ha-homelab/ha-radio-hub/hardware/external-antenna/README.md

# MC2-D — three external 2.4 GHz antennas

The current engineering prototype uses an ESP32-DevKitC-VIE (WROVER-IE, 8 MB flash / 8 MB quad PSRAM) host, a XIAO ESP32C6 pre-soldered / 102010636 Thread RCP, and a XIAO MG24 Zigbee NCP. Each radio has its own external antenna. The previous MC1 Nano and MC2-A S3 remain historical and are not pin or binary compatible. All 21 application signals remain; R4/R5 constrain the classic ESP32 boot straps. Bluetooth uses legacy BLE4.2 advertising and connections, not BLE5 extended advertisements or Coded PHY.

- [Visual assembly and antenna guide](index.html)
- [Full device assembly and ZAC93 pin map](../../docs/full-hub-assembly.md)
- [Independent connection audit and required I²C switch correction](../../docs/connection-audit.md)
- [Blank power and boot-strap measurement worksheet](power-measurements.csv)
- [Exploded enclosure, all component mounts and print files](../../mechanical/full-hub/README.md)
- [Full-hub wiring drawing](full-hub-wiring.svg)
- [RECOM power wiring](power-wiring.svg) and [current power budget](power-design.json)
- [Exact shopping list and AliExpress checks](../../docs/mc2-shopping.md)
- [Historical MC2-A appearance concepts and provenance](images/README.md)
- [Editable carrier, exact pinout, assembly and checks](cad/README.md)
- [Front assembly drawing](cad/assembly-top.svg)
- [S1 white assembly legend, QR, both board faces and cost assumptions](../../docs/pcb-silkscreen.md)
- [Schematic](cad/schematic.svg), [PDF](cad/schematic.pdf)
- [PCB copper front](cad/board-top.svg), [back](cad/board-bottom.svg)
- [Controller/peripheral BOM](cad/BOM.csv), [RF parts](rf-bom.json)
- [Net wiring](wiring.json), [physical connector coordinates](cad/connectors.json)

The MC2-D selection replaces MC2-C's TinyC6[D] with the US-distributed,
factory-header XIAO ESP32C6. The carrier footprint, underside recovery access
window, J10 connection, RCP firmware and cable layout are revised together.
See the [prototype ordering record](../../docs/pcb-order.md). Fit and RF
acceptance must be completed on the physical assembly.

The **PWR1 off-board power assembly** retains RECOM R-78K3.3-1.0 plus a 27 µF
input capacitor. J2 remains 5 V / GND / 3.3 V / GND. MC2-D native CAD describes
this current supply; do not substitute the former Pololu as an extra purchase.
