ha-homelab/ha-radio-hub/mechanical/module-carrier/rail-mount/baseline/README.md

# Historical four-support baseline

Unchanged native inputs from `c3c810750766fb3a8a70d319e081c936aae4e6c4`, the 51 × 75 mm rectangular, four-support design before edge rails replaced three PCB mounting holes. This is a comparison source, not the current board.

- `mc1.kicad_pcb` SHA-256 `b33c3ff2b299e826cb11e783f835361635d544eda4c71ba62e85cb6318bb2857`
- `design.json` SHA-256 `3ec66d88aa3c61b0f6fb72e5d2c45840be7dddcc6e5587b213107c57966d3d68`
- `routing-metrics.json` SHA-256 `3d1b13ab42b664b54d90f39cf018a0f8c793de8e0717294d2542ee9afd824d4b`
