ha-homelab/ha-radio-hub/hardware/low-power/diy/outputs/README.txt

LP-D0 PROTOTYPE: bottom copper only. No top copper or plated holes are required.
Use the separately checked print PDFs for toner transfer.
The drill file and CSV specify every hole as unplated. Do not import top wire overlays as copper.
BOM, jumper schedule, and measured assembly acceptance remain mandatory.
