ha-homelab/ha-radio-hub/hardware/module-carrier/studies/mounting-routing/baseline/README.md

# Historical baseline: unsupported jack-side edge

Saved from commit `6873b0084a8404d33af0261b29e432ff0e476715` before the mounting and angled-component review. This is the historical 51 × 75 mm outline and its three support locations; do not fabricate it as the current design. The native PCB is retained for reproducible copper-length comparisons.
