ha-homelab/ha-radio-hub/hardware/module-carrier/studies/mounting-routing/ear-baseline/README.md

# Historical baseline: local mounting ear

Saved unchanged from commit `af287e40d2967ce5cba5ec2e3d896d4b03c0d842` before the no-ear / all-rear-first assembly revision. This historical design has a 57 × 75 mm bounding box, a 51 × 75 mm main body, a 6 × 27 mm local ear and four carrier supports. Its saved assembly metadata listed WIZ after the front controllers. That recorded sequence is historical; it does not prove that the geometry required WIZ last. The current revision explicitly checks the requested all-rear-before-front order.

These files are immutable comparison inputs, not the current fabrication source.

- `mc1.kicad_pcb` SHA-256: `7f8296edb0317269f6b094847edeb91a2886d2e1fc220150be1a1db43755d6ea`
- `design.json` SHA-256: `ddecb5edbc20ab4a8b3bb476f11965124e490f48361f9cebb92e28f0f5862271`
