ha-homelab/ha-radio-hub/docs/overview.ru.md

# Project overview

<!-- MC2-CURRENT-DESIGN -->
> **Current build: [MC2 — three external antennas](external-antennas.md).** This page retains an earlier design or evaluation for reference. Its board images, pin maps, enclosure fit and alternative BOMs are not the current MC2 build.

The documentation is now maintained in English. See the
[current MC1 documentation index](README.md).
