ha-homelab/ha-radio-hub/docs/enclosure.md

# HA Radio Hub enclosure — historical DRAFT V0

<!-- MC2-CURRENT-DESIGN -->
> **Historical Pi-era enclosure.** For the active **MC2-D / FH1** build, follow
> [Start here](start-here.md) and the [FH1 full-hub print package](../mechanical/full-hub/README.md).
> FH1 provides the current carrier, ZAC93 and peripheral mounts. The V0 dimensions,
> STL files and assembly layout below belong to the original Pi design.

The later [MC1 carrier enclosure prototype](../mechanical/module-carrier/enclosure-prototype/README.md) and [split-rail fit coupons](../mechanical/module-carrier/rail-mount/README.md) are also historical. They cover only the MC1 carrier; FH1 supersedes them for the complete current hub.

The model is ready for a test print, but has **not yet been validated by assembling the actual parts**. The STL files are checked for watertight meshes, consistent face winding, and one connected body. These checks do not prove connector clearance, radio performance, cooling, or the accuracy of a particular printer.

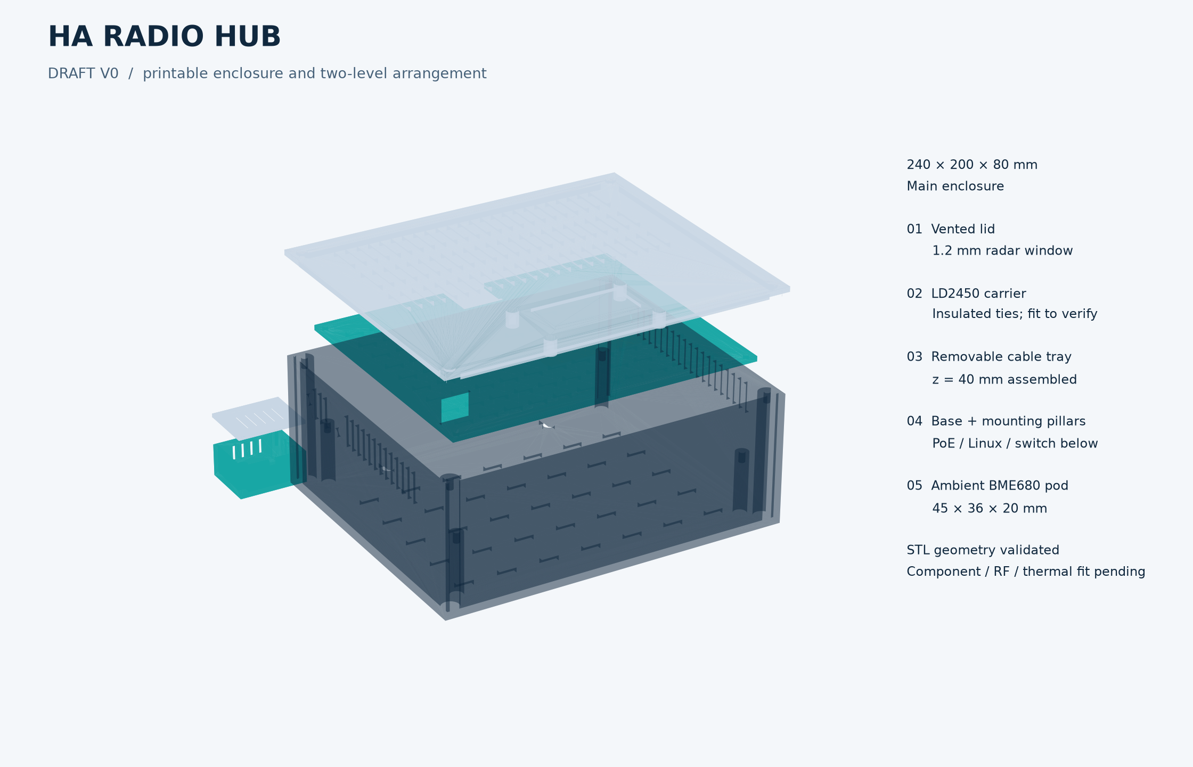
[picture p15: mechanical/generated/exploded-preview.png]
Exploded view generated from the actual STL files


## Dimensions and orientation

Main enclosure: **240 × 200 × 80 mm**, excluding protruding screw heads, cables, and antennas. The base is 77 mm high and the lid is 3 mm thick; walls and floor are 3 mm thick. The base and lid need a bed of at least 246 × 206 mm with a 3 mm brim; a 256 × 256 mm class printer is a practical fit. **The base and lid do not fit a 220 × 220 mm bed.** Do not scale down the STL files: this changes screw fits and the actual compartment dimensions. V0 does not include a validated split enclosure for a 220 mm bed.

Coordinates: x is width, y is depth; the floor is at z=0 and the outer lid surface at z=80. The PoE cable enters at the rear, through y=200. The radar sits below the lid near y=40, with its antenna plane facing the lid. For wall mounting, **the lid faces the room**. On a horizontal table, the radar points upward, so stand the enclosure vertically on a stable support or mount it on a wall to track people. Check the radar coordinate directions after installation.

Assembly options:

- Main: printed wall-mounted enclosure with two levels and an external BME680 ambient-sensor pod.
- Debugging: the same enclosure with the lid removed; comparison with the closed enclosure is required to check radar behavior and temperatures.
- Commercial substitute: a purchased ventilated plastic enclosure with at least 240 × 200 × 80 mm of clear internal space and a separate mounting panel. Transfer panel hole locations from measured parts. A metal enclosure requires externally mounted radio modules/antennas and a separate RF-transparent radar window.

## Layout

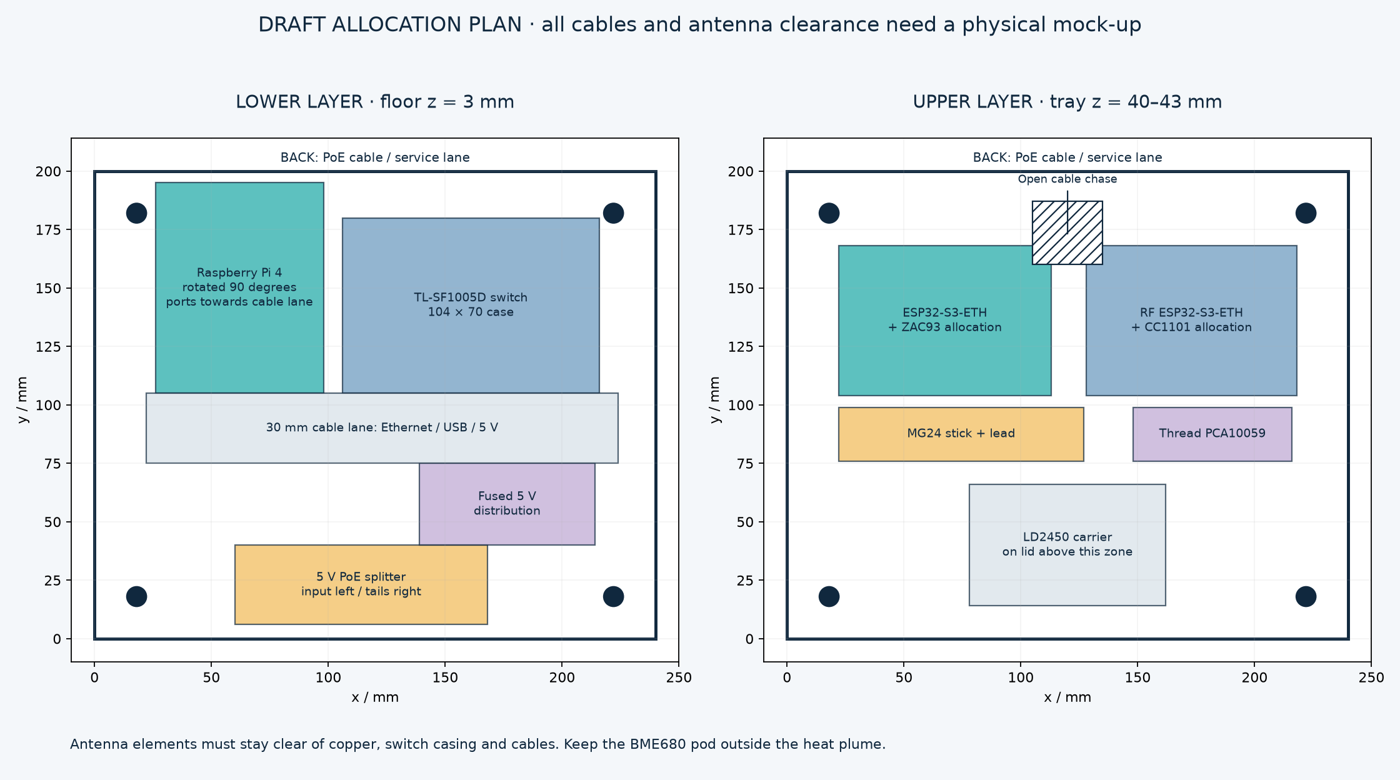
[picture p16: mechanical/generated/layout-plan.png]
Layout by level


This is a **space allocation**, not accurate CAD models of the commercial devices. The dimensions and coordinates below refer to the supplied `parameters.json`. Connector dimensions, wire bends, USB radio housings, and standoffs must be checked against the purchased parts.

Lower level: top of the floor at z=3; underside of the removable deck at z=40. The available 37 mm height includes insulating pads and fasteners.
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
