ha-homelab/ha-radio-hub/docs/external-antennas.md

# MC2-D: three external antennas

MC2-D is the current **100 × 100 mm, two-copper-layer** carrier for finished
modules. It retains the local Thread Border Router, Ember Zigbee, active Bluetooth
proxy, Z-Wave transport, CC1101 RX/TX, LD2450 and BME680. Its change is three
independent external 2.4 GHz radio paths. **This is an engineering prototype**:
builds and CAD checks do not demonstrate house coverage or physical fit.

Start with the [visual guide and pin lookup](../hardware/external-antenna/index.html),
[native hardware](../hardware/external-antenna/README.md),
[firmware instructions](../firmware/external-antenna/README.md), and
[full-hub printable enclosure](../mechanical/full-hub/README.md).

## Exact module selection

- **U1: Espressif ESP32-DevKitC-VIE / ESP32-WROVER-IE.** Classic ESP32 ECOv3,
  factory external RF connector, 8 MB flash and 8 MB physical PSRAM; two 19-pin
  rows. The application maps 4 MB PSRAM for capability-based allocation at quad 40 MHz.
  It runs Ethernet, the BLE 4.2 proxy and local Thread Border Router. Do not
  substitute WROOM (no PSRAM), VE (onboard antenna), an older WROVER revision,
  or the former S3 board. **MC2-A and MC2-D footprints and binaries differ.**
- **U2: Seeed XIAO ESP32C6 (Pre-Soldered), SKU 102010636.** Four MB flash,
  native USB and factory 2×7 male headers. UART RX17/TX16 are on D7/D6.
  The factory GPIO8 pull-up replaces the old carrier R3. Recovery uses **two
  flexible insulated leads**, TP8/EN → J10.1 and TP2/BOOT (GPIO9) → J10.2.
  Those are underside pads, not header pins; the carrier has an access window.
  The matching firmware selects external RF with **GPIO3 LOW, GPIO14 HIGH**
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
