ha-homelab/ha-radio-hub/hardware/external-antenna/images/full-hub-exploded-concept.png

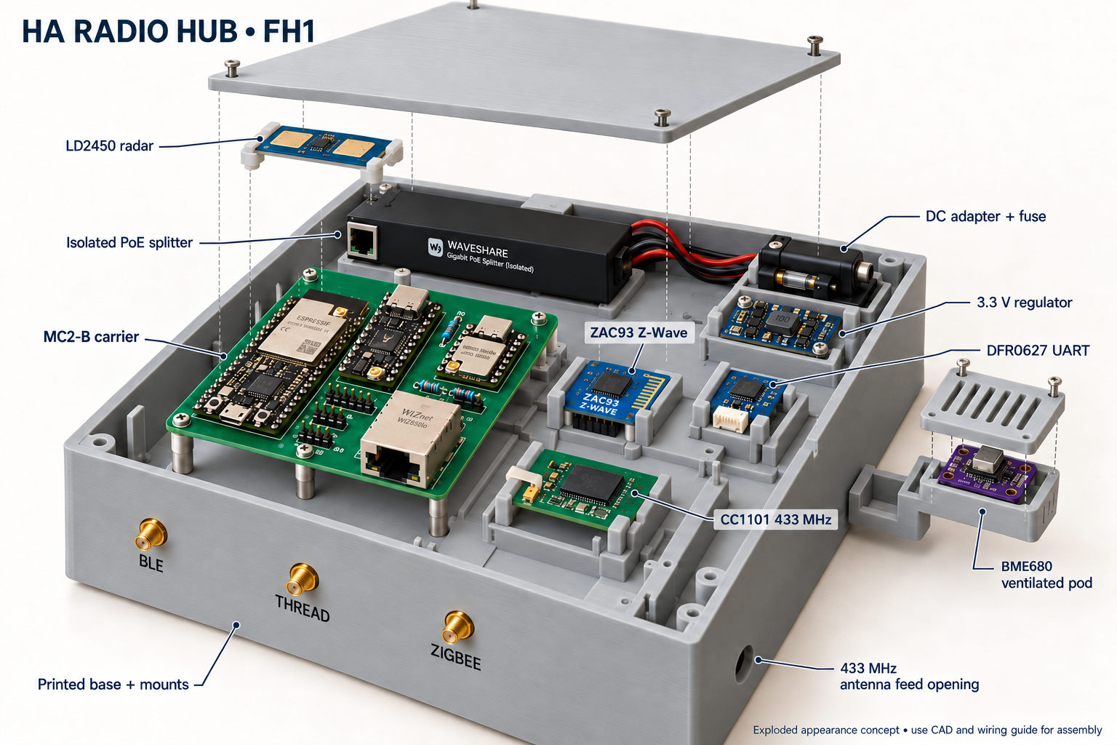
hardware/external-antenna/images/full-hub-exploded-concept.png
