ha-homelab/ha-radio-hub/hardware/external-antenna/images/mc2b-bare-concept.png

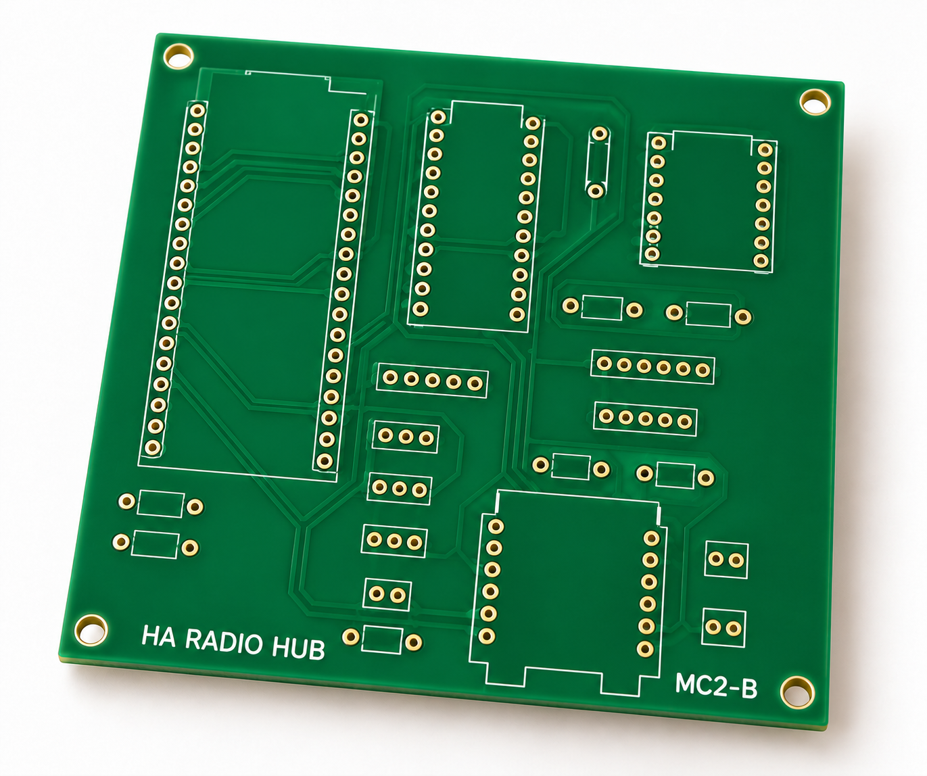
hardware/external-antenna/images/mc2b-bare-concept.png
