ha-homelab/ha-radio-hub/hardware/h2-quartet/preview.jpg

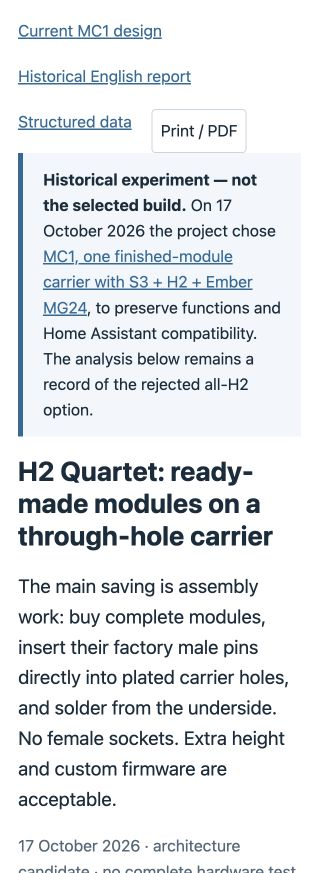
hardware/h2-quartet/preview.jpg
