ha-homelab/ha-radio-hub/hardware/module-carrier/images/history/mc1-100x90-rejected-concept.png

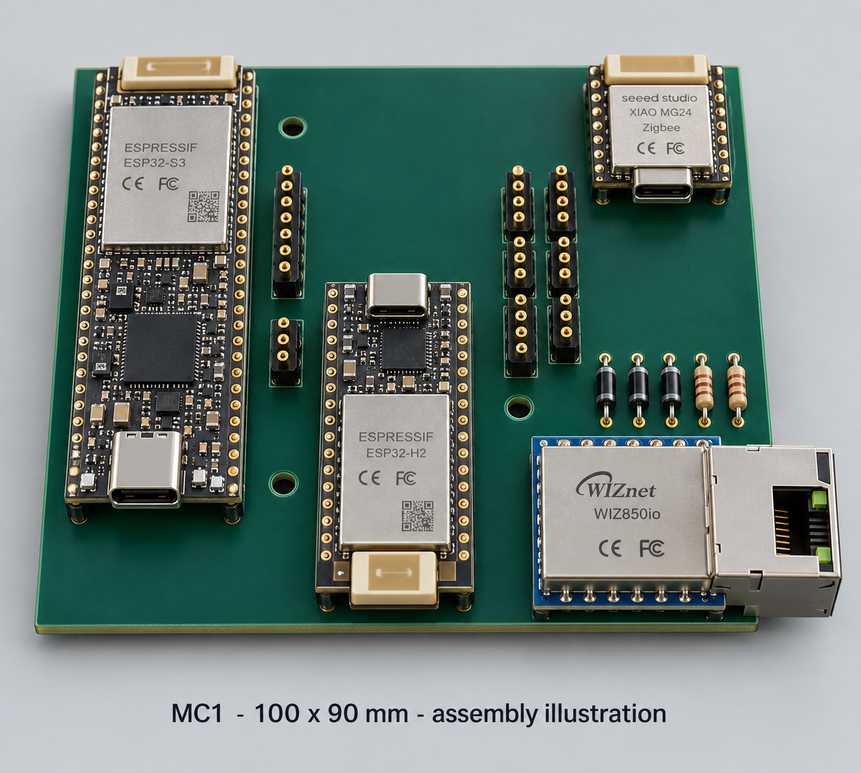
hardware/module-carrier/images/history/mc1-100x90-rejected-concept.png
