ha-homelab/ha-radio-hub/hardware/module-carrier/images/history/mc1-160x100-concept.png

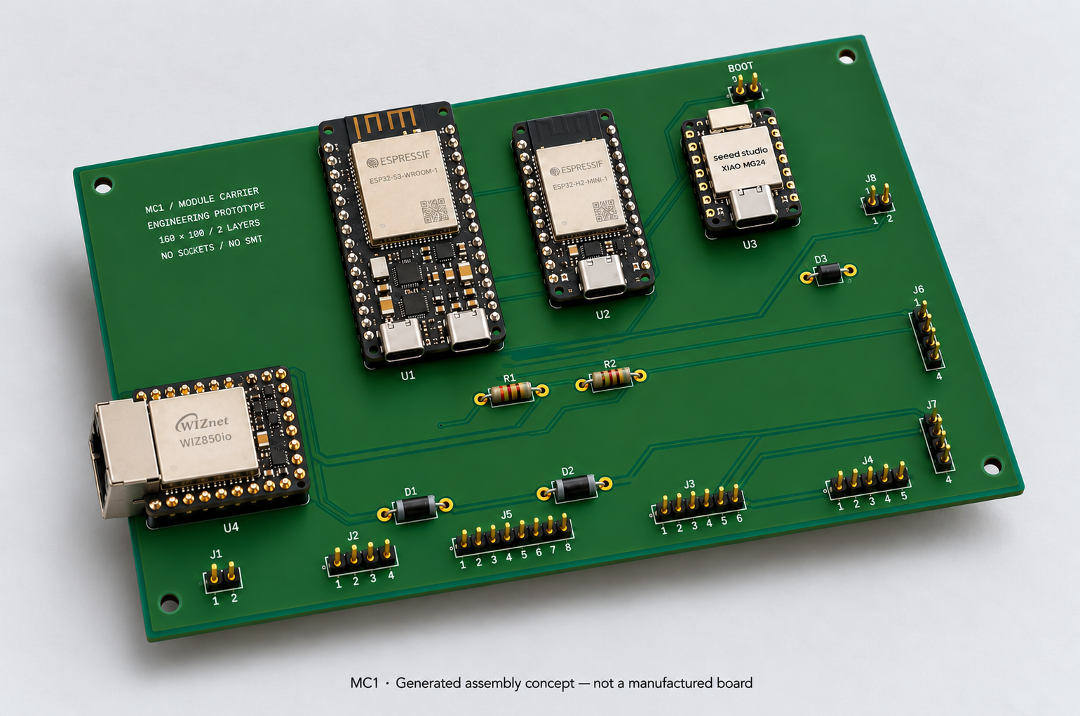
hardware/module-carrier/images/history/mc1-160x100-concept.png
