ha-homelab/ha-radio-hub/hardware/module-carrier/images/history/mc1-single-anchor-first-concept.png

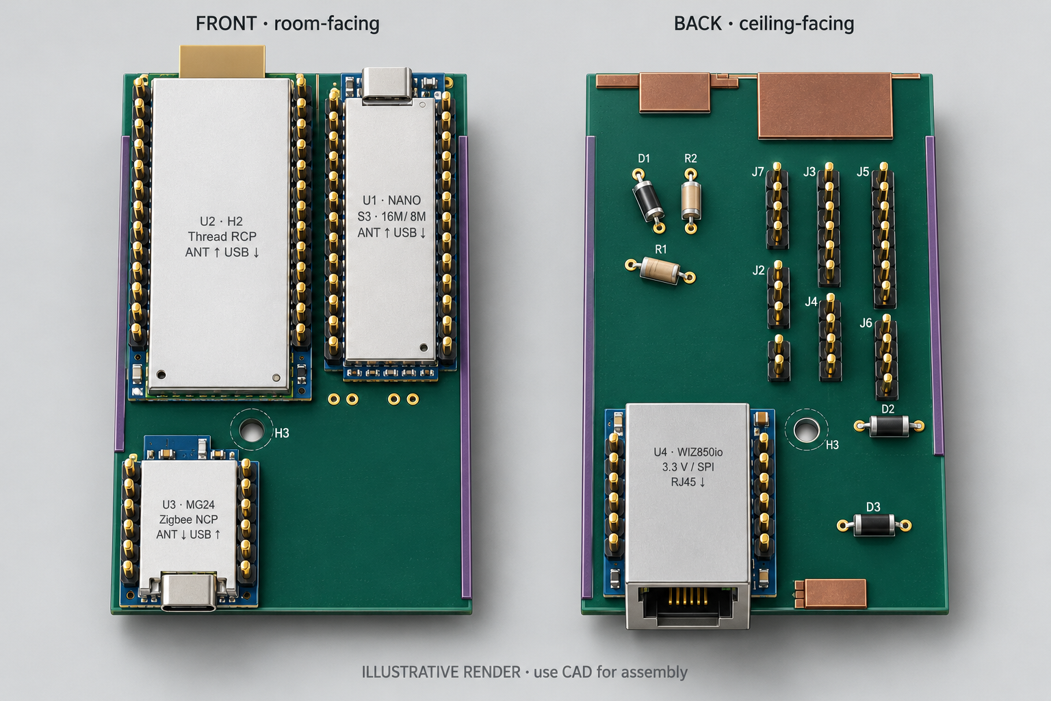
hardware/module-carrier/images/history/mc1-single-anchor-first-concept.png
