ha-homelab/ha-radio-hub/hardware/module-carrier/images/ui-architecture.jpg

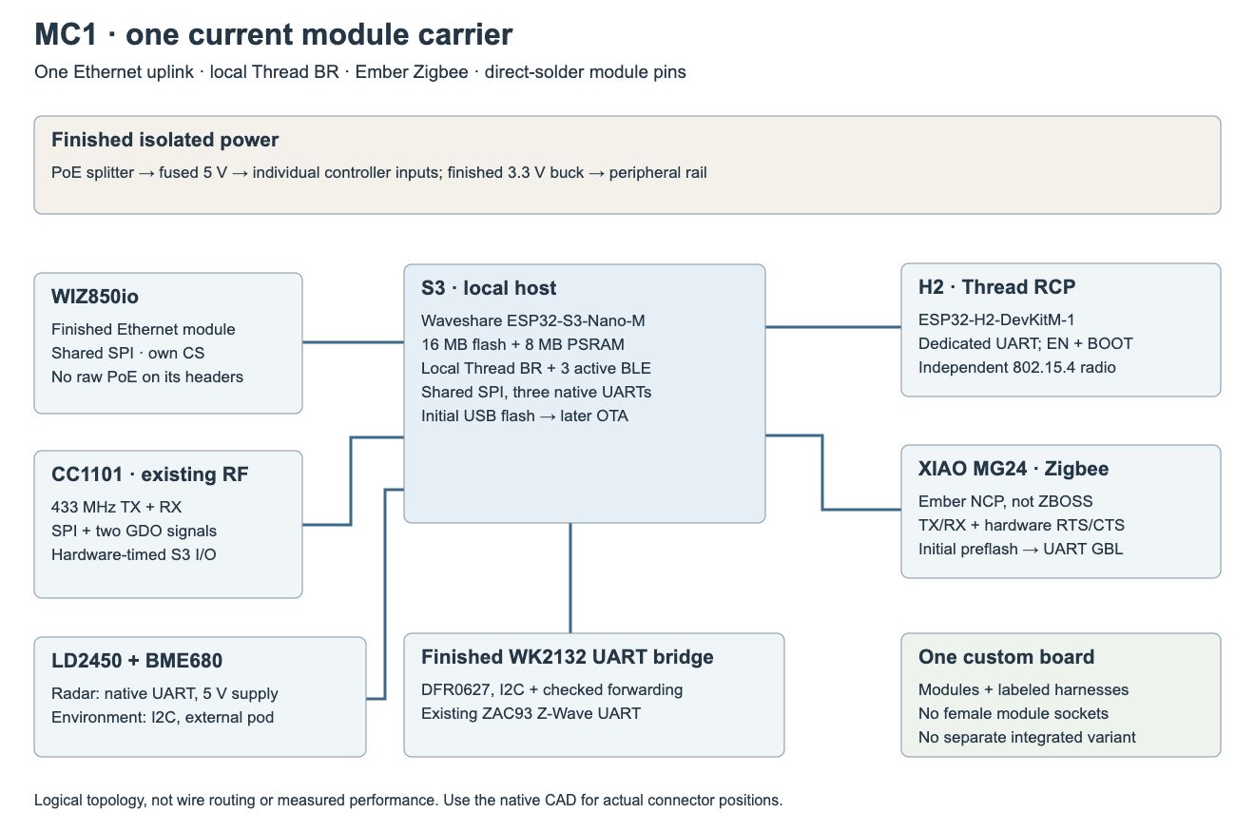
hardware/module-carrier/images/ui-architecture.jpg
