ha-homelab/ha-radio-hub/hardware/module-carrier/images/ui-comparison.jpg

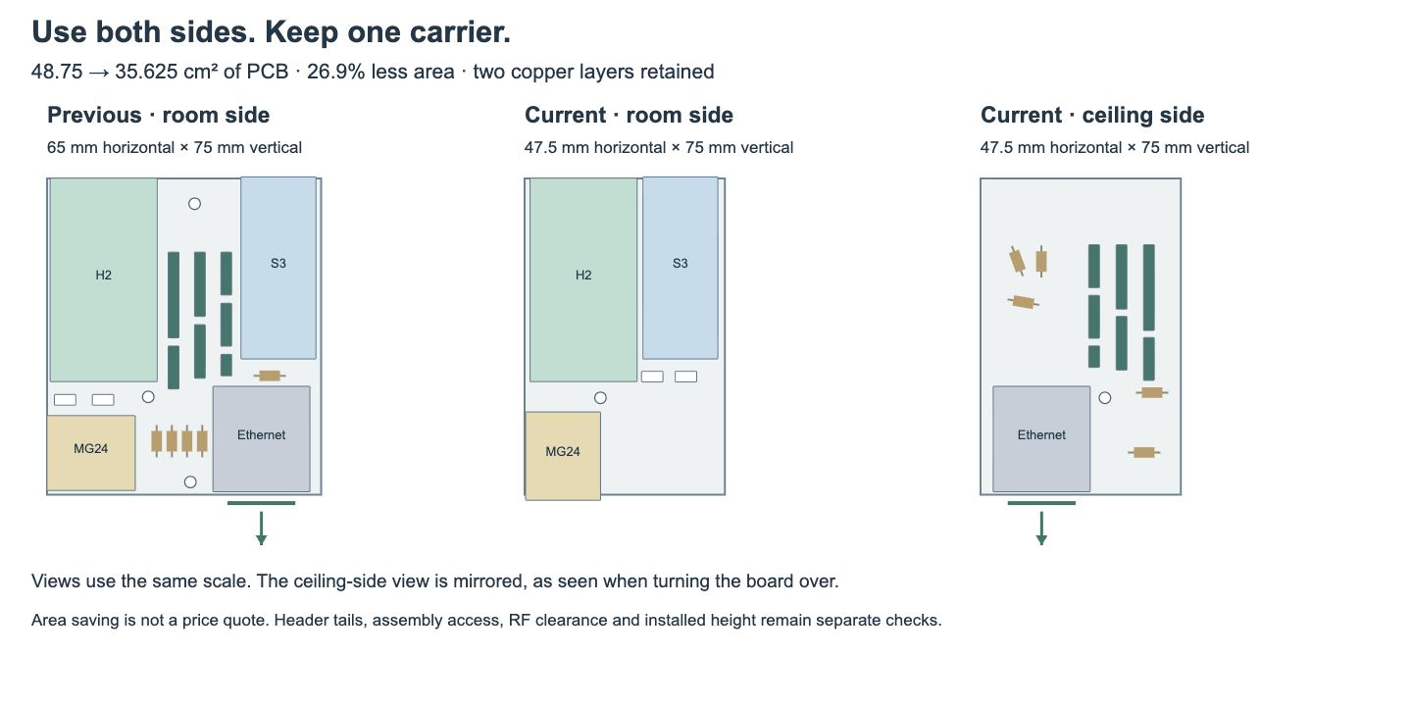
hardware/module-carrier/images/ui-comparison.jpg
