ha-homelab/ha-radio-hub/hardware/module-carrier/images/ui-concept.jpg

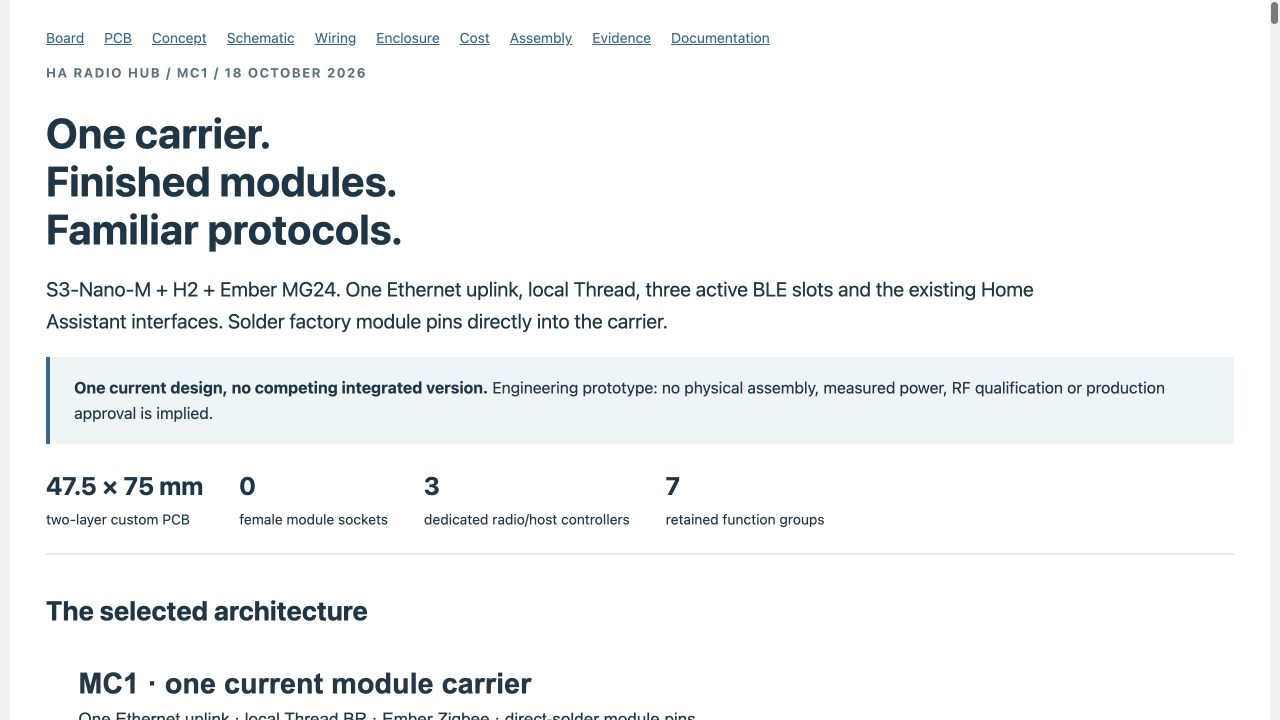
hardware/module-carrier/images/ui-concept.jpg
