ha-homelab/ha-radio-hub/hardware/module-carrier/images/ui-enclosure.jpg

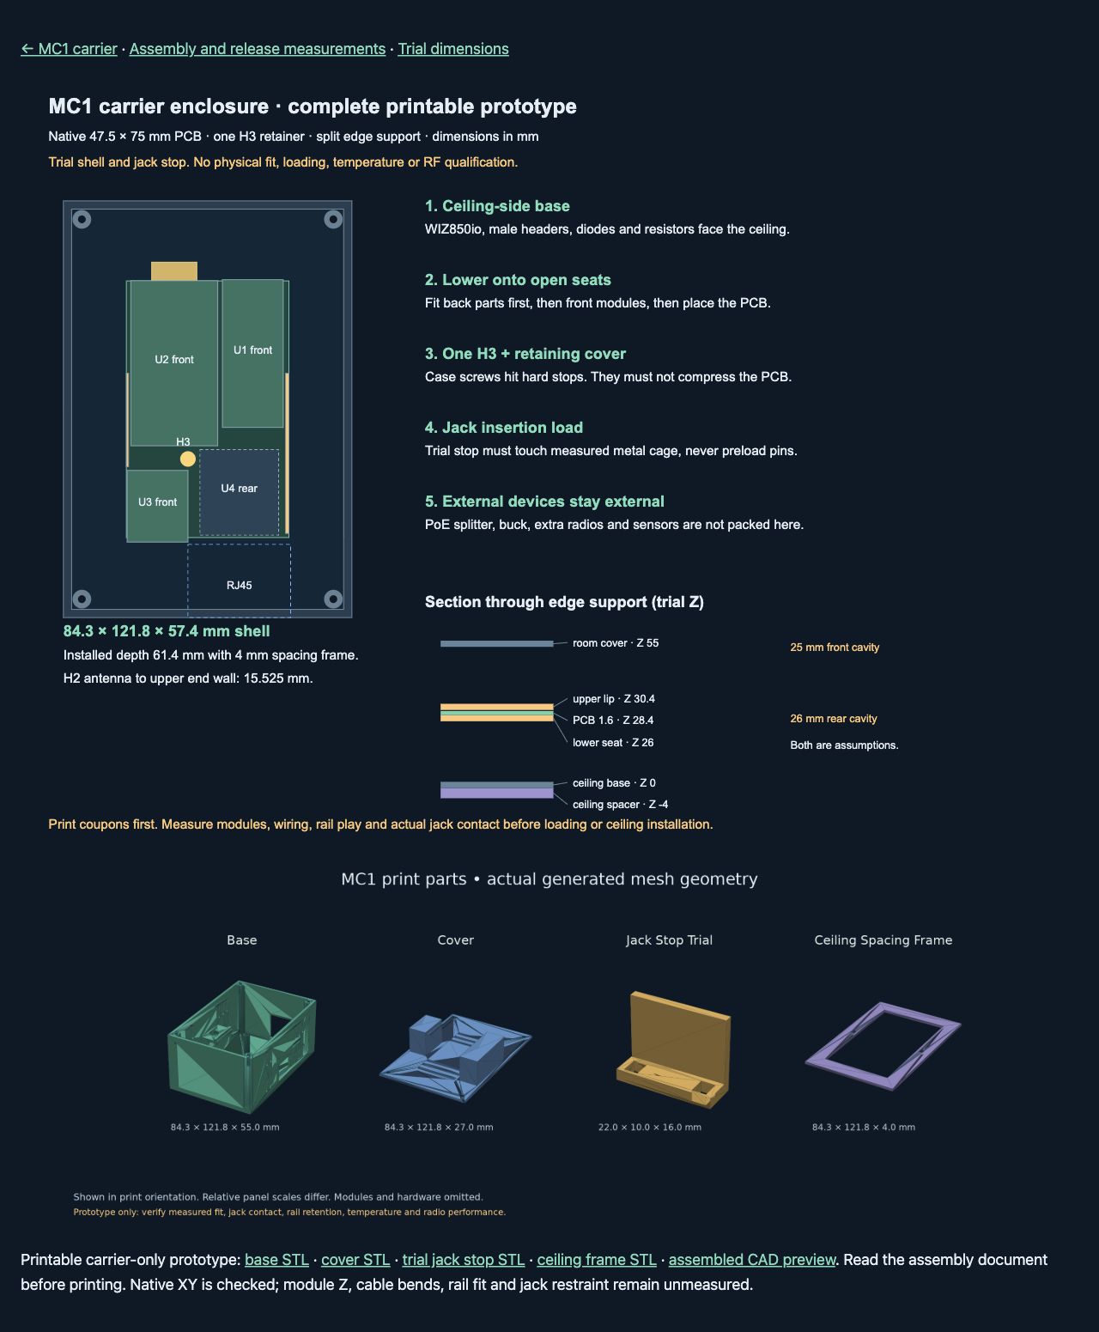
hardware/module-carrier/images/ui-enclosure.jpg
