ha-homelab/ha-radio-hub/hardware/module-carrier/images/ui-harness.jpg

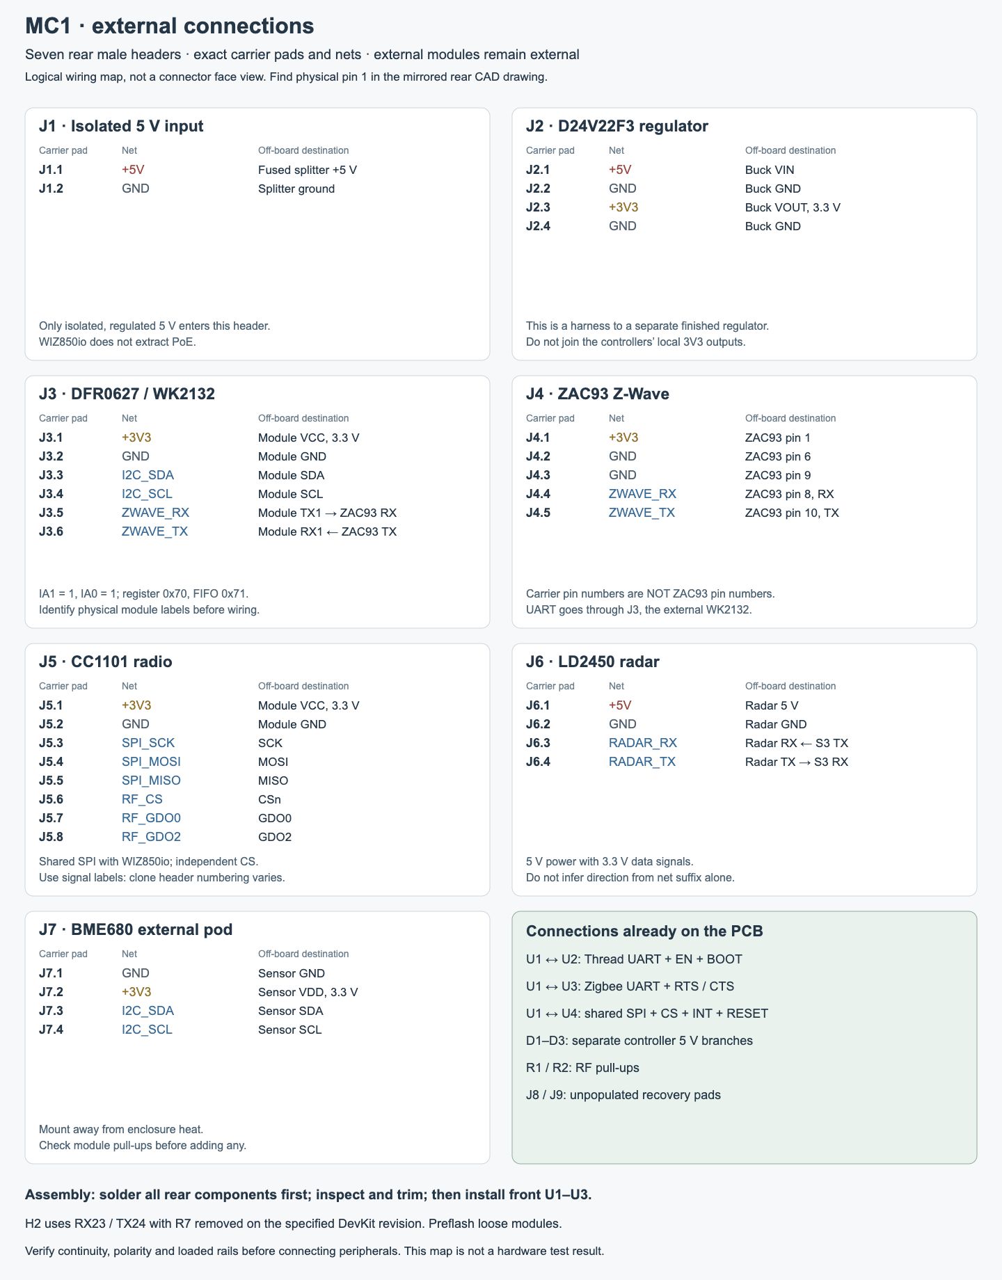
hardware/module-carrier/images/ui-harness.jpg
