ha-homelab/ha-radio-hub/hardware/module-carrier/images/ui-mounting.jpg

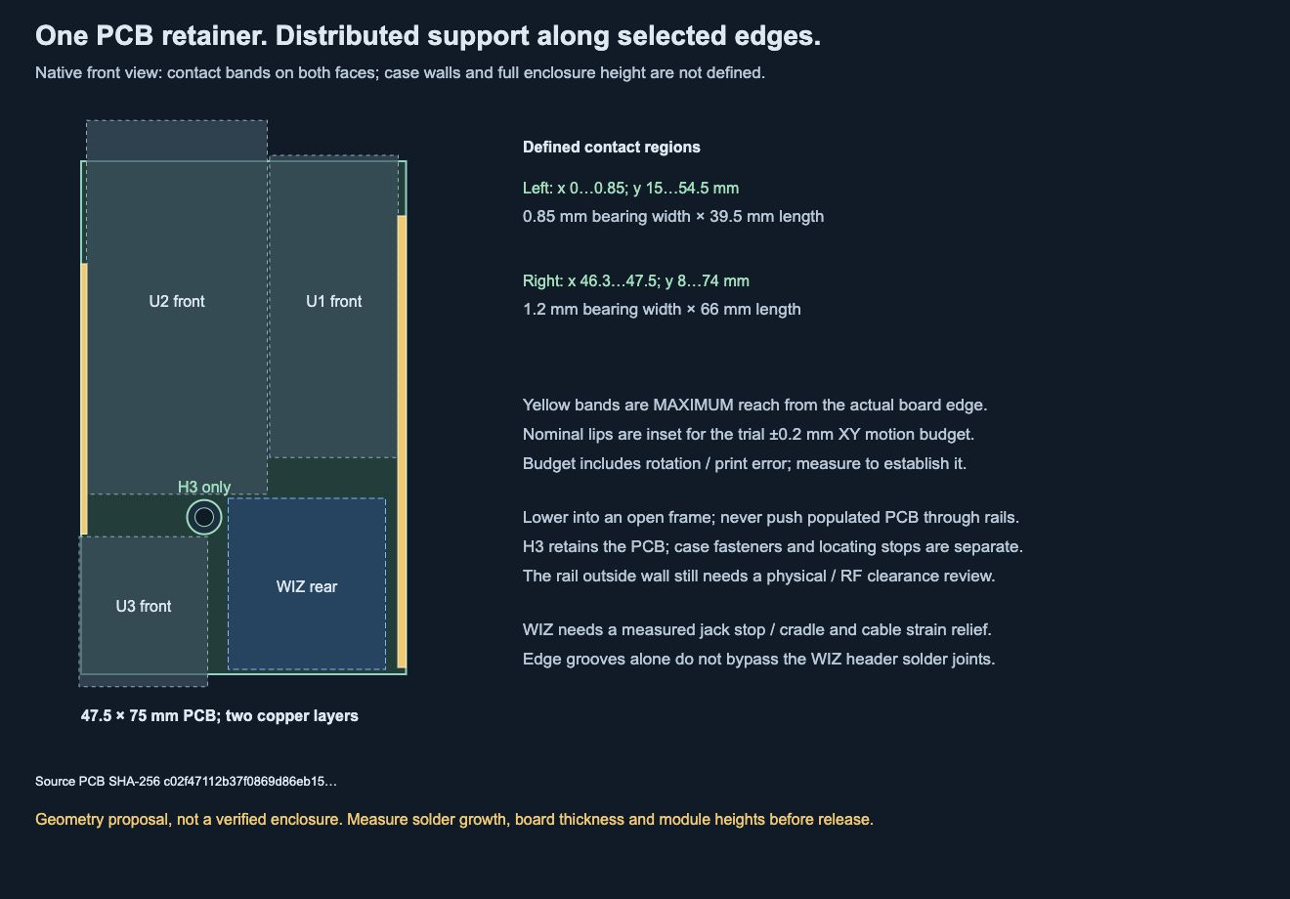
hardware/module-carrier/images/ui-mounting.jpg
