ha-homelab/ha-radio-hub/hardware/module-carrier/images/ui-rail-study.jpg

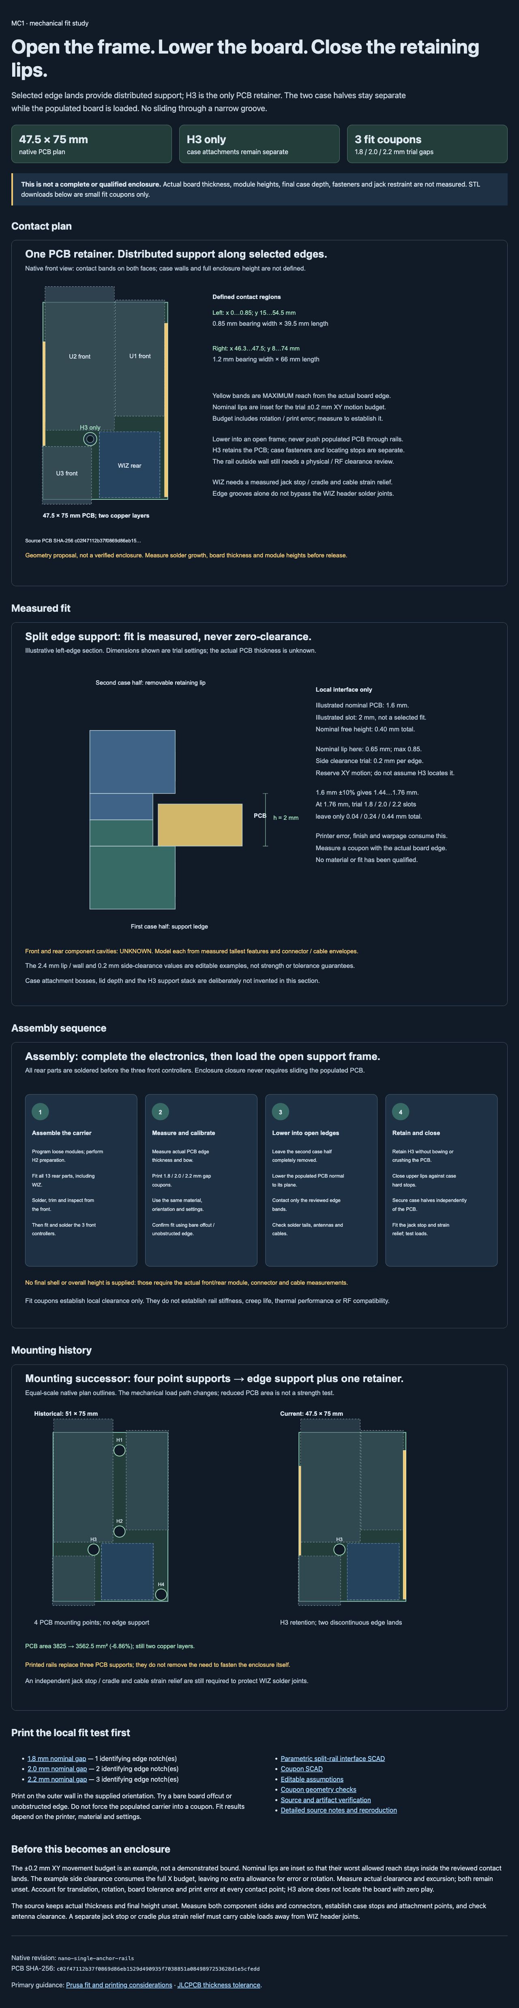
hardware/module-carrier/images/ui-rail-study.jpg
