ha-homelab/ha-radio-hub/hardware/module-carrier/images/ui-recovery.jpg

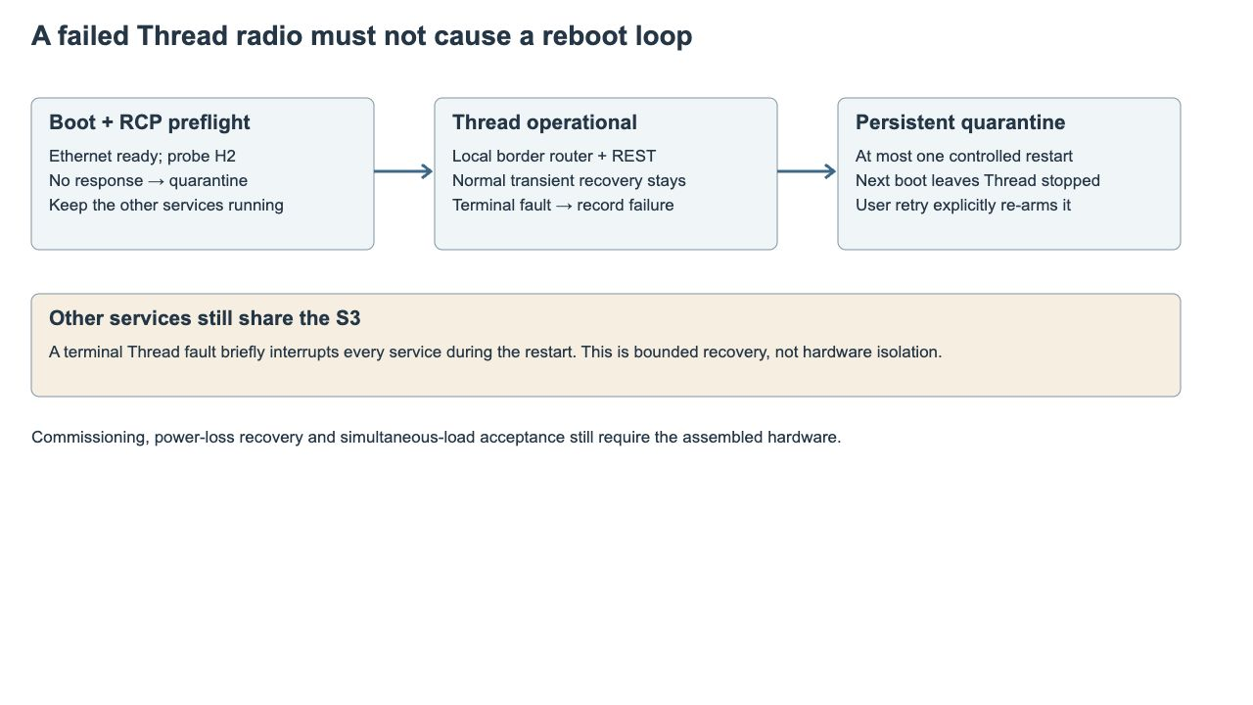
hardware/module-carrier/images/ui-recovery.jpg
