ha-homelab/ha-radio-hub/hardware/module-carrier/images/ui-routing.jpg

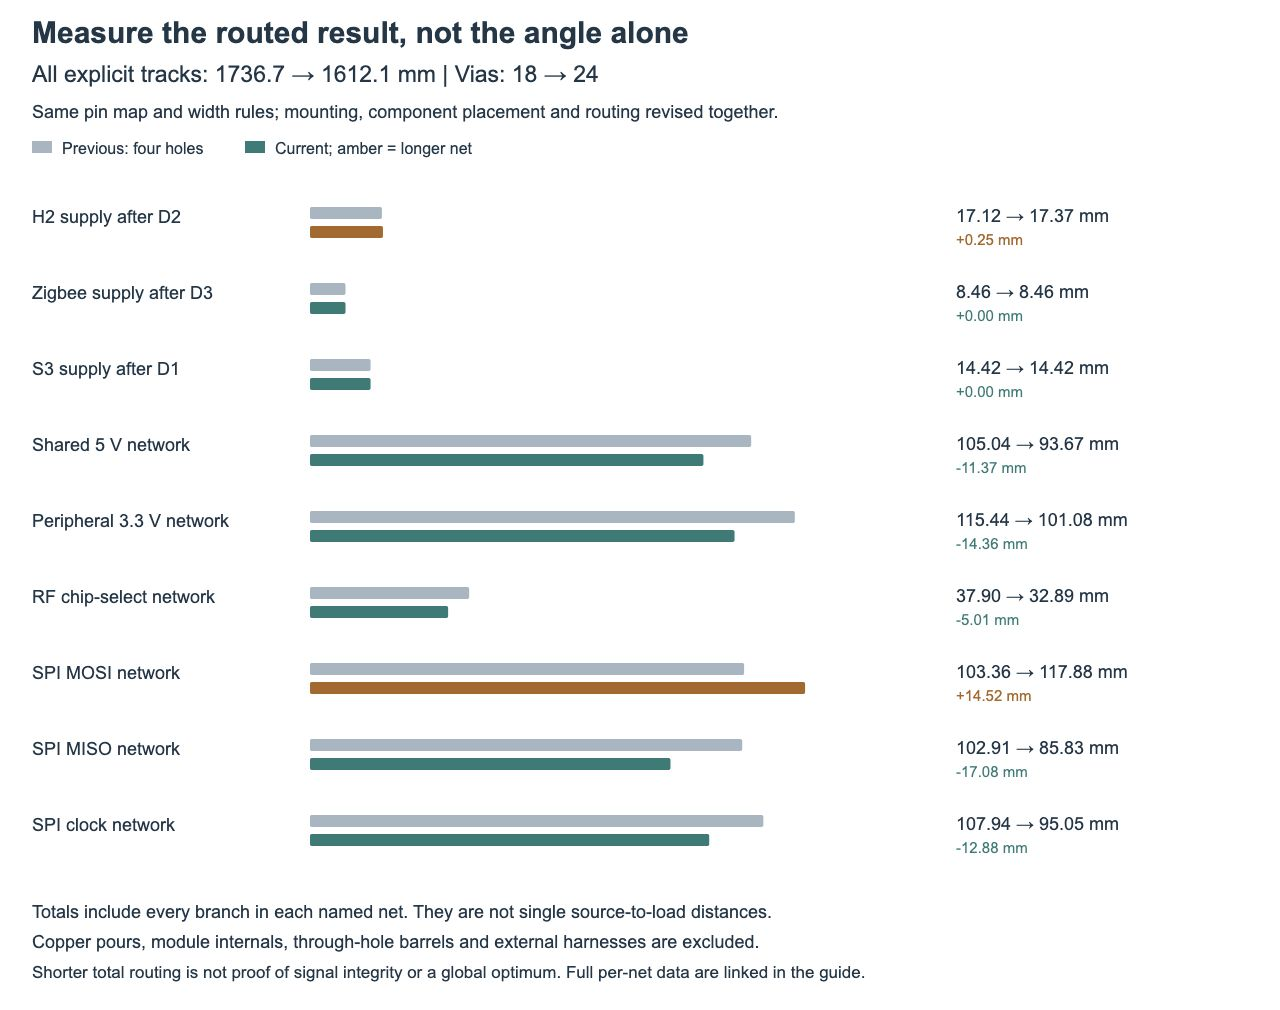
hardware/module-carrier/images/ui-routing.jpg
