ha-homelab/ha-radio-hub/hardware/module-carrier/images/ui-schematic.jpg

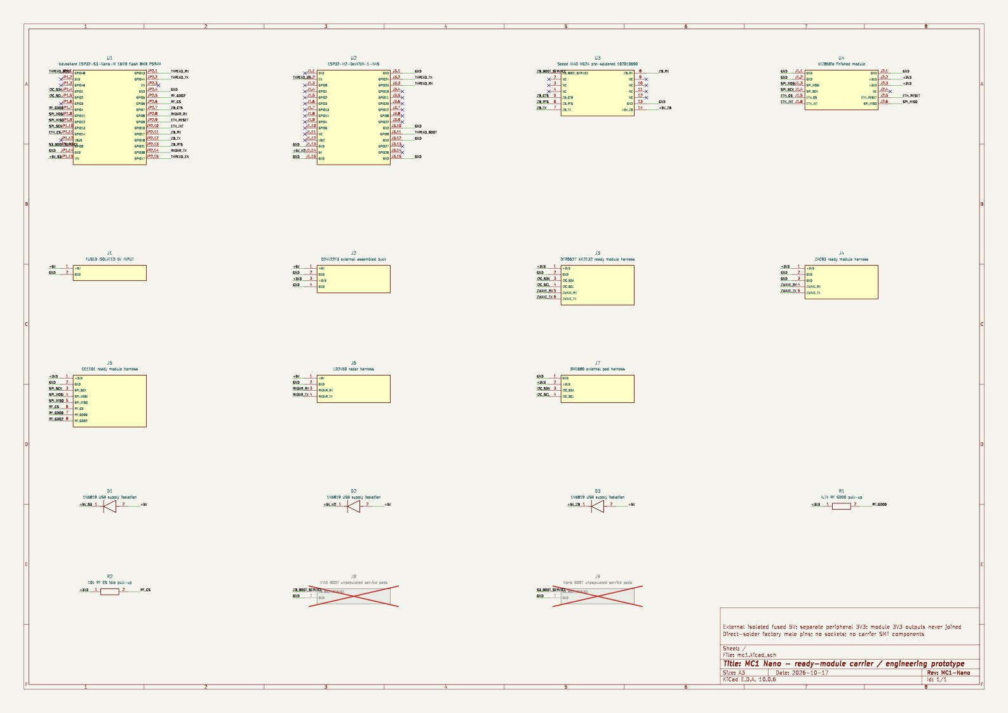
hardware/module-carrier/images/ui-schematic.jpg
