ha-homelab/ha-radio-hub/hardware/module-carrier/images/ui-stack.jpg

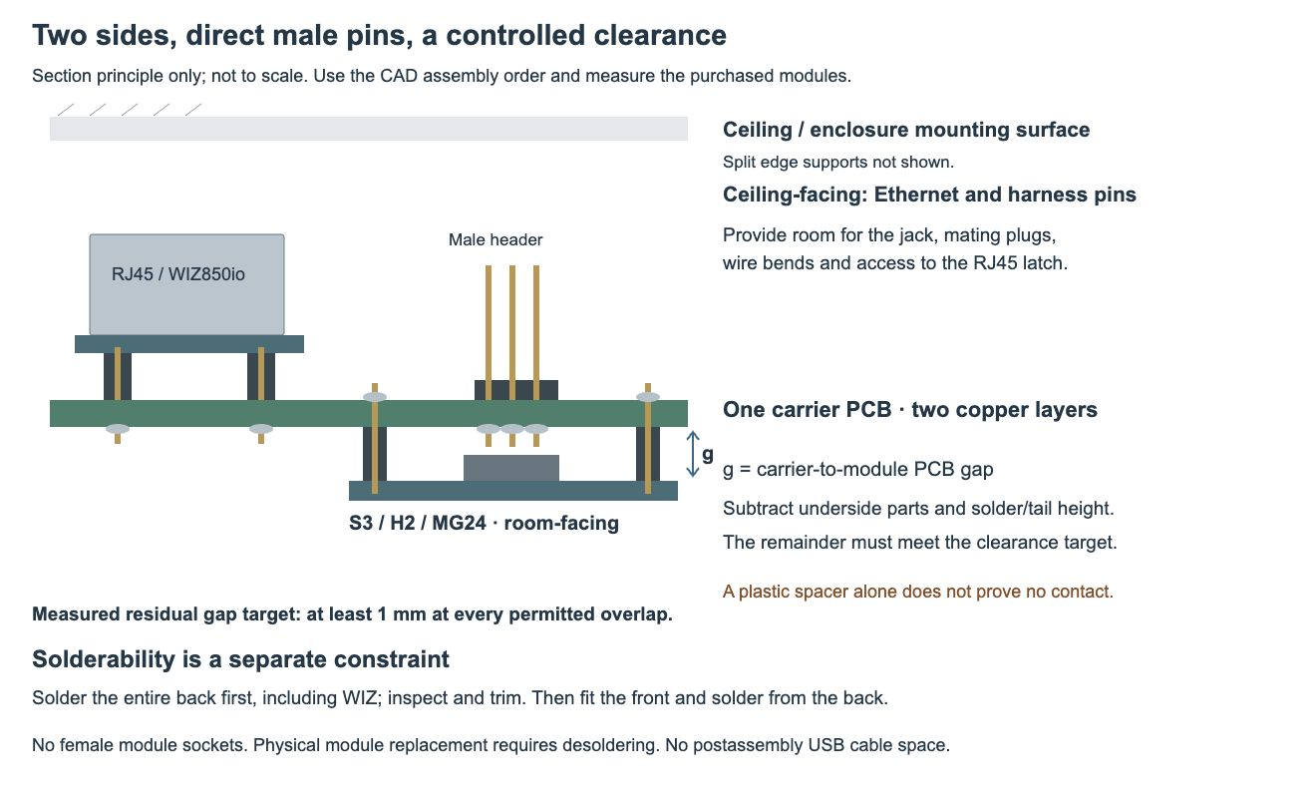
hardware/module-carrier/images/ui-stack.jpg
