ha-homelab/ha-radio-hub/hardware/module-carrier/images/ui-updates.jpg

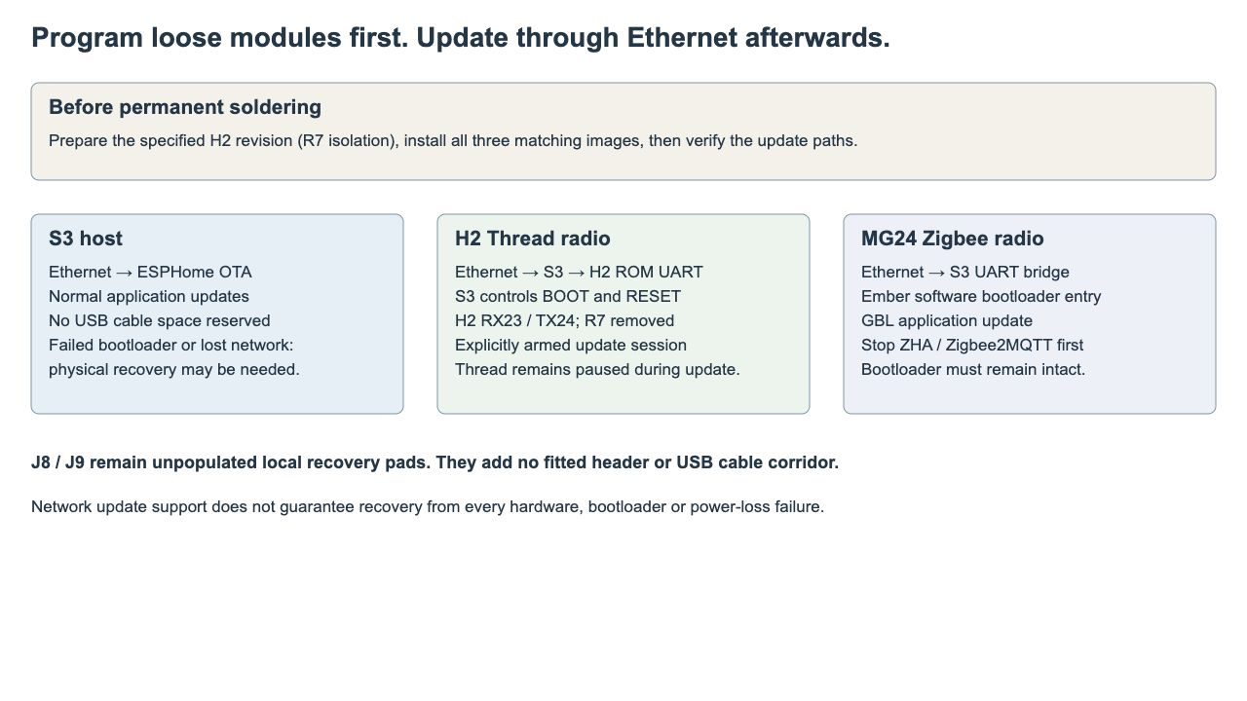
hardware/module-carrier/images/ui-updates.jpg
