ha-homelab/ha-radio-hub/hardware/module-carrier/studies/compact-s3/architecture-preview.png

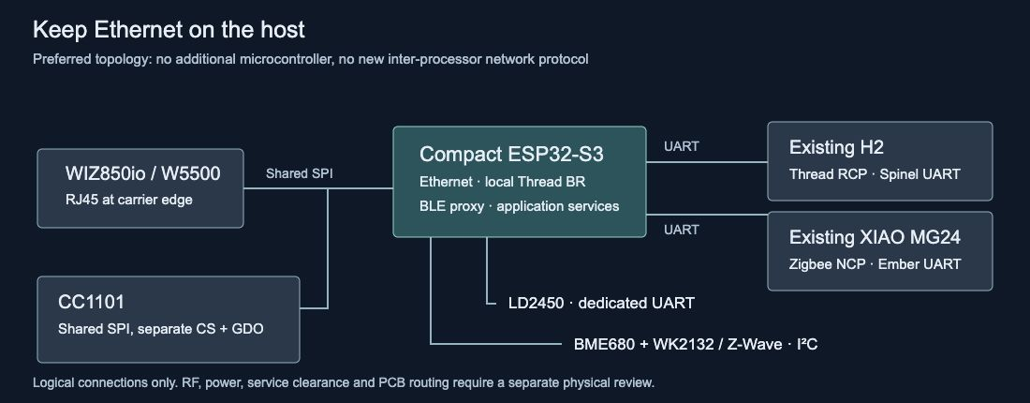
hardware/module-carrier/studies/compact-s3/architecture-preview.png
