ha-homelab/ha-radio-hub/hardware/module-carrier/studies/compact-s3/outlines-preview.png

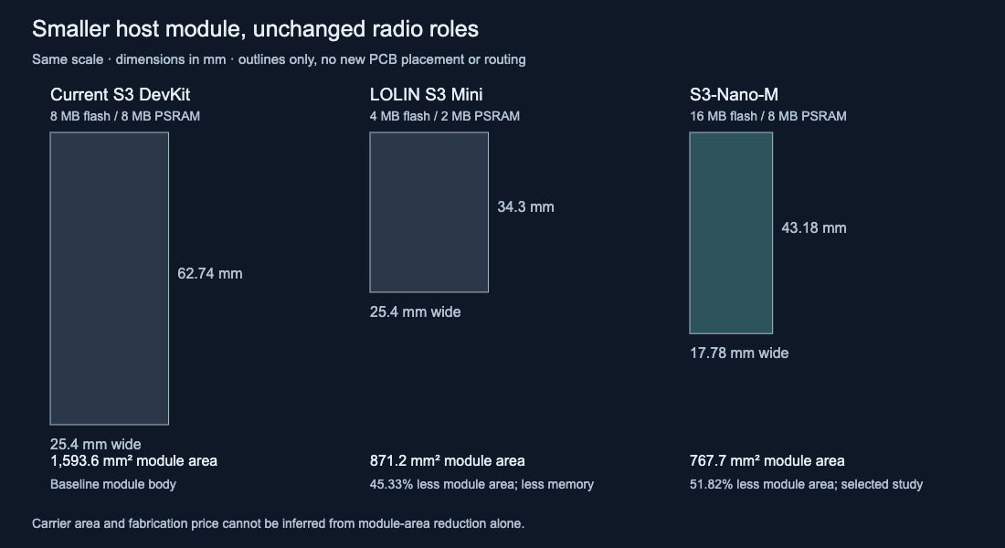
hardware/module-carrier/studies/compact-s3/outlines-preview.png
