ha-homelab/ha-radio-hub/hardware/module-carrier/studies/slzb-thread/comparison-preview.png

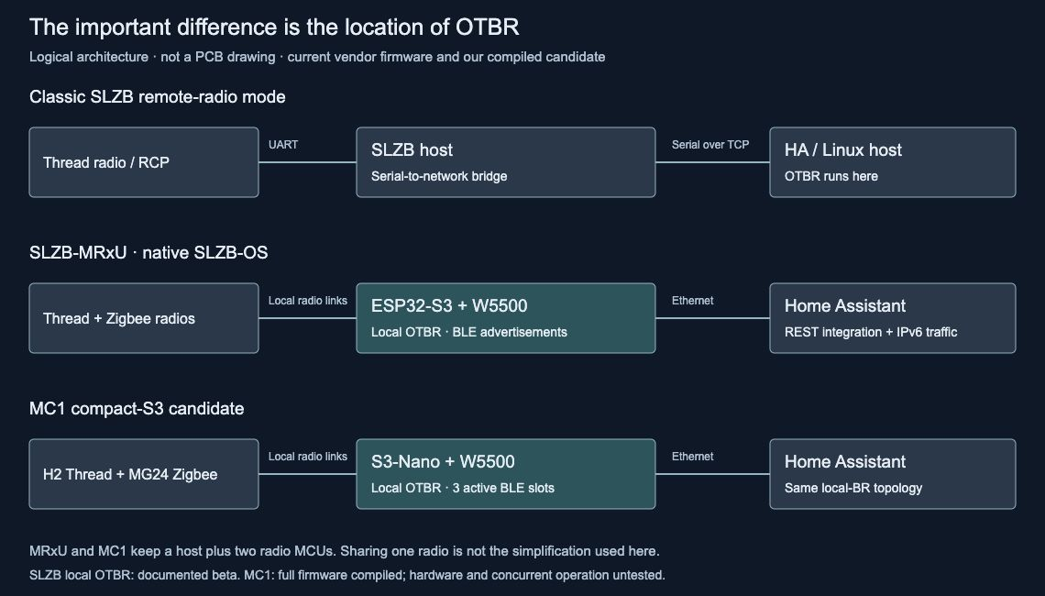
hardware/module-carrier/studies/slzb-thread/comparison-preview.png
