ha-homelab/ha-radio-hub/hardware/module-carrier/studies/square-layout/comparison-preview.jpg

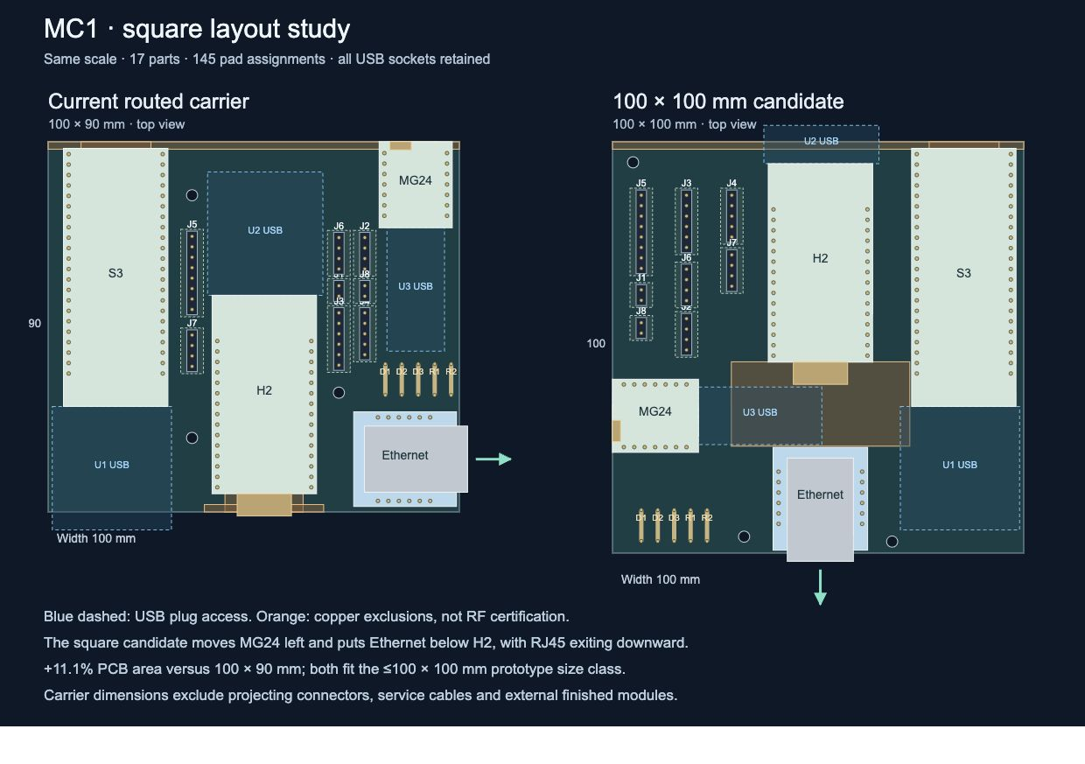
hardware/module-carrier/studies/square-layout/comparison-preview.jpg
