ha-homelab/ha-radio-hub/hardware/module-carrier/studies/square-layout/page-preview.jpg

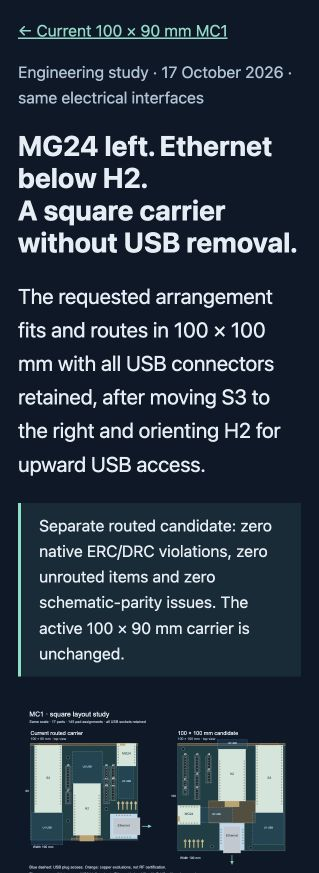
hardware/module-carrier/studies/square-layout/page-preview.jpg
