ha-homelab/ha-radio-hub/mechanical/low-power/generated/exploded-preview.png

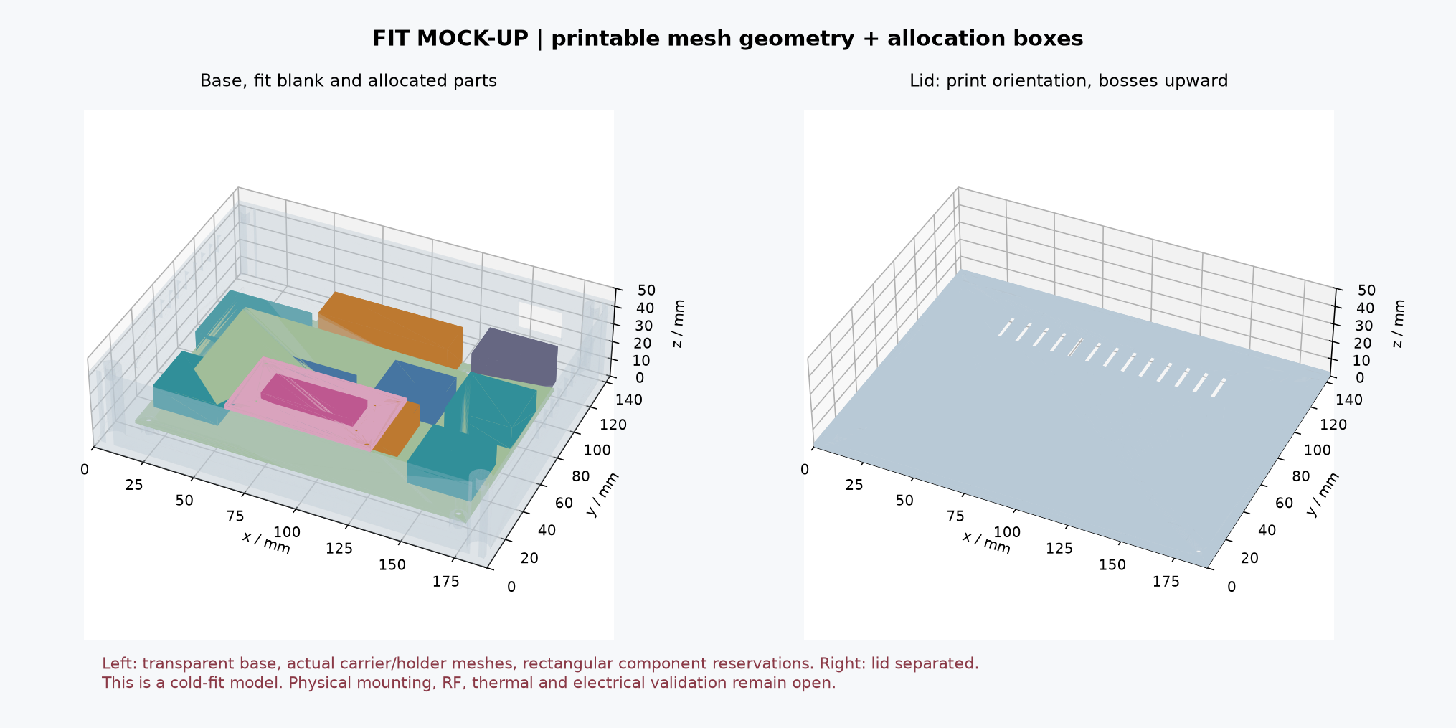
mechanical/low-power/generated/exploded-preview.png
