ha-homelab/ha-radio-hub/mechanical/low-power/generated/layout-plan.png

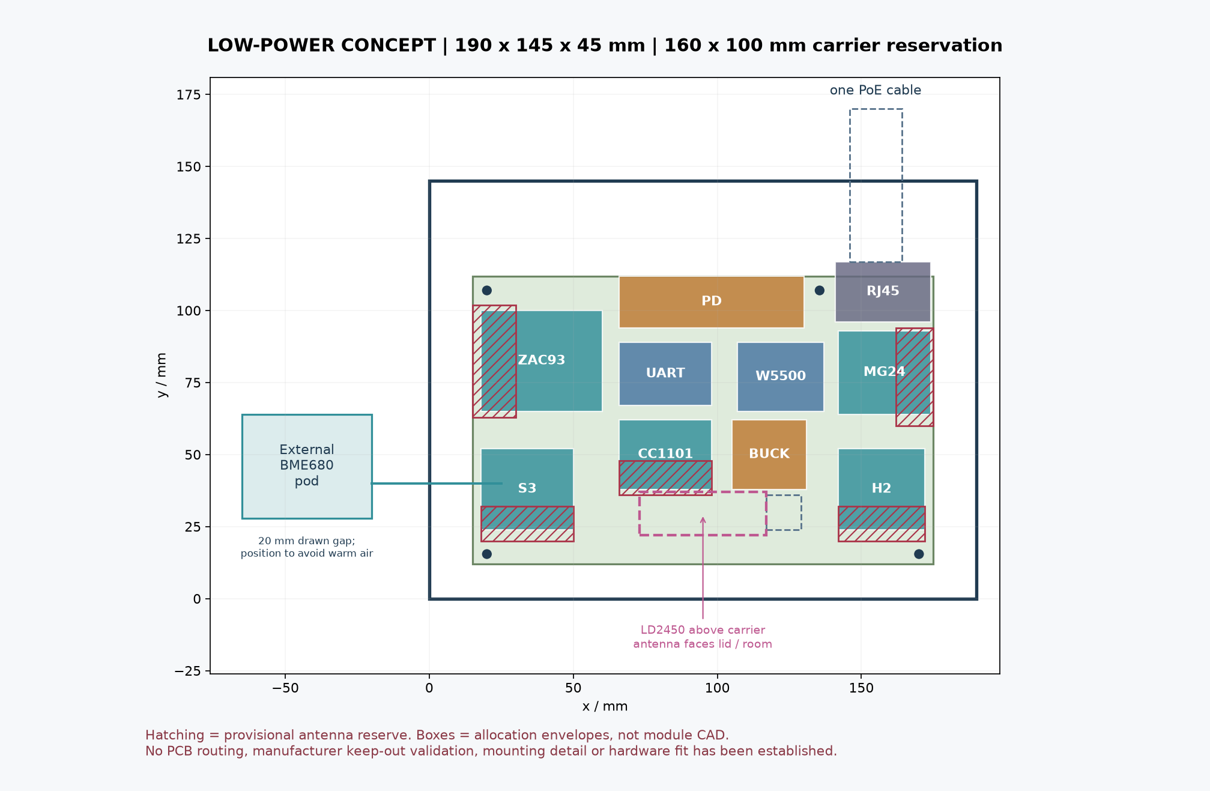
mechanical/low-power/generated/layout-plan.png
