ha-homelab/ha-radio-hub/docs/parts-gallery.md

# Historical assembly parts gallery

> **Historical catalog.** Use [the current MC2 guide](../hardware/external-antenna/index.html) and [MC2 hardware](../hardware/external-antenna/README.md) for the single active design. The following entries retain the earlier BOMs.

Pictures, exact model identification and every canonical BOM row. [Build selection and sourcing notes](parts-catalog.md) · [Filterable HTML catalog](../hardware/parts/index.html) (download/open locally) · [Pin-to-pin atlas](../hardware/low-power/visual/README.md).

**Choose one build.** Quantities below are per source; never add alternative builds together. LP-P0 is a bench reference, not an extra purchase list. All AliExpress links are **unverified searches**, not approved offers. Images are labeled photos, renders, source-derived diagrams or generic illustrations; appearance does not establish compatibility.

Manufacturer images remain remotely hosted and copyrighted by the credited owner. No redistribution license is asserted. If GitHub cannot load one, use its source link or the local family-illustration link. Local original illustrations are MIT; physical contact diagrams retain their linked source notices.

## Main modules and sensors

### Adafruit BME680 STEMMA QT / item 3660

Adafruit 3660 BME680 STEMMA QT board; a bare BME680 IC is not the same item.

**Manufacturer photo** — Adafruit 3660 BME680 STEMMA QT board; a bare BME680 IC is not the same item.

Image: Adafruit. [Source](https://www.adafruit.com/product/3660) · [Local family illustration](../hardware/parts/illustrations/module.svg).

Package / dimensions: `25.4 × 17.78 mm; height unspecified`.

- **LP-P0 bench reference (not additive):** quantity 1; references `U8`.

[AliExpress search — unverified results](https://www.aliexpress.com/wholesale?SearchText=Adafruit+BME680+STEMMA+QT+%2F+item+3660)

<details><summary>Exact BOM row conditions, notes and sources</summary>

- **lp-reference:U8:** Reference only; both. External ventilated pod; 3.3 V VIN; I2C address 0x77; onboard pull-ups. [Official / original source](https://www.adafruit.com/product/3660).

</details>

### Adafruit BME680 STEMMA QT product3660

Adafruit 3660 BME680 STEMMA QT board; a bare BME680 IC is not the same item.

**Manufacturer photo** — Adafruit 3660 BME680 STEMMA QT board; a bare BME680 IC is not the same item.

Image: Adafruit. [Source](https://www.adafruit.com/product/3660) · [Local family illustration](../hardware/parts/illustrations/module.svg).

Package / dimensions: `25.4x17.78 PCB_only_QT_revision`.

- **Original Pi modular hub:** quantity 1; references `U7`.

[AliExpress search — unverified results](https://www.aliexpress.com/wholesale?SearchText=Adafruit+BME680+STEMMA+QT+product3660)

<details><summary>Exact BOM row conditions, notes and sources</summary>

- **modular:U7:** common. Environment sensor · 3.3V I2C0x77 · External vented pod;gas resistance is not CO2 [Official / original source](https://www.adafruit.com/product/3660).

</details>

### Adafruit1208 TSSOP28/SOIC28 breakout

Adafruit 1208 unpopulated SOIC/TSSOP-28 breakout PCBs. Use the TSSOP side for SC16IS752IPW; the IC and headers are separate parts.

**Manufacturer photo** — Adafruit 1208 unpopulated SOIC/TSSOP-28 breakout PCBs. Use the TSSOP side for SC16IS752IPW; the IC and headers are separate parts.

Image: Adafruit. [Source](https://www.adafruit.com/product/1208) · [Local family illustration](../hardware/parts/illustrations/module.svg).

- **D0 DIY • adapters / harness / jumper wire:** quantity 1; references `SC16 adapter`.

[AliExpress search — unverified results](https://www.aliexpress.com/wholesale?SearchText=Adafruit1208+TSSOP28%2FSOIC28+breakout)

<details><summary>Exact BOM row conditions, notes and sources</summary>

- **d0-harness:SC16 adapter:** Harness / external / service; read row notes. Factory PCB under U1 · Sold in3pack; fit SC16 to TSSOP side; not prepopulated. Row15.24mm, pitch2.54mm

</details>

### Adafruit1230 SOT23-6 breakout

Adafruit 1230 mixed-package unpopulated breakout set. Use the SOT-23-6 board for TPS3808; the supervisor IC and headers are separate parts.

**Manufacturer photo** — Adafruit 1230 mixed-package unpopulated breakout set. Use the SOT-23-6 board for TPS3808; the supervisor IC and headers are separate parts.

Image: Adafruit. [Source](https://www.adafruit.com/product/1230) · [Local family illustration](../hardware/parts/illustrations/module.svg).

- **D0 DIY • adapters / harness / jumper wire:** quantity 1; references `Supervisor adapter`.

[AliExpress search — unverified results](https://www.aliexpress.com/wholesale?SearchText=Adafruit1230+SOT23-6+breakout)

<details><summary>Exact BOM row conditions, notes and sources</summary>

- **d0-harness:Supervisor adapter:** Harness / external / service; read row notes. Factory PCB under U2 · Set contains5SOT23boards; stock fluctuates; same published CAD can be factory made. Not prepopulated

</details>

### Adafruit3660 BME680 STEMMA QT breakout

Adafruit 3660 BME680 STEMMA QT board; a bare BME680 IC is not the same item.

**Manufacturer photo** — Adafruit 3660 BME680 STEMMA QT board; a bare BME680 IC is not the same item.

Image: Adafruit. [Source](https://www.adafruit.com/product/3660) · [Local family illustration](../hardware/parts/illustrations/module.svg).

- **D0 DIY • adapters / harness / jumper wire:** quantity 1; references `Environmental sensor`.

[AliExpress search — unverified results](https://www.aliexpress.com/wholesale?SearchText=Adafruit3660+BME680+STEMMA+QT+breakout)

<details><summary>Exact BOM row conditions, notes and sources</summary>

- **d0-harness:Environmental sensor:** Harness / external / service; read row notes. I2C sensor at J10 · External ventilated pod; reuse if available; QT cable counted separately

</details>

### Ag97005-FL

Ag97000-FL family image; order specifically Ag97005-FL (5 V), not the 12 V or 24 V variant.

**Manufacturer photo** — Ag97000-FL family image; order specifically Ag97005-FL (5 V), not the 12 V or 24 V variant.

Image: Silvertel. [Source](https://silvertel.com/ag97000/) · [Local family illustration](../hardware/parts/illustrations/module.svg).

Package / dimensions: `Hub:Ag97000_FL`.

- **I0 integrated • fitted parts:** quantity 1; references `U7`.

[AliExpress search — unverified results](https://www.aliexpress.com/wholesale?SearchText=Ag97005-FL)

<details><summary>Exact BOM row conditions, notes and sources</summary>

- **i0:U7:** Fitted to board. Bare isolated PoE module installed on this PCB; not the separate EvalPoE bench board. [Official / original source](https://silvertel.com/images/datasheets/Ag97000-Datasheet-low-cost-isolated-12W-Power-over-Ethernet-PoE-module-solution.pdf).

</details>

### D24V22F3

D24V22F3 side view. Verify the 3.3 V version; the output-current headline at 24 V input does not establish our 5 V thermal capability.

**Manufacturer photo** — D24V22F3 side view. Verify the 3.3 V version; the output-current headline at 24 V input does not establish our 5 V thermal capability.

Image: Pololu. [Source](https://www.pololu.com/product/2857) · [Local family illustration](../hardware/parts/illustrations/module.svg).

Package / dimensions: `Hub:D24V22F3`.

- **I0 integrated • fitted parts:** quantity 1; references `U8`.

[AliExpress search — unverified results](https://www.aliexpress.com/wholesale?SearchText=D24V22F3)

<details><summary>Exact BOM row conditions, notes and sources</summary>

- **i0:U8:** Fitted to board. Only regulator feeding 3V3. 1.5A at 5V input bench gate; soldered headers. [Official / original source](https://www.pololu.com/file/0J1031/d24v22fx-step-down-voltage-regulator-dimension-diagram.pdf).

</details>

### ESP32-H2-DevKitM-1

H2 DevKitM-1 family photo. Check the installed module and isolate conflicting USB-UART signals before low-power harness use.

**Manufacturer photo** — H2 DevKitM-1 family photo. Check the installed module and isolate conflicting USB-UART signals before low-power harness use.

Image: Espressif. [Source](https://docs.espressif.com/projects/esp-dev-kits/en/latest/esp32h2/esp32-h2-devkitm-1/user_guide.html) · [Local family illustration](../hardware/parts/illustrations/module.svg).

- **Additional / reusable / conditional:** quantity 1 alternative bench RCP; references `bench-h2`.

[AliExpress search — unverified results](https://www.aliexpress.com/wholesale?SearchText=ESP32-H2-DevKitM-1)

<details><summary>Exact BOM row conditions, notes and sources</summary>

- **accessory:bench-h2:** LP-P0 bench only. Alternative to the bare H2-MINI on I0. Verify module marking and flash size; onboard USB-UART can conflict with the host TX connection. [Official / original source](https://docs.espressif.com/projects/esp-dev-kits/en/latest/esp32h2/esp32-h2-devkitm-1/user_guide.html).

</details>

### ESP32-H2-DevKitM-1 with4MB flash

H2 DevKitM-1 family photo. Check the installed module and isolate conflicting USB-UART signals before low-power harness use.

**Manufacturer photo** — H2 DevKitM-1 family photo. Check the installed module and isolate conflicting USB-UART signals before low-power harness use.

Image: Espressif. [Source](https://docs.espressif.com/projects/esp-dev-kits/en/latest/esp32h2/esp32-h2-devkitm-1/user_guide.html) · [Local family illustration](../hardware/parts/illustrations/module.svg).

- **D0 DIY • adapters / harness / jumper wire:** quantity 1; references `H2 RCP assembly`.

[AliExpress search — unverified results](https://www.aliexpress.com/wholesale?SearchText=ESP32-H2-DevKitM-1+with4MB+flash)

<details><summary>Exact BOM row conditions, notes and sources</summary>

- **d0-harness:H2 RCP assembly:** Harness / external / service; read row notes. Thread radio at J5 · Verify flash and isolate USB-UART TX from GPIO23; board-specific service/power wiring required

</details>

### ESP32-H2-MINI-1-H4S

Source-derived top-view contact drawing. Not a photograph; distinguish bare module pads from development-board headers.

**Dimensioned diagram** — Source-derived top-view contact drawing. Not a photograph; distinguish bare module pads from development-board headers.

Image: HA Radio Hub project. [Source](../hardware/low-power/visual/physical/README.md) · [Local family illustration](../hardware/parts/illustrations/module.svg).

Package / dimensions: `13.2 × 16.6 × 2.4 mm`.

- **LP-P0 bench reference (not additive):** quantity 1; references `U2`.

[AliExpress search — unverified results](https://www.aliexpress.com/wholesale?SearchText=ESP32-H2-MINI-1-H4S)

<details><summary>Exact BOM row conditions, notes and sources</summary>

- **lp-reference:U2:** Reference only; carrier. 4 MB flash, separate Thread RCP. Verify the bench DevKitM-1 flash size and isolate its USB-UART TX from GPIO23. [Official / original source](https://www.espressif.com/sites/default/files/documentation/esp32-h2-mini-1_mini-1u_datasheet_en.pdf).

</details>

### ESP32-H2-MINI-1-H4S

Source-derived top-view contact drawing. Not a photograph; distinguish bare module pads from development-board headers.

**Dimensioned diagram** — Source-derived top-view contact drawing. Not a photograph; distinguish bare module pads from development-board headers.

Image: HA Radio Hub project. [Source](../hardware/low-power/visual/physical/README.md) · [Local family illustration](../hardware/parts/illustrations/module.svg).

Package / dimensions: `Hub:ESP32-H2-MINI-1`.

- **I0 integrated • fitted parts:** quantity 1; references `U2`.

[AliExpress search — unverified results](https://www.aliexpress.com/wholesale?SearchText=ESP32-H2-MINI-1-H4S)

<details><summary>Exact BOM row conditions, notes and sources</summary>

- **i0:U2:** Fitted to board. Module pad numbers, not development-board header positions. [Official / original source](https://www.espressif.com/sites/default/files/documentation/esp32-h2-mini-1_mini-1u_datasheet_en.pdf).

</details>

### ESP32-S3-DevKitC-1 N16R8

DevKitC-1 v1.1 family photo; check N16R8 marking. Low-power wiring requires the documented USB-UART/LED isolation checks.

**Manufacturer photo** — DevKitC-1 v1.1 family photo; check N16R8 marking. Low-power wiring requires the documented USB-UART/LED isolation checks.

Image: Espressif. [Source](https://docs.espressif.com/projects/esp-dev-kits/en/latest/esp32s3/esp32-s3-devkitc-1/user_guide_v1.1.html) · [Local family illustration](../hardware/parts/illustrations/module.svg).

- **Additional / reusable / conditional:** quantity 1 alternative bench host; references `bench-s3`.

[AliExpress search — unverified results](https://www.aliexpress.com/wholesale?SearchText=ESP32-S3-DevKitC-1+N16R8)

<details><summary>Exact BOM row conditions, notes and sources</summary>

- **accessory:bench-s3:** LP-P0 bench only. Development-board alternative to the bare WROOM module; not an extra fitted part on I0. USB-UART GPIO44 and revision-dependent LED GPIO48 require physical isolation where documented. [Official / original source](https://docs.espressif.com/projects/esp-dev-kits/en/latest/esp32s3/esp32-s3-devkitc-1/user_guide_v1.1.html).

</details>

### ESP32-S3-DevKitC-1 N16R8 or verified equivalent

DevKitC-1 v1.1 family photo; check N16R8 marking. Low-power wiring requires the documented USB-UART/LED isolation checks.

**Manufacturer photo** — DevKitC-1 v1.1 family photo; check N16R8 marking. Low-power wiring requires the documented USB-UART/LED isolation checks.

Image: Espressif. [Source](https://docs.espressif.com/projects/esp-dev-kits/en/latest/esp32s3/esp32-s3-devkitc-1/user_guide_v1.1.html) · [Local family illustration](../hardware/parts/illustrations/module.svg).

- **D0 DIY • adapters / harness / jumper wire:** quantity 1; references `S3 host assembly`.

[AliExpress search — unverified results](https://www.aliexpress.com/wholesale?SearchText=ESP32-S3-DevKitC-1+N16R8+or+verified+equivalent)

<details><summary>Exact BOM row conditions, notes and sources</summary>

- **d0-harness:S3 host assembly:** Harness / external / service; read row notes. LP-P0 host at J3 · Reuse existing only after USB-UART/LED/power isolation and GPIO48 checks; actual header locations verified before wiring

</details>

### ESP32-S3-WROOM-1-N16R8

Source-derived top-view contact drawing. Not a photograph; distinguish bare module pads from development-board headers.

**Dimensioned diagram** — Source-derived top-view contact drawing. Not a photograph; distinguish bare module pads from development-board headers.

Image: HA Radio Hub project. [Source](../hardware/low-power/visual/physical/README.md) · [Local family illustration](../hardware/parts/illustrations/module.svg).

Package / dimensions: `18 × 25.5 × 3.1 mm`.

- **LP-P0 bench reference (not additive):** quantity 1; references `U1`.

[AliExpress search — unverified results](https://www.aliexpress.com/wholesale?SearchText=ESP32-S3-WROOM-1-N16R8)

<details><summary>Exact BOM row conditions, notes and sources</summary>

- **lp-reference:U1:** Reference only; carrier. Bare module, 16 MB flash, 8 MB PSRAM. Bench: existing N16R8 DevKit only after USB-UART, LED and power isolation checks. [Official / original source](https://www.espressif.com/sites/default/files/documentation/esp32-s3-wroom-1_wroom-1u_datasheet_en.pdf).

</details>

### ESP32-S3-WROOM-1-N16R8

Source-derived top-view contact drawing. Not a photograph; distinguish bare module pads from development-board headers.

**Dimensioned diagram** — Source-derived top-view contact drawing. Not a photograph; distinguish bare module pads from development-board headers.

Image: HA Radio Hub project. [Source](../hardware/low-power/visual/physical/README.md) · [Local family illustration](../hardware/parts/illustrations/module.svg).

Package / dimensions: `Hub:ESP32-S3-WROOM-1`.

- **I0 integrated • fitted parts:** quantity 1; references `U1`.

[AliExpress search — unverified results](https://www.aliexpress.com/wholesale?SearchText=ESP32-S3-WROOM-1-N16R8)

<details><summary>Exact BOM row conditions, notes and sources</summary>

- **i0:U1:** Fitted to board. Module pad numbers, not development-board header positions. [Official / original source](https://www.espressif.com/sites/default/files/documentation/esp32-s3-wroom-1_wroom-1u_datasheet_en.pdf).

</details>

### Existing regional Zooz ZAC93 module

ZAC93 product appearance. Keep the correct regional radio version and verify the physical revision before wiring.

**Manufacturer photo** — ZAC93 product appearance. Keep the correct regional radio version and verify the physical revision before wiring.

Image: Zooz. [Source](https://www.getzooz.com/zac93-gpio-module/) · [Local family illustration](../hardware/parts/illustrations/module.svg).

- **LP-P0 bench reference (not additive):** quantity 1; references `U5`.

[AliExpress search — unverified results](https://www.aliexpress.com/wholesale?SearchText=Existing+regional+Zooz+ZAC93+module)

<details><summary>Exact BOM row conditions, notes and sources</summary>

- **lp-reference:U5:** Reference only; both. 3.3 V only; retain the regional antenna. Inspect board revision, pin 7 reset function and physical dimensions before mounting. [Official / original source](https://www.getzooz.com/downloads/zooz-z-wave-800-series-long-range-gpio-module-zac93-LR-manual.pdf).

</details>

### Hi-Link HLK-LD2450

HLK-LD2450 24 GHz tracking radar. LD2410 / LD2420 are not substitutions.

**Manufacturer photo** — HLK-LD2450 24 GHz tracking radar. LD2410 / LD2420 are not substitutions.

Image: Hi-Link. [Source](https://www.hlktech.com/Goods-352.html) · [Local family illustration](../hardware/parts/illustrations/module.svg).

Package / dimensions: `44x15 nominal_verify`.

- **Original Pi modular hub:** quantity 1; references `U6`.

[AliExpress search — unverified results](https://www.aliexpress.com/wholesale?SearchText=Hi-Link+HLK-LD2450)

<details><summary>Exact BOM row conditions, notes and sources</summary>

- **modular:U6:** common. Radar · 5V UART3.3V256000 · 24GHz;include matching4wire cable;front radome [Official / original source](https://esphome.io/components/sensor/ld2450/).

</details>

### Hi-Link HLK-LD2450

HLK-LD2450 24 GHz tracking radar. LD2410 / LD2420 are not substitutions.

**Manufacturer photo** — HLK-LD2450 24 GHz tracking radar. LD2410 / LD2420 are not substitutions.

Image: Hi-Link. [Source](https://www.hlktech.com/Goods-352.html) · [Local family illustration](../hardware/parts/illustrations/module.svg).

Package / dimensions: `44 × 15 mm; height unspecified`.

- **LP-P0 bench reference (not additive):** quantity 1; references `U7`.

[AliExpress search — unverified results](https://www.aliexpress.com/wholesale?SearchText=Hi-Link+HLK-LD2450)

<details><summary>Exact BOM row conditions, notes and sources</summary>

- **lp-reference:U7:** Reference only; both. 5 V supply, 3.3 V UART. Reuse a matching cable; never infer wire order from color. [Official / original source](https://r0.hlktech.com/download/HLK-LD2450-24G/1/HLK%20LD2450%201T2R%E8%BF%90%E5%8A%A8%E7%9B%AE%E6%A0%87%E6%A3%80%E6%B5%8B%E8%BF%BD%E8%B8%AA%E6%A8%A1%E7%BB%84%E8%AF%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).

</details>

### MGM240PA22VNA3

Source-derived top-view contact drawing. Not a photograph; distinguish bare module pads from development-board headers.

**Dimensioned diagram** — Source-derived top-view contact drawing. Not a photograph; distinguish bare module pads from development-board headers.

Image: HA Radio Hub project. [Source](../hardware/low-power/visual/physical/README.md) · [Local family illustration](../hardware/parts/illustrations/module.svg).

Package / dimensions: `12.9 × 15 × 2.2 mm`.

- **LP-P0 bench reference (not additive):** quantity 1; references `U3`.

[AliExpress search — unverified results](https://www.aliexpress.com/wholesale?SearchText=MGM240PA22VNA3)

<details><summary>Exact BOM row conditions, notes and sources</summary>

- **lp-reference:U3:** Reference only; carrier. 10 dBm, internal antenna. Exact-pin Ember NCP and UART bootloader build recipe in firmware/low-power/mg24 passes offline checks; SWD programming and hardware validation remain required. [Official / original source](https://www.silabs.com/documents/public/data-sheets/mgm240p-datasheet.pdf).

</details>

### MGM240PA22VNA3

Source-derived top-view contact drawing. Not a photograph; distinguish bare module pads from development-board headers.

**Dimensioned diagram** — Source-derived top-view contact drawing. Not a photograph; distinguish bare module pads from development-board headers.

Image: HA Radio Hub project. [Source](../hardware/low-power/visual/physical/README.md) · [Local family illustration](../hardware/parts/illustrations/module.svg).

Package / dimensions: `Carrier:MGM240P`.

- **M0 MG24 adapter • fitted parts:** quantity 1; references `U1`.

[AliExpress search — unverified results](https://www.aliexpress.com/wholesale?SearchText=MGM240PA22VNA3)

<details><summary>Exact BOM row conditions, notes and sources</summary>

- **m0:U1:** Fitted to board. Exact PA22VNA3 firmware target; all GND pads direct to plane; RFOUT33 intentionally NC [Official / original source](https://www.silabs.com/documents/public/data-sheets/mgm240p-datasheet.pdf).

</details>

### MGM240PA22VNA3

Source-derived top-view contact drawing. Not a photograph; distinguish bare module pads from development-board headers.

**Dimensioned diagram** — Source-derived top-view contact drawing. Not a photograph; distinguish bare module pads from development-board headers.

Image: HA Radio Hub project. [Source](../hardware/low-power/visual/physical/README.md) · [Local family illustration](../hardware/parts/illustrations/module.svg).

Package / dimensions: `Hub:MGM240P`.

- **I0 integrated • fitted parts:** quantity 1; references `U3`.

[AliExpress search — unverified results](https://www.aliexpress.com/wholesale?SearchText=MGM240PA22VNA3)

<details><summary>Exact BOM row conditions, notes and sources</summary>

- **i0:U3:** Fitted to board. Module pad numbers, not development-board header positions. [Official / original source](https://www.silabs.com/documents/public/data-sheets/mgm240p-datasheet.pdf).

</details>

### Pololu D24V22F3 / item 2857

D24V22F3 side view. Verify the 3.3 V version; the output-current headline at 24 V input does not establish our 5 V thermal capability.

**Manufacturer photo** — D24V22F3 side view. Verify the 3.3 V version; the output-current headline at 24 V input does not establish our 5 V thermal capability.

Image: Pololu. [Source](https://www.pololu.com/product/2857) · [Local family illustration](../hardware/parts/illustrations/module.svg).

Package / dimensions: `17.8 × 17.8 mm; height unspecified`.

- **LP-P0 bench reference (not additive):** quantity 1; references `P3`.

[AliExpress search — unverified results](https://www.aliexpress.com/wholesale?SearchText=Pololu+D24V22F3+%2F+item+2857)

<details><summary>Exact BOM row conditions, notes and sources</summary>

- **lp-reference:P3:** Reference only; both. Synchronous 5 V to 3.3 V buck. Advertised 2.6 A is typical at 24 V input; validate 1.5 A at 5 V input. Do not substitute an LDO. [Official / original source](https://www.pololu.com/product/2857).

</details>

### Pololu D24V22F3 / item2857

D24V22F3 side view. Verify the 3.3 V version; the output-current headline at 24 V input does not establish our 5 V thermal capability.

**Manufacturer photo** — D24V22F3 side view. Verify the 3.3 V version; the output-current headline at 24 V input does not establish our 5 V thermal capability.

Image: Pololu. [Source](https://www.pololu.com/product/2857) · [Local family illustration](../hardware/parts/illustrations/module.svg).

- **D0 DIY • adapters / harness / jumper wire:** quantity 1; references `3V3 buck`.

[AliExpress search — unverified results](https://www.aliexpress.com/wholesale?SearchText=Pololu+D24V22F3+%2F+item2857)

<details><summary>Exact BOM row conditions, notes and sources</summary>

- **d0-harness:3V3 buck:** Harness / external / service; read row notes. External 5V-to-3V3 regulator at J2 · No second 3V3 source; test 1.5A at5V input and cooling

</details>

### Pololu D24V22F3 item 2857

D24V22F3 side view. Verify the 3.3 V version; the output-current headline at 24 V input does not establish our 5 V thermal capability.

**Manufacturer photo** — D24V22F3 side view. Verify the 3.3 V version; the output-current headline at 24 V input does not establish our 5 V thermal capability.

Image: Pololu. [Source](https://www.pololu.com/product/2857) · [Local family illustration](../hardware/parts/illustrations/module.svg).

- **C0 carrier • harness / external:** quantity 1; references `3V3 buck`.

[AliExpress search — unverified results](https://www.aliexpress.com/wholesale?SearchText=Pololu+D24V22F3+item+2857)

<details><summary>Exact BOM row conditions, notes and sources</summary>

- **c0-harness:3V3 buck:** Harness / external / service; read row notes. J2 · External module, no second 3.3 V source; test load and cooling

</details>

### SMLIGHT SLZB-07Mg24 EFR32MG24

Manufacturer SLZB-07 family render. Read the Mg24 model marking; the shared enclosure does not identify the radio.

**Manufacturer render** — Manufacturer SLZB-07 family render. Read the Mg24 model marking; the shared enclosure does not identify the radio.

Image: SMLIGHT. [Source](https://smlight.tech/products/slzb-07mg24) · [Local family illustration](../hardware/parts/illustrations/module.svg).

Package / dimensions: `18x54x10 excluding_antenna`.

- **Original Pi modular hub:** quantity 1; references `U2`.

[AliExpress search — unverified results](https://www.aliexpress.com/wholesale?SearchText=SMLIGHT+SLZB-07Mg24+EFR32MG24)

<details><summary>Exact BOM row conditions, notes and sources</summary>

- **modular:U2:** common. Zigbee coordinator · USB 5V Zigbee NCP · Order Mg24 explicitly;retain supplied antenna;not generic SLZB-07 MG21;vendor operating ambient +5 to +35C [Official / original source](https://smlight.tech/products/slzb-07mg24).

</details>

### Second Waveshare ESP32-S3-ETH-M

ESP32-S3-ETH-M with headers. The baseline excludes the optional PoE board, camera and microSD.

**Manufacturer photo** — ESP32-S3-ETH-M with headers. The baseline excludes the optional PoE board, camera and microSD.

Image: Waveshare. [Source](https://www.waveshare.com/product/esp32-s3-eth.htm) · [Local family illustration](../hardware/parts/illustrations/module.svg).

Package / dimensions: `72.8x21 planar_outline;height_with_headers_verify`.

- **Original Pi modular hub:** quantity 1; references `U10`.

[AliExpress search — unverified results](https://www.aliexpress.com/wholesale?SearchText=Second+Waveshare+ESP32-S3-ETH-M)

<details><summary>Exact BOM row conditions, notes and sources</summary>

- **modular:U10:** wired_rf_only. RF Ethernet replacement · USB5V W5500 CC1101_SPI · SKU34882;pre-soldered male headers;replaces U8;add C8 C9 R1;no camera SD or PoE module;recheck20W budget [Official / original source](https://www.waveshare.com/product/iot-communication/wired-comm-converter/esp32-s3-eth.htm).

</details>

### Silvertel Ag97005-FL

Ag97000-FL family image; order specifically Ag97005-FL (5 V), not the 12 V or 24 V variant.

**Manufacturer photo** — Ag97000-FL family image; order specifically Ag97005-FL (5 V), not the 12 V or 24 V variant.

Image: Silvertel. [Source](https://silvertel.com/ag97000/) · [Local family illustration](../hardware/parts/illustrations/module.svg).

Package / dimensions: `56.01 × 14.02 × 13 mm`.

- **LP-P0 bench reference (not additive):** quantity 1; references `P1`.

[AliExpress search — unverified results](https://www.aliexpress.com/wholesale?SearchText=Silvertel+Ag97005-FL)

<details><summary>Exact BOM row conditions, notes and sources</summary>

- **lp-reference:P1:** Reference only; both. 5 V, 1.8 A nominal, 9 W; integrated bridge, class 0. Do not substitute the 12 V variant. [Official / original source](https://silvertel.com/images/datasheets/Ag97000-Datasheet-low-cost-isolated-12W-Power-over-Ethernet-PoE-module-solution.pdf).

</details>

### Silvertel Ag97005-FL 5V

Ag97000-FL family image; order specifically Ag97005-FL (5 V), not the 12 V or 24 V variant.

**Manufacturer photo** — Ag97000-FL family image; order specifically Ag97005-FL (5 V), not the 12 V or 24 V variant.

Image: Silvertel. [Source](https://silvertel.com/ag97000/) · [Local family illustration](../hardware/parts/illustrations/module.svg).

- **D0 DIY • adapters / harness / jumper wire:** quantity 1; references `PoE PD module`.

[AliExpress search — unverified results](https://www.aliexpress.com/wholesale?SearchText=Silvertel+Ag97005-FL+5V)

<details><summary>Exact BOM row conditions, notes and sources</summary>

- **d0-harness:PoE PD module:** Harness / external / service; read row notes. External isolated 5V source · Fit to compatible Silvertel EvalPoE; verify output before J1. Not raw 48V, not a second source; see low-power/bom.json

</details>

### Silvertel EvalPoE

Evaluation-board family image. Online EvalPoE orders may omit the PD module; inspect package contents.

**Manufacturer photo** — Evaluation-board family image. Online EvalPoE orders may omit the PD module; inspect package contents.

Image: Silvertel. [Source](https://silvertel.com/ag97000/) · [Local family illustration](../hardware/parts/illustrations/module.svg).

- **LP-P0 bench reference (not additive):** quantity 1; references `P2`.
- **D0 DIY • adapters / harness / jumper wire:** quantity 1; references `PoE evaluation carrier`.

[AliExpress search — unverified results](https://www.aliexpress.com/wholesale?SearchText=Silvertel+EvalPoE)

<details><summary>Exact BOM row conditions, notes and sources</summary>

- **lp-reference:P2:** Reference only; bench. Order Ag97005-FL separately; compatibility is explicit on the manufacturer page. DATA OUT connects to WIZ850io. The evaluation board is excluded from the compact CAD. [Official / original source](https://silvertel.com/ag97000/).
- **d0-harness:PoE evaluation carrier:** Harness / external / service; read row notes. Factory PoE front end for bench build · Ag97005-FL ordered separately; DATA OUT to WIZ850io; excluded from D0 copper and enclosure

</details>

### WIZnet WIZ850io

WIZ850io module with magnetics and RJ45. It is not a bare W5500 or an arbitrary W5500 breakout.

**Manufacturer photo** — WIZ850io module with magnetics and RJ45. It is not a bare W5500 or an arbitrary W5500 breakout.

Image: WIZnet. [Source](https://docs.wiznet.io/Product/ioModule/WIZ850io) · [Local family illustration](../hardware/parts/illustrations/module.svg).

Package / dimensions: `25 × 23 mm; height unspecified`.

- **LP-P0 bench reference (not additive):** quantity 1; references `U4`.

[AliExpress search — unverified results](https://www.aliexpress.com/wholesale?SearchText=WIZnet+WIZ850io)

<details><summary>Exact BOM row conditions, notes and sources</summary>

- **lp-reference:U4:** Reference only; bench. SPI Ethernet module with RJ45. No PoE center-tap headers. Mechanical section says 25 by 23 mm; feature section says 20 by 25 mm. Verify the drawing. [Official / original source](https://docs.wiznet.io/Product/ioModule/WIZ850io).

</details>

### WIZnet WIZ850io

WIZ850io module with magnetics and RJ45. It is not a bare W5500 or an arbitrary W5500 breakout.

**Manufacturer photo** — WIZ850io module with magnetics and RJ45. It is not a bare W5500 or an arbitrary W5500 breakout.

Image: WIZnet. [Source](https://docs.wiznet.io/Product/ioModule/WIZ850io) · [Local family illustration](../hardware/parts/illustrations/module.svg).

- **D0 DIY • adapters / harness / jumper wire:** quantity 1; references `Ethernet module`.

[AliExpress search — unverified results](https://www.aliexpress.com/wholesale?SearchText=WIZnet+WIZ850io)

<details><summary>Exact BOM row conditions, notes and sources</summary>

- **d0-harness:Ethernet module:** Harness / external / service; read row notes. SPI Ethernet at J4 · Verify J1/J2 module numbering; included magnetics; not a PoE PD

</details>

### Waveshare ESP32-S3-ETH-M

ESP32-S3-ETH-M with headers. The baseline excludes the optional PoE board, camera and microSD.

**Manufacturer photo** — ESP32-S3-ETH-M with headers. The baseline excludes the optional PoE board, camera and microSD.

Image: Waveshare. [Source](https://www.waveshare.com/product/esp32-s3-eth.htm) · [Local family illustration](../hardware/parts/illustrations/module.svg).

Package / dimensions: `72.8x21 planar_outline;height_with_headers_verify`.

- **Original Pi modular hub:** quantity 1; references `U4`.

[AliExpress search — unverified results](https://www.aliexpress.com/wholesale?SearchText=Waveshare+ESP32-S3-ETH-M)

<details><summary>Exact BOM row conditions, notes and sources</summary>

- **modular:U4:** common. ESPHome Ethernet node · USB5V;16MB flash8MB PSRAM · SKU34882;pre-soldered male headers;without PoE module camera or microSD [Official / original source](https://www.waveshare.com/product/iot-communication/wired-comm-converter/esp32-s3-eth.htm).

</details>

### Zooz ZAC93 existing regional module

ZAC93 product appearance. Keep the correct regional radio version and verify the physical revision before wiring.

**Manufacturer photo** — ZAC93 product appearance. Keep the correct regional radio version and verify the physical revision before wiring.

Image: Zooz. [Source](https://www.getzooz.com/zac93-gpio-module/) · [Local family illustration](../hardware/parts/illustrations/module.svg).

Package / dimensions: `measure_revision`.

- **Original Pi modular hub:** quantity 1; references `U5`.

[AliExpress search — unverified results](https://www.aliexpress.com/wholesale?SearchText=Zooz+ZAC93+existing+regional+module)

<details><summary>Exact BOM row conditions, notes and sources</summary>

- **modular:U5:** common. Z-Wave module · 3.3V UART115200 · Onboard antenna;check region;do not feed5V;vendor operating ambient0 to40C;co-location conditions see antennas.md [Official / original source](https://www.getzooz.com/downloads/zooz-z-wave-800-series-long-range-gpio-module-zac93-LR-manual.pdf).

</details>

### Zooz ZAC93 of the correct regional frequency

ZAC93 product appearance. Keep the correct regional radio version and verify the physical revision before wiring.

**Manufacturer photo** — ZAC93 product appearance. Keep the correct regional radio version and verify the physical revision before wiring.

Image: Zooz. [Source](https://www.getzooz.com/zac93-gpio-module/) · [Local family illustration](../hardware/parts/illustrations/module.svg).

- **D0 DIY • adapters / harness / jumper wire:** quantity 1; references `Z-Wave module`.

[AliExpress search — unverified results](https://www.aliexpress.com/wholesale?SearchText=Zooz+ZAC93+of+the+correct+regional+frequency)

<details><summary>Exact BOM row conditions, notes and sources</summary>

- **d0-harness:Z-Wave module:** Harness / external / service; read row notes. Z-Wave at J8 · Reuse existing only after physical pin identification; antenna is module-specific

</details>

<details>
<summary><strong>Antenna: 6 identification cards</strong></summary>

### 2.4GHz50ohm IPEXGen1 external antenna

Original family illustration, not a photo or a footprint. Package dimensions and terminal layout must be checked against the exact row and datasheet.

**Original illustration** — Original family illustration, not a photo or a footprint. Package dimensions and terminal layout must be checked against the exact row and datasheet.

Image: HA Radio Hub project · MIT. [Local family illustration](../hardware/parts/illustrations/antenna.svg).

Package / dimensions: `measure`.

- **Original Pi modular hub:** quantity 1; references `A3`.

[AliExpress search — unverified results](https://www.aliexpress.com/wholesale?SearchText=2.4GHz50ohm+IPEXGen1+external+antenna)

<details><summary>Exact BOM row conditions, notes and sources</summary>

- **modular:A3:** optional. Optional BLE antenna · requires_R0_selection_rework · Onboard ceramic is default;plugging antenna alone does not select it [Official / original source](https://www.waveshare.com/wiki/ESP32-S3-ETH).

</details>

### 433.92 MHz 50 Ω antenna matched to the existing CC1101 module

Original family illustration, not a photo or a footprint. Package dimensions and terminal layout must be checked against the exact row and datasheet.

**Original illustration** — Original family illustration, not a photo or a footprint. Package dimensions and terminal layout must be checked against the exact row and datasheet.

Image: HA Radio Hub project · MIT. [Local family illustration](../hardware/parts/illustrations/antenna.svg).

- **Additional / reusable / conditional:** quantity 1 if not already supplied; references `antennas`.

[AliExpress search — unverified results](https://www.aliexpress.com/wholesale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)

<details><summary>Exact BOM row conditions, notes and sources</summary>

- **accessory:antennas:** C0 / I0 / LP-P0 RF. Confirm SMA versus RP-SMA and gender from the real module. S3-WROOM-1, H2-MINI-1 and MGM240PA22VNA3 have integrated antennas; do not add pigtails to their unconnected RF pads. Keep all antenna clearance regions free. [Official / original source](https://www.ti.com/product/CC1101).

</details>

### Existing CC1101 433.92 MHz module with SMA antenna

Original family illustration, not a photo or a footprint. Package dimensions and terminal layout must be checked against the exact row and datasheet.

**Original illustration** — Original family illustration, not a photo or a footprint. Package dimensions and terminal layout must be checked against the exact row and datasheet.

Image: HA Radio Hub project · MIT. [Local family illustration](../hardware/parts/illustrations/antenna.svg).

- **LP-P0 bench reference (not additive):** quantity 1; references `U6`.

[AliExpress search — unverified results](https://www.aliexpress.com/wholesale?SearchText=Existing+CC1101+433.92+MHz+module+with+SMA+antenna)

<details><summary>Exact BOM row conditions, notes and sources</summary>

- **lp-reference:U6:** Reference only; both. Must expose GDO2. The chip datasheet does not define the existing module header or dimensions. Retain the 433 MHz antenna. [Official / original source](https://www.ti.com/lit/ds/symlink/cc1101.pdf).

</details>

### Existing CC1101 433MHz module and matching antenna

Original family illustration, not a photo or a footprint. Package dimensions and terminal layout must be checked against the exact row and datasheet.

**Original illustration** — Original family illustration, not a photo or a footprint. Package dimensions and terminal layout must be checked against the exact row and datasheet.

Image: HA Radio Hub project · MIT. [Local family illustration](../hardware/parts/illustrations/antenna.svg).

- **D0 DIY • adapters / harness / jumper wire:** quantity 1; references `RF module`.

[AliExpress search — unverified results](https://www.aliexpress.com/wholesale?SearchText=Existing+CC1101+433MHz+module+and+matching+antenna)

<details><summary>Exact BOM row conditions, notes and sources</summary>

- **d0-harness:RF module:** Harness / external / service; read row notes. RF at J7 · Verify module revision and physical pad map; do not buy duplicate if reusing

</details>

### Existing matched433.92MHz antenna

Original family illustration, not a photo or a footprint. Package dimensions and terminal layout must be checked against the exact row and datasheet.

**Original illustration** — Original family illustration, not a photo or a footprint. Package dimensions and terminal layout must be checked against the exact row and datasheet.

Image: HA Radio Hub project · MIT. [Local family illustration](../hardware/parts/illustrations/antenna.svg).

Package / dimensions: `measure`.

- **Original Pi modular hub:** quantity 1; references `A2`.

[AliExpress search — unverified results](https://www.aliexpress.com/wholesale?SearchText=Existing+matched433.92MHz+antenna)

<details><summary>Exact BOM row conditions, notes and sources</summary>

- **modular:A2:** common. RF antenna · 50ohm_as_module_requires · Separate from ZWave PCB radiator;verify connector SMA vs RP-SMA [Official / original source](https://github.com/ha-homelab/rf-airbridge).

</details>

### Original supplied with SLZB-07Mg24

Original family illustration, not a photo or a footprint. Package dimensions and terminal layout must be checked against the exact row and datasheet.

**Original illustration** — Original family illustration, not a photo or a footprint. Package dimensions and terminal layout must be checked against the exact row and datasheet.

Image: HA Radio Hub project · MIT. [Local family illustration](../hardware/parts/illustrations/antenna.svg).

Package / dimensions: `measure`.

- **Original Pi modular hub:** quantity 1; references `A1`.

[AliExpress search — unverified results](https://www.aliexpress.com/wholesale?SearchText=Original+supplied+with+SLZB-07Mg24)

<details><summary>Exact BOM row conditions, notes and sources</summary>

- **modular:A1:** common. Zigbee antenna · 2.4GHz50ohm · Keep vendor antenna and TX power;do not substitute high gain blindly [Official / original source](https://smlight.tech/products/slzb-07mg24).

</details>

</details>

<details>
<summary><strong>Cable: 20 identification cards</strong></summary>

### 18-20AWG trunk;20AWG Pi lead;22-24AWG other branches

Original family illustration, not a photo or a footprint. Package dimensions and terminal layout must be checked against the exact row and datasheet.

**Original illustration** — Original family illustration, not a photo or a footprint. Package dimensions and terminal layout must be checked against the exact row and datasheet.

Image: HA Radio Hub project · MIT. [Local family illustration](../hardware/parts/illustrations/cable.svg).

Package / dimensions: `layout_dependent`.

- **Original Pi modular hub:** quantity 1; references `C7`.

[AliExpress search — unverified results](https://www.aliexpress.com/wholesale?SearchText=18-20AWG+trunk%3B20AWG+Pi+lead%3B22-24AWG+other+branches)

<details><summary>Exact BOM row conditions, notes and sources</summary>

- **modular:C7:** common. Low voltage wire kit · 5V and3V3 separate · Color coding alone is not pin verification

</details>

### 2x5 mating header and4signal wires to S3 female sockets

Original family illustration, not a photo or a footprint. Package dimensions and terminal layout must be checked against the exact row and datasheet.

**Original illustration** — Original family illustration, not a photo or a footprint. Package dimensions and terminal layout must be checked against the exact row and datasheet.

Image: HA Radio Hub project · MIT. [Local family illustration](../hardware/parts/illustrations/cable.svg).

Package / dimensions: `shortest_practical`.

- **Original Pi modular hub:** quantity 1; references `C12`.

[AliExpress search — unverified results](https://www.aliexpress.com/wholesale?SearchText=2x5+mating+header+and4signal+wires+to+S3+female+sockets)

<details><summary>Exact BOM row conditions, notes and sources</summary>

- **modular:C12:** common. ZAC93 adapter harness · 3V3 GND UART TX RX · Match existingZAC93 header pitch and sex;route only pins1 6 8 10;mechanically keyed or clearly mark pin1;leave pin7 unused

</details>

### 3.3 V USB UART adapter plus USB data cable

Original family illustration, not a photo or a footprint. Package dimensions and terminal layout must be checked against the exact row and datasheet.

**Original illustration** — Original family illustration, not a photo or a footprint. Package dimensions and terminal layout must be checked against the exact row and datasheet.

Image: HA Radio Hub project · MIT. [Local family illustration](../hardware/parts/illustrations/cable.svg).

- **Additional / reusable / conditional:** quantity 1 reusable tool; references `uart`.

[AliExpress search — unverified results](https://www.aliexpress.com/wholesale?SearchText=3.3+V+USB+UART+adapter+plus+USB+data+cable)

<details><summary>Exact BOM row conditions, notes and sources</summary>

- **accessory:uart:** Flashing / diagnostics. Verify signal voltage, not just the power jumper. Use the documented boot/reset sequence; avoid two powered outputs driving the same UART signal. [Official / original source](https://docs.espressif.com/projects/esptool/en/latest/esp32s3/esptool/entering-bootloader.html).

</details>

### 5.5x2.1mm female mating pigtail for PS1 male DC tail

Original family illustration, not a photo or a footprint. Package dimensions and terminal layout must be checked against the exact row and datasheet.

**Original illustration** — Original family illustration, not a photo or a footprint. Package dimensions and terminal layout must be checked against the exact row and datasheet.

Image: HA Radio Hub project · MIT. [Local family illustration](../hardware/parts/illustrations/cable.svg).

Package / dimensions: `shortest_practical`.

- **Original Pi modular hub:** quantity 1; references `C10`.

[AliExpress search — unverified results](https://www.aliexpress.com/wholesale?SearchText=5.5x2.1mm+female+mating+pigtail+for+PS1+male+DC+tail)

<details><summary>Exact BOM row conditions, notes and sources</summary>

- **modular:C10:** common. Splitter DC mating lead · 5V5A complete cable and connector rating · Input to J1 via main F1;18-20AWG;verify center polarity and5A rating;not unrated CCTV screw-terminal adapter

</details>

### 5V distribution to microUSB

Original family illustration, not a photo or a footprint. Package dimensions and terminal layout must be checked against the exact row and datasheet.

**Original illustration** — Original family illustration, not a photo or a footprint. Package dimensions and terminal layout must be checked against the exact row and datasheet.

Image: HA Radio Hub project · MIT. [Local family illustration](../hardware/parts/illustrations/cable.svg).

Package / dimensions: `150-250 length`.

- **Original Pi modular hub:** quantity 1; references `C5`.

[AliExpress search — unverified results](https://www.aliexpress.com/wholesale?SearchText=5V+distribution+to+microUSB)

<details><summary>Exact BOM row conditions, notes and sources</summary>

- **modular:C5:** compatibility_wifi_only. NodeMCU power cable · 5V1A rated · Compatibility branch only

</details>

### 8signal wires or matched8pin connector

Original family illustration, not a photo or a footprint. Package dimensions and terminal layout must be checked against the exact row and datasheet.

**Original illustration** — Original family illustration, not a photo or a footprint. Package dimensions and terminal layout must be checked against the exact row and datasheet.

Image: HA Radio Hub project · MIT. [Local family illustration](../hardware/parts/illustrations/cable.svg).

Package / dimensions: `shortest_practical`.

- **Original Pi modular hub:** quantity 1; references `C14`.

[AliExpress search — unverified results](https://www.aliexpress.com/wholesale?SearchText=8signal+wires+or+matched8pin+connector)

<details><summary>Exact BOM row conditions, notes and sources</summary>

- **modular:C14:** wired_rf_only. CC1101 adapter harness · 3V3 GND SCLK MOSI MISO CS GDO0 GDO2 · WiredRF uses8signals;reuse connector only after pinout inspection;GDO2 must be accessible;R1 connects to local3V3

</details>

### Adafruit 4210 100 mm JST SH 4-pin

Original family illustration, not a photo or a footprint. Package dimensions and terminal layout must be checked against the exact row and datasheet.

**Original illustration** — Original family illustration, not a photo or a footprint. Package dimensions and terminal layout must be checked against the exact row and datasheet.

Image: HA Radio Hub project · MIT. [Local family illustration](../hardware/parts/illustrations/cable.svg).

- **C0 carrier • harness / external:** quantity 1; references `QT cable`.

[AliExpress search — unverified results](https://www.aliexpress.com/wholesale?SearchText=Adafruit+4210+100+mm+JST+SH+4-pin)

<details><summary>Exact BOM row conditions, notes and sources</summary>

- **c0-harness:QT cable:** Harness / external / service; read row notes. J10 to BME680 · Premade cable replaces loose SH crimps; verify wire order

</details>

### Adafruit 4536 DC barrel jack to USB-C adapter

Original family illustration, not a photo or a footprint. Package dimensions and terminal layout must be checked against the exact row and datasheet.

**Original illustration** — Original family illustration, not a photo or a footprint. Package dimensions and terminal layout must be checked against the exact row and datasheet.

Image: HA Radio Hub project · MIT. [Local family illustration](../hardware/parts/illustrations/cable.svg).

Package / dimensions: `adapter_envelope_measure`.

- **Original Pi modular hub:** quantity 1; references `C3`.

[AliExpress search — unverified results](https://www.aliexpress.com/wholesale?SearchText=Adafruit+4536+DC+barrel+jack+to+USB-C+adapter)

<details><summary>Exact BOM row conditions, notes and sources</summary>

- **modular:C3:** common. Pi USB-C power adapter · 5V only;3A assembly load test required · Vendor explicitly supports Pi4;no published standalone3A rating;requires C17 source plug lead;no PD or protection;never dual-power [Official / original source](https://www.adafruit.com/product/4536).

</details>

### Adafruit4397 JST-SH4pin to female sockets150mm

Original family illustration, not a photo or a footprint. Package dimensions and terminal layout must be checked against the exact row and datasheet.

**Original illustration** — Original family illustration, not a photo or a footprint. Package dimensions and terminal layout must be checked against the exact row and datasheet.

Image: HA Radio Hub project · MIT. [Local family illustration](../hardware/parts/illustrations/cable.svg).

Package / dimensions: `150 length`.

- **Original Pi modular hub:** quantity 1; references `C6`.

[AliExpress search — unverified results](https://www.aliexpress.com/wholesale?SearchText=Adafruit4397+JST-SH4pin+to+female+sockets150mm)

<details><summary>Exact BOM row conditions, notes and sources</summary>

- **modular:C6:** common. BME680 harness · 3V3 GND SDA SCL · QT cable not supplied with3660;mates maleS3 headers;3V3 GND SDA SCL;secure female contacts;totalI2C harness<=200mm [Official / original source](https://www.adafruit.com/product/4397).

</details>

### Cat5e/Cat6 RJ45 data cable

Original family illustration, not a photo or a footprint. Package dimensions and terminal layout must be checked against the exact row and datasheet.

**Original illustration** — Original family illustration, not a photo or a footprint. Package dimensions and terminal layout must be checked against the exact row and datasheet.

Image: HA Radio Hub project · MIT. [Local family illustration](../hardware/parts/illustrations/cable.svg).

Package / dimensions: `site_length`.

- **Original Pi modular hub:** quantity 1; references `C16`.

[AliExpress search — unverified results](https://www.aliexpress.com/wholesale?SearchText=Cat5e%2FCat6+RJ45+data+cable)

<details><summary>Exact BOM row conditions, notes and sources</summary>

- **modular:C16:** injector_only. Injector LAN input patch · Ethernet · Only for separatePOE160S;connect LAN switch to injector DATA IN;omit when existingPoE switch is PSE

</details>

### DC plug matched to actual TL-SF1005D v13 jack

Original family illustration, not a photo or a footprint. Package dimensions and terminal layout must be checked against the exact row and datasheet.

**Original illustration** — Original family illustration, not a photo or a footprint. Package dimensions and terminal layout must be checked against the exact row and datasheet.

Image: HA Radio Hub project · MIT. [Local family illustration](../hardware/parts/illustrations/cable.svg).

Package / dimensions: `150-250 length`.

- **Original Pi modular hub:** quantity 1; references `C11`.

[AliExpress search — unverified results](https://www.aliexpress.com/wholesale?SearchText=DC+plug+matched+to+actual+TL-SF1005D+v13+jack)

<details><summary>Exact BOM row conditions, notes and sources</summary>

- **modular:C11:** common. Switch power lead · 5V1A branch · Measure outer inner and insertion dimensions;verify polarity from label;do not assume5.5x2.1 or reuse mains PSU output in parallel

</details>

### DFRobot FIT0993 terminal-input USB-C output cable

Original family illustration, not a photo or a footprint. Package dimensions and terminal layout must be checked against the exact row and datasheet.

**Original illustration** — Original family illustration, not a photo or a footprint. Package dimensions and terminal layout must be checked against the exact row and datasheet.

Image: HA Radio Hub project · MIT. [Local family illustration](../hardware/parts/illustrations/cable.svg).

Package / dimensions: `300 length;4 cable_OD`.

- **Original Pi modular hub:** quantity 2; references `C4, C9`.

[AliExpress search — unverified results](https://www.aliexpress.com/wholesale?SearchText=DFRobot+FIT0993+terminal-input+USB-C+output+cable)

<details><summary>Exact BOM row conditions, notes and sources</summary>

- **modular:C4:** common. S3 power cable · 5V2A manufacturer rating;1A fused branch · Fused5V to +;GND to -;D+/D-/S unused and insulated;disconnect before programmerUSB;strain-relieve terminal block [Official / original source](https://www.dfrobot.com/product-2831.html).
- **modular:C9:** wired_rf_only. Extra RF USB-C power lead · 5V2A manufacturer rating;1A fused branch · Fused5V to +;GND to -;D+/D-/S unused and insulated;disconnect before programmerUSB;strain-relieve terminal block [Official / original source](https://www.dfrobot.com/product-2831.html).

</details>

### Flux,solder,heatshrink,cable ties,insulating sheet

Original family illustration, not a photo or a footprint. Package dimensions and terminal layout must be checked against the exact row and datasheet.

**Original illustration** — Original family illustration, not a photo or a footprint. Package dimensions and terminal layout must be checked against the exact row and datasheet.

Image: HA Radio Hub project · MIT. [Local family illustration](../hardware/parts/illustrations/cable.svg).

- **D0 DIY • adapters / harness / jumper wire:** quantity 1; references `Assembly consumables`.

[AliExpress search — unverified results](https://www.aliexpress.com/wholesale?SearchText=Flux%2Csolder%2Cheatshrink%2Ccable+ties%2Cinsulating+sheet)

<details><summary>Exact BOM row conditions, notes and sources</summary>

- **d0-harness:Assembly consumables:** Harness / external / service; read row notes. Build and protect exposed copper · All jumpers insulated; wash flux suitable for cleaning; no loose copper strands

</details>

### JST XH / SH compatible crimp tooling and wire stripper

Original family illustration, not a photo or a footprint. Package dimensions and terminal layout must be checked against the exact row and datasheet.

**Original illustration** — Original family illustration, not a photo or a footprint. Package dimensions and terminal layout must be checked against the exact row and datasheet.

Image: HA Radio Hub project · MIT. [Local family illustration](../hardware/parts/illustrations/cable.svg).

- **Additional / reusable / conditional:** quantity 1 reusable tool set; references `crimp`.

[AliExpress search — unverified results](https://www.aliexpress.com/wholesale?SearchText=JST+XH+%2F+SH+compatible+crimp+tooling+and+wire+stripper)

<details><summary>Exact BOM row conditions, notes and sources</summary>

- **accessory:crimp:** Harness assembly. Use tooling appropriate for the exact contact and wire gauge; precrimped QT leads avoid attempting SH crimps with an XH die. Pull-test crimps and continuity-test both ends before power. [Official / original source](https://www.jst-mfg.com/product/pdf/eng/eXH.pdf).

</details>

### Matching4pin cable supplied with radar or separately sourced

Original family illustration, not a photo or a footprint. Package dimensions and terminal layout must be checked against the exact row and datasheet.

**Original illustration** — Original family illustration, not a photo or a footprint. Package dimensions and terminal layout must be checked against the exact row and datasheet.

Image: HA Radio Hub project · MIT. [Local family illustration](../hardware/parts/illustrations/cable.svg).

Package / dimensions: `route_to_lid`.

- **Original Pi modular hub:** quantity 1; references `C13`.

[AliExpress search — unverified results](https://www.aliexpress.com/wholesale?SearchText=Matching4pin+cable+supplied+with+radar+or+separately+sourced)

<details><summary>Exact BOM row conditions, notes and sources</summary>

- **modular:C13:** common. LD2450 adapter harness · 5V GND TX RX · Order separately only if absent fromU6 kit;no LD2410 cable substitution;verify pin labels before power

</details>

### Pure copper Cat5e/Cat6 RJ45;installation appropriate

Original family illustration, not a photo or a footprint. Package dimensions and terminal layout must be checked against the exact row and datasheet.

**Original illustration** — Original family illustration, not a photo or a footprint. Package dimensions and terminal layout must be checked against the exact row and datasheet.

Image: HA Radio Hub project · MIT. [Local family illustration](../hardware/parts/illustrations/cable.svg).

Package / dimensions: `site_length`.

- **Original Pi modular hub:** quantity 1; references `C15`.

[AliExpress search — unverified results](https://www.aliexpress.com/wholesale?SearchText=Pure+copper+Cat5e%2FCat6+RJ45%3Binstallation+appropriate)

<details><summary>Exact BOM row conditions, notes and sources</summary>

- **modular:C15:** common. External PoE Ethernet cable · 802.3at power plus data · From PSE power+data output toPS1;choose site length and bend radius;allowance excludes building cabling

</details>

### Shielded USB2 TypeA male-female

Original family illustration, not a photo or a footprint. Package dimensions and terminal layout must be checked against the exact row and datasheet.

**Original illustration** — Original family illustration, not a photo or a footprint. Package dimensions and terminal layout must be checked against the exact row and datasheet.

Image: HA Radio Hub project · MIT. [Local family illustration](../hardware/parts/illustrations/cable.svg).

Package / dimensions: `150-300 length`.

- **Original Pi modular hub:** quantity 2; references `C2`.

[AliExpress search — unverified results](https://www.aliexpress.com/wholesale?SearchText=Shielded+USB2+TypeA+male-female)

<details><summary>Exact BOM row conditions, notes and sources</summary>

- **modular:C2:** common. USB radio extension · Data_and_power · Place radiators away from Pi/switch and each other

</details>

### Short Cat5e four-pair RJ45 patch lead

Original family illustration, not a photo or a footprint. Package dimensions and terminal layout must be checked against the exact row and datasheet.

**Original illustration** — Original family illustration, not a photo or a footprint. Package dimensions and terminal layout must be checked against the exact row and datasheet.

Image: HA Radio Hub project · MIT. [Local family illustration](../hardware/parts/illustrations/cable.svg).

- **LP-P0 bench reference (not additive):** quantity 1; references `J2`.

[AliExpress search — unverified results](https://www.aliexpress.com/wholesale?SearchText=Short+Cat5e+four-pair+RJ45+patch+lead)

<details><summary>Exact BOM row conditions, notes and sources</summary>

- **lp-reference:J2:** Reference only; bench. EvalPoE DATA OUT to WIZ850io. One external PoE cable; no internal switch. [Official / original source](https://silvertel.com/images/Eval-Board-User-Guides/POE-Eval-Board-User-Manual.pdf).

</details>

### Short Cat5e or Cat6 stranded RJ45

Original family illustration, not a photo or a footprint. Package dimensions and terminal layout must be checked against the exact row and datasheet.

**Original illustration** — Original family illustration, not a photo or a footprint. Package dimensions and terminal layout must be checked against the exact row and datasheet.

Image: HA Radio Hub project · MIT. [Local family illustration](../hardware/parts/illustrations/cable.svg).

Package / dimensions: `150-300 length`.

- **Original Pi modular hub:** quantity 2; references `C1`.

[AliExpress search — unverified results](https://www.aliexpress.com/wholesale?SearchText=Short+Cat5e+or+Cat6+stranded+RJ45)

<details><summary>Exact BOM row conditions, notes and sources</summary>

- **modular:C1:** common. Internal Ethernet patch · 100BASE-TX in this assembly · Switch-to-Pi;switch-to-main-S3;PS1 captive maleRJ45 plugs directly into switch;allow bend radius

</details>

### Short Cat5e/Cat6 RJ45

Original family illustration, not a photo or a footprint. Package dimensions and terminal layout must be checked against the exact row and datasheet.

**Original illustration** — Original family illustration, not a photo or a footprint. Package dimensions and terminal layout must be checked against the exact row and datasheet.

Image: HA Radio Hub project · MIT. [Local family illustration](../hardware/parts/illustrations/cable.svg).

Package / dimensions: `150-300 length`.

- **Original Pi modular hub:** quantity 1; references `C8`.

[AliExpress search — unverified results](https://www.aliexpress.com/wholesale?SearchText=Short+Cat5e%2FCat6+RJ45)

<details><summary>Exact BOM row conditions, notes and sources</summary>

- **modular:C8:** wired_rf_only. Extra RF Ethernet patch · 100BASE-T · Connect port4 to second S3 only

</details>

</details>

<details>
<summary><strong>Capacitor: 36 identification cards</strong></summary>

### 100nF

Original family illustration, not a photo or a footprint. Package dimensions and terminal layout must be checked against the exact row and datasheet.

**Original illustration** — Original family illustration, not a photo or a footprint. Package dimensions and terminal layout must be checked against the exact row and datasheet.

Image: HA Radio Hub project · MIT. [Local family illustration](../hardware/parts/illustrations/capacitor.svg).

Package / dimensions: `Carrier:C_0805_2012Metric`.

- **C0 carrier • fitted parts:** quantity 10; references `C3, C5, C10, C11, C12, C13, C14, C15, C16, C17`.
- **M0 MG24 adapter • fitted parts:** quantity 1; references `C1`.

[AliExpress search — unverified results](https://www.aliexpress.com/wholesale?SearchText=100nF+capacitor+0805)

<details><summary>Exact BOM row conditions, notes and sources</summary>

- **c0:C3:** Fitted to board. 10V minimum; C0G crystal caps, X7R bypass/bulk
- **c0:C5:** Fitted to board. 10V minimum; C0G crystal caps, X7R bypass/bulk
- **c0:C10:** Fitted to board. 10V minimum; C0G crystal caps, X7R bypass/bulk
- **c0:C11:** Fitted to board. 10V minimum; C0G crystal caps, X7R bypass/bulk
- **c0:C12:** Fitted to board. 10V minimum; C0G crystal caps, X7R bypass/bulk
- **c0:C13:** Fitted to board. 10V minimum; C0G crystal caps, X7R bypass/bulk
- **c0:C14:** Fitted to board. 10V minimum; C0G crystal caps, X7R bypass/bulk
- **c0:C15:** Fitted to board. 10V minimum; C0G crystal caps, X7R bypass/bulk
- **c0:C16:** Fitted to board. 10V minimum; C0G crystal caps, X7R bypass/bulk
- **c0:C17:** Fitted to board. 10V minimum; C0G crystal caps, X7R bypass/bulk
- **m0:C1:** Fitted to board. 10V X7R, 0805, close to VDD15

</details>

### 100nF

Original family illustration, not a photo or a footprint. Package dimensions and terminal layout must be checked against the exact row and datasheet.

**Original illustration** — Original family illustration, not a photo or a footprint. Package dimensions and terminal layout must be checked against the exact row and datasheet.

Image: HA Radio Hub project · MIT. [Local family illustration](../hardware/parts/illustrations/capacitor.svg).

Package / dimensions: `Hub:C_0805_2012Metric`.

- **I0 integrated • fitted parts:** quantity 16; references `C3, C6, C9, C13, C15, C17, C18, C19, C20, C21, C22, C23, C24, C25, C27, C42`.

[AliExpress search — unverified results](https://www.aliexpress.com/wholesale?SearchText=100nF+capacitor+0805)

<details><summary>Exact BOM row conditions, notes and sources</summary>

- **i0:C3:** Fitted to board. X7R,16V; evaluate DC-bias effective capacitance
- **i0:C6:** Fitted to board. X7R,16V; evaluate DC-bias effective capacitance
- **i0:C9:** Fitted to board. X7R,16V; evaluate DC-bias effective capacitance
- **i0:C13:** Fitted to board. X7R,16V; evaluate DC-bias effective capacitance
- **i0:C15:** Fitted to board. X7R,16V; evaluate DC-bias effective capacitance
- **i0:C17:** Fitted to board. X7R,16V; evaluate DC-bias effective capacitance
- **i0:C18:** Fitted to board. X7R,16V; evaluate DC-bias effective capacitance
- **i0:C19:** Fitted to board. X7R,16V; evaluate DC-bias effective capacitance
- **i0:C20:** Fitted to board. X7R,16V; evaluate DC-bias effective capacitance
- **i0:C21:** Fitted to board. X7R,16V; evaluate DC-bias effective capacitance
- **i0:C22:** Fitted to board. X7R,16V; evaluate DC-bias effective capacitance
- **i0:C23:** Fitted to board. X7R,16V; evaluate DC-bias effective capacitance
- **i0:C24:** Fitted to board. X7R,16V; evaluate DC-bias effective capacitance
- **i0:C25:** Fitted to board. X7R,16V; evaluate DC-bias effective capacitance
- **i0:C27:** Fitted to board. X7R,16V; evaluate DC-bias effective capacitance
- **i0:C42:** Fitted to board. X7R,16V; evaluate DC-bias effective capacitance

</details>

### 100nF

Original family illustration, not a photo or a footprint. Package dimensions and terminal layout must be checked against the exact row and datasheet.

**Original illustration** — Original family illustration, not a photo or a footprint. Package dimensions and terminal layout must be checked against the exact row and datasheet.

Image: HA Radio Hub project · MIT. [Local family illustration](../hardware/parts/illustrations/capacitor.svg).

Package / dimensions: `Hub:C_0603_1608Metric`.

- **I0 integrated • fitted parts:** quantity 1; references `C11`.

[AliExpress search — unverified results](https://www.aliexpress.com/wholesale?SearchText=100nF+capacitor+0603)

<details><summary>Exact BOM row conditions, notes and sources</summary>

- **i0:C11:** Fitted to board. X7R,16V; evaluate DC-bias effective capacitance

</details>

### 100nF

Original family illustration, not a photo or a footprint. Package dimensions and terminal layout must be checked against the exact row and datasheet.

**Original illustration** — Original family illustration, not a photo or a footprint. Package dimensions and terminal layout must be checked against the exact row and datasheet.

Image: HA Radio Hub project · MIT. [Local family illustration](../hardware/parts/illustrations/capacitor.svg).

Package / dimensions: `DIY:Radial_C_P2.54`.

- **D0 DIY • fitted parts:** quantity 10; references `C3, C5, C10, C11, C12, C13, C14, C15, C16, C17`.

[AliExpress search — unverified results](https://www.aliexpress.com/wholesale?SearchText=100nF+capacitor)

<details><summary>Exact BOM row conditions, notes and sources</summary>

- **d0:C3:** Fitted to board. Radial ceramic >=10V, body<=5x3mm, C0G for crystal loads; X7R otherwise. Form leads to2.54mm pitch; no adjacent lead shorts.
- **d0:C5:** Fitted to board. Radial ceramic >=10V, body<=5x3mm, C0G for crystal loads; X7R otherwise. Form leads to2.54mm pitch; no adjacent lead shorts.
- **d0:C10:** Fitted to board. Radial ceramic >=10V, body<=5x3mm, C0G for crystal loads; X7R otherwise. Form leads to2.54mm pitch; no adjacent lead shorts.
- **d0:C11:** Fitted to board. Radial ceramic >=10V, body<=5x3mm, C0G for crystal loads; X7R otherwise. Form leads to2.54mm pitch; no adjacent lead shorts.
- **d0:C12:** Fitted to board. Radial ceramic >=10V, body<=5x3mm, C0G for crystal loads; X7R otherwise. Form leads to2.54mm pitch; no adjacent lead shorts.
- **d0:C13:** Fitted to board. Radial ceramic >=10V, body<=5x3mm, C0G for crystal loads; X7R otherwise. Form leads to2.54mm pitch; no adjacent lead shorts.
- **d0:C14:** Fitted to board. Radial ceramic >=10V, body<=5x3mm, C0G for crystal loads; X7R otherwise. Form leads to2.54mm pitch; no adjacent lead shorts.
- **d0:C15:** Fitted to board. Radial ceramic >=10V, body<=5x3mm, C0G for crystal loads; X7R otherwise. Form leads to2.54mm pitch; no adjacent lead shorts.
- **d0:C16:** Fitted to board. Radial ceramic >=10V, body<=5x3mm, C0G for crystal loads; X7R otherwise. Form leads to2.54mm pitch; no adjacent lead shorts.
- **d0:C17:** Fitted to board. Radial ceramic >=10V, body<=5x3mm, C0G for crystal loads; X7R otherwise. Form leads to2.54mm pitch; no adjacent lead shorts.

</details>

### 100nF 16V X7R ceramic

Original family illustration, not a photo or a footprint. Package dimensions and terminal layout must be checked against the exact row and datasheet.

**Original illustration** — Original family illustration, not a photo or a footprint. Package dimensions and terminal layout must be checked against the exact row and datasheet.

Image: HA Radio Hub project · MIT. [Local family illustration](../hardware/parts/illustrations/capacitor.svg).

- **LP-P0 bench reference (not additive):** quantity 12; references `C3`.

[AliExpress search — unverified results](https://www.aliexpress.com/wholesale?SearchText=100nF+16V+X7R+ceramic+capacitor)

<details><summary>Exact BOM row conditions, notes and sources</summary>

- **lp-reference:C3:** Reference only; both. Assembly allowance for local IC/module power entry bypassing. Do not duplicate installed module capacitors automatically; count after layout. [Official / original source](https://www.nxp.com/docs/en/data-sheet/SC16IS752_SC16IS762.pdf).

</details>

### 100uF 25V low-ESR electrolytic

Original family illustration, not a photo or a footprint. Package dimensions and terminal layout must be checked against the exact row and datasheet.

**Original illustration** — Original family illustration, not a photo or a footprint. Package dimensions and terminal layout must be checked against the exact row and datasheet.

Image: HA Radio Hub project · MIT. [Local family illustration](../hardware/parts/illustrations/capacitor.svg).

- **LP-P0 bench reference (not additive):** quantity 1; references `C1`.

[AliExpress search — unverified results](https://www.aliexpress.com/wholesale?SearchText=100uF+25V+low-ESR+electrolytic+capacitor)

<details><summary>Exact BOM row conditions, notes and sources</summary>

- **lp-reference:C1:** Reference only; both. Across the PD 5 V output. Include the installed EvalPoE capacitor in the 47 to 470 uF allowance; do not blindly double it. [Official / original source](https://silvertel.com/images/datasheets/Ag97000-Datasheet-low-cost-isolated-12W-Power-over-Ethernet-PoE-module-solution.pdf).

</details>

### 10nF

Original family illustration, not a photo or a footprint. Package dimensions and terminal layout must be checked against the exact row and datasheet.

**Original illustration** — Original family illustration, not a photo or a footprint. Package dimensions and terminal layout must be checked against the exact row and datasheet.

Image: HA Radio Hub project · MIT. [Local family illustration](../hardware/parts/illustrations/capacitor.svg).

Package / dimensions: `Hub:C_0805_2012Metric`.

- **I0 integrated • fitted parts:** quantity 2; references `C29, C36`.

[AliExpress search — unverified results](https://www.aliexpress.com/wholesale?SearchText=10nF+capacitor+0805)

<details><summary>Exact BOM row conditions, notes and sources</summary>

- **i0:C29:** Fitted to board. X7R,16V; evaluate DC-bias effective capacitance
- **i0:C36:** Fitted to board. X7R,16V; evaluate DC-bias effective capacitance

</details>

### 10nF 100V

Original family illustration, not a photo or a footprint. Package dimensions and terminal layout must be checked against the exact row and datasheet.

**Original illustration** — Original family illustration, not a photo or a footprint. Package dimensions and terminal layout must be checked against the exact row and datasheet.

Image: HA Radio Hub project · MIT. [Local family illustration](../hardware/parts/illustrations/capacitor.svg).

Package / dimensions: `Hub:C_1206_3216Metric`.

- **I0 integrated • fitted parts:** quantity 2; references `C37, C38`.

[AliExpress search — unverified results](https://www.aliexpress.com/wholesale?SearchText=10nF+100V+capacitor+1206)

<details><summary>Exact BOM row conditions, notes and sources</summary>

- **i0:C37:** Fitted to board. X7R100V minimum, PoE primary only
- **i0:C38:** Fitted to board. X7R100V minimum, PoE primary only

</details>

### 10uF

Original family illustration, not a photo or a footprint. Package dimensions and terminal layout must be checked against the exact row and datasheet.

**Original illustration** — Original family illustration, not a photo or a footprint. Package dimensions and terminal layout must be checked against the exact row and datasheet.

Image: HA Radio Hub project · MIT. [Local family illustration](../hardware/parts/illustrations/capacitor.svg).

Package / dimensions: `Carrier:C_1206_3216Metric`.

- **M0 MG24 adapter • fitted parts:** quantity 1; references `C3`.

[AliExpress search — unverified results](https://www.aliexpress.com/wholesale?SearchText=10uF+capacitor+1206)

<details><summary>Exact BOM row conditions, notes and sources</summary>

- **m0:C3:** Fitted to board. 10V X7R, 1206; account for DC bias

</details>

### 10uF

Original family illustration, not a photo or a footprint. Package dimensions and terminal layout must be checked against the exact row and datasheet.

**Original illustration** — Original family illustration, not a photo or a footprint. Package dimensions and terminal layout must be checked against the exact row and datasheet.

Image: HA Radio Hub project · MIT. [Local family illustration](../hardware/parts/illustrations/capacitor.svg).

Package / dimensions: `Hub:C_1206_3216Metric`.

- **I0 integrated • fitted parts:** quantity 6; references `C4, C7, C10, C26, C28, C43`.

[AliExpress search — unverified results](https://www.aliexpress.com/wholesale?SearchText=10uF+capacitor+1206)

<details><summary>Exact BOM row conditions, notes and sources</summary>

- **i0:C4:** Fitted to board. X7R,16V; evaluate DC-bias effective capacitance
- **i0:C7:** Fitted to board. X7R,16V; evaluate DC-bias effective capacitance
- **i0:C10:** Fitted to board. X7R,16V; evaluate DC-bias effective capacitance
- **i0:C26:** Fitted to board. X7R,16V; evaluate DC-bias effective capacitance
- **i0:C28:** Fitted to board. X7R,16V; evaluate DC-bias effective capacitance
- **i0:C43:** Fitted to board. X7R,16V; evaluate DC-bias effective capacitance

</details>

### 10uF 25V X7R ceramic

Original family illustration, not a photo or a footprint. Package dimensions and terminal layout must be checked against the exact row and datasheet.

**Original illustration** — Original family illustration, not a photo or a footprint. Package dimensions and terminal layout must be checked against the exact row and datasheet.

Image: HA Radio Hub project · MIT. [Local family illustration](../hardware/parts/illustrations/capacitor.svg).

- **LP-P0 bench reference (not additive):** quantity 1; references `C2`.

[AliExpress search — unverified results](https://www.aliexpress.com/wholesale?SearchText=10uF+25V+X7R+ceramic+capacitor)

<details><summary>Exact BOM row conditions, notes and sources</summary>

- **lp-reference:C2:** Reference only; both. PD output local filter; inspect EvalPoE population. [Official / original source](https://silvertel.com/images/datasheets/Ag97000-Datasheet-low-cost-isolated-12W-Power-over-Ethernet-PoE-module-solution.pdf).

</details>

### 18pF

Original family illustration, not a photo or a footprint. Package dimensions and terminal layout must be checked against the exact row and datasheet.

**Original illustration** — Original family illustration, not a photo or a footprint. Package dimensions and terminal layout must be checked against the exact row and datasheet.

Image: HA Radio Hub project · MIT. [Local family illustration](../hardware/parts/illustrations/capacitor.svg).

Package / dimensions: `Hub:C_0805_2012Metric`.

- **I0 integrated • fitted parts:** quantity 2; references `C31, C32`.

[AliExpress search — unverified results](https://www.aliexpress.com/wholesale?SearchText=18pF+capacitor+0805)

<details><summary>Exact BOM row conditions, notes and sources</summary>

- **i0:C31:** Fitted to board. C0G,50V
- **i0:C32:** Fitted to board. C0G,50V

</details>

### 1nF

Original family illustration, not a photo or a footprint. Package dimensions and terminal layout must be checked against the exact row and datasheet.

**Original illustration** — Original family illustration, not a photo or a footprint. Package dimensions and terminal layout must be checked against the exact row and datasheet.

Image: HA Radio Hub project · MIT. [Local family illustration](../hardware/parts/illustrations/capacitor.svg).

Package / dimensions: `Carrier:C_0805_2012Metric`.

- **C0 carrier • fitted parts:** quantity 1; references `C6`.

[AliExpress search — unverified results](https://www.aliexpress.com/wholesale?SearchText=1nF+capacitor+0805)

<details><summary>Exact BOM row conditions, notes and sources</summary>

- **c0:C6:** Fitted to board. 10V minimum; C0G crystal caps, X7R bypass/bulk

</details>

### 1nF

Original family illustration, not a photo or a footprint. Package dimensions and terminal layout must be checked against the exact row and datasheet.

**Original illustration** — Original family illustration, not a photo or a footprint. Package dimensions and terminal layout must be checked against the exact row and datasheet.

Image: HA Radio Hub project · MIT. [Local family illustration](../hardware/parts/illustrations/capacitor.svg).

Package / dimensions: `Hub:C_0805_2012Metric`.

- **I0 integrated • fitted parts:** quantity 1; references `C14`.

[AliExpress search — unverified results](https://www.aliexpress.com/wholesale?SearchText=1nF+capacitor+0805)

<details><summary>Exact BOM row conditions, notes and sources</summary>

- **i0:C14:** Fitted to board. X7R,16V; evaluate DC-bias effective capacitance

</details>

### 1nF

Original family illustration, not a photo or a footprint. Package dimensions and terminal layout must be checked against the exact row and datasheet.

**Original illustration** — Original family illustration, not a photo or a footprint. Package dimensions and terminal layout must be checked against the exact row and datasheet.

Image: HA Radio Hub project · MIT. [Local family illustration](../hardware/parts/illustrations/capacitor.svg).

Package / dimensions: `DIY:Radial_C_P2.54`.

- **D0 DIY • fitted parts:** quantity 1; references `C6`.

[AliExpress search — unverified results](https://www.aliexpress.com/wholesale?SearchText=1nF+capacitor)

<details><summary>Exact BOM row conditions, notes and sources</summary>

- **d0:C6:** Fitted to board. Radial ceramic >=10V, body<=5x3mm, C0G for crystal loads; X7R otherwise. Form leads to2.54mm pitch; no adjacent lead shorts.

</details>

### 1nF 16V C0G ceramic

Original family illustration, not a photo or a footprint. Package dimensions and terminal layout must be checked against the exact row and datasheet.

**Original illustration** — Original family illustration, not a photo or a footprint. Package dimensions and terminal layout must be checked against the exact row and datasheet.

Image: HA Radio Hub project · MIT. [Local family illustration](../hardware/parts/illustrations/capacitor.svg).

- **LP-P0 bench reference (not additive):** quantity 1; references `C8`.

[AliExpress search — unverified results](https://www.aliexpress.com/wholesale?SearchText=1nF+16V+C0G+ceramic+capacitor)

<details><summary>Exact BOM row conditions, notes and sources</summary>

- **lp-reference:C8:** Reference only; both. Supervisor SENSE to GND. [Official / original source](https://www.ti.com/lit/ds/symlink/tps3808.pdf).

</details>

### 1nF 2kV

Original family illustration, not a photo or a footprint. Package dimensions and terminal layout must be checked against the exact row and datasheet.

**Original illustration** — Original family illustration, not a photo or a footprint. Package dimensions and terminal layout must be checked against the exact row and datasheet.

Image: HA Radio Hub project · MIT. [Local family illustration](../hardware/parts/illustrations/capacitor.svg).

Package / dimensions: `Hub:C_Disc_D7.5mm_W5.0mm_P7.50mm`.

- **I0 integrated • fitted parts:** quantity 1; references `C50`.

[AliExpress search — unverified results](https://www.aliexpress.com/wholesale?SearchText=1nF+2kV+capacitor)

<details><summary>Exact BOM row conditions, notes and sources</summary>

- **i0:C50:** Fitted to board. Safety/ESD rated capacitor; qualification and touch-current review required.

</details>

### 1uF

Original family illustration, not a photo or a footprint. Package dimensions and terminal layout must be checked against the exact row and datasheet.

**Original illustration** — Original family illustration, not a photo or a footprint. Package dimensions and terminal layout must be checked against the exact row and datasheet.

Image: HA Radio Hub project · MIT. [Local family illustration](../hardware/parts/illustrations/capacitor.svg).

Package / dimensions: `Carrier:C_0805_2012Metric`.

- **C0 carrier • fitted parts:** quantity 2; references `C4, C7`.
- **M0 MG24 adapter • fitted parts:** quantity 1; references `C2`.

[AliExpress search — unverified results](https://www.aliexpress.com/wholesale?SearchText=1uF+capacitor+0805)

<details><summary>Exact BOM row conditions, notes and sources</summary>

- **c0:C4:** Fitted to board. 10V minimum; C0G crystal caps, X7R bypass/bulk
- **c0:C7:** Fitted to board. 10V minimum; C0G crystal caps, X7R bypass/bulk
- **m0:C2:** Fitted to board. 10V X7R, 0805

</details>

### 1uF

Original family illustration, not a photo or a footprint. Package dimensions and terminal layout must be checked against the exact row and datasheet.

**Original illustration** — Original family illustration, not a photo or a footprint. Package dimensions and terminal layout must be checked against the exact row and datasheet.

Image: HA Radio Hub project · MIT. [Local family illustration](../hardware/parts/illustrations/capacitor.svg).

Package / dimensions: `Hub:C_0805_2012Metric`.

- **I0 integrated • fitted parts:** quantity 3; references `C5, C8, C12`.

[AliExpress search — unverified results](https://www.aliexpress.com/wholesale?SearchText=1uF+capacitor+0805)

<details><summary>Exact BOM row conditions, notes and sources</summary>

- **i0:C5:** Fitted to board. X7R,16V; evaluate DC-bias effective capacitance
- **i0:C8:** Fitted to board. X7R,16V; evaluate DC-bias effective capacitance
- **i0:C12:** Fitted to board. X7R,16V; evaluate DC-bias effective capacitance

</details>

### 1uF

Original family illustration, not a photo or a footprint. Package dimensions and terminal layout must be checked against the exact row and datasheet.

**Original illustration** — Original family illustration, not a photo or a footprint. Package dimensions and terminal layout must be checked against the exact row and datasheet.

Image: HA Radio Hub project · MIT. [Local family illustration](../hardware/parts/illustrations/capacitor.svg).

Package / dimensions: `DIY:Radial_C_P2.54`.

- **D0 DIY • fitted parts:** quantity 2; references `C4, C7`.

[AliExpress search — unverified results](https://www.aliexpress.com/wholesale?SearchText=1uF+capacitor)

<details><summary>Exact BOM row conditions, notes and sources</summary>

- **d0:C4:** Fitted to board. Radial ceramic >=10V, body<=5x3mm, C0G for crystal loads; X7R otherwise. Form leads to2.54mm pitch; no adjacent lead shorts.
- **d0:C7:** Fitted to board. Radial ceramic >=10V, body<=5x3mm, C0G for crystal loads; X7R otherwise. Form leads to2.54mm pitch; no adjacent lead shorts.

</details>

### 1uF 16V X7R ceramic

Original family illustration, not a photo or a footprint. Package dimensions and terminal layout must be checked against the exact row and datasheet.

**Original illustration** — Original family illustration, not a photo or a footprint. Package dimensions and terminal layout must be checked against the exact row and datasheet.

Image: HA Radio Hub project · MIT. [Local family illustration](../hardware/parts/illustrations/capacitor.svg).

- **LP-P0 bench reference (not additive):** quantity 2; references `C7`.

[AliExpress search — unverified results](https://www.aliexpress.com/wholesale?SearchText=1uF+16V+X7R+ceramic+capacitor)

<details><summary>Exact BOM row conditions, notes and sources</summary>

- **lp-reference:C7:** Reference only; carrier. S3 EN and H2 EN startup RC networks; confirm rise time and reset sequencing. [Official / original source](https://www.espressif.com/sites/default/files/documentation/esp32-h2-mini-1_mini-1u_datasheet_en.pdf).

</details>

### 22nF

Original family illustration, not a photo or a footprint. Package dimensions and terminal layout must be checked against the exact row and datasheet.

**Original illustration** — Original family illustration, not a photo or a footprint. Package dimensions and terminal layout must be checked against the exact row and datasheet.

Image: HA Radio Hub project · MIT. [Local family illustration](../hardware/parts/illustrations/capacitor.svg).

Package / dimensions: `Hub:C_0805_2012Metric`.

- **I0 integrated • fitted parts:** quantity 1; references `C33`.

[AliExpress search — unverified results](https://www.aliexpress.com/wholesale?SearchText=22nF+capacitor+0805)

<details><summary>Exact BOM row conditions, notes and sources</summary>

- **i0:C33:** Fitted to board. X7R,16V; evaluate DC-bias effective capacitance

</details>

### 22pF

Original family illustration, not a photo or a footprint. Package dimensions and terminal layout must be checked against the exact row and datasheet.

**Original illustration** — Original family illustration, not a photo or a footprint. Package dimensions and terminal layout must be checked against the exact row and datasheet.

Image: HA Radio Hub project · MIT. [Local family illustration](../hardware/parts/illustrations/capacitor.svg).

Package / dimensions: `Carrier:C_0805_2012Metric`.

- **C0 carrier • fitted parts:** quantity 1; references `C1`.

[AliExpress search — unverified results](https://www.aliexpress.com/wholesale?SearchText=22pF+capacitor+0805)

<details><summary>Exact BOM row conditions, notes and sources</summary>

- **c0:C1:** Fitted to board. 10V minimum; C0G crystal caps, X7R bypass/bulk

</details>

### 22pF

Original family illustration, not a photo or a footprint. Package dimensions and terminal layout must be checked against the exact row and datasheet.

**Original illustration** — Original family illustration, not a photo or a footprint. Package dimensions and terminal layout must be checked against the exact row and datasheet.

Image: HA Radio Hub project · MIT. [Local family illustration](../hardware/parts/illustrations/capacitor.svg).

Package / dimensions: `Hub:C_0805_2012Metric`.

- **I0 integrated • fitted parts:** quantity 1; references `C1`.

[AliExpress search — unverified results](https://www.aliexpress.com/wholesale?SearchText=22pF+capacitor+0805)

<details><summary>Exact BOM row conditions, notes and sources</summary>

- **i0:C1:** Fitted to board. C0G,50V

</details>

### 22pF

Original family illustration, not a photo or a footprint. Package dimensions and terminal layout must be checked against the exact row and datasheet.

**Original illustration** — Original family illustration, not a photo or a footprint. Package dimensions and terminal layout must be checked against the exact row and datasheet.

Image: HA Radio Hub project · MIT. [Local family illustration](../hardware/parts/illustrations/capacitor.svg).

Package / dimensions: `DIY:Radial_C_P2.54`.

- **D0 DIY • fitted parts:** quantity 1; references `C1`.

[AliExpress search — unverified results](https://www.aliexpress.com/wholesale?SearchText=22pF+capacitor)

<details><summary>Exact BOM row conditions, notes and sources</summary>

- **d0:C1:** Fitted to board. Radial ceramic >=10V, body<=5x3mm, C0G for crystal loads; X7R otherwise. Form leads to2.54mm pitch; no adjacent lead shorts.

</details>

### 22pF 50V C0G ceramic

Original family illustration, not a photo or a footprint. Package dimensions and terminal layout must be checked against the exact row and datasheet.

**Original illustration** — Original family illustration, not a photo or a footprint. Package dimensions and terminal layout must be checked against the exact row and datasheet.

Image: HA Radio Hub project · MIT. [Local family illustration](../hardware/parts/illustrations/capacitor.svg).

- **LP-P0 bench reference (not additive):** quantity 1; references `C5`.

[AliExpress search — unverified results](https://www.aliexpress.com/wholesale?SearchText=22pF+50V+C0G+ceramic+capacitor)

<details><summary>Exact BOM row conditions, notes and sources</summary>

- **lp-reference:C5:** Reference only; both. XTAL1 to GND; initial NXP example value. Tune for the selected 18 pF crystal and stray capacitance. [Official / original source](https://www.nxp.com/docs/en/data-sheet/SC16IS752_SC16IS762.pdf).

</details>

### 22uF

Original family illustration, not a photo or a footprint. Package dimensions and terminal layout must be checked against the exact row and datasheet.

**Original illustration** — Original family illustration, not a photo or a footprint. Package dimensions and terminal layout must be checked against the exact row and datasheet.

Image: HA Radio Hub project · MIT. [Local family illustration](../hardware/parts/illustrations/capacitor.svg).

Package / dimensions: `Carrier:C_1206_3216Metric`.

- **C0 carrier • fitted parts:** quantity 2; references `C8, C9`.

[AliExpress search — unverified results](https://www.aliexpress.com/wholesale?SearchText=22uF+capacitor+1206)

<details><summary>Exact BOM row conditions, notes and sources</summary>

- **c0:C8:** Fitted to board. 10V minimum; C0G crystal caps, X7R bypass/bulk
- **c0:C9:** Fitted to board. 10V minimum; C0G crystal caps, X7R bypass/bulk

</details>

### 22uF

Original family illustration, not a photo or a footprint. Package dimensions and terminal layout must be checked against the exact row and datasheet.

**Original illustration** — Original family illustration, not a photo or a footprint. Package dimensions and terminal layout must be checked against the exact row and datasheet.

Image: HA Radio Hub project · MIT. [Local family illustration](../hardware/parts/illustrations/capacitor.svg).

Package / dimensions: `Hub:C_1206_3216Metric`.

- **I0 integrated • fitted parts:** quantity 4; references `C16, C39, C40, C41`.

[AliExpress search — unverified results](https://www.aliexpress.com/wholesale?SearchText=22uF+capacitor+1206)

<details><summary>Exact BOM row conditions, notes and sources</summary>

- **i0:C16:** Fitted to board. X7R,16V; evaluate DC-bias effective capacitance
- **i0:C39:** Fitted to board. X7R16V1206;3x22uF; measure effective aggregate under5V bias and startup
- **i0:C40:** Fitted to board. X7R16V1206;3x22uF; measure effective aggregate under5V bias and startup
- **i0:C41:** Fitted to board. X7R16V1206;3x22uF; measure effective aggregate under5V bias and startup

</details>

### 22uF

Original family illustration, not a photo or a footprint. Package dimensions and terminal layout must be checked against the exact row and datasheet.

**Original illustration** — Original family illustration, not a photo or a footprint. Package dimensions and terminal layout must be checked against the exact row and datasheet.

Image: HA Radio Hub project · MIT. [Local family illustration](../hardware/parts/illustrations/capacitor.svg).

Package / dimensions: `DIY:Radial_C_P2.54`.

- **D0 DIY • fitted parts:** quantity 2; references `C8, C9`.

[AliExpress search — unverified results](https://www.aliexpress.com/wholesale?SearchText=22uF+capacitor)

<details><summary>Exact BOM row conditions, notes and sources</summary>

- **d0:C8:** Fitted to board. 22uF >=10V radial electrolytic, body<=5mm, pin1 positive. Form leads to2.54mm pitch; no adjacent lead shorts.
- **d0:C9:** Fitted to board. 22uF >=10V radial electrolytic, body<=5mm, pin1 positive. Form leads to2.54mm pitch; no adjacent lead shorts.

</details>

### 33pF

Original family illustration, not a photo or a footprint. Package dimensions and terminal layout must be checked against the exact row and datasheet.

**Original illustration** — Original family illustration, not a photo or a footprint. Package dimensions and terminal layout must be checked against the exact row and datasheet.

Image: HA Radio Hub project · MIT. [Local family illustration](../hardware/parts/illustrations/capacitor.svg).

Package / dimensions: `Carrier:C_0805_2012Metric`.

- **C0 carrier • fitted parts:** quantity 1; references `C2`.

[AliExpress search — unverified results](https://www.aliexpress.com/wholesale?SearchText=33pF+capacitor+0805)

<details><summary>Exact BOM row conditions, notes and sources</summary>

- **c0:C2:** Fitted to board. 10V minimum; C0G crystal caps, X7R bypass/bulk

</details>

### 33pF

Original family illustration, not a photo or a footprint. Package dimensions and terminal layout must be checked against the exact row and datasheet.

**Original illustration** — Original family illustration, not a photo or a footprint. Package dimensions and terminal layout must be checked against the exact row and datasheet.

Image: HA Radio Hub project · MIT. [Local family illustration](../hardware/parts/illustrations/capacitor.svg).

Package / dimensions: `Hub:C_0805_2012Metric`.

- **I0 integrated • fitted parts:** quantity 1; references `C2`.

[AliExpress search — unverified results](https://www.aliexpress.com/wholesale?SearchText=33pF+capacitor+0805)

<details><summary>Exact BOM row conditions, notes and sources</summary>

- **i0:C2:** Fitted to board. C0G,50V

</details>

### 33pF

Original family illustration, not a photo or a footprint. Package dimensions and terminal layout must be checked against the exact row and datasheet.

**Original illustration** — Original family illustration, not a photo or a footprint. Package dimensions and terminal layout must be checked against the exact row and datasheet.

Image: HA Radio Hub project · MIT. [Local family illustration](../hardware/parts/illustrations/capacitor.svg).

Package / dimensions: `DIY:Radial_C_P2.54`.

- **D0 DIY • fitted parts:** quantity 1; references `C2`.

[AliExpress search — unverified results](https://www.aliexpress.com/wholesale?SearchText=33pF+capacitor)

<details><summary>Exact BOM row conditions, notes and sources</summary>

- **d0:C2:** Fitted to board. Radial ceramic >=10V, body<=5x3mm, C0G for crystal loads; X7R otherwise. Form leads to2.54mm pitch; no adjacent lead shorts.

</details>

### 33pF 50V C0G ceramic

Original family illustration, not a photo or a footprint. Package dimensions and terminal layout must be checked against the exact row and datasheet.

**Original illustration** — Original family illustration, not a photo or a footprint. Package dimensions and terminal layout must be checked against the exact row and datasheet.

Image: HA Radio Hub project · MIT. [Local family illustration](../hardware/parts/illustrations/capacitor.svg).

- **LP-P0 bench reference (not additive):** quantity 1; references `C6`.

[AliExpress search — unverified results](https://www.aliexpress.com/wholesale?SearchText=33pF+50V+C0G+ceramic+capacitor)

<details><summary>Exact BOM row conditions, notes and sources</summary>

- **lp-reference:C6:** Reference only; both. XTAL2 to GND; initial NXP example value, not validated for the final PCB. [Official / original source](https://www.nxp.com/docs/en/data-sheet/SC16IS752_SC16IS762.pdf).

</details>

### 4.7uF

Original family illustration, not a photo or a footprint. Package dimensions and terminal layout must be checked against the exact row and datasheet.

**Original illustration** — Original family illustration, not a photo or a footprint. Package dimensions and terminal layout must be checked against the exact row and datasheet.

Image: HA Radio Hub project · MIT. [Local family illustration](../hardware/parts/illustrations/capacitor.svg).

Package / dimensions: `Hub:C_0805_2012Metric`.

- **I0 integrated • fitted parts:** quantity 1; references `C30`.

[AliExpress search — unverified results](https://www.aliexpress.com/wholesale?SearchText=4.7uF+capacitor+0805)

<details><summary>Exact BOM row conditions, notes and sources</summary>

- **i0:C30:** Fitted to board. X7R,16V; evaluate DC-bias effective capacitance

</details>

### 47uF 10V low-ESR bulk capacitor

Original family illustration, not a photo or a footprint. Package dimensions and terminal layout must be checked against the exact row and datasheet.

**Original illustration** — Original family illustration, not a photo or a footprint. Package dimensions and terminal layout must be checked against the exact row and datasheet.

Image: HA Radio Hub project · MIT. [Local family illustration](../hardware/parts/illustrations/capacitor.svg).

- **LP-P0 bench reference (not additive):** quantity 1; references `C4`.

[AliExpress search — unverified results](https://www.aliexpress.com/wholesale?SearchText=47uF+10V+low-ESR+bulk+capacitor+capacitor)

<details><summary>Exact BOM row conditions, notes and sources</summary>

- **lp-reference:C4:** Reference only; both. 3.3 V rail bulk capacitor; validate buck startup, stability and transient response. [Official / original source](https://www.pololu.com/product/2857).

</details>

### 6.8nF

Original family illustration, not a photo or a footprint. Package dimensions and terminal layout must be checked against the exact row and datasheet.

**Original illustration** — Original family illustration, not a photo or a footprint. Package dimensions and terminal layout must be checked against the exact row and datasheet.

Image: HA Radio Hub project · MIT. [Local family illustration](../hardware/parts/illustrations/capacitor.svg).

Package / dimensions: `Hub:C_0805_2012Metric`.

- **I0 integrated • fitted parts:** quantity 2; references `C34, C35`.

[AliExpress search — unverified results](https://www.aliexpress.com/wholesale?SearchText=6.8nF+capacitor+0805)

<details><summary>Exact BOM row conditions, notes and sources</summary>

- **i0:C34:** Fitted to board. X7R,16V; evaluate DC-bias effective capacitance
- **i0:C35:** Fitted to board. X7R,16V; evaluate DC-bias effective capacitance

</details>

</details>

<details>
<summary><strong>Connector: 45 identification cards</strong></summary>

### 0813-1X1T-57-F

Original family illustration, not a photo or a footprint. Package dimensions and terminal layout must be checked against the exact row and datasheet.

**Original illustration** — Original family illustration, not a photo or a footprint. Package dimensions and terminal layout must be checked against the exact row and datasheet.

Image: HA Radio Hub project · MIT. [Local family illustration](../hardware/parts/illustrations/connector.svg).

Package / dimensions: `Hub:Bel_0813_1X1T_57_F`.

- **I0 integrated • fitted parts:** quantity 1; references `J1`.

[AliExpress search — unverified results](https://www.aliexpress.com/wholesale?SearchText=0813-1X1T-57-F)

<details><summary>Exact BOM row conditions, notes and sources</summary>

- **i0:J1:** Fitted to board. PoE-capable magjack. PHY-side common CT. Four cable-side power taps, internal bridge in U7. [Official / original source](https://www.belfuse.com/media/drawings/products/magjack%20ICMs/dr-mag-0813-1x1t-57-f.pdf).

</details>

### 40 conductor, 1.27 mm pitch; wire gauge per 61204023021

Original family illustration, not a photo or a footprint. Package dimensions and terminal layout must be checked against the exact row and datasheet.

**Original illustration** — Original family illustration, not a photo or a footprint. Package dimensions and terminal layout must be checked against the exact row and datasheet.

Image: HA Radio Hub project · MIT. [Local family illustration](../hardware/parts/illustrations/connector.svg).

- **C0 carrier • harness / external:** quantity 1; references `IDC ribbon`.

[AliExpress search — unverified results](https://www.aliexpress.com/wholesale?SearchText=40+conductor%2C+1.27+mm+pitch%3B+wire+gauge+per+61204023021)

<details><summary>Exact BOM row conditions, notes and sources</summary>

- **c0-harness:IDC ribbon:** Harness / external / service; read row notes. J3 host harness · Start <=100 mm; mate one end IDC, remote end fanout to verified GPIO; strain relief mandatory

</details>

### 40conductor1.27mm pitch per61204023021

Original family illustration, not a photo or a footprint. Package dimensions and terminal layout must be checked against the exact row and datasheet.

**Original illustration** — Original family illustration, not a photo or a footprint. Package dimensions and terminal layout must be checked against the exact row and datasheet.

Image: HA Radio Hub project · MIT. [Local family illustration](../hardware/parts/illustrations/connector.svg).

- **D0 DIY • adapters / harness / jumper wire:** quantity 1; references `IDC ribbon`.

[AliExpress search — unverified results](https://www.aliexpress.com/wholesale?SearchText=40conductor1.27mm+pitch+per61204023021)

<details><summary>Exact BOM row conditions, notes and sources</summary>

- **d0-harness:IDC ribbon:** Harness / external / service; read row notes. J3 S3 harness · Keep<=50mm initially; follow all interleaved returns; NOT Pi pinout

</details>

### 61204021621

Original family illustration, not a photo or a footprint. Package dimensions and terminal layout must be checked against the exact row and datasheet.

**Original illustration** — Original family illustration, not a photo or a footprint. Package dimensions and terminal layout must be checked against the exact row and datasheet.

Image: HA Radio Hub project · MIT. [Local family illustration](../hardware/parts/illustrations/connector.svg).

Package / dimensions: `Carrier:Wurth_61204021621`.

- **C0 carrier • fitted parts:** quantity 1; references `J3`.

[AliExpress search — unverified results](https://www.aliexpress.com/wholesale?SearchText=61204021621)

<details><summary>Exact BOM row conditions, notes and sources</summary>

- **c0:J3:** Fitted to board. S3 keyed 40-position IDC harness; NOT Raspberry Pi compatible [Official / original source](https://www.we-online.com/components/products/datasheet/61204021621.pdf).

</details>

### 61204021621

Original family illustration, not a photo or a footprint. Package dimensions and terminal layout must be checked against the exact row and datasheet.

**Original illustration** — Original family illustration, not a photo or a footprint. Package dimensions and terminal layout must be checked against the exact row and datasheet.

Image: HA Radio Hub project · MIT. [Local family illustration](../hardware/parts/illustrations/connector.svg).

Package / dimensions: `DIY:Wurth_61204021621`.

- **D0 DIY • fitted parts:** quantity 1; references `J3`.

[AliExpress search — unverified results](https://www.aliexpress.com/wholesale?SearchText=61204021621)

<details><summary>Exact BOM row conditions, notes and sources</summary>

- **d0:J3:** Fitted to board. S3 keyed 40-position IDC harness; NOT Raspberry Pi compatible [Official / original source](https://www.we-online.com/components/products/datasheet/61204021621.pdf).

</details>

### 61204023021

Original family illustration, not a photo or a footprint. Package dimensions and terminal layout must be checked against the exact row and datasheet.

**Original illustration** — Original family illustration, not a photo or a footprint. Package dimensions and terminal layout must be checked against the exact row and datasheet.

Image: HA Radio Hub project · MIT. [Local family illustration](../hardware/parts/illustrations/connector.svg).

- **C0 carrier • harness / external:** quantity 1; references `J3 mate`.
- **D0 DIY • adapters / harness / jumper wire:** quantity 1; references `J3 mate`.

[AliExpress search — unverified results](https://www.aliexpress.com/wholesale?SearchText=61204023021)

<details><summary>Exact BOM row conditions, notes and sources</summary>

- **c0-harness:J3 mate:** Harness / external / service; read row notes. S3 host harness, NOT Raspberry Pi pinout · IDC 40-conductor ribbon; AWG and insulation per mating connector datasheet
- **d0-harness:J3 mate:** Harness / external / service; read row notes. S3 host harness, NOT Raspberry Pi pinout · IDC 40-conductor ribbon; AWG and insulation per mating connector datasheet

</details>

### Adafruit 400 extra-long header cut to 1x14, 0.64mm square pins

Original family illustration, not a photo or a footprint. Package dimensions and terminal layout must be checked against the exact row and datasheet.

**Original illustration** — Original family illustration, not a photo or a footprint. Package dimensions and terminal layout must be checked against the exact row and datasheet.

Image: HA Radio Hub project · MIT. [Local family illustration](../hardware/parts/illustrations/connector.svg).

- **D0 DIY • adapters / harness / jumper wire:** quantity 2; references `U1 adapter pins`.

[AliExpress search — unverified results](https://www.aliexpress.com/wholesale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)

<details><summary>Exact BOM row conditions, notes and sources</summary>

- **d0-harness:U1 adapter pins:** Harness / external / service; read row notes. Soldered interposer to D0 · Use 2 strips of the 5-pack; 7.73mm pins each side of 2.54mm insulator. Insulator rests on D0; set adapter underside 6mm above D0 and trim tails. Confirm TSSOP pin1

</details>

### Adafruit 400 extra-long header cut to 1x3, 0.64mm square pins

Original family illustration, not a photo or a footprint. Package dimensions and terminal layout must be checked against the exact row and datasheet.

**Original illustration** — Original family illustration, not a photo or a footprint. Package dimensions and terminal layout must be checked against the exact row and datasheet.

Image: HA Radio Hub project · MIT. [Local family illustration](../hardware/parts/illustrations/connector.svg).

- **D0 DIY • adapters / harness / jumper wire:** quantity 2; references `U2 adapter pins`.

[AliExpress search — unverified results](https://www.aliexpress.com/wholesale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)

<details><summary>Exact BOM row conditions, notes and sources</summary>

- **d0-harness:U2 adapter pins:** Harness / external / service; read row notes. Soldered interposer to D0 · Cut both 3-pin lengths from a third strip of same Adafruit400 5-pack; set adapter underside 6mm above D0. SOT23-6 side up; no reverse-side parts

</details>

### B10B-XH-A

Original family illustration, not a photo or a footprint. Package dimensions and terminal layout must be checked against the exact row and datasheet.

**Original illustration** — Original family illustration, not a photo or a footprint. Package dimensions and terminal layout must be checked against the exact row and datasheet.

Image: HA Radio Hub project · MIT. [Local family illustration](../hardware/parts/illustrations/connector.svg).

Package / dimensions: `Carrier:JST_XH_B10B-XH-A_1x10_P2.50mm_Vertical`.

- **C0 carrier • fitted parts:** quantity 1; references `J4`.

[AliExpress search — unverified results](https://www.aliexpress.com/wholesale?SearchText=B10B-XH-A)

<details><summary>Exact BOM row conditions, notes and sources</summary>

- **c0:J4:** Fitted to board. WIZ850io Ethernet module [Official / original source](https://www.jst-mfg.com/product/pdf/eng/eXH.pdf).

</details>

### B10B-XH-A

Original family illustration, not a photo or a footprint. Package dimensions and terminal layout must be checked against the exact row and datasheet.

**Original illustration** — Original family illustration, not a photo or a footprint. Package dimensions and terminal layout must be checked against the exact row and datasheet.

Image: HA Radio Hub project · MIT. [Local family illustration](../hardware/parts/illustrations/connector.svg).

Package / dimensions: `Connector_JST:JST_XH_B10B-XH-A_1x10_P2.50mm_Vertical`.

- **D0 DIY • fitted parts:** quantity 1; references `J4`.

[AliExpress search — unverified results](https://www.aliexpress.com/wholesale?SearchText=B10B-XH-A)

<details><summary>Exact BOM row conditions, notes and sources</summary>

- **d0:J4:** Fitted to board. WIZ850io Ethernet module [Official / original source](https://www.jst-mfg.com/product/pdf/eng/eXH.pdf).

</details>

### B2B-XH-A

Original family illustration, not a photo or a footprint. Package dimensions and terminal layout must be checked against the exact row and datasheet.

**Original illustration** — Original family illustration, not a photo or a footprint. Package dimensions and terminal layout must be checked against the exact row and datasheet.

Image: HA Radio Hub project · MIT. [Local family illustration](../hardware/parts/illustrations/connector.svg).

Package / dimensions: `Carrier:JST_XH_B2B-XH-A_1x02_P2.50mm_Vertical`.

- **C0 carrier • fitted parts:** quantity 1; references `J1`.

[AliExpress search — unverified results](https://www.aliexpress.com/wholesale?SearchText=B2B-XH-A)

<details><summary>Exact BOM row conditions, notes and sources</summary>

- **c0:J1:** Fitted to board. Isolated regulated 5V input [Official / original source](https://www.jst-mfg.com/product/pdf/eng/eXH.pdf).

</details>

### B2B-XH-A

Original family illustration, not a photo or a footprint. Package dimensions and terminal layout must be checked against the exact row and datasheet.

**Original illustration** — Original family illustration, not a photo or a footprint. Package dimensions and terminal layout must be checked against the exact row and datasheet.

Image: HA Radio Hub project · MIT. [Local family illustration](../hardware/parts/illustrations/connector.svg).

Package / dimensions: `Connector_JST:JST_XH_B2B-XH-A_1x02_P2.50mm_Vertical`.

- **D0 DIY • fitted parts:** quantity 1; references `J1`.

[AliExpress search — unverified results](https://www.aliexpress.com/wholesale?SearchText=B2B-XH-A)

<details><summary>Exact BOM row conditions, notes and sources</summary>

- **d0:J1:** Fitted to board. Isolated regulated 5V input [Official / original source](https://www.jst-mfg.com/product/pdf/eng/eXH.pdf).

</details>

### B3B-XH-A

Original family illustration, not a photo or a footprint. Package dimensions and terminal layout must be checked against the exact row and datasheet.

**Original illustration** — Original family illustration, not a photo or a footprint. Package dimensions and terminal layout must be checked against the exact row and datasheet.

Image: HA Radio Hub project · MIT. [Local family illustration](../hardware/parts/illustrations/connector.svg).

Package / dimensions: `Carrier:JST_XH_B3B-XH-A_1x03_P2.50mm_Vertical`.

- **C0 carrier • fitted parts:** quantity 1; references `J2`.

[AliExpress search — unverified results](https://www.aliexpress.com/wholesale?SearchText=B3B-XH-A)

<details><summary>Exact BOM row conditions, notes and sources</summary>

- **c0:J2:** Fitted to board. External D24V22F3 buck [Official / original source](https://www.jst-mfg.com/product/pdf/eng/eXH.pdf).

</details>

### B3B-XH-A

Original family illustration, not a photo or a footprint. Package dimensions and terminal layout must be checked against the exact row and datasheet.

**Original illustration** — Original family illustration, not a photo or a footprint. Package dimensions and terminal layout must be checked against the exact row and datasheet.

Image: HA Radio Hub project · MIT. [Local family illustration](../hardware/parts/illustrations/connector.svg).

Package / dimensions: `Connector_JST:JST_XH_B3B-XH-A_1x03_P2.50mm_Vertical`.

- **D0 DIY • fitted parts:** quantity 1; references `J2`.

[AliExpress search — unverified results](https://www.aliexpress.com/wholesale?SearchText=B3B-XH-A)

<details><summary>Exact BOM row conditions, notes and sources</summary>

- **d0:J2:** Fitted to board. External D24V22F3 buck [Official / original source](https://www.jst-mfg.com/product/pdf/eng/eXH.pdf).

</details>

### B4B-XH-A

Original family illustration, not a photo or a footprint. Package dimensions and terminal layout must be checked against the exact row and datasheet.

**Original illustration** — Original family illustration, not a photo or a footprint. Package dimensions and terminal layout must be checked against the exact row and datasheet.

Image: HA Radio Hub project · MIT. [Local family illustration](../hardware/parts/illustrations/connector.svg).

Package / dimensions: `Carrier:JST_XH_B4B-XH-A_1x04_P2.50mm_Vertical`.

- **C0 carrier • fitted parts:** quantity 1; references `J9`.

[AliExpress search — unverified results](https://www.aliexpress.com/wholesale?SearchText=B4B-XH-A)

<details><summary>Exact BOM row conditions, notes and sources</summary>

- **c0:J9:** Fitted to board. LD2450 radar [Official / original source](https://www.jst-mfg.com/product/pdf/eng/eXH.pdf).

</details>

### B4B-XH-A

Original family illustration, not a photo or a footprint. Package dimensions and terminal layout must be checked against the exact row and datasheet.

**Original illustration** — Original family illustration, not a photo or a footprint. Package dimensions and terminal layout must be checked against the exact row and datasheet.

Image: HA Radio Hub project · MIT. [Local family illustration](../hardware/parts/illustrations/connector.svg).

Package / dimensions: `Hub:JST_XH_B4B-XH-A_1x04_P2.50mm_Vertical`.

- **I0 integrated • fitted parts:** quantity 1; references `J5`.

[AliExpress search — unverified results](https://www.aliexpress.com/wholesale?SearchText=B4B-XH-A)

<details><summary>Exact BOM row conditions, notes and sources</summary>

- **i0:J5:** Fitted to board. LD2450 remote radar [Official / original source](https://www.jst-mfg.com/product/pdf/eng/eXH.pdf).

</details>

### B4B-XH-A

Original family illustration, not a photo or a footprint. Package dimensions and terminal layout must be checked against the exact row and datasheet.

**Original illustration** — Original family illustration, not a photo or a footprint. Package dimensions and terminal layout must be checked against the exact row and datasheet.

Image: HA Radio Hub project · MIT. [Local family illustration](../hardware/parts/illustrations/connector.svg).

Package / dimensions: `Connector_JST:JST_XH_B4B-XH-A_1x04_P2.50mm_Vertical`.

- **D0 DIY • fitted parts:** quantity 2; references `J9, J10`.

[AliExpress search — unverified results](https://www.aliexpress.com/wholesale?SearchText=B4B-XH-A)

<details><summary>Exact BOM row conditions, notes and sources</summary>

- **d0:J9:** Fitted to board. LD2450 radar [Official / original source](https://www.jst-mfg.com/product/pdf/eng/eXH.pdf).
- **d0:J10:** Fitted to board. TH XH to factory STEMMA QT cable; same logical order as C0, mechanically NOT a QT socket. [Official / original source](https://www.jst-mfg.com/product/pdf/eng/eXH.pdf).

</details>

### B5B-XH-A

Original family illustration, not a photo or a footprint. Package dimensions and terminal layout must be checked against the exact row and datasheet.

**Original illustration** — Original family illustration, not a photo or a footprint. Package dimensions and terminal layout must be checked against the exact row and datasheet.

Image: HA Radio Hub project · MIT. [Local family illustration](../hardware/parts/illustrations/connector.svg).

Package / dimensions: `Carrier:JST_XH_B5B-XH-A_1x05_P2.50mm_Vertical`.

- **C0 carrier • fitted parts:** quantity 1; references `J8`.

[AliExpress search — unverified results](https://www.aliexpress.com/wholesale?SearchText=B5B-XH-A)

<details><summary>Exact BOM row conditions, notes and sources</summary>

- **c0:J8:** Fitted to board. ZAC93 Z-Wave module [Official / original source](https://www.jst-mfg.com/product/pdf/eng/eXH.pdf).

</details>

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
