ha-homelab/ha-radio-hub/hardware/bom.csv

ref | qty | item | model_or_requirement | power_or_signal | dimensions_mm | budget_usd_each | status | source | notes | variant
PSE | 1 | PoE source | Existing active IEEE 802.3at port or TP-Link Omada POE160S injector | 30W PSE class |  | 0-40 | reuse_or_select | https://www.omadanetworks.com/us/business-networking/omada-accessory-poe-adapter/poe160s/ | External to hub;30W port budget;injector includes mains cord;not a PoE HAT or passive adapter | common
PS1 | 1 | Isolated PoE splitter | Waveshare POE-SPLITTER-25W-5.5-2.1 | 5V 5A maximum | 102.5x29.6x24.8 | 19.99 | manufacturer_spec | https://www.waveshare.com/product/accessories/power-heat-sinks/poe-splitter-25w-type-c.htm | DC output version;captive maleRJ45 and male5.5x2.1DC tails;20W design cap pending thermal/load test | common
SW1 | 1 | Ethernet switch | TP-Link TL-SF1005D v13 | 5V;reserve2W;100Mbps | 104x70x22 | 10-20 | manufacturer_spec | https://www.tp-link.com/us/home-networking/5-port-switch/tl-sf1005d/v13/ | Check actual revision5V label and DC connector;1.9W vendor max;no PoE output;vendor operating ambient0 to40C | common
U1 | 1 | Linux SBC | Raspberry Pi 4 Model B 2GB or greater | 5V USB-C;reserve8W normal | 85x56 PCB | 45-70 | manufacturer_family | https://www.raspberrypi.com/products/raspberry-pi-4-model-b/ | 64-bit OS;no SSD or heavy additional workloads in power budget | common
SD1 | 1 | Storage | 32GB high-endurance microSD |  | microSD | 8-15 | select_supplier | https://www.raspberrypi.com/documentation/computers/getting-started.html | Buy traceable media;backup OTBR state privately | common
U2 | 1 | Zigbee coordinator | SMLIGHT SLZB-07Mg24 EFR32MG24 | USB 5V Zigbee NCP | 18x54x10 excluding_antenna | 25-40 | manufacturer_family | https://smlight.tech/products/slzb-07mg24 | Order Mg24 explicitly;retain supplied antenna;not generic SLZB-07 MG21;vendor operating ambient +5 to +35C | common
U3 | 1 | Thread radio | Nordic nRF52840 Dongle PCA10059 | USB 5V OpenThread RCP | 59x18 nominal | 10-15 | manufacturer_family | https://www.nordicsemi.com/Products/Development-hardware/nRF52840-Dongle | Onboard antenna;build USB bootloader-aware RCP;not DK board | common
U4 | 1 | ESPHome Ethernet node | Waveshare ESP32-S3-ETH-M | USB5V;16MB flash8MB PSRAM | 72.8x21 planar_outline;height_with_headers_verify | 16.99-25.99 | manufacturer_spec | https://www.waveshare.com/product/iot-communication/wired-comm-converter/esp32-s3-eth.htm | SKU34882;pre-soldered male headers;without PoE module camera or microSD | common
U5 | 1 | Z-Wave module | Zooz ZAC93 existing regional module | 3.3V UART115200 | measure_revision | 0_reuse | existing_design | https://www.getzooz.com/downloads/zooz-z-wave-800-series-long-range-gpio-module-zac93-LR-manual.pdf | Onboard antenna;check region;do not feed5V;vendor operating ambient0 to40C;co-location conditions see antennas.md | common
U6 | 1 | Radar | Hi-Link HLK-LD2450 | 5V UART3.3V256000 | 44x15 nominal_verify | 5-12 | selected_verify_lot | https://esphome.io/components/sensor/ld2450/ | 24GHz;include matching4wire cable;front radome | common
U7 | 1 | Environment sensor | Adafruit BME680 STEMMA QT product3660 | 3.3V I2C0x77 | 25.4x17.78 PCB_only_QT_revision | 18.95 | manufacturer_spec | https://www.adafruit.com/product/3660 | External vented pod;gas resistance is not CO2 | common
U8 | 1 | RF host | Existing ESP8266 NodeMCU v2 | 5V microUSB | measure_clone | 0_reuse | existing_design | https://github.com/ha-homelab/rf-airbridge | Compatibility option only;omit when using U10 wired RF;do not upgrade its pinned firmware blindly | compatibility_wifi_only
U9 | 1 | RF transceiver | Existing 433.92MHz CC1101 module | 3.3V SPI+GDO0+GDO2 for wired RF | measure_module | 0_reuse | existing_design | https://www.ti.com/product/CC1101 | Existing433MHz matching network and antenna;wired migration requires accessible GDO2;verify actual module pinout | common
J1 | 1 | DC distribution | Enclosed5V/GND distribution;one input and five branch pairs | 5A minimum assembly rating | layout_dependent | 8-20 | design_select_supplier |  | 5A rating includes every terminal and trunk joint;no breadboard;fuses are separate F1;do not parallel3V3 regulators | common
F1 | 1 | Fuse and holder set | 6 insulated holders:fused input plus5branches | DC rated;verify_inrush | layout_dependent | 5-15 | design_validate |  | Pi3A;switch1A;mainS3 1A;RF S3 1A or NodeMCU0.75A;radar0.25-0.5A;input fuse<=5A;final DC rating I2t and inrush selection pending | common
C1 | 2 | Internal Ethernet patch | Short Cat5e or Cat6 stranded RJ45 | 100BASE-TX in this assembly | 150-300 length | 2-5 | design_select_supplier |  | Switch-to-Pi;switch-to-main-S3;PS1 captive maleRJ45 plugs directly into switch;allow bend radius | common
C2 | 2 | USB radio extension | Shielded USB2 TypeA male-female | Data_and_power | 150-300 length | 3-6 | design_select_supplier |  | Place radiators away from Pi/switch and each other | common
C3 | 1 | Pi USB-C power adapter | Adafruit 4536 DC barrel jack to USB-C adapter | 5V only;3A assembly load test required | adapter_envelope_measure | 5.50 | prototype_candidate_load_test_pending | https://www.adafruit.com/product/4536 | Vendor explicitly supports Pi4;no published standalone3A rating;requires C17 source plug lead;no PD or protection;never dual-power | common
C4 | 1 | S3 power cable | DFRobot FIT0993 terminal-input USB-C output cable | 5V2A manufacturer rating;1A fused branch | 300 length;4 cable_OD | 3.90 | manufacturer_spec_load_test_pending | https://www.dfrobot.com/product-2831.html | Fused5V to +;GND to -;D+/D-/S unused and insulated;disconnect before programmerUSB;strain-relieve terminal block | common
C5 | 1 | NodeMCU power cable | 5V distribution to microUSB | 5V1A rated | 150-250 length | 2-5 | design_select_supplier |  | Compatibility branch only | compatibility_wifi_only
C6 | 1 | BME680 harness | Adafruit4397 JST-SH4pin to female sockets150mm | 3V3 GND SDA SCL | 150 length | 0.95 | manufacturer_spec | https://www.adafruit.com/product/4397 | QT cable not supplied with3660;mates maleS3 headers;3V3 GND SDA SCL;secure female contacts;totalI2C harness<=200mm | common
C7 | 1 | Low voltage wire kit | 18-20AWG trunk;20AWG Pi lead;22-24AWG other branches | 5V and3V3 separate | layout_dependent | 5-10 | design_select_supplier |  | Color coding alone is not pin verification | common
A1 | 1 | Zigbee antenna | Original supplied with SLZB-07Mg24 | 2.4GHz50ohm | measure | 0_included | matched_antenna | https://smlight.tech/products/slzb-07mg24 | Keep vendor antenna and TX power;do not substitute high gain blindly | common
A2 | 1 | RF antenna | Existing matched433.92MHz antenna | 50ohm_as_module_requires | measure | 0_reuse | existing_design | https://github.com/ha-homelab/rf-airbridge | Separate from ZWave PCB radiator;verify connector SMA vs RP-SMA | common
A3 | 1 | Optional BLE antenna | 2.4GHz50ohm IPEXGen1 external antenna | requires_R0_selection_rework | measure | 3-8 | optional_not_baseline | https://www.waveshare.com/wiki/ESP32-S3-ETH | Onboard ceramic is default;plugging antenna alone does not select it | optional
M1 | 1 | Printed enclosure | PETG or ASA shell plus removable deck | not_fire_certified | 240x200x80 | 10-25 | design_unbuilt |  | Measure all connectors before final print;filament estimate only | common
M2 | 1 | Sensor pod | Vented removable BME680 pod |  | approximately45x36x20 | 1-3 | design_unbuilt |  | Install away from warm exhaust;no sealed pocket | common
M3 | 1 | Mounting kit | Nylon standoffs screws ties inserts | board_holes_checked | layout_dependent | 5-10 | design_select_supplier |  | Do not drill unknown PCB areas;retain supplier enclosures where possible | common
M4 | 1 | Pi cooling | Low-profile passive heatsink;optional quiet5V fan | fan_if_used_within0.5Wbudget | fit_under_deck | 3-10 | design_validate |  | Establish actual enclosed temperatures | common
U10 | 1 | RF Ethernet replacement | Second Waveshare ESP32-S3-ETH-M | USB5V W5500 CC1101_SPI | 72.8x21 planar_outline;height_with_headers_verify | 16.99-25.99 | wired_rf_replaces_U8 | https://www.waveshare.com/product/iot-communication/wired-comm-converter/esp32-s3-eth.htm | SKU34882;pre-soldered male headers;replaces U8;add C8 C9 R1;no camera SD or PoE module;recheck20W budget | wired_rf_only
C8 | 1 | Extra RF Ethernet patch | Short Cat5e/Cat6 RJ45 | 100BASE-T | 150-300 length | 2-5 | required_for_wired_RF |  | Connect port4 to second S3 only | wired_rf_only
C9 | 1 | Extra RF USB-C power lead | DFRobot FIT0993 terminal-input USB-C output cable | 5V2A manufacturer rating;1A fused branch | 300 length;4 cable_OD | 3.90 | manufacturer_spec_load_test_pending | https://www.dfrobot.com/product-2831.html | Fused5V to +;GND to -;D+/D-/S unused and insulated;disconnect before programmerUSB;strain-relieve terminal block | wired_rf_only
R1 | 1 | RF TX pull-up | 4.7 kohm resistor 1/8W or greater | GPIO4/GDO0 to local 3.3V | insulate_leads | 0.10-0.50 | required_for_wired_RF | https://www.ti.com/lit/ds/symlink/cc1101.pdf | Open-drain TX is released during RX;never pull up to5V;short wiring | wired_rf_only
C10 | 1 | Splitter DC mating lead | 5.5x2.1mm female mating pigtail for PS1 male DC tail | 5V5A complete cable and connector rating | shortest_practical |  | select_after_connector_check |  | Input to J1 via main F1;18-20AWG;verify center polarity and5A rating;not unrated CCTV screw-terminal adapter | common
C11 | 1 | Switch power lead | DC plug matched to actual TL-SF1005D v13 jack | 5V1A branch | 150-250 length |  | select_after_connector_check |  | Measure outer inner and insertion dimensions;verify polarity from label;do not assume5.5x2.1 or reuse mains PSU output in parallel | common
C12 | 1 | ZAC93 adapter harness | 2x5 mating header and4signal wires to S3 female sockets | 3V3 GND UART TX RX | shortest_practical |  | select_after_connector_check |  | Match existingZAC93 header pitch and sex;route only pins1 6 8 10;mechanically keyed or clearly mark pin1;leave pin7 unused | common
C13 | 1 | LD2450 adapter harness | Matching4pin cable supplied with radar or separately sourced | 5V GND TX RX | route_to_lid |  | verify_included_or_order |  | Order separately only if absent fromU6 kit;no LD2410 cable substitution;verify pin labels before power | common
C14 | 1 | CC1101 adapter harness | 8signal wires or matched8pin connector | 3V3 GND SCLK MOSI MISO CS GDO0 GDO2 | shortest_practical |  | select_after_connector_check |  | WiredRF uses8signals;reuse connector only after pinout inspection;GDO2 must be accessible;R1 connects to local3V3 | wired_rf_only
C15 | 1 | External PoE Ethernet cable | Pure copper Cat5e/Cat6 RJ45;installation appropriate | 802.3at power plus data | site_length |  | select_supplier |  | From PSE power+data output toPS1;choose site length and bend radius;allowance excludes building cabling | common
C16 | 1 | Injector LAN input patch | Cat5e/Cat6 RJ45 data cable | Ethernet | site_length |  | only_if_separate_injector |  | Only for separatePOE160S;connect LAN switch to injector DATA IN;omit when existingPoE switch is PSE | injector_only
C17 | 1 | Pi source plug and short wire pair | Same Sky PP3-002A plus20AWG pair from C7 | Plug6A20V rating;used at5V;centerpositive | plug34x8.2;insertion9.5;wire150-250 |  | manufacturer_spec_assembly_test_pending | https://www.sameskydevices.com/product/resource/pp3-002a.pdf | 5.5OD2.1ID mates C3;fused5V to center andGND outer;solder and insulate;plug rating does not rate Adafruit4536 or completeharness;not switchplug C11 | common
