ha-homelab/ha-radio-hub/hardware/external-antenna/cad/BOM.csv

Reference | Quantity | Fitted | Part / module | Carrier footprint | Side | Assembly note | Source
U1 | 1 | true | ESP32-DevKitC-VIE | MC2:ESP32_DevKitC_VIE | Front | Factory male pins; WROVER-IE external U.FL; 8MB flash/8MB quad PSRAM; 5V via D1 wire link (NO DIODE); GPIO0 boot,1/3 USB-UART,6-11 flash,16/17 PSRAM reserved; BLE4.2, no BLE5 extended advertising | https://docs.espressif.com/projects/esp-dev-kits/en/latest/esp32/esp32-devkitc/user_guide.html
U2 | 1 | true | Seeed XIAO ESP32C6 pre-soldered 102010636 | MC2:XIAO_ESP32C6 | Front | Factory 2x7 male headers; native USB; ROM RX17/D7 TX16/D6; bottom TP8 EN and TP2 BOOT9 require J10 flying leads; onboard GPIO8 pullup; GPIO3 LOW and GPIO14 HIGH select external U.FL; no battery | https://wiki.seeedstudio.com/xiao_esp32c6_getting_started/
U3 | 1 | true | Seeed XIAO MG24 pre-soldered 102010690 | MC2:XIAO_MG24 | Front | External UART PC06/PC07; CTS PC04 RTS PC05; USB probe preserved; 3V3 OUT NC; external U.FL selected by firmware PB04=1 PB05=1 | https://files.seeedstudio.com/wiki/XIAO_MG24/Getting_Start/XIAO_MG24_v1.0_KiCad_260114.zip
U4 | 1 | true | WIZ850io finished module | MC2:WIZ850io | Front | Direct factory pins; two1x6 at20.32 rowspacing; RJ45 faces BOTTOM with mouth y=102mm; NO PoE extraction;3.3V only | https://docs.wiznet.io/img/products/wiz850io/wiz850io_dimension.png
J1 | 1 | true | FUSED ISOLATED 5V INPUT | MC2:PinHeader_1x02_P2.54mm_Vertical | Front | Offboard assembled active PoE splitter and fused 5V harness. No raw PoE voltage on carrier. | https://www.samtec.com/products/tsw
J2 | 1 | true | RECOM R-78K3.3-1.0 offboard 3V3 converter | MC2:PinHeader_1x04_P2.54mm_Vertical | Front | Harness interface only; pin1 buckVIN; pin2GND;pin3buckVOUT;pin4GND. RECOM plus 27uF input capacitor stays on supported offboard perfboard. | https://www.samtec.com/products/tsw
J3 | 1 | true | DFR0627 WK2132 ready module harness | MC2:PinHeader_1x06_P2.54mm_Vertical | Front | Harness to DFR0627 I2C and UART1, no WK2132 SMD on carrier. J3.5=module TX1;J3.6=module RX1; IA1=1 IA0=0; register address 0x50, FIFO 0x51; reserve 0x50-0x57; BME680 remains 0x77; verify physical markings. | https://wiki.dfrobot.com/dfr0627
J4 | 1 | true | ZAC93 ready module harness | MC2:PinHeader_1x05_P2.54mm_Vertical | Front | Carrier1->ZACpin1;2->pin6;3->pin9;4->pin8RX;5->pin10TX. Different from ZAC physical header layout. | https://www.samtec.com/products/tsw
J5 | 1 | true | CC1101 ready module harness | MC2:PinHeader_1x08_P2.54mm_Vertical | Front | 3.3V; GDO0 open-drain TX with external4.7k pullup; GDO2 receiver. | https://www.samtec.com/products/tsw
J6 | 1 | true | LD2450 radar harness | MC2:PinHeader_1x04_P2.54mm_Vertical | Front | Carrier3->radarRX;carrier4<-radarTX;5V supply;3.3V data. | https://www.samtec.com/products/tsw
J7 | 1 | true | BME680 external pod harness | MC2:PinHeader_1x04_P2.54mm_Vertical | Front | External pod,1GND2VDD3SDA4SCL;I2C pullups on modules;do notaddunreviewedpullups. | https://www.samtec.com/products/tsw
D1 | 1 | true | 22AWG WIRE LINK - NO DIODE | MC2:Wire_Link_P7.62mm | Front | Legacy D1 location: fit insulated 22AWG wire, not a diode. Pad1 to host EXT_5V, pad2 to fused5V. Host USB would energize the whole bus: flash loose, then use PoE and OTA only. | https://dl.espressif.com/dl/schematics/esp32_devkitc_v4-sch.pdf
D2 | 1 | true | 1N5819 USB supply isolation | MC2:D_DO-41_SOD81_P7.62mm_Horizontal | Front | Cathodepad1->board5V;anodepad2->fused5Vbus. VerifyUSBprogrammingpowerpaths;forwarddropheadroom. | https://www.vishay.com/docs/88525/1n5817.pdf
D3 | 1 | true | 1N5819 USB supply isolation | MC2:D_DO-41_SOD81_P7.62mm_Horizontal | Front | Cathodepad1->board5V;anodepad2->fused5Vbus. VerifyUSBprogrammingpowerpaths;forwarddropheadroom. | https://www.vishay.com/docs/88525/1n5817.pdf
R1 | 1 | true | 4.7k RF GDO0 pull-up | MC2:R_Axial_DIN0207_L6.3mm_D2.5mm_P7.62mm_Horizontal | Front |  | https://www.vishay.com/docs/28729/mrs16.pdf
R2 | 1 | true | 10k RF CS idle pull-up | MC2:R_Axial_DIN0207_L6.3mm_D2.5mm_P7.62mm_Horizontal | Front |  | https://www.vishay.com/docs/28729/mrs16.pdf
J8 | 0 | false | XIAO BOOT unpopulated service pads | MC2:PinHeader_1x02_P2.54mm_Vertical | Front | Temporary short D0/PC00 to GND while resetting XIAO for recovery. Normally OPEN. | https://www.samtec.com/products/tsw
J9 | 0 | false | HOST BOOT unpopulated service pads | MC2:PinHeader_1x02_P2.54mm_Vertical | Front | Normally OPEN; short GPIO0 to GND while pressing host RESET for USB-UART ROM recovery. | https://www.samtec.com/products/tsw
J10 | 1 | true | C6 EN/BOOT underside recovery harness | MC2:PinHeader_1x02_P2.54mm_Vertical | Front | Two 30AWG insulated leads above carrier under module; window for access: J10.1->XIAO TP8 EN; J10.2->TP2 BOOT/GPIO9. Required for host reset and automatic RCP flashing. Fit before module seating; retain slack and strain relief. | https://www.samtec.com/products/tsw
R4 | 1 | true | 10k host GPIO12 SCK boot pull-down | MC2:R_Axial_DIN0207_L6.3mm_D2.5mm_P7.62mm_Horizontal | Front | Required LOW at reset: WROVER-IE VDD_SDIO=3.3V; WIZ850io and CC1101 SCK are inputs without pull-ups. | https://www.vishay.com/docs/28729/mrs16.pdf
R5 | 1 | true | 10k host GPIO2 MOSI boot pull-down | MC2:R_Axial_DIN0207_L6.3mm_D2.5mm_P7.62mm_Horizontal | Front | Required LOW for serial download with GPIO0=LOW; MOSI connects only to SPI slave inputs. | https://www.vishay.com/docs/28729/mrs16.pdf
