ha-homelab/ha-radio-hub/hardware/module-carrier/cad/BOM.csv

Reference | Quantity | Fitted | Part / module | Carrier footprint | Side | Assembly note | Source
U1 | 1 | true | Waveshare ESP32-S3-Nano-M 16MB flash 8MB PSRAM | MC1:S3_Nano_M | Front | Factory male pins direct solder; JP1.15 VIN via D1; VBUS/3V3 NC; nativeUSB19/20; GPIO0 service; sharedSPI; no sockets | https://docs.waveshare.com/ESP32-S3-Nano
U2 | 1 | true | ESP32-H2-DevKitM-1-N4S | MC1:H2_DevKitM1 | Front | RCP/ROM RX23 TX24; remove USB-UART TX series R7 before assembly; native USB retained; 3V3/VBAT NC | https://dl.espressif.com/dl/schematics/esp32-h2-devkitm-1_v1.2_dimension.pdf
U3 | 1 | true | Seeed XIAO MG24 pre-soldered 102010690 | MC1:XIAO_MG24 | Front | External UART PC06/PC07; CTS PC04 RTS PC05; USB probe preserved; 3V3 OUT NC | https://files.seeedstudio.com/wiki/XIAO_MG24/Getting_Start/XIAO_MG24_v1.0_KiCad_260114.zip
U4 | 1 | true | WIZ850io finished module | MC1:WIZ850io | Back | Direct factory pins; two1x6 at20.32 rowspacing; RJ45 faces BOTTOM with mouth y=77mm; NO PoE extraction;3.3V only | https://docs.wiznet.io/img/products/wiz850io/wiz850io_dimension.png
J1 | 1 | true | FUSED ISOLATED 5V INPUT | MC1:PinHeader_1x02_P2.54mm_Vertical | Back | Offboard assembled active PoE splitter and fused 5V harness. No raw PoE voltage on carrier. | https://www.samtec.com/products/tsw
J2 | 1 | true | D24V22F3 external assembled buck | MC1:PinHeader_1x04_P2.54mm_Vertical | Back | Harness interface only; pin1 buckVIN; pin2GND;pin3buckVOUT;pin4GND. Buck remains separate ready module. | https://www.samtec.com/products/tsw
J3 | 1 | true | DFR0627 WK2132 ready module harness | MC1:PinHeader_1x06_P2.54mm_Vertical | Back | Harness to DFR0627 I2C and UART1, no WK2132 SMD on carrier. J3.5=module TX1;J3.6=module RX1; IA1=1 IA0=1; register address 0x70, FIFO 0x71; verify physical markings. | https://wiki.dfrobot.com/dfr0627
J4 | 1 | true | ZAC93 ready module harness | MC1:PinHeader_1x05_P2.54mm_Vertical | Back | Carrier1->ZACpin1;2->pin6;3->pin9;4->pin8RX;5->pin10TX. Different from ZAC physical header layout. | https://www.samtec.com/products/tsw
J5 | 1 | true | CC1101 ready module harness | MC1:PinHeader_1x08_P2.54mm_Vertical | Back | 3.3V; GDO0 open-drain TX with external4.7k pullup; GDO2 receiver. | https://www.samtec.com/products/tsw
J6 | 1 | true | LD2450 radar harness | MC1:PinHeader_1x04_P2.54mm_Vertical | Back | Carrier3->radarRX;carrier4<-radarTX;5V supply;3.3V data. | https://www.samtec.com/products/tsw
J7 | 1 | true | BME680 external pod harness | MC1:PinHeader_1x04_P2.54mm_Vertical | Back | External pod,1GND2VDD3SDA4SCL;I2C pullups on modules;do notaddunreviewedpullups. | https://www.samtec.com/products/tsw
D1 | 1 | true | 1N5819 USB supply isolation | MC1:D_DO-41_SOD81_P7.62mm_Horizontal | Back | Cathodepad1->board5V;anodepad2->fused5Vbus. VerifyUSBprogrammingpowerpaths;forwarddropheadroom. | https://www.vishay.com/docs/88525/1n5817.pdf
D2 | 1 | true | 1N5819 USB supply isolation | MC1:D_DO-41_SOD81_P7.62mm_Horizontal | Back | Cathodepad1->board5V;anodepad2->fused5Vbus. VerifyUSBprogrammingpowerpaths;forwarddropheadroom. | https://www.vishay.com/docs/88525/1n5817.pdf
D3 | 1 | true | 1N5819 USB supply isolation | MC1:D_DO-41_SOD81_P7.62mm_Horizontal | Back | Cathodepad1->board5V;anodepad2->fused5Vbus. VerifyUSBprogrammingpowerpaths;forwarddropheadroom. | https://www.vishay.com/docs/88525/1n5817.pdf
R1 | 1 | true | 4.7k RF GDO0 pull-up | MC1:R_Axial_DIN0207_L6.3mm_D2.5mm_P7.62mm_Horizontal | Back |  | https://www.vishay.com/docs/28729/mrs16.pdf
R2 | 1 | true | 10k RF CS idle pull-up | MC1:R_Axial_DIN0207_L6.3mm_D2.5mm_P7.62mm_Horizontal | Back |  | https://www.vishay.com/docs/28729/mrs16.pdf
J8 | 0 | false | XIAO BOOT unpopulated service pads | MC1:PinHeader_1x02_P2.54mm_Vertical | Front | Temporary short D0/PC00 to GND while resetting XIAO for recovery. Normally OPEN. | https://www.samtec.com/products/tsw
J9 | 0 | false | Nano BOOT unpopulated service pads | MC1:PinHeader_1x02_P2.54mm_Vertical | Front | Normally OPEN; short GPIO0 to GND while pressing Nano RESET for nativeUSB ROM recovery. | https://www.samtec.com/products/tsw
