ha-homelab/ha-radio-hub/hardware/low-power/carrier/mg24-adapter/assembly-bom.csv

Reference | Quantity | Manufacturer part / value | Footprint | Note | Source
U1 | 1 | MGM240PA22VNA3 | Carrier:MGM240P | Exact PA22VNA3 firmware target; all GND pads direct to plane; RFOUT33 intentionally NC | https://www.silabs.com/documents/public/data-sheets/mgm240p-datasheet.pdf
J1 | 1 | B6B-XH-A | Carrier:JST_XH_B6B-XH-A_1x06_P2.50mm_Vertical | To carrier J6 | https://www.jst-mfg.com/product/pdf/eng/eXH.pdf
J2 | 1 | B7B-XH-A | Carrier:JST_XH_B7B-XH-A_1x07_P2.50mm_Vertical | SWD / reset / boot service | https://www.jst-mfg.com/product/pdf/eng/eXH.pdf
R1 | 1 | 10k | Carrier:R_0805_2012Metric | 1%, 0.125W, 0805
C1 | 1 | 100nF | Carrier:C_0805_2012Metric | 10V X7R, 0805, close to VDD15
C2 | 1 | 1uF | Carrier:C_0805_2012Metric | 10V X7R, 0805
C3 | 1 | 10uF | Carrier:C_1206_3216Metric | 10V X7R, 1206; account for DC bias
