ha-homelab/ha-radio-hub/hardware/module-carrier/studies/square-layout/cad-candidate/BOM.csv

Reference | Quantity | Part / module | Carrier footprint | Side | Assembly note | Source
U1 | 1 | ESP32-S3-DevKitC-1-N8R8 v1.1 | MC1:S3_DevKitC1_v11 | Top | Factory male headers solder directly; 3V3 outputs NC; USB19/20 and bridge43/44 untouched; no sockets | https://dl.espressif.com/dl/schematics/esp_idf/DXF_ESP32-S3-DevKitC-1_V1.1_20220429.pdf
U2 | 1 | ESP32-H2-DevKitM-1-N4S | MC1:H2_DevKitM1 | Top | RCP RX4 TX5; native USB and UART bridge pins untouched; 3V3/VBAT NC | https://dl.espressif.com/dl/schematics/esp32-h2-devkitm-1_v1.2_dimension.pdf
U3 | 1 | Seeed XIAO MG24 pre-soldered 102010690 | MC1:XIAO_MG24 | Top | External UART PC06/PC07; CTS PC04 RTS PC05; USB probe preserved; 3V3 OUT NC | https://files.seeedstudio.com/wiki/XIAO_MG24/Getting_Start/XIAO_MG24_v1.0_KiCad_260114.zip
U4 | 1 | WIZ850io finished module | MC1:WIZ850io | Top | Direct factory pins; two1x6 at20.32 rowspacing; RJ45 faces BOTTOM with mouth y=102mm; NO PoE extraction;3.3V only | https://docs.wiznet.io/img/products/wiz850io/wiz850io_dimension.png
J1 | 1 | FUSED ISOLATED 5V INPUT | MC1:PinHeader_1x02_P2.54mm_Vertical | Top | Offboard assembled active PoE splitter and fused 5V harness. No raw PoE voltage on carrier. | https://www.samtec.com/products/tsw
J2 | 1 | D24V22F3 external assembled buck | MC1:PinHeader_1x04_P2.54mm_Vertical | Top | Harness interface only; pin1 buckVIN; pin2GND;pin3buckVOUT;pin4GND. Buck remains separate ready module. | https://www.samtec.com/products/tsw
J3 | 1 | DFR0627 WK2132 ready module harness | MC1:PinHeader_1x06_P2.54mm_Vertical | Top | Harness to DFR0627 I2C and UART1, no WK2132 SMD on carrier. J3.5=module TX1;J3.6=module RX1; IA1=1 IA0=1; register address 0x70, FIFO 0x71; verify physical markings. | https://wiki.dfrobot.com/dfr0627
J4 | 1 | ZAC93 ready module harness | MC1:PinHeader_1x05_P2.54mm_Vertical | Top | Carrier1->ZACpin1;2->pin6;3->pin9;4->pin8RX;5->pin10TX. Different from ZAC physical header layout. | https://www.samtec.com/products/tsw
J5 | 1 | CC1101 ready module harness | MC1:PinHeader_1x08_P2.54mm_Vertical | Top | 3.3V; GDO0 open-drain TX with external4.7k pullup; GDO2 receiver. | https://www.samtec.com/products/tsw
J6 | 1 | LD2450 radar harness | MC1:PinHeader_1x04_P2.54mm_Vertical | Top | Carrier3->radarRX;carrier4<-radarTX;5V supply;3.3V data. | https://www.samtec.com/products/tsw
J7 | 1 | BME680 external pod harness | MC1:PinHeader_1x04_P2.54mm_Vertical | Top | External pod,1GND2VDD3SDA4SCL;I2C pullups on modules;do notaddunreviewedpullups. | https://www.samtec.com/products/tsw
D1 | 1 | 1N5819 USB supply isolation | MC1:D_DO-41_SOD81_P7.62mm_Horizontal | Top | Cathodepad1->board5V;anodepad2->fused5Vbus. VerifyUSBprogrammingpowerpaths;forwarddropheadroom. | https://www.vishay.com/docs/88525/1n5817.pdf
D2 | 1 | 1N5819 USB supply isolation | MC1:D_DO-41_SOD81_P7.62mm_Horizontal | Top | Cathodepad1->board5V;anodepad2->fused5Vbus. VerifyUSBprogrammingpowerpaths;forwarddropheadroom. | https://www.vishay.com/docs/88525/1n5817.pdf
D3 | 1 | 1N5819 USB supply isolation | MC1:D_DO-41_SOD81_P7.62mm_Horizontal | Top | Cathodepad1->board5V;anodepad2->fused5Vbus. VerifyUSBprogrammingpowerpaths;forwarddropheadroom. | https://www.vishay.com/docs/88525/1n5817.pdf
R1 | 1 | 4.7k RF GDO0 pull-up | MC1:R_Axial_DIN0207_L6.3mm_D2.5mm_P7.62mm_Horizontal | Top |  | https://www.vishay.com/docs/28729/mrs16.pdf
R2 | 1 | 10k RF CS idle pull-up | MC1:R_Axial_DIN0207_L6.3mm_D2.5mm_P7.62mm_Horizontal | Top |  | https://www.vishay.com/docs/28729/mrs16.pdf
J8 | 1 | XIAO BOOT service short to GND | MC1:PinHeader_1x02_P2.54mm_Vertical | Top | Temporary short D0/PC00 to GND while resetting XIAO for recovery. Normally OPEN. | https://www.samtec.com/products/tsw
