ha-homelab/ha-radio-hub/hardware/external-antenna/power-measurements.csv

id | positive_probe | ground_probe | conditions | acceptance | source | measured_min_v | measured_max_v | load_ma | temperature_c | waveform_file | status | notes
recom_input | RECOM pin 1 VIN | RECOM pin 2 GND | Initial detached test, then simultaneous load and thermal equilibrium | At least 4.5 V once regulated, including load transients; no repeated UVLO startup cycling. Confirm correct polarity before connecting J2. | https://recom-power.com/pdf/Innoline/R-78K-1.0.pdf |  |  |  |  |  | not_run
peripheral_output | J2.3 / RECOM pin 3 VOUT | J2.4 / RECOM pin 2 GND | Detached loads 0/400/750 mA and 100-750 mA steps, then assembled simultaneous load | Project 3.3 V +/-5% band including ripple and load transients after regulation; inspect startup/shutdown separately. | https://recom-power.com/pdf/Innoline/R-78K-1.0.pdf |  |  |  |  |  | not_run
zac93_local_supply | ZAC93 physical pin 1, at the module | ZAC93 physical pin 6, at the module | Simultaneous load including Z-Wave transmission, cold start and thermal equilibrium | Project 3.3 V +/-5% band at the cable destination, including ripple and load transients. Check both ZAC93 ground leads by unpowered continuity first. | https://www.getzooz.com/downloads/zooz-z-wave-800-series-long-range-gpio-module-zac93-LR-manual.pdf |  |  |  |  |  | not_run
host_regulator_input | U1.J2.19 / D1 link pad 1 / EXT_5V | U1.J2.14 GND | Measure simultaneously with U1 local 3V3 during peak load and at thermal equilibrium | Apply host_input_rule: VIN-VOUT must exceed the fitted regulator's guaranteed dropout at the tested current and temperature, plus ripple/measurement margin. Record the bound and measured minimum headroom in notes; no fixed 4.5 V pass threshold applies here. | https://dl.espressif.com/dl/schematics/esp32_devkitc_v4-sch.pdf |  |  |  |  |  | not_run
host_local_3v3 | U1.J2.1 local 3V3 | U1.J2.14 GND | Cold start, three BLE connections and all hub protocols active, through thermal equilibrium | Project 3.3 V +/-5% band after regulation, including ripple and transients; no brownout/restart. The WROVER-IE operating range is 3.0-3.6 V; that wider range is not a substitute for this design target or the separate dropout check. | https://documentation.espressif.com/esp32-wrover-e_esp32-wrover-ie_datasheet_en.html |  |  |  |  |  | not_run
c6_local_3v3 | U2.12 local 3V3 | U2.13 GND | Cold start, Thread radio traffic, host-controlled reset and thermal equilibrium | Project 3.3 V +/-5% band after regulation, including ripple and transients. The U2 header 5 V path has its own onboard diode and regulator; a good peripheral rail does not qualify this local rail. | https://files.seeedstudio.com/wiki/SeeedStudio-XIAO-ESP32C6/XIAO_ESP32_C6_v1.0_SCH_260114.pdf |  |  |  |  |  | not_run
mg24_local_3v3 | U3.12 local 3V3 | U3.13 GND | Cold start, Zigbee transmissions and thermal equilibrium | Project 3.3 V +/-5% band after regulation, including ripple and transients. Check at the local regulator output; do not infer it from J2 or connect it to J2.3. | https://files.seeedstudio.com/wiki/XIAO_MG24/Getting_Start/XIAO_MG24_v1.0_KiCad_260114.zip |  |  |  |  |  | not_run
host_gpio12_boot | U1.J2.13 GPIO12 / R4.2 | U1.J2.14 GND | Cold power-up and host EN reset, with WIZ850io and actual CC1101 connected | Remain at or below 0.25 times measured U1 local VDD during the datasheet strap-sampling interval around EN release. Use a scope; a later SPI waveform or DMM average cannot establish the boot level. GPIO12 LOW selects 3.3 V VDD_SDIO. | https://documentation.espressif.com/esp32-wrover-e_esp32-wrover-ie_datasheet_en.html |  |  |  |  |  | not_run
host_gpio2_download | U1.J3.15 GPIO2 / R5.2 | U1.J3.7 GND | Host EN reset with GPIO0 held LOW by J9 service short; all modules attached, no powered USB | Remain at or below 0.25 times measured U1 local VDD during the datasheet strap-sampling interval. This verifies the GPIO2 condition for UART download; it does not qualify USB power isolation or prove a complete flash operation. Remove J9 short afterwards. | https://documentation.espressif.com/esp32-wrover-e_esp32-wrover-ie_datasheet_en.html |  |  |  |  |  | not_run
