ha-homelab/ha-radio-hub/hardware/module-carrier/cost-review/jlc-5.jpg

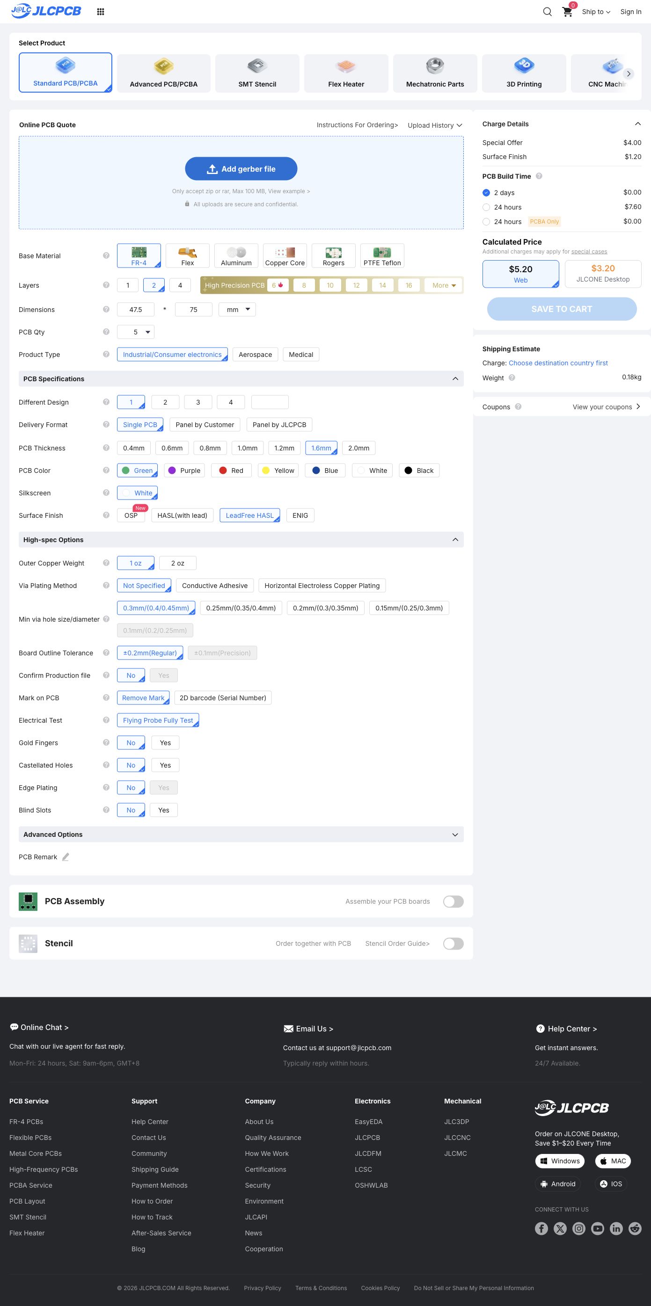
hardware/module-carrier/cost-review/jlc-5.jpg
