ha-homelab/ha-radio-hub/mechanical/module-carrier/enclosure-prototype/print-parts.png

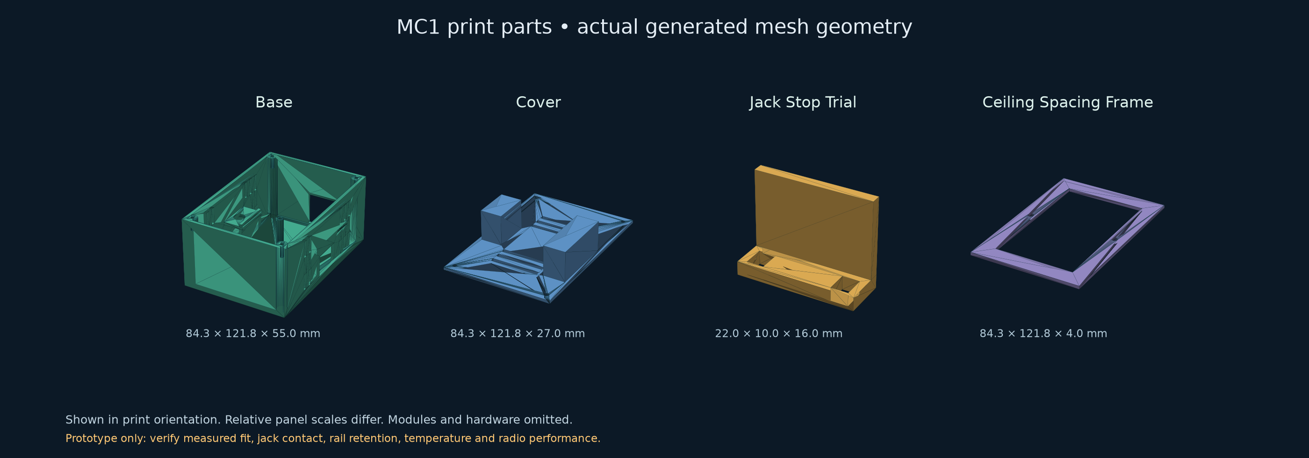
mechanical/module-carrier/enclosure-prototype/print-parts.png
