ha-homelab/ha-radio-hub/mechanical/module-carrier/external-antenna-prototype/print-parts.png

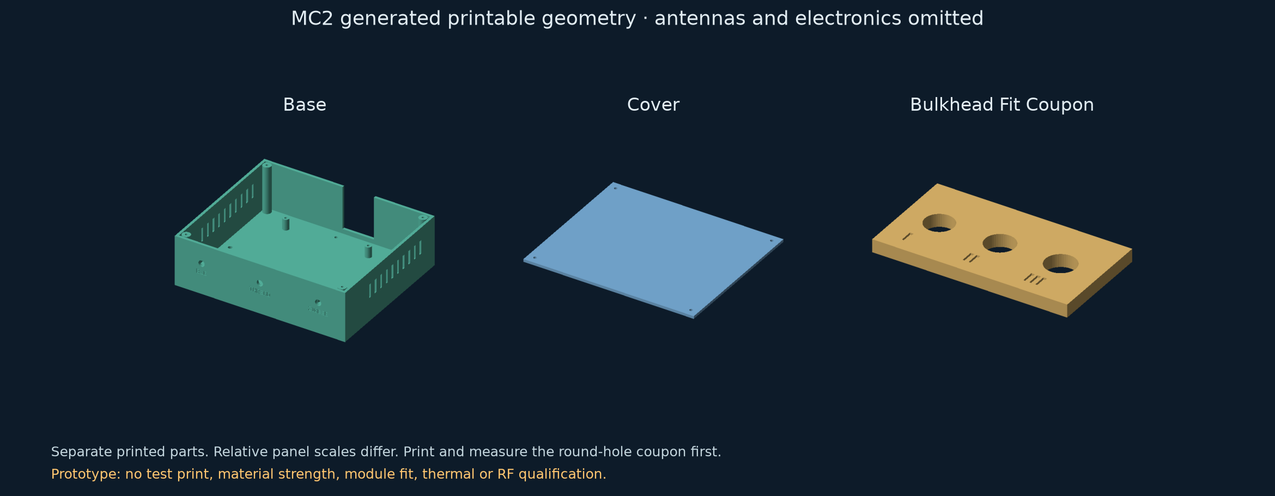
mechanical/module-carrier/external-antenna-prototype/print-parts.png
