ha-homelab/ha-radio-hub/mechanical/full-hub/base.stl

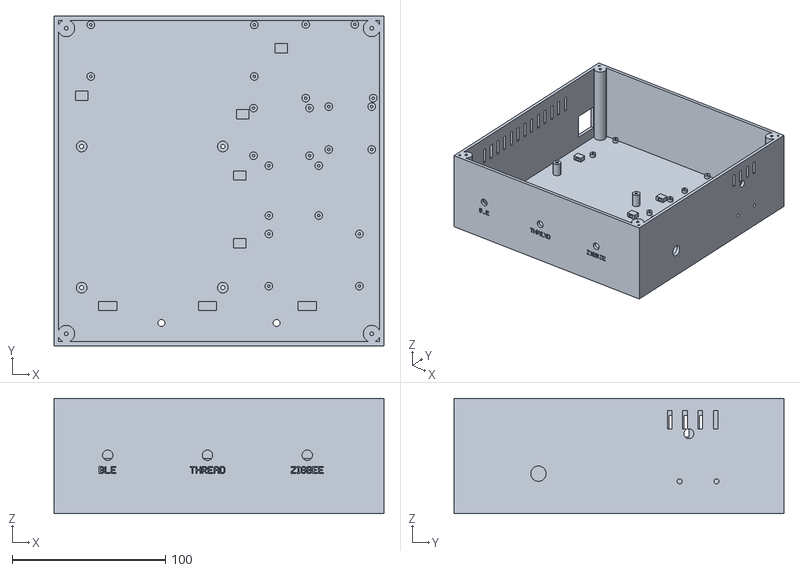
[picture p46: CAD file, 2026-10-20]
mechanical/full-hub/base.stl
215.0 x 215.0 x 75.0
