ha-homelab/ha-radio-hub/mechanical/generated/base.stl

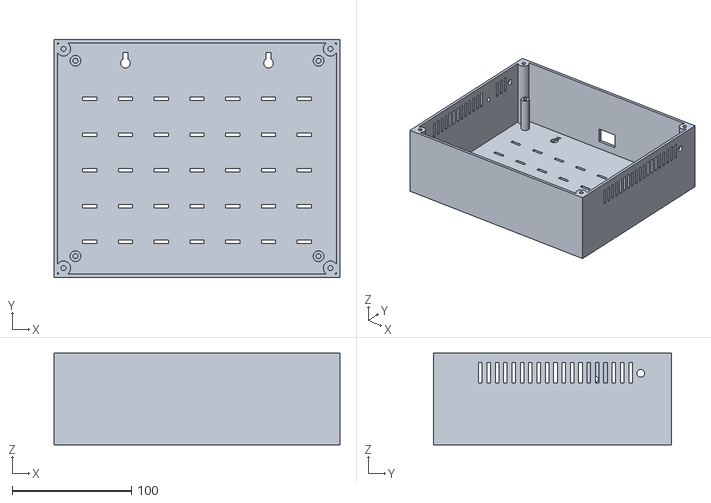
[picture p47: CAD file, 2026-10-17]
mechanical/generated/base.stl
240.0 x 200.0 x 77.0
