ha-homelab/ha-radio-hub/mechanical/low-power/generated/carrier_fit_blank.stl

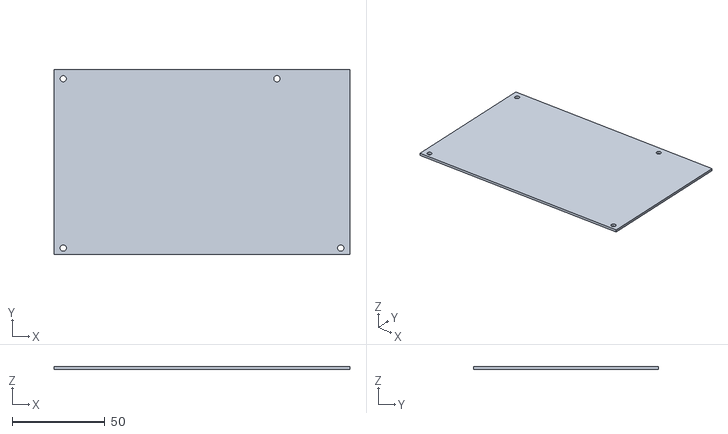
[picture p48: CAD file, 2026-10-17]
mechanical/low-power/generated/carrier_fit_blank.stl
160.0 x 100.0 x 1.60
