ha-homelab/ha-radio-hub/mechanical/module-carrier/enclosure-prototype/base.stl

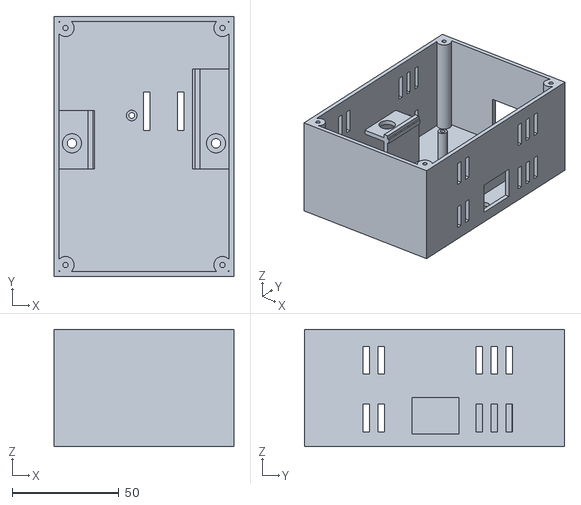
[picture p49: CAD file, 2026-10-18]
mechanical/module-carrier/enclosure-prototype/base.stl
84.3 x 121.8 x 55.0
