ha-homelab/ha-radio-hub/mechanical/module-carrier/external-antenna-prototype/bulkhead-fit-coupon.stl

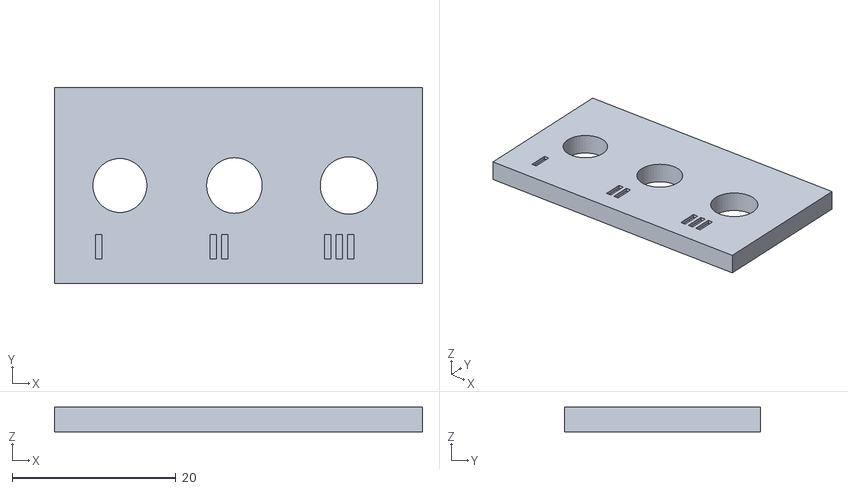
[picture p50: CAD file, 2026-10-20]
mechanical/module-carrier/external-antenna-prototype/bulkhead-fit-coupon.stl
45.0 x 24.0 x 3.00
