ha-homelab/ha-radio-hub/mechanical/module-carrier/rail-mount/fit-gap-2p2.stl

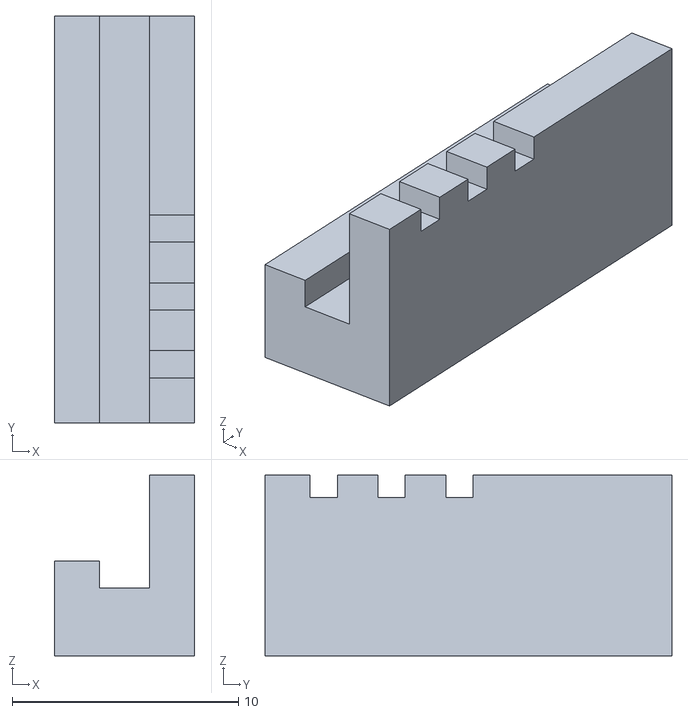
[picture p51: CAD file, 2026-10-18]
mechanical/module-carrier/rail-mount/fit-gap-2p2.stl
6.20 x 18.0 x 8.00
