ha-homelab/ha-radio-hub/mechanical/full-hub/buck-tray.stl

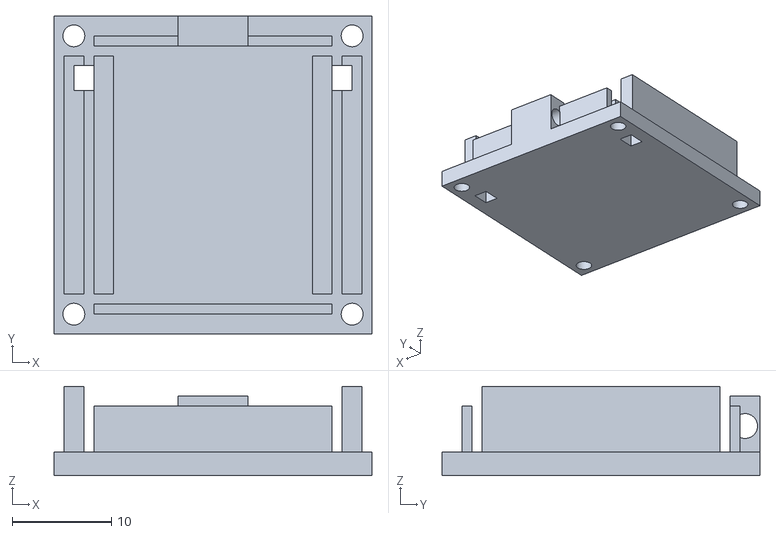
[picture p52: CAD file, 2026-10-20]
mechanical/full-hub/buck-tray.stl
32.0 x 32.0 x 9.00
