ha-homelab/ha-radio-hub/mechanical/generated/deck.stl

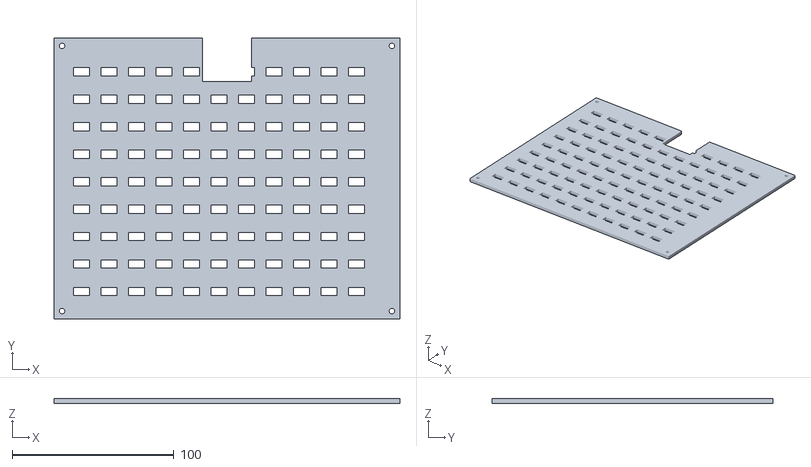
[picture p53: CAD file, 2026-10-17]
mechanical/generated/deck.stl
214.0 x 174.0 x 3.00
