ha-homelab/ha-radio-hub/mechanical/low-power/generated/mockup_lid.stl

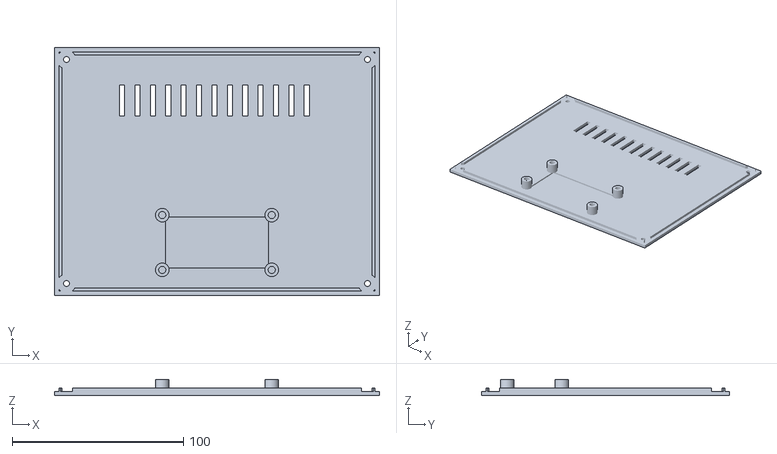
[picture p54: CAD file, 2026-10-17]
mechanical/low-power/generated/mockup_lid.stl
190.0 x 145.0 x 9.40
