ha-homelab/ha-radio-hub/mechanical/module-carrier/enclosure-prototype/jack-stop-trial.stl

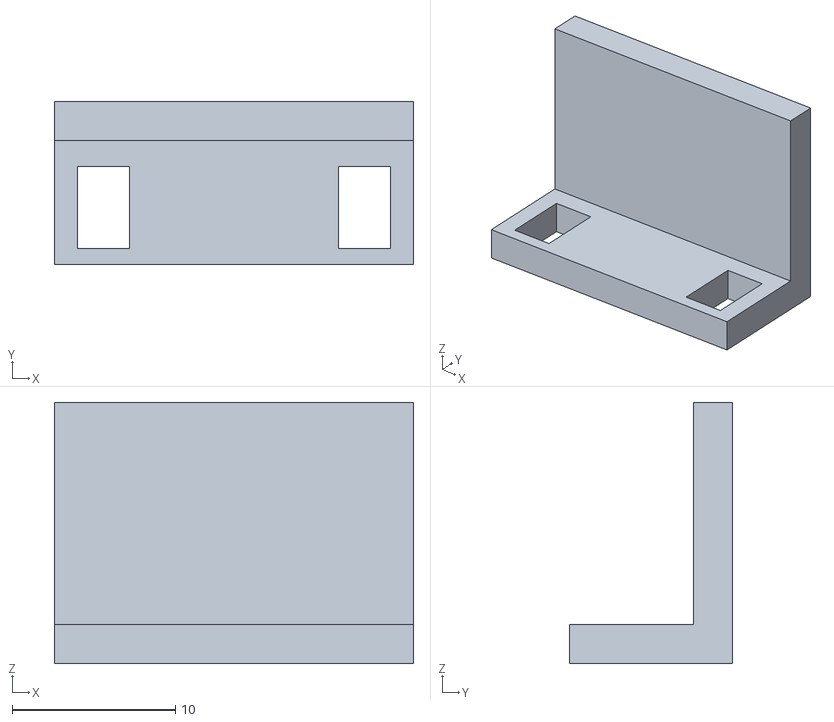
[picture p55: CAD file, 2026-10-18]
mechanical/module-carrier/enclosure-prototype/jack-stop-trial.stl
22.0 x 10.0 x 16.0
