ha-homelab/ha-radio-hub/mechanical/module-carrier/external-antenna-prototype/base.stl

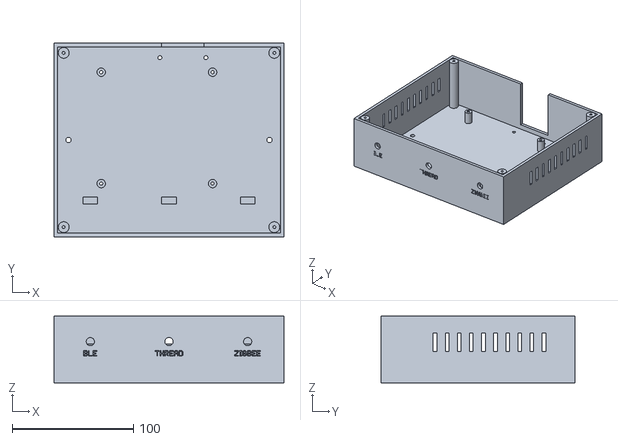
[picture p56: CAD file, 2026-10-20]
mechanical/module-carrier/external-antenna-prototype/base.stl
190.0 x 160.0 x 55.0
