ha-homelab/ha-radio-hub/mechanical/module-carrier/rail-mount/fit-gap-2p0.stl

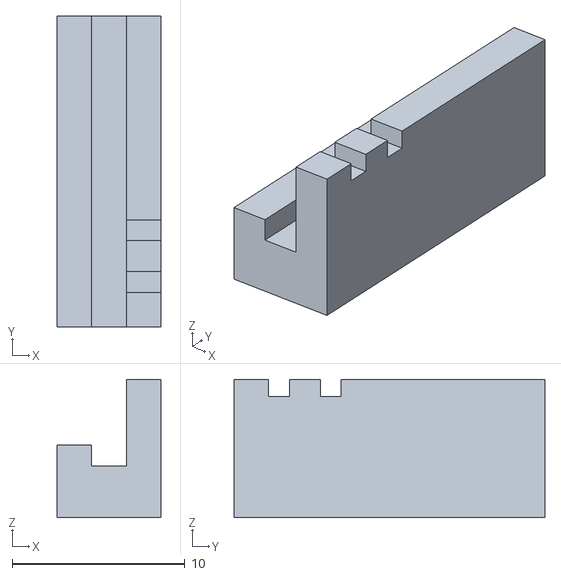
[picture p57: CAD file, 2026-10-18]
mechanical/module-carrier/rail-mount/fit-gap-2p0.stl
6.00 x 18.0 x 8.00
