ha-homelab/ha-radio-hub/mechanical/full-hub/fit-coupon.stl

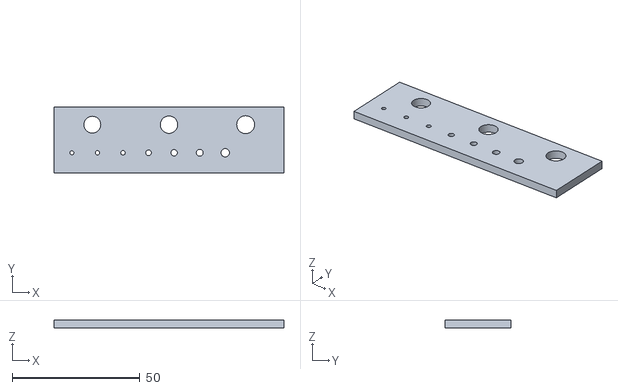
[picture p58: CAD file, 2026-10-20]
mechanical/full-hub/fit-coupon.stl
90.0 x 26.0 x 3.00
