ha-homelab/ha-radio-hub/mechanical/generated/lid.stl

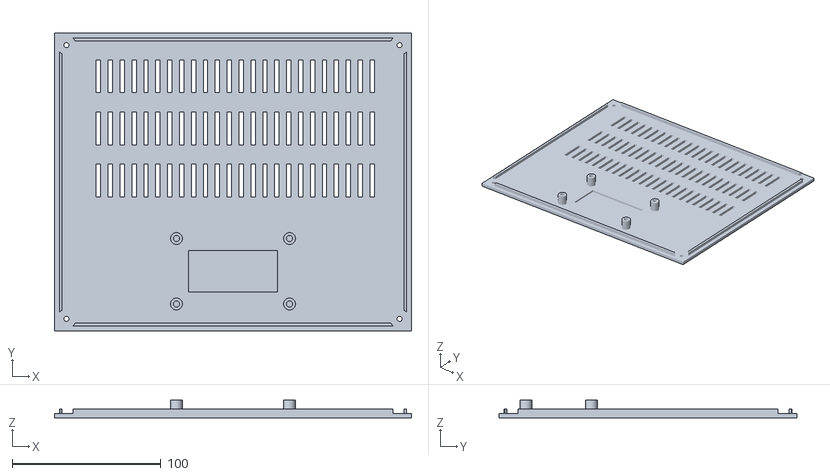
[picture p59: CAD file, 2026-10-17]
mechanical/generated/lid.stl
240.0 x 200.0 x 12.0
