ha-homelab/ha-radio-hub/mechanical/low-power/generated/mockup_base.stl

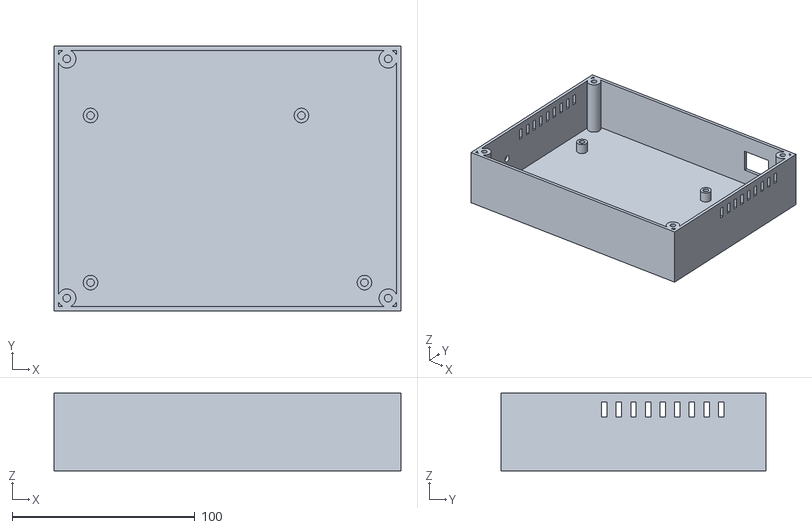
[picture p60: CAD file, 2026-10-17]
mechanical/low-power/generated/mockup_base.stl
190.0 x 145.0 x 42.6
