ha-homelab/ha-radio-hub/mechanical/module-carrier/enclosure-prototype/ceiling-spacing-frame.stl

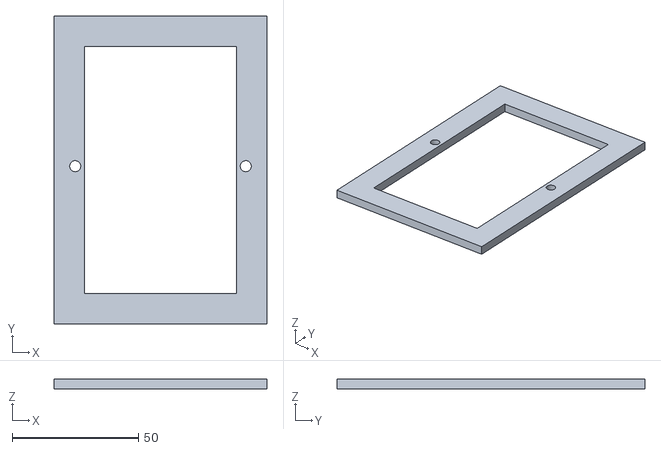
[picture p61: CAD file, 2026-10-18]
mechanical/module-carrier/enclosure-prototype/ceiling-spacing-frame.stl
84.3 x 121.8 x 4.00
