ha-homelab/ha-radio-hub/mechanical/module-carrier/external-antenna-prototype/cable-bar.stl

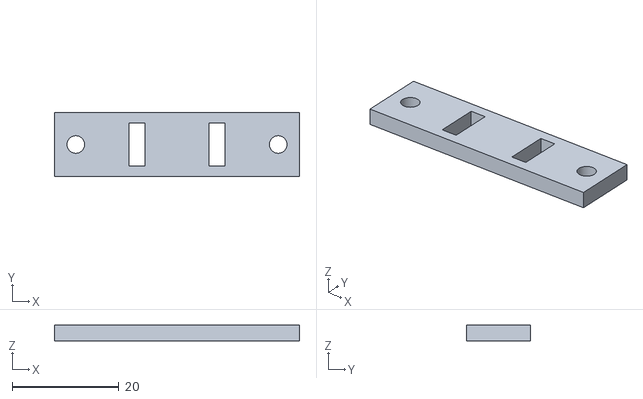
[picture p62: CAD file, 2026-10-18]
mechanical/module-carrier/external-antenna-prototype/cable-bar.stl
46.0 x 12.0 x 3.00
