ha-homelab/ha-radio-hub/mechanical/module-carrier/rail-mount/fit-gap-1p8.stl

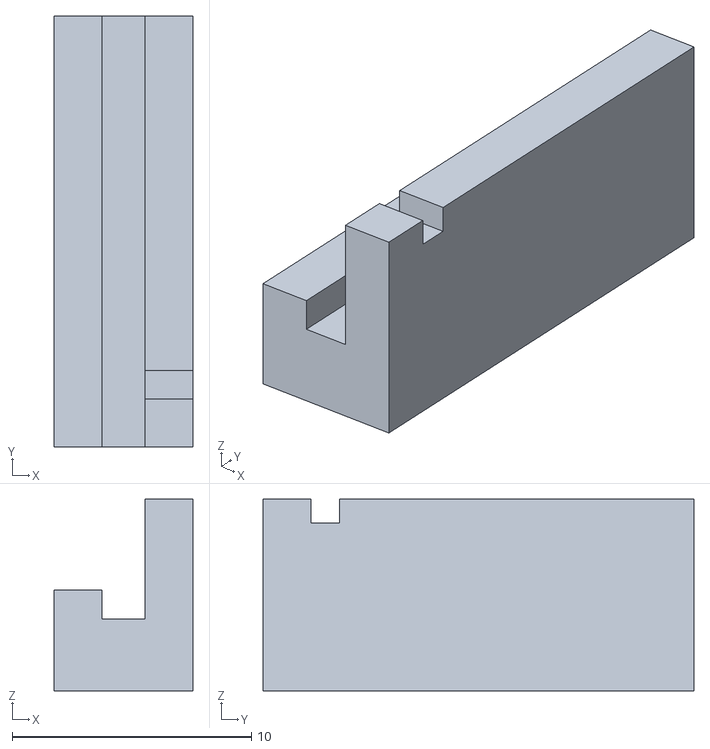
[picture p63: CAD file, 2026-10-18]
mechanical/module-carrier/rail-mount/fit-gap-1p8.stl
5.80 x 18.0 x 8.00
