ha-homelab/ha-radio-hub/mechanical/full-hub/cc1101-port-blank.stl

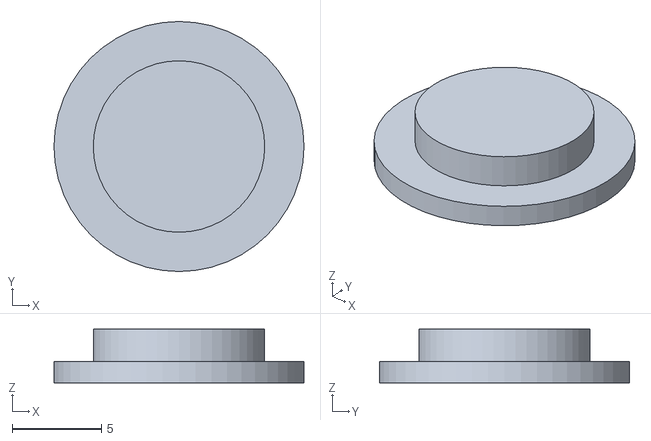
[picture p64: CAD file, 2026-10-20]
mechanical/full-hub/cc1101-port-blank.stl
14.0 x 14.0 x 3.00
