ha-homelab/ha-radio-hub/mechanical/generated/bme680_pod_base.stl

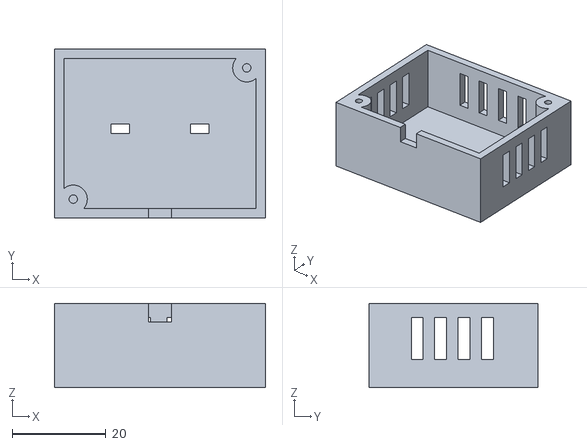
[picture p65: CAD file, 2026-10-17]
mechanical/generated/bme680_pod_base.stl
45.0 x 36.0 x 18.0
