ha-homelab/ha-radio-hub/mechanical/low-power/generated/radar_holder.stl

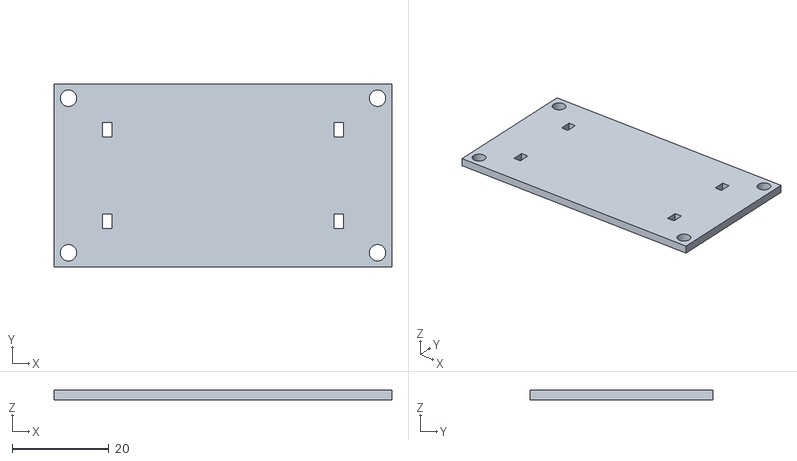
[picture p66: CAD file, 2026-10-17]
mechanical/low-power/generated/radar_holder.stl
70.0 x 38.0 x 2.00
