ha-homelab/ha-radio-hub/mechanical/module-carrier/enclosure-prototype/cover.stl

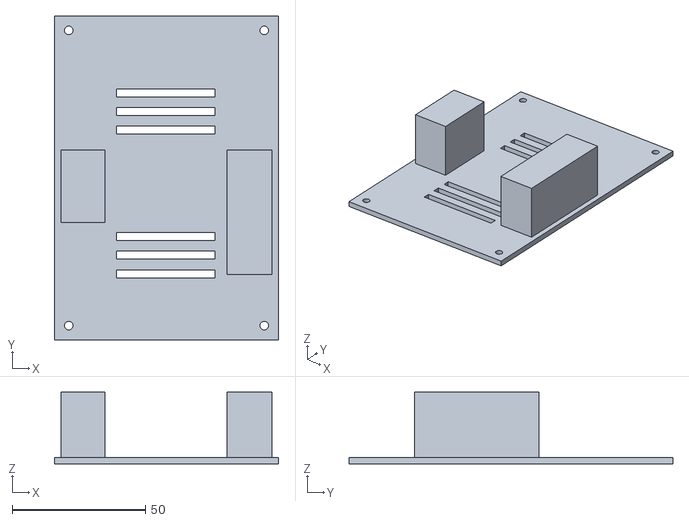
[picture p67: CAD file, 2026-10-18]
mechanical/module-carrier/enclosure-prototype/cover.stl
84.3 x 121.8 x 27.0
