ha-homelab/ha-radio-hub/mechanical/module-carrier/external-antenna-prototype/cover.stl

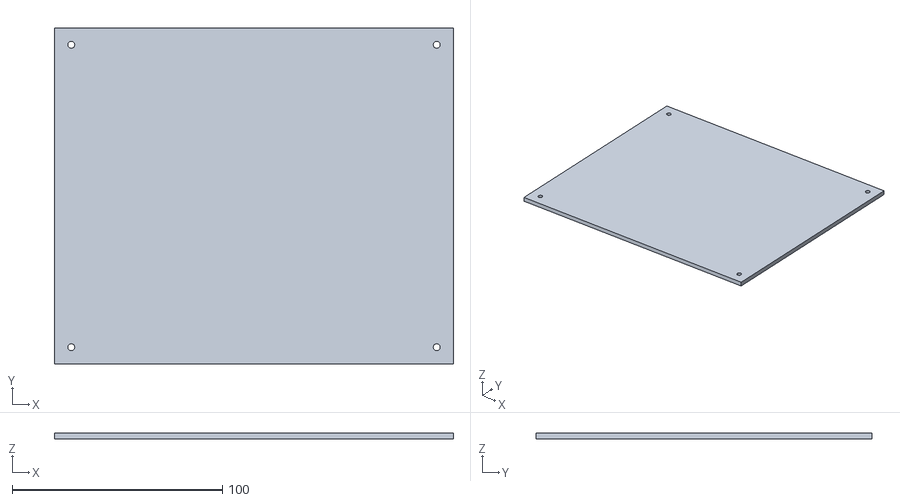
[picture p68: CAD file, 2026-10-18]
mechanical/module-carrier/external-antenna-prototype/cover.stl
190.0 x 160.0 x 3.00
