ha-homelab/ha-radio-hub/mechanical/full-hub/zwave-tray.stl

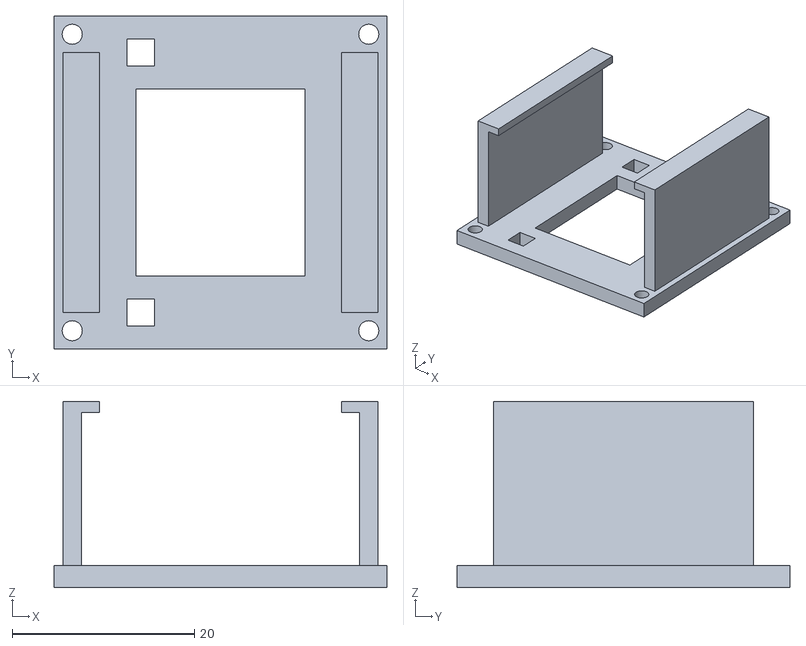
[picture p69: CAD file, 2026-10-20]
mechanical/full-hub/zwave-tray.stl
36.5 x 36.5 x 20.4
