ha-homelab/ha-radio-hub/mechanical/generated/antenna_blank.stl

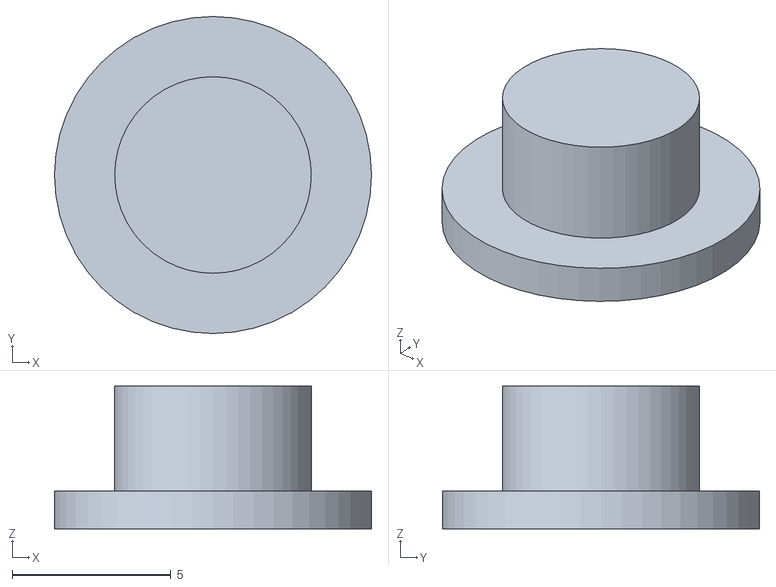
[picture p70: CAD file, 2026-10-17]
mechanical/generated/antenna_blank.stl
10.0 x 10.0 x 4.50
