ha-homelab/ha-radio-hub/mechanical/low-power/generated/fit_coupon.stl

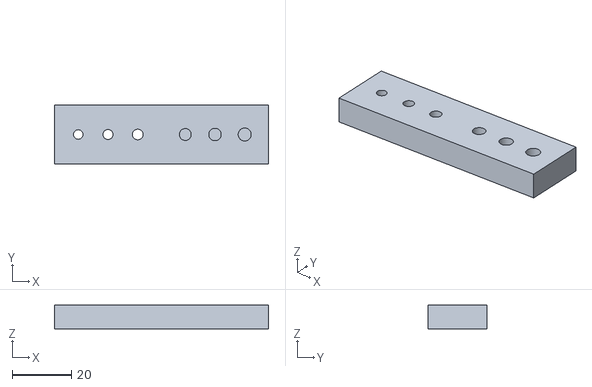
[picture p71: CAD file, 2026-10-17]
mechanical/low-power/generated/fit_coupon.stl
72.0 x 20.0 x 8.00
