ha-homelab/ha-radio-hub/mechanical/module-carrier/external-antenna-prototype/ceiling-spacing-frame.stl

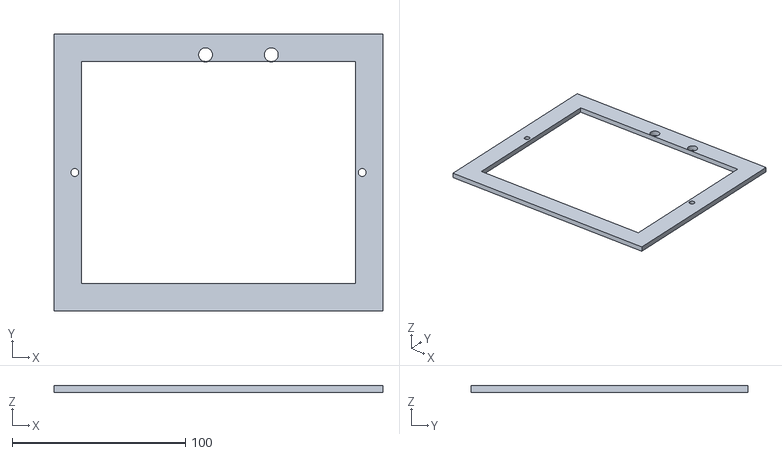
[picture p72: CAD file, 2026-10-18]
mechanical/module-carrier/external-antenna-prototype/ceiling-spacing-frame.stl
190.0 x 160.0 x 4.00
