ha-homelab/ha-radio-hub/mechanical/full-hub/bme680-pod-lid.stl

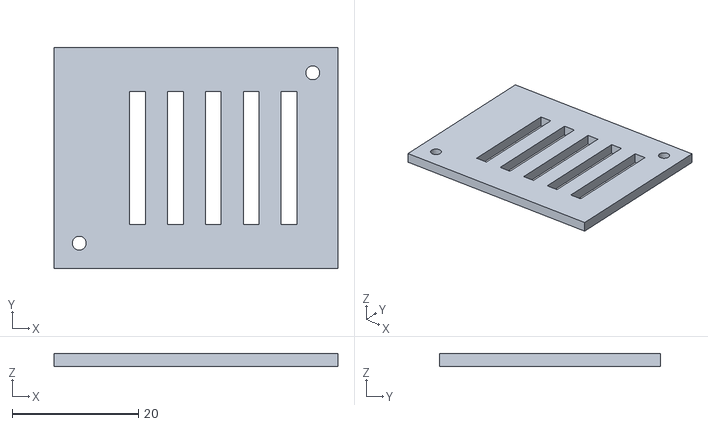
[picture p73: CAD file, 2026-10-20]
mechanical/full-hub/bme680-pod-lid.stl
45.0 x 35.0 x 2.00
