ha-homelab/ha-radio-hub/mechanical/generated/radar_carrier.stl

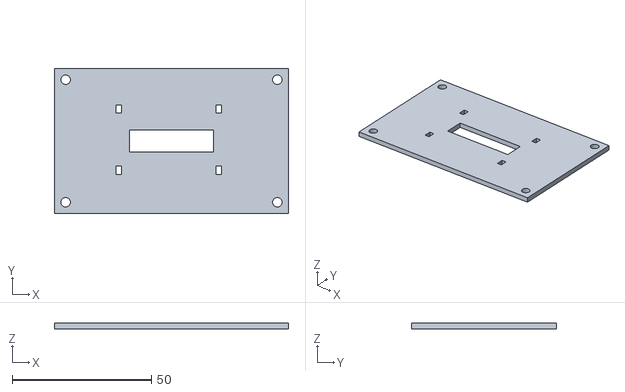
[picture p74: CAD file, 2026-10-17]
mechanical/generated/radar_carrier.stl
84.0 x 52.0 x 2.00
