ha-homelab/ha-radio-hub/mechanical/full-hub/cc1101-tray.stl

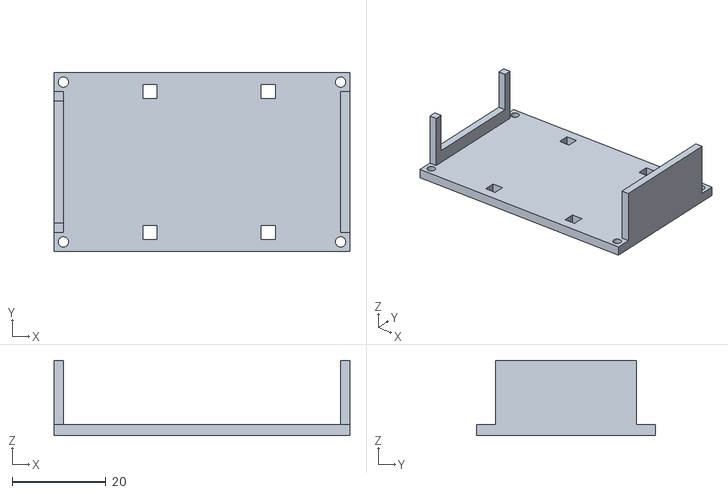
[picture p75: CAD file, 2026-10-20]
mechanical/full-hub/cc1101-tray.stl
63.0 x 38.0 x 16.0
