ha-homelab/ha-radio-hub/mechanical/generated/bme680_pod_lid.stl

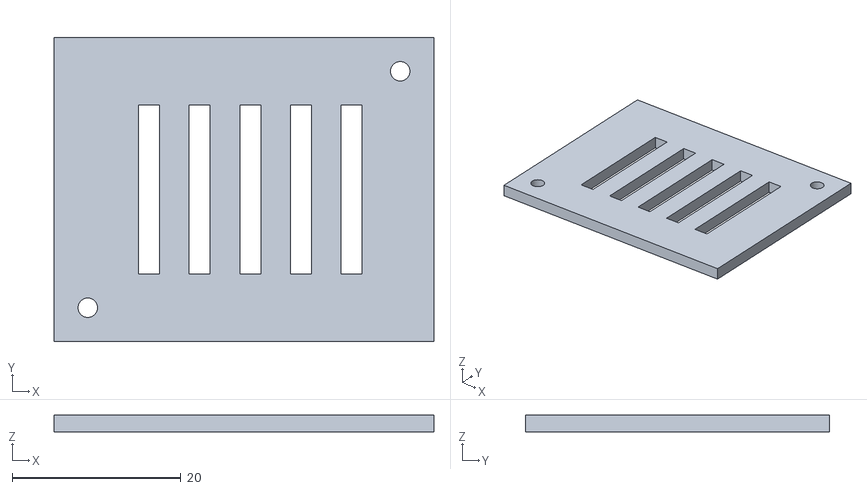
[picture p76: CAD file, 2026-10-17]
mechanical/generated/bme680_pod_lid.stl
45.0 x 36.0 x 2.00
