ha-homelab/ha-radio-hub/mechanical/full-hub/wk2132-tray.stl

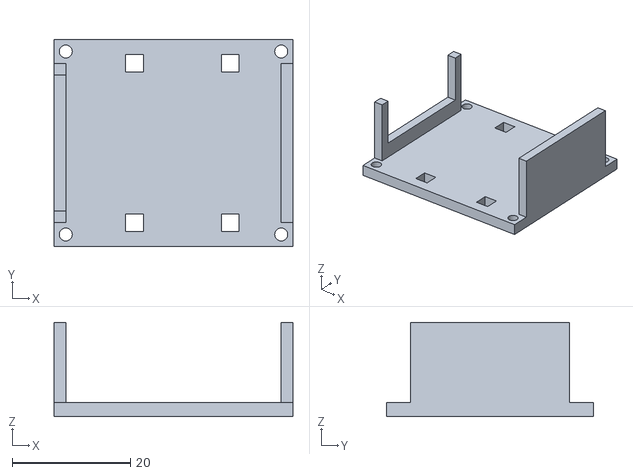
[picture p77: CAD file, 2026-10-20]
mechanical/full-hub/wk2132-tray.stl
40.5 x 35.0 x 16.0
