ha-homelab/ha-radio-hub/mechanical/full-hub/poe-splitter-tray.stl

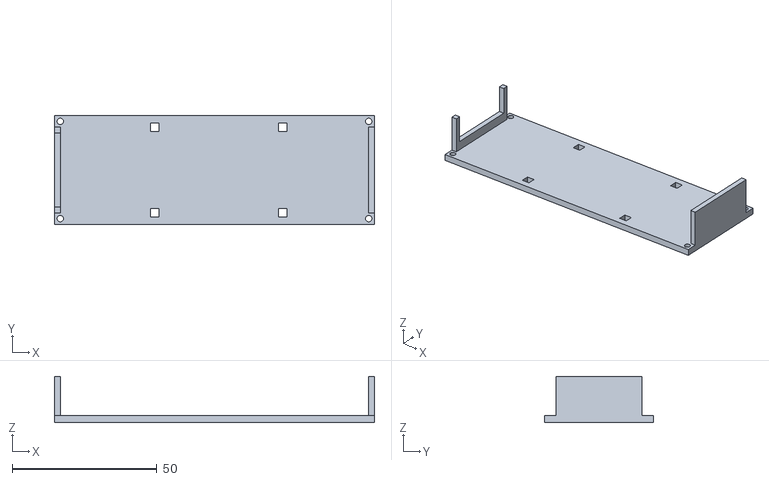
[picture p78: CAD file, 2026-10-20]
mechanical/full-hub/poe-splitter-tray.stl
110.5 x 37.6 x 16.0
