ha-homelab/ha-radio-hub/mechanical/full-hub/lid.stl

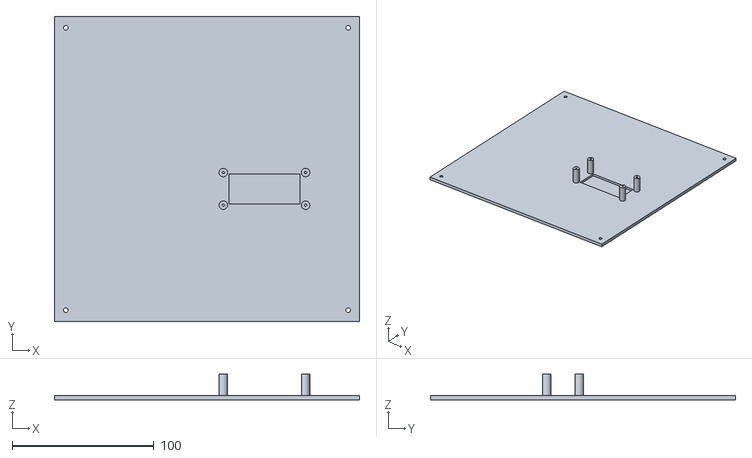
[picture p79: CAD file, 2026-10-20]
mechanical/full-hub/lid.stl
215.0 x 215.0 x 18.1
