ha-homelab/ha-radio-hub/mechanical/full-hub/bme680-pod.stl

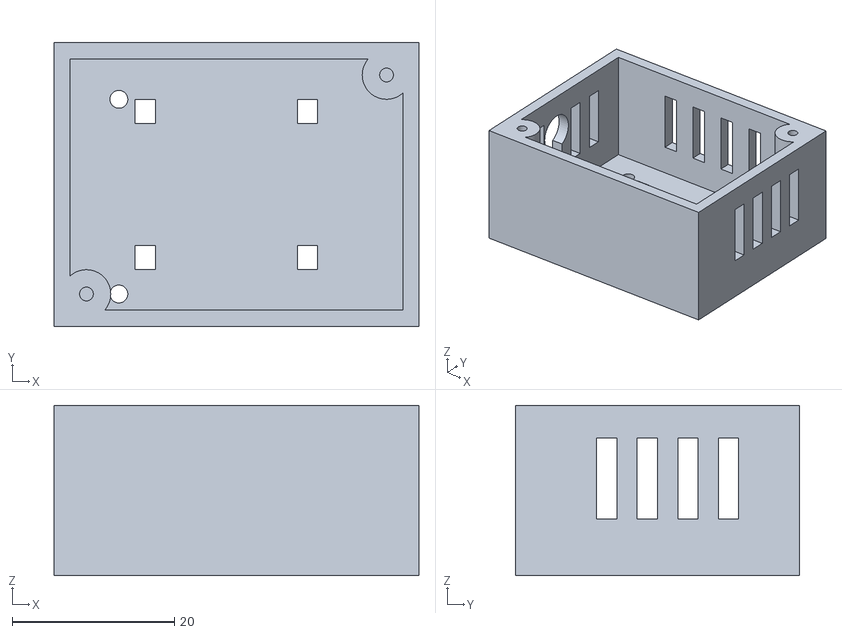
[picture p80: CAD file, 2026-10-20]
mechanical/full-hub/bme680-pod.stl
45.0 x 35.0 x 21.0
