ha-homelab/ha-radio-hub/mechanical/full-hub/pod-arm.stl

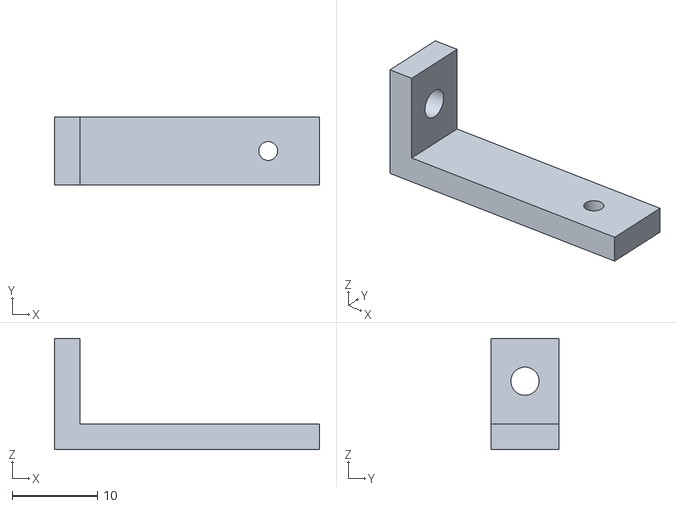
[picture p81: CAD file, 2026-10-20]
mechanical/full-hub/pod-arm.stl
31.0 x 8.00 x 13.0
