ha-homelab/ha-radio-hub/mechanical/full-hub/radar-holder.stl

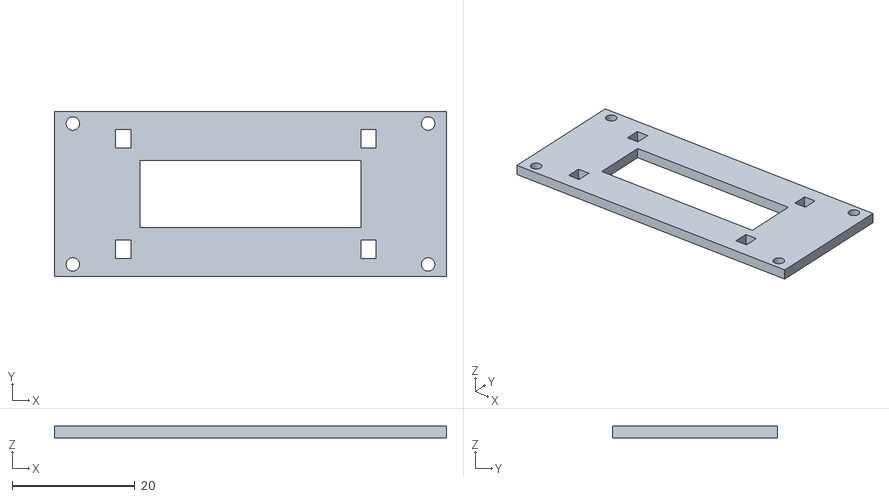
[picture p82: CAD file, 2026-10-20]
mechanical/full-hub/radar-holder.stl
64.0 x 27.0 x 2.00
