ha-homelab/ha-radio-hub/mechanical/full-hub/power-utility-tray.stl

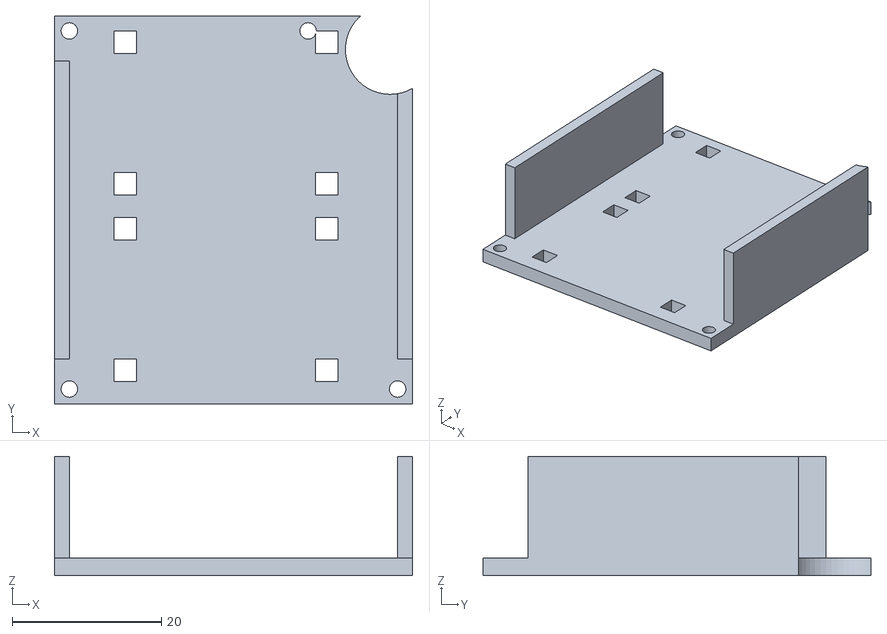
[picture p83: CAD file, 2026-10-20]
mechanical/full-hub/power-utility-tray.stl
48.0 x 52.0 x 16.0
