ha-homelab/ha-radio-hub/mechanical/full-hub/assembly.scad

// Review assembly only. Do not print as one object.
color("LightSteelBlue") {translate([22, 173.6, 6]) { rotate([0, 0, 0]) { difference() {
union() {
cube([110.5,37.6,2.4]);
translate([0, 4, 0]) { cube([2,29.6,16]); }
translate([108.5, 4, 0]) { cube([2,29.6,16]); }
}
translate([2, 2, -0.1]) { cylinder(d=2.2,h=2.6,$fn=48); }
translate([108.5, 2, -0.1]) { cylinder(d=2.2,h=2.6,$fn=48); }
translate([2, 35.6, -0.1]) { cylinder(d=2.2,h=2.6,$fn=48); }
translate([108.5, 35.6, -0.1]) { cylinder(d=2.2,h=2.6,$fn=48); }
translate([33.15, 2.5, -0.1]) { cube([3,3,2.6]); }
translate([33.15, 32.1, -0.1]) { cube([3,3,2.6]); }
translate([77.35, 2.5, -0.1]) { cube([3,3,2.6]); }
translate([77.35, 32.1, -0.1]) { cube([3,3,2.6]); }
translate([-0.1, 6, 5.8]) { cube([4.2,25.6,20]); }
} } }}
color("LightSteelBlue") {translate([177, 126, 6]) { rotate([0, 0, 0]) { difference() {
union() {
union() {
cube([32,32,2.4]);
translate([4, 4, 0]) { cube([2,24,6]); }
translate([26, 4, 0]) { cube([2,24,6]); }
translate([1, 4, 0]) { cube([2,24,9]); }
translate([29, 4, 0]) { cube([2,24,9]); }
translate([4, 2, 0]) { cube([24,1,7]); }
translate([4, 29, 0]) { cube([24,1,7]); }
}
translate([12.5, 29, 0]) { cube([7,3,8]); }
}
translate([2, 2, -0.1]) { cylinder(d=2.2,h=2.6,$fn=48); }
translate([30, 2, -0.1]) { cylinder(d=2.2,h=2.6,$fn=48); }
translate([2, 30, -0.1]) { cylinder(d=2.2,h=2.6,$fn=48); }
translate([30, 30, -0.1]) { cylinder(d=2.2,h=2.6,$fn=48); }
translate([2, 24.5, -0.1]) { cube([2,2.5,12]); }
translate([28, 24.5, -0.1]) { cube([2,2.5,12]); }
translate([12.4, 30.5, 5]) { rotate([0, 90, 0]) { cylinder(d=2.5,h=7.2,$fn=48); } }
} } }}
color("LightSteelBlue") {translate([128, 122, 6]) { rotate([0, 0, 0]) { difference() {
union() {
cube([40.5,35,2.4]);
translate([0, 4, 0]) { cube([2,27,16]); }
translate([38.5, 4, 0]) { cube([2,27,16]); }
}
translate([2, 2, -0.1]) { cylinder(d=2.2,h=2.6,$fn=48); }
translate([38.5, 2, -0.1]) { cylinder(d=2.2,h=2.6,$fn=48); }
translate([2, 33, -0.1]) { cylinder(d=2.2,h=2.6,$fn=48); }
translate([38.5, 33, -0.1]) { cylinder(d=2.2,h=2.6,$fn=48); }
translate([12.15, 2.5, -0.1]) { cube([3,3,2.6]); }
translate([12.15, 29.5, -0.1]) { cube([3,3,2.6]); }
translate([28.349999999999998, 2.5, -0.1]) { cube([3,3,2.6]); }
translate([28.349999999999998, 29.5, -0.1]) { cube([3,3,2.6]); }
translate([-0.1, 6, 5.8]) { cube([4.2,23,20]); }
} } }}
color("LightSteelBlue") {translate([138, 83, 6]) { rotate([0, 0, 0]) { difference() {
union() {
cube([36.5,36.5,2.4]);
translate([1, 4, 0]) { cube([2,28.5,20.4]); }
translate([33.5, 4, 0]) { cube([2,28.5,20.4]); }
translate([1, 4, 19.2]) { cube([4,28.5,1.2]); }
translate([31.5, 4, 19.2]) { cube([4,28.5,1.2]); }
}
translate([2, 2, -0.1]) { cylinder(d=2.2,h=2.6,$fn=48); }
translate([34.5, 2, -0.1]) { cylinder(d=2.2,h=2.6,$fn=48); }
translate([2, 34.5, -0.1]) { cylinder(d=2.2,h=2.6,$fn=48); }
translate([34.5, 34.5, -0.1]) { cylinder(d=2.2,h=2.6,$fn=48); }
translate([8, 2.5, -0.1]) { cube([3,3,2.6]); }
translate([8, 31.0, -0.1]) { cube([3,3,2.6]); }
translate([9, 8, -0.1]) { cube([18.5,20.5,2.6]); }
} } }}
color("LightSteelBlue") {translate([138, 37, 6]) { rotate([0, 0, 0]) { difference() {
union() {
cube([63,38,2.4]);
translate([0, 4, 0]) { cube([2,30,16]); }
translate([61, 4, 0]) { cube([2,30,16]); }
}
translate([2, 2, -0.1]) { cylinder(d=2.2,h=2.6,$fn=48); }
translate([61, 2, -0.1]) { cylinder(d=2.2,h=2.6,$fn=48); }
translate([2, 36, -0.1]) { cylinder(d=2.2,h=2.6,$fn=48); }
translate([61, 36, -0.1]) { cylinder(d=2.2,h=2.6,$fn=48); }
translate([18.9, 2.5, -0.1]) { cube([3,3,2.6]); }
translate([18.9, 32.5, -0.1]) { cube([3,3,2.6]); }
translate([44.099999999999994, 2.5, -0.1]) { cube([3,3,2.6]); }
translate([44.099999999999994, 32.5, -0.1]) { cube([3,3,2.6]); }
translate([-0.1, 6, 5.8]) { cube([4.2,26,20]); }
} } }}
color("LightSteelBlue") {translate([162, 159.5, 6]) { rotate([0, 0, 0]) { difference() {
union() {
difference() {
difference() {
difference() {
difference() {
difference() {
difference() {
difference() {
difference() {
difference() {
difference() {
difference() {
difference() {
cube([48,52,2.4]);
translate([2, 2, -0.1]) { cylinder(d=2.2,h=2.6,$fn=48); }
}
translate([46, 2, -0.1]) { cylinder(d=2.2,h=2.6,$fn=48); }
}
translate([2, 50, -0.1]) { cylinder(d=2.2,h=2.6,$fn=48); }
}
translate([34, 50, -0.1]) { cylinder(d=2.2,h=2.6,$fn=48); }
}
translate([8, 3, -0.1]) { cube([3,3,2.6]); }
}
translate([8, 22, -0.1]) { cube([3,3,2.6]); }
}
translate([8, 28, -0.1]) { cube([3,3,2.6]); }
}
translate([8, 47, -0.1]) { cube([3,3,2.6]); }
}
translate([35, 3, -0.1]) { cube([3,3,2.6]); }
}
translate([35, 22, -0.1]) { cube([3,3,2.6]); }
}
translate([35, 28, -0.1]) { cube([3,3,2.6]); }
}
translate([35, 47, -0.1]) { cube([3,3,2.6]); }
}
translate([0, 6, 0]) { cube([2,40,16]); }
translate([46, 6, 0]) { cube([2,40,16]); }
}
translate([45, 47.5, -0.1]) { cylinder(d=12,h=25,$fn=48); }
} } }}
color("LightSteelBlue") {translate([0, 0, 0]) { rotate([0, 0, 0]) { difference() {
union() {
union() {
union() {
union() {
union() {
union() {
union() {
union() {
union() {
union() {
union() {
union() {
union() {
union() {
union() {
union() {
difference() {
cube([215,215,75]);
translate([3, 3, 3]) { cube([209,209,75]); }
}
translate([8, 8, 0]) { cylinder(d=11,h=75,$fn=48); }
translate([207, 8, 0]) { cylinder(d=11,h=75,$fn=48); }
translate([8, 207, 0]) { cylinder(d=11,h=75,$fn=48); }
translate([207, 207, 0]) { cylinder(d=11,h=75,$fn=48); }
}
translate([110.0, 130.0, 0]) { cylinder(d=7,h=15,$fn=48); }
translate([110.0, 38.0, 0]) { cylinder(d=7,h=15,$fn=48); }
translate([18.0, 130.0, 0]) { cylinder(d=7,h=15,$fn=48); }
translate([18.0, 38.0, 0]) { cylinder(d=7,h=15,$fn=48); }
}
translate([24, 175.6, 0]) { cylinder(d=5,h=6,$fn=48); }
translate([130.5, 175.6, 0]) { cylinder(d=5,h=6,$fn=48); }
translate([24, 209.2, 0]) { cylinder(d=5,h=6,$fn=48); }
translate([130.5, 209.2, 0]) { cylinder(d=5,h=6,$fn=48); }
}
translate([179, 128, 0]) { cylinder(d=5,h=6,$fn=48); }
translate([207, 128, 0]) { cylinder(d=5,h=6,$fn=48); }
translate([179, 156, 0]) { cylinder(d=5,h=6,$fn=48); }
translate([207, 156, 0]) { cylinder(d=5,h=6,$fn=48); }
}
translate([130, 124, 0]) { cylinder(d=5,h=6,$fn=48); }
translate([166.5, 124, 0]) { cylinder(d=5,h=6,$fn=48); }
translate([130, 155, 0]) { cylinder(d=5,h=6,$fn=48); }
translate([166.5, 155, 0]) { cylinder(d=5,h=6,$fn=48); }
}
translate([140, 85, 0]) { cylinder(d=5,h=6,$fn=48); }
translate([172.5, 85, 0]) { cylinder(d=5,h=6,$fn=48); }
translate([140, 117.5, 0]) { cylinder(d=5,h=6,$fn=48); }
translate([172.5, 117.5, 0]) { cylinder(d=5,h=6,$fn=48); }
}
translate([140, 39, 0]) { cylinder(d=5,h=6,$fn=48); }
translate([199, 39, 0]) { cylinder(d=5,h=6,$fn=48); }
translate([140, 73, 0]) { cylinder(d=5,h=6,$fn=48); }
translate([199, 73, 0]) { cylinder(d=5,h=6,$fn=48); }
}
translate([164, 161.5, 0]) { cylinder(d=5,h=6,$fn=48); }
translate([208, 161.5, 0]) { cylinder(d=5,h=6,$fn=48); }
translate([164, 209.5, 0]) { cylinder(d=5,h=6,$fn=48); }
translate([196, 209.5, 0]) { cylinder(d=5,h=6,$fn=48); }
}
difference() {
translate([29, 23, 2.9]) { cube([12,6,33.1]); }
translate([31, 22.9, 32]) { cube([8,6.2,2]); }
}
}
difference() {
translate([94, 23, 2.9]) { cube([12,6,33.1]); }
translate([96, 22.9, 32]) { cube([8,6.2,2]); }
}
}
difference() {
translate([159, 23, 2.9]) { cube([12,6,33.1]); }
translate([161, 22.9, 32]) { cube([8,6.2,2]); }
}
}
difference() {
translate([117, 64, 0]) { cube([8,6,7]); }
translate([119, 63.9, 4]) { cube([4,6.2,2]); }
}
}
difference() {
translate([117, 108, 0]) { cube([8,6,7]); }
translate([119, 107.9, 4]) { cube([4,6.2,2]); }
}
}
difference() {
translate([119, 148, 0]) { cube([8,6,7]); }
translate([121, 147.9, 4]) { cube([4,6.2,2]); }
}
}
difference() {
translate([144, 191, 0]) { cube([8,6,7]); }
translate([146, 190.9, 4]) { cube([4,6.2,2]); }
}
}
difference() {
translate([14, 160, 0]) { cube([8,6,7]); }
translate([16, 159.9, 4]) { cube([4,6.2,2]); }
}
}
translate([8, 8, 64]) { cylinder(d=2.5,h=12,$fn=48); }
translate([207, 8, 64]) { cylinder(d=2.5,h=12,$fn=48); }
translate([8, 207, 64]) { cylinder(d=2.5,h=12,$fn=48); }
translate([207, 207, 64]) { cylinder(d=2.5,h=12,$fn=48); }
translate([110.0, 130.0, -0.1]) { cylinder(d=2.7,h=15.2,$fn=48); }
translate([110.0, 38.0, -0.1]) { cylinder(d=2.7,h=15.2,$fn=48); }
translate([18.0, 130.0, -0.1]) { cylinder(d=2.7,h=15.2,$fn=48); }
translate([18.0, 38.0, -0.1]) { cylinder(d=2.7,h=15.2,$fn=48); }
translate([110.0, 130.0, -0.1]) { cylinder(d=5.8,h=2.4,$fn=6); }
translate([110.0, 38.0, -0.1]) { cylinder(d=5.8,h=2.4,$fn=6); }
translate([18.0, 130.0, -0.1]) { cylinder(d=5.8,h=2.4,$fn=6); }
translate([18.0, 38.0, -0.1]) { cylinder(d=5.8,h=2.4,$fn=6); }
translate([24, 175.6, 1]) { cylinder(d=1.7,h=5.2,$fn=48); }
translate([130.5, 175.6, 1]) { cylinder(d=1.7,h=5.2,$fn=48); }
translate([24, 209.2, 1]) { cylinder(d=1.7,h=5.2,$fn=48); }
translate([130.5, 209.2, 1]) { cylinder(d=1.7,h=5.2,$fn=48); }
translate([179, 128, 1]) { cylinder(d=1.7,h=5.2,$fn=48); }
translate([207, 128, 1]) { cylinder(d=1.7,h=5.2,$fn=48); }
translate([179, 156, 1]) { cylinder(d=1.7,h=5.2,$fn=48); }
translate([207, 156, 1]) { cylinder(d=1.7,h=5.2,$fn=48); }
translate([130, 124, 1]) { cylinder(d=1.7,h=5.2,$fn=48); }
translate([166.5, 124, 1]) { cylinder(d=1.7,h=5.2,$fn=48); }
translate([130, 155, 1]) { cylinder(d=1.7,h=5.2,$fn=48); }
translate([166.5, 155, 1]) { cylinder(d=1.7,h=5.2,$fn=48); }
translate([140, 85, 1]) { cylinder(d=1.7,h=5.2,$fn=48); }
translate([172.5, 85, 1]) { cylinder(d=1.7,h=5.2,$fn=48); }
translate([140, 117.5, 1]) { cylinder(d=1.7,h=5.2,$fn=48); }
translate([172.5, 117.5, 1]) { cylinder(d=1.7,h=5.2,$fn=48); }
translate([140, 39, 1]) { cylinder(d=1.7,h=5.2,$fn=48); }
translate([199, 39, 1]) { cylinder(d=1.7,h=5.2,$fn=48); }
translate([140, 73, 1]) { cylinder(d=1.7,h=5.2,$fn=48); }
translate([199, 73, 1]) { cylinder(d=1.7,h=5.2,$fn=48); }
translate([164, 161.5, 1]) { cylinder(d=1.7,h=5.2,$fn=48); }
translate([208, 161.5, 1]) { cylinder(d=1.7,h=5.2,$fn=48); }
translate([164, 209.5, 1]) { cylinder(d=1.7,h=5.2,$fn=48); }
translate([196, 209.5, 1]) { cylinder(d=1.7,h=5.2,$fn=48); }
translate([35, 3.1, 38]) { rotate([90, 0, 0]) { cylinder(d=6.8,h=3.2,$fn=48); } }
union() {
translate([29.475, -0.1, 29.9]) { cube([0.66,0.7,0.66]); }
translate([30.125, -0.1, 29.9]) { cube([0.66,0.7,0.66]); }
translate([30.775000000000002, -0.1, 29.9]) { cube([0.66,0.7,0.66]); }
translate([31.425, -0.1, 29.9]) { cube([0.66,0.7,0.66]); }
translate([29.475, -0.1, 29.25]) { cube([0.66,0.7,0.66]); }
translate([32.075, -0.1, 29.25]) { cube([0.66,0.7,0.66]); }
translate([29.475, -0.1, 28.6]) { cube([0.66,0.7,0.66]); }
translate([32.075, -0.1, 28.6]) { cube([0.66,0.7,0.66]); }
translate([29.475, -0.1, 27.95]) { cube([0.66,0.7,0.66]); }
translate([30.125, -0.1, 27.95]) { cube([0.66,0.7,0.66]); }
translate([30.775000000000002, -0.1, 27.95]) { cube([0.66,0.7,0.66]); }
translate([31.425, -0.1, 27.95]) { cube([0.66,0.7,0.66]); }
translate([29.475, -0.1, 27.3]) { cube([0.66,0.7,0.66]); }
translate([32.075, -0.1, 27.3]) { cube([0.66,0.7,0.66]); }
translate([29.475, -0.1, 26.65]) { cube([0.66,0.7,0.66]); }
translate([32.075, -0.1, 26.65]) { cube([0.66,0.7,0.66]); }
translate([29.475, -0.1, 26.0]) { cube([0.66,0.7,0.66]); }
translate([30.125, -0.1, 26.0]) { cube([0.66,0.7,0.66]); }
translate([30.775000000000002, -0.1, 26.0]) { cube([0.66,0.7,0.66]); }
translate([31.425, -0.1, 26.0]) { cube([0.66,0.7,0.66]); }
translate([33.375, -0.1, 29.9]) { cube([0.66,0.7,0.66]); }
translate([33.375, -0.1, 29.25]) { cube([0.66,0.7,0.66]); }
translate([33.375, -0.1, 28.6]) { cube([0.66,0.7,0.66]); }
translate([33.375, -0.1, 27.95]) { cube([0.66,0.7,0.66]); }
translate([33.375, -0.1, 27.3]) { cube([0.66,0.7,0.66]); }
translate([33.375, -0.1, 26.65]) { cube([0.66,0.7,0.66]); }
translate([33.375, -0.1, 26.0]) { cube([0.66,0.7,0.66]); }
translate([34.025, -0.1, 26.0]) { cube([0.66,0.7,0.66]); }
translate([34.675, -0.1, 26.0]) { cube([0.66,0.7,0.66]); }
translate([35.325, -0.1, 26.0]) { cube([0.66,0.7,0.66]); }
translate([35.975, -0.1, 26.0]) { cube([0.66,0.7,0.66]); }
translate([37.275, -0.1, 29.9]) { cube([0.66,0.7,0.66]); }
translate([37.925, -0.1, 29.9]) { cube([0.66,0.7,0.66]); }
translate([38.574999999999996, -0.1, 29.9]) { cube([0.66,0.7,0.66]); }
translate([39.225, -0.1, 29.9]) { cube([0.66,0.7,0.66]); }
translate([39.875, -0.1, 29.9]) { cube([0.66,0.7,0.66]); }
translate([37.275, -0.1, 29.25]) { cube([0.66,0.7,0.66]); }
translate([37.275, -0.1, 28.6]) { cube([0.66,0.7,0.66]); }
translate([37.275, -0.1, 27.95]) { cube([0.66,0.7,0.66]); }
translate([37.925, -0.1, 27.95]) { cube([0.66,0.7,0.66]); }
translate([38.574999999999996, -0.1, 27.95]) { cube([0.66,0.7,0.66]); }
translate([39.225, -0.1, 27.95]) { cube([0.66,0.7,0.66]); }
translate([37.275, -0.1, 27.3]) { cube([0.66,0.7,0.66]); }
translate([37.275, -0.1, 26.65]) { cube([0.66,0.7,0.66]); }
translate([37.275, -0.1, 26.0]) { cube([0.66,0.7,0.66]); }
translate([37.925, -0.1, 26.0]) { cube([0.66,0.7,0.66]); }
translate([38.574999999999996, -0.1, 26.0]) { cube([0.66,0.7,0.66]); }
translate([39.225, -0.1, 26.0]) { cube([0.66,0.7,0.66]); }
translate([39.875, -0.1, 26.0]) { cube([0.66,0.7,0.66]); }
}
translate([100, 3.1, 38]) { rotate([90, 0, 0]) { cylinder(d=6.8,h=3.2,$fn=48); } }
union() {
translate([88.625, -0.1, 29.9]) { cube([0.66,0.7,0.66]); }
translate([89.275, -0.1, 29.9]) { cube([0.66,0.7,0.66]); }
translate([89.925, -0.1, 29.9]) { cube([0.66,0.7,0.66]); }
translate([90.575, -0.1, 29.9]) { cube([0.66,0.7,0.66]); }
translate([91.225, -0.1, 29.9]) { cube([0.66,0.7,0.66]); }
translate([89.925, -0.1, 29.25]) { cube([0.66,0.7,0.66]); }
translate([89.925, -0.1, 28.6]) { cube([0.66,0.7,0.66]); }
translate([89.925, -0.1, 27.95]) { cube([0.66,0.7,0.66]); }
translate([89.925, -0.1, 27.3]) { cube([0.66,0.7,0.66]); }
translate([89.925, -0.1, 26.65]) { cube([0.66,0.7,0.66]); }
translate([89.925, -0.1, 26.0]) { cube([0.66,0.7,0.66]); }
translate([92.525, -0.1, 29.9]) { cube([0.66,0.7,0.66]); }
translate([95.125, -0.1, 29.9]) { cube([0.66,0.7,0.66]); }
translate([92.525, -0.1, 29.25]) { cube([0.66,0.7,0.66]); }
translate([95.125, -0.1, 29.25]) { cube([0.66,0.7,0.66]); }
translate([92.525, -0.1, 28.6]) { cube([0.66,0.7,0.66]); }
translate([95.125, -0.1, 28.6]) { cube([0.66,0.7,0.66]); }
translate([92.525, -0.1, 27.95]) { cube([0.66,0.7,0.66]); }
translate([93.17500000000001, -0.1, 27.95]) { cube([0.66,0.7,0.66]); }
translate([93.825, -0.1, 27.95]) { cube([0.66,0.7,0.66]); }
translate([94.47500000000001, -0.1, 27.95]) { cube([0.66,0.7,0.66]); }
translate([95.125, -0.1, 27.95]) { cube([0.66,0.7,0.66]); }
translate([92.525, -0.1, 27.3]) { cube([0.66,0.7,0.66]); }
translate([95.125, -0.1, 27.3]) { cube([0.66,0.7,0.66]); }
translate([92.525, -0.1, 26.65]) { cube([0.66,0.7,0.66]); }
translate([95.125, -0.1, 26.65]) { cube([0.66,0.7,0.66]); }
translate([92.525, -0.1, 26.0]) { cube([0.66,0.7,0.66]); }
translate([95.125, -0.1, 26.0]) { cube([0.66,0.7,0.66]); }
translate([96.42500000000001, -0.1, 29.9]) { cube([0.66,0.7,0.66]); }
translate([97.07500000000002, -0.1, 29.9]) { cube([0.66,0.7,0.66]); }
translate([97.72500000000001, -0.1, 29.9]) { cube([0.66,0.7,0.66]); }
translate([98.37500000000001, -0.1, 29.9]) { cube([0.66,0.7,0.66]); }
translate([96.42500000000001, -0.1, 29.25]) { cube([0.66,0.7,0.66]); }
translate([99.025, -0.1, 29.25]) { cube([0.66,0.7,0.66]); }
translate([96.42500000000001, -0.1, 28.6]) { cube([0.66,0.7,0.66]); }
translate([99.025, -0.1, 28.6]) { cube([0.66,0.7,0.66]); }
translate([96.42500000000001, -0.1, 27.95]) { cube([0.66,0.7,0.66]); }
translate([97.07500000000002, -0.1, 27.95]) { cube([0.66,0.7,0.66]); }
translate([97.72500000000001, -0.1, 27.95]) { cube([0.66,0.7,0.66]); }
translate([98.37500000000001, -0.1, 27.95]) { cube([0.66,0.7,0.66]); }
translate([96.42500000000001, -0.1, 27.3]) { cube([0.66,0.7,0.66]); }
translate([97.72500000000001, -0.1, 27.3]) { cube([0.66,0.7,0.66]); }
translate([96.42500000000001, -0.1, 26.65]) { cube([0.66,0.7,0.66]); }
translate([98.37500000000001, -0.1, 26.65]) { cube([0.66,0.7,0.66]); }
translate([96.42500000000001, -0.1, 26.0]) { cube([0.66,0.7,0.66]); }
translate([99.025, -0.1, 26.0]) { cube([0.66,0.7,0.66]); }
translate([100.32500000000002, -0.1, 29.9]) { cube([0.66,0.7,0.66]); }
translate([100.97500000000002, -0.1, 29.9]) { cube([0.66,0.7,0.66]); }
translate([101.62500000000001, -0.1, 29.9]) { cube([0.66,0.7,0.66]); }
translate([102.27500000000002, -0.1, 29.9]) { cube([0.66,0.7,0.66]); }
translate([102.92500000000001, -0.1, 29.9]) { cube([0.66,0.7,0.66]); }
translate([100.32500000000002, -0.1, 29.25]) { cube([0.66,0.7,0.66]); }
translate([100.32500000000002, -0.1, 28.6]) { cube([0.66,0.7,0.66]); }
translate([100.32500000000002, -0.1, 27.95]) { cube([0.66,0.7,0.66]); }
translate([100.97500000000002, -0.1, 27.95]) { cube([0.66,0.7,0.66]); }
translate([101.62500000000001, -0.1, 27.95]) { cube([0.66,0.7,0.66]); }
translate([102.27500000000002, -0.1, 27.95]) { cube([0.66,0.7,0.66]); }
translate([100.32500000000002, -0.1, 27.3]) { cube([0.66,0.7,0.66]); }
translate([100.32500000000002, -0.1, 26.65]) { cube([0.66,0.7,0.66]); }
translate([100.32500000000002, -0.1, 26.0]) { cube([0.66,0.7,0.66]); }
translate([100.97500000000002, -0.1, 26.0]) { cube([0.66,0.7,0.66]); }
translate([101.62500000000001, -0.1, 26.0]) { cube([0.66,0.7,0.66]); }
translate([102.27500000000002, -0.1, 26.0]) { cube([0.66,0.7,0.66]); }
translate([102.92500000000001, -0.1, 26.0]) { cube([0.66,0.7,0.66]); }
translate([104.87500000000003, -0.1, 29.9]) { cube([0.66,0.7,0.66]); }
translate([105.52500000000002, -0.1, 29.9]) { cube([0.66,0.7,0.66]); }
translate([106.17500000000003, -0.1, 29.9]) { cube([0.66,0.7,0.66]); }
translate([104.22500000000002, -0.1, 29.25]) { cube([0.66,0.7,0.66]); }
translate([106.82500000000002, -0.1, 29.25]) { cube([0.66,0.7,0.66]); }
translate([104.22500000000002, -0.1, 28.6]) { cube([0.66,0.7,0.66]); }
translate([106.82500000000002, -0.1, 28.6]) { cube([0.66,0.7,0.66]); }
translate([104.22500000000002, -0.1, 27.95]) { cube([0.66,0.7,0.66]); }
translate([104.87500000000003, -0.1, 27.95]) { cube([0.66,0.7,0.66]); }
translate([105.52500000000002, -0.1, 27.95]) { cube([0.66,0.7,0.66]); }
translate([106.17500000000003, -0.1, 27.95]) { cube([0.66,0.7,0.66]); }
translate([106.82500000000002, -0.1, 27.95]) { cube([0.66,0.7,0.66]); }
translate([104.22500000000002, -0.1, 27.3]) { cube([0.66,0.7,0.66]); }
translate([106.82500000000002, -0.1, 27.3]) { cube([0.66,0.7,0.66]); }
translate([104.22500000000002, -0.1, 26.65]) { cube([0.66,0.7,0.66]); }
translate([106.82500000000002, -0.1, 26.65]) { cube([0.66,0.7,0.66]); }
translate([104.22500000000002, -0.1, 26.0]) { cube([0.66,0.7,0.66]); }
translate([106.82500000000002, -0.1, 26.0]) { cube([0.66,0.7,0.66]); }
translate([108.12500000000003, -0.1, 29.9]) { cube([0.66,0.7,0.66]); }
translate([108.77500000000003, -0.1, 29.9]) { cube([0.66,0.7,0.66]); }
translate([109.42500000000003, -0.1, 29.9]) { cube([0.66,0.7,0.66]); }
translate([110.07500000000003, -0.1, 29.9]) { cube([0.66,0.7,0.66]); }
translate([108.12500000000003, -0.1, 29.25]) { cube([0.66,0.7,0.66]); }
translate([110.72500000000002, -0.1, 29.25]) { cube([0.66,0.7,0.66]); }
translate([108.12500000000003, -0.1, 28.6]) { cube([0.66,0.7,0.66]); }
translate([110.72500000000002, -0.1, 28.6]) { cube([0.66,0.7,0.66]); }
translate([108.12500000000003, -0.1, 27.95]) { cube([0.66,0.7,0.66]); }
translate([110.72500000000002, -0.1, 27.95]) { cube([0.66,0.7,0.66]); }
translate([108.12500000000003, -0.1, 27.3]) { cube([0.66,0.7,0.66]); }
translate([110.72500000000002, -0.1, 27.3]) { cube([0.66,0.7,0.66]); }
translate([108.12500000000003, -0.1, 26.65]) { cube([0.66,0.7,0.66]); }
translate([110.72500000000002, -0.1, 26.65]) { cube([0.66,0.7,0.66]); }
translate([108.12500000000003, -0.1, 26.0]) { cube([0.66,0.7,0.66]); }
translate([108.77500000000003, -0.1, 26.0]) { cube([0.66,0.7,0.66]); }
translate([109.42500000000003, -0.1, 26.0]) { cube([0.66,0.7,0.66]); }
translate([110.07500000000003, -0.1, 26.0]) { cube([0.66,0.7,0.66]); }
}
translate([165, 3.1, 38]) { rotate([90, 0, 0]) { cylinder(d=6.8,h=3.2,$fn=48); } }
union() {
translate([154.275, -0.1, 29.9]) { cube([0.66,0.7,0.66]); }
translate([154.925, -0.1, 29.9]) { cube([0.66,0.7,0.66]); }
translate([155.57500000000002, -0.1, 29.9]) { cube([0.66,0.7,0.66]); }
translate([156.225, -0.1, 29.9]) { cube([0.66,0.7,0.66]); }
translate([156.875, -0.1, 29.9]) { cube([0.66,0.7,0.66]); }
translate([156.875, -0.1, 29.25]) { cube([0.66,0.7,0.66]); }
translate([156.225, -0.1, 28.6]) { cube([0.66,0.7,0.66]); }
translate([155.57500000000002, -0.1, 27.95]) { cube([0.66,0.7,0.66]); }
translate([154.925, -0.1, 27.3]) { cube([0.66,0.7,0.66]); }
translate([154.275, -0.1, 26.65]) { cube([0.66,0.7,0.66]); }
translate([154.275, -0.1, 26.0]) { cube([0.66,0.7,0.66]); }
translate([154.925, -0.1, 26.0]) { cube([0.66,0.7,0.66]); }
translate([155.57500000000002, -0.1, 26.0]) { cube([0.66,0.7,0.66]); }
translate([156.225, -0.1, 26.0]) { cube([0.66,0.7,0.66]); }
translate([156.875, -0.1, 26.0]) { cube([0.66,0.7,0.66]); }
translate([158.175, -0.1, 29.9]) { cube([0.66,0.7,0.66]); }
translate([158.82500000000002, -0.1, 29.9]) { cube([0.66,0.7,0.66]); }
translate([159.47500000000002, -0.1, 29.9]) { cube([0.66,0.7,0.66]); }
translate([158.82500000000002, -0.1, 29.25]) { cube([0.66,0.7,0.66]); }
translate([158.82500000000002, -0.1, 28.6]) { cube([0.66,0.7,0.66]); }
translate([158.82500000000002, -0.1, 27.95]) { cube([0.66,0.7,0.66]); }
translate([158.82500000000002, -0.1, 27.3]) { cube([0.66,0.7,0.66]); }
translate([158.82500000000002, -0.1, 26.65]) { cube([0.66,0.7,0.66]); }
translate([158.175, -0.1, 26.0]) { cube([0.66,0.7,0.66]); }
translate([158.82500000000002, -0.1, 26.0]) { cube([0.66,0.7,0.66]); }
translate([159.47500000000002, -0.1, 26.0]) { cube([0.66,0.7,0.66]); }
translate([161.425, -0.1, 29.9]) { cube([0.66,0.7,0.66]); }
translate([162.07500000000002, -0.1, 29.9]) { cube([0.66,0.7,0.66]); }
translate([162.725, -0.1, 29.9]) { cube([0.66,0.7,0.66]); }
translate([160.775, -0.1, 29.25]) { cube([0.66,0.7,0.66]); }
translate([163.375, -0.1, 29.25]) { cube([0.66,0.7,0.66]); }
translate([160.775, -0.1, 28.6]) { cube([0.66,0.7,0.66]); }
translate([160.775, -0.1, 27.95]) { cube([0.66,0.7,0.66]); }
translate([162.07500000000002, -0.1, 27.95]) { cube([0.66,0.7,0.66]); }
translate([162.725, -0.1, 27.95]) { cube([0.66,0.7,0.66]); }
translate([163.375, -0.1, 27.95]) { cube([0.66,0.7,0.66]); }
translate([160.775, -0.1, 27.3]) { cube([0.66,0.7,0.66]); }
translate([163.375, -0.1, 27.3]) { cube([0.66,0.7,0.66]); }
translate([160.775, -0.1, 26.65]) { cube([0.66,0.7,0.66]); }
translate([163.375, -0.1, 26.65]) { cube([0.66,0.7,0.66]); }
translate([161.425, -0.1, 26.0]) { cube([0.66,0.7,0.66]); }
translate([162.07500000000002, -0.1, 26.0]) { cube([0.66,0.7,0.66]); }
translate([162.725, -0.1, 26.0]) { cube([0.66,0.7,0.66]); }
translate([164.675, -0.1, 29.9]) { cube([0.66,0.7,0.66]); }
translate([165.32500000000002, -0.1, 29.9]) { cube([0.66,0.7,0.66]); }
translate([165.97500000000002, -0.1, 29.9]) { cube([0.66,0.7,0.66]); }
translate([166.625, -0.1, 29.9]) { cube([0.66,0.7,0.66]); }
translate([164.675, -0.1, 29.25]) { cube([0.66,0.7,0.66]); }
translate([167.275, -0.1, 29.25]) { cube([0.66,0.7,0.66]); }
translate([164.675, -0.1, 28.6]) { cube([0.66,0.7,0.66]); }
translate([167.275, -0.1, 28.6]) { cube([0.66,0.7,0.66]); }
translate([164.675, -0.1, 27.95]) { cube([0.66,0.7,0.66]); }
translate([165.32500000000002, -0.1, 27.95]) { cube([0.66,0.7,0.66]); }
translate([165.97500000000002, -0.1, 27.95]) { cube([0.66,0.7,0.66]); }
translate([166.625, -0.1, 27.95]) { cube([0.66,0.7,0.66]); }
translate([164.675, -0.1, 27.3]) { cube([0.66,0.7,0.66]); }
translate([167.275, -0.1, 27.3]) { cube([0.66,0.7,0.66]); }
translate([164.675, -0.1, 26.65]) { cube([0.66,0.7,0.66]); }
translate([167.275, -0.1, 26.65]) { cube([0.66,0.7,0.66]); }
translate([164.675, -0.1, 26.0]) { cube([0.66,0.7,0.66]); }
translate([165.32500000000002, -0.1, 26.0]) { cube([0.66,0.7,0.66]); }
translate([165.97500000000002, -0.1, 26.0]) { cube([0.66,0.7,0.66]); }
translate([166.625, -0.1, 26.0]) { cube([0.66,0.7,0.66]); }
translate([168.57500000000002, -0.1, 29.9]) { cube([0.66,0.7,0.66]); }
translate([169.22500000000002, -0.1, 29.9]) { cube([0.66,0.7,0.66]); }
translate([169.87500000000003, -0.1, 29.9]) { cube([0.66,0.7,0.66]); }
translate([170.525, -0.1, 29.9]) { cube([0.66,0.7,0.66]); }
translate([171.175, -0.1, 29.9]) { cube([0.66,0.7,0.66]); }
translate([168.57500000000002, -0.1, 29.25]) { cube([0.66,0.7,0.66]); }
translate([168.57500000000002, -0.1, 28.6]) { cube([0.66,0.7,0.66]); }
translate([168.57500000000002, -0.1, 27.95]) { cube([0.66,0.7,0.66]); }
translate([169.22500000000002, -0.1, 27.95]) { cube([0.66,0.7,0.66]); }
translate([169.87500000000003, -0.1, 27.95]) { cube([0.66,0.7,0.66]); }
translate([170.525, -0.1, 27.95]) { cube([0.66,0.7,0.66]); }
translate([168.57500000000002, -0.1, 27.3]) { cube([0.66,0.7,0.66]); }
translate([168.57500000000002, -0.1, 26.65]) { cube([0.66,0.7,0.66]); }
translate([168.57500000000002, -0.1, 26.0]) { cube([0.66,0.7,0.66]); }
translate([169.22500000000002, -0.1, 26.0]) { cube([0.66,0.7,0.66]); }
translate([169.87500000000003, -0.1, 26.0]) { cube([0.66,0.7,0.66]); }
translate([170.525, -0.1, 26.0]) { cube([0.66,0.7,0.66]); }
translate([171.175, -0.1, 26.0]) { cube([0.66,0.7,0.66]); }
translate([172.47500000000002, -0.1, 29.9]) { cube([0.66,0.7,0.66]); }
translate([173.12500000000003, -0.1, 29.9]) { cube([0.66,0.7,0.66]); }
translate([173.77500000000003, -0.1, 29.9]) { cube([0.66,0.7,0.66]); }
translate([174.425, -0.1, 29.9]) { cube([0.66,0.7,0.66]); }
translate([175.07500000000002, -0.1, 29.9]) { cube([0.66,0.7,0.66]); }
translate([172.47500000000002, -0.1, 29.25]) { cube([0.66,0.7,0.66]); }
translate([172.47500000000002, -0.1, 28.6]) { cube([0.66,0.7,0.66]); }
translate([172.47500000000002, -0.1, 27.95]) { cube([0.66,0.7,0.66]); }
translate([173.12500000000003, -0.1, 27.95]) { cube([0.66,0.7,0.66]); }
translate([173.77500000000003, -0.1, 27.95]) { cube([0.66,0.7,0.66]); }
translate([174.425, -0.1, 27.95]) { cube([0.66,0.7,0.66]); }
translate([172.47500000000002, -0.1, 27.3]) { cube([0.66,0.7,0.66]); }
translate([172.47500000000002, -0.1, 26.65]) { cube([0.66,0.7,0.66]); }
translate([172.47500000000002, -0.1, 26.0]) { cube([0.66,0.7,0.66]); }
translate([173.12500000000003, -0.1, 26.0]) { cube([0.66,0.7,0.66]); }
translate([173.77500000000003, -0.1, 26.0]) { cube([0.66,0.7,0.66]); }
translate([174.425, -0.1, 26.0]) { cube([0.66,0.7,0.66]); }
translate([175.07500000000002, -0.1, 26.0]) { cube([0.66,0.7,0.66]); }
}
translate([211.9, 55, 26]) { rotate([0, 90, 0]) { cylinder(d=10,h=3.2,$fn=48); } }
translate([-0.1, 181.4, 13.0]) { cube([3.2,22,22]); }
translate([211.9, 153, 52]) { rotate([0, 90, 0]) { cylinder(d=6.5,h=3.2,$fn=48); } }
translate([-0.1, 40, 50]) { cube([3.2,3,14]); }
translate([-0.1, 50, 50]) { cube([3.2,3,14]); }
translate([-0.1, 60, 50]) { cube([3.2,3,14]); }
translate([-0.1, 70, 50]) { cube([3.2,3,14]); }
translate([-0.1, 80, 50]) { cube([3.2,3,14]); }
translate([-0.1, 90, 50]) { cube([3.2,3,14]); }
translate([-0.1, 100, 50]) { cube([3.2,3,14]); }
translate([-0.1, 110, 50]) { cube([3.2,3,14]); }
translate([-0.1, 120, 50]) { cube([3.2,3,14]); }
translate([-0.1, 130, 50]) { cube([3.2,3,14]); }
translate([-0.1, 140, 50]) { cube([3.2,3,14]); }
translate([-0.1, 150, 50]) { cube([3.2,3,14]); }
translate([-0.1, 160, 50]) { cube([3.2,3,14]); }
translate([211.9, 139, 55]) { cube([3.2,3,12]); }
translate([211.9, 149, 55]) { cube([3.2,3,12]); }
translate([211.9, 159, 55]) { cube([3.2,3,12]); }
translate([211.9, 169, 55]) { cube([3.2,3,12]); }
translate([70, 15, -0.1]) { cylinder(d=4.5,h=3.2,$fn=48); }
translate([145, 15, -0.1]) { cylinder(d=4.5,h=3.2,$fn=48); }
translate([211.9, 147, 21]) { rotate([0, 90, 0]) { cylinder(d=3.3,h=3.2,$fn=48); } }
translate([211.9, 171, 21]) { rotate([0, 90, 0]) { cylinder(d=3.3,h=3.2,$fn=48); } }
} } }}
color("LightSteelBlue") {translate([215, 0, 78]) { rotate([0, 180, 0]) { difference() {
union() {
difference() {
union() {
difference() {
union() {
difference() {
union() {
difference() {
difference() {
cube([215,215,3]);
translate([8, 8, -0.1]) { cylinder(d=3.3,h=3.2,$fn=48); }
translate([207, 8, -0.1]) { cylinder(d=3.3,h=3.2,$fn=48); }
translate([8, 207, -0.1]) { cylinder(d=3.3,h=3.2,$fn=48); }
translate([207, 207, -0.1]) { cylinder(d=3.3,h=3.2,$fn=48); }
}
translate([123, 83, 0.8]) { cube([50,21,2.3000000000000003]); }
}
translate([177, 82, 2.99]) { cylinder(d=6,h=15.110000000000001,$fn=48); }
}
translate([177, 82, 10.100000000000001]) { cylinder(d=1.7,h=8.1,$fn=48); }
}
translate([119, 82, 2.99]) { cylinder(d=6,h=15.110000000000001,$fn=48); }
}
translate([119, 82, 10.100000000000001]) { cylinder(d=1.7,h=8.1,$fn=48); }
}
translate([177, 105, 2.99]) { cylinder(d=6,h=15.110000000000001,$fn=48); }
}
translate([177, 105, 10.100000000000001]) { cylinder(d=1.7,h=8.1,$fn=48); }
}
translate([119, 105, 2.99]) { cylinder(d=6,h=15.110000000000001,$fn=48); }
}
translate([119, 105, 10.100000000000001]) { cylinder(d=1.7,h=8.1,$fn=48); }
} } }}
color("LightSteelBlue") {translate([35, 80, 57.9]) { rotate([0, 0, 0]) { difference() {
difference() {
difference() {
difference() {
difference() {
difference() {
cube([64,27,2]);
translate([14, 8, -0.1]) { cube([36,11,2.2]); }
}
translate([3, 2, -0.1]) { cylinder(d=2.2,h=2.2,$fn=48); }
translate([61, 2, -0.1]) { cylinder(d=2.2,h=2.2,$fn=48); }
translate([3, 25, -0.1]) { cylinder(d=2.2,h=2.2,$fn=48); }
translate([61, 25, -0.1]) { cylinder(d=2.2,h=2.2,$fn=48); }
}
translate([10, 3, -0.1]) { cube([2.5,3,2.2]); }
}
translate([10, 21, -0.1]) { cube([2.5,3,2.2]); }
}
translate([50, 3, -0.1]) { cube([2.5,3,2.2]); }
}
translate([50, 21, -0.1]) { cube([2.5,3,2.2]); }
} } }}
color("LightSteelBlue") {translate([215, 143, 13]) { rotate([0, 0, 0]) { difference() {
union() {
cube([31,8,3]);
cube([3,8,13]);
}
translate([-0.1, 4, 8]) { rotate([0, 90, 0]) { cylinder(d=3.3,h=3.2,$fn=48); } }
translate([25, 4, -0.1]) { cylinder(d=2.2,h=3.2,$fn=48); }
} } }}
color("LightSteelBlue") {translate([232, 143, 16]) { rotate([0, 0, 0]) { difference() {
difference() {
difference() {
difference() {
difference() {
difference() {
difference() {
difference() {
difference() {
difference() {
difference() {
difference() {
difference() {
difference() {
difference() {
difference() {
difference() {
difference() {
difference() {
difference() {
difference() {
union() {
difference() {
cube([45,35,21]);
translate([2, 2, 2]) { cube([41,31,23]); }
}
translate([4, 4, 0]) { cylinder(d=6,h=21,$fn=48); }
translate([41, 31, 0]) { cylinder(d=6,h=21,$fn=48); }
}
translate([4, 4, 14]) { cylinder(d=1.7,h=8,$fn=48); }
translate([41, 31, 14]) { cylinder(d=1.7,h=8,$fn=48); }
}
translate([-0.1, 10, 7]) { cube([2.2,2.5,10]); }
}
translate([42.9, 10, 7]) { cube([2.2,2.5,10]); }
}
translate([-0.1, 15, 7]) { cube([2.2,2.5,10]); }
}
translate([42.9, 15, 7]) { cube([2.2,2.5,10]); }
}
translate([-0.1, 20, 7]) { cube([2.2,2.5,10]); }
}
translate([42.9, 20, 7]) { cube([2.2,2.5,10]); }
}
translate([-0.1, 25, 7]) { cube([2.2,2.5,10]); }
}
translate([42.9, 25, 7]) { cube([2.2,2.5,10]); }
}
translate([12, 32.9, 7]) { cube([2.5,2.2,10]); }
}
translate([18, 32.9, 7]) { cube([2.5,2.2,10]); }
}
translate([24, 32.9, 7]) { cube([2.5,2.2,10]); }
}
translate([30, 32.9, 7]) { cube([2.5,2.2,10]); }
}
translate([36, 32.9, 7]) { cube([2.5,2.2,10]); }
}
translate([-0.1, 16, 14]) { rotate([0, 90, 0]) { cylinder(d=6.5,h=2.2,$fn=48); } }
}
translate([8, 4, -0.1]) { cylinder(d=2.2,h=2.2,$fn=48); }
}
translate([8, 28, -0.1]) { cylinder(d=2.2,h=2.2,$fn=48); }
}
translate([10, 7, -0.1]) { cube([2.5,3,2.2]); }
}
translate([10, 25, -0.1]) { cube([2.5,3,2.2]); }
}
translate([30, 7, -0.1]) { cube([2.5,3,2.2]); }
}
translate([30, 25, -0.1]) { cube([2.5,3,2.2]); }
} } }}
color("LightSteelBlue") {translate([232, 143, 37]) { rotate([0, 0, 0]) { difference() {
difference() {
difference() {
difference() {
difference() {
difference() {
cube([45,35,2]);
translate([4, 4, -0.1]) { cylinder(d=2.2,h=2.2,$fn=48); }
translate([41, 31, -0.1]) { cylinder(d=2.2,h=2.2,$fn=48); }
}
translate([12, 7, -0.1]) { cube([2.5,21,2.2]); }
}
translate([18, 7, -0.1]) { cube([2.5,21,2.2]); }
}
translate([24, 7, -0.1]) { cube([2.5,21,2.2]); }
}
translate([30, 7, -0.1]) { cube([2.5,21,2.2]); }
}
translate([36, 7, -0.1]) { cube([2.5,21,2.2]); }
} } }}
color("LightSteelBlue") {translate([215, 167, 13]) { rotate([0, 0, 0]) { difference() {
union() {
cube([31,8,3]);
cube([3,8,13]);
}
translate([-0.1, 4, 8]) { rotate([0, 90, 0]) { cylinder(d=3.3,h=3.2,$fn=48); } }
translate([25, 4, -0.1]) { cylinder(d=2.2,h=3.2,$fn=48); }
} } }}
color("#23725c") {difference() {
translate([14, 34, 15]) { cube([100.0,100.0,1.6]); }
union() {
translate([65.00999999999999, 48.62, 14.8]) { cube([3.0,10.9,2]); }
translate([63.51, 50.12, 14.8]) { cube([6.0,7.9,2]); }
translate([65.00999999999999, 50.12, 14.8]) { cylinder(d=3.0,h=2,$fn=48); }
translate([65.00999999999999, 58.019999999999996, 14.8]) { cylinder(d=3.0,h=2,$fn=48); }
translate([68.00999999999999, 50.12, 14.8]) { cylinder(d=3.0,h=2,$fn=48); }
translate([68.00999999999999, 58.019999999999996, 14.8]) { cylinder(d=3.0,h=2,$fn=48); }
}
}}
color("#222a31") {translate([62.239999999999995, 71.73, 16.6]) { cube([2.54,2.54,2.54]); }}
color("#c4b688") {translate([63.19, 72.68, 13.8]) { cube([0.64,0.64,9]); }}
color("#313c47") {translate([62.51, 72.0, 22]) { cube([2,2,7]); }}
color("#222a31") {translate([64.78, 71.73, 16.6]) { cube([2.54,2.54,2.54]); }}
color("#c4b688") {translate([65.73, 72.68, 13.8]) { cube([0.64,0.64,9]); }}
color("#313c47") {translate([65.05, 72.0, 22]) { cube([2,2,7]); }}
color("#222a31") {translate([22.0, 52.73, 16.6]) { cube([2.54,2.54,2.54]); }}
color("#c4b688") {translate([22.95, 53.68, 13.8]) { cube([0.64,0.64,5.3]); }}
color("#222a31") {translate([22.0, 55.269999999999996, 16.6]) { cube([2.54,2.54,2.54]); }}
color("#c4b688") {translate([22.95, 56.22, 13.8]) { cube([0.64,0.64,5.3]); }}
color("#222a31") {translate([22.0, 57.809999999999995, 16.6]) { cube([2.54,2.54,2.54]); }}
color("#c4b688") {translate([22.95, 58.76, 13.8]) { cube([0.64,0.64,5.3]); }}
color("#222a31") {translate([22.0, 60.35, 16.6]) { cube([2.54,2.54,2.54]); }}
color("#c4b688") {translate([22.95, 61.300000000000004, 13.8]) { cube([0.64,0.64,5.3]); }}
color("#222a31") {translate([22.0, 62.88999999999999, 16.6]) { cube([2.54,2.54,2.54]); }}
color("#c4b688") {translate([22.95, 63.839999999999996, 13.8]) { cube([0.64,0.64,5.3]); }}
color("#222a31") {translate([22.0, 65.43, 16.6]) { cube([2.54,2.54,2.54]); }}
color("#c4b688") {translate([22.95, 66.38000000000001, 13.8]) { cube([0.64,0.64,5.3]); }}
color("#222a31") {translate([22.0, 67.97000000000001, 16.6]) { cube([2.54,2.54,2.54]); }}
color("#c4b688") {translate([22.95, 68.92000000000002, 13.8]) { cube([0.64,0.64,5.3]); }}
color("#222a31") {translate([22.0, 70.51, 16.6]) { cube([2.54,2.54,2.54]); }}
color("#c4b688") {translate([22.95, 71.46000000000001, 13.8]) { cube([0.64,0.64,5.3]); }}
color("#222a31") {translate([22.0, 73.05, 16.6]) { cube([2.54,2.54,2.54]); }}
color("#c4b688") {translate([22.95, 74.0, 13.8]) { cube([0.64,0.64,5.3]); }}
color("#222a31") {translate([22.0, 75.59, 16.6]) { cube([2.54,2.54,2.54]); }}
color("#c4b688") {translate([22.95, 76.54, 13.8]) { cube([0.64,0.64,5.3]); }}
color("#222a31") {translate([22.0, 78.13000000000001, 16.6]) { cube([2.54,2.54,2.54]); }}
color("#c4b688") {translate([22.95, 79.08000000000001, 13.8]) { cube([0.64,0.64,5.3]); }}
color("#222a31") {translate([22.0, 80.67, 16.6]) { cube([2.54,2.54,2.54]); }}
color("#c4b688") {translate([22.95, 81.62, 13.8]) { cube([0.64,0.64,5.3]); }}
color("#222a31") {translate([22.0, 83.21, 16.6]) { cube([2.54,2.54,2.54]); }}
color("#c4b688") {translate([22.95, 84.16, 13.8]) { cube([0.64,0.64,5.3]); }}
color("#222a31") {translate([22.0, 85.75000000000001, 16.6]) { cube([2.54,2.54,2.54]); }}
color("#c4b688") {translate([22.95, 86.70000000000002, 13.8]) { cube([0.64,0.64,5.3]); }}
color("#222a31") {translate([22.0, 88.29, 16.6]) { cube([2.54,2.54,2.54]); }}
color("#c4b688") {translate([22.95, 89.24000000000001, 13.8]) { cube([0.64,0.64,5.3]); }}
color("#222a31") {translate([22.0, 90.83, 16.6]) { cube([2.54,2.54,2.54]); }}
color("#c4b688") {translate([22.95, 91.78, 13.8]) { cube([0.64,0.64,5.3]); }}
color("#222a31") {translate([22.0, 93.37, 16.6]) { cube([2.54,2.54,2.54]); }}
color("#c4b688") {translate([22.95, 94.32000000000001, 13.8]) { cube([0.64,0.64,5.3]); }}
color("#222a31") {translate([22.0, 95.91000000000001, 16.6]) { cube([2.54,2.54,2.54]); }}
color("#c4b688") {translate([22.95, 96.86000000000001, 13.8]) { cube([0.64,0.64,5.3]); }}
color("#222a31") {translate([22.0, 98.45, 16.6]) { cube([2.54,2.54,2.54]); }}
color("#c4b688") {translate([22.95, 99.4, 13.8]) { cube([0.64,0.64,5.3]); }}
color("#222a31") {translate([47.4, 52.73, 16.6]) { cube([2.54,2.54,2.54]); }}
color("#c4b688") {translate([48.35, 53.68, 13.8]) { cube([0.64,0.64,5.3]); }}
color("#222a31") {translate([47.4, 55.269999999999996, 16.6]) { cube([2.54,2.54,2.54]); }}
color("#c4b688") {translate([48.35, 56.22, 13.8]) { cube([0.64,0.64,5.3]); }}
color("#222a31") {translate([47.4, 57.809999999999995, 16.6]) { cube([2.54,2.54,2.54]); }}
color("#c4b688") {translate([48.35, 58.76, 13.8]) { cube([0.64,0.64,5.3]); }}
color("#222a31") {translate([47.4, 60.35, 16.6]) { cube([2.54,2.54,2.54]); }}
color("#c4b688") {translate([48.35, 61.300000000000004, 13.8]) { cube([0.64,0.64,5.3]); }}
color("#222a31") {translate([47.4, 62.88999999999999, 16.6]) { cube([2.54,2.54,2.54]); }}
color("#c4b688") {translate([48.35, 63.839999999999996, 13.8]) { cube([0.64,0.64,5.3]); }}
color("#222a31") {translate([47.4, 65.43, 16.6]) { cube([2.54,2.54,2.54]); }}
color("#c4b688") {translate([48.35, 66.38000000000001, 13.8]) { cube([0.64,0.64,5.3]); }}
color("#222a31") {translate([47.4, 67.97000000000001, 16.6]) { cube([2.54,2.54,2.54]); }}
color("#c4b688") {translate([48.35, 68.92000000000002, 13.8]) { cube([0.64,0.64,5.3]); }}
color("#222a31") {translate([47.4, 70.51, 16.6]) { cube([2.54,2.54,2.54]); }}
color("#c4b688") {translate([48.35, 71.46000000000001, 13.8]) { cube([0.64,0.64,5.3]); }}
color("#222a31") {translate([47.4, 73.05, 16.6]) { cube([2.54,2.54,2.54]); }}
color("#c4b688") {translate([48.35, 74.0, 13.8]) { cube([0.64,0.64,5.3]); }}
color("#222a31") {translate([47.4, 75.59, 16.6]) { cube([2.54,2.54,2.54]); }}
color("#c4b688") {translate([48.35, 76.54, 13.8]) { cube([0.64,0.64,5.3]); }}
color("#222a31") {translate([47.4, 78.13000000000001, 16.6]) { cube([2.54,2.54,2.54]); }}
color("#c4b688") {translate([48.35, 79.08000000000001, 13.8]) { cube([0.64,0.64,5.3]); }}
color("#222a31") {translate([47.4, 80.67, 16.6]) { cube([2.54,2.54,2.54]); }}
color("#c4b688") {translate([48.35, 81.62, 13.8]) { cube([0.64,0.64,5.3]); }}
color("#222a31") {translate([47.4, 83.21, 16.6]) { cube([2.54,2.54,2.54]); }}
color("#c4b688") {translate([48.35, 84.16, 13.8]) { cube([0.64,0.64,5.3]); }}
color("#222a31") {translate([47.4, 85.75000000000001, 16.6]) { cube([2.54,2.54,2.54]); }}
color("#c4b688") {translate([48.35, 86.70000000000002, 13.8]) { cube([0.64,0.64,5.3]); }}
color("#222a31") {translate([47.4, 88.29, 16.6]) { cube([2.54,2.54,2.54]); }}
color("#c4b688") {translate([48.35, 89.24000000000001, 13.8]) { cube([0.64,0.64,5.3]); }}
color("#222a31") {translate([47.4, 90.83, 16.6]) { cube([2.54,2.54,2.54]); }}
color("#c4b688") {translate([48.35, 91.78, 13.8]) { cube([0.64,0.64,5.3]); }}
color("#222a31") {translate([47.4, 93.37, 16.6]) { cube([2.54,2.54,2.54]); }}
color("#c4b688") {translate([48.35, 94.32000000000001, 13.8]) { cube([0.64,0.64,5.3]); }}
color("#222a31") {translate([47.4, 95.91000000000001, 16.6]) { cube([2.54,2.54,2.54]); }}
color("#c4b688") {translate([48.35, 96.86000000000001, 13.8]) { cube([0.64,0.64,5.3]); }}
color("#222a31") {translate([47.4, 98.45, 16.6]) { cube([2.54,2.54,2.54]); }}
color("#c4b688") {translate([48.35, 99.4, 13.8]) { cube([0.64,0.64,5.3]); }}
color("#183947") {translate([22.0, 46.66, 19.14]) { cube([27.939999999999998,54.33,1.6]); }}
color("#b5bec4") {translate([25.3528, 48.66, 20.740000000000002]) { cube([20.955,32.598,5]); }}
color("#222a31") {translate([58.88999999999999, 47.650999999999996, 16.6]) { cube([2.54,2.54,2.54]); }}
color("#c4b688") {translate([59.839999999999996, 48.601, 13.8]) { cube([0.64,0.64,5.3]); }}
color("#222a31") {translate([58.88999999999999, 50.190999999999995, 16.6]) { cube([2.54,2.54,2.54]); }}
color("#c4b688") {translate([59.839999999999996, 51.141, 13.8]) { cube([0.64,0.64,5.3]); }}
color("#222a31") {translate([58.88999999999999, 52.731, 16.6]) { cube([2.54,2.54,2.54]); }}
color("#c4b688") {translate([59.839999999999996, 53.681000000000004, 13.8]) { cube([0.64,0.64,5.3]); }}
color("#222a31") {translate([58.88999999999999, 55.270999999999994, 16.6]) { cube([2.54,2.54,2.54]); }}
color("#c4b688") {translate([59.839999999999996, 56.221, 13.8]) { cube([0.64,0.64,5.3]); }}
color("#222a31") {translate([58.88999999999999, 57.811, 16.6]) { cube([2.54,2.54,2.54]); }}
color("#c4b688") {translate([59.839999999999996, 58.761, 13.8]) { cube([0.64,0.64,5.3]); }}
color("#222a31") {translate([58.88999999999999, 60.35099999999999, 16.6]) { cube([2.54,2.54,2.54]); }}
color("#c4b688") {translate([59.839999999999996, 61.300999999999995, 13.8]) { cube([0.64,0.64,5.3]); }}
color("#222a31") {translate([58.88999999999999, 62.891, 16.6]) { cube([2.54,2.54,2.54]); }}
color("#c4b688") {translate([59.839999999999996, 63.841, 13.8]) { cube([0.64,0.64,5.3]); }}
color("#222a31") {translate([74.13000000000001, 47.650999999999996, 16.6]) { cube([2.54,2.54,2.54]); }}
color("#c4b688") {translate([75.08000000000001, 48.601, 13.8]) { cube([0.64,0.64,5.3]); }}
color("#222a31") {translate([74.13000000000001, 50.190999999999995, 16.6]) { cube([2.54,2.54,2.54]); }}
color("#c4b688") {translate([75.08000000000001, 51.141, 13.8]) { cube([0.64,0.64,5.3]); }}
color("#222a31") {translate([74.13000000000001, 52.731, 16.6]) { cube([2.54,2.54,2.54]); }}
color("#c4b688") {translate([75.08000000000001, 53.681000000000004, 13.8]) { cube([0.64,0.64,5.3]); }}
color("#222a31") {translate([74.13000000000001, 55.270999999999994, 16.6]) { cube([2.54,2.54,2.54]); }}
color("#c4b688") {translate([75.08000000000001, 56.221, 13.8]) { cube([0.64,0.64,5.3]); }}
color("#222a31") {translate([74.13000000000001, 57.811, 16.6]) { cube([2.54,2.54,2.54]); }}
color("#c4b688") {translate([75.08000000000001, 58.761, 13.8]) { cube([0.64,0.64,5.3]); }}
color("#222a31") {translate([74.13000000000001, 60.35099999999999, 16.6]) { cube([2.54,2.54,2.54]); }}
color("#c4b688") {translate([75.08000000000001, 61.300999999999995, 13.8]) { cube([0.64,0.64,5.3]); }}
color("#222a31") {translate([74.13000000000001, 62.891, 16.6]) { cube([2.54,2.54,2.54]); }}
color("#c4b688") {translate([75.08000000000001, 63.841, 13.8]) { cube([0.64,0.64,5.3]); }}
color("#e1a345") {union() {
translate([66.50659999999999, 50.435500000000005, 18.740000000000002]) { rotate([0, 90.0, 124.99202019855878]) { cylinder(d=0.8,h=1.2206555615733719,$fn=24); } }
translate([66.50659999999999, 50.435500000000005, 18.740000000000002]) { sphere(r=0.4,$fn=16); }
translate([65.80659999999999, 51.435500000000005, 18.740000000000002]) { sphere(r=0.4,$fn=16); }
}}
color("#e1a345") {union() {
translate([65.80659999999999, 51.435500000000005, 18.740000000000002]) { rotate([0, 90.0, 90.0]) { cylinder(d=0.8,h=17.519499999999994,$fn=24); } }
translate([65.80659999999999, 51.435500000000005, 18.740000000000002]) { sphere(r=0.4,$fn=16); }
translate([65.80659999999999, 68.955, 18.740000000000002]) { sphere(r=0.4,$fn=16); }
}}
color("#e1a345") {union() {
translate([65.80659999999999, 68.955, 18.740000000000002]) { rotate([0, 90.0, 119.5862929048927]) { cylinder(d=0.8,h=4.651494013755148,$fn=24); } }
translate([65.80659999999999, 68.955, 18.740000000000002]) { sphere(r=0.4,$fn=16); }
translate([63.51, 73.0, 18.740000000000002]) { sphere(r=0.4,$fn=16); }
}}
color("#e1a345") {union() {
translate([63.51, 73.0, 18.740000000000002]) { rotate([0, 0.0, 0.0]) { cylinder(d=0.8,h=11.259999999999998,$fn=24); } }
translate([63.51, 73.0, 18.740000000000002]) { sphere(r=0.4,$fn=16); }
translate([63.51, 73.0, 30]) { sphere(r=0.4,$fn=16); }
}}
color("#88cdd3") {union() {
translate([66.50659999999999, 55.5155, 18.740000000000002]) { rotate([0, 90.0, 55.00797980144123]) { cylinder(d=0.8,h=1.2206555615733719,$fn=24); } }
translate([66.50659999999999, 55.5155, 18.740000000000002]) { sphere(r=0.4,$fn=16); }
translate([67.2066, 56.5155, 18.740000000000002]) { sphere(r=0.4,$fn=16); }
}}
color("#88cdd3") {union() {
translate([67.2066, 56.5155, 18.740000000000002]) { rotate([0, 90.0, 90.0]) { cylinder(d=0.8,h=12.439499999999995,$fn=24); } }
translate([67.2066, 56.5155, 18.740000000000002]) { sphere(r=0.4,$fn=16); }
translate([67.2066, 68.955, 18.740000000000002]) { sphere(r=0.4,$fn=16); }
}}
color("#88cdd3") {union() {
translate([67.2066, 68.955, 18.740000000000002]) { rotate([0, 90.0, 105.9569941609619]) { cylinder(d=0.8,h=4.207106910930599,$fn=24); } }
translate([67.2066, 68.955, 18.740000000000002]) { sphere(r=0.4,$fn=16); }
translate([66.05, 73.0, 18.740000000000002]) { sphere(r=0.4,$fn=16); }
}}
color("#88cdd3") {union() {
translate([66.05, 73.0, 18.740000000000002]) { rotate([0, 0.0, 0.0]) { cylinder(d=0.8,h=11.259999999999998,$fn=24); } }
translate([66.05, 73.0, 18.740000000000002]) { sphere(r=0.4,$fn=16); }
translate([66.05, 73.0, 30]) { sphere(r=0.4,$fn=16); }
}}
color("#183947") {translate([58.89, 46.0, 19.14]) { cube([17.78,20.955,1.6]); }}
color("#b5bec4") {translate([61.0236, 48.0, 20.740000000000002]) { cube([13.335,12.572999999999999,5]); }}
color("#222a31") {translate([89.0, 47.650999999999996, 16.6]) { cube([2.54,2.54,2.54]); }}
color("#c4b688") {translate([89.95, 48.601, 13.8]) { cube([0.64,0.64,5.3]); }}
color("#222a31") {translate([89.0, 50.190999999999995, 16.6]) { cube([2.54,2.54,2.54]); }}
color("#c4b688") {translate([89.95, 51.141, 13.8]) { cube([0.64,0.64,5.3]); }}
color("#222a31") {translate([89.0, 52.731, 16.6]) { cube([2.54,2.54,2.54]); }}
color("#c4b688") {translate([89.95, 53.681000000000004, 13.8]) { cube([0.64,0.64,5.3]); }}
color("#222a31") {translate([89.0, 55.270999999999994, 16.6]) { cube([2.54,2.54,2.54]); }}
color("#c4b688") {translate([89.95, 56.221, 13.8]) { cube([0.64,0.64,5.3]); }}
color("#222a31") {translate([89.0, 57.811, 16.6]) { cube([2.54,2.54,2.54]); }}
color("#c4b688") {translate([89.95, 58.761, 13.8]) { cube([0.64,0.64,5.3]); }}
color("#222a31") {translate([89.0, 60.35099999999999, 16.6]) { cube([2.54,2.54,2.54]); }}
color("#c4b688") {translate([89.95, 61.300999999999995, 13.8]) { cube([0.64,0.64,5.3]); }}
color("#222a31") {translate([89.0, 62.891, 16.6]) { cube([2.54,2.54,2.54]); }}
color("#c4b688") {translate([89.95, 63.841, 13.8]) { cube([0.64,0.64,5.3]); }}
color("#222a31") {translate([104.24000000000001, 47.650999999999996, 16.6]) { cube([2.54,2.54,2.54]); }}
color("#c4b688") {translate([105.19000000000001, 48.601, 13.8]) { cube([0.64,0.64,5.3]); }}
color("#222a31") {translate([104.24000000000001, 50.190999999999995, 16.6]) { cube([2.54,2.54,2.54]); }}
color("#c4b688") {translate([105.19000000000001, 51.141, 13.8]) { cube([0.64,0.64,5.3]); }}
color("#222a31") {translate([104.24000000000001, 52.731, 16.6]) { cube([2.54,2.54,2.54]); }}
color("#c4b688") {translate([105.19000000000001, 53.681000000000004, 13.8]) { cube([0.64,0.64,5.3]); }}
color("#222a31") {translate([104.24000000000001, 55.270999999999994, 16.6]) { cube([2.54,2.54,2.54]); }}
color("#c4b688") {translate([105.19000000000001, 56.221, 13.8]) { cube([0.64,0.64,5.3]); }}
color("#222a31") {translate([104.24000000000001, 57.811, 16.6]) { cube([2.54,2.54,2.54]); }}
color("#c4b688") {translate([105.19000000000001, 58.761, 13.8]) { cube([0.64,0.64,5.3]); }}
color("#222a31") {translate([104.24000000000001, 60.35099999999999, 16.6]) { cube([2.54,2.54,2.54]); }}
color("#c4b688") {translate([105.19000000000001, 61.300999999999995, 13.8]) { cube([0.64,0.64,5.3]); }}
color("#222a31") {translate([104.24000000000001, 62.891, 16.6]) { cube([2.54,2.54,2.54]); }}
color("#c4b688") {translate([105.19000000000001, 63.841, 13.8]) { cube([0.64,0.64,5.3]); }}
color("#183947") {translate([89.0, 46.0, 19.14]) { cube([17.78,20.955,1.6]); }}
color("#b5bec4") {translate([91.1336, 48.0, 20.740000000000002]) { cube([13.335,12.572999999999999,5]); }}
color("#183947") {translate([73.0, 108.3, 24]) { cube([23.0,25.0,1.6]); }}
color("#b5bec4") {translate([75.76, 110.3, 25.6]) { cube([17.25,15.0,12]); }}
color("#303842") {translate([26, 177.6, 12]) { cube([102.5,29.599999999999994,24.799999999999997]); }}
color("#9e844e") {translate([181, 130, 12]) { cube([24,24,1.5999999999999996]); }}
color("#252a30") {translate([183.19, 132.39, 13.6]) { cube([12.0,8.050000000000011,10.699999999999998]); }}
color("#46586c") {translate([200.62, 138.19, 13.6]) { cylinder(d=5.5,h=12.500000000000002,$fn=48); }}
color("#a6b4c0") {translate([200.62, 138.19, 26.1]) { cylinder(d=4.675,h=0.2,$fn=48); }}
color("#ceab6c") {translate([184.11, 133.11, 13.6]) { cylinder(d=1.5,h=0.05,$fn=48); }}
color("#ceab6c") {translate([184.11, 135.65, 13.6]) { cylinder(d=1.5,h=0.05,$fn=48); }}
color("#ceab6c") {translate([184.11, 138.19000000000003, 13.6]) { cylinder(d=1.5,h=0.05,$fn=48); }}
color("#ceab6c") {translate([184.11, 140.73000000000002, 13.6]) { cylinder(d=1.5,h=0.05,$fn=48); }}
color("#ceab6c") {translate([184.11, 143.27, 13.6]) { cylinder(d=1.5,h=0.05,$fn=48); }}
color("#ceab6c") {translate([184.11, 145.81, 13.6]) { cylinder(d=1.5,h=0.05,$fn=48); }}
color("#ceab6c") {translate([184.11, 148.35000000000002, 13.6]) { cylinder(d=1.5,h=0.05,$fn=48); }}
color("#ceab6c") {translate([186.65, 133.11, 13.6]) { cylinder(d=1.5,h=0.05,$fn=48); }}
color("#ceab6c") {translate([186.65, 135.65, 13.6]) { cylinder(d=1.5,h=0.05,$fn=48); }}
color("#ceab6c") {translate([186.65, 138.19000000000003, 13.6]) { cylinder(d=1.5,h=0.05,$fn=48); }}
color("#ceab6c") {translate([186.65, 140.73000000000002, 13.6]) { cylinder(d=1.5,h=0.05,$fn=48); }}
color("#ceab6c") {translate([186.65, 143.27, 13.6]) { cylinder(d=1.5,h=0.05,$fn=48); }}
color("#ceab6c") {translate([186.65, 145.81, 13.6]) { cylinder(d=1.5,h=0.05,$fn=48); }}
color("#ceab6c") {translate([186.65, 148.35000000000002, 13.6]) { cylinder(d=1.5,h=0.05,$fn=48); }}
color("#ceab6c") {translate([189.19000000000003, 133.11, 13.6]) { cylinder(d=1.5,h=0.05,$fn=48); }}
color("#ceab6c") {translate([189.19000000000003, 135.65, 13.6]) { cylinder(d=1.5,h=0.05,$fn=48); }}
color("#ceab6c") {translate([189.19000000000003, 138.19000000000003, 13.6]) { cylinder(d=1.5,h=0.05,$fn=48); }}
color("#ceab6c") {translate([189.19000000000003, 140.73000000000002, 13.6]) { cylinder(d=1.5,h=0.05,$fn=48); }}
color("#ceab6c") {translate([189.19000000000003, 143.27, 13.6]) { cylinder(d=1.5,h=0.05,$fn=48); }}
color("#ceab6c") {translate([189.19000000000003, 145.81, 13.6]) { cylinder(d=1.5,h=0.05,$fn=48); }}
color("#ceab6c") {translate([189.19000000000003, 148.35000000000002, 13.6]) { cylinder(d=1.5,h=0.05,$fn=48); }}
color("#ceab6c") {translate([191.73000000000002, 133.11, 13.6]) { cylinder(d=1.5,h=0.05,$fn=48); }}
color("#ceab6c") {translate([191.73000000000002, 135.65, 13.6]) { cylinder(d=1.5,h=0.05,$fn=48); }}
color("#ceab6c") {translate([191.73000000000002, 138.19000000000003, 13.6]) { cylinder(d=1.5,h=0.05,$fn=48); }}
color("#ceab6c") {translate([191.73000000000002, 140.73000000000002, 13.6]) { cylinder(d=1.5,h=0.05,$fn=48); }}
color("#ceab6c") {translate([191.73000000000002, 143.27, 13.6]) { cylinder(d=1.5,h=0.05,$fn=48); }}
color("#ceab6c") {translate([191.73000000000002, 145.81, 13.6]) { cylinder(d=1.5,h=0.05,$fn=48); }}
color("#ceab6c") {translate([191.73000000000002, 148.35000000000002, 13.6]) { cylinder(d=1.5,h=0.05,$fn=48); }}
color("#ceab6c") {translate([194.27, 133.11, 13.6]) { cylinder(d=1.5,h=0.05,$fn=48); }}
color("#ceab6c") {translate([194.27, 135.65, 13.6]) { cylinder(d=1.5,h=0.05,$fn=48); }}
color("#ceab6c") {translate([194.27, 138.19000000000003, 13.6]) { cylinder(d=1.5,h=0.05,$fn=48); }}
color("#ceab6c") {translate([194.27, 140.73000000000002, 13.6]) { cylinder(d=1.5,h=0.05,$fn=48); }}
color("#ceab6c") {translate([194.27, 143.27, 13.6]) { cylinder(d=1.5,h=0.05,$fn=48); }}
color("#ceab6c") {translate([194.27, 145.81, 13.6]) { cylinder(d=1.5,h=0.05,$fn=48); }}
color("#ceab6c") {translate([194.27, 148.35000000000002, 13.6]) { cylinder(d=1.5,h=0.05,$fn=48); }}
color("#ceab6c") {translate([196.81, 133.11, 13.6]) { cylinder(d=1.5,h=0.05,$fn=48); }}
color("#ceab6c") {translate([196.81, 135.65, 13.6]) { cylinder(d=1.5,h=0.05,$fn=48); }}
color("#ceab6c") {translate([196.81, 138.19000000000003, 13.6]) { cylinder(d=1.5,h=0.05,$fn=48); }}
color("#ceab6c") {translate([196.81, 140.73000000000002, 13.6]) { cylinder(d=1.5,h=0.05,$fn=48); }}
color("#ceab6c") {translate([196.81, 143.27, 13.6]) { cylinder(d=1.5,h=0.05,$fn=48); }}
color("#ceab6c") {translate([196.81, 145.81, 13.6]) { cylinder(d=1.5,h=0.05,$fn=48); }}
color("#ceab6c") {translate([196.81, 148.35000000000002, 13.6]) { cylinder(d=1.5,h=0.05,$fn=48); }}
color("#ceab6c") {translate([199.35000000000002, 133.11, 13.6]) { cylinder(d=1.5,h=0.05,$fn=48); }}
color("#ceab6c") {translate([199.35000000000002, 135.65, 13.6]) { cylinder(d=1.5,h=0.05,$fn=48); }}
color("#ceab6c") {translate([199.35000000000002, 138.19000000000003, 13.6]) { cylinder(d=1.5,h=0.05,$fn=48); }}
color("#ceab6c") {translate([199.35000000000002, 140.73000000000002, 13.6]) { cylinder(d=1.5,h=0.05,$fn=48); }}
color("#ceab6c") {translate([199.35000000000002, 143.27, 13.6]) { cylinder(d=1.5,h=0.05,$fn=48); }}
color("#ceab6c") {translate([199.35000000000002, 145.81, 13.6]) { cylinder(d=1.5,h=0.05,$fn=48); }}
color("#ceab6c") {translate([199.35000000000002, 148.35000000000002, 13.6]) { cylinder(d=1.5,h=0.05,$fn=48); }}
color("#ceab6c") {translate([201.89000000000001, 133.11, 13.6]) { cylinder(d=1.5,h=0.05,$fn=48); }}
color("#ceab6c") {translate([201.89000000000001, 135.65, 13.6]) { cylinder(d=1.5,h=0.05,$fn=48); }}
color("#ceab6c") {translate([201.89000000000001, 138.19000000000003, 13.6]) { cylinder(d=1.5,h=0.05,$fn=48); }}
color("#ceab6c") {translate([201.89000000000001, 140.73000000000002, 13.6]) { cylinder(d=1.5,h=0.05,$fn=48); }}
color("#ceab6c") {translate([201.89000000000001, 143.27, 13.6]) { cylinder(d=1.5,h=0.05,$fn=48); }}
color("#ceab6c") {translate([201.89000000000001, 145.81, 13.6]) { cylinder(d=1.5,h=0.05,$fn=48); }}
color("#ceab6c") {translate([201.89000000000001, 148.35000000000002, 13.6]) { cylinder(d=1.5,h=0.05,$fn=48); }}
color("#b4bec4") {translate([186.65, 138.19, 10]) { cylinder(d=0.64,h=3.6,$fn=48); }}
color("#b4bec4") {translate([189.19, 138.19, 10]) { cylinder(d=0.64,h=3.6,$fn=48); }}
color("#b4bec4") {translate([191.73, 138.19, 10]) { cylinder(d=0.64,h=3.6,$fn=48); }}
color("#b4bec4") {translate([199.35, 138.19, 10]) { cylinder(d=0.64,h=3.6,$fn=48); }}
color("#b4bec4") {translate([201.89, 138.19, 10]) { cylinder(d=0.64,h=3.6,$fn=48); }}
color("#25699c") {translate([132, 126, 15]) { cube([32.5,27,1.6]); }}
color("#252a30") {translate([140.125, 131.4, 16.6]) { cube([14.625,13.5,4]); }}
color("#346baa") {translate([142, 87, 26.4]) { cube([28.5,28.5,1.6]); }}
color("#202226") {translate([144, 89, 17.4]) { cube([8,13,9]); }}
color("#a4a8ac") {translate([150, 93, 28.0]) { cube([10,13,2]); }}
color("#d2ac55") {translate([163.5, 89, 28.0]) { cube([6,0.6,0.3]); }}
color("#d2ac55") {translate([163.5, 94, 28.0]) { cube([6,0.6,0.3]); }}
color("#d2ac55") {translate([163.5, 99, 28.0]) { cube([6,0.6,0.3]); }}
color("#d2ac55") {translate([163.5, 104, 28.0]) { cube([6,0.6,0.3]); }}
color("#d2ac55") {translate([163.5, 109, 28.0]) { cube([6,0.6,0.3]); }}
color("#17663d") {translate([142, 41, 15]) { cube([55,30,1.6]); }}
color("#252a30") {translate([155.75, 47.0, 16.6]) { cube([24.75,15.0,4]); }}
color("#4c83ac") {translate([45, 86, 62.9]) { cube([44,15,1.6]); }}
color("#bdaa68") {translate([48, 90, 64.5]) { cube([5,6,0.3]); }}
color("#bdaa68") {translate([57, 90, 64.5]) { cube([5,6,0.3]); }}
color("#bdaa68") {translate([66, 90, 64.5]) { cube([5,6,0.3]); }}
color("#bdaa68") {translate([75, 90, 64.5]) { cube([5,6,0.3]); }}
color("#6938a1") {translate([240, 149, 27]) { cube([25.399999999999977,17.78,1.6]); }}
color("#252a30") {translate([246.35, 152.556, 28.6]) { cube([11.42999999999999,8.89,4]); }}
color("#354548") {translate([166, 165, 12]) { cube([40,16,18]); }}
color("#aa7440") {translate([166, 190, 12]) { cube([35,18,18]); }}
