ha-homelab/ha-radio-hub/mechanical/full-hub/cc1101-port-blank.scad

// Generated FH1 print part; mm. See parameters.json and physical-fit limits.
union() {
cylinder(d=9.6,h=3,$fn=48);
cylinder(d=14,h=1.2,$fn=48);
}
