ha-homelab/ha-radio-hub/mechanical/full-hub/fit-coupon.scad

// Generated FH1 print part; mm. See parameters.json and physical-fit limits.
difference() {
difference() {
difference() {
difference() {
difference() {
difference() {
difference() {
difference() {
difference() {
difference() {
cube([90,26,3]);
translate([7, 8, -0.1]) { cylinder(d=1.6,h=3.2,$fn=48); }
}
translate([17, 8, -0.1]) { cylinder(d=1.7,h=3.2,$fn=48); }
}
translate([27, 8, -0.1]) { cylinder(d=1.8,h=3.2,$fn=48); }
}
translate([37, 8, -0.1]) { cylinder(d=2.2,h=3.2,$fn=48); }
}
translate([47, 8, -0.1]) { cylinder(d=2.5,h=3.2,$fn=48); }
}
translate([57, 8, -0.1]) { cylinder(d=2.7,h=3.2,$fn=48); }
}
translate([67, 8, -0.1]) { cylinder(d=3.3,h=3.2,$fn=48); }
}
translate([15, 19, -0.1]) { cylinder(d=6.6,h=3.2,$fn=48); }
}
translate([45, 19, -0.1]) { cylinder(d=6.8,h=3.2,$fn=48); }
}
translate([75, 19, -0.1]) { cylinder(d=7.0,h=3.2,$fn=48); }
}
