ha-homelab/ha-radio-hub/mechanical/generated/antenna_blank.scad

// Generated from parameters.json by build.py. Edit parameters.json, then rebuild.
// CSG and STL share the same source. See docs/enclosure.md. Units mm.
union() {
cylinder(d=6.2,h=4.5,$fn=48);
cylinder(d=10,h=1.2,$fn=48);
}
