ha-homelab/ha-radio-hub/mechanical/generated/base.scad

// Generated from parameters.json by build.py. Edit parameters.json, then rebuild.
// CSG and STL share the same source. See docs/enclosure.md. Units mm.
difference() {
union() {
difference() {
cube([240.0,200.0,77.0]);
translate([3.0, 3.0, 3.0]) { cube([234.0,194.0,77.0]); }
}
translate([8.0, 8.0, 0]) { cylinder(d=12.0,h=77.0,$fn=48); }
translate([232.0, 8.0, 0]) { cylinder(d=12.0,h=77.0,$fn=48); }
translate([8.0, 192.0, 0]) { cylinder(d=12.0,h=77.0,$fn=48); }
translate([232.0, 192.0, 0]) { cylinder(d=12.0,h=77.0,$fn=48); }
translate([18.0, 18.0, 0]) { cylinder(d=9,h=40.0,$fn=48); }
translate([222.0, 18.0, 0]) { cylinder(d=9,h=40.0,$fn=48); }
translate([18.0, 182.0, 0]) { cylinder(d=9,h=40.0,$fn=48); }
translate([222.0, 182.0, 0]) { cylinder(d=9,h=40.0,$fn=48); }
}
translate([8.0, 8.0, 71.0]) { cylinder(d=4.2,h=6.02,$fn=48); }
translate([232.0, 8.0, 71.0]) { cylinder(d=4.2,h=6.02,$fn=48); }
translate([8.0, 192.0, 71.0]) { cylinder(d=4.2,h=6.02,$fn=48); }
translate([232.0, 192.0, 71.0]) { cylinder(d=4.2,h=6.02,$fn=48); }
translate([18.0, 18.0, 34.0]) { cylinder(d=4.2,h=6.02,$fn=48); }
translate([222.0, 18.0, 34.0]) { cylinder(d=4.2,h=6.02,$fn=48); }
translate([18.0, 182.0, 34.0]) { cylinder(d=4.2,h=6.02,$fn=48); }
translate([222.0, 182.0, 34.0]) { cylinder(d=4.2,h=6.02,$fn=48); }
translate([-0.02, 38, 52]) { cube([3.04,3,17]); }
translate([236.98, 38, 52]) { cube([3.04,3,17]); }
translate([-0.02, 45, 52]) { cube([3.04,3,17]); }
translate([236.98, 45, 52]) { cube([3.04,3,17]); }
translate([-0.02, 52, 52]) { cube([3.04,3,17]); }
translate([236.98, 52, 52]) { cube([3.04,3,17]); }
translate([-0.02, 59, 52]) { cube([3.04,3,17]); }
translate([236.98, 59, 52]) { cube([3.04,3,17]); }
translate([-0.02, 66, 52]) { cube([3.04,3,17]); }
translate([236.98, 66, 52]) { cube([3.04,3,17]); }
translate([-0.02, 73, 52]) { cube([3.04,3,17]); }
translate([236.98, 73, 52]) { cube([3.04,3,17]); }
translate([-0.02, 80, 52]) { cube([3.04,3,17]); }
translate([236.98, 80, 52]) { cube([3.04,3,17]); }
translate([-0.02, 87, 52]) { cube([3.04,3,17]); }
translate([236.98, 87, 52]) { cube([3.04,3,17]); }
translate([-0.02, 94, 52]) { cube([3.04,3,17]); }
translate([236.98, 94, 52]) { cube([3.04,3,17]); }
translate([-0.02, 101, 52]) { cube([3.04,3,17]); }
translate([236.98, 101, 52]) { cube([3.04,3,17]); }
translate([-0.02, 108, 52]) { cube([3.04,3,17]); }
translate([236.98, 108, 52]) { cube([3.04,3,17]); }
translate([-0.02, 115, 52]) { cube([3.04,3,17]); }
translate([236.98, 115, 52]) { cube([3.04,3,17]); }
translate([-0.02, 122, 52]) { cube([3.04,3,17]); }
translate([236.98, 122, 52]) { cube([3.04,3,17]); }
translate([236.98, 129, 52]) { cube([3.04,3,17]); }
translate([236.98, 136, 52]) { cube([3.04,3,17]); }
translate([236.98, 143, 52]) { cube([3.04,3,17]); }
translate([-0.02, 150, 52]) { cube([3.04,3,17]); }
translate([236.98, 150, 52]) { cube([3.04,3,17]); }
translate([-0.02, 157, 52]) { cube([3.04,3,17]); }
translate([236.98, 157, 52]) { cube([3.04,3,17]); }
translate([-0.02, 164, 52]) { cube([3.04,3,17]); }
translate([236.98, 164, 52]) { cube([3.04,3,17]); }
translate([109.0, 196.98, 12]) { cube([22,3.04,16]); }
translate([-0.02, 174.0, 60]) { rotate([0, 90, 0]) { cylinder(d=6.5,h=3.04,$fn=48); } }
translate([236.98, 174.0, 60]) { rotate([0, 90, 0]) { cylinder(d=6.5,h=3.04,$fn=48); } }
translate([-0.02, 136.0, 55.0]) { rotate([0, 90, 0]) { cylinder(d=5.0,h=3.04,$fn=48); } }
translate([24, 28.5, -0.02]) { cube([12,3,3.04]); }
translate([24, 58.5, -0.02]) { cube([12,3,3.04]); }
translate([24, 88.5, -0.02]) { cube([12,3,3.04]); }
translate([24, 118.5, -0.02]) { cube([12,3,3.04]); }
translate([24, 148.5, -0.02]) { cube([12,3,3.04]); }
translate([54, 28.5, -0.02]) { cube([12,3,3.04]); }
translate([54, 58.5, -0.02]) { cube([12,3,3.04]); }
translate([54, 88.5, -0.02]) { cube([12,3,3.04]); }
translate([54, 118.5, -0.02]) { cube([12,3,3.04]); }
translate([54, 148.5, -0.02]) { cube([12,3,3.04]); }
translate([84, 28.5, -0.02]) { cube([12,3,3.04]); }
translate([84, 58.5, -0.02]) { cube([12,3,3.04]); }
translate([84, 88.5, -0.02]) { cube([12,3,3.04]); }
translate([84, 118.5, -0.02]) { cube([12,3,3.04]); }
translate([84, 148.5, -0.02]) { cube([12,3,3.04]); }
translate([114, 28.5, -0.02]) { cube([12,3,3.04]); }
translate([114, 58.5, -0.02]) { cube([12,3,3.04]); }
translate([114, 88.5, -0.02]) { cube([12,3,3.04]); }
translate([114, 118.5, -0.02]) { cube([12,3,3.04]); }
translate([114, 148.5, -0.02]) { cube([12,3,3.04]); }
translate([144, 28.5, -0.02]) { cube([12,3,3.04]); }
translate([144, 58.5, -0.02]) { cube([12,3,3.04]); }
translate([144, 88.5, -0.02]) { cube([12,3,3.04]); }
translate([144, 118.5, -0.02]) { cube([12,3,3.04]); }
translate([144, 148.5, -0.02]) { cube([12,3,3.04]); }
translate([174, 28.5, -0.02]) { cube([12,3,3.04]); }
translate([174, 58.5, -0.02]) { cube([12,3,3.04]); }
translate([174, 88.5, -0.02]) { cube([12,3,3.04]); }
translate([174, 118.5, -0.02]) { cube([12,3,3.04]); }
translate([174, 148.5, -0.02]) { cube([12,3,3.04]); }
translate([204, 28.5, -0.02]) { cube([12,3,3.04]); }
translate([204, 58.5, -0.02]) { cube([12,3,3.04]); }
translate([204, 88.5, -0.02]) { cube([12,3,3.04]); }
translate([204, 118.5, -0.02]) { cube([12,3,3.04]); }
translate([204, 148.5, -0.02]) { cube([12,3,3.04]); }
translate([60.0, 180.0, -0.02]) { cylinder(d=8,h=3.04,$fn=48); }
translate([58.0, 180.0, -0.02]) { cube([4,9,3.04]); }
translate([180.0, 180.0, -0.02]) { cylinder(d=8,h=3.04,$fn=48); }
translate([178.0, 180.0, -0.02]) { cube([4,9,3.04]); }
}
