ha-homelab/ha-radio-hub/mechanical/generated/deck.scad

// Generated from parameters.json by build.py. Edit parameters.json, then rebuild.
// CSG and STL share the same source. See docs/enclosure.md. Units mm.
difference() {
cube([214.0,174.0,3.0]);
translate([5.0, 5.0, -0.02]) { cylinder(d=3.4,h=3.04,$fn=48); }
translate([209.0, 5.0, -0.02]) { cylinder(d=3.4,h=3.04,$fn=48); }
translate([5.0, 169.0, -0.02]) { cylinder(d=3.4,h=3.04,$fn=48); }
translate([209.0, 169.0, -0.02]) { cylinder(d=3.4,h=3.04,$fn=48); }
translate([12, 14.5, -0.02]) { cube([10,5,3.04]); }
translate([12, 31.5, -0.02]) { cube([10,5,3.04]); }
translate([12, 48.5, -0.02]) { cube([10,5,3.04]); }
translate([12, 65.5, -0.02]) { cube([10,5,3.04]); }
translate([12, 82.5, -0.02]) { cube([10,5,3.04]); }
translate([12, 99.5, -0.02]) { cube([10,5,3.04]); }
translate([12, 116.5, -0.02]) { cube([10,5,3.04]); }
translate([12, 133.5, -0.02]) { cube([10,5,3.04]); }
translate([12, 150.5, -0.02]) { cube([10,5,3.04]); }
translate([29, 14.5, -0.02]) { cube([10,5,3.04]); }
translate([29, 31.5, -0.02]) { cube([10,5,3.04]); }
translate([29, 48.5, -0.02]) { cube([10,5,3.04]); }
translate([29, 65.5, -0.02]) { cube([10,5,3.04]); }
translate([29, 82.5, -0.02]) { cube([10,5,3.04]); }
translate([29, 99.5, -0.02]) { cube([10,5,3.04]); }
translate([29, 116.5, -0.02]) { cube([10,5,3.04]); }
translate([29, 133.5, -0.02]) { cube([10,5,3.04]); }
translate([29, 150.5, -0.02]) { cube([10,5,3.04]); }
translate([46, 14.5, -0.02]) { cube([10,5,3.04]); }
translate([46, 31.5, -0.02]) { cube([10,5,3.04]); }
translate([46, 48.5, -0.02]) { cube([10,5,3.04]); }
translate([46, 65.5, -0.02]) { cube([10,5,3.04]); }
translate([46, 82.5, -0.02]) { cube([10,5,3.04]); }
translate([46, 99.5, -0.02]) { cube([10,5,3.04]); }
translate([46, 116.5, -0.02]) { cube([10,5,3.04]); }
translate([46, 133.5, -0.02]) { cube([10,5,3.04]); }
translate([46, 150.5, -0.02]) { cube([10,5,3.04]); }
translate([63, 14.5, -0.02]) { cube([10,5,3.04]); }
translate([63, 31.5, -0.02]) { cube([10,5,3.04]); }
translate([63, 48.5, -0.02]) { cube([10,5,3.04]); }
translate([63, 65.5, -0.02]) { cube([10,5,3.04]); }
translate([63, 82.5, -0.02]) { cube([10,5,3.04]); }
translate([63, 99.5, -0.02]) { cube([10,5,3.04]); }
translate([63, 116.5, -0.02]) { cube([10,5,3.04]); }
translate([63, 133.5, -0.02]) { cube([10,5,3.04]); }
translate([63, 150.5, -0.02]) { cube([10,5,3.04]); }
translate([80, 14.5, -0.02]) { cube([10,5,3.04]); }
translate([80, 31.5, -0.02]) { cube([10,5,3.04]); }
translate([80, 48.5, -0.02]) { cube([10,5,3.04]); }
translate([80, 65.5, -0.02]) { cube([10,5,3.04]); }
translate([80, 82.5, -0.02]) { cube([10,5,3.04]); }
translate([80, 99.5, -0.02]) { cube([10,5,3.04]); }
translate([80, 116.5, -0.02]) { cube([10,5,3.04]); }
translate([80, 133.5, -0.02]) { cube([10,5,3.04]); }
translate([80, 150.5, -0.02]) { cube([10,5,3.04]); }
translate([97, 14.5, -0.02]) { cube([10,5,3.04]); }
translate([97, 31.5, -0.02]) { cube([10,5,3.04]); }
translate([97, 48.5, -0.02]) { cube([10,5,3.04]); }
translate([97, 65.5, -0.02]) { cube([10,5,3.04]); }
translate([97, 82.5, -0.02]) { cube([10,5,3.04]); }
translate([97, 99.5, -0.02]) { cube([10,5,3.04]); }
translate([97, 116.5, -0.02]) { cube([10,5,3.04]); }
translate([97, 133.5, -0.02]) { cube([10,5,3.04]); }
translate([97, 150.5, -0.02]) { cube([10,5,3.04]); }
translate([114, 14.5, -0.02]) { cube([10,5,3.04]); }
translate([114, 31.5, -0.02]) { cube([10,5,3.04]); }
translate([114, 48.5, -0.02]) { cube([10,5,3.04]); }
translate([114, 65.5, -0.02]) { cube([10,5,3.04]); }
translate([114, 82.5, -0.02]) { cube([10,5,3.04]); }
translate([114, 99.5, -0.02]) { cube([10,5,3.04]); }
translate([114, 116.5, -0.02]) { cube([10,5,3.04]); }
translate([114, 133.5, -0.02]) { cube([10,5,3.04]); }
translate([114, 150.5, -0.02]) { cube([10,5,3.04]); }
translate([131, 14.5, -0.02]) { cube([10,5,3.04]); }
translate([131, 31.5, -0.02]) { cube([10,5,3.04]); }
translate([131, 48.5, -0.02]) { cube([10,5,3.04]); }
translate([131, 65.5, -0.02]) { cube([10,5,3.04]); }
translate([131, 82.5, -0.02]) { cube([10,5,3.04]); }
translate([131, 99.5, -0.02]) { cube([10,5,3.04]); }
translate([131, 116.5, -0.02]) { cube([10,5,3.04]); }
translate([131, 133.5, -0.02]) { cube([10,5,3.04]); }
translate([131, 150.5, -0.02]) { cube([10,5,3.04]); }
translate([148, 14.5, -0.02]) { cube([10,5,3.04]); }
translate([148, 31.5, -0.02]) { cube([10,5,3.04]); }
translate([148, 48.5, -0.02]) { cube([10,5,3.04]); }
translate([148, 65.5, -0.02]) { cube([10,5,3.04]); }
translate([148, 82.5, -0.02]) { cube([10,5,3.04]); }
translate([148, 99.5, -0.02]) { cube([10,5,3.04]); }
translate([148, 116.5, -0.02]) { cube([10,5,3.04]); }
translate([148, 133.5, -0.02]) { cube([10,5,3.04]); }
translate([148, 150.5, -0.02]) { cube([10,5,3.04]); }
translate([165, 14.5, -0.02]) { cube([10,5,3.04]); }
translate([165, 31.5, -0.02]) { cube([10,5,3.04]); }
translate([165, 48.5, -0.02]) { cube([10,5,3.04]); }
translate([165, 65.5, -0.02]) { cube([10,5,3.04]); }
translate([165, 82.5, -0.02]) { cube([10,5,3.04]); }
translate([165, 99.5, -0.02]) { cube([10,5,3.04]); }
translate([165, 116.5, -0.02]) { cube([10,5,3.04]); }
translate([165, 133.5, -0.02]) { cube([10,5,3.04]); }
translate([165, 150.5, -0.02]) { cube([10,5,3.04]); }
translate([182, 14.5, -0.02]) { cube([10,5,3.04]); }
translate([182, 31.5, -0.02]) { cube([10,5,3.04]); }
translate([182, 48.5, -0.02]) { cube([10,5,3.04]); }
translate([182, 65.5, -0.02]) { cube([10,5,3.04]); }
translate([182, 82.5, -0.02]) { cube([10,5,3.04]); }
translate([182, 99.5, -0.02]) { cube([10,5,3.04]); }
translate([182, 116.5, -0.02]) { cube([10,5,3.04]); }
translate([182, 133.5, -0.02]) { cube([10,5,3.04]); }
translate([182, 150.5, -0.02]) { cube([10,5,3.04]); }
translate([92.0, 147.0, -0.02]) { cube([30,28,3.04]); }
}
