ha-homelab/ha-radio-hub/mechanical/generated/lid.scad

// Generated from parameters.json by build.py. Edit parameters.json, then rebuild.
// CSG and STL share the same source. See docs/enclosure.md. Units mm.
difference() {
union() {
union() {
cube([240.0,200.0,3.0]);
difference() {
translate([3.35, 3.35, 3.0]) { cube([233.3,193.3,3]); }
translate([5.15, 5.15, 2.98]) { cube([229.7,189.7,3.04]); }
translate([8.0, 8.0, 2.98]) { cylinder(d=13.0,h=3.04,$fn=48); }
translate([232.0, 8.0, 2.98]) { cylinder(d=13.0,h=3.04,$fn=48); }
translate([8.0, 192.0, 2.98]) { cylinder(d=13.0,h=3.04,$fn=48); }
translate([232.0, 192.0, 2.98]) { cylinder(d=13.0,h=3.04,$fn=48); }
}
}
translate([82.0, 18.0, 2.98]) { cylinder(d=8,h=9,$fn=48); }
translate([158.0, 18.0, 2.98]) { cylinder(d=8,h=9,$fn=48); }
translate([82.0, 62.0, 2.98]) { cylinder(d=8,h=9,$fn=48); }
translate([158.0, 62.0, 2.98]) { cylinder(d=8,h=9,$fn=48); }
}
translate([8.0, 8.0, -0.02]) { cylinder(d=3.4,h=3.04,$fn=48); }
translate([232.0, 8.0, -0.02]) { cylinder(d=3.4,h=3.04,$fn=48); }
translate([8.0, 192.0, -0.02]) { cylinder(d=3.4,h=3.04,$fn=48); }
translate([232.0, 192.0, -0.02]) { cylinder(d=3.4,h=3.04,$fn=48); }
translate([8.0, 8.0, -0.02]) { cylinder(d=6.8,h=1.22,$fn=48); }
translate([232.0, 8.0, -0.02]) { cylinder(d=6.8,h=1.22,$fn=48); }
translate([8.0, 192.0, -0.02]) { cylinder(d=6.8,h=1.22,$fn=48); }
translate([232.0, 192.0, -0.02]) { cylinder(d=6.8,h=1.22,$fn=48); }
translate([82.0, 18.0, 6.0]) { cylinder(d=4.2,h=6.02,$fn=48); }
translate([158.0, 18.0, 6.0]) { cylinder(d=4.2,h=6.02,$fn=48); }
translate([82.0, 62.0, 6.0]) { cylinder(d=4.2,h=6.02,$fn=48); }
translate([158.0, 62.0, 6.0]) { cylinder(d=4.2,h=6.02,$fn=48); }
translate([90.0, 26.0, 1.2]) { cube([60.0,28.0,1.82]); }
translate([28, 90, -0.02]) { cube([3,22,3.04]); }
translate([28, 125, -0.02]) { cube([3,22,3.04]); }
translate([28, 160, -0.02]) { cube([3,22,3.04]); }
translate([36, 90, -0.02]) { cube([3,22,3.04]); }
translate([36, 125, -0.02]) { cube([3,22,3.04]); }
translate([36, 160, -0.02]) { cube([3,22,3.04]); }
translate([44, 90, -0.02]) { cube([3,22,3.04]); }
translate([44, 125, -0.02]) { cube([3,22,3.04]); }
translate([44, 160, -0.02]) { cube([3,22,3.04]); }
translate([52, 90, -0.02]) { cube([3,22,3.04]); }
translate([52, 125, -0.02]) { cube([3,22,3.04]); }
translate([52, 160, -0.02]) { cube([3,22,3.04]); }
translate([60, 90, -0.02]) { cube([3,22,3.04]); }
translate([60, 125, -0.02]) { cube([3,22,3.04]); }
translate([60, 160, -0.02]) { cube([3,22,3.04]); }
translate([68, 90, -0.02]) { cube([3,22,3.04]); }
translate([68, 125, -0.02]) { cube([3,22,3.04]); }
translate([68, 160, -0.02]) { cube([3,22,3.04]); }
translate([76, 90, -0.02]) { cube([3,22,3.04]); }
translate([76, 125, -0.02]) { cube([3,22,3.04]); }
translate([76, 160, -0.02]) { cube([3,22,3.04]); }
translate([84, 90, -0.02]) { cube([3,22,3.04]); }
translate([84, 125, -0.02]) { cube([3,22,3.04]); }
translate([84, 160, -0.02]) { cube([3,22,3.04]); }
translate([92, 90, -0.02]) { cube([3,22,3.04]); }
translate([92, 125, -0.02]) { cube([3,22,3.04]); }
translate([92, 160, -0.02]) { cube([3,22,3.04]); }
translate([100, 90, -0.02]) { cube([3,22,3.04]); }
translate([100, 125, -0.02]) { cube([3,22,3.04]); }
translate([100, 160, -0.02]) { cube([3,22,3.04]); }
translate([108, 90, -0.02]) { cube([3,22,3.04]); }
translate([108, 125, -0.02]) { cube([3,22,3.04]); }
translate([108, 160, -0.02]) { cube([3,22,3.04]); }
translate([116, 90, -0.02]) { cube([3,22,3.04]); }
translate([116, 125, -0.02]) { cube([3,22,3.04]); }
translate([116, 160, -0.02]) { cube([3,22,3.04]); }
translate([124, 90, -0.02]) { cube([3,22,3.04]); }
translate([124, 125, -0.02]) { cube([3,22,3.04]); }
translate([124, 160, -0.02]) { cube([3,22,3.04]); }
translate([132, 90, -0.02]) { cube([3,22,3.04]); }
translate([132, 125, -0.02]) { cube([3,22,3.04]); }
translate([132, 160, -0.02]) { cube([3,22,3.04]); }
translate([140, 90, -0.02]) { cube([3,22,3.04]); }
translate([140, 125, -0.02]) { cube([3,22,3.04]); }
translate([140, 160, -0.02]) { cube([3,22,3.04]); }
translate([148, 90, -0.02]) { cube([3,22,3.04]); }
translate([148, 125, -0.02]) { cube([3,22,3.04]); }
translate([148, 160, -0.02]) { cube([3,22,3.04]); }
translate([156, 90, -0.02]) { cube([3,22,3.04]); }
translate([156, 125, -0.02]) { cube([3,22,3.04]); }
translate([156, 160, -0.02]) { cube([3,22,3.04]); }
translate([164, 90, -0.02]) { cube([3,22,3.04]); }
translate([164, 125, -0.02]) { cube([3,22,3.04]); }
translate([164, 160, -0.02]) { cube([3,22,3.04]); }
translate([172, 90, -0.02]) { cube([3,22,3.04]); }
translate([172, 125, -0.02]) { cube([3,22,3.04]); }
translate([172, 160, -0.02]) { cube([3,22,3.04]); }
translate([180, 90, -0.02]) { cube([3,22,3.04]); }
translate([180, 125, -0.02]) { cube([3,22,3.04]); }
translate([180, 160, -0.02]) { cube([3,22,3.04]); }
translate([188, 90, -0.02]) { cube([3,22,3.04]); }
translate([188, 125, -0.02]) { cube([3,22,3.04]); }
translate([188, 160, -0.02]) { cube([3,22,3.04]); }
translate([196, 90, -0.02]) { cube([3,22,3.04]); }
translate([196, 125, -0.02]) { cube([3,22,3.04]); }
translate([196, 160, -0.02]) { cube([3,22,3.04]); }
translate([204, 90, -0.02]) { cube([3,22,3.04]); }
translate([204, 125, -0.02]) { cube([3,22,3.04]); }
translate([204, 160, -0.02]) { cube([3,22,3.04]); }
translate([212, 90, -0.02]) { cube([3,22,3.04]); }
translate([212, 125, -0.02]) { cube([3,22,3.04]); }
translate([212, 160, -0.02]) { cube([3,22,3.04]); }
}
