ha-homelab/ha-radio-hub/mechanical/low-power/generated/mockup_base.scad

// CONCEPT MOCK-UP ONLY. Units mm. Generated from parameters.json; not a fabrication-ready PCB.
difference() {
union() {
difference() {
cube([190.0,145.0,42.6]);
translate([2.4, 2.4, 2.4]) { cube([185.2,140.2,42.6]); }
}
translate([7.0, 7.0, 0]) { cylinder(d=10.0,h=42.6,$fn=48); }
translate([7.0, 138.0, 0]) { cylinder(d=10.0,h=42.6,$fn=48); }
translate([183.0, 7.0, 0]) { cylinder(d=10.0,h=42.6,$fn=48); }
translate([183.0, 138.0, 0]) { cylinder(d=10.0,h=42.6,$fn=48); }
translate([20.0, 15.5, 0]) { cylinder(d=8,h=10.0,$fn=48); }
translate([170.0, 15.5, 0]) { cylinder(d=8,h=10.0,$fn=48); }
translate([20.0, 107.0, 0]) { cylinder(d=8,h=10.0,$fn=48); }
translate([135.5, 107.0, 0]) { cylinder(d=8,h=10.0,$fn=48); }
}
translate([7.0, 7.0, 36.6]) { cylinder(d=4.2,h=6.02,$fn=48); }
translate([7.0, 138.0, 36.6]) { cylinder(d=4.2,h=6.02,$fn=48); }
translate([183.0, 7.0, 36.6]) { cylinder(d=4.2,h=6.02,$fn=48); }
translate([183.0, 138.0, 36.6]) { cylinder(d=4.2,h=6.02,$fn=48); }
translate([20.0, 15.5, 4.0]) { cylinder(d=4.2,h=6.02,$fn=48); }
translate([170.0, 15.5, 4.0]) { cylinder(d=4.2,h=6.02,$fn=48); }
translate([20.0, 107.0, 4.0]) { cylinder(d=4.2,h=6.02,$fn=48); }
translate([135.5, 107.0, 4.0]) { cylinder(d=4.2,h=6.02,$fn=48); }
translate([144.0, 142.57999999999998, 14.0]) { cube([22.0,2.44,16.0]); }
translate([-0.02, 40.0, 20.0]) { rotate([0, 90, 0]) { cylinder(d=5.0,h=2.44,$fn=48); } }
translate([-0.02, 55, 29.6]) { cube([2.44,3,8]); }
translate([187.57999999999998, 55, 29.6]) { cube([2.44,3,8]); }
translate([-0.02, 63, 29.6]) { cube([2.44,3,8]); }
translate([187.57999999999998, 63, 29.6]) { cube([2.44,3,8]); }
translate([-0.02, 71, 29.6]) { cube([2.44,3,8]); }
translate([187.57999999999998, 71, 29.6]) { cube([2.44,3,8]); }
translate([-0.02, 79, 29.6]) { cube([2.44,3,8]); }
translate([187.57999999999998, 79, 29.6]) { cube([2.44,3,8]); }
translate([-0.02, 87, 29.6]) { cube([2.44,3,8]); }
translate([187.57999999999998, 87, 29.6]) { cube([2.44,3,8]); }
translate([-0.02, 95, 29.6]) { cube([2.44,3,8]); }
translate([187.57999999999998, 95, 29.6]) { cube([2.44,3,8]); }
translate([-0.02, 103, 29.6]) { cube([2.44,3,8]); }
translate([187.57999999999998, 103, 29.6]) { cube([2.44,3,8]); }
translate([-0.02, 111, 29.6]) { cube([2.44,3,8]); }
translate([187.57999999999998, 111, 29.6]) { cube([2.44,3,8]); }
translate([-0.02, 119, 29.6]) { cube([2.44,3,8]); }
translate([187.57999999999998, 119, 29.6]) { cube([2.44,3,8]); }
}
