ha-homelab/ha-radio-hub/mechanical/module-carrier/enclosure-prototype/assembly.scad

// REVIEW ONLY: assembled mm coordinates. Do not print merged.
color("Teal") { difference() {
union() {
difference() {
translate([-18.4, -23.4, 0]) { cube([84.3,121.8,55.0]); }
translate([-16.0, -21.0, 2.4]) { cube([79.5,117.0,55.0]); }
}
translate([-16.0, 27.0, 26.0]) { cube([16.65,27.299999999999997,2.4]); }
translate([-2.6, 27.0, 0]) { cube([2.4,27.299999999999997,30.4]); }
translate([46.5, 27.0, 26.0]) { cube([17.0,46.8,2.4]); }
translate([47.7, 27.0, 0]) { cube([2.4,46.8,30.4]); }
translate([18.0, 52.03, 0]) { cylinder(d=5,h=28.4,$fn=48); }
translate([-13.0, -18.0, 0]) { cylinder(d=8,h=55.0,$fn=48); }
translate([60.5, -18.0, 0]) { cylinder(d=8,h=55.0,$fn=48); }
translate([-13.0, 93.0, 0]) { cylinder(d=8,h=55.0,$fn=48); }
translate([60.5, 93.0, 0]) { cylinder(d=8,h=55.0,$fn=48); }
}
translate([18.0, 52.03, -0.5]) { cylinder(d=2.7,h=29.4,$fn=48); }
translate([18.0, 52.03, -0.01]) { cylinder(d=5.8,h=2.1,$fn=6); }
translate([-13.0, -18.0, 45.0]) { cylinder(d=2.5,h=11,$fn=48); }
translate([60.5, -18.0, 45.0]) { cylinder(d=2.5,h=11,$fn=48); }
translate([-13.0, 93.0, 45.0]) { cylinder(d=2.5,h=11,$fn=48); }
translate([60.5, 93.0, 45.0]) { cylinder(d=2.5,h=11,$fn=48); }
translate([18, 95.9, 3]) { cube([30,3.4,25.4]); }
translate([63.4, 27, 6]) { cube([3.4,22,17]); }
translate([23.4, 45, -0.1]) { cube([3.2,18,2.6]); }
translate([39.4, 45, -0.1]) { cube([3.2,18,2.6]); }
translate([-10.0, 39, -0.1]) { cylinder(d=4.4,h=2.6,$fn=48); }
translate([-10.0, 39, 2.4099999999999997]) { cylinder(d=9,h=55.0,$fn=48); }
translate([57.5, 39, -0.1]) { cylinder(d=4.4,h=2.6,$fn=48); }
translate([57.5, 39, 2.4099999999999997]) { cylinder(d=9,h=55.0,$fn=48); }
translate([-18.5, 4, 7]) { cube([2.6,3,13]); }
translate([-18.5, 4, 34]) { cube([2.6,3,13]); }
translate([63.4, 4, 7]) { cube([2.6,3,13]); }
translate([63.4, 4, 34]) { cube([2.6,3,13]); }
translate([-18.5, 11, 7]) { cube([2.6,3,13]); }
translate([-18.5, 11, 34]) { cube([2.6,3,13]); }
translate([63.4, 11, 7]) { cube([2.6,3,13]); }
translate([63.4, 11, 34]) { cube([2.6,3,13]); }
translate([-18.5, 57, 7]) { cube([2.6,3,13]); }
translate([-18.5, 57, 34]) { cube([2.6,3,13]); }
translate([63.4, 57, 7]) { cube([2.6,3,13]); }
translate([63.4, 57, 34]) { cube([2.6,3,13]); }
translate([-18.5, 64, 7]) { cube([2.6,3,13]); }
translate([-18.5, 64, 34]) { cube([2.6,3,13]); }
translate([63.4, 64, 7]) { cube([2.6,3,13]); }
translate([63.4, 64, 34]) { cube([2.6,3,13]); }
translate([-18.5, 71, 7]) { cube([2.6,3,13]); }
translate([-18.5, 71, 34]) { cube([2.6,3,13]); }
translate([63.4, 71, 7]) { cube([2.6,3,13]); }
translate([63.4, 71, 34]) { cube([2.6,3,13]); }
} }
color("SkyBlue") { difference() {
union() {
translate([-18.4, -23.4, 55.0]) { cube([84.3,121.8,2.4]); }
translate([-16.0, 27.0, 30.4]) { cube([16.65,27.299999999999997,24.6]); }
translate([46.5, 27.0, 30.4]) { cube([17.0,46.8,24.6]); }
}
translate([-13.0, -18.0, 54.9]) { cylinder(d=3.2,h=3.4,$fn=48); }
translate([60.5, -18.0, 54.9]) { cylinder(d=3.2,h=3.4,$fn=48); }
translate([-13.0, 93.0, 54.9]) { cylinder(d=3.2,h=3.4,$fn=48); }
translate([60.5, 93.0, 54.9]) { cylinder(d=3.2,h=3.4,$fn=48); }
translate([5, 4, 54.9]) { cube([37,3,2.6]); }
translate([5, 11, 54.9]) { cube([37,3,2.6]); }
translate([5, 18, 54.9]) { cube([37,3,2.6]); }
translate([5, 58, 54.9]) { cube([37,3,2.6]); }
translate([5, 65, 54.9]) { cube([37,3,2.6]); }
translate([5, 72, 54.9]) { cube([37,3,2.6]); }
} }
color("Orange") { difference() {
union() {
translate([22, 48.0, 2.4]) { cube([22,10,2.4]); }
translate([22, 55.6, 2.4]) { cube([22,2.4,16.0]); }
}
translate([23.4, 49.0, 2.3]) { cube([3.2,5,2.6]); }
translate([39.4, 49.0, 2.3]) { cube([3.2,5,2.6]); }
} }
color("Purple") { difference() {
translate([-18.4, -23.4, -4.0]) { cube([84.3,121.8,4.0]); }
translate([-6.399999999999999, -11.399999999999999, -4.1]) { cube([60.3,97.8,4.2]); }
translate([-10.0, 39, -4.1]) { cylinder(d=4.4,h=4.2,$fn=48); }
translate([57.5, 39, -4.1]) { cylinder(d=4.4,h=4.2,$fn=48); }
} }
