ha-homelab/ha-radio-hub/mechanical/module-carrier/external-antenna-prototype/assembly.scad

// REVIEW ONLY: assembled coordinates. Not a part to print.
color("Teal") { difference() {
union() {
union() {
difference() {
cube([190.0,160,55.0]);
translate([3.0, 3.0, 3.0]) { cube([184.0,154.0,55.0]); }
}
translate([8, 8, 0]) { cylinder(d=9,h=55.0,$fn=48); }
translate([182.0, 8, 0]) { cylinder(d=9,h=55.0,$fn=48); }
translate([8, 152, 0]) { cylinder(d=9,h=55.0,$fn=48); }
translate([182.0, 152, 0]) { cylinder(d=9,h=55.0,$fn=48); }
translate([131.0, 136.0, 0]) { cylinder(d=7,h=15.0,$fn=48); }
translate([131.0, 44.0, 0]) { cylinder(d=7,h=15.0,$fn=48); }
translate([39.0, 136.0, 0]) { cylinder(d=7,h=15.0,$fn=48); }
translate([39.0, 44.0, 0]) { cylinder(d=7,h=15.0,$fn=48); }
}
difference() {
translate([24.0, 27, 3.0]) { cube([12,6,29.0]); }
translate([26.0, 26.9, 29.0]) { cube([8,6.2,2]); }
}
difference() {
translate([89.0, 27, 3.0]) { cube([12,6,29.0]); }
translate([91.0, 26.9, 29.0]) { cube([8,6.2,2]); }
}
difference() {
translate([154.0, 27, 3.0]) { cube([12,6,29.0]); }
translate([156.0, 26.9, 29.0]) { cube([8,6.2,2]); }
}
}
translate([8, 8, 44.0]) { cylinder(d=2.5,h=12,$fn=48); }
translate([182.0, 8, 44.0]) { cylinder(d=2.5,h=12,$fn=48); }
translate([8, 152, 44.0]) { cylinder(d=2.5,h=12,$fn=48); }
translate([182.0, 152, 44.0]) { cylinder(d=2.5,h=12,$fn=48); }
translate([131.0, 136.0, -0.1]) { cylinder(d=2.7,h=15.2,$fn=48); }
translate([131.0, 44.0, -0.1]) { cylinder(d=2.7,h=15.2,$fn=48); }
translate([39.0, 136.0, -0.1]) { cylinder(d=2.7,h=15.2,$fn=48); }
translate([39.0, 44.0, -0.1]) { cylinder(d=2.7,h=15.2,$fn=48); }
translate([131.0, 136.0, -0.1]) { cylinder(d=5.8,h=2.4,$fn=6); }
translate([131.0, 44.0, -0.1]) { cylinder(d=5.8,h=2.4,$fn=6); }
translate([39.0, 136.0, -0.1]) { cylinder(d=5.8,h=2.4,$fn=6); }
translate([39.0, 44.0, -0.1]) { cylinder(d=5.8,h=2.4,$fn=6); }
translate([12, 80.0, -0.1]) { cylinder(d=4.5,h=3.2,$fn=48); }
translate([178.0, 80.0, -0.1]) { cylinder(d=4.5,h=3.2,$fn=48); }
translate([89.0, 156.9, 8]) { cube([35,3.2,47.0]); }
translate([87.5, 148, -0.1]) { cylinder(d=3.3,h=3.2,$fn=48); }
translate([125.5, 148, -0.1]) { cylinder(d=3.3,h=3.2,$fn=48); }
translate([-0.1, 43, 26]) { cube([3.2,3,15]); }
translate([186.9, 43, 26]) { cube([3.2,3,15]); }
translate([-0.1, 53, 26]) { cube([3.2,3,15]); }
translate([186.9, 53, 26]) { cube([3.2,3,15]); }
translate([-0.1, 63, 26]) { cube([3.2,3,15]); }
translate([186.9, 63, 26]) { cube([3.2,3,15]); }
translate([-0.1, 73, 26]) { cube([3.2,3,15]); }
translate([186.9, 73, 26]) { cube([3.2,3,15]); }
translate([-0.1, 83, 26]) { cube([3.2,3,15]); }
translate([186.9, 83, 26]) { cube([3.2,3,15]); }
translate([-0.1, 93, 26]) { cube([3.2,3,15]); }
translate([186.9, 93, 26]) { cube([3.2,3,15]); }
translate([-0.1, 103, 26]) { cube([3.2,3,15]); }
translate([186.9, 103, 26]) { cube([3.2,3,15]); }
translate([-0.1, 113, 26]) { cube([3.2,3,15]); }
translate([186.9, 113, 26]) { cube([3.2,3,15]); }
translate([-0.1, 123, 26]) { cube([3.2,3,15]); }
translate([186.9, 123, 26]) { cube([3.2,3,15]); }
translate([-0.1, 133, 26]) { cube([3.2,3,15]); }
translate([186.9, 133, 26]) { cube([3.2,3,15]); }
translate([30.0, 3.1, 34.0]) { rotate([90, 0, 0]) { cylinder(d=6.8,h=3.2,$fn=48); } }
union() {
translate([24.475, -0.1, 25.9]) { cube([0.66,0.7,0.66]); }
translate([25.125, -0.1, 25.9]) { cube([0.66,0.7,0.66]); }
translate([25.775000000000002, -0.1, 25.9]) { cube([0.66,0.7,0.66]); }
translate([26.425, -0.1, 25.9]) { cube([0.66,0.7,0.66]); }
translate([24.475, -0.1, 25.25]) { cube([0.66,0.7,0.66]); }
translate([27.075000000000003, -0.1, 25.25]) { cube([0.66,0.7,0.66]); }
translate([24.475, -0.1, 24.6]) { cube([0.66,0.7,0.66]); }
translate([27.075000000000003, -0.1, 24.6]) { cube([0.66,0.7,0.66]); }
translate([24.475, -0.1, 23.95]) { cube([0.66,0.7,0.66]); }
translate([25.125, -0.1, 23.95]) { cube([0.66,0.7,0.66]); }
translate([25.775000000000002, -0.1, 23.95]) { cube([0.66,0.7,0.66]); }
translate([26.425, -0.1, 23.95]) { cube([0.66,0.7,0.66]); }
translate([24.475, -0.1, 23.3]) { cube([0.66,0.7,0.66]); }
translate([27.075000000000003, -0.1, 23.3]) { cube([0.66,0.7,0.66]); }
translate([24.475, -0.1, 22.65]) { cube([0.66,0.7,0.66]); }
translate([27.075000000000003, -0.1, 22.65]) { cube([0.66,0.7,0.66]); }
translate([24.475, -0.1, 22.0]) { cube([0.66,0.7,0.66]); }
translate([25.125, -0.1, 22.0]) { cube([0.66,0.7,0.66]); }
translate([25.775000000000002, -0.1, 22.0]) { cube([0.66,0.7,0.66]); }
translate([26.425, -0.1, 22.0]) { cube([0.66,0.7,0.66]); }
translate([28.375, -0.1, 25.9]) { cube([0.66,0.7,0.66]); }
translate([28.375, -0.1, 25.25]) { cube([0.66,0.7,0.66]); }
translate([28.375, -0.1, 24.6]) { cube([0.66,0.7,0.66]); }
translate([28.375, -0.1, 23.95]) { cube([0.66,0.7,0.66]); }
translate([28.375, -0.1, 23.3]) { cube([0.66,0.7,0.66]); }
translate([28.375, -0.1, 22.65]) { cube([0.66,0.7,0.66]); }
translate([28.375, -0.1, 22.0]) { cube([0.66,0.7,0.66]); }
translate([29.025, -0.1, 22.0]) { cube([0.66,0.7,0.66]); }
translate([29.675, -0.1, 22.0]) { cube([0.66,0.7,0.66]); }
translate([30.325, -0.1, 22.0]) { cube([0.66,0.7,0.66]); }
translate([30.975, -0.1, 22.0]) { cube([0.66,0.7,0.66]); }
translate([32.275, -0.1, 25.9]) { cube([0.66,0.7,0.66]); }
translate([32.925, -0.1, 25.9]) { cube([0.66,0.7,0.66]); }
translate([33.574999999999996, -0.1, 25.9]) { cube([0.66,0.7,0.66]); }
translate([34.225, -0.1, 25.9]) { cube([0.66,0.7,0.66]); }
translate([34.875, -0.1, 25.9]) { cube([0.66,0.7,0.66]); }
translate([32.275, -0.1, 25.25]) { cube([0.66,0.7,0.66]); }
translate([32.275, -0.1, 24.6]) { cube([0.66,0.7,0.66]); }
translate([32.275, -0.1, 23.95]) { cube([0.66,0.7,0.66]); }
translate([32.925, -0.1, 23.95]) { cube([0.66,0.7,0.66]); }
translate([33.574999999999996, -0.1, 23.95]) { cube([0.66,0.7,0.66]); }
translate([34.225, -0.1, 23.95]) { cube([0.66,0.7,0.66]); }
translate([32.275, -0.1, 23.3]) { cube([0.66,0.7,0.66]); }
translate([32.275, -0.1, 22.65]) { cube([0.66,0.7,0.66]); }
translate([32.275, -0.1, 22.0]) { cube([0.66,0.7,0.66]); }
translate([32.925, -0.1, 22.0]) { cube([0.66,0.7,0.66]); }
translate([33.574999999999996, -0.1, 22.0]) { cube([0.66,0.7,0.66]); }
translate([34.225, -0.1, 22.0]) { cube([0.66,0.7,0.66]); }
translate([34.875, -0.1, 22.0]) { cube([0.66,0.7,0.66]); }
}
translate([95.0, 3.1, 34.0]) { rotate([90, 0, 0]) { cylinder(d=6.8,h=3.2,$fn=48); } }
union() {
translate([83.625, -0.1, 25.9]) { cube([0.66,0.7,0.66]); }
translate([84.275, -0.1, 25.9]) { cube([0.66,0.7,0.66]); }
translate([84.925, -0.1, 25.9]) { cube([0.66,0.7,0.66]); }
translate([85.575, -0.1, 25.9]) { cube([0.66,0.7,0.66]); }
translate([86.225, -0.1, 25.9]) { cube([0.66,0.7,0.66]); }
translate([84.925, -0.1, 25.25]) { cube([0.66,0.7,0.66]); }
translate([84.925, -0.1, 24.6]) { cube([0.66,0.7,0.66]); }
translate([84.925, -0.1, 23.95]) { cube([0.66,0.7,0.66]); }
translate([84.925, -0.1, 23.3]) { cube([0.66,0.7,0.66]); }
translate([84.925, -0.1, 22.65]) { cube([0.66,0.7,0.66]); }
translate([84.925, -0.1, 22.0]) { cube([0.66,0.7,0.66]); }
translate([87.525, -0.1, 25.9]) { cube([0.66,0.7,0.66]); }
translate([90.125, -0.1, 25.9]) { cube([0.66,0.7,0.66]); }
translate([87.525, -0.1, 25.25]) { cube([0.66,0.7,0.66]); }
translate([90.125, -0.1, 25.25]) { cube([0.66,0.7,0.66]); }
translate([87.525, -0.1, 24.6]) { cube([0.66,0.7,0.66]); }
translate([90.125, -0.1, 24.6]) { cube([0.66,0.7,0.66]); }
translate([87.525, -0.1, 23.95]) { cube([0.66,0.7,0.66]); }
translate([88.17500000000001, -0.1, 23.95]) { cube([0.66,0.7,0.66]); }
translate([88.825, -0.1, 23.95]) { cube([0.66,0.7,0.66]); }
translate([89.47500000000001, -0.1, 23.95]) { cube([0.66,0.7,0.66]); }
translate([90.125, -0.1, 23.95]) { cube([0.66,0.7,0.66]); }
translate([87.525, -0.1, 23.3]) { cube([0.66,0.7,0.66]); }
translate([90.125, -0.1, 23.3]) { cube([0.66,0.7,0.66]); }
translate([87.525, -0.1, 22.65]) { cube([0.66,0.7,0.66]); }
translate([90.125, -0.1, 22.65]) { cube([0.66,0.7,0.66]); }
translate([87.525, -0.1, 22.0]) { cube([0.66,0.7,0.66]); }
translate([90.125, -0.1, 22.0]) { cube([0.66,0.7,0.66]); }
translate([91.42500000000001, -0.1, 25.9]) { cube([0.66,0.7,0.66]); }
translate([92.07500000000002, -0.1, 25.9]) { cube([0.66,0.7,0.66]); }
translate([92.72500000000001, -0.1, 25.9]) { cube([0.66,0.7,0.66]); }
translate([93.37500000000001, -0.1, 25.9]) { cube([0.66,0.7,0.66]); }
translate([91.42500000000001, -0.1, 25.25]) { cube([0.66,0.7,0.66]); }
translate([94.025, -0.1, 25.25]) { cube([0.66,0.7,0.66]); }
translate([91.42500000000001, -0.1, 24.6]) { cube([0.66,0.7,0.66]); }
translate([94.025, -0.1, 24.6]) { cube([0.66,0.7,0.66]); }
translate([91.42500000000001, -0.1, 23.95]) { cube([0.66,0.7,0.66]); }
translate([92.07500000000002, -0.1, 23.95]) { cube([0.66,0.7,0.66]); }
translate([92.72500000000001, -0.1, 23.95]) { cube([0.66,0.7,0.66]); }
translate([93.37500000000001, -0.1, 23.95]) { cube([0.66,0.7,0.66]); }
translate([91.42500000000001, -0.1, 23.3]) { cube([0.66,0.7,0.66]); }
translate([92.72500000000001, -0.1, 23.3]) { cube([0.66,0.7,0.66]); }
translate([91.42500000000001, -0.1, 22.65]) { cube([0.66,0.7,0.66]); }
translate([93.37500000000001, -0.1, 22.65]) { cube([0.66,0.7,0.66]); }
translate([91.42500000000001, -0.1, 22.0]) { cube([0.66,0.7,0.66]); }
translate([94.025, -0.1, 22.0]) { cube([0.66,0.7,0.66]); }
translate([95.32500000000002, -0.1, 25.9]) { cube([0.66,0.7,0.66]); }
translate([95.97500000000002, -0.1, 25.9]) { cube([0.66,0.7,0.66]); }
translate([96.62500000000001, -0.1, 25.9]) { cube([0.66,0.7,0.66]); }
translate([97.27500000000002, -0.1, 25.9]) { cube([0.66,0.7,0.66]); }
translate([97.92500000000001, -0.1, 25.9]) { cube([0.66,0.7,0.66]); }
translate([95.32500000000002, -0.1, 25.25]) { cube([0.66,0.7,0.66]); }
translate([95.32500000000002, -0.1, 24.6]) { cube([0.66,0.7,0.66]); }
translate([95.32500000000002, -0.1, 23.95]) { cube([0.66,0.7,0.66]); }
translate([95.97500000000002, -0.1, 23.95]) { cube([0.66,0.7,0.66]); }
translate([96.62500000000001, -0.1, 23.95]) { cube([0.66,0.7,0.66]); }
translate([97.27500000000002, -0.1, 23.95]) { cube([0.66,0.7,0.66]); }
translate([95.32500000000002, -0.1, 23.3]) { cube([0.66,0.7,0.66]); }
translate([95.32500000000002, -0.1, 22.65]) { cube([0.66,0.7,0.66]); }
translate([95.32500000000002, -0.1, 22.0]) { cube([0.66,0.7,0.66]); }
translate([95.97500000000002, -0.1, 22.0]) { cube([0.66,0.7,0.66]); }
translate([96.62500000000001, -0.1, 22.0]) { cube([0.66,0.7,0.66]); }
translate([97.27500000000002, -0.1, 22.0]) { cube([0.66,0.7,0.66]); }
translate([97.92500000000001, -0.1, 22.0]) { cube([0.66,0.7,0.66]); }
translate([99.87500000000003, -0.1, 25.9]) { cube([0.66,0.7,0.66]); }
translate([100.52500000000002, -0.1, 25.9]) { cube([0.66,0.7,0.66]); }
translate([101.17500000000003, -0.1, 25.9]) { cube([0.66,0.7,0.66]); }
translate([99.22500000000002, -0.1, 25.25]) { cube([0.66,0.7,0.66]); }
translate([101.82500000000002, -0.1, 25.25]) { cube([0.66,0.7,0.66]); }
translate([99.22500000000002, -0.1, 24.6]) { cube([0.66,0.7,0.66]); }
translate([101.82500000000002, -0.1, 24.6]) { cube([0.66,0.7,0.66]); }
translate([99.22500000000002, -0.1, 23.95]) { cube([0.66,0.7,0.66]); }
translate([99.87500000000003, -0.1, 23.95]) { cube([0.66,0.7,0.66]); }
translate([100.52500000000002, -0.1, 23.95]) { cube([0.66,0.7,0.66]); }
translate([101.17500000000003, -0.1, 23.95]) { cube([0.66,0.7,0.66]); }
translate([101.82500000000002, -0.1, 23.95]) { cube([0.66,0.7,0.66]); }
translate([99.22500000000002, -0.1, 23.3]) { cube([0.66,0.7,0.66]); }
translate([101.82500000000002, -0.1, 23.3]) { cube([0.66,0.7,0.66]); }
translate([99.22500000000002, -0.1, 22.65]) { cube([0.66,0.7,0.66]); }
translate([101.82500000000002, -0.1, 22.65]) { cube([0.66,0.7,0.66]); }
translate([99.22500000000002, -0.1, 22.0]) { cube([0.66,0.7,0.66]); }
translate([101.82500000000002, -0.1, 22.0]) { cube([0.66,0.7,0.66]); }
translate([103.12500000000003, -0.1, 25.9]) { cube([0.66,0.7,0.66]); }
translate([103.77500000000003, -0.1, 25.9]) { cube([0.66,0.7,0.66]); }
translate([104.42500000000003, -0.1, 25.9]) { cube([0.66,0.7,0.66]); }
translate([105.07500000000003, -0.1, 25.9]) { cube([0.66,0.7,0.66]); }
translate([103.12500000000003, -0.1, 25.25]) { cube([0.66,0.7,0.66]); }
translate([105.72500000000002, -0.1, 25.25]) { cube([0.66,0.7,0.66]); }
translate([103.12500000000003, -0.1, 24.6]) { cube([0.66,0.7,0.66]); }
translate([105.72500000000002, -0.1, 24.6]) { cube([0.66,0.7,0.66]); }
translate([103.12500000000003, -0.1, 23.95]) { cube([0.66,0.7,0.66]); }
translate([105.72500000000002, -0.1, 23.95]) { cube([0.66,0.7,0.66]); }
translate([103.12500000000003, -0.1, 23.3]) { cube([0.66,0.7,0.66]); }
translate([105.72500000000002, -0.1, 23.3]) { cube([0.66,0.7,0.66]); }
translate([103.12500000000003, -0.1, 22.65]) { cube([0.66,0.7,0.66]); }
translate([105.72500000000002, -0.1, 22.65]) { cube([0.66,0.7,0.66]); }
translate([103.12500000000003, -0.1, 22.0]) { cube([0.66,0.7,0.66]); }
translate([103.77500000000003, -0.1, 22.0]) { cube([0.66,0.7,0.66]); }
translate([104.42500000000003, -0.1, 22.0]) { cube([0.66,0.7,0.66]); }
translate([105.07500000000003, -0.1, 22.0]) { cube([0.66,0.7,0.66]); }
}
translate([160.0, 3.1, 34.0]) { rotate([90, 0, 0]) { cylinder(d=6.8,h=3.2,$fn=48); } }
union() {
translate([149.275, -0.1, 25.9]) { cube([0.66,0.7,0.66]); }
translate([149.925, -0.1, 25.9]) { cube([0.66,0.7,0.66]); }
translate([150.57500000000002, -0.1, 25.9]) { cube([0.66,0.7,0.66]); }
translate([151.225, -0.1, 25.9]) { cube([0.66,0.7,0.66]); }
translate([151.875, -0.1, 25.9]) { cube([0.66,0.7,0.66]); }
translate([151.875, -0.1, 25.25]) { cube([0.66,0.7,0.66]); }
translate([151.225, -0.1, 24.6]) { cube([0.66,0.7,0.66]); }
translate([150.57500000000002, -0.1, 23.95]) { cube([0.66,0.7,0.66]); }
translate([149.925, -0.1, 23.3]) { cube([0.66,0.7,0.66]); }
translate([149.275, -0.1, 22.65]) { cube([0.66,0.7,0.66]); }
translate([149.275, -0.1, 22.0]) { cube([0.66,0.7,0.66]); }
translate([149.925, -0.1, 22.0]) { cube([0.66,0.7,0.66]); }
translate([150.57500000000002, -0.1, 22.0]) { cube([0.66,0.7,0.66]); }
translate([151.225, -0.1, 22.0]) { cube([0.66,0.7,0.66]); }
translate([151.875, -0.1, 22.0]) { cube([0.66,0.7,0.66]); }
translate([153.175, -0.1, 25.9]) { cube([0.66,0.7,0.66]); }
translate([153.82500000000002, -0.1, 25.9]) { cube([0.66,0.7,0.66]); }
translate([154.47500000000002, -0.1, 25.9]) { cube([0.66,0.7,0.66]); }
translate([153.82500000000002, -0.1, 25.25]) { cube([0.66,0.7,0.66]); }
translate([153.82500000000002, -0.1, 24.6]) { cube([0.66,0.7,0.66]); }
translate([153.82500000000002, -0.1, 23.95]) { cube([0.66,0.7,0.66]); }
translate([153.82500000000002, -0.1, 23.3]) { cube([0.66,0.7,0.66]); }
translate([153.82500000000002, -0.1, 22.65]) { cube([0.66,0.7,0.66]); }
translate([153.175, -0.1, 22.0]) { cube([0.66,0.7,0.66]); }
translate([153.82500000000002, -0.1, 22.0]) { cube([0.66,0.7,0.66]); }
translate([154.47500000000002, -0.1, 22.0]) { cube([0.66,0.7,0.66]); }
translate([156.425, -0.1, 25.9]) { cube([0.66,0.7,0.66]); }
translate([157.07500000000002, -0.1, 25.9]) { cube([0.66,0.7,0.66]); }
translate([157.725, -0.1, 25.9]) { cube([0.66,0.7,0.66]); }
translate([155.775, -0.1, 25.25]) { cube([0.66,0.7,0.66]); }
translate([158.375, -0.1, 25.25]) { cube([0.66,0.7,0.66]); }
translate([155.775, -0.1, 24.6]) { cube([0.66,0.7,0.66]); }
translate([155.775, -0.1, 23.95]) { cube([0.66,0.7,0.66]); }
translate([157.07500000000002, -0.1, 23.95]) { cube([0.66,0.7,0.66]); }
translate([157.725, -0.1, 23.95]) { cube([0.66,0.7,0.66]); }
translate([158.375, -0.1, 23.95]) { cube([0.66,0.7,0.66]); }
translate([155.775, -0.1, 23.3]) { cube([0.66,0.7,0.66]); }
translate([158.375, -0.1, 23.3]) { cube([0.66,0.7,0.66]); }
translate([155.775, -0.1, 22.65]) { cube([0.66,0.7,0.66]); }
translate([158.375, -0.1, 22.65]) { cube([0.66,0.7,0.66]); }
translate([156.425, -0.1, 22.0]) { cube([0.66,0.7,0.66]); }
translate([157.07500000000002, -0.1, 22.0]) { cube([0.66,0.7,0.66]); }
translate([157.725, -0.1, 22.0]) { cube([0.66,0.7,0.66]); }
translate([159.675, -0.1, 25.9]) { cube([0.66,0.7,0.66]); }
translate([160.32500000000002, -0.1, 25.9]) { cube([0.66,0.7,0.66]); }
translate([160.97500000000002, -0.1, 25.9]) { cube([0.66,0.7,0.66]); }
translate([161.625, -0.1, 25.9]) { cube([0.66,0.7,0.66]); }
translate([159.675, -0.1, 25.25]) { cube([0.66,0.7,0.66]); }
translate([162.275, -0.1, 25.25]) { cube([0.66,0.7,0.66]); }
translate([159.675, -0.1, 24.6]) { cube([0.66,0.7,0.66]); }
translate([162.275, -0.1, 24.6]) { cube([0.66,0.7,0.66]); }
translate([159.675, -0.1, 23.95]) { cube([0.66,0.7,0.66]); }
translate([160.32500000000002, -0.1, 23.95]) { cube([0.66,0.7,0.66]); }
translate([160.97500000000002, -0.1, 23.95]) { cube([0.66,0.7,0.66]); }
translate([161.625, -0.1, 23.95]) { cube([0.66,0.7,0.66]); }
translate([159.675, -0.1, 23.3]) { cube([0.66,0.7,0.66]); }
translate([162.275, -0.1, 23.3]) { cube([0.66,0.7,0.66]); }
translate([159.675, -0.1, 22.65]) { cube([0.66,0.7,0.66]); }
translate([162.275, -0.1, 22.65]) { cube([0.66,0.7,0.66]); }
translate([159.675, -0.1, 22.0]) { cube([0.66,0.7,0.66]); }
translate([160.32500000000002, -0.1, 22.0]) { cube([0.66,0.7,0.66]); }
translate([160.97500000000002, -0.1, 22.0]) { cube([0.66,0.7,0.66]); }
translate([161.625, -0.1, 22.0]) { cube([0.66,0.7,0.66]); }
translate([163.57500000000002, -0.1, 25.9]) { cube([0.66,0.7,0.66]); }
translate([164.22500000000002, -0.1, 25.9]) { cube([0.66,0.7,0.66]); }
translate([164.87500000000003, -0.1, 25.9]) { cube([0.66,0.7,0.66]); }
translate([165.525, -0.1, 25.9]) { cube([0.66,0.7,0.66]); }
translate([166.175, -0.1, 25.9]) { cube([0.66,0.7,0.66]); }
translate([163.57500000000002, -0.1, 25.25]) { cube([0.66,0.7,0.66]); }
translate([163.57500000000002, -0.1, 24.6]) { cube([0.66,0.7,0.66]); }
translate([163.57500000000002, -0.1, 23.95]) { cube([0.66,0.7,0.66]); }
translate([164.22500000000002, -0.1, 23.95]) { cube([0.66,0.7,0.66]); }
translate([164.87500000000003, -0.1, 23.95]) { cube([0.66,0.7,0.66]); }
translate([165.525, -0.1, 23.95]) { cube([0.66,0.7,0.66]); }
translate([163.57500000000002, -0.1, 23.3]) { cube([0.66,0.7,0.66]); }
translate([163.57500000000002, -0.1, 22.65]) { cube([0.66,0.7,0.66]); }
translate([163.57500000000002, -0.1, 22.0]) { cube([0.66,0.7,0.66]); }
translate([164.22500000000002, -0.1, 22.0]) { cube([0.66,0.7,0.66]); }
translate([164.87500000000003, -0.1, 22.0]) { cube([0.66,0.7,0.66]); }
translate([165.525, -0.1, 22.0]) { cube([0.66,0.7,0.66]); }
translate([166.175, -0.1, 22.0]) { cube([0.66,0.7,0.66]); }
translate([167.47500000000002, -0.1, 25.9]) { cube([0.66,0.7,0.66]); }
translate([168.12500000000003, -0.1, 25.9]) { cube([0.66,0.7,0.66]); }
translate([168.77500000000003, -0.1, 25.9]) { cube([0.66,0.7,0.66]); }
translate([169.425, -0.1, 25.9]) { cube([0.66,0.7,0.66]); }
translate([170.07500000000002, -0.1, 25.9]) { cube([0.66,0.7,0.66]); }
translate([167.47500000000002, -0.1, 25.25]) { cube([0.66,0.7,0.66]); }
translate([167.47500000000002, -0.1, 24.6]) { cube([0.66,0.7,0.66]); }
translate([167.47500000000002, -0.1, 23.95]) { cube([0.66,0.7,0.66]); }
translate([168.12500000000003, -0.1, 23.95]) { cube([0.66,0.7,0.66]); }
translate([168.77500000000003, -0.1, 23.95]) { cube([0.66,0.7,0.66]); }
translate([169.425, -0.1, 23.95]) { cube([0.66,0.7,0.66]); }
translate([167.47500000000002, -0.1, 23.3]) { cube([0.66,0.7,0.66]); }
translate([167.47500000000002, -0.1, 22.65]) { cube([0.66,0.7,0.66]); }
translate([167.47500000000002, -0.1, 22.0]) { cube([0.66,0.7,0.66]); }
translate([168.12500000000003, -0.1, 22.0]) { cube([0.66,0.7,0.66]); }
translate([168.77500000000003, -0.1, 22.0]) { cube([0.66,0.7,0.66]); }
translate([169.425, -0.1, 22.0]) { cube([0.66,0.7,0.66]); }
translate([170.07500000000002, -0.1, 22.0]) { cube([0.66,0.7,0.66]); }
}
} }
color("SkyBlue") { translate([0, 0, 55.0]) { difference() {
cube([190.0,160,3.0]);
translate([8, 8, -0.1]) { cylinder(d=3.3,h=3.2,$fn=48); }
translate([182.0, 8, -0.1]) { cylinder(d=3.3,h=3.2,$fn=48); }
translate([8, 152, -0.1]) { cylinder(d=3.3,h=3.2,$fn=48); }
translate([182.0, 152, -0.1]) { cylinder(d=3.3,h=3.2,$fn=48); }
} } }
color("Purple") { translate([0, 0, -4.0]) { difference() {
cube([190.0,160,4.0]);
translate([16, 16, -0.1]) { cube([158.0,128,4.2]); }
translate([12, 80.0, -0.1]) { cylinder(d=4.5,h=4.2,$fn=48); }
translate([178.0, 80.0, -0.1]) { cylinder(d=4.5,h=4.2,$fn=48); }
translate([87.5, 148, -0.1]) { cylinder(d=8,h=4.2,$fn=48); }
translate([125.5, 148, -0.1]) { cylinder(d=8,h=4.2,$fn=48); }
} } }
color("Orange") { translate([83.5, 142, 3.0]) { difference() {
cube([46,12,3]);
translate([14, 2, -0.1]) { cube([3,8,3.2]); }
translate([29, 2, -0.1]) { cube([3,8,3.2]); }
translate([4, 6, -0.1]) { cylinder(d=3.3,h=3.2,$fn=48); }
translate([42, 6, -0.1]) { cylinder(d=3.3,h=3.2,$fn=48); }
} } }
