ha-homelab/ha-radio-hub/mechanical/module-carrier/external-antenna-prototype/bulkhead-fit-coupon.scad

// GENERATED. MC2 trial geometry in mm.
difference() {
difference() {
difference() {
difference() {
difference() {
difference() {
difference() {
difference() {
difference() {
cube([45,24,3.0]);
translate([8, 12, -0.1]) { cylinder(d=6.6,h=3.2,$fn=48); }
}
translate([5.0, 3, 2.5]) { cube([0.8,3,0.6]); }
}
translate([22, 12, -0.1]) { cylinder(d=6.8,h=3.2,$fn=48); }
}
translate([19.0, 3, 2.5]) { cube([0.8,3,0.6]); }
}
translate([20.4, 3, 2.5]) { cube([0.8,3,0.6]); }
}
translate([36, 12, -0.1]) { cylinder(d=7.0,h=3.2,$fn=48); }
}
translate([33.0, 3, 2.5]) { cube([0.8,3,0.6]); }
}
translate([34.4, 3, 2.5]) { cube([0.8,3,0.6]); }
}
translate([35.8, 3, 2.5]) { cube([0.8,3,0.6]); }
}
