ha-homelab/ha-radio-hub/(list of files, cad)

Other CAD files:
mechanical/full-hub/base.scad
mechanical/full-hub/bme680-pod-lid.scad
mechanical/full-hub/bme680-pod.scad
mechanical/full-hub/buck-tray.scad
mechanical/full-hub/cc1101-tray.scad
mechanical/full-hub/exploded.scad
mechanical/full-hub/lid.scad
mechanical/full-hub/poe-splitter-tray.scad
mechanical/full-hub/power-utility-tray.scad
mechanical/full-hub/radar-holder.scad
mechanical/full-hub/wk2132-tray.scad
mechanical/full-hub/zwave-tray.scad
mechanical/low-power/generated/fit_coupon.scad
mechanical/module-carrier/enclosure-prototype/base.scad
mechanical/module-carrier/enclosure-prototype/ceiling-spacing-frame.scad
mechanical/module-carrier/enclosure-prototype/cover.scad
mechanical/module-carrier/external-antenna-prototype/base.scad
mechanical/module-carrier/external-antenna-prototype/cable-bar.scad
mechanical/module-carrier/external-antenna-prototype/ceiling-spacing-frame.scad
mechanical/module-carrier/external-antenna-prototype/cover.scad
mechanical/module-carrier/enclosure-prototype/jack-stop-trial.scad
