ha-homelab/ha-radio-hub/hardware/external-antenna/images/mc2b-assembled-prompt.txt

Use case: product-mockup, sketch-to-render.
Create a realistic electronics studio product rendering of the MC2-B assembled 100 x 100 mm square green carrier board, based on the attached authoritative CAD assembly arrangement. White/off-white background, close elevated three-quarter view, complete board visible, soft shadows, sharp soldermask and finished-module detail, no frame or explanatory diagram.
The CAD reference is a layout reference, not the visual style. Preserve its square board and four corner mounting holes, module positions and relative sizes, all components on top. Left module is specifically classic Espressif ESP32-DevKitC-VIE / ESP32-WROVER-IE: two rows of 19 soldered male pins, black development PCB, long rectangular silver WROVER module at its upper end, tiny unoccupied factory coax socket at top, SINGLE Micro-B USB connector at lower end, two small BOOT/EN buttons. Do not depict ESP32-S3 or dual USB-C connectors. No female socket strips: male pins solder into carrier.
Upper middle is narrow black Unexpected Maker TinyC6 module, USB-C at top, small unoccupied coax connector near bottom; upper right is much smaller Seeed XIAO MG24 module, USB-C at top, unoccupied coax socket on lower-left side. Lower right is WIZ850io Ethernet module, silver RJ45 jack opening towards bottom edge. Retain the several small male harness headers and axial resistors/diodes in CAD locations, including two resistors below the left board. Realistic board finish and subtle traces; exact trace routing is illustrative. Subtle white carrier silkscreen 'HA RADIO HUB' and 'MC2-B', no S3 labels anywhere.
CRITICAL: absolutely no connected antennas, pigtails, coax cables, wires, network cable, power cable, screw-on RF aerials or SMA bulkheads in this image. Coax sockets remain visibly empty. No added screens or enclosure. Do not reproduce the CAD's text notes, colored circles, UI or black background. This is an appearance concept, not a fabrication drawing.
