ha-homelab/ha-radio-hub/hardware/external-antenna/images/assembled-prompt.txt

Use case: precise-object-edit. Edit reference image 1, an AI concept render of the MC2 carrier assembly. Preserve the photorealistic product-photography style, four daughterboard positions, the 100x100mm square green carrier, all four mounting holes, silver RJ45 socket front-right and module proportions. Remove ALL three black whip antennas, ALL three coax cables and ALL large gold threaded/coax fittings from the entire image. Instead, show just one tiny realistic empty flat gold U.FL socket (approximately 3mm square outer body) on each of the three radio modules at the prior cable connection locations. No large SMA connectors mounted on the radio modules. The S3 at left must have a factory external antenna module with no PCB trace antenna. Fill empty backdrop smoothly and reframe the carrier to occupy the image, on a clean light warm-gray surface. This is a board-only assembled prototype concept. Keep caption exactly "MC2 · AI CONCEPT RENDER". Text inside electronics may remain minimal. No cables, no loose accessories, no extra daughterboards. Reference image 2 is the engineering layout guide, use it only for approximate component placement. It is acceptable to simplify component markings because this is an explicitly labeled concept, not a wiring diagram.
