ha-homelab/ha-radio-hub/hardware/module-carrier/images/assembly-edit-prompt.txt

Edit the first image, using the second image (precise top-down assembly drawing) as the authority for module placement.
Fix one critical mechanical mistake: the first image shows extra exposed upright pin rows BESIDE the four modules. Those rows are actually the mounting pins of the modules themselves and must run directly DOWN from the module into the carrier. Move/scale all four finished modules to cover their paired pin rows exactly as the second assembly drawing shows, then REMOVE every exposed male pin row beside those modules. No empty socket strips, no female sockets, no upright unused mounting rows beside them. The black factory male header spacer is underneath each module edge only. The gold pins descend into the carrier, not point upward alongside modules.
U1 long S3 overlaps its actual two22-hole rows, U2 H2 overlaps two15-hole rows, U3 XIAO overlaps two7-hole rows right at top board edge, U4 WIZ850io overlaps two6-hole rows near lower left. Keep four module types, the same single green160x100carrier, three axial diodes and two resistors, realistic angle and lighting. Keep the independent small male harness headers J1..J8, located as in the assembly drawing; they are not module mounting rows.
Fix harness silkscreen labels: bottomcenter "WK2132", bottomright "ZAC93", right lower "BME680", right upper "RADAR", above XIAO service pins "BOOT". Remove invented labels MAX232,RS485B,R208,24C03.
Retain footer exactly "MC1 · Generated assembly concept — not a manufactured board".
No new components, no capacitors on the carrier, no additional custom boards. Preserve clearly conceptual product-photo style.
