ha-homelab/ha-radio-hub/hardware/low-power/diy/print/drilling.pdf

# Drilling / inspection - bottom copper view

NOT an etch mask. Mirrored from component view. All holes are unplated in the DIY process.

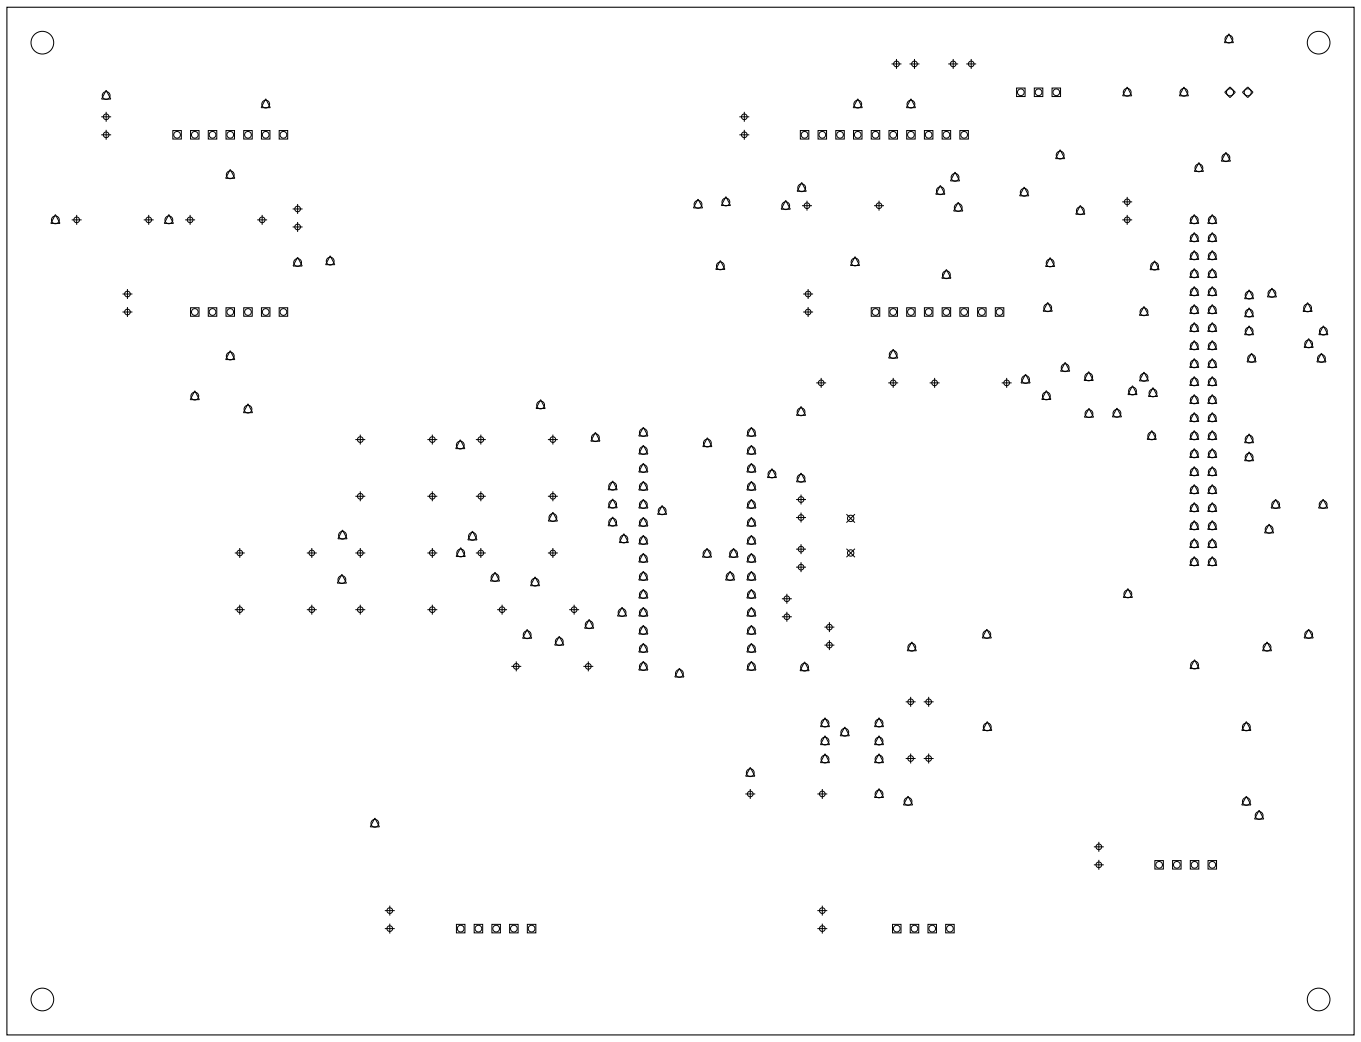
[picture p85: figure]

LP-D0 prototype | A4 | CAD/print checks only; not physically fabricated

Outline: 190 x 145 mm. Hole circles show actual nominal drill diameter. 0.8 mm drill: 68 holes (+)
0.9 mm drill: 2 holes (x)
0.95 mm drill: 47 holes (square)
1 mm drill: 2 holes (diamond) 1.1 mm drill: 176 holes (triangle)
3.2 mm drill: 4 holes (ring)

Confirm drill against the actual lead; avoid enlarging a hole beyond its copper annulus.

Complete pad coordinates and nets: drill-map.json (component/top coordinates).

# Copper inspection - bottom view

NOT AN ETCH MASK. Already mirrored to match the physical copper side after transfer.

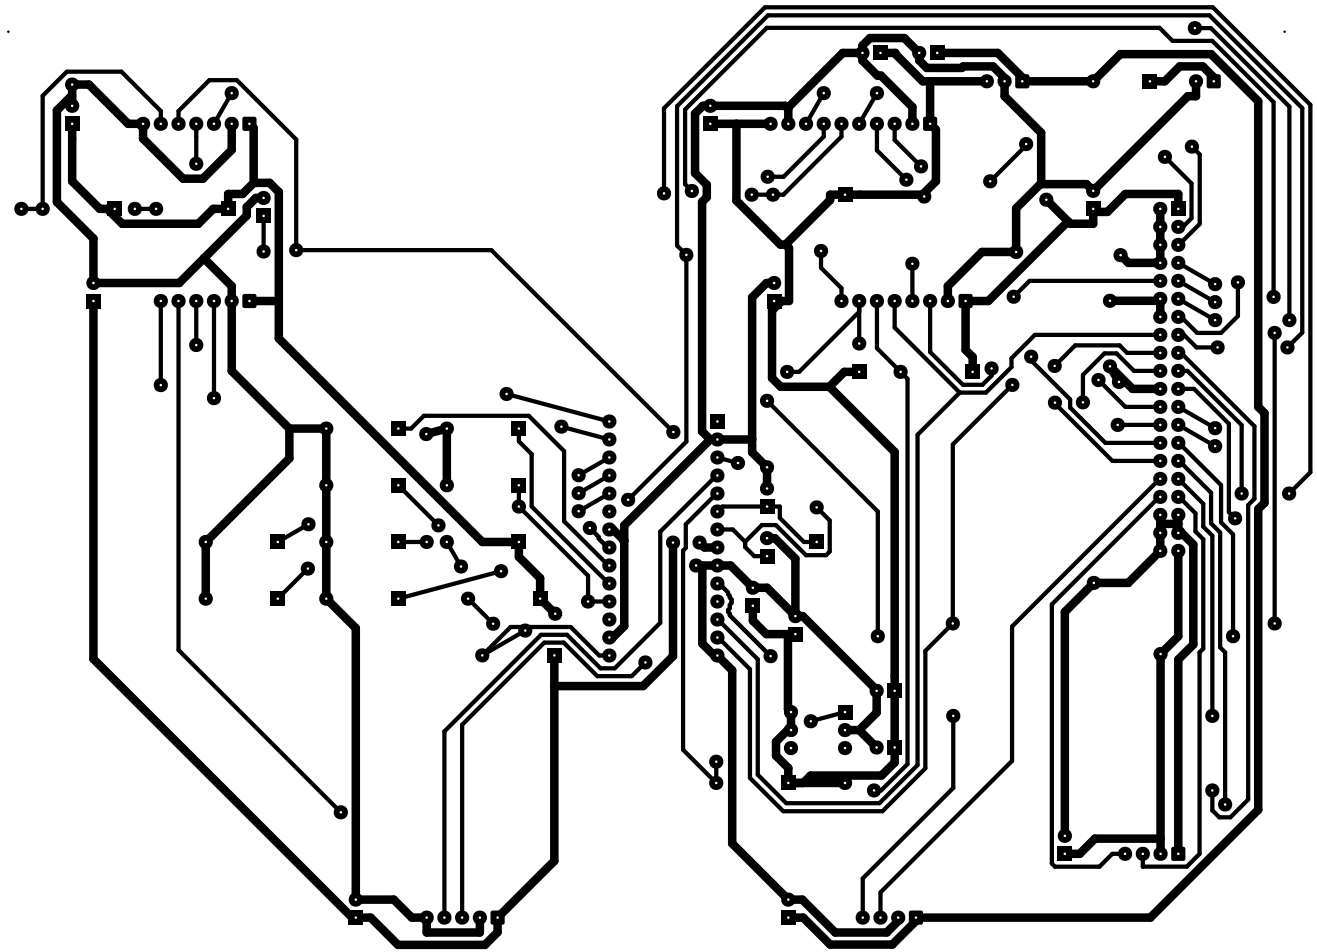
[picture p86: figure]

LP-D0 prototype | A4 | CAD/print checks only; not physically fabricated

Compare every etched path with this view; use page 1 for drill diameters and symbols.

Keep the designated top edge at the top when turning the board over.
