ha-homelab/ha-radio-hub/hardware/wiring.csv

net | from | to | level_or_protocol | condition
POE | External802.3atPSE | PS1_PoE_IN | 37-57V_Ethernet | Active_PoE_only
UPLINK | PS1_DATA_OUT | SW1_PORT1 | Ethernet | No_power_injection_after_splitter
PI_LAN | SW1_PORT2 | U1_RJ45 | Ethernet | Short_patch
ESP_LAN | SW1_PORT3 | U4_RJ45 | 100BASE-T | Short_patch
5V_MAIN | PS1_DC5V | Fused_distribution | 5V | Polarity_and_current_verified
PI_POWER | Fused_distribution | U1_USB-C | 5V3A_branch | Adafruit4536_plus_C17_3A_load_test_pending
SW_POWER | Fused_distribution | SW1_DC_INPUT | 5V1A_branch | Verify_DC_plug_polarity_and_revision
ESP_POWER | Fused_distribution | U4_USB-C | 5V1A_branch | FIT0993_plus_to5V_minus_toGND_one_power_source
RF_POWER | Fused_distribution | U8_MICRO_USB | 5V0.75A_branch | Compatibility_WiFi_variant_only_one_power_source
RADAR_POWER | Fused_distribution | U6_5V | 5V0.25-0.5A_branch | NOT3V3
ZIGBEE_USB | U1_USB2_PORT1 | U2_USB | USB2_DATA_AND_5V | Dedicated_Zigbee_NCP
THREAD_USB | U1_USB2_PORT2 | U3_USB | USB2_DATA_AND_5V | Dedicated_Thread_RCP
ZW_3V3 | U4_3V3 | U5_PIN1_3V3 | 3.3V | Verify_ZAC93_revision
ZW_GND | U4_GND | U5_PIN6_GND | GND | Pin9_is_also_GND
ZW_TX | U4_GPIO17 | U5_PIN8_RX | 3.3V_UART115200_8N1 | No_camera
ZW_RX | U5_PIN10_TX | U4_GPIO18 | 3.3V_UART115200_8N1 | No_camera
RADAR_GND | U4_GND | U6_GND | GND | Common_ground_after_splitter
RADAR_TX | U4_GPIO4 | U6_RX | 3.3V_UART256000_8N1 | NO_MICROSD_CARD
RADAR_RX | U6_TX | U4_GPIO5 | 3.3V_UART256000_8N1 | NO_MICROSD_CARD
I2C_3V3 | U4_3V3 | U7_VIN | 3.3V | Adafruit_BME680_QT
I2C_GND | U4_GND | U7_GND | GND | 10-20cm_harness_initial
I2C_SDA | U4_GPIO1 | U7_SDA_SDI | 3.3V_I2C100kHz | No_camera
I2C_SCL | U4_GPIO2 | U7_SCL_SCK | 3.3V_I2C100kHz | No_camera
W5500_CLK | U4_GPIO13 | U4_W5500_SCLK | Onboard | No_external_wire
W5500_MOSI | U4_GPIO11 | U4_W5500_MOSI | Onboard | No_external_wire
W5500_MISO | U4_W5500_MISO | U4_GPIO12 | Onboard | No_external_wire
W5500_CS | U4_GPIO14 | U4_W5500_CS | Onboard | No_external_wire
W5500_IRQ | U4_W5500_INT | U4_GPIO10 | Onboard | No_external_wire
W5500_RST | U4_GPIO9 | U4_W5500_RST | Onboard | No_external_wire
RF_3V3 | U8_3V3 | U9_VCC | 3.3V | Existing_NodeMCU_CC1101_only
RF_GND | U8_GND | U9_GND | GND | Existing_NodeMCU_CC1101_only
RF_CLK | U8_GPIO14_D5 | U9_SCLK | 3.3V_SPI | Existing_NodeMCU_CC1101_only
RF_MOSI | U8_GPIO13_D7 | U9_MOSI | 3.3V_SPI | Existing_NodeMCU_CC1101_only
RF_MISO | U9_MISO | U8_GPIO12_D6 | 3.3V_SPI | Existing_NodeMCU_CC1101_only
RF_CS | U8_GPIO15_D8 | U9_CS | 3.3V_SPI | Existing_NodeMCU_CC1101_only
RF_GDO0 | U8_GPIO4_D2 | U9_GDO0 | 3.3V_bidirectional | Compatibility_WiFi_variant_only_half_duplex_shared_RX_TX
RF_ETH_LAN | SW1_PORT4 | U10_RJ45 | 100BASE-T | Wired_RF_variant_only
RF_ETH_POWER | Fused_distribution | U10_USB-C | 5V1A_branch | FIT0993_wired_RF_only_one_power_source
RF_ETH_3V3 | U10_3V3 | U9_VCC | 3.3V | Wired_RF_variant_only
RF_ETH_GND | U10_GND | U9_GND | GND | Wired_RF_variant_only
RF_ETH_CLK | U10_GPIO7 | U9_SCLK | 3.3V_SPI3 | Wired_RF_variant_only_no_SD_camera
RF_ETH_MOSI | U10_GPIO8 | U9_MOSI | 3.3V_SPI3 | Wired_RF_variant_only_no_SD_camera
RF_ETH_MISO | U9_MISO | U10_GPIO6 | 3.3V_SPI3 | Wired_RF_variant_only_no_SD_camera
RF_ETH_CS | U10_GPIO15 | U9_CS | 3.3V_SPI3 | Wired_RF_variant_only_no_SD_camera
RF_ETH_TX | U10_GPIO4 | U9_GDO0 | 3.3V_open_drain_TX | Wired_RF_variant_only_4k7_pullup_to3V3
RF_ETH_RX | U9_GDO2 | U10_GPIO5 | 3.3V_pulse_RX | Wired_RF_variant_only_no_SD_camera
RF_ETH_TX_PULLUP | U10_3V3 | R1_4k7_to_GPIO4_GDO0 | 3.3V | Wired_RF_variant_only_never5V
