ha-homelab/ha-radio-hub/hardware/low-power/integrated/fabrication/README.txt

LP-I0 ENGINEERING REVIEW EXPORTS. NOT RELEASED FOR FABRICATION.
See ../release-status.json and ../README.md. No hardware qualification has been performed.
