ha-homelab/ha-radio-hub/hardware/external-antenna/images/mc2b-assembled-concept.png

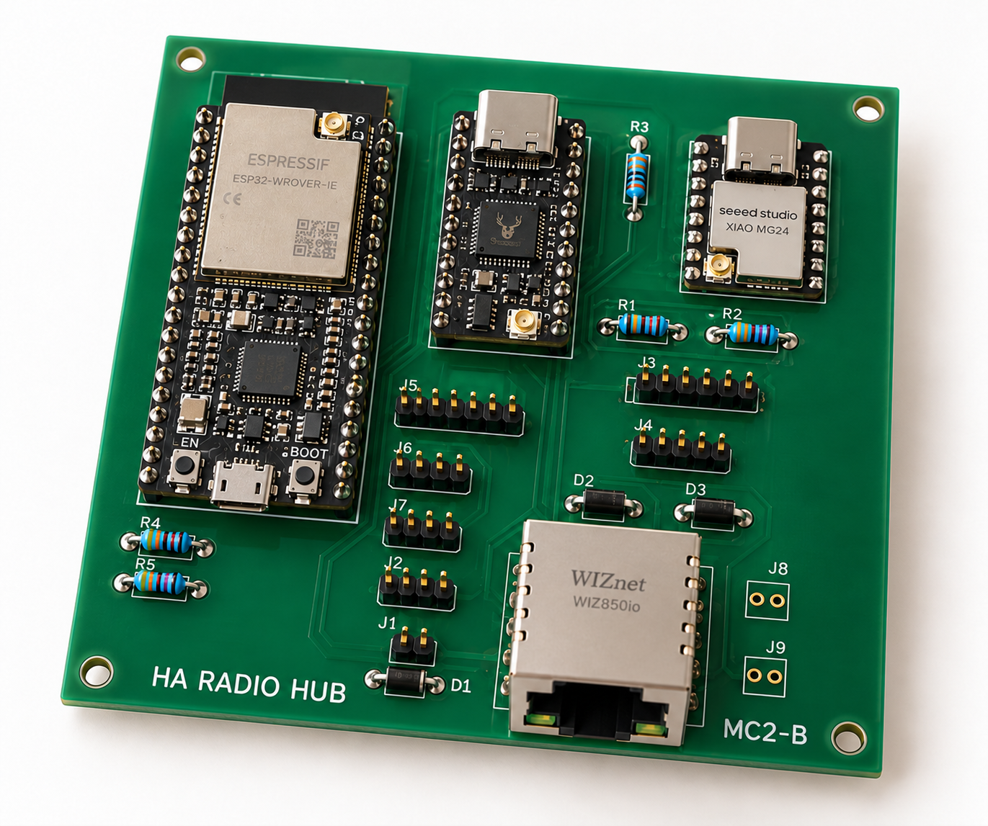
hardware/external-antenna/images/mc2b-assembled-concept.png
