ha-homelab/ha-radio-hub/hardware/module-carrier/cad/assembly-bottom.png

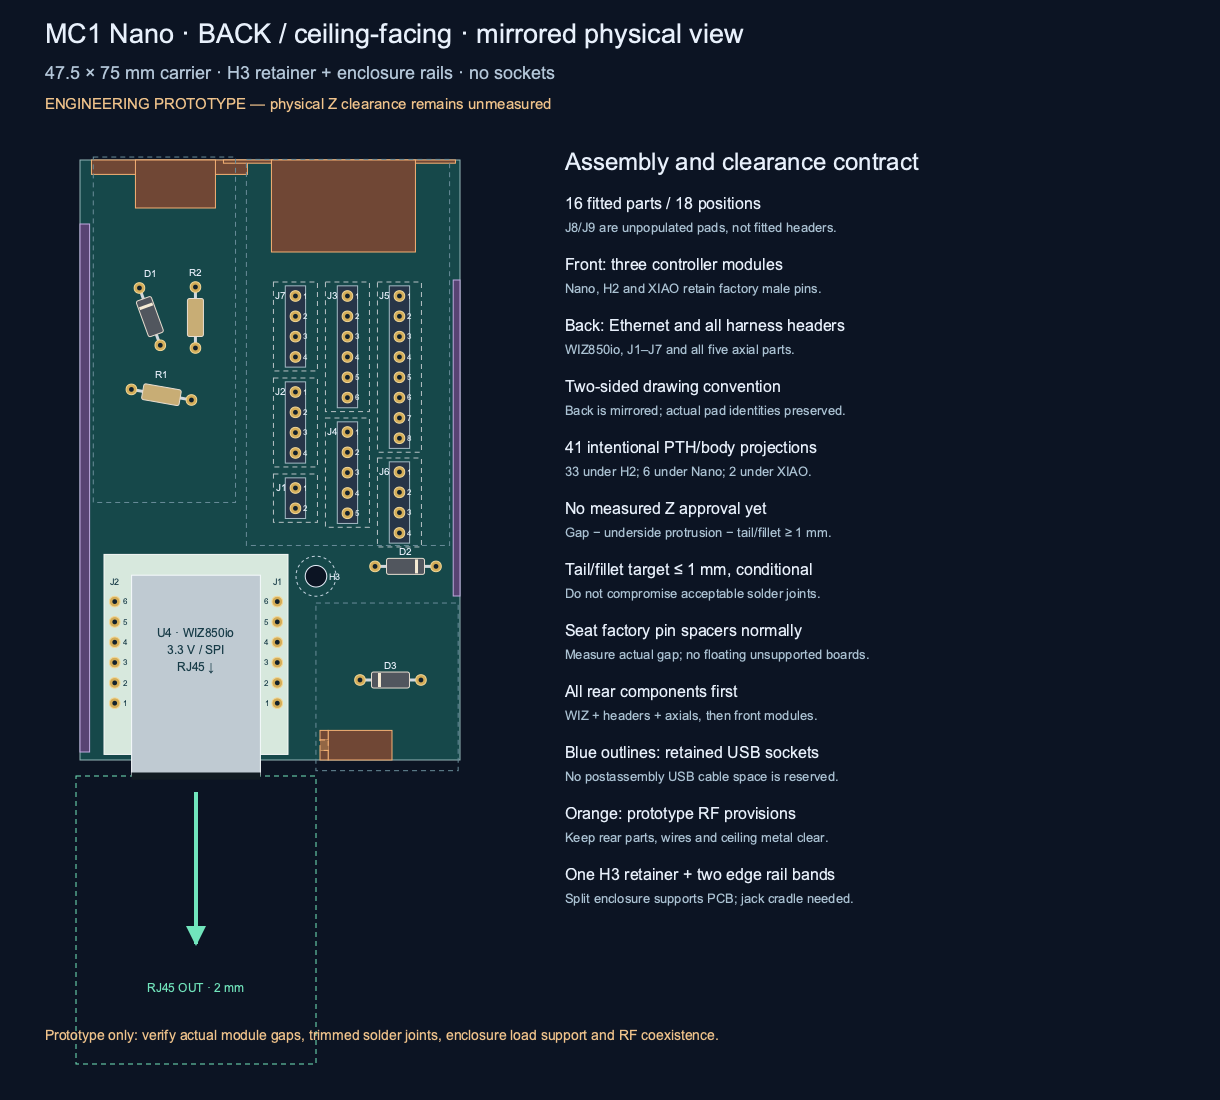
hardware/module-carrier/cad/assembly-bottom.png
