ha-homelab/ha-radio-hub/hardware/module-carrier/cad/assembly-top.png

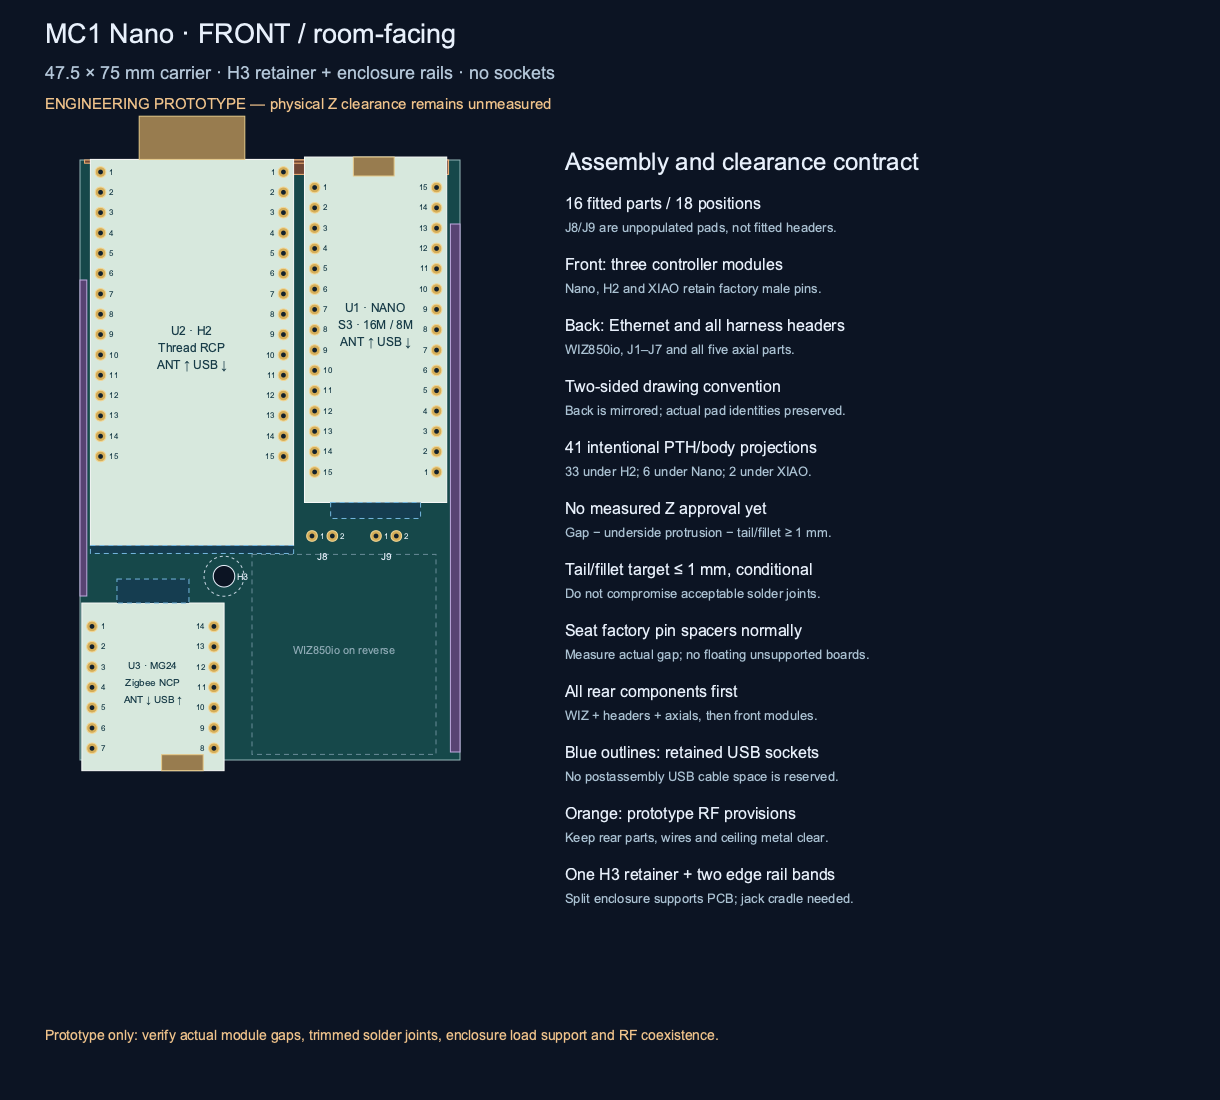
hardware/module-carrier/cad/assembly-top.png
