ha-homelab/ha-radio-hub/hardware/module-carrier/images/history/pre-nano/ui-assembly.jpg

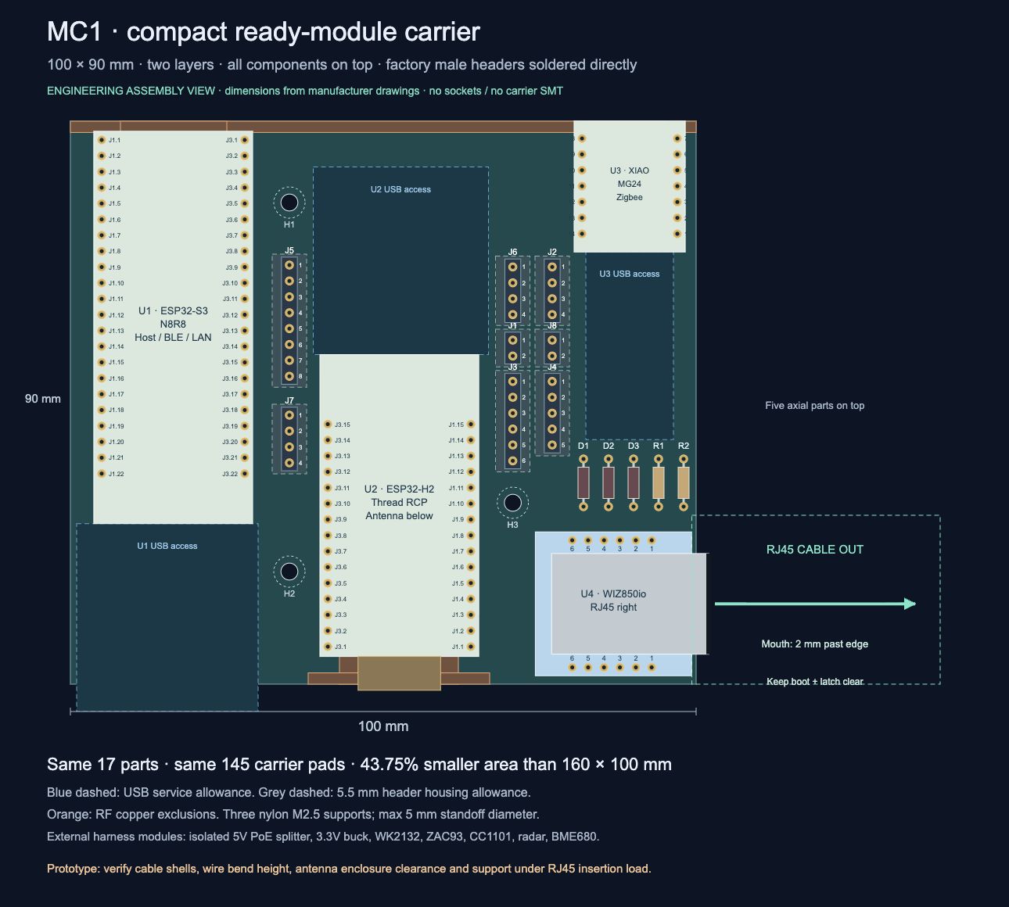
hardware/module-carrier/images/history/pre-nano/ui-assembly.jpg
