ha-homelab/ha-radio-hub/hardware/module-carrier/images/history/pre-nano/ui-wiring.jpg

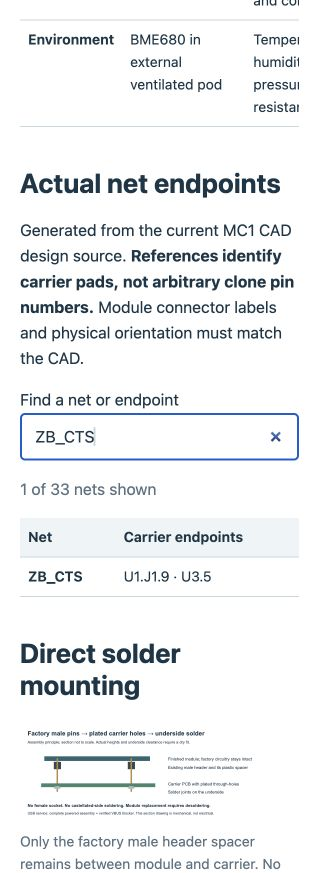
hardware/module-carrier/images/history/pre-nano/ui-wiring.jpg
