ha-homelab/ha-radio-hub/hardware/module-carrier/images/history/single-sided-65x75/assembly-top.png

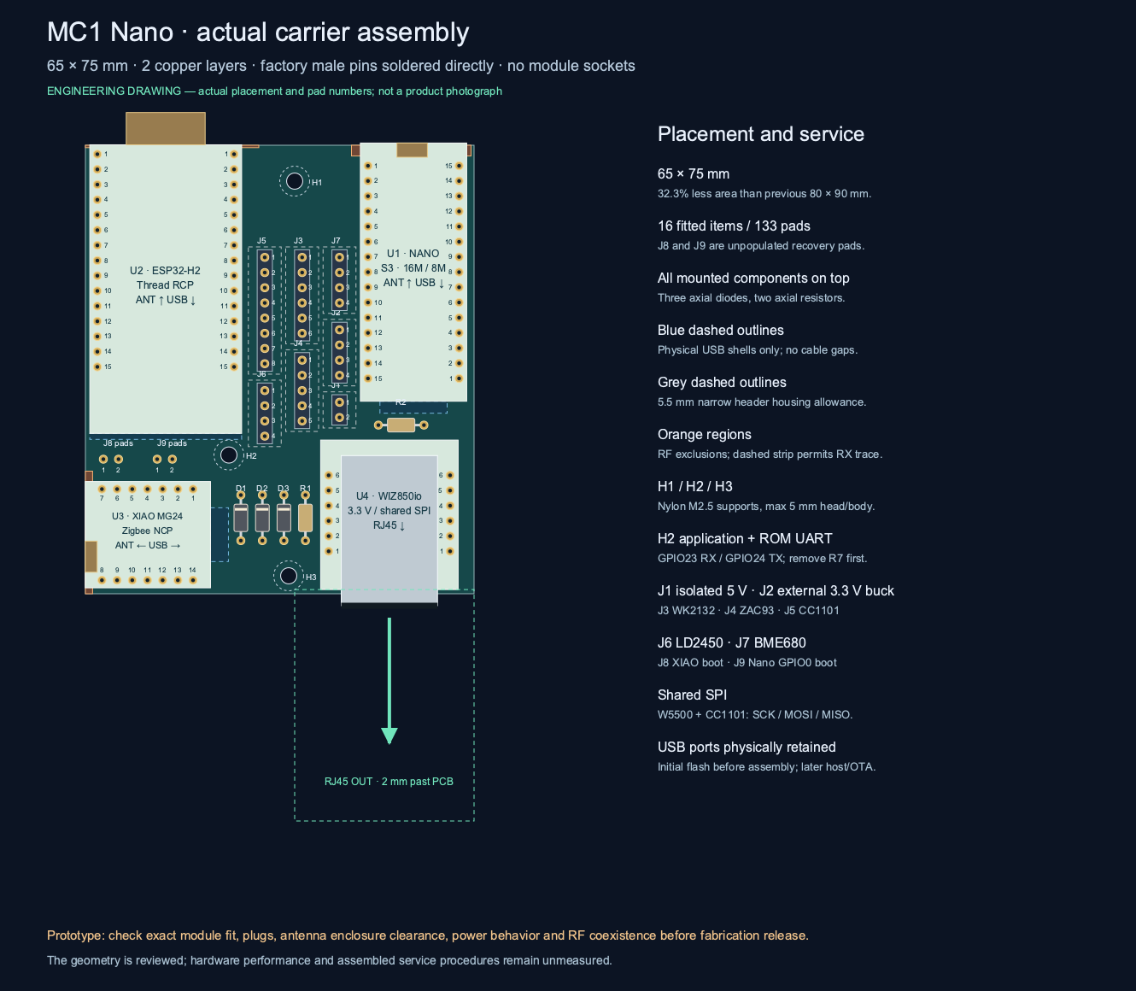
hardware/module-carrier/images/history/single-sided-65x75/assembly-top.png
