ha-homelab/ha-radio-hub/hardware/module-carrier/images/history/usb-service-80x90/ui-assembly.jpg

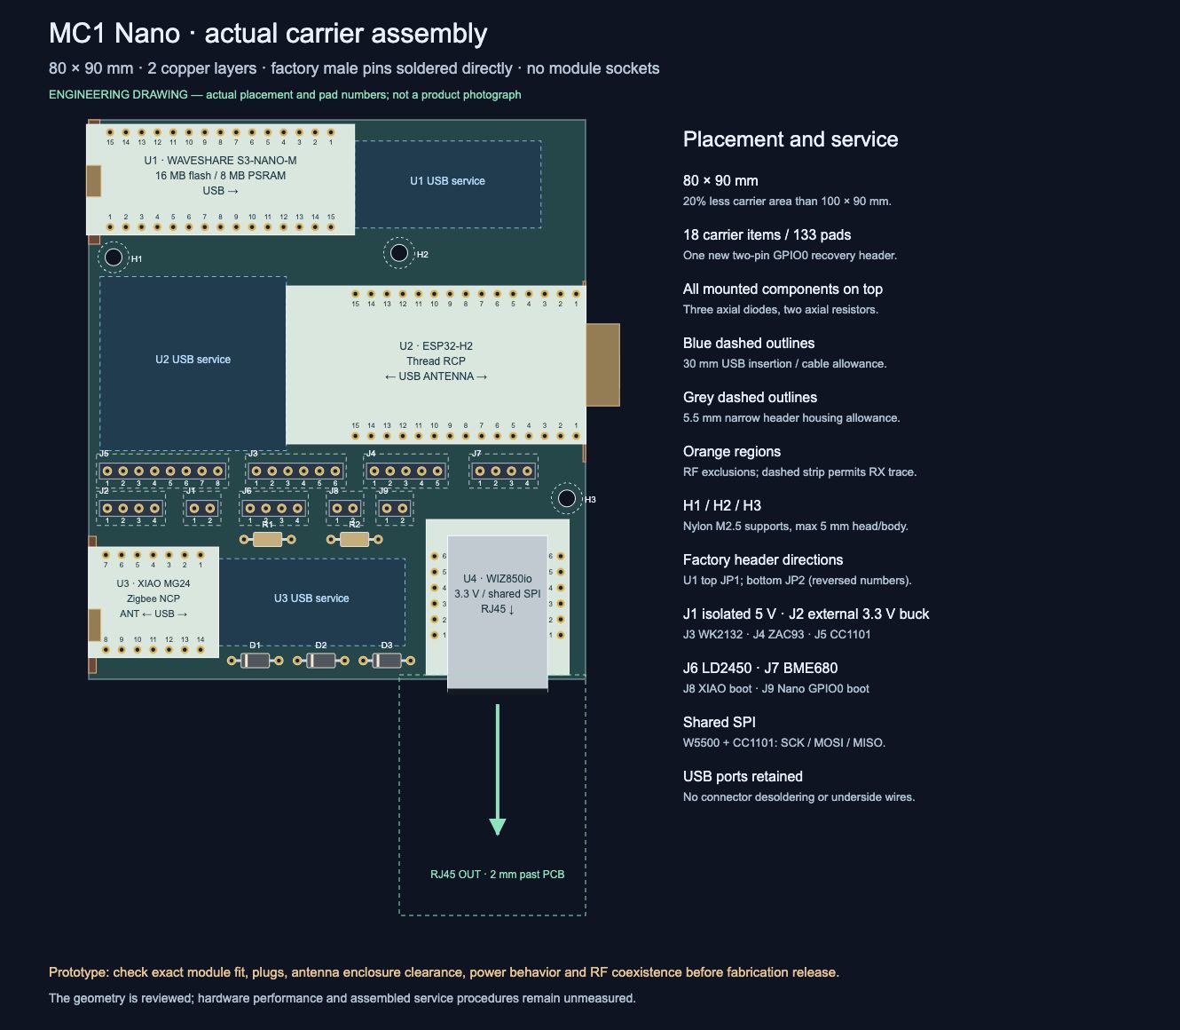
hardware/module-carrier/images/history/usb-service-80x90/ui-assembly.jpg
