ha-homelab/ha-radio-hub/hardware/module-carrier/images/mc1-assembled-concept.png

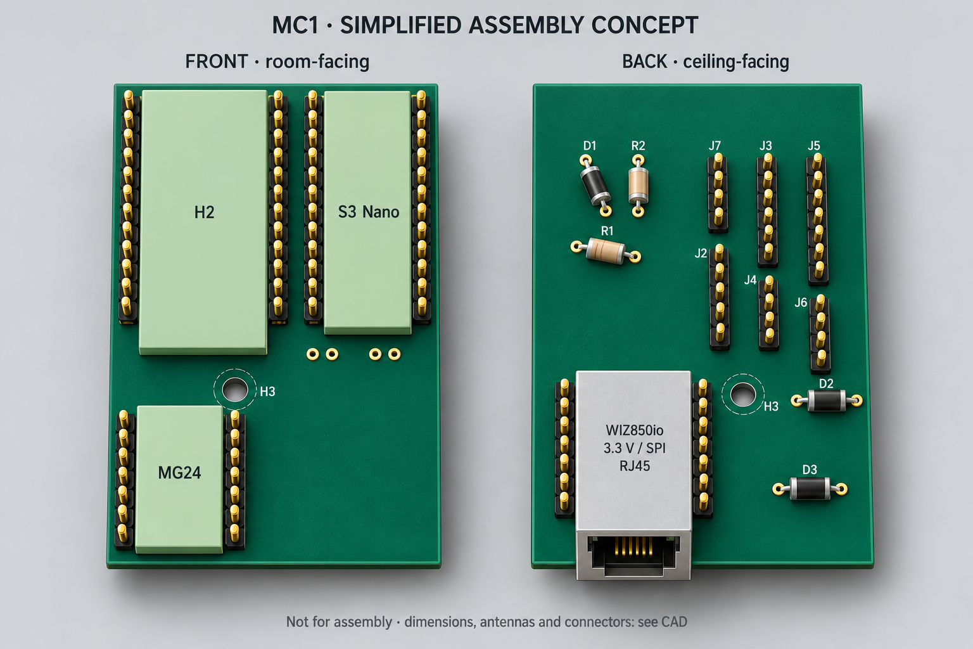
hardware/module-carrier/images/mc1-assembled-concept.png
