ha-homelab/ha-radio-hub/hardware/module-carrier/images/ui-assembly-back.jpg

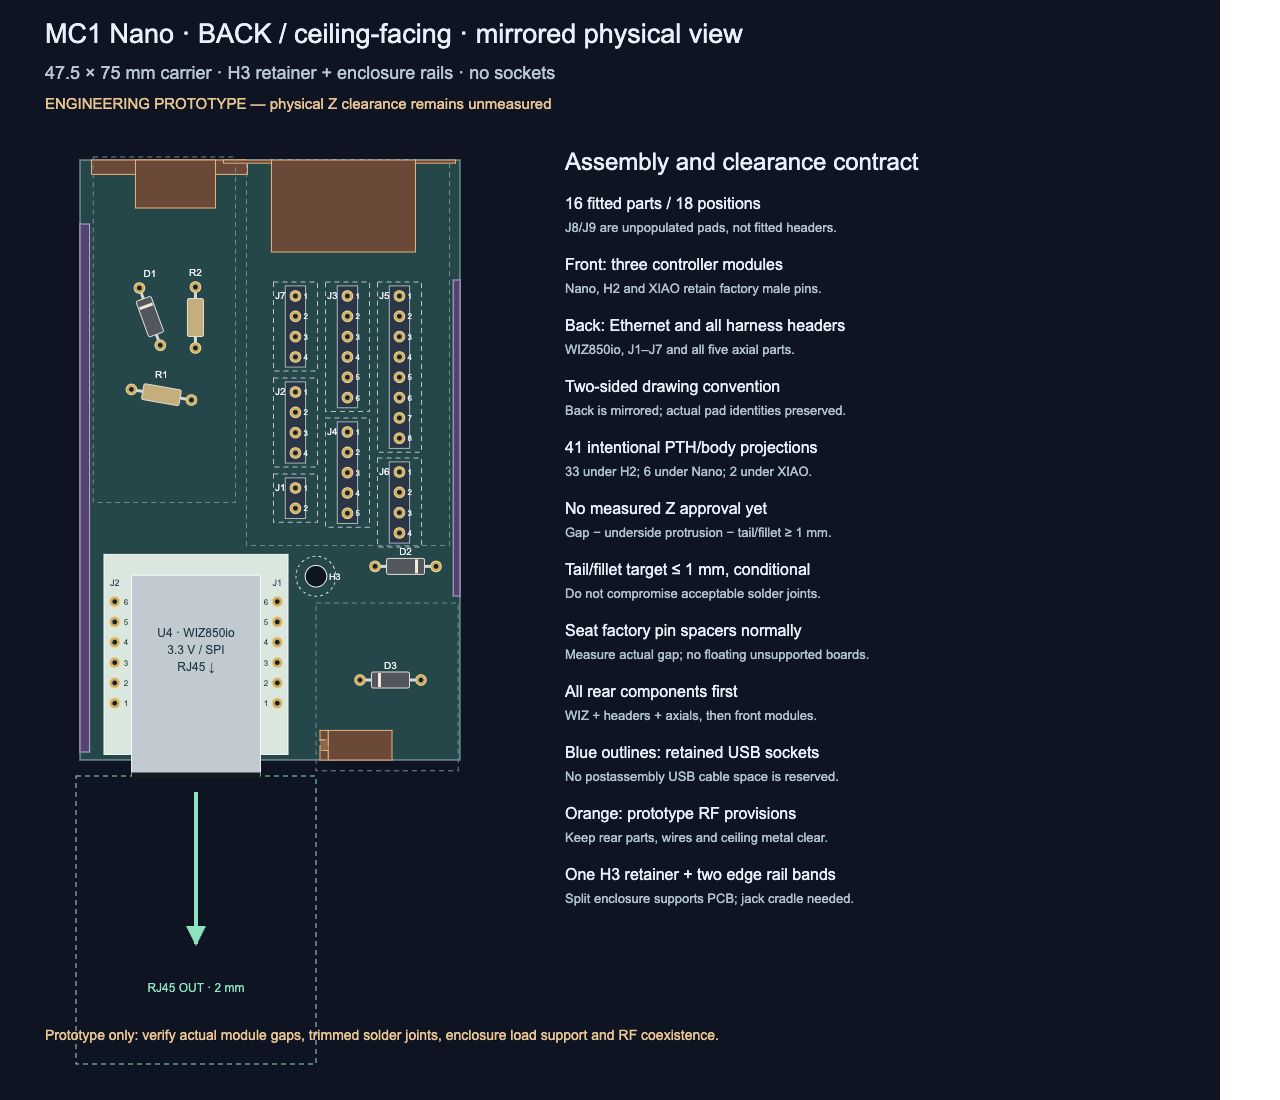
hardware/module-carrier/images/ui-assembly-back.jpg
