ha-homelab/ha-radio-hub/hardware/module-carrier/images/ui-assembly.jpg

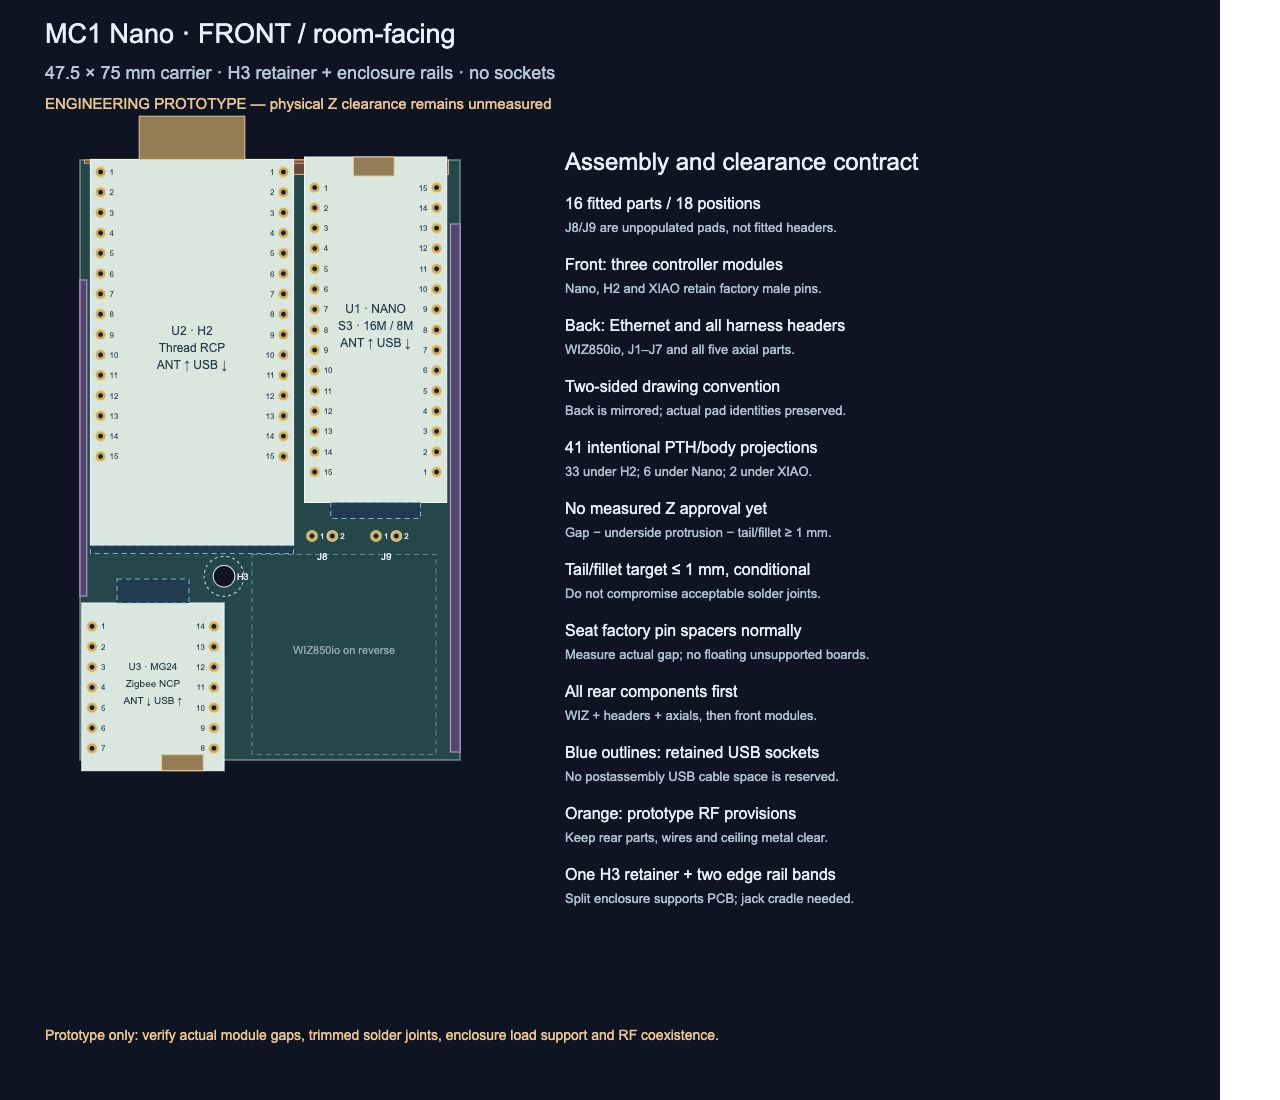
hardware/module-carrier/images/ui-assembly.jpg
