ha-homelab/ha-radio-hub/hardware/module-carrier/studies/square-layout/cad-candidate/assembly-top.png

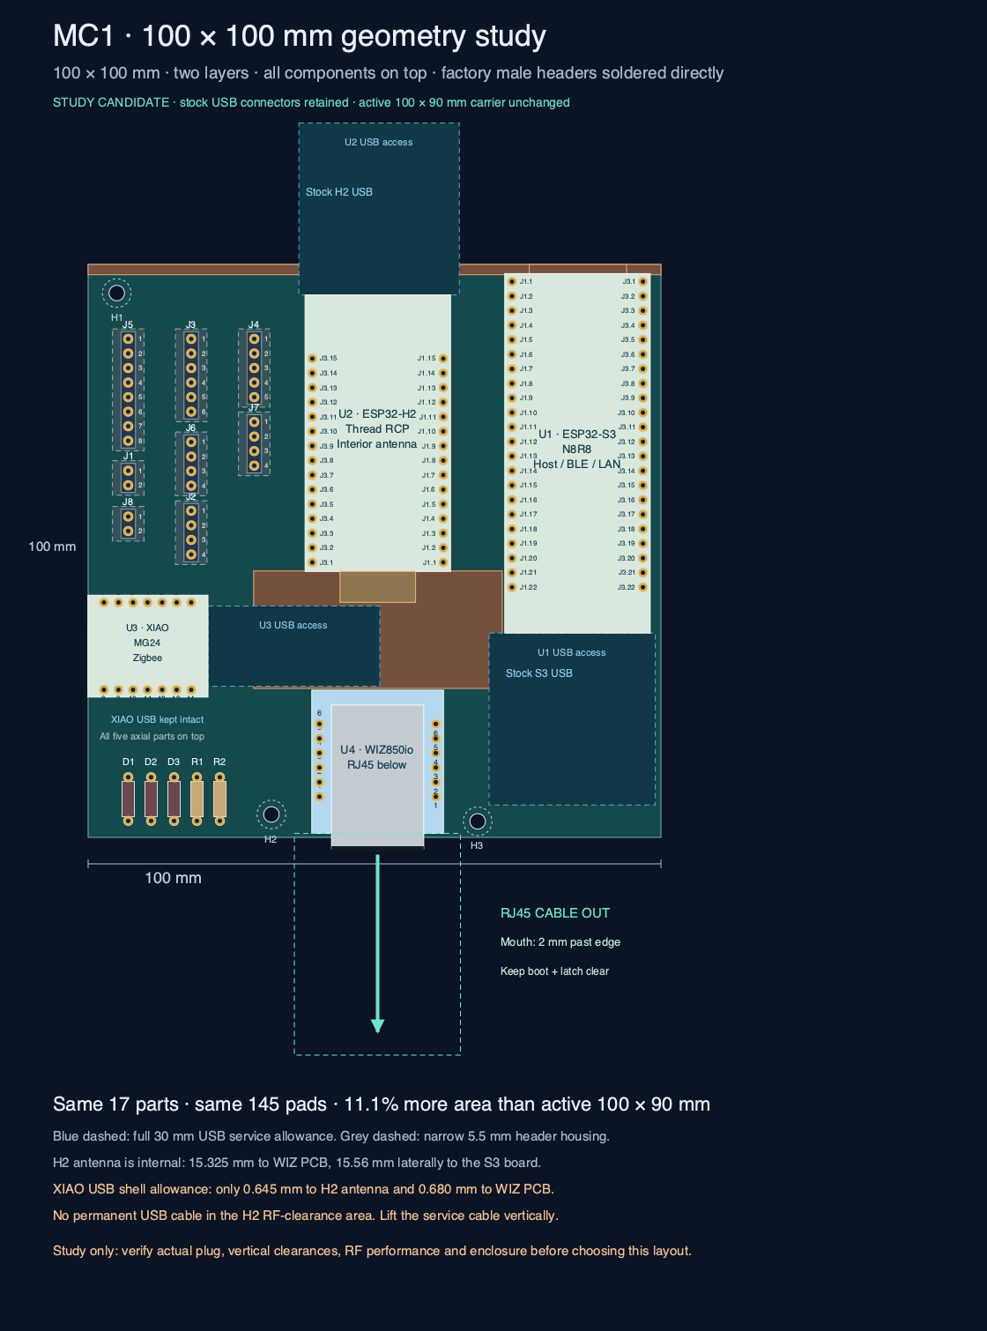
hardware/module-carrier/studies/square-layout/cad-candidate/assembly-top.png
