ha-homelab/ha-radio-hub/mechanical/module-carrier/external-antenna-prototype/assembly-preview.png

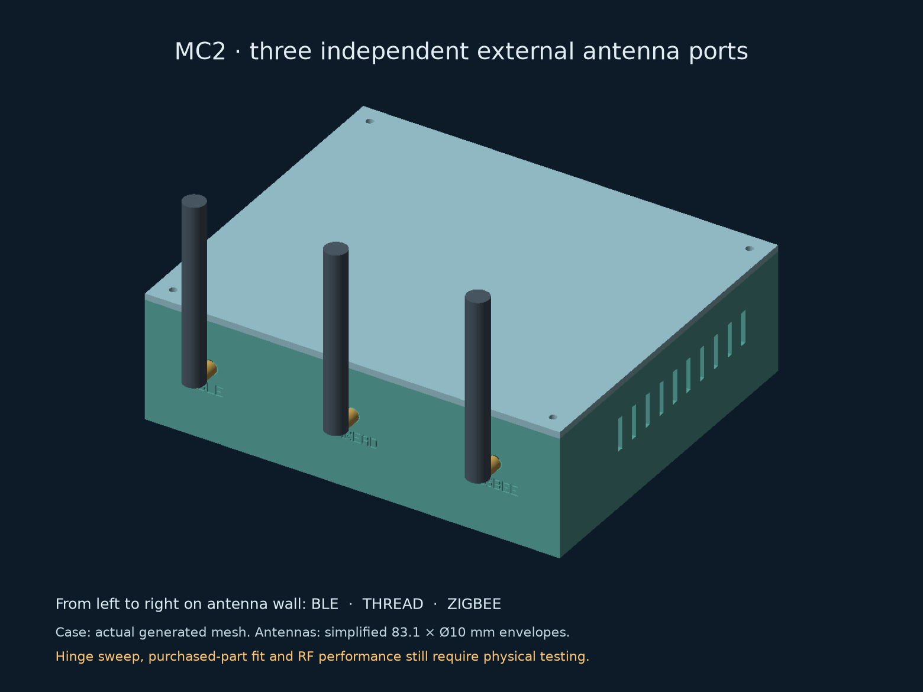
mechanical/module-carrier/external-antenna-prototype/assembly-preview.png
