ha-homelab/ha-radio-hub/hardware/low-power/diy/print/calibration.pdf

# Print calibration - actual size / 100%

Measure on paper; disable fit/shrink, duplex, toner saving and all mirror options.

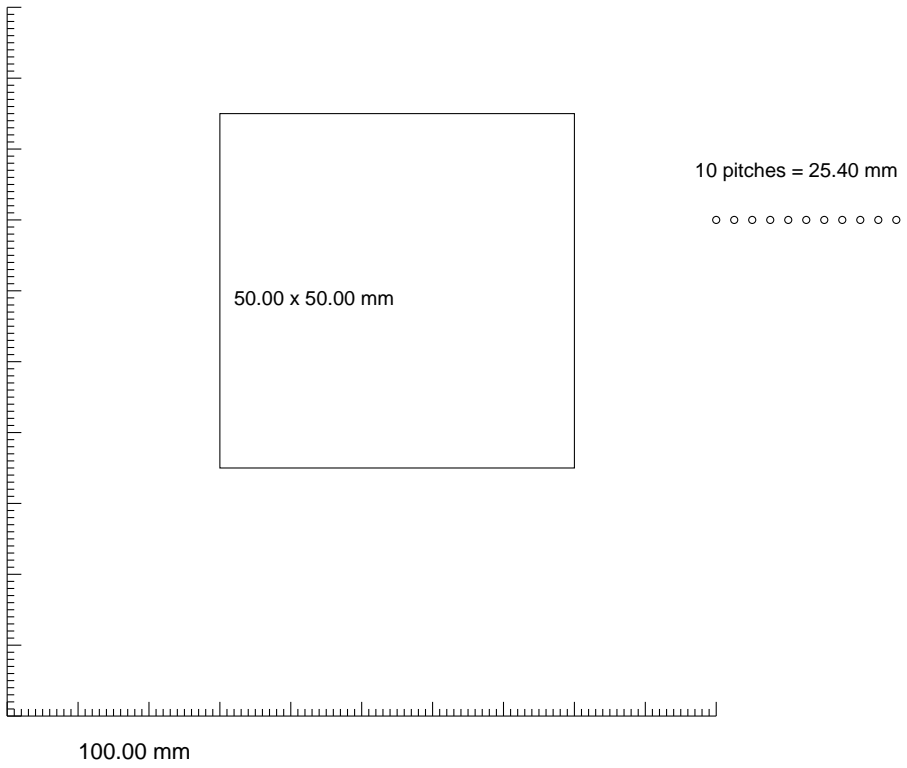
[picture p100: figure]
10 pitches = 25.40 mm

LP-D0 prototype | A4 | CAD/print checks only; not physically fabricated

100.00 mm axes; project target +/-0.20 mm

Transfer coupon: cut around this strip only; the rulers are not an etch mask.

Pad coupon: 2.0 mm copper lands; drill 1.1 mm after etching to test the annular ring.

Printed: one dot at left, two at right. On copper after transfer: two left, one right.

The coupon is sacrificial and electrically separate from the carrier.

Pass only after etching: no opens, bridges, pinholes or unacceptable undercut.
