ha-homelab/ha-radio-hub/hardware/external-antenna/fabrication/history/README.md

# Original MC2-D package — before S1 artwork

This directory preserves the original fabrication bytes from source commit
[`c94f16b1570c615d1c400a59f70c64162099bdf3`](https://github.com/ha-homelab/ha-radio-hub/commit/c94f16b1570c615d1c400a59f70c64162099bdf3).

- [Original Gerber ZIP](MC2-D-original-gerbers.zip): SHA-256
  `5898031673d14b154e9d25f597b3b8dc522e52fdb28e6391236c0a5b4490a7fe`.
- [Original manifest](MC2-D-original-manifest.json): preserved verbatim; its
  `archive` field records the original filename `MC2-D-prototype-gerbers.zip`.
  Only the copy's filename changed here.

The original manifest binds the original source commit's files, not current
main. These are historical reference files. For a new batch use the
[current S1 package](../README.md) and current manifest. Hardware revision,
component compatibility and enclosure geometry remain MC2-D.
