ha-homelab/ha-radio-hub/hardware/module-carrier/images/history/pre-nano/mc1-board-top.png

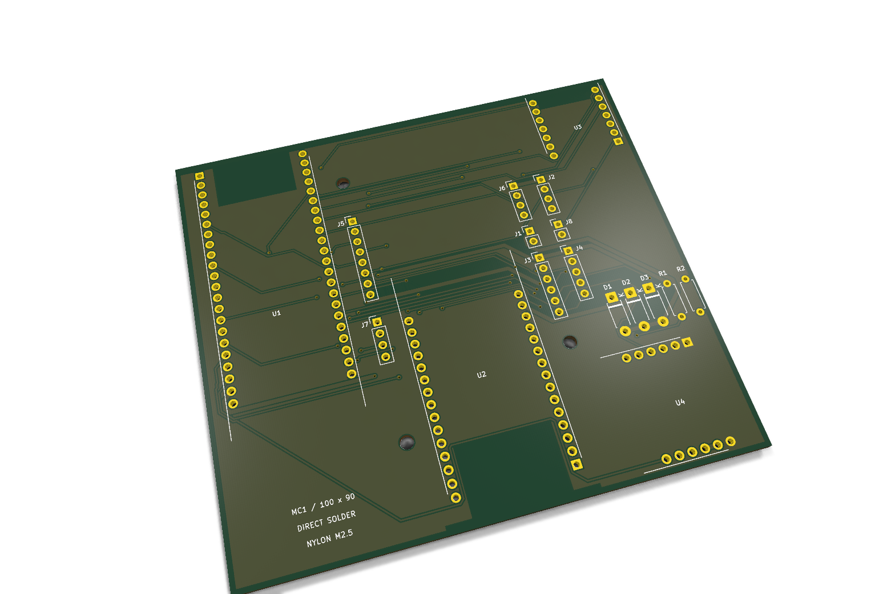
hardware/module-carrier/images/history/pre-nano/mc1-board-top.png
