ha-homelab/ha-radio-hub/hardware/module-carrier/images/history/pre-nano/ui-pcb.jpg

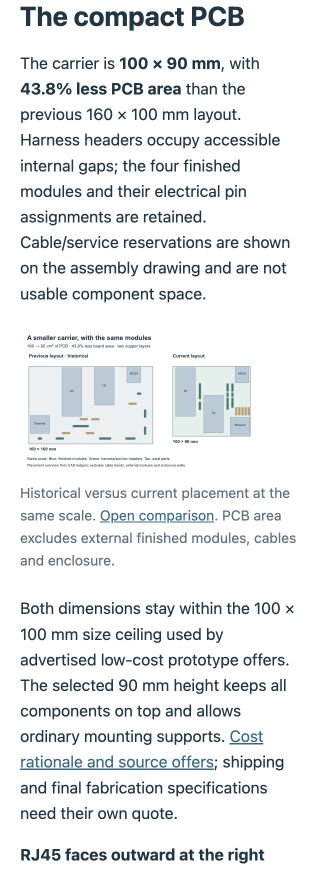
hardware/module-carrier/images/history/pre-nano/ui-pcb.jpg
