ha-homelab/ha-radio-hub/hardware/module-carrier/images/history/single-sided-65x75/mc1-board-bottom.png

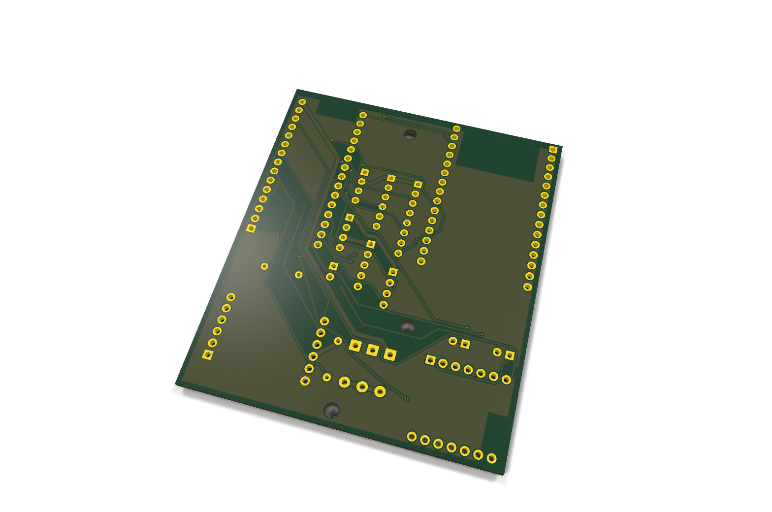
hardware/module-carrier/images/history/single-sided-65x75/mc1-board-bottom.png
