ha-homelab/ha-radio-hub/hardware/module-carrier/images/history/single-sided-65x75/ui-pcb.jpg

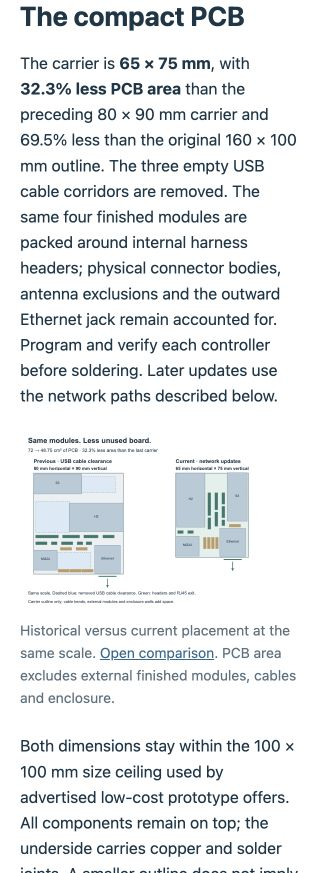
hardware/module-carrier/images/history/single-sided-65x75/ui-pcb.jpg
