ha-homelab/ha-radio-hub/hardware/external-antenna/cad/schematic.pdf

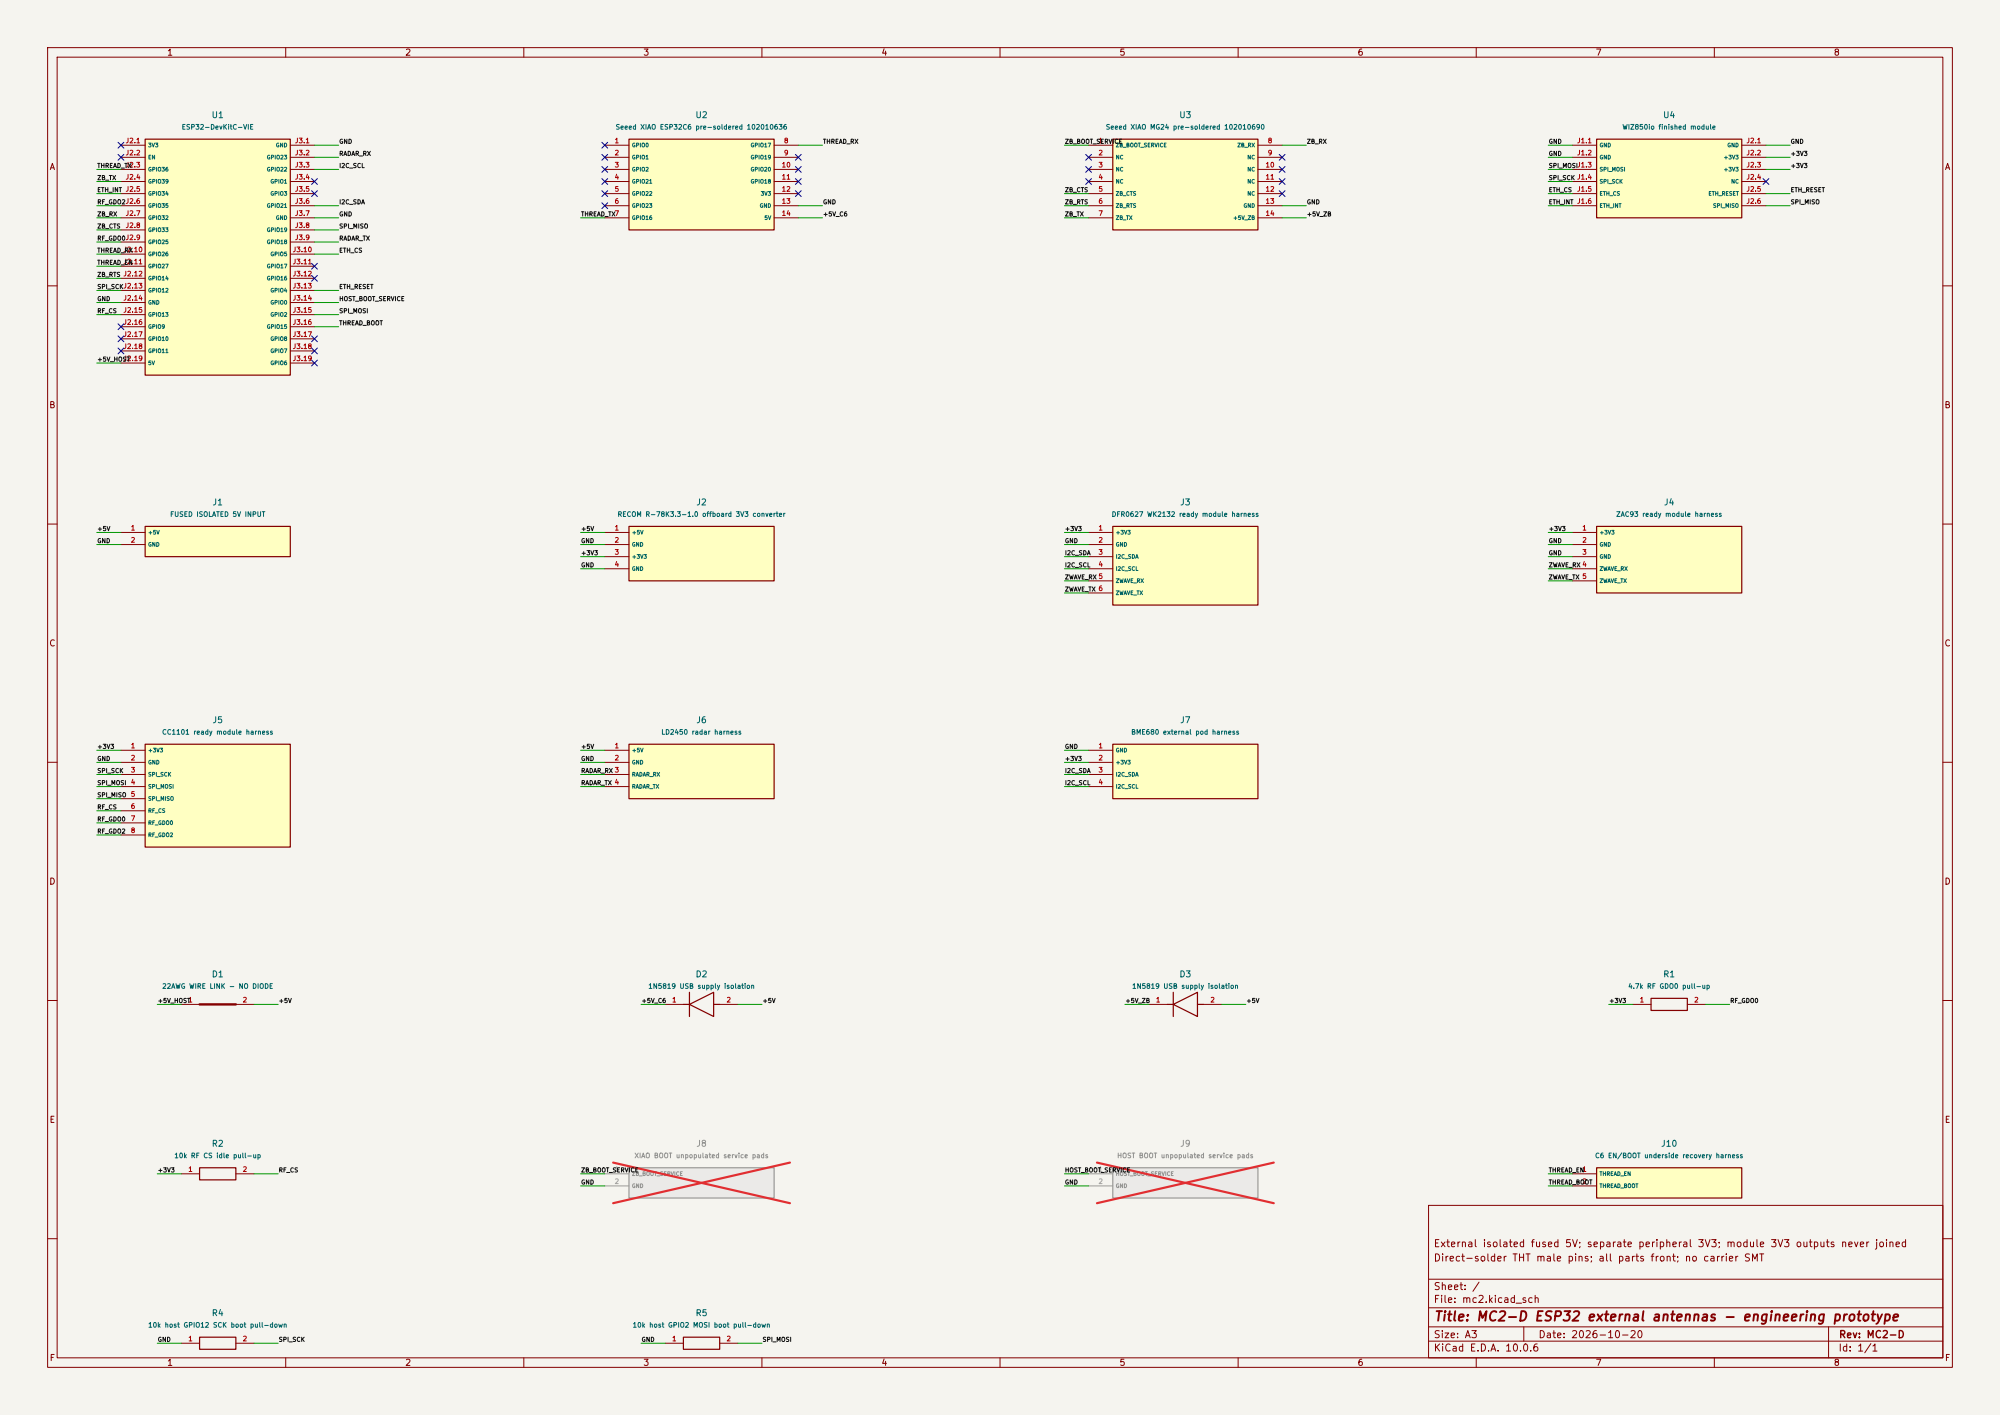
[picture p107: page 1]

Seeed XIAO ESP32C6 pre-soldered 102010636

Seeed XIAO MG24 pre-soldered 102010690

22AWG WIRE LINK - NO DIODE

HOST BOOT unpopulated service pads

C6 EN/BOOT underside recovery harness

10k RF CS idle pull-up

External isolated fused 5V; separate peripheral 3V3; module 3V3 outputs never joined
Direct-solder THT male pins; all parts front; no carrier SMT

Sheet: /
File: mc2.kicad_sch
Title: MC2-D ESP32 external antennas - engineering prototype

10k host GPIO12 SCK boot pull-down

10k host GPIO2 MOSI boot pull-down

Size: A3 | Rev: MC2-D | F Date: 2026-10-20
KiCad E.D.A. 10.0.6 | Id: 1/1
