ha-homelab/ha-radio-hub/hardware/module-carrier/cad/schematic.pdf

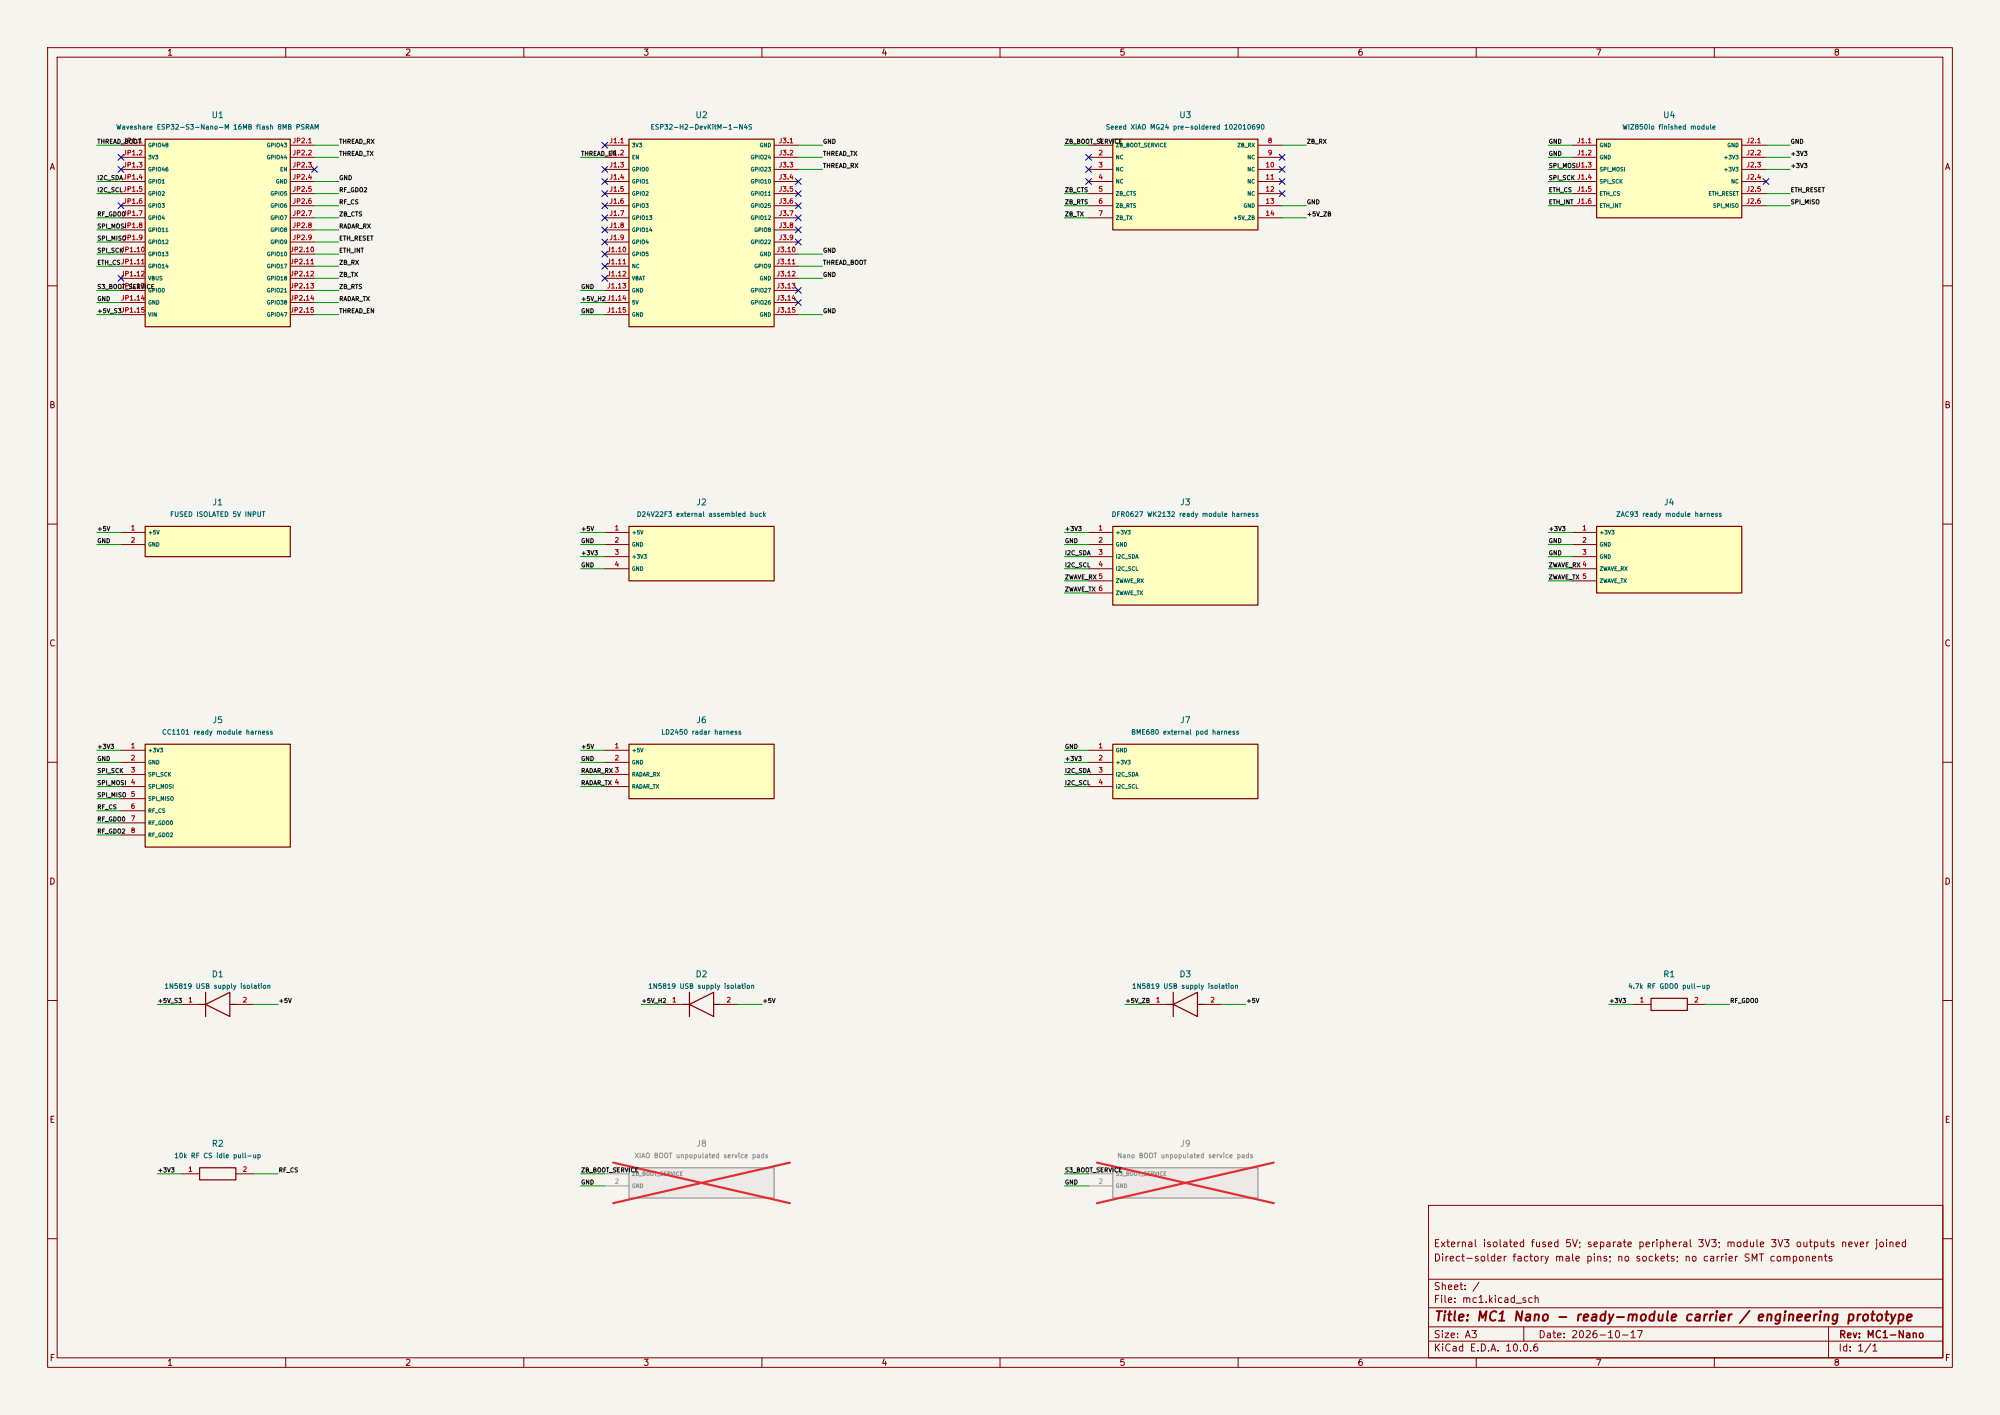
[picture p108: page 1]

Waveshare ESP32-S3-Nano-M 16MB flash 8MB PSRAM

Seeed XIAO MG24 pre-soldered 102010690

External isolated fused 5V; separate peripheral 3V3; module 3V3 outputs never joined
Direct-solder factory male pins; no sockets; no carrier SMT components

Sheet: /
File: mc1.kicad_sch
Title: MC1 Nano - ready-module carrier / engineering prototype

Size: A3 | Rev: MC1-Nano | F Date: 2026-10-17
KiCad E.D.A. 10.0.6 | Id: 1/1
