ha-homelab/ha-radio-hub/hardware/low-power/diy/outputs/assembly-schematic.pdf

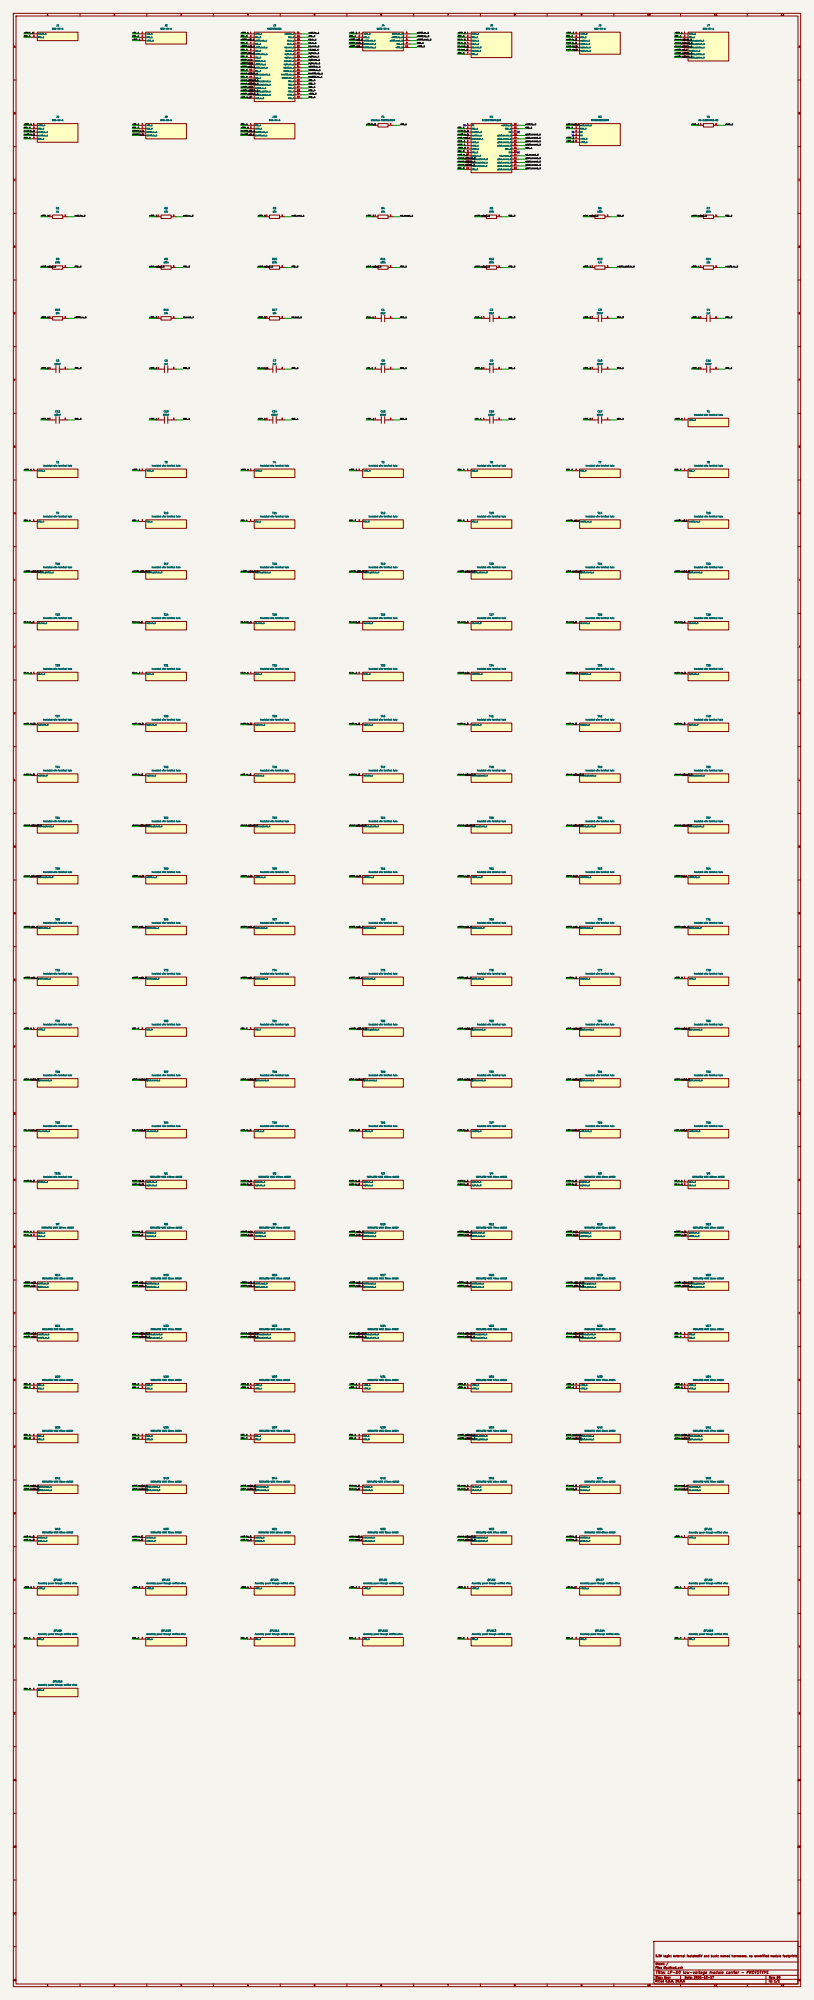
[picture p109: page 1]

Insulated wire terminal hole

Assembly power through verified wires

GND__2 +3V3__3

GND__3 +3V3__4

GND__7 +5V__1

GND__8 GND__1

3.3V logic; external isolated5V and buck; named harnesses, no unverified module footprints

Sheet: /
File: diy.kicad_sch
Title: LP-D0 low-voltage module carrier - PROTOTYPE

Size: User | Rev: D0 | AD Date: 2026-10-17
KiCad E.D.A. 10.0.6 | Id: 1/1
