ha-homelab/ha-radio-hub/hardware/low-power/carrier/outputs/schematic.pdf

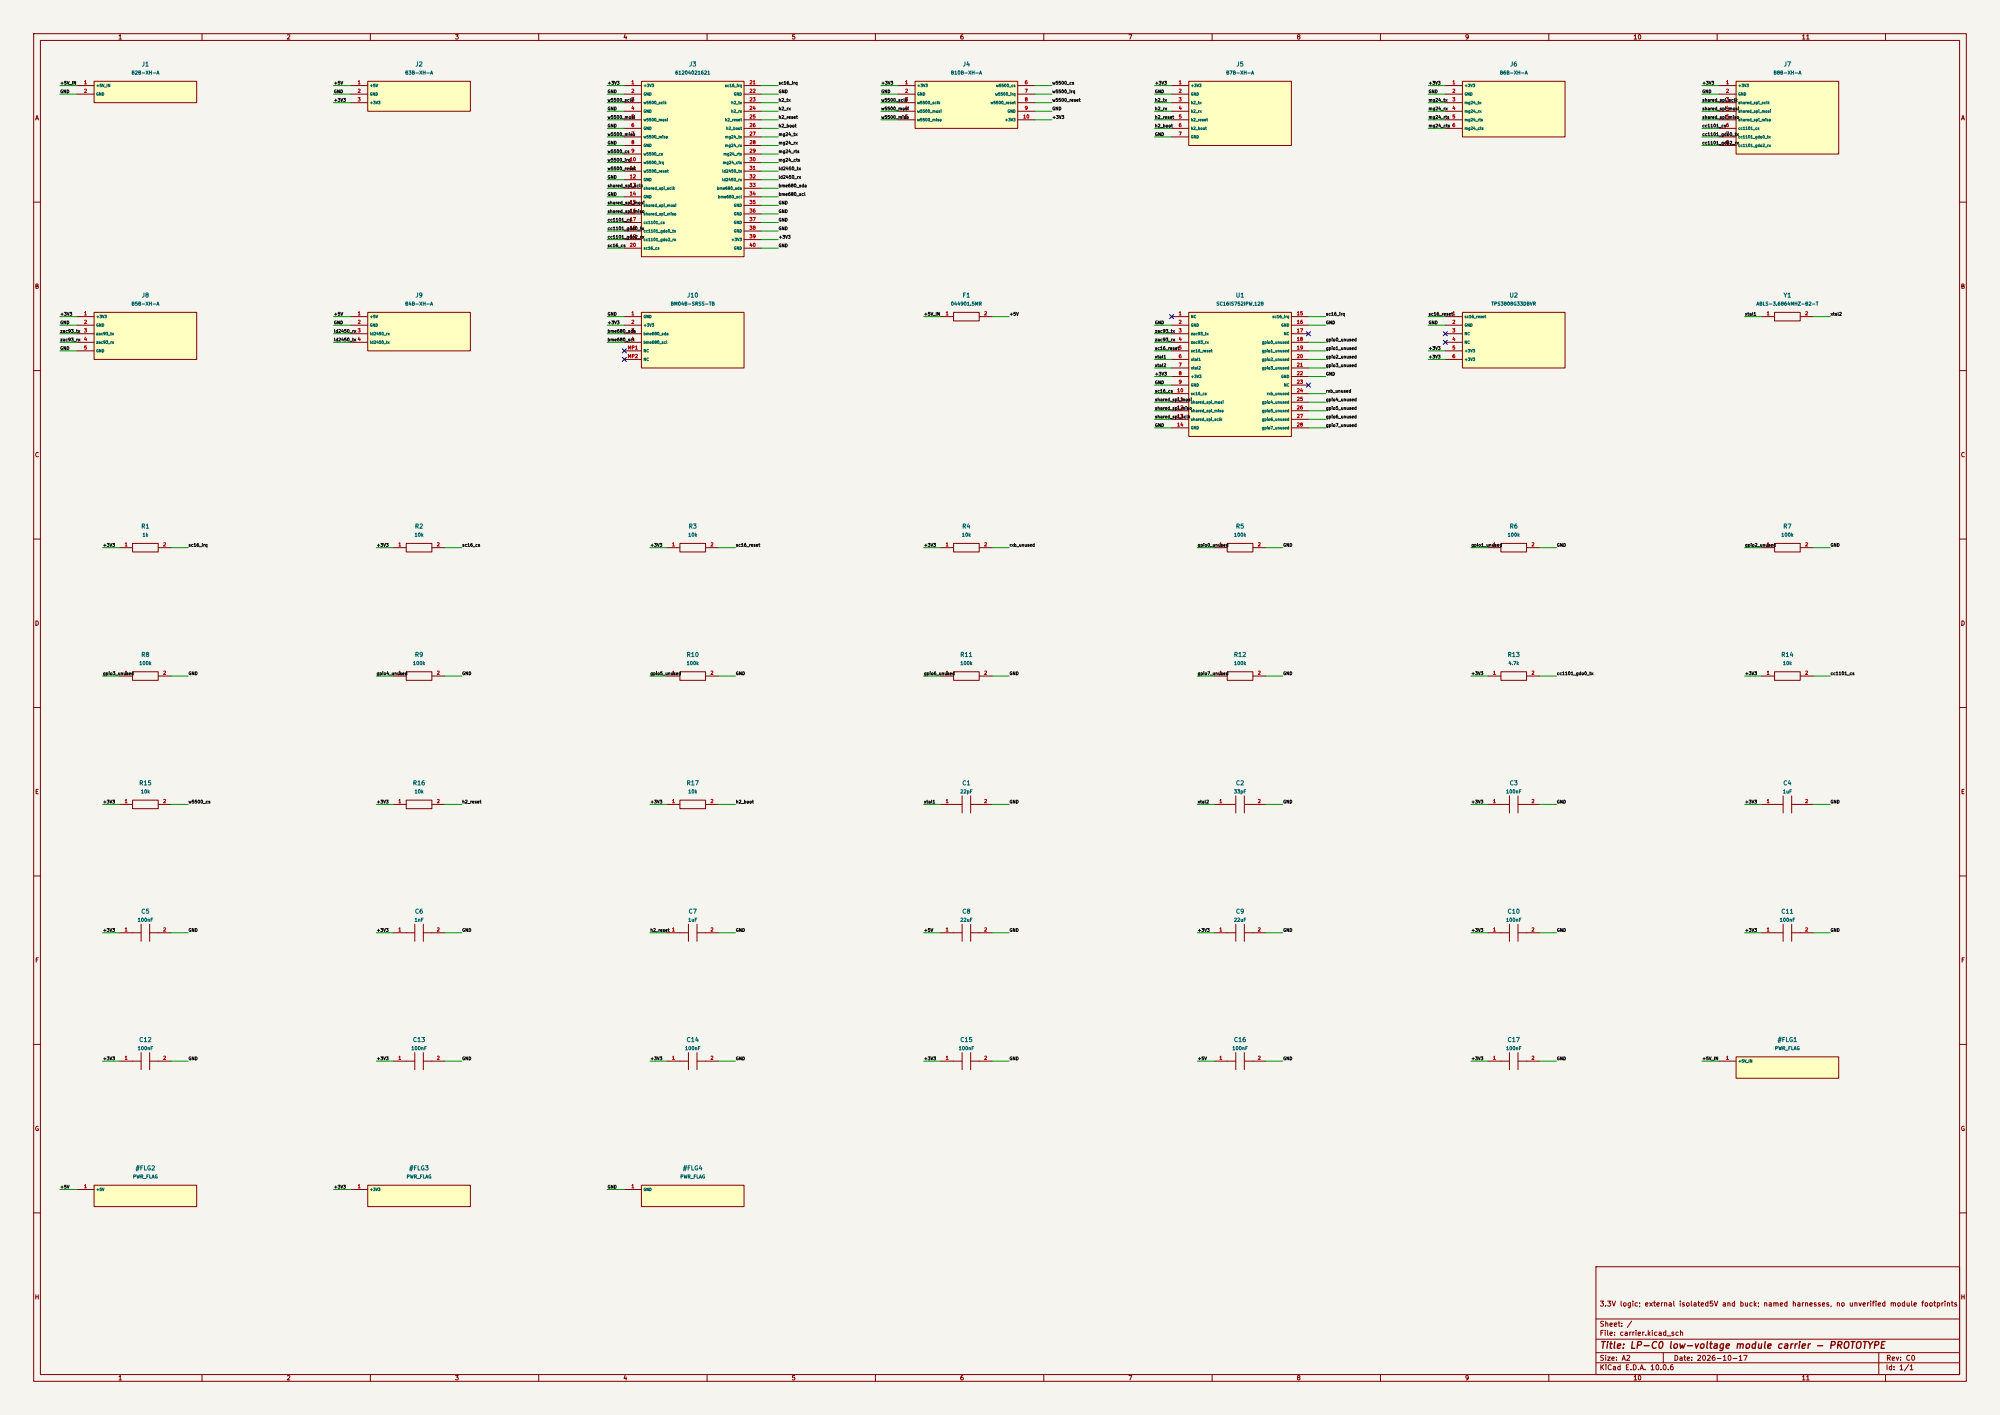
[picture p110: page 1]

w5500_sclk GND w5500_mosi GND w5500_miso GND w5500_irq w5500_reset GND

3.3V logic; external isolated5V and buck; named harnesses, no unverified module footprints

Sheet: /
File: carrier.kicad_sch
Title: LP-C0 low-voltage module carrier - PROTOTYPE

Size: A2 | Rev: C0
KiCad E.D.A. 10.0.6 | Id: 1/1
