ha-homelab/ha-radio-hub/hardware/low-power/integrated/fabrication/schematic.pdf

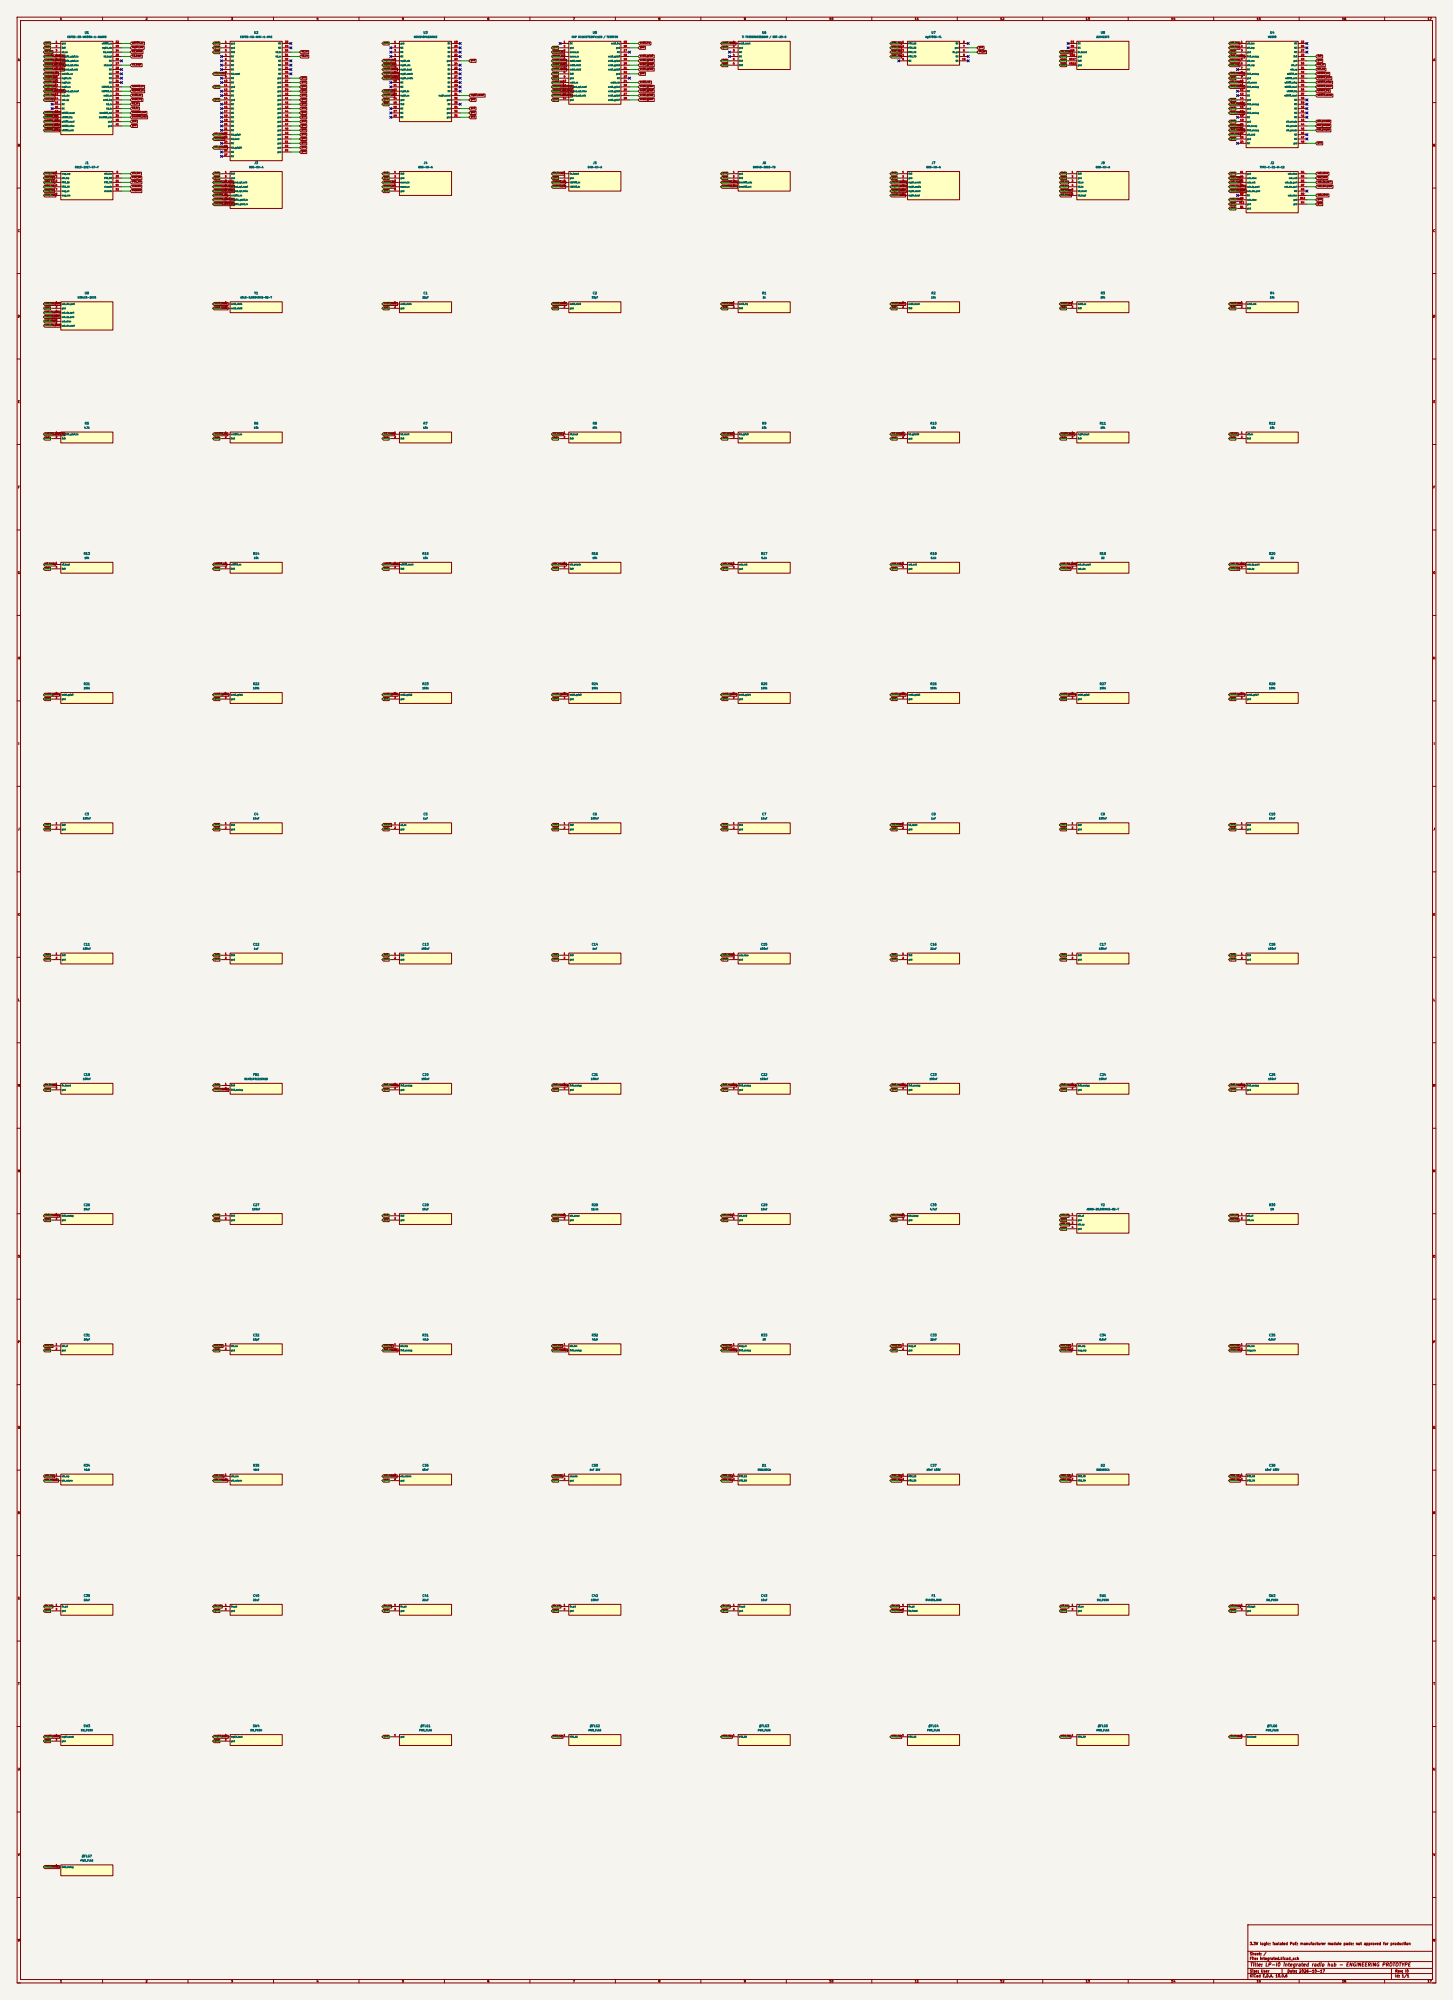
[picture p111: page 1]

3.3V logic; isolated PoE; manufacturer module pads; not approved for production

Sheet: /
File: integrated.kicad_sch
Title: LP-I0 integrated radio hub - ENGINEERING PROTOTYPE

Size: User | Rev: I0
KiCad E.D.A. 10.0.6 | Id: 1/1
