ha-homelab/ha-radio-hub/hardware/module-carrier/studies/square-layout/cad-candidate/schematic.pdf

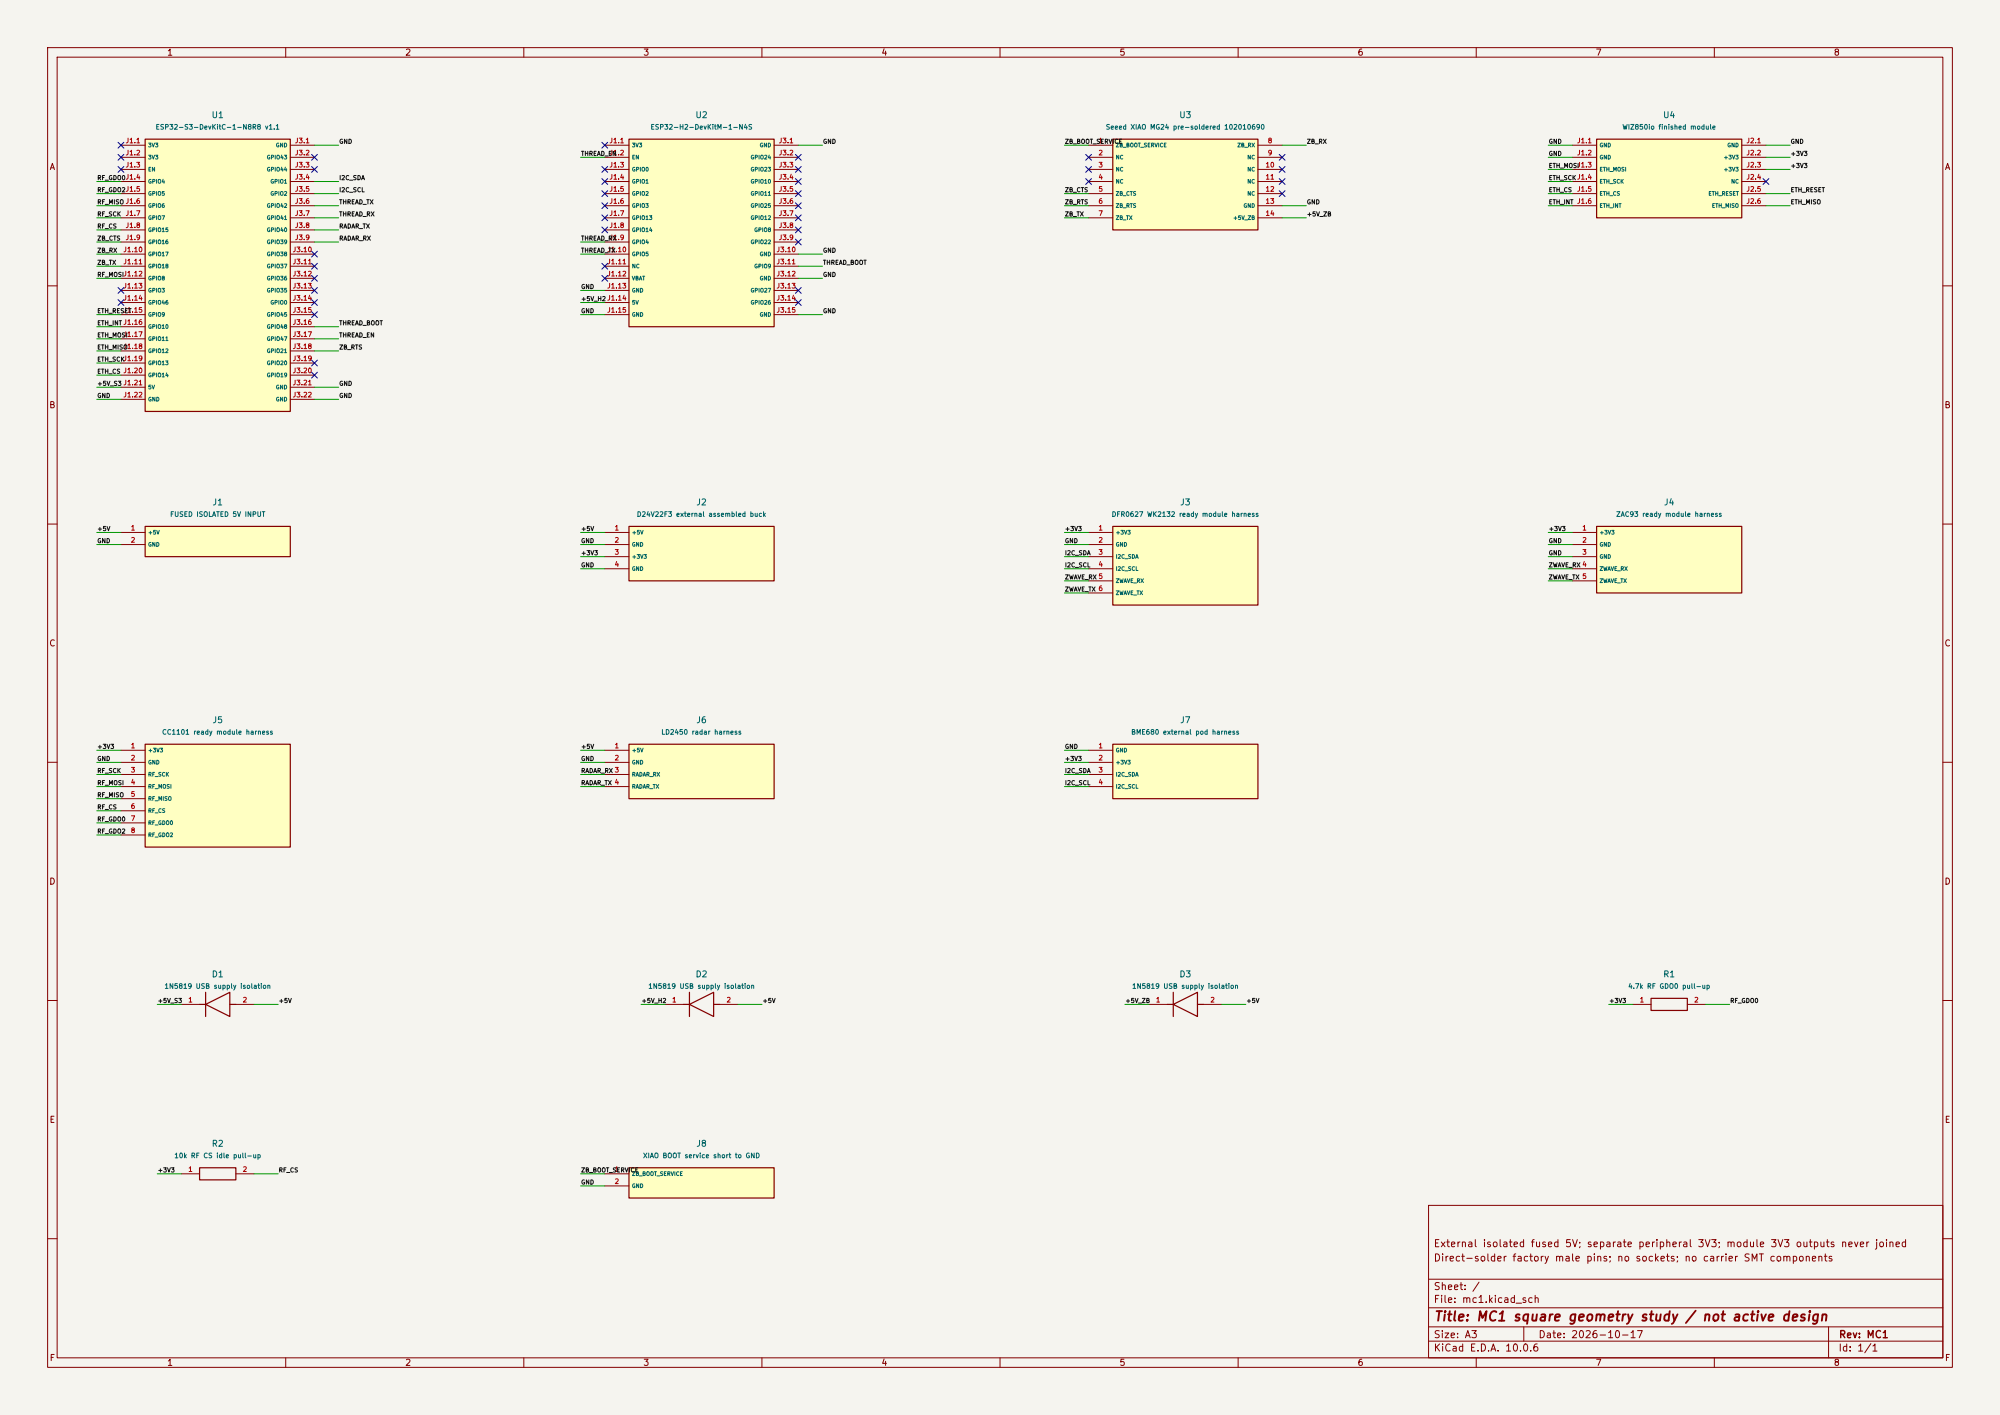
[picture p112: page 1]

Seeed XIAO MG24 pre-soldered 102010690

10k RF CS idle pull-up

XIAO BOOT service short to GND

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

Sheet: /
File: mc1.kicad_sch
Title: MC1 square geometry study / not active design

Size: A3 | Rev: MC1 | F Date: 2026-10-17
KiCad E.D.A. 10.0.6 | Id: 1/1
