ha-homelab/ha-radio-hub/hardware/low-power/carrier/mg24-adapter/outputs/schematic.pdf

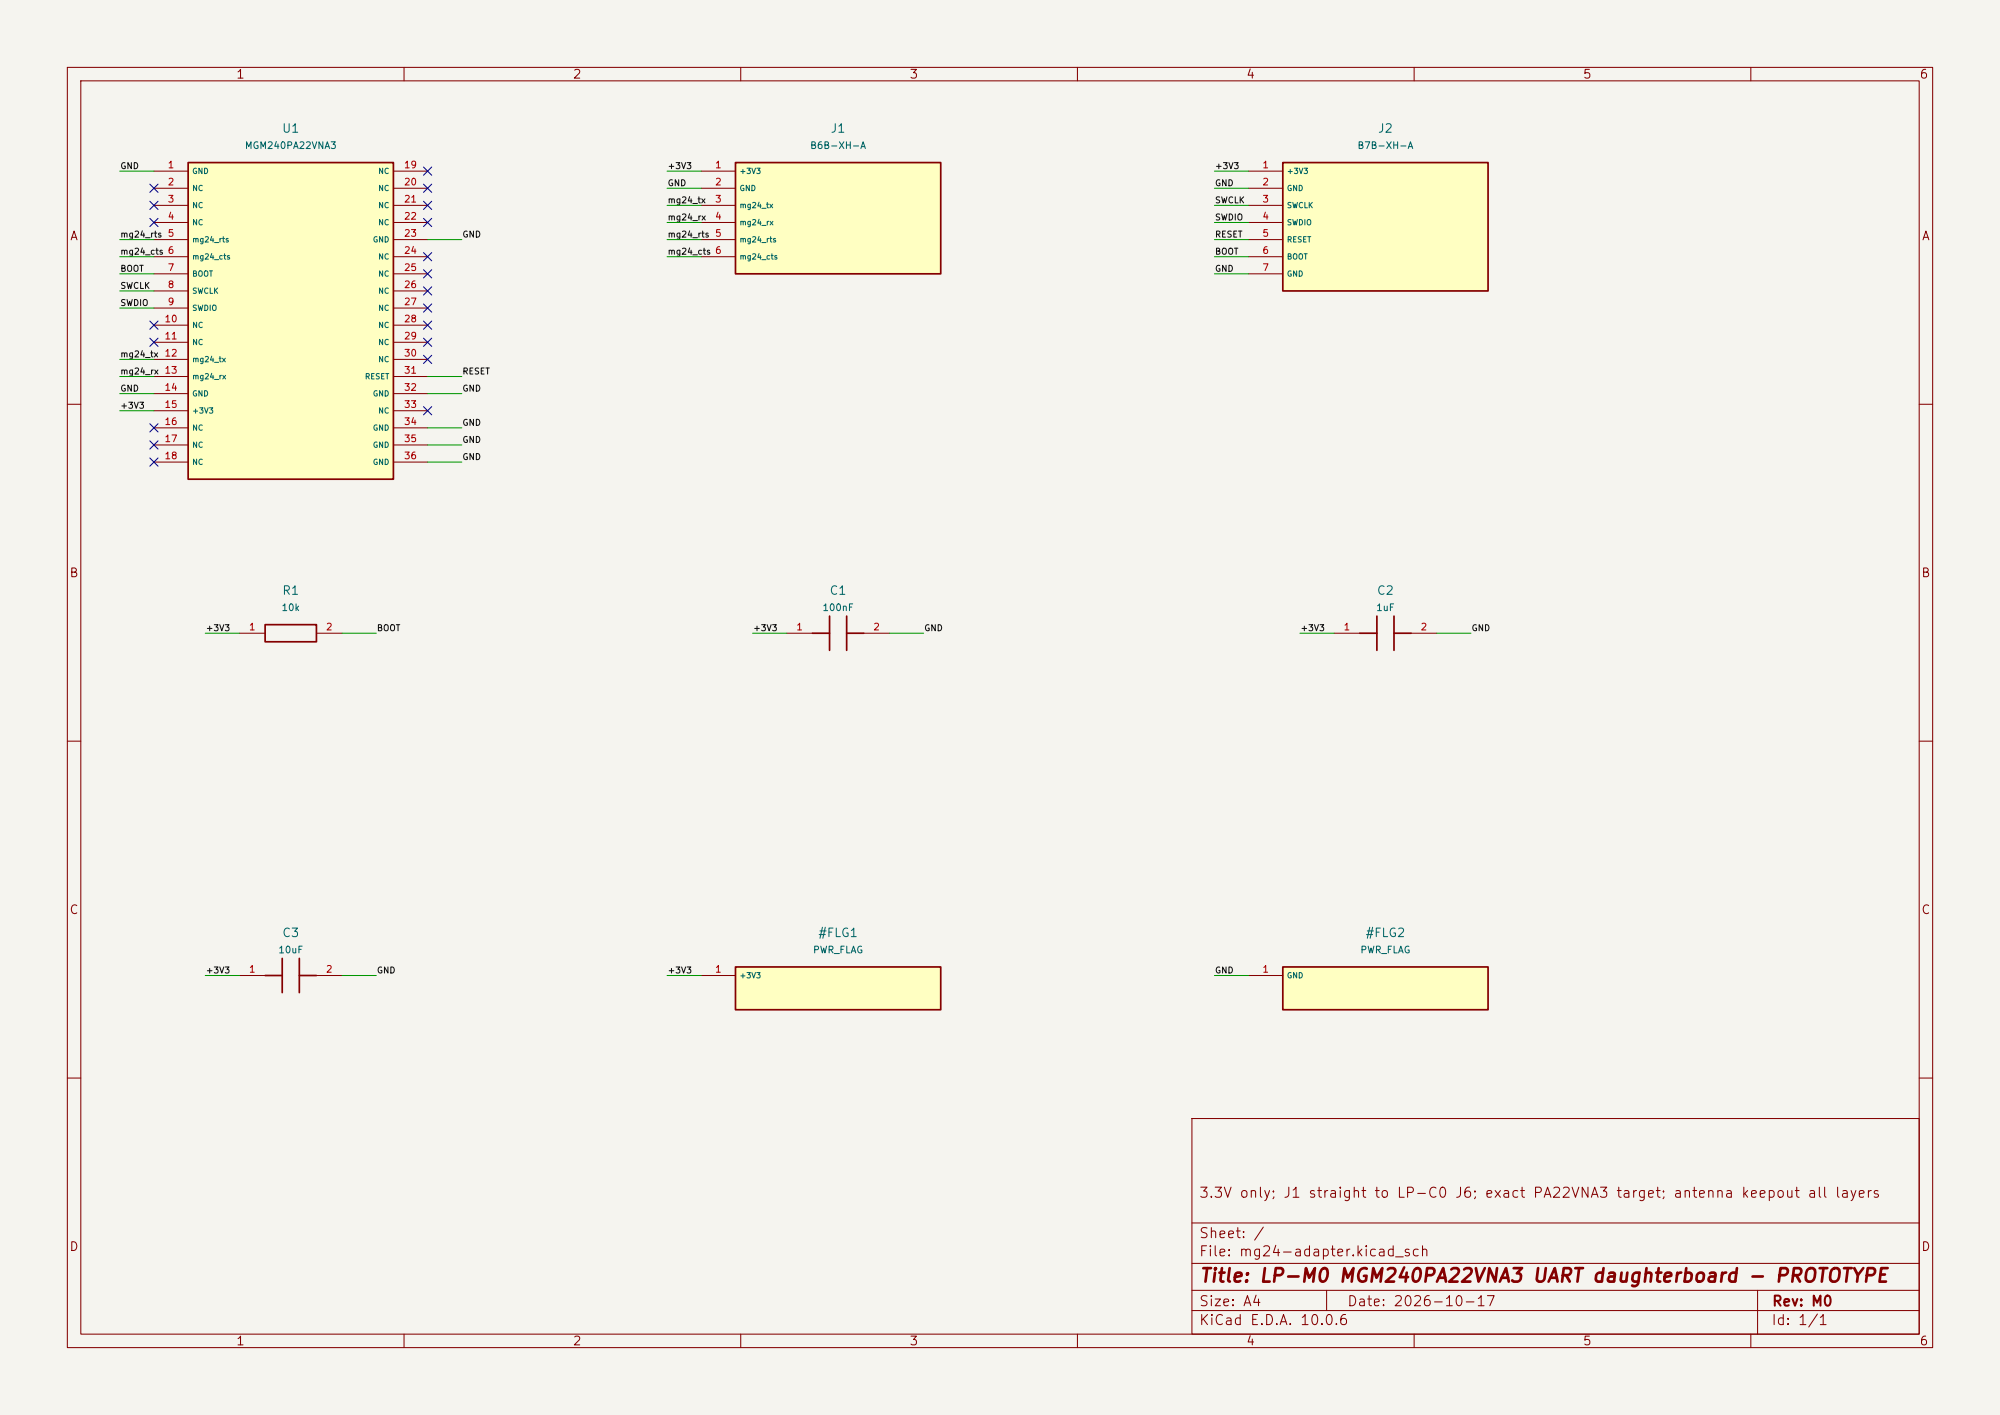
[picture p113: page 1]

3.3V only; J1 straight to LP-C0 J6; exact PA22VNA3 target; antenna keepout all layers

Sheet: /
File: mg24-adapter.kicad_sch
Title: LP-M0 MGM240PA22VNA3 UART daughterboard - PROTOTYPE

Size: A4 | Rev: M0
KiCad E.D.A. 10.0.6 | Id: 1/1
