ha-homelab/ha-radio-hub/hardware/low-power/diy/print/toner-transfer.pdf

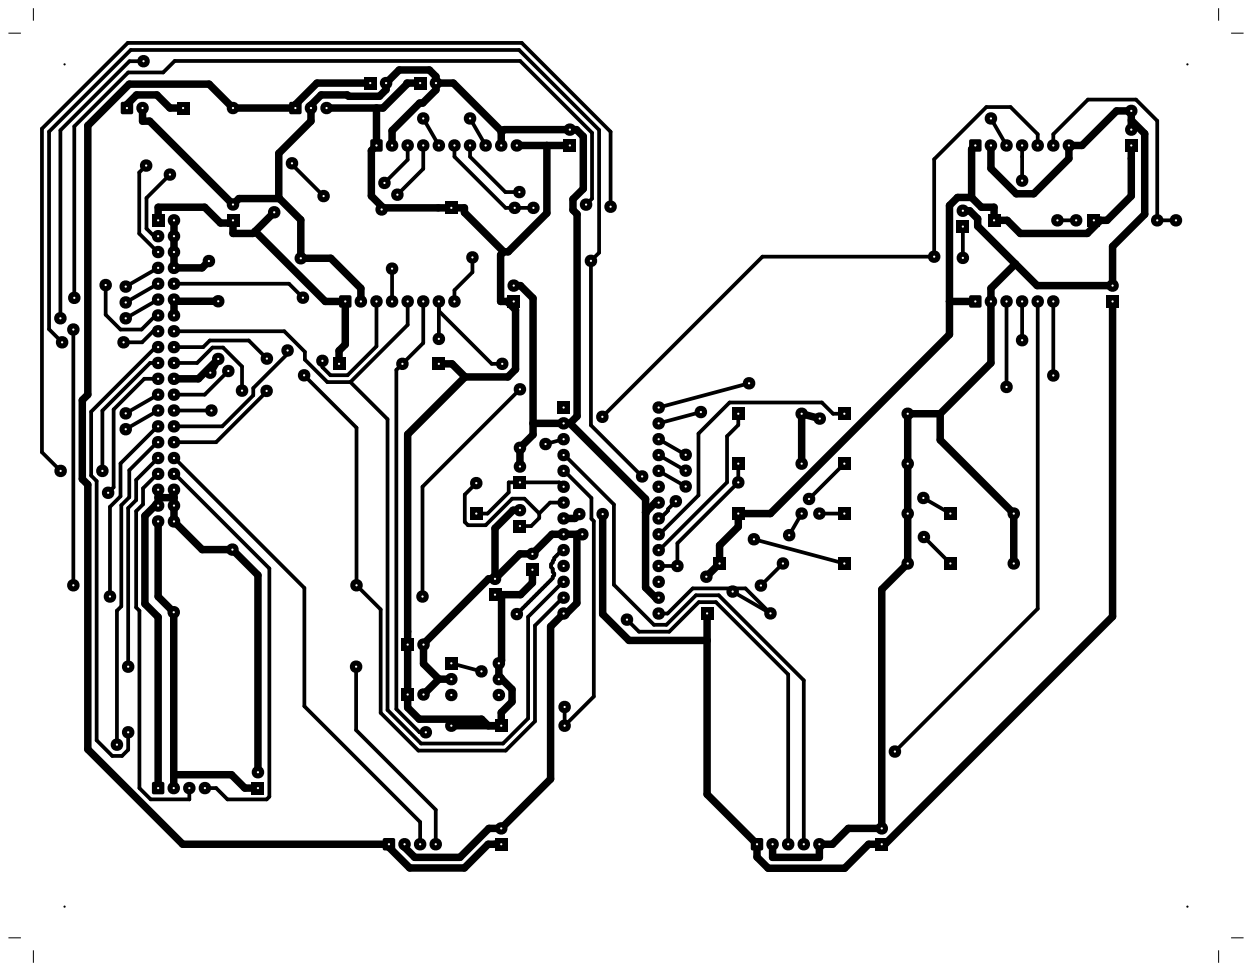
[picture p114: page 1]
