ha-homelab/ha-radio-hub/hardware/external-antenna/cad/mc2.kicad_pcb

## KiCad design hardware/external-antenna/cad/mc2.kicad_pcb (2026-11-12)

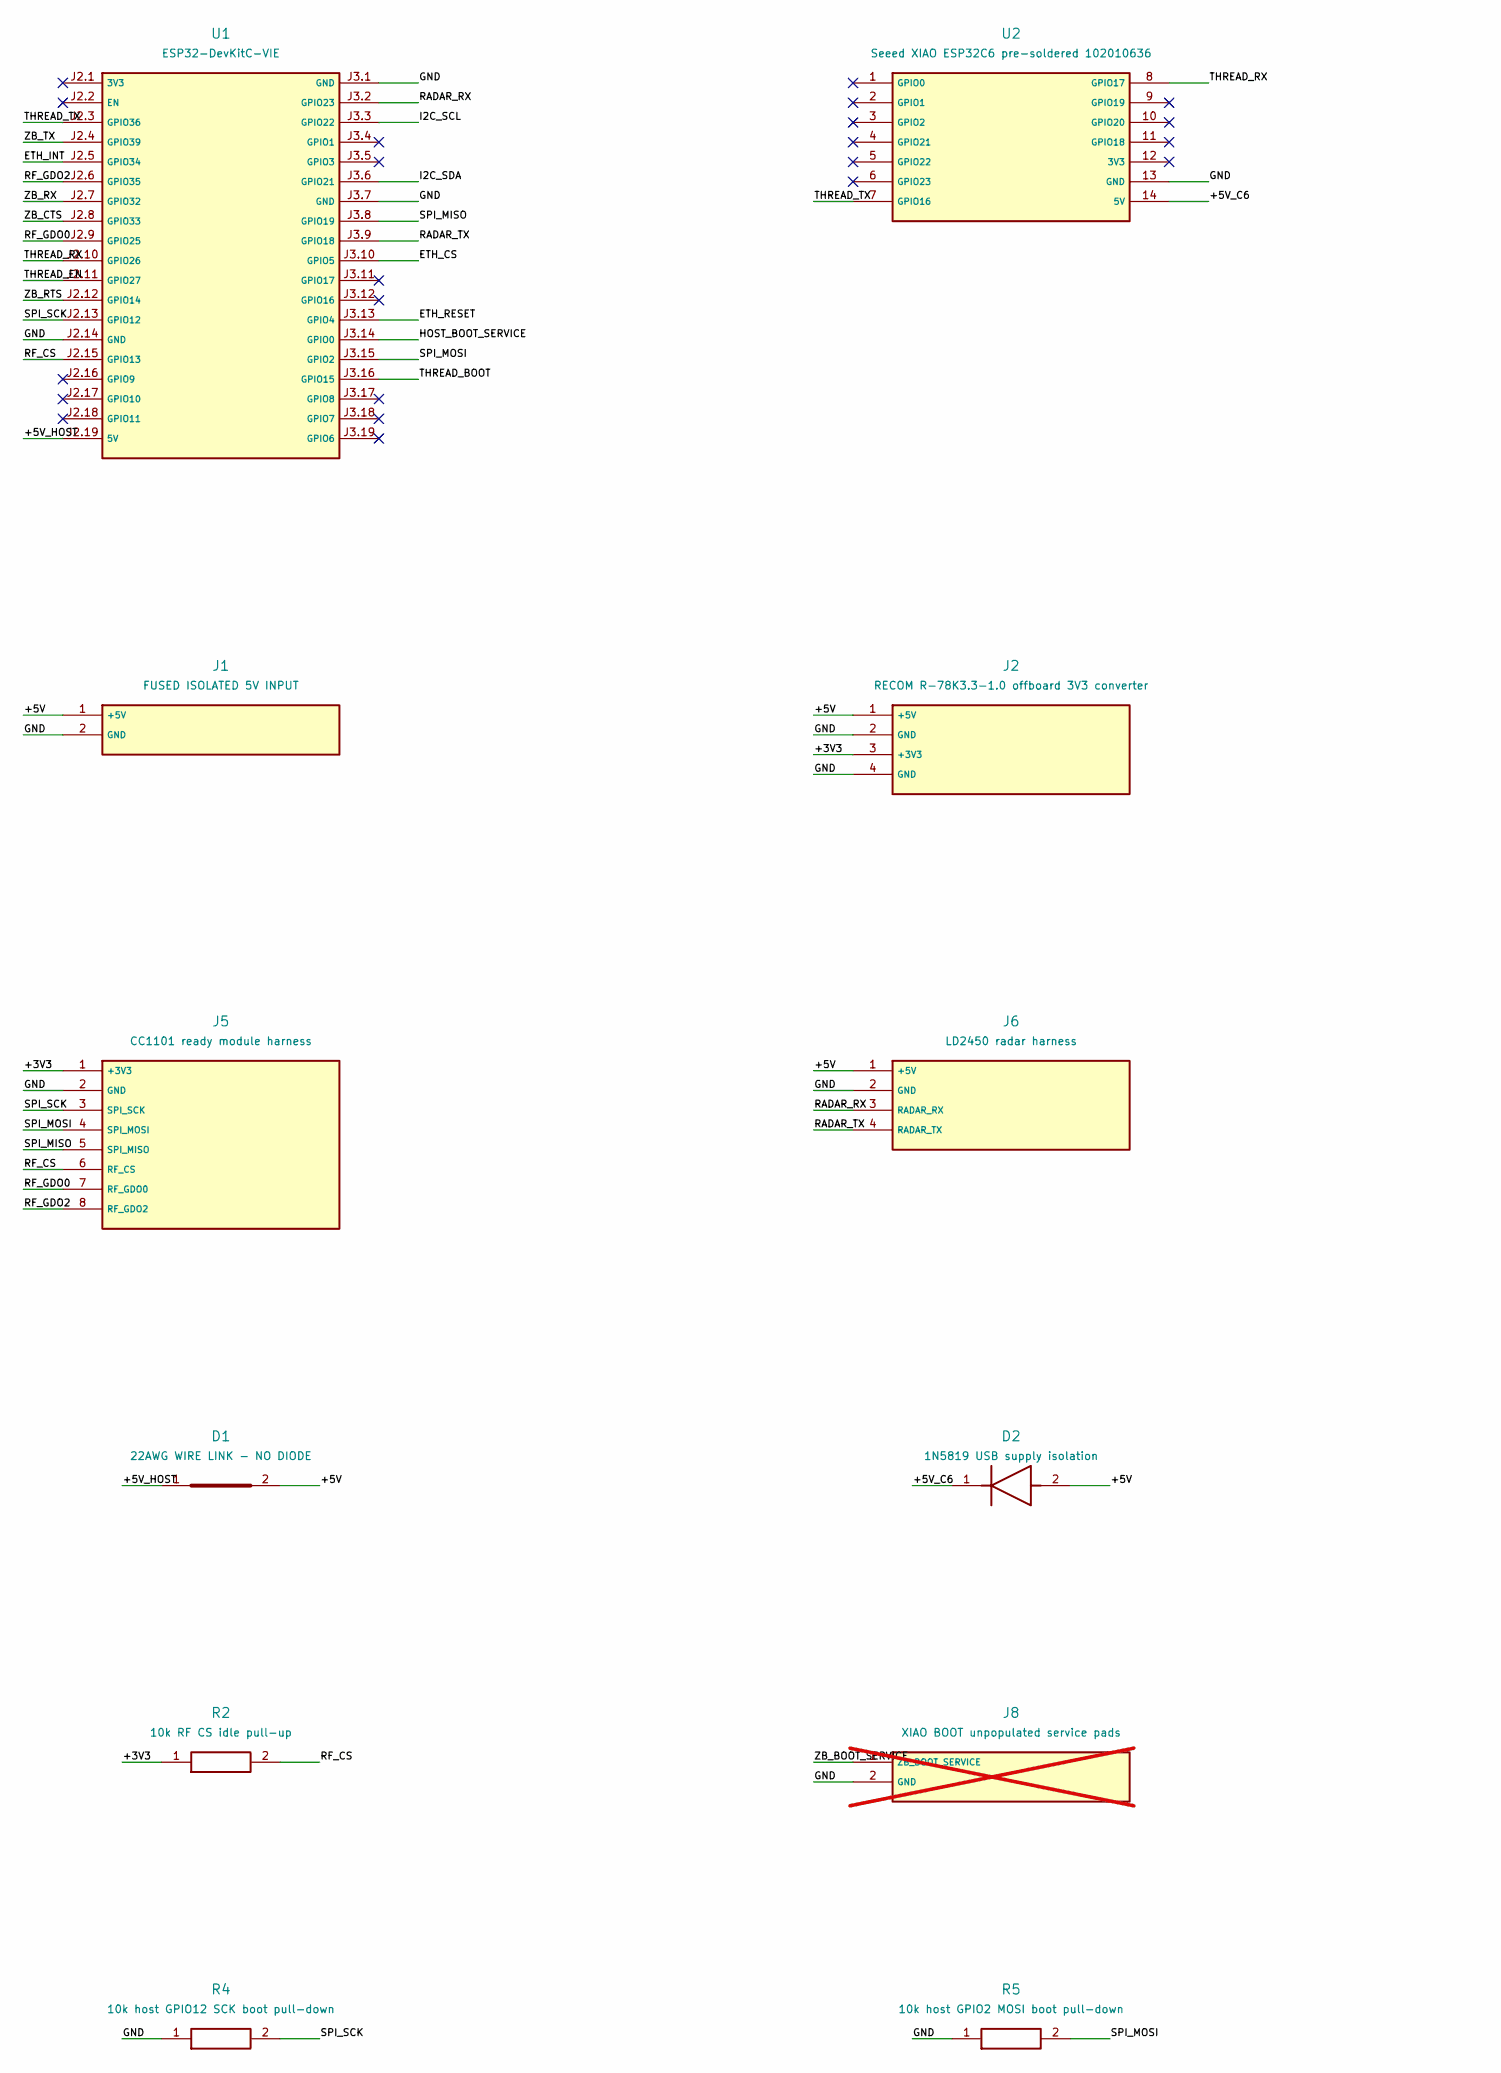
[picture p115: schematic mc2.kicad_sch, MC2-D ESP32 external antennas - engineering prototype, part in row 1, column 1]

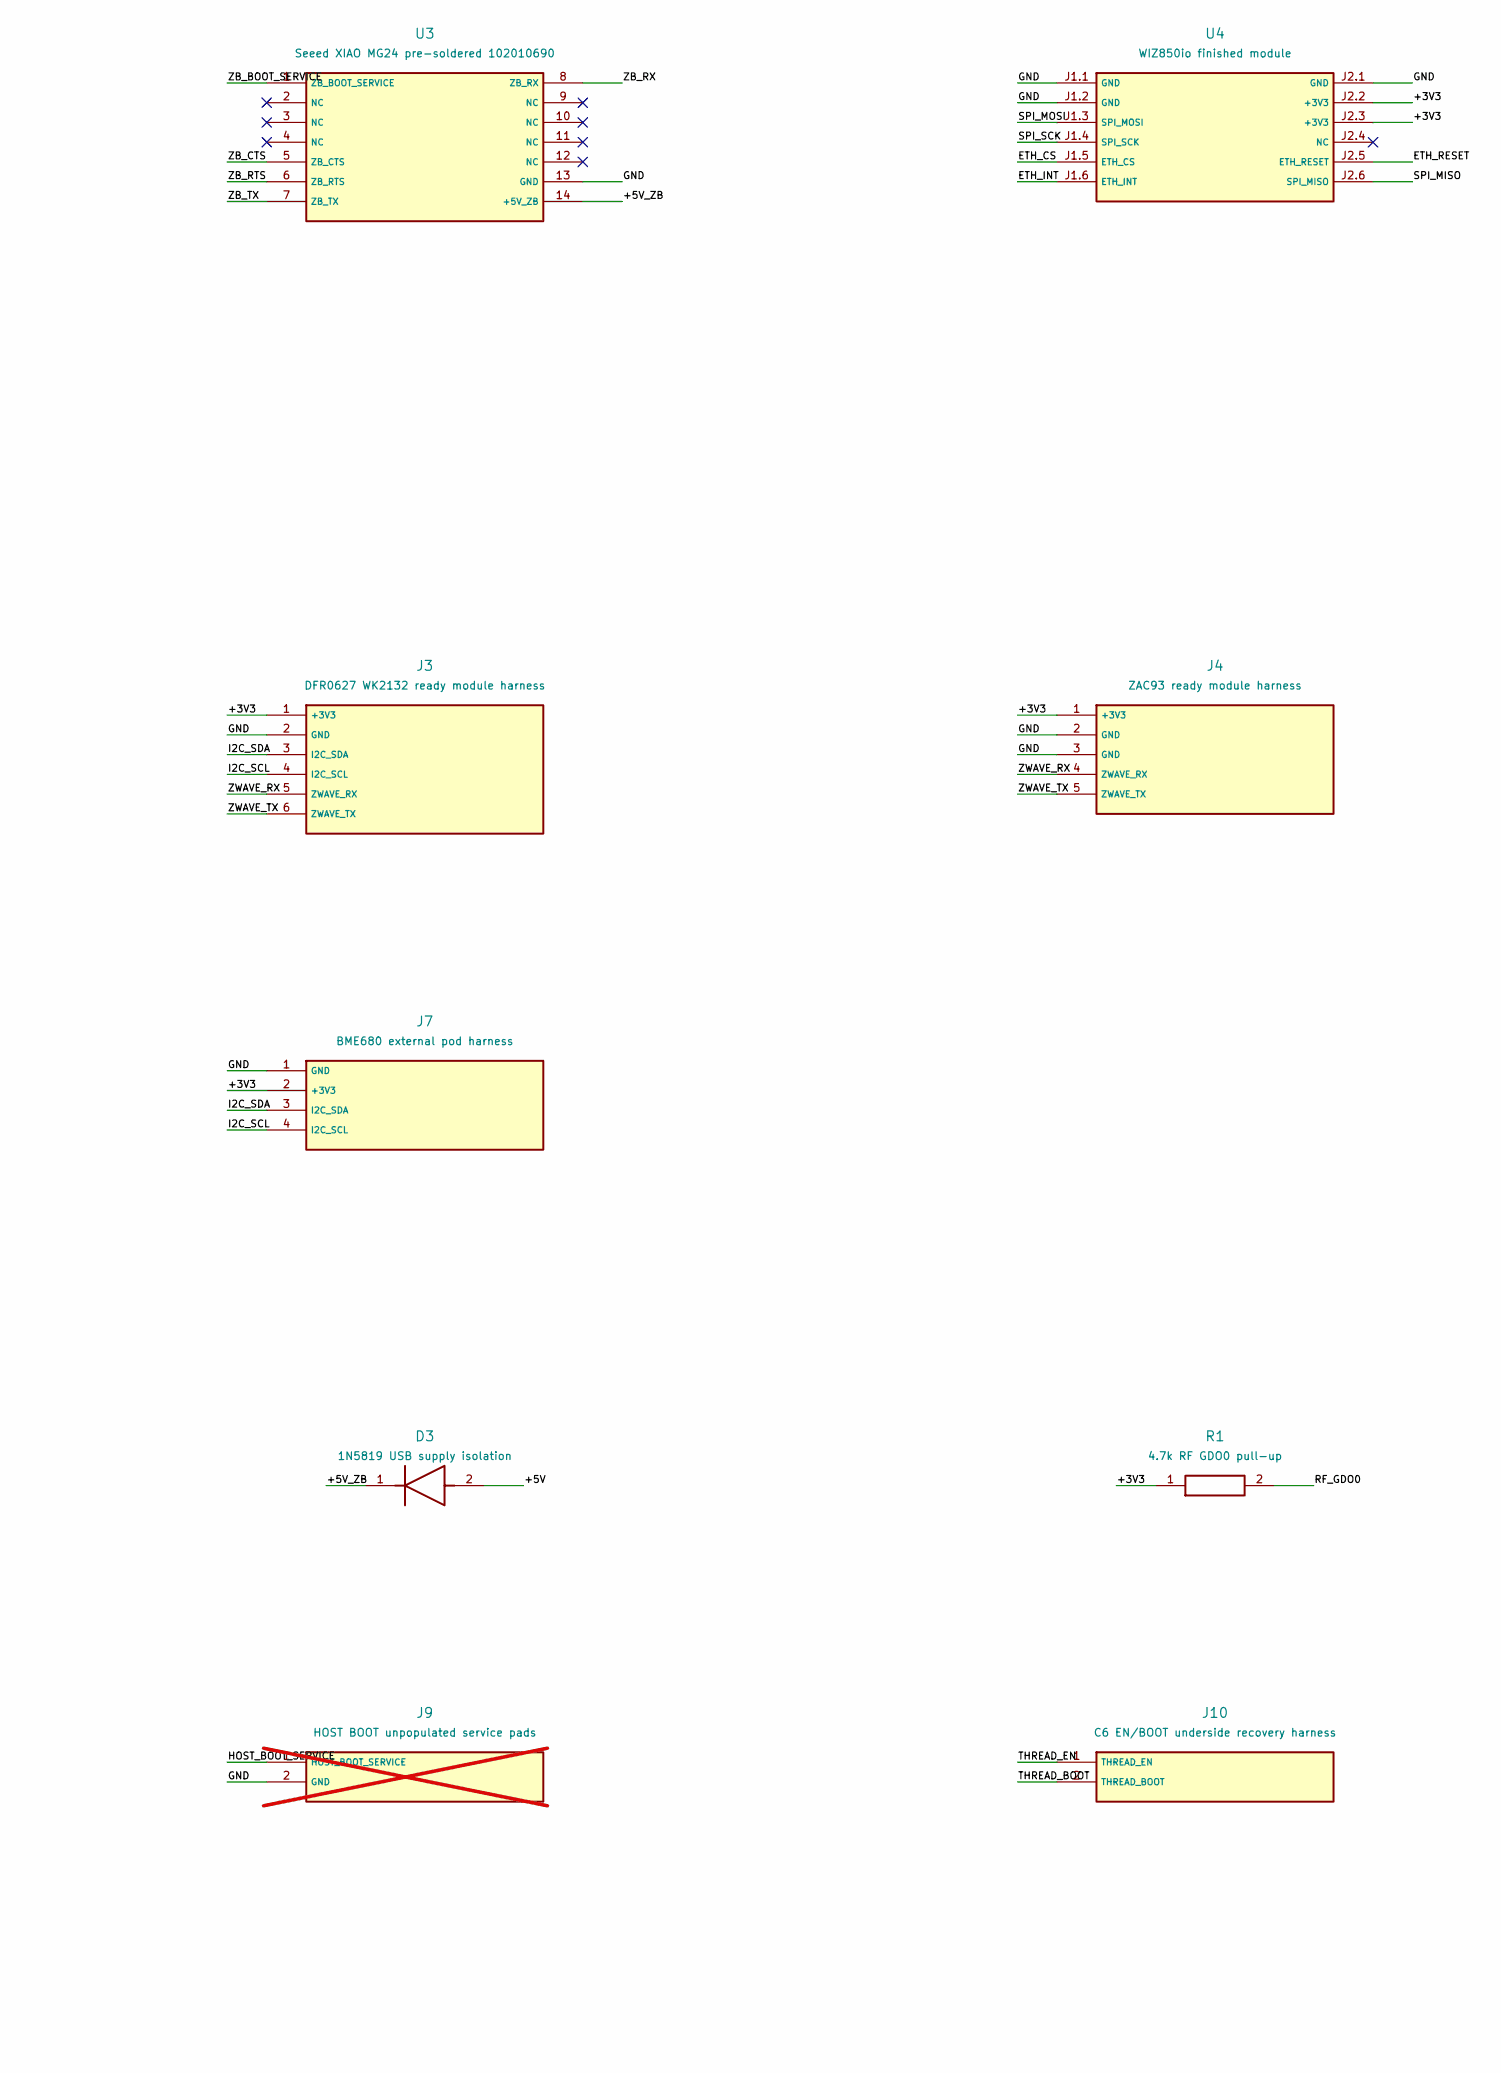
[picture p116: schematic mc2.kicad_sch, MC2-D ESP32 external antennas - engineering prototype, part in row 1, column 2]

Parts:
D1: 22AWG WIRE LINK - NO DIODE; Wire_Link_P7.62mm
D2, D3: 1N5819 USB supply isolation; D_DO-41_SOD81_P7.62mm_Horizontal
J1: FUSED ISOLATED 5V INPUT; PinHeader_1x02_P2.54mm_Vertical
J2: RECOM R-78K3.3-1.0 offboard 3V3 converter; PinHeader_1x04_P2.54mm_Vertical
J3: DFR0627 WK2132 ready module harness; PinHeader_1x06_P2.54mm_Vertical
J4: ZAC93 ready module harness; PinHeader_1x05_P2.54mm_Vertical
J5: CC1101 ready module harness; PinHeader_1x08_P2.54mm_Vertical
J6: LD2450 radar harness; PinHeader_1x04_P2.54mm_Vertical
J7: BME680 external pod harness; PinHeader_1x04_P2.54mm_Vertical
J8: XIAO BOOT unpopulated service pads; PinHeader_1x02_P2.54mm_Vertical; not fitted
J9: HOST BOOT unpopulated service pads; PinHeader_1x02_P2.54mm_Vertical; not fitted
J10: C6 EN/BOOT underside recovery harness; PinHeader_1x02_P2.54mm_Vertical
R1: 4.7k RF GDO0 pull-up; R_Axial_DIN0207_L6.3mm_D2.5mm_P7.62mm_Horizontal
R2: 10k RF CS idle pull-up; R_Axial_DIN0207_L6.3mm_D2.5mm_P7.62mm_Horizontal
R4: 10k host GPIO12 SCK boot pull-down; R_Axial_DIN0207_L6.3mm_D2.5mm_P7.62mm_Horizontal
R5: 10k host GPIO2 MOSI boot pull-down; R_Axial_DIN0207_L6.3mm_D2.5mm_P7.62mm_Horizontal
U1: ESP32-DevKitC-VIE; ESP32_DevKitC_VIE
U2: Seeed XIAO ESP32C6 pre-soldered 102010636; XIAO_ESP32C6
U3: Seeed XIAO MG24 pre-soldered 102010690; XIAO_MG24
U4: WIZ850io finished module; WIZ850io

Connections:
/+3V3: J2.3 (+3V3), J3.1 (+3V3), J4.1 (+3V3), J5.1 (+3V3), J7.2 (+3V3), R1.1, R2.1, U4.J2.2 (+3V3), U4.J2.3 (+3V3)
/+5V: D1.2, D2.2, D3.2, J1.1 (+5V), J2.1 (+5V), J6.1 (+5V)
/+5V_C6: D2.1, U2.14 (5V)
/+5V_HOST: D1.1, U1.J2.19 (5V)
/+5V_ZB: D3.1, U3.14 (+5V_ZB)
/ETH_CS: U1.J3.10 (GPIO5), U4.J1.5 (ETH_CS)
/ETH_INT: U1.J2.5 (GPIO34), U4.J1.6 (ETH_INT)
/ETH_RESET: U1.J3.13 (GPIO4), U4.J2.5 (ETH_RESET)
/GND: J1.2 (GND), J2.2 (GND), J2.4 (GND), J3.2 (GND), J4.2 (GND), J4.3 (GND), J5.2 (GND), J6.2 (GND), J7.1 (GND), J8.2 (GND), J9.2 (GND), R4.1, R5.1, U1.J2.14 (GND), U1.J3.1 (GND), U1.J3.7 (GND), U2.13 (GND), U3.13 (GND), U4.J1.1 (GND), U4.J1.2 (GND), U4.J2.1 (GND)
/HOST_BOOT_SERVICE: J9.1 (HOST_BOOT_SERVICE), U1.J3.14 (GPIO0)
/I2C_SCL: J3.4 (I2C_SCL), J7.4 (I2C_SCL), U1.J3.3 (GPIO22)
/I2C_SDA: J3.3 (I2C_SDA), J7.3 (I2C_SDA), U1.J3.6 (GPIO21)
/RADAR_RX: J6.3 (RADAR_RX), U1.J3.2 (GPIO23)
/RADAR_TX: J6.4 (RADAR_TX), U1.J3.9 (GPIO18)
/RF_CS: J5.6 (RF_CS), R2.2, U1.J2.15 (GPIO13)
/RF_GDO0: J5.7 (RF_GDO0), R1.2, U1.J2.9 (GPIO25)
/RF_GDO2: J5.8 (RF_GDO2), U1.J2.6 (GPIO35)
/SPI_MISO: J5.5 (SPI_MISO), U1.J3.8 (GPIO19), U4.J2.6 (SPI_MISO)
/SPI_MOSI: J5.4 (SPI_MOSI), R5.2, U1.J3.15 (GPIO2), U4.J1.3 (SPI_MOSI)
/SPI_SCK: J5.3 (SPI_SCK), R4.2, U1.J2.13 (GPIO12), U4.J1.4 (SPI_SCK)
/THREAD_BOOT: J10.2 (THREAD_BOOT), U1.J3.16 (GPIO15)
/THREAD_EN: J10.1 (THREAD_EN), U1.J2.11 (GPIO27)
/THREAD_RX: U1.J2.10 (GPIO26), U2.8 (GPIO17)
/THREAD_TX: U1.J2.3 (GPIO36), U2.7 (GPIO16)
/ZB_BOOT_SERVICE: J8.1 (ZB_BOOT_SERVICE), U3.1 (ZB_BOOT_SERVICE)
/ZB_CTS: U1.J2.8 (GPIO33), U3.5 (ZB_CTS)
/ZB_RTS: U1.J2.12 (GPIO14), U3.6 (ZB_RTS)
/ZB_RX: U1.J2.7 (GPIO32), U3.8 (ZB_RX)
/ZB_TX: U1.J2.4 (GPIO39), U3.7 (ZB_TX)
/ZWAVE_RX: J3.5 (ZWAVE_RX), J4.4 (ZWAVE_RX)
/ZWAVE_TX: J3.6 (ZWAVE_TX), J4.5 (ZWAVE_TX)

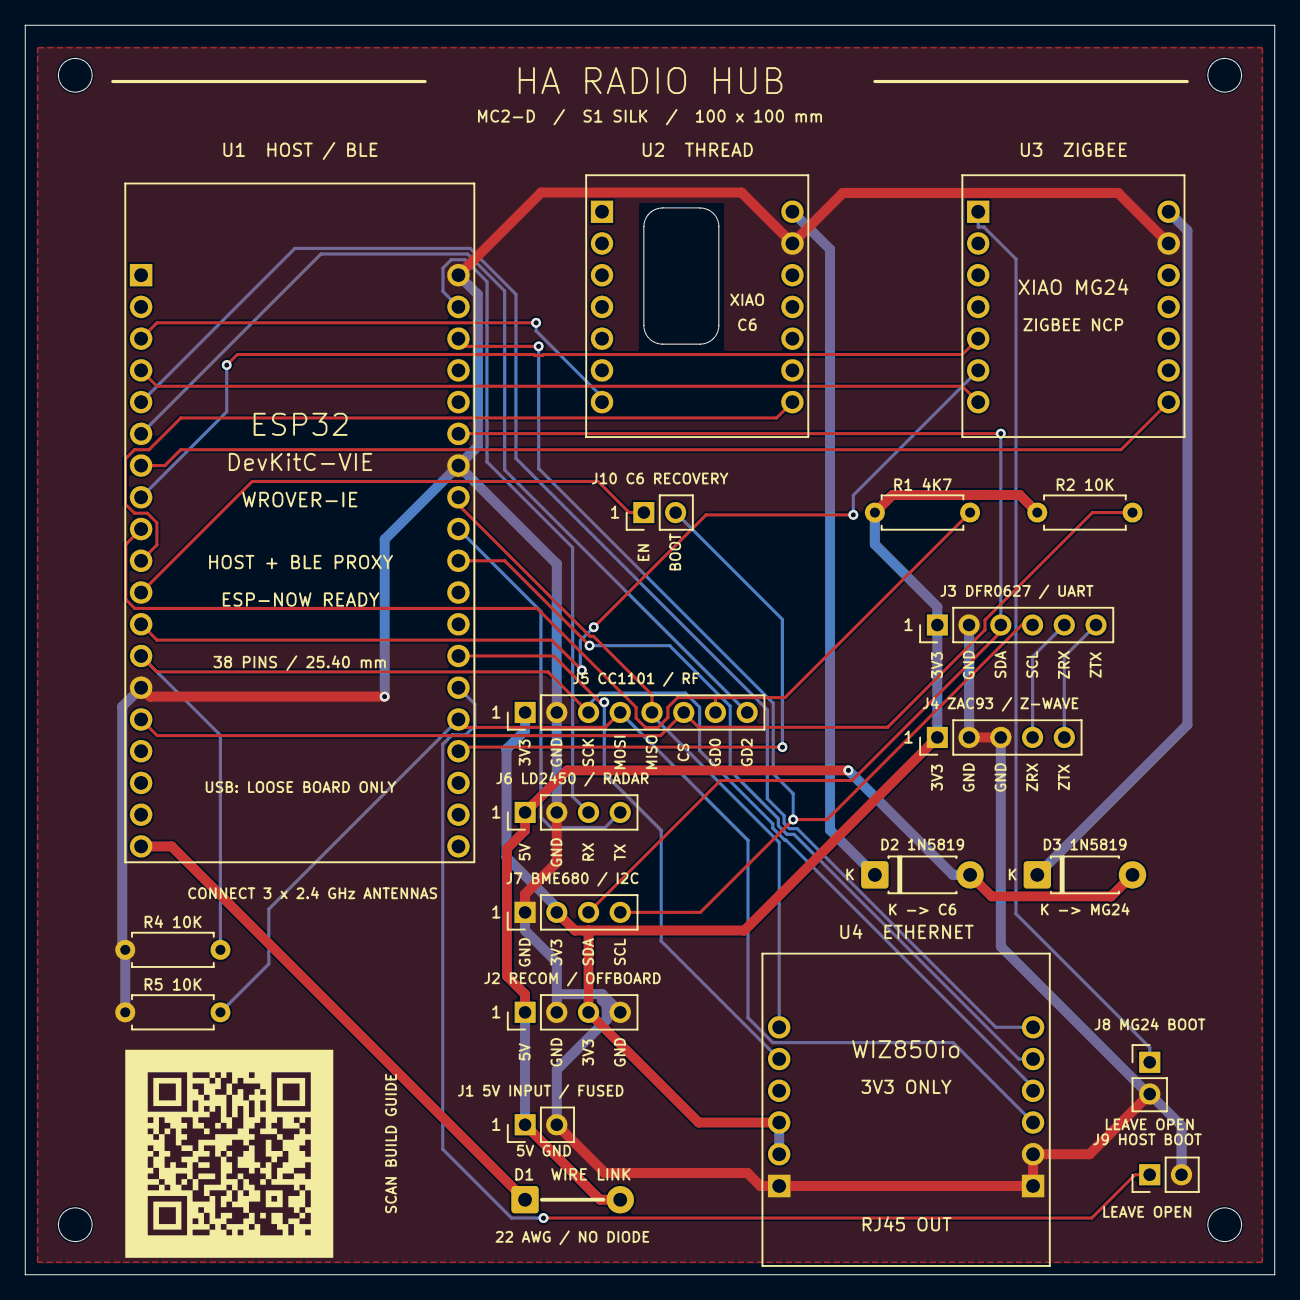
[picture p117: board mc2.kicad_pcb from above]

Board: 2 copper layers, 100.0 x 100.0 mm, 25 parts (0 on the bottom side), 31 nets.

Other parts of the board:
H1, H2, H3, H4: M2.5 NYLON NPTH
