ha-homelab/ha-radio-hub/hardware/module-carrier/studies/square-layout/cad-candidate/mc1.kicad_pcb

## KiCad design hardware/module-carrier/studies/square-layout/cad-candidate/mc1.kicad_pcb (2026-10-18)

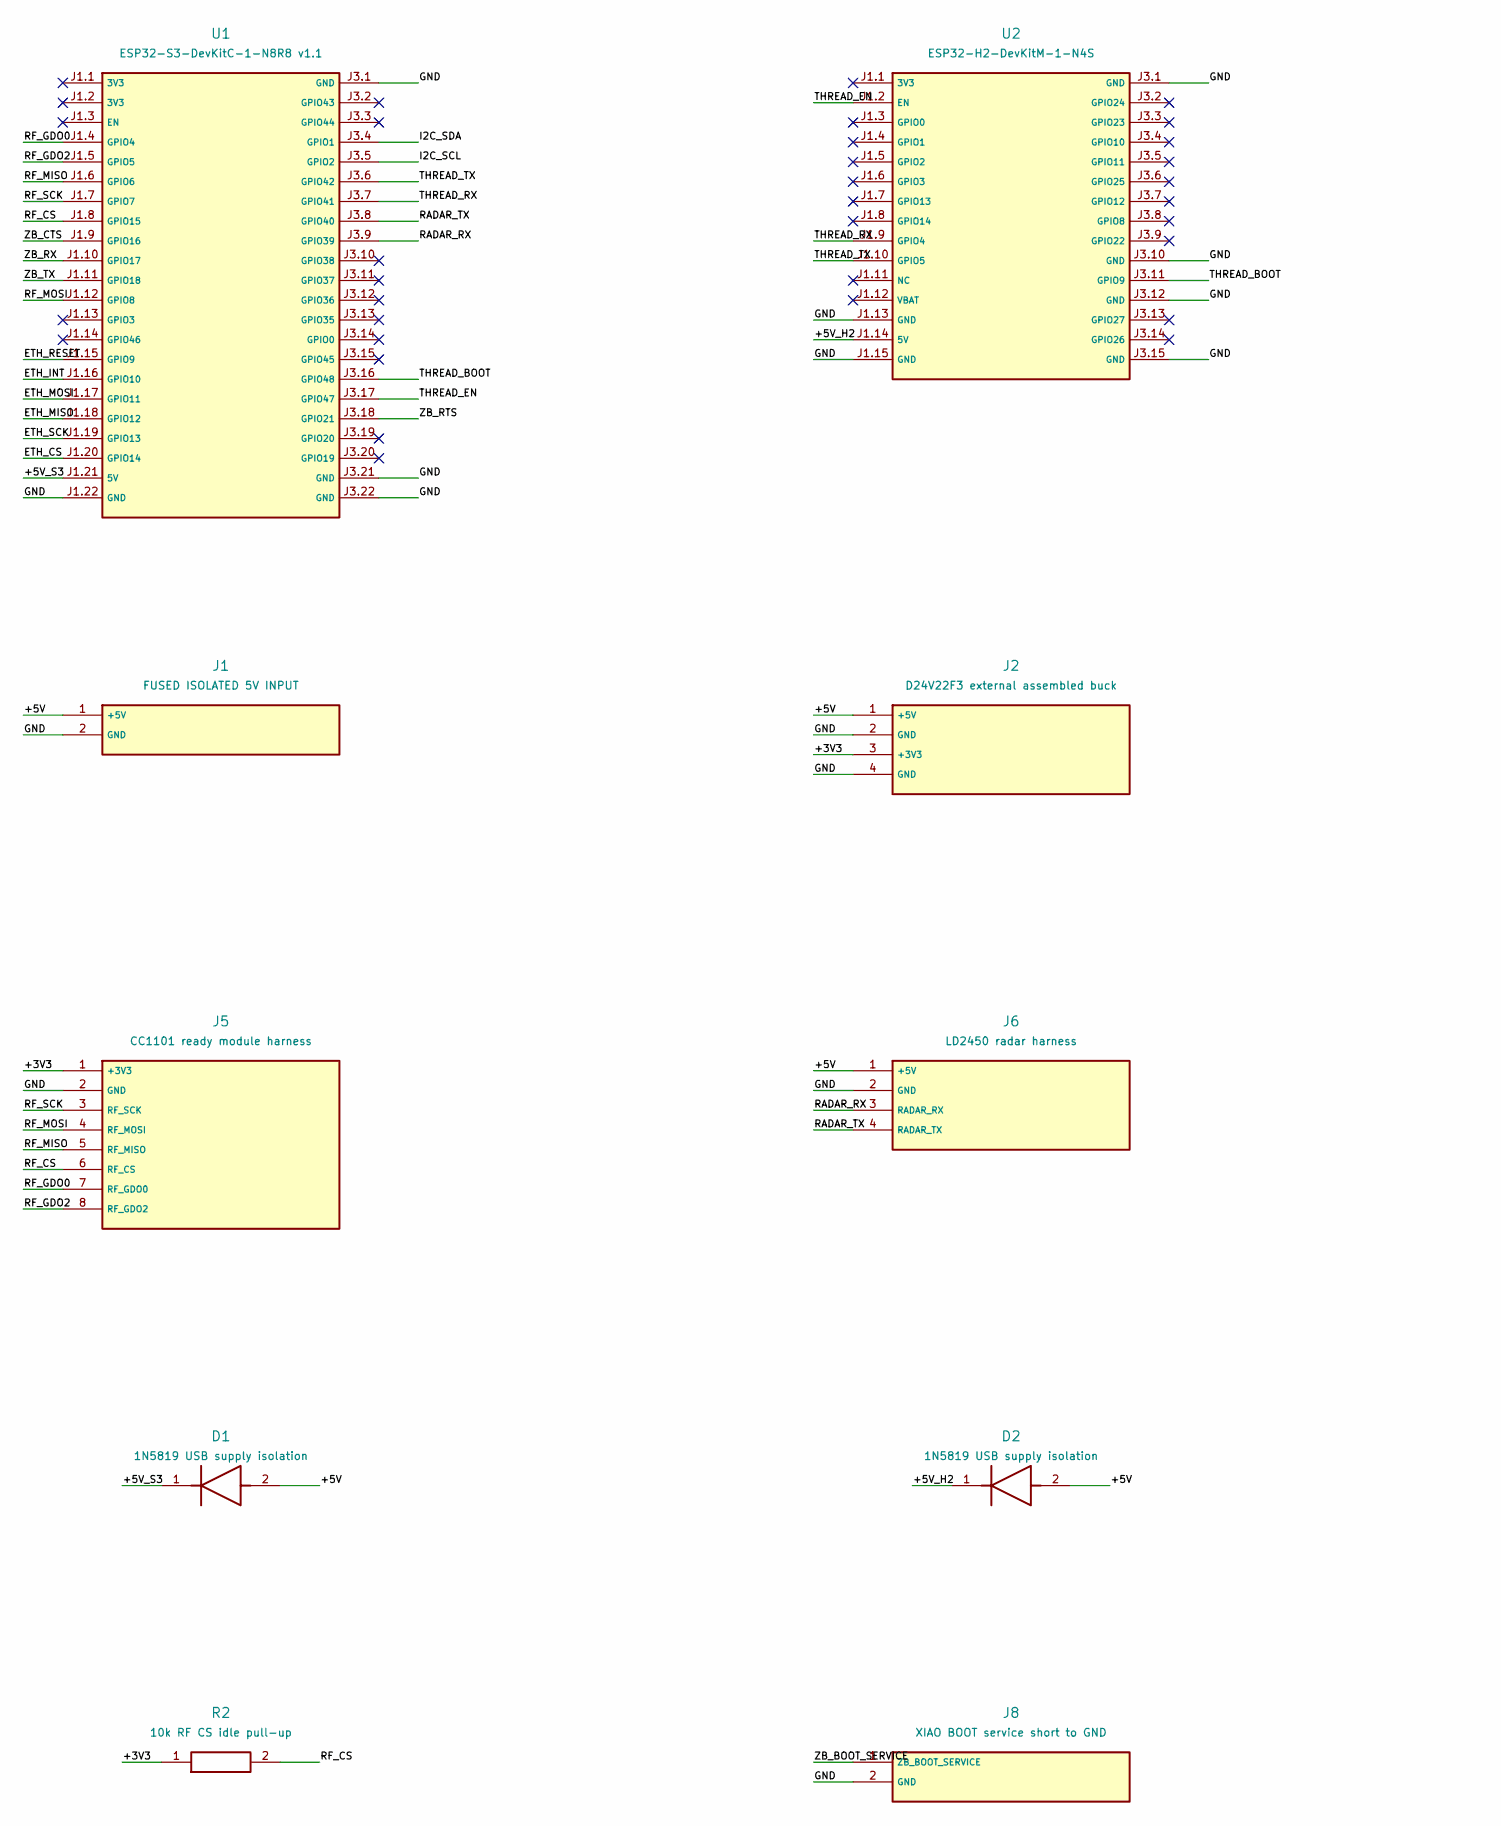
[picture p118: schematic mc1.kicad_sch, MC1 square geometry study / not active design, part in row 1, column 1]

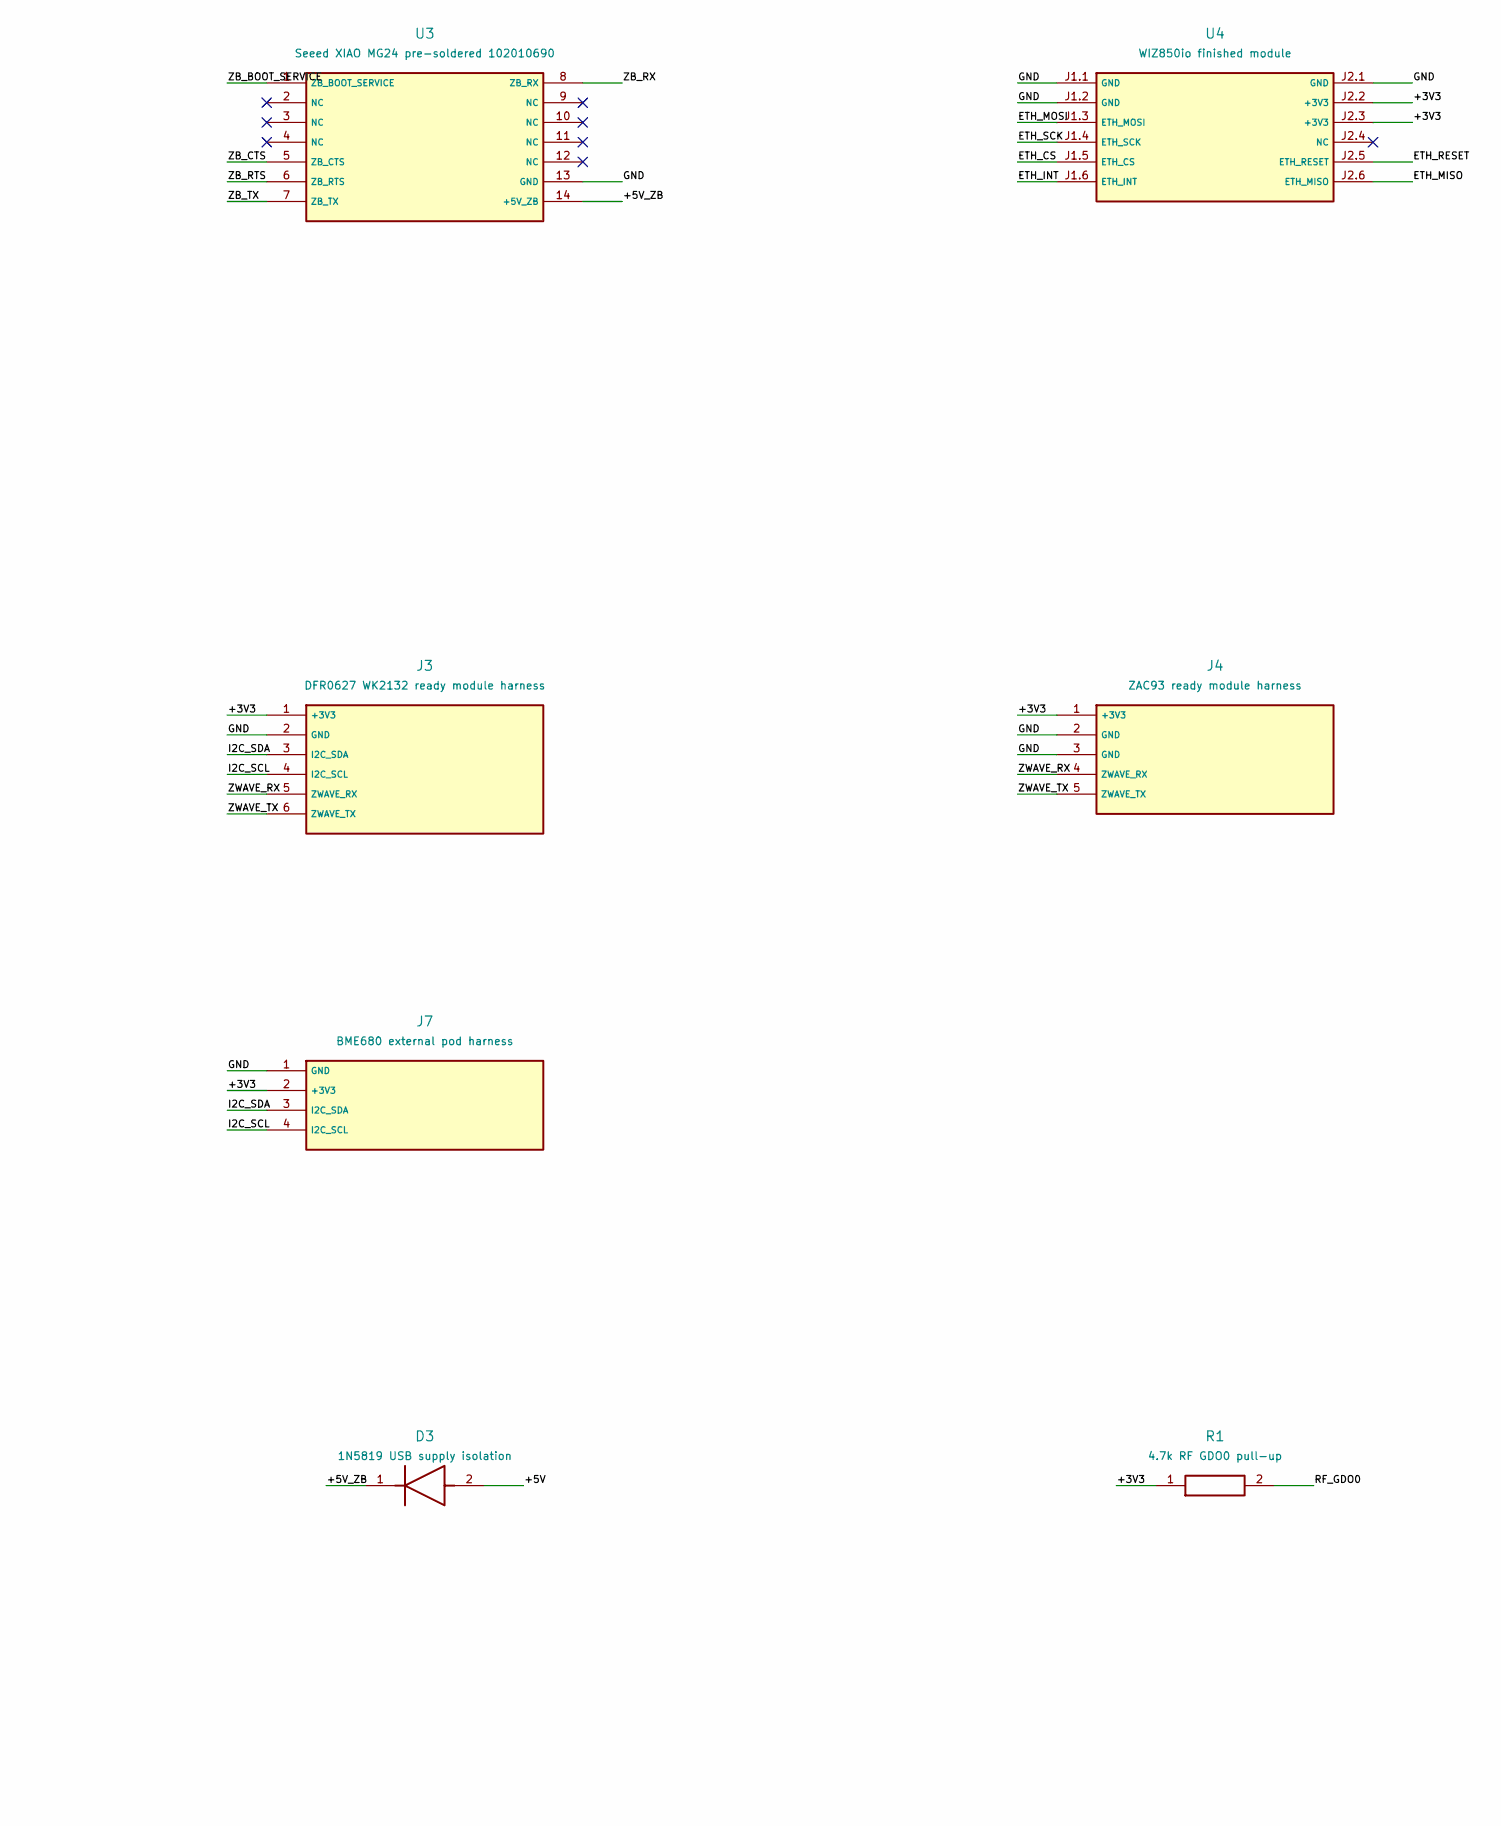
[picture p119: schematic mc1.kicad_sch, MC1 square geometry study / not active design, part in row 1, column 2]

Parts:
D1, D2, D3: 1N5819 USB supply isolation; D_DO-41_SOD81_P7.62mm_Horizontal
J1: FUSED ISOLATED 5V INPUT; PinHeader_1x02_P2.54mm_Vertical
J2: D24V22F3 external assembled buck; PinHeader_1x04_P2.54mm_Vertical
J3: DFR0627 WK2132 ready module harness; PinHeader_1x06_P2.54mm_Vertical
J4: ZAC93 ready module harness; PinHeader_1x05_P2.54mm_Vertical
J5: CC1101 ready module harness; PinHeader_1x08_P2.54mm_Vertical
J6: LD2450 radar harness; PinHeader_1x04_P2.54mm_Vertical
J7: BME680 external pod harness; PinHeader_1x04_P2.54mm_Vertical
J8: XIAO BOOT service short to GND; PinHeader_1x02_P2.54mm_Vertical
R1: 4.7k RF GDO0 pull-up; R_Axial_DIN0207_L6.3mm_D2.5mm_P7.62mm_Horizontal
R2: 10k RF CS idle pull-up; R_Axial_DIN0207_L6.3mm_D2.5mm_P7.62mm_Horizontal
U1: ESP32-S3-DevKitC-1-N8R8 v1.1; S3_DevKitC1_v11
U2: ESP32-H2-DevKitM-1-N4S; H2_DevKitM1
U3: Seeed XIAO MG24 pre-soldered 102010690; XIAO_MG24
U4: WIZ850io finished module; WIZ850io

Connections:
/+3V3: J2.3 (+3V3), J3.1 (+3V3), J4.1 (+3V3), J5.1 (+3V3), J7.2 (+3V3), R1.1, R2.1, U4.J2.2 (+3V3), U4.J2.3 (+3V3)
/+5V: D1.2, D2.2, D3.2, J1.1 (+5V), J2.1 (+5V), J6.1 (+5V)
/+5V_H2: D2.1, U2.J1.14 (5V)
/+5V_S3: D1.1, U1.J1.21 (5V)
/+5V_ZB: D3.1, U3.14 (+5V_ZB)
/ETH_CS: U1.J1.20 (GPIO14), U4.J1.5 (ETH_CS)
/ETH_INT: U1.J1.16 (GPIO10), U4.J1.6 (ETH_INT)
/ETH_MISO: U1.J1.18 (GPIO12), U4.J2.6 (ETH_MISO)
/ETH_MOSI: U1.J1.17 (GPIO11), U4.J1.3 (ETH_MOSI)
/ETH_RESET: U1.J1.15 (GPIO9), U4.J2.5 (ETH_RESET)
/ETH_SCK: U1.J1.19 (GPIO13), U4.J1.4 (ETH_SCK)
/GND: J1.2 (GND), J2.2 (GND), J2.4 (GND), J3.2 (GND), J4.2 (GND), J4.3 (GND), J5.2 (GND), J6.2 (GND), J7.1 (GND), J8.2 (GND), U1.J1.22 (GND), U1.J3.1 (GND), U1.J3.21 (GND), U1.J3.22 (GND), U2.J1.13 (GND), U2.J1.15 (GND), U2.J3.1 (GND), U2.J3.10 (GND), U2.J3.12 (GND), U2.J3.15 (GND), U3.13 (GND), U4.J1.1 (GND), U4.J1.2 (GND), U4.J2.1 (GND)
/I2C_SCL: J3.4 (I2C_SCL), J7.4 (I2C_SCL), U1.J3.5 (GPIO2)
/I2C_SDA: J3.3 (I2C_SDA), J7.3 (I2C_SDA), U1.J3.4 (GPIO1)
/RADAR_RX: J6.3 (RADAR_RX), U1.J3.9 (GPIO39)
/RADAR_TX: J6.4 (RADAR_TX), U1.J3.8 (GPIO40)
/RF_CS: J5.6 (RF_CS), R2.2, U1.J1.8 (GPIO15)
/RF_GDO0: J5.7 (RF_GDO0), R1.2, U1.J1.4 (GPIO4)
/RF_GDO2: J5.8 (RF_GDO2), U1.J1.5 (GPIO5)
/RF_MISO: J5.5 (RF_MISO), U1.J1.6 (GPIO6)
/RF_MOSI: J5.4 (RF_MOSI), U1.J1.12 (GPIO8)
/RF_SCK: J5.3 (RF_SCK), U1.J1.7 (GPIO7)
/THREAD_BOOT: U1.J3.16 (GPIO48), U2.J3.11 (GPIO9)
/THREAD_EN: U1.J3.17 (GPIO47), U2.J1.2 (EN)
/THREAD_RX: U1.J3.7 (GPIO41), U2.J1.9 (GPIO4)
/THREAD_TX: U1.J3.6 (GPIO42), U2.J1.10 (GPIO5)
/ZB_BOOT_SERVICE: J8.1 (ZB_BOOT_SERVICE), U3.1 (ZB_BOOT_SERVICE)
/ZB_CTS: U1.J1.9 (GPIO16), U3.5 (ZB_CTS)
/ZB_RTS: U1.J3.18 (GPIO21), U3.6 (ZB_RTS)
/ZB_RX: U1.J1.10 (GPIO17), U3.8 (ZB_RX)
/ZB_TX: U1.J1.11 (GPIO18), U3.7 (ZB_TX)
/ZWAVE_RX: J3.5 (ZWAVE_RX), J4.4 (ZWAVE_RX)
/ZWAVE_TX: J3.6 (ZWAVE_TX), J4.5 (ZWAVE_TX)

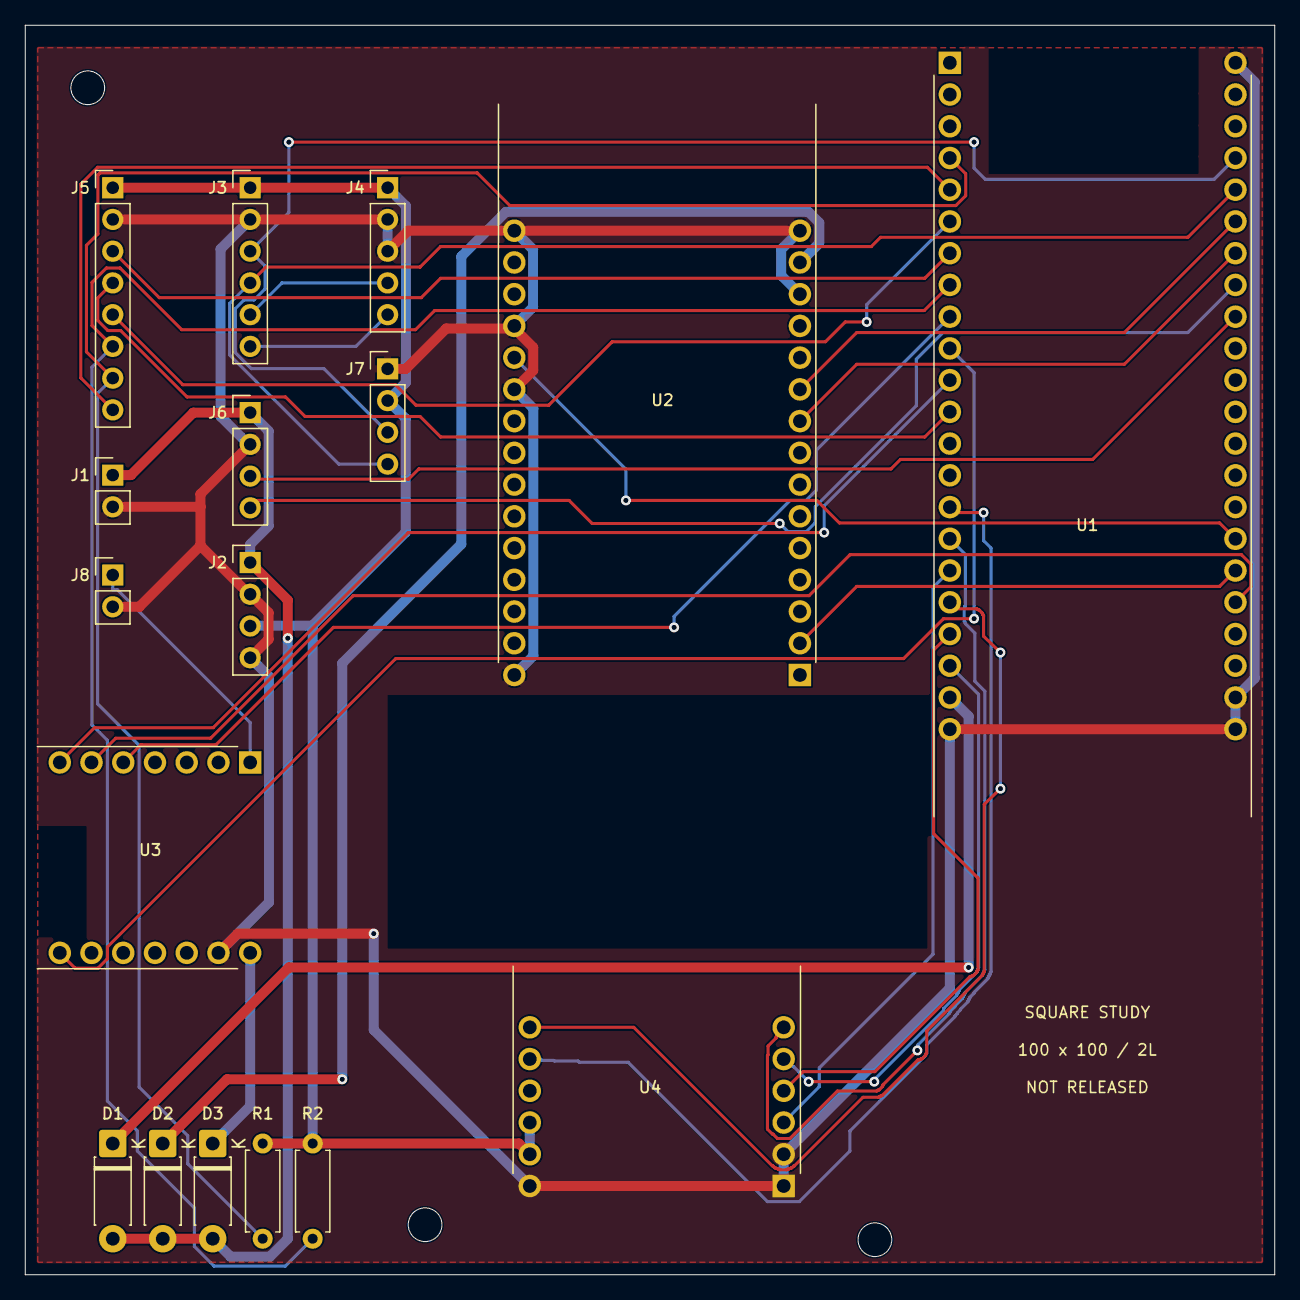
[picture p120: board hardware/module-carrier/studies/square-layout/cad-candidate/mc1.kicad… from above]

Board: 2 copper layers, 100.0 x 100.0 mm, 20 parts (0 on the bottom side), 33 nets.

Other parts of the board:
H1, H2, H3: M2.5 NYLON NPTH
