ha-homelab/ha-radio-hub/hardware/module-carrier/cad/mc1.kicad_pcb

## KiCad design hardware/module-carrier/cad/mc1.kicad_pcb (2026-10-18)

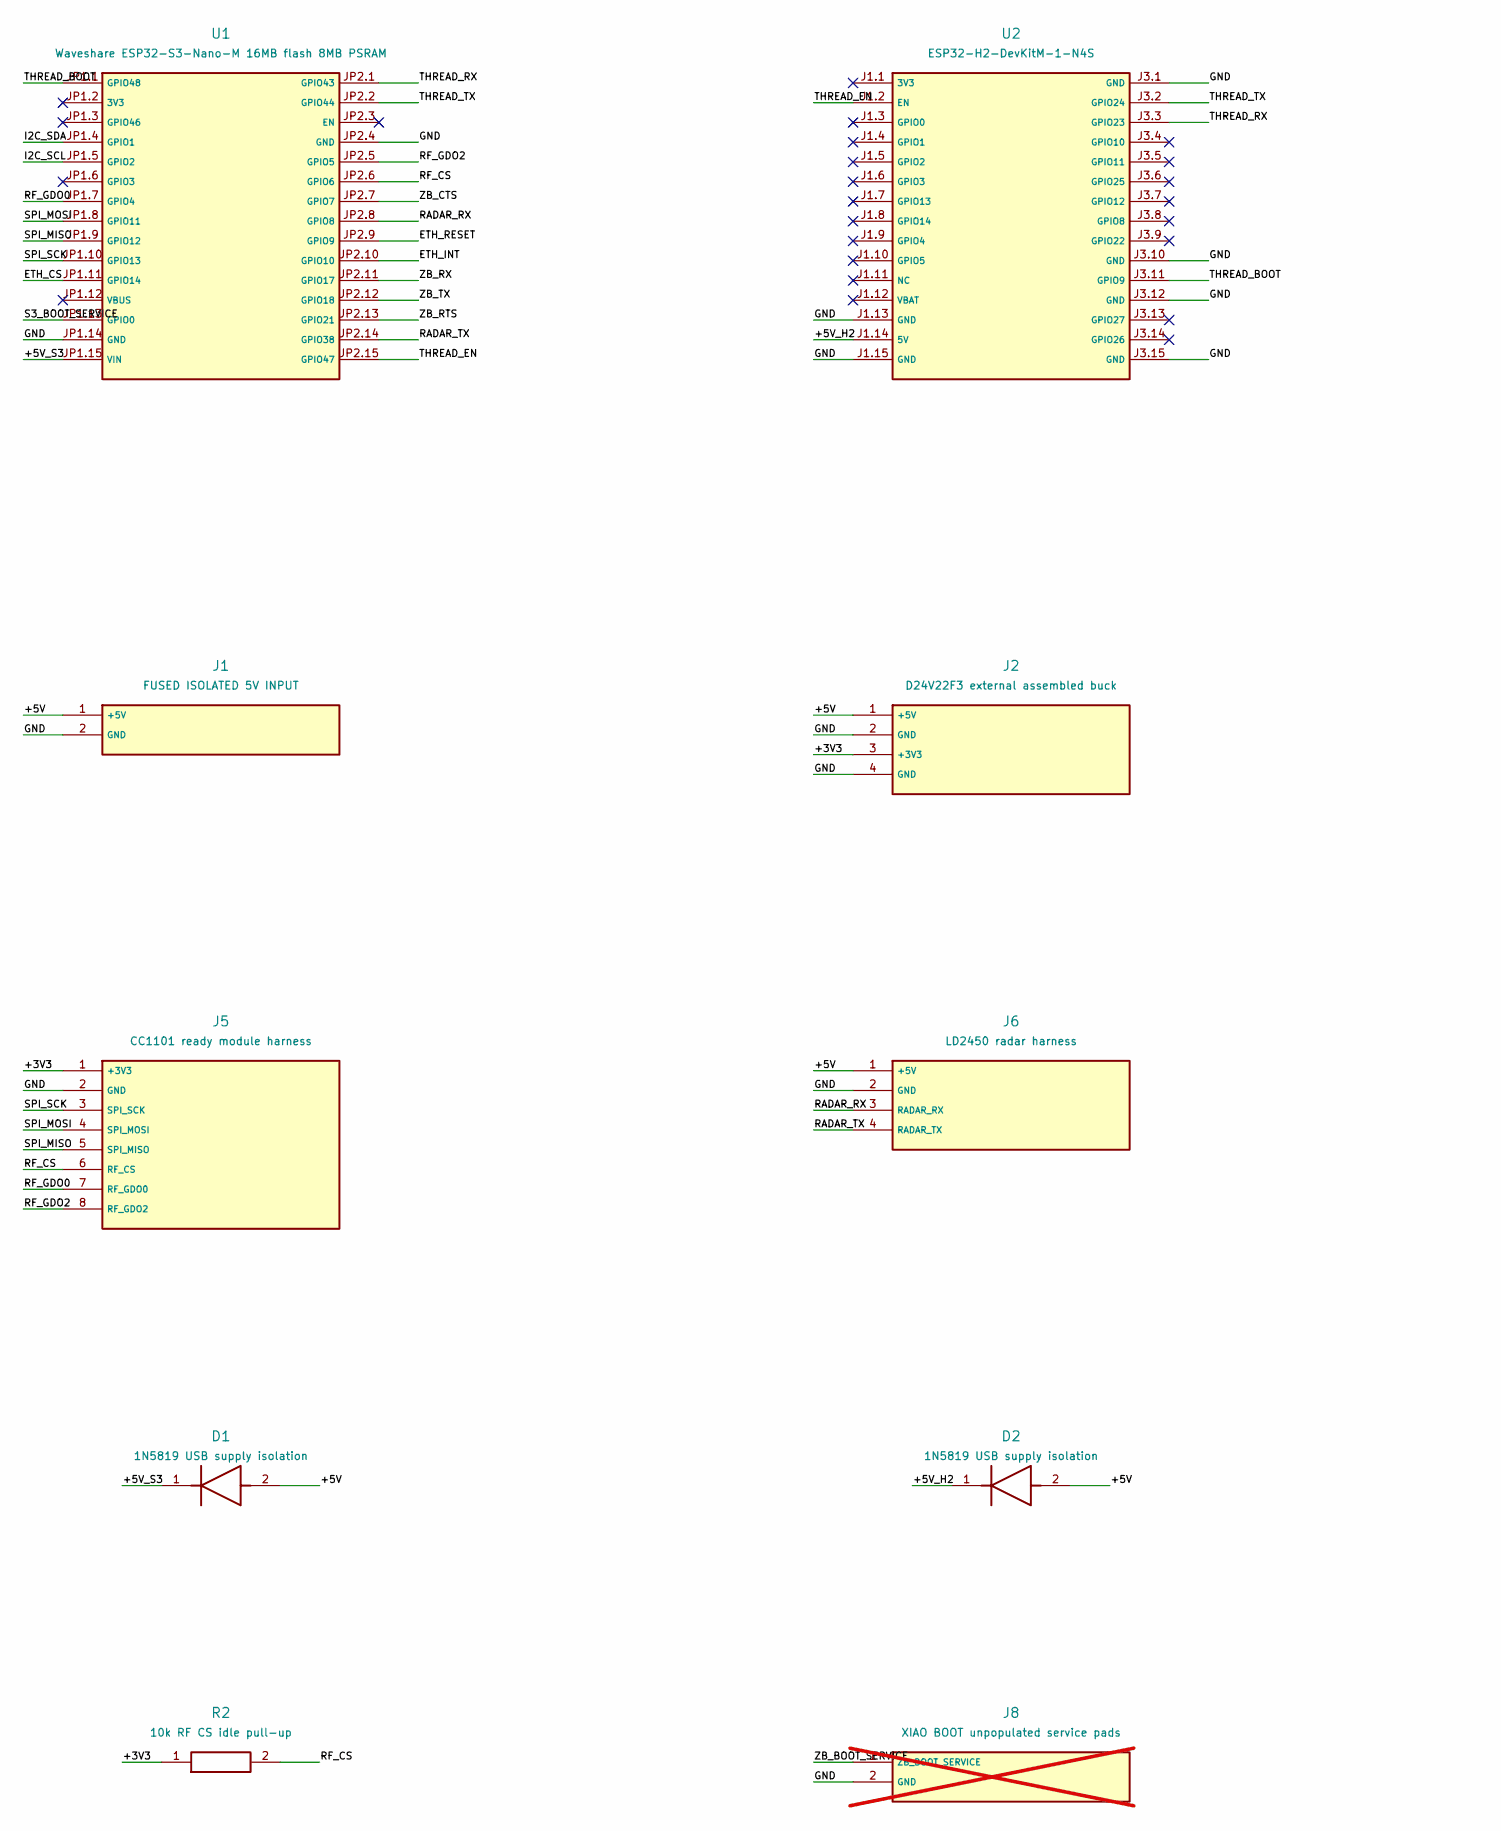
[picture p121: schematic mc1.kicad_sch, MC1 Nano - ready-module carrier / engineering prototype, part in row 1, column 1]

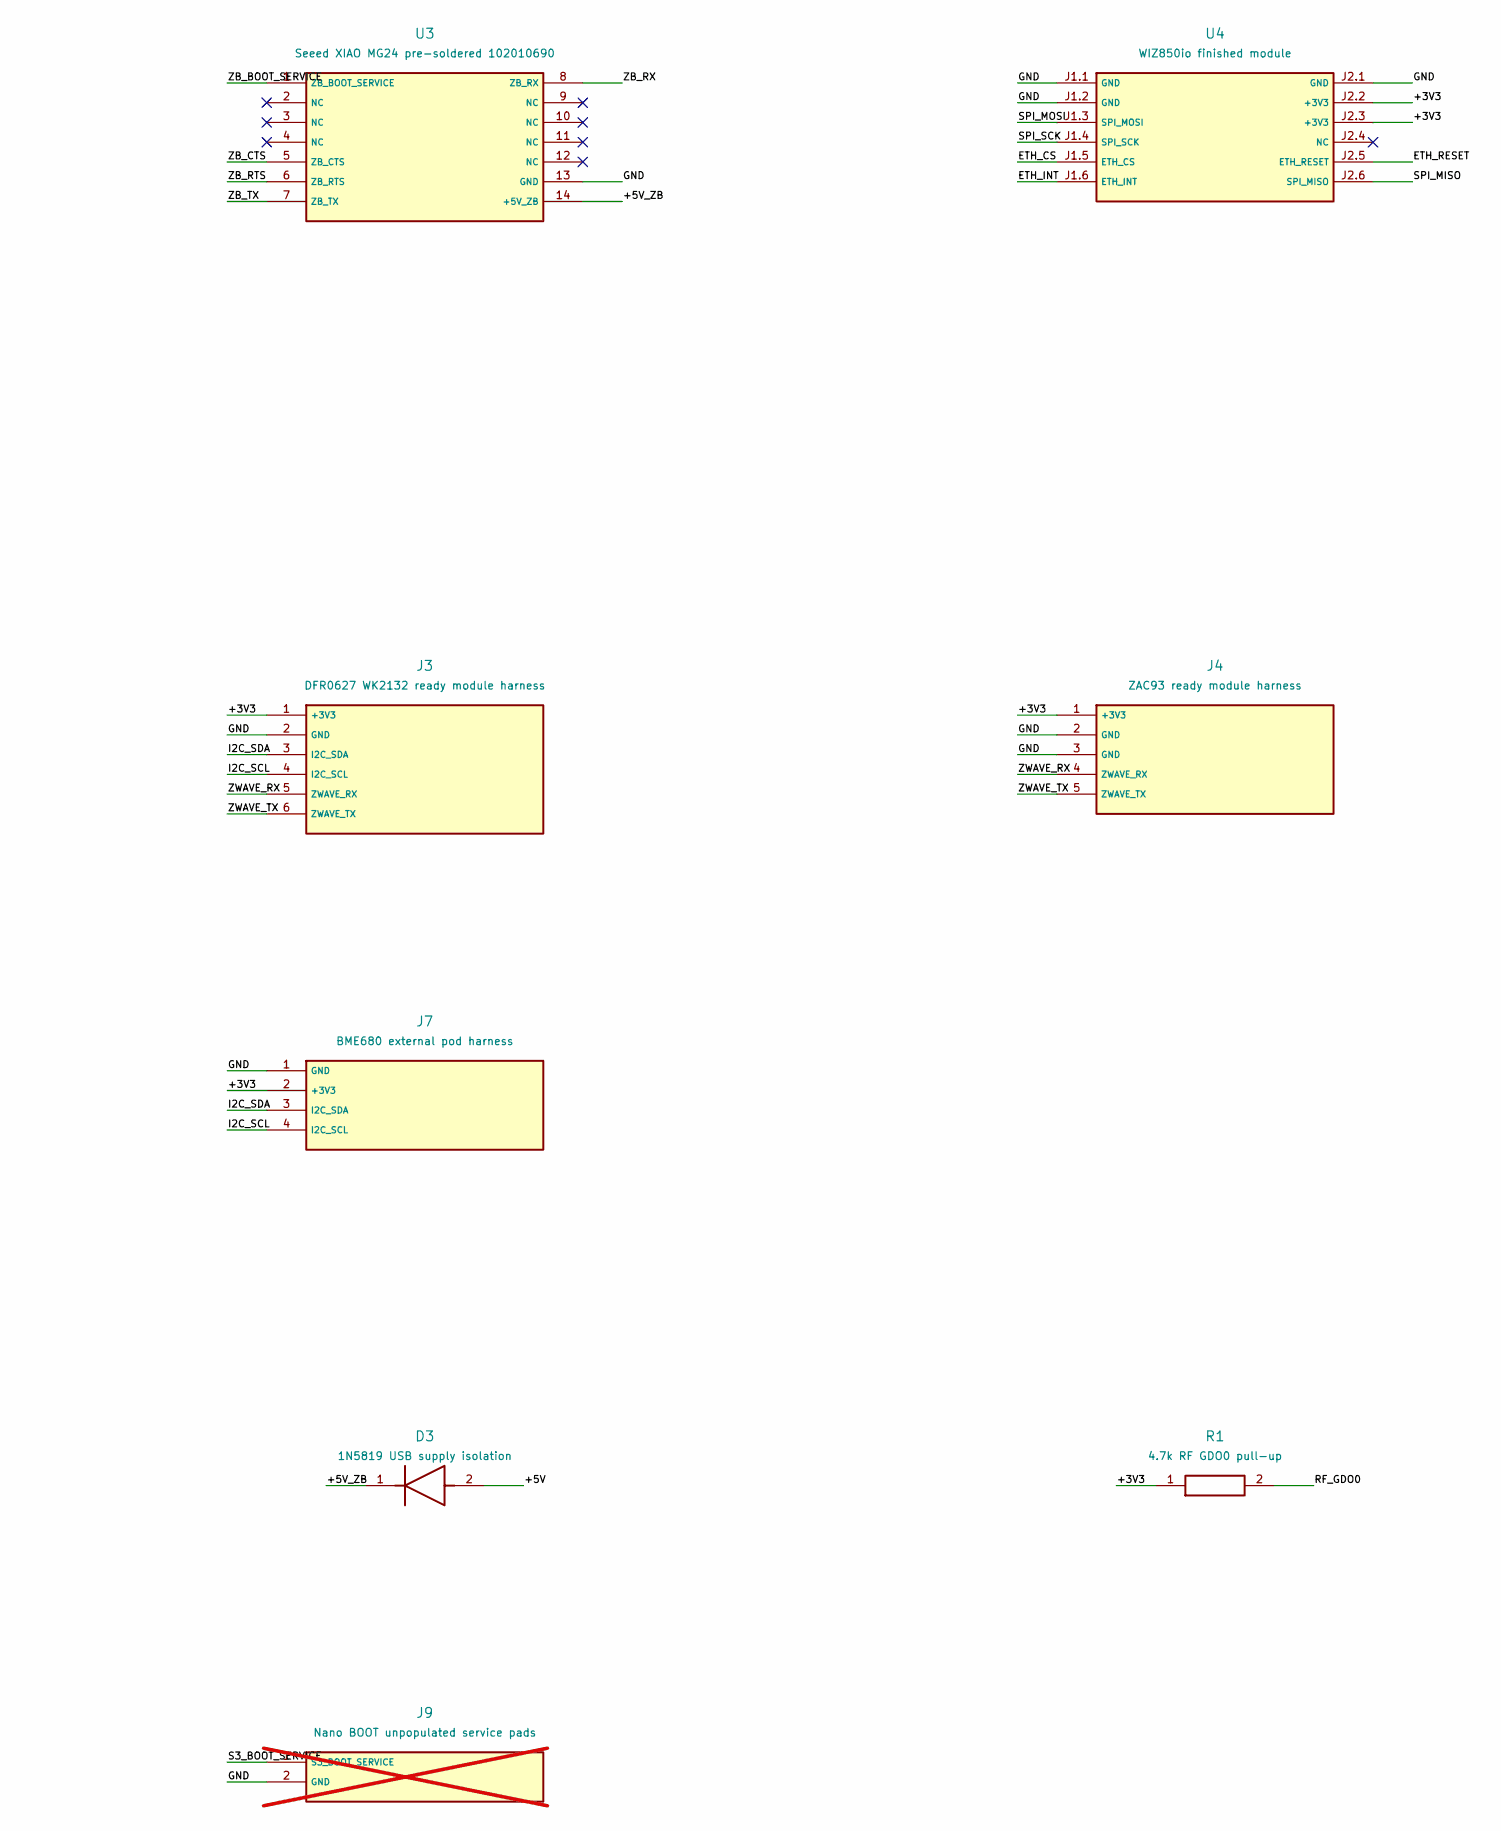
[picture p122: schematic mc1.kicad_sch, MC1 Nano - ready-module carrier / engineering prototype, part in row 1, column 2]

Parts:
D1, D2, D3: 1N5819 USB supply isolation; D_DO-41_SOD81_P7.62mm_Horizontal
J1: FUSED ISOLATED 5V INPUT; PinHeader_1x02_P2.54mm_Vertical
J2: D24V22F3 external assembled buck; PinHeader_1x04_P2.54mm_Vertical
J3: DFR0627 WK2132 ready module harness; PinHeader_1x06_P2.54mm_Vertical
J4: ZAC93 ready module harness; PinHeader_1x05_P2.54mm_Vertical
J5: CC1101 ready module harness; PinHeader_1x08_P2.54mm_Vertical
J6: LD2450 radar harness; PinHeader_1x04_P2.54mm_Vertical
J7: BME680 external pod harness; PinHeader_1x04_P2.54mm_Vertical
J8: XIAO BOOT unpopulated service pads; PinHeader_1x02_P2.54mm_Vertical; not fitted
J9: Nano BOOT unpopulated service pads; PinHeader_1x02_P2.54mm_Vertical; not fitted
R1: 4.7k RF GDO0 pull-up; R_Axial_DIN0207_L6.3mm_D2.5mm_P7.62mm_Horizontal
R2: 10k RF CS idle pull-up; R_Axial_DIN0207_L6.3mm_D2.5mm_P7.62mm_Horizontal
U1: Waveshare ESP32-S3-Nano-M 16MB flash 8MB PSRAM; S3_Nano_M
U2: ESP32-H2-DevKitM-1-N4S; H2_DevKitM1
U3: Seeed XIAO MG24 pre-soldered 102010690; XIAO_MG24
U4: WIZ850io finished module; WIZ850io

Connections:
/+3V3: J2.3 (+3V3), J3.1 (+3V3), J4.1 (+3V3), J5.1 (+3V3), J7.2 (+3V3), R1.1, R2.1, U4.J2.2 (+3V3), U4.J2.3 (+3V3)
/+5V: D1.2, D2.2, D3.2, J1.1 (+5V), J2.1 (+5V), J6.1 (+5V)
/+5V_H2: D2.1, U2.J1.14 (5V)
/+5V_S3: D1.1, U1.JP1.15 (VIN)
/+5V_ZB: D3.1, U3.14 (+5V_ZB)
/ETH_CS: U1.JP1.11 (GPIO14), U4.J1.5 (ETH_CS)
/ETH_INT: U1.JP2.10 (GPIO10), U4.J1.6 (ETH_INT)
/ETH_RESET: U1.JP2.9 (GPIO9), U4.J2.5 (ETH_RESET)
/GND: J1.2 (GND), J2.2 (GND), J2.4 (GND), J3.2 (GND), J4.2 (GND), J4.3 (GND), J5.2 (GND), J6.2 (GND), J7.1 (GND), J8.2 (GND), J9.2 (GND), U1.JP1.14 (GND), U1.JP2.4 (GND), U2.J1.13 (GND), U2.J1.15 (GND), U2.J3.1 (GND), U2.J3.10 (GND), U2.J3.12 (GND), U2.J3.15 (GND), U3.13 (GND), U4.J1.1 (GND), U4.J1.2 (GND), U4.J2.1 (GND)
/I2C_SCL: J3.4 (I2C_SCL), J7.4 (I2C_SCL), U1.JP1.5 (GPIO2)
/I2C_SDA: J3.3 (I2C_SDA), J7.3 (I2C_SDA), U1.JP1.4 (GPIO1)
/RADAR_RX: J6.3 (RADAR_RX), U1.JP2.8 (GPIO8)
/RADAR_TX: J6.4 (RADAR_TX), U1.JP2.14 (GPIO38)
/RF_CS: J5.6 (RF_CS), R2.2, U1.JP2.6 (GPIO6)
/RF_GDO0: J5.7 (RF_GDO0), R1.2, U1.JP1.7 (GPIO4)
/RF_GDO2: J5.8 (RF_GDO2), U1.JP2.5 (GPIO5)
/S3_BOOT_SERVICE: J9.1 (S3_BOOT_SERVICE), U1.JP1.13 (GPIO0)
/SPI_MISO: J5.5 (SPI_MISO), U1.JP1.9 (GPIO12), U4.J2.6 (SPI_MISO)
/SPI_MOSI: J5.4 (SPI_MOSI), U1.JP1.8 (GPIO11), U4.J1.3 (SPI_MOSI)
/SPI_SCK: J5.3 (SPI_SCK), U1.JP1.10 (GPIO13), U4.J1.4 (SPI_SCK)
/THREAD_BOOT: U1.JP1.1 (GPIO48), U2.J3.11 (GPIO9)
/THREAD_EN: U1.JP2.15 (GPIO47), U2.J1.2 (EN)
/THREAD_RX: U1.JP2.1 (GPIO43), U2.J3.3 (GPIO23)
/THREAD_TX: U1.JP2.2 (GPIO44), U2.J3.2 (GPIO24)
/ZB_BOOT_SERVICE: J8.1 (ZB_BOOT_SERVICE), U3.1 (ZB_BOOT_SERVICE)
/ZB_CTS: U1.JP2.7 (GPIO7), U3.5 (ZB_CTS)
/ZB_RTS: U1.JP2.13 (GPIO21), U3.6 (ZB_RTS)
/ZB_RX: U1.JP2.11 (GPIO17), U3.8 (ZB_RX)
/ZB_TX: U1.JP2.12 (GPIO18), U3.7 (ZB_TX)
/ZWAVE_RX: J3.5 (ZWAVE_RX), J4.4 (ZWAVE_RX)
/ZWAVE_TX: J3.6 (ZWAVE_TX), J4.5 (ZWAVE_TX)

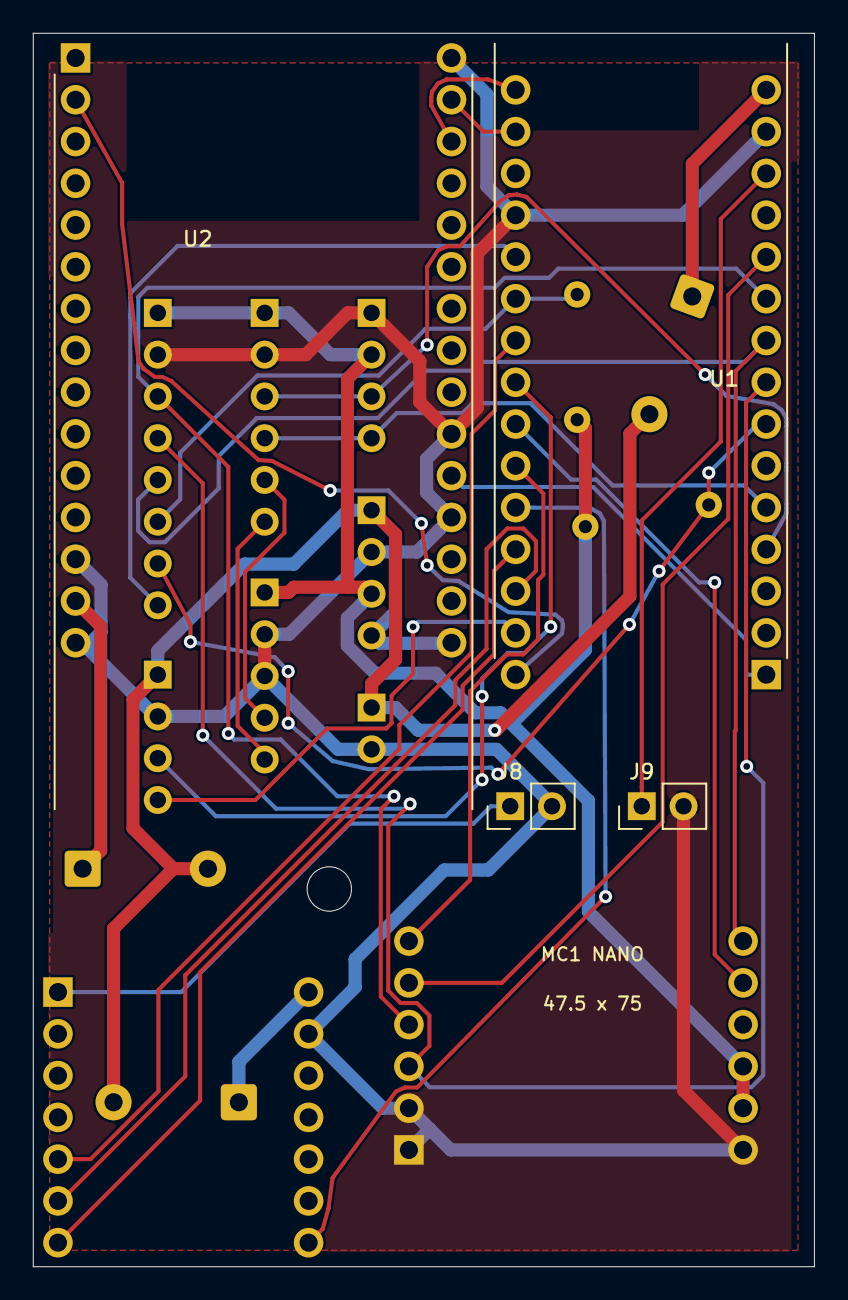
[picture p123: board hardware/module-carrier/cad/mc1.kicad_pcb from above]

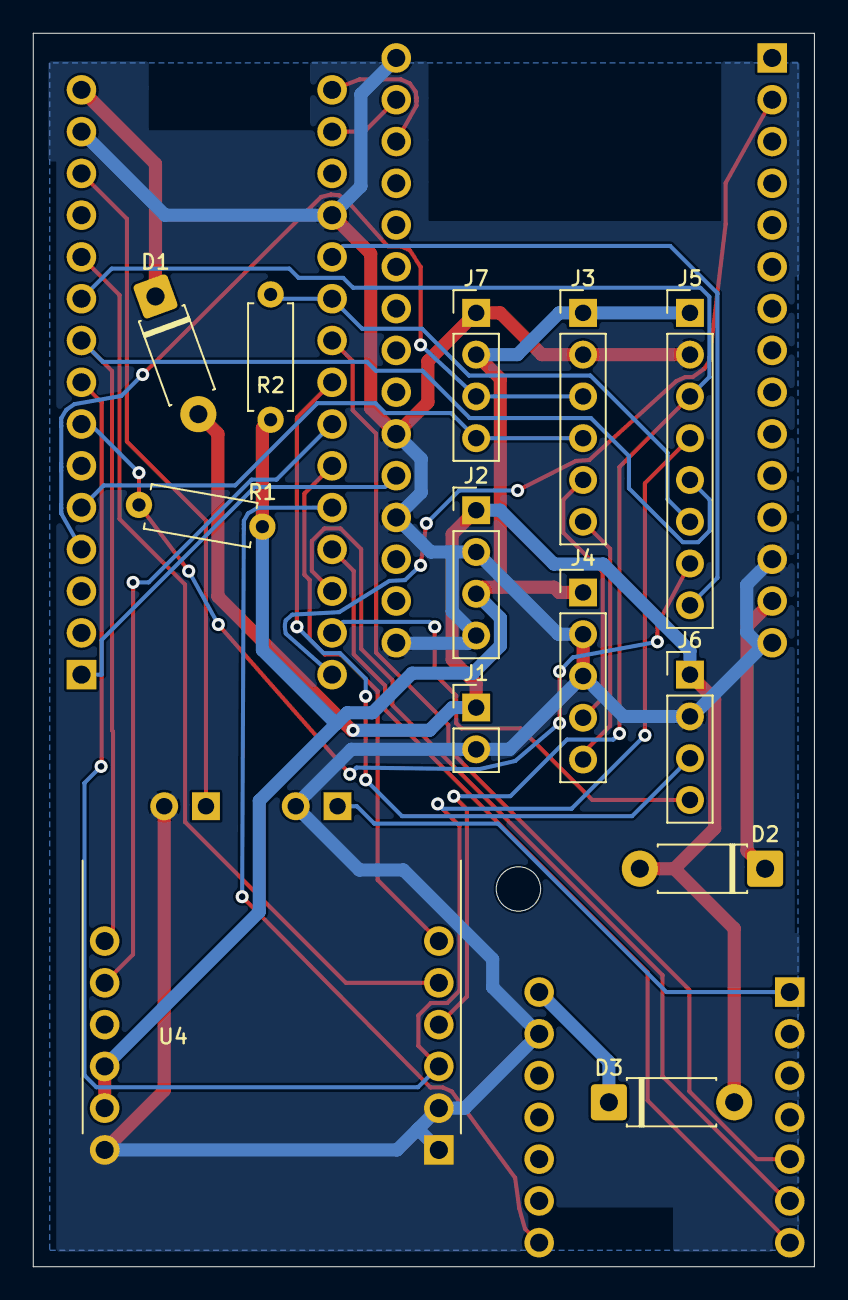
[picture p124: board hardware/module-carrier/cad/mc1.kicad_pcb from below]

Board: 2 copper layers, 47.5 x 75.0 mm, 19 parts (13 on the bottom side), 31 nets.

Other parts of the board:
H3: M2.5 NYLON NPTH
