ha-homelab/ha-radio-hub/hardware/low-power/diy/diy.kicad_pcb

## KiCad design hardware/low-power/diy/diy.kicad_pcb (2026-10-17)

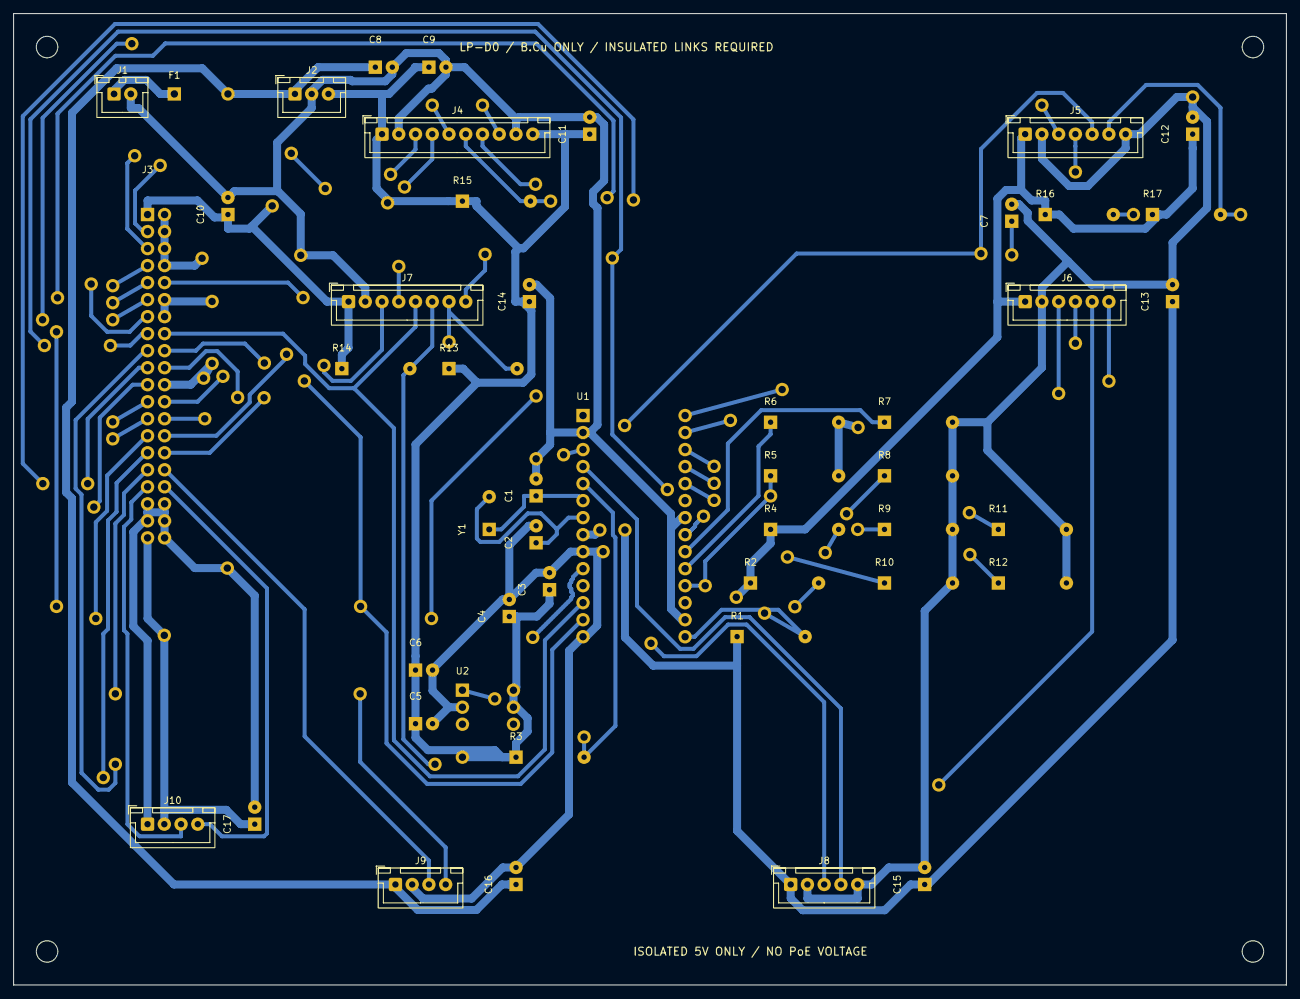
[picture p125: board diy.kicad_pcb from above]

Board: 2 copper layers, 190.0 x 145.0 mm, 152 parts (0 on the bottom side), 97 nets.

Parts:
C1: 22pF; Radial_C_P2.54
C2: 33pF; Radial_C_P2.54
C3, C5, C10, C11, C12, C13, C14, C15, C16, C17: 100nF; Radial_C_P2.54
C4, C7: 1uF; Radial_C_P2.54
C6: 1nF; Radial_C_P2.54
C8, C9: 22uF; Radial_C_P2.54
F1: Littelfuse 022901.5MXP; FuseHarness
H1, H2, H3, H4: M3 manually drilled
J1: B2B-XH-A; JST_XH_B2B-XH-A_1x02_P2.50mm_Vertical
J2: B3B-XH-A; JST_XH_B3B-XH-A_1x03_P2.50mm_Vertical
J3: 61204021621; Wurth_61204021621
J4: B10B-XH-A; JST_XH_B10B-XH-A_1x10_P2.50mm_Vertical
J5: B7B-XH-A; JST_XH_B7B-XH-A_1x07_P2.50mm_Vertical
J6: B6B-XH-A; JST_XH_B6B-XH-A_1x06_P2.50mm_Vertical
J7: B8B-XH-A; JST_XH_B8B-XH-A_1x08_P2.50mm_Vertical
J8: B5B-XH-A; JST_XH_B5B-XH-A_1x05_P2.50mm_Vertical
J9, J10: B4B-XH-A; JST_XH_B4B-XH-A_1x04_P2.50mm_Vertical
R1: 1k; Axial_R_P10.16
R2, R3, R4, R14, R15, R16, R17: 10k; Axial_R_P10.16
R5, R6, R7, R8, R9, R10, R11, R12: 100k; Axial_R_P10.16
R13: 4.7k; Axial_R_P10.16
T1, T2, T3, T4, T5, T6, T7, T8, T9, T10, T11, T12, T13, T14, T15, T16, T17, T18, T19, T20, T21, T22, T23, T24, T25, T26, T27, T28, T29, T30, T31, T32, T33, T34, T35, T36, T37, T38, T39, T40, T41, T42, T43, T44, T45, T46, T47, T48, T49, T50, T51, T52, T53, T54, T55, T56, T57, T58, T59, T60, T61, T62, T63, T64, T65, T66, T67, T68, T69, T70, T71, T72, T73, T74, T75, T76, T77, T78, T79, T80, T81, T82, T83, T84, T85, T86, T87, T88, T89, T90, T91, T92, T93, T94, T95, T96, T97, T98, T99, T101: Insulated wire terminal hole; WireTerminal
U1: SC16IS752IPW,128; Adafruit1208_TSSOP28
U2: TPS3808G33DBVR; Adafruit1230_SOT23_6
Y1: AB-3.6864MHZ-B2; HC49U

Connections:
/+3V3__1: C10.1, J3.1, J7.1, R14.1, T2.1
/+3V3__2: C3.1, C4.1, C5.1, C6.1, C9.1, C11.1, C14.1, J2.3, J4.1, J4.10, R3.1, R13.1, R15.1, T3.1, T79.1, U2.5, U2.6
/+3V3__3: C12.1, J5.1, J6.1, R2.1, R4.1, R16.1, R17.1, T78.1
/+3V3__4: C13.1, C15.1, J8.1, R1.1, T5.1
/+3V3__5: C17.1, J3.39, J10.2, T1.1
/+3V3__6: T4.1, U1.8
/+5V_IN__1: F1.1, J1.1
/+5V__1: C8.1, C16.1, F1.2, J2.1, J9.1
/GND__1: C1.2, C8.2, C9.2, C10.2, C11.2, C14.2, J1.2, J2.2, J4.2, J4.9, J7.2, T10.1, T11.1, U1.2, U1.16, U1.22
/GND__2: C7.2, C12.2, C13.2, C15.2, J5.2, J5.7, J6.2, J8.2, J8.5, R7.2, R8.2, R9.2, R10.2, R11.2, R12.2, T13.1
/GND__3: C2.2, C3.2, C4.2, C5.2, C6.2, C16.2, J9.2, T12.1, U1.9, U1.14, U2.2
/GND__4: C17.2, J3.35, J3.36, J3.37, J3.38, J3.40, J10.1, T9.1
/GND__5: J3.12, J3.14, T7.1
/GND__6: J3.2, J3.4, J3.6, J3.8, T6.1
/GND__7: J3.22, T8.1, T81.1
/GND__8: R5.2, R6.2, T80.1
/bme680_scl__1: J3.34, J10.4
/bme680_sda__1: J3.33, J10.3
/cc1101_cs__1: J3.17, T14.1
/cc1101_cs__2: J7.6, R14.2, T15.1
/cc1101_gdo0_tx__1: J3.18, T16.1
/cc1101_gdo0_tx__2: J7.7, R13.2, T82.1
/cc1101_gdo2_rx__1: J3.19, T18.1
/cc1101_gdo2_rx__2: J7.8, T19.1
/cc1101_gdo2_rx__3: T17.1, T20.1
/gpio0_unused__1: R5.1, T21.1, T22.1, U1.18
/gpio1_unused__1: R6.1, U1.19
/gpio2_unused__1: R7.1, U1.20
/gpio3_unused__1: R8.1, T83.1
/gpio3_unused__2: T84.1, U1.21
/gpio4_unused__1: R9.1, T85.1
/gpio4_unused__2: T86.1, U1.25
/gpio5_unused__1: R10.1, T87.1
/gpio5_unused__2: T88.1, U1.26
/gpio6_unused__1: R11.1, T89.1
/gpio6_unused__2: T90.1, U1.27
/gpio7_unused__1: R12.1, T91.1
/gpio7_unused__2: T92.1, U1.28
/h2_boot__1: J3.26, T23.1
/h2_boot__2: J5.6, R17.2, T24.1
/h2_reset__1: C7.1, T28.1
/h2_reset__2: J3.25, T25.1
/h2_reset__3: J5.5, T26.1, T27.1
/h2_reset__4: R16.2, T29.1
/h2_rx__1: J3.24, T30.1
/h2_rx__2: J5.4, T31.1
/h2_tx__1: J3.23, T32.1
/h2_tx__2: J5.3, T33.1
/ld2450_rx__1: J3.32, J9.3
/ld2450_tx__1: J3.31, T34.1
/ld2450_tx__2: J9.4, T35.1
/mg24_cts__1: J3.30, T36.1
/mg24_cts__2: J6.6, T37.1
/mg24_rts__1: J3.29, T38.1
/mg24_rts__2: J6.5, T39.1
/mg24_rx__1: J3.28, T40.1
/mg24_rx__2: J6.4, T41.1
/mg24_tx__1: J3.27, T42.1
/mg24_tx__2: J6.3, T45.1
/mg24_tx__3: T43.1, T44.1
/rxb_unused__1: R4.2, T93.1
/rxb_unused__2: T94.1, U1.24
/sc16_cs__1: J3.20, T46.1
/sc16_cs__2: R2.2, T95.1
/sc16_cs__3: T96.1, U1.10
/sc16_irq__1: J3.21, T47.1
/sc16_irq__2: R1.2, T97.1, U1.15
/sc16_reset__1: R3.2, T98.1, U1.5
/sc16_reset__2: T99.1, U2.1
/shared_spi_miso__1: J3.16, J7.5, U1.12
/shared_spi_mosi__1: J3.15, T49.1
/shared_spi_mosi__2: J7.4, T50.1
/shared_spi_mosi__4: T48.1, T51.1, T52.1
/shared_spi_sclk__1: J3.13, T55.1
/shared_spi_sclk__2: J7.3, T57.1
/shared_spi_sclk__3: T56.1, T58.1, U1.13
/shared_spi_sclk__4: T53.1, T54.1
/w5500_cs__1: J3.9, T60.1
/w5500_cs__2: J4.6, R15.2, T61.1
/w5500_cs__3: T59.1, T62.1
/w5500_irq__1: J3.10, T63.1
/w5500_irq__2: J4.7, T64.1
/w5500_miso__1: J3.7, T65.1
/w5500_miso__2: J4.5, T66.1
/w5500_mosi__1: J3.5, T67.1
/w5500_mosi__2: J4.4, T70.1
/w5500_mosi__3: T68.1, T69.1
/w5500_reset__1: J3.11, T72.1
/w5500_reset__2: J4.8, T74.1
/w5500_reset__3: T71.1, T73.1
/w5500_sclk__1: J3.3, T75.1
/w5500_sclk__2: J4.3, T76.1
/xtal1__1: C1.1, U1.6, Y1.1
/xtal2__1: C2.1, U1.7, Y1.2
/zac93_rx__1: J8.4, U1.4
/zac93_tx__1: J8.3, T77.1
/zac93_tx__2: T101.1, U1.3
