ha-homelab/ha-radio-hub/hardware/low-power/integrated/integrated.kicad_pcb

## KiCad design hardware/low-power/integrated/integrated.kicad_pcb (2026-10-17)

Schematic: integrated.kicad_sch, LP-I0 integrated radio hub - ENGINEERING PROTOTYPE

Parts:
C1: 22pF; C_0805_2012Metric
C2: 33pF; C_0805_2012Metric
C3, C6, C9, C13, C15, C17, C18, C19, C20, C21, C22, C23, C24, C25, C27, C42: 100nF; C_0805_2012Metric
C4, C7, C10, C26, C28, C43: 10uF; C_1206_3216Metric
C5, C8, C12: 1uF; C_0805_2012Metric
C11: 100nF; C_0603_1608Metric
C14: 1nF; C_0805_2012Metric
C16, C39, C40, C41: 22uF; C_1206_3216Metric
C29, C36: 10nF; C_0805_2012Metric
C30: 4.7uF; C_0805_2012Metric
C31, C32: 18pF; C_0805_2012Metric
C33: 22nF; C_0805_2012Metric
C34, C35: 6.8nF; C_0805_2012Metric
C37, C38: 10nF 100V; C_1206_3216Metric
C50: 1nF 2kV; C_Disc_D7.5mm_W5.0mm_P7.50mm
D1, D2: SMBJ58CA; D_SMB
F1: 044901.5MR; Littelfuse_449
FB1: BLM21PG121SN1D; L_0805_2012Metric
J1: 0813-1X1T-57-F; Bel_0813_1X1T_57_F
J2: TYPE-C-31-M-12; USB_C_Receptacle_HRO_TYPE-C-31-M-12
J3: B8B-XH-A; JST_XH_B8B-XH-A_1x08_P2.50mm_Vertical
J4: B5B-XH-A; JST_XH_B5B-XH-A_1x05_P2.50mm_Vertical
J5: B4B-XH-A; JST_XH_B4B-XH-A_1x04_P2.50mm_Vertical
J6: BM04B-SRSS-TB; JST_SH_BM04B-SRSS-TB_1x04-1MP_P1.00mm_Vertical
J7, J8: B6B-XH-A; JST_XH_B6B-XH-A_1x06_P2.50mm_Vertical
R1: 1k; R_0805_2012Metric
R2, R3, R4, R6, R7, R8, R9, R10, R11, R12, R13, R14, R15, R16: 10k; R_0805_2012Metric
R5: 4.7k; R_0805_2012Metric
R17, R18: 5.1k; R_0805_2012Metric
R19, R20: 22; R_0805_2012Metric
R21, R22, R23, R24, R25, R26, R27, R28: 100k; R_0805_2012Metric
R29: 12.4k; R_0805_2012Metric
R30: 1M; R_0805_2012Metric
R31, R32, R34, R35: 49.9; R_0805_2012Metric
R33: 10; R_0805_2012Metric
SW1, SW2, SW3, SW4: SW_PUSH; SW_SPST_TL3342
U1: ESP32-S3-WROOM-1-N16R8; ESP32-S3-WROOM-1
U2: ESP32-H2-MINI-1-H4S; ESP32-H2-MINI-1
U3: MGM240PA22VNA3; MGM240P
U4: W5500; LQFP-48_7x7mm_P0.5mm
U5: NXP SC16IS752IPW,128 / TSSOP28; TSSOP-28_4.4x9.7mm_P0.65mm
U6: TI TPS3808G33DBVR / SOT-23-6; SOT-23-6
U7: Ag97005-FL; Ag97000_FL
U8: D24V22F3
U9: USBLC6-2SC6; SOT-23-6
Y1: ABLS-3.6864MHZ-B2-T; Crystal_SMD_HC49-SD
Y2: ABM8-25.000MHZ-B2-T; Crystal_SMD_3225-4Pin_3.2x2.5mm

Connections:
3v3: C3.1 (3v3), C4.1 (3v3), C6.1 (3v3), C7.1 (3v3), C9.1 (3v3), C10.1 (3v3), C11.1 (3v3), C12.1 (3v3), C13.1 (3v3), C14.1 (3v3), C16.1 (3v3), C17.1 (3v3), C18.1 (3v3), C27.1 (3v3), C28.1 (3v3), FB1.1 (3v3), J3.1 (3v3), J4.1 (3v3), J6.2 (3v3), J7.1 (3v3), J8.1 (3v3), R1.2 (3v3), R2.2 (3v3), R3.2 (3v3), R4.2 (3v3), R5.2 (3v3), R6.2 (3v3), R7.2 (3v3), R8.2 (3v3), R9.2 (3v3), R11.2 (3v3), R12.2 (3v3), R13.2 (3v3), R14.2 (3v3), R15.2 (3v3), R16.2 (3v3), U1.2 (3v3), U2.3 (3v3), U3.15 (3v3), U4.28 (3v3), U5.8 (3v3), U6.5 (3v3), U6.6 (3v3), U8.VOUT (3v3)
3v3_analog: C20.1 (3v3_analog), C21.1 (3v3_analog), C22.1 (3v3_analog), C23.1 (3v3_analog), C24.1 (3v3_analog), C25.1 (3v3_analog), C26.1 (3v3_analog), FB1.2 (3v3_analog), R31.2 (3v3_analog), R32.2 (3v3_analog), R33.2 (3v3_analog), U4.4 (3v3_analog), U4.8 (3v3_analog), U4.11 (3v3_analog), U4.15 (3v3_analog), U4.17 (3v3_analog), U4.21 (3v3_analog)
5v_fused: C19.1 (5v_fused), F1.2 (5v_fused), J5.1 (5v_fused), U8.VIN (5v_fused)
5v_pd: C39.1 (5v_pd), C40.1 (5v_pd), C41.1 (5v_pd), C42.1 (5v_pd), C43.1 (5v_pd), F1.1 (5v_pd), U7.8 (5v_pd)
POE_12: C37.1 (POE_12), D1.1 (POE_12), J1.5 (POE_12), U7.1 (POE_12)
POE_36: C37.2 (POE_36), D1.2 (POE_36), J1.10 (POE_36), U7.2 (POE_36)
POE_45: C38.1 (POE_45), D2.1 (POE_45), J1.6 (POE_45), U7.3 (POE_45)
POE_78: C38.2 (POE_78), D2.2 (POE_78), J1.11 (POE_78), U7.4 (POE_78)
bme680_scl: J6.4 (bme680_scl), U1.38 (bme680_scl)
bme680_sda: J6.3 (bme680_sda), U1.39 (bme680_sda)
cc1101_cs: J3.6 (cc1101_cs), R6.1 (cc1101_cs), U1.8 (cc1101_cs)
cc1101_gdo0_tx: J3.7 (cc1101_gdo0_tx), R5.1 (cc1101_gdo0_tx), U1.4 (cc1101_gdo0_tx)
cc1101_gdo2_rx: J3.8 (cc1101_gdo2_rx), U1.5 (cc1101_gdo2_rx)
chassis: C50.1 (chassis), J1.S1 (chassis), J1.S2 (chassis)
eth_1v2: C29.1 (eth_1v2), U4.22 (eth_1v2)
eth_exres: R29.1 (eth_exres), U4.10 (eth_exres)
eth_pmode: R16.1 (eth_pmode), U4.43 (eth_pmode), U4.44 (eth_pmode), U4.45 (eth_pmode)
eth_rxn: C35.1 (eth_rxn), R35.1 (eth_rxn), U4.5 (eth_rxn)
eth_rxp: C34.1 (eth_rxp), R34.1 (eth_rxp), U4.6 (eth_rxp)
eth_rxterm: C36.1 (eth_rxterm), R34.2 (eth_rxterm), R35.2 (eth_rxterm)
eth_tocap: C30.1 (eth_tocap), U4.20 (eth_tocap)
eth_txn: J1.9 (eth_txn), R32.1 (eth_txn), U4.1 (eth_txn)
eth_txp: J1.2 (eth_txp), R31.1 (eth_txp), U4.2 (eth_txp)
eth_xi: C31.1 (eth_xi), R30.1 (eth_xi), U4.30 (eth_xi), Y2.1 (eth_xi)
eth_xo: C32.1 (eth_xo), R30.2 (eth_xo), U4.31 (eth_xo), Y2.3 (eth_xo)
gnd: C1.2 (gnd), C2.2 (gnd), C3.2 (gnd), C4.2 (gnd), C5.2 (gnd), C6.2 (gnd), C7.2 (gnd), C8.2 (gnd), C9.2 (gnd), C10.2 (gnd), C11.2 (gnd), C12.2 (gnd), C13.2 (gnd), C14.2 (gnd), C15.2 (gnd), C16.2 (gnd), C17.2 (gnd), C18.2 (gnd), C19.2 (gnd), C20.2 (gnd), C21.2 (gnd), C22.2 (gnd), C23.2 (gnd), C24.2 (gnd), C25.2 (gnd), C26.2 (gnd), C27.2 (gnd), C28.2 (gnd), C29.2 (gnd), C30.2 (gnd), C31.2 (gnd), C32.2 (gnd), C33.2 (gnd), C36.2 (gnd), C39.2 (gnd), C40.2 (gnd), C41.2 (gnd), C42.2 (gnd), C43.2 (gnd), C50.2 (gnd), J2.A1 (gnd), J2.A12 (gnd), J2.B1 (gnd), J2.B12 (gnd), J2.SH (gnd), J3.2 (gnd), J4.2 (gnd), J4.5 (gnd), J5.2 (gnd), J6.1 (gnd), J7.2 (gnd), J8.2 (gnd), R10.2 (gnd), R17.2 (gnd), R18.2 (gnd), R21.2 (gnd), R22.2 (gnd), R23.2 (gnd), R24.2 (gnd), R25.2 (gnd), R26.2 (gnd), R27.2 (gnd), R28.2 (gnd), R29.2 (gnd), SW1.2 (gnd), SW2.2 (gnd), SW3.2 (gnd), SW4.2 (gnd), U1.1 (gnd), U1.40 (gnd), U1.41 (gnd), U2.1 (gnd), U2.2 (gnd), U2.11 (gnd), U2.14 (gnd), U2.36 (gnd), U2.37 (gnd), U2.38 (gnd), U2.39 (gnd), U2.40 (gnd), U2.41 (gnd), U2.42 (gnd), U2.43 (gnd), U2.44 (gnd), U2.45 (gnd), U2.46 (gnd), U2.47 (gnd), U2.48 (gnd), U2.49 (gnd), U2.50 (gnd), U2.51 (gnd), U2.52 (gnd), U2.53 (gnd), U3.1 (gnd), U3.14 (gnd), U3.23 (gnd), U3.32 (gnd), U3.34 (gnd), U3.35 (gnd), U3.36 (gnd), U4.3 (gnd), U4.9 (gnd), U4.14 (gnd), U4.16 (gnd), U4.19 (gnd), U4.23 (gnd), U4.29 (gnd), U4.48 (gnd), U5.2 (gnd), U5.9 (gnd), U5.14 (gnd), U5.16 (gnd), U5.22 (gnd), U6.2 (gnd), U7.7 (gnd), U8.GND (gnd), U8.GND2 (gnd), U9.2 (gnd), Y2.2 (gnd), Y2.4 (gnd)
h2_boot: J8.6 (h2_boot), R8.1 (h2_boot), U1.25 (h2_boot), U2.23 (h2_boot)
h2_gpio8: R9.1 (h2_gpio8), U2.22 (h2_gpio8)
h2_gpio25: R10.1 (h2_gpio25), U2.25 (h2_gpio25)
h2_reset: C8.1 (h2_reset), J8.5 (h2_reset), R7.1 (h2_reset), U1.24 (h2_reset), U2.8 (h2_reset)
h2_rx: J8.3 (h2_rx), U1.36 (h2_rx), U2.31 (h2_rx)
h2_tx: J8.4 (h2_tx), U1.37 (h2_tx), U2.30 (h2_tx)
ld2450_rx: J5.3 (ld2450_rx), U1.33 (ld2450_rx)
ld2450_tx: J5.4 (ld2450_tx), U1.32 (ld2450_tx)
mag_ct: C33.1 (mag_ct), J1.7 (mag_ct), R33.1 (mag_ct)
mag_rxn: C35.2 (mag_rxn), J1.8 (mag_rxn)
mag_rxp: C34.2 (mag_rxp), J1.1 (mag_rxp)
mg24_boot: J7.6 (mg24_boot), R11.1 (mg24_boot), SW4.1 (mg24_boot), U3.7 (mg24_boot)
mg24_cts: U1.23 (mg24_cts), U3.6 (mg24_cts)
mg24_reset: J7.5 (mg24_reset), SW3.1 (mg24_reset), U3.31 (mg24_reset)
mg24_rts: U1.9 (mg24_rts), U3.5 (mg24_rts)
mg24_rx: U1.11 (mg24_rx), U3.13 (mg24_rx)
mg24_swclk: J7.3 (mg24_swclk), U3.8 (mg24_swclk)
mg24_swdio: J7.4 (mg24_swdio), U3.9 (mg24_swdio)
mg24_tx: U1.10 (mg24_tx), U3.12 (mg24_tx)
s3_boot: R13.1 (s3_boot), SW2.1 (s3_boot), U1.27 (s3_boot)
s3_en: C5.1 (s3_en), R12.1 (s3_en), SW1.1 (s3_en), U1.3 (s3_en)
sc16_cs: R3.1 (sc16_cs), U1.34 (sc16_cs), U5.10 (sc16_cs)
sc16_gpio0: R21.1 (sc16_gpio0), U5.18 (sc16_gpio0)
sc16_gpio1: R22.1 (sc16_gpio1), U5.19 (sc16_gpio1)
sc16_gpio2: R23.1 (sc16_gpio2), U5.20 (sc16_gpio2)
sc16_gpio3: R24.1 (sc16_gpio3), U5.21 (sc16_gpio3)
sc16_gpio4: R25.1 (sc16_gpio4), U5.25 (sc16_gpio4)
sc16_gpio5: R26.1 (sc16_gpio5), U5.26 (sc16_gpio5)
sc16_gpio6: R27.1 (sc16_gpio6), U5.27 (sc16_gpio6)
sc16_gpio7: R28.1 (sc16_gpio7), U5.28 (sc16_gpio7)
sc16_irq: R1.1 (sc16_irq), U1.35 (sc16_irq), U5.15 (sc16_irq)
sc16_reset: R2.1 (sc16_reset), U5.5 (sc16_reset), U6.1 (sc16_reset)
sc16_rxb: R4.1 (sc16_rxb), U5.24 (sc16_rxb)
sc16_xtal1: C1.1 (sc16_xtal1), U5.6 (sc16_xtal1), Y1.1 (sc16_xtal1)
sc16_xtal2: C2.1 (sc16_xtal2), U5.7 (sc16_xtal2), Y1.2 (sc16_xtal2)
shared_spi_miso: J3.5 (shared_spi_miso), U1.6 (shared_spi_miso), U5.12 (shared_spi_miso)
shared_spi_mosi: J3.4 (shared_spi_mosi), U1.12 (shared_spi_mosi), U5.11 (shared_spi_mosi)
shared_spi_sclk: J3.3 (shared_spi_sclk), U1.7 (shared_spi_sclk), U5.13 (shared_spi_sclk)
usb_cc1: J2.A5 (usb_cc1), R17.1 (usb_cc1)
usb_cc2: J2.B5 (usb_cc2), R18.1 (usb_cc2)
usb_dm: R19.2 (usb_dm), U1.13 (usb_dm)
usb_dm_port: J2.A7 (usb_dm_port), J2.B7 (usb_dm_port), R19.1 (usb_dm_port), U9.1 (usb_dm_port), U9.6 (usb_dm_port)
usb_dp: R20.2 (usb_dp), U1.14 (usb_dp)
usb_dp_port: J2.A6 (usb_dp_port), J2.B6 (usb_dp_port), R20.1 (usb_dp_port), U9.3 (usb_dp_port), U9.4 (usb_dp_port)
usb_vbus: C15.1 (usb_vbus), J2.A4 (usb_vbus), J2.A9 (usb_vbus), J2.B4 (usb_vbus), J2.B9 (usb_vbus), U9.5 (usb_vbus)
w5500_cs: R14.1 (w5500_cs), U1.22 (w5500_cs), U4.32 (w5500_cs)
w5500_irq: U1.18 (w5500_irq), U4.36 (w5500_irq)
w5500_miso: U1.20 (w5500_miso), U4.34 (w5500_miso)
w5500_mosi: U1.19 (w5500_mosi), U4.35 (w5500_mosi)
w5500_reset: R15.1 (w5500_reset), U1.17 (w5500_reset), U4.37 (w5500_reset)
w5500_sclk: U1.21 (w5500_sclk), U4.33 (w5500_sclk)
zwave_rx: J4.4 (zwave_rx), U5.4 (zwave_rx)
zwave_tx: J4.3 (zwave_tx), U5.3 (zwave_tx)

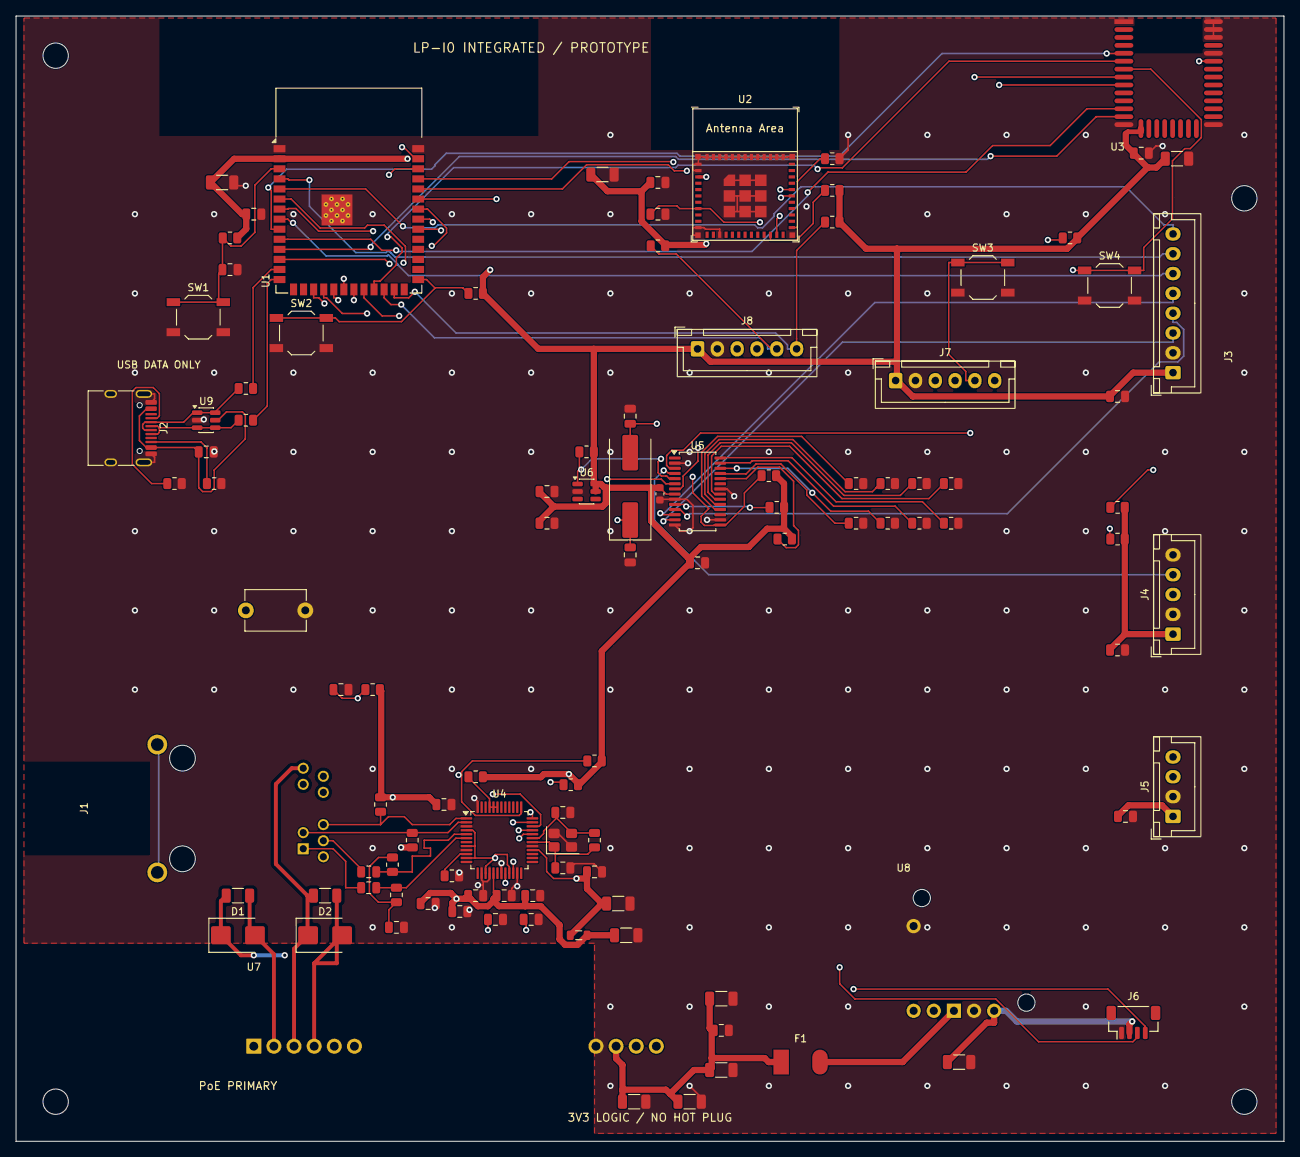
[picture p126: board integrated.kicad_pcb from above]

Board: 4 copper layers, 160.0 x 142.0 mm, 110 parts (0 on the bottom side), 79 nets.

Other parts of the board:
H1, H2, H3, H4: M3 NPTH; MountingHole_3.2mm_M3
