ha-homelab/ha-radio-hub/hardware/low-power/carrier/carrier.kicad_pcb

## KiCad design hardware/low-power/carrier/carrier.kicad_pcb (2026-10-17)

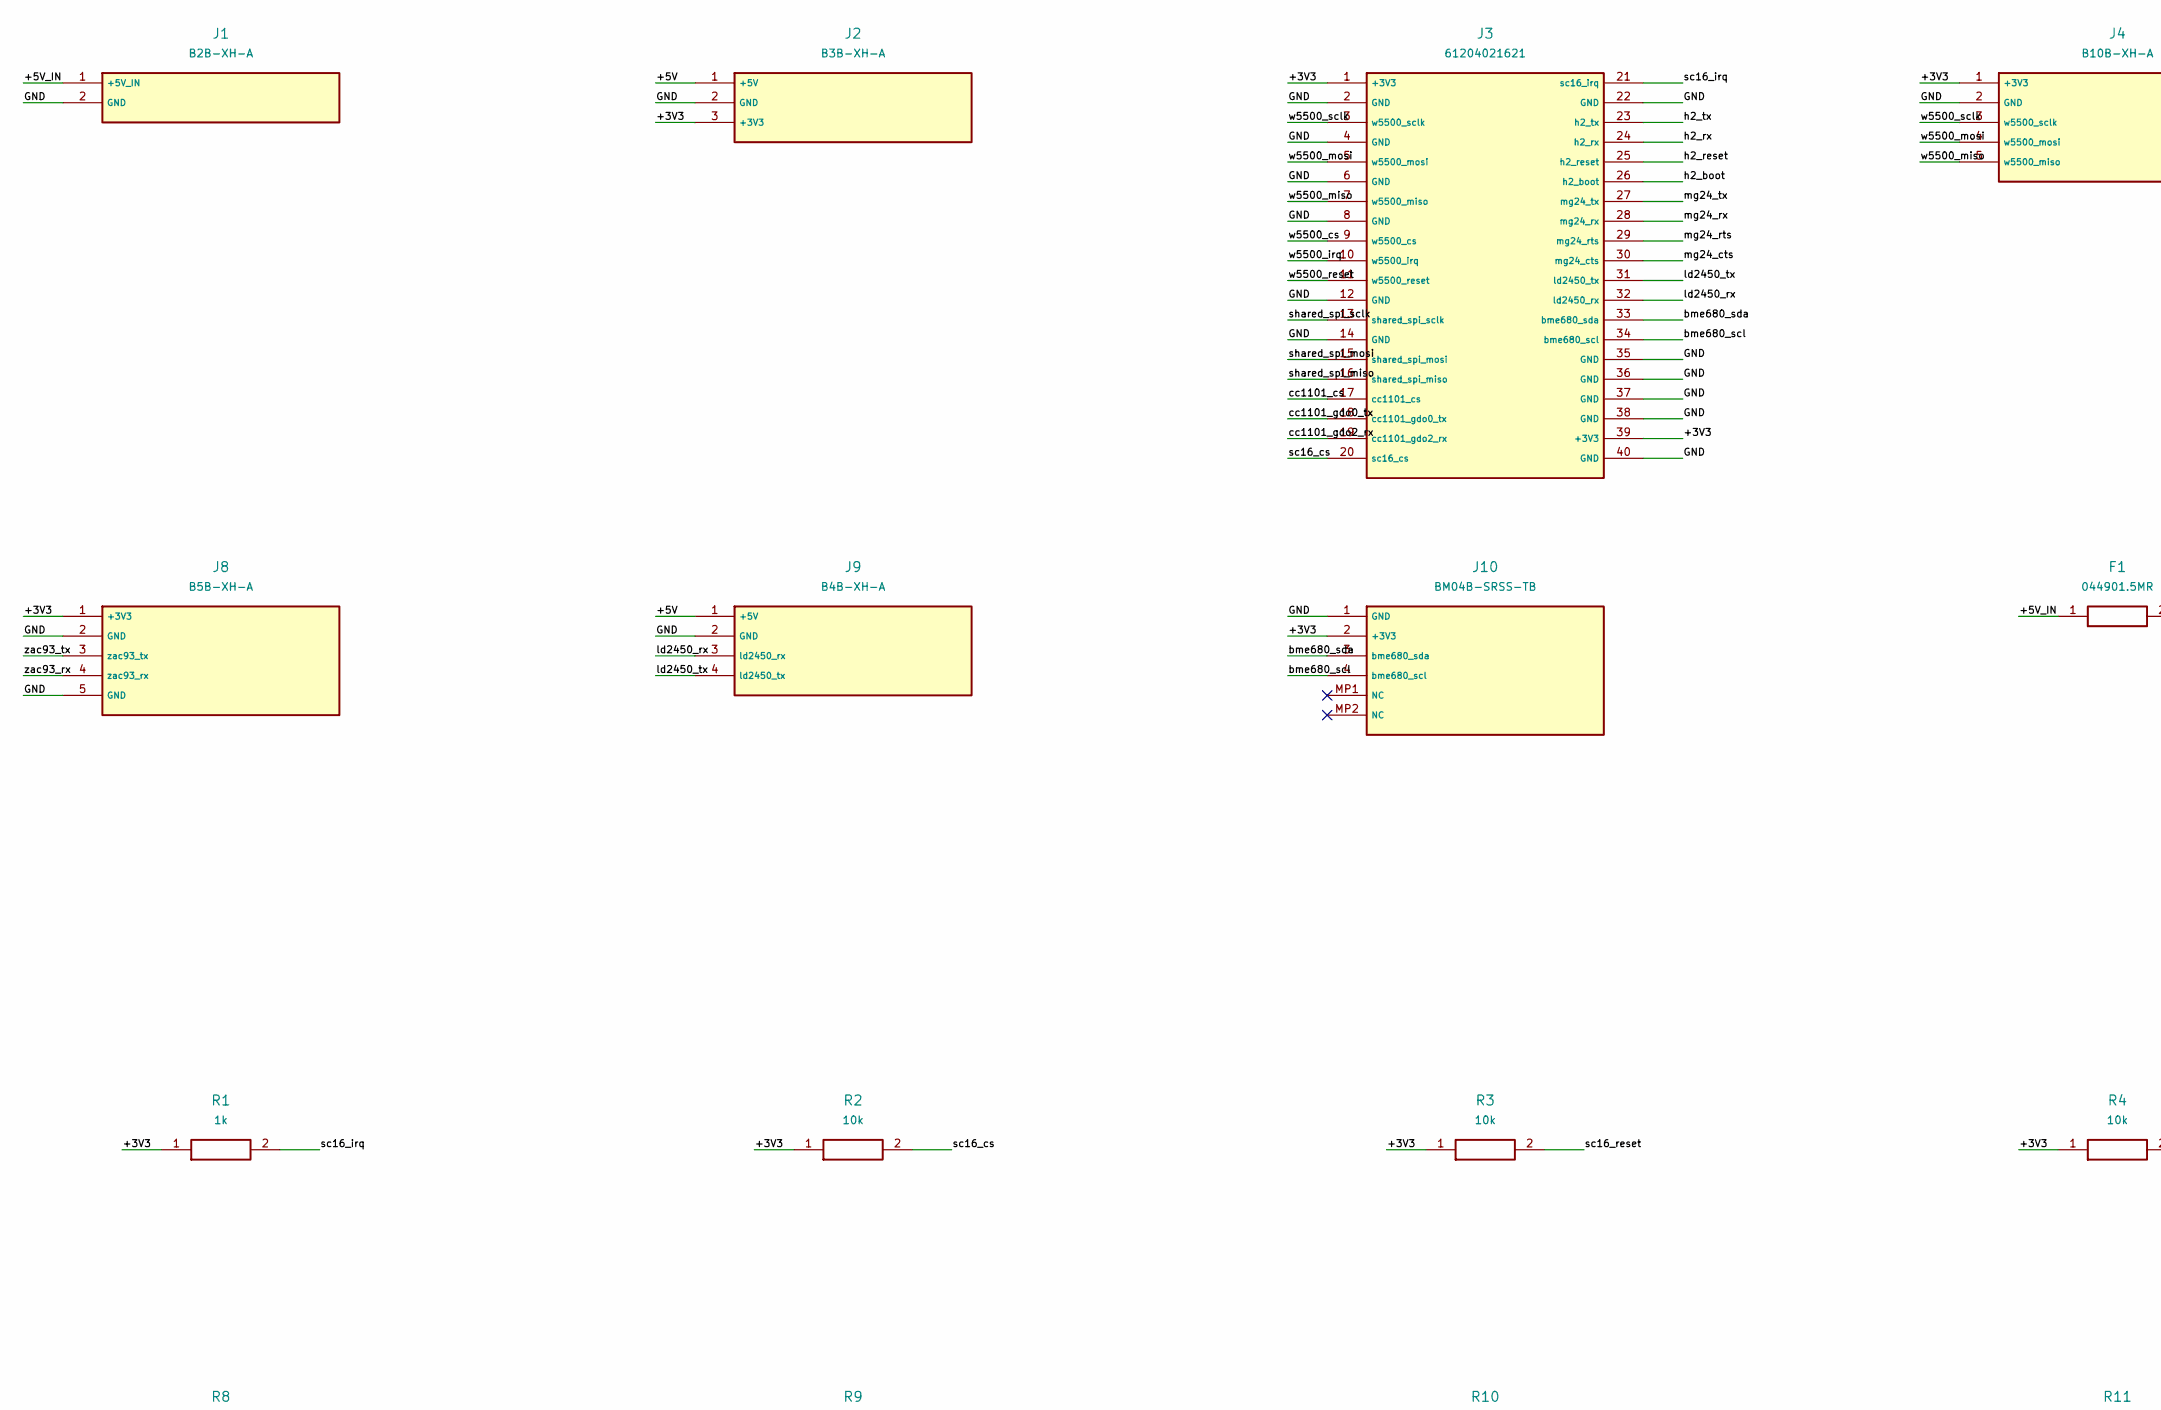
[picture p127: schematic carrier.kicad_sch, LP-C0 low-voltage module carrier - PROTOTYPE, part in row 1, column 1]

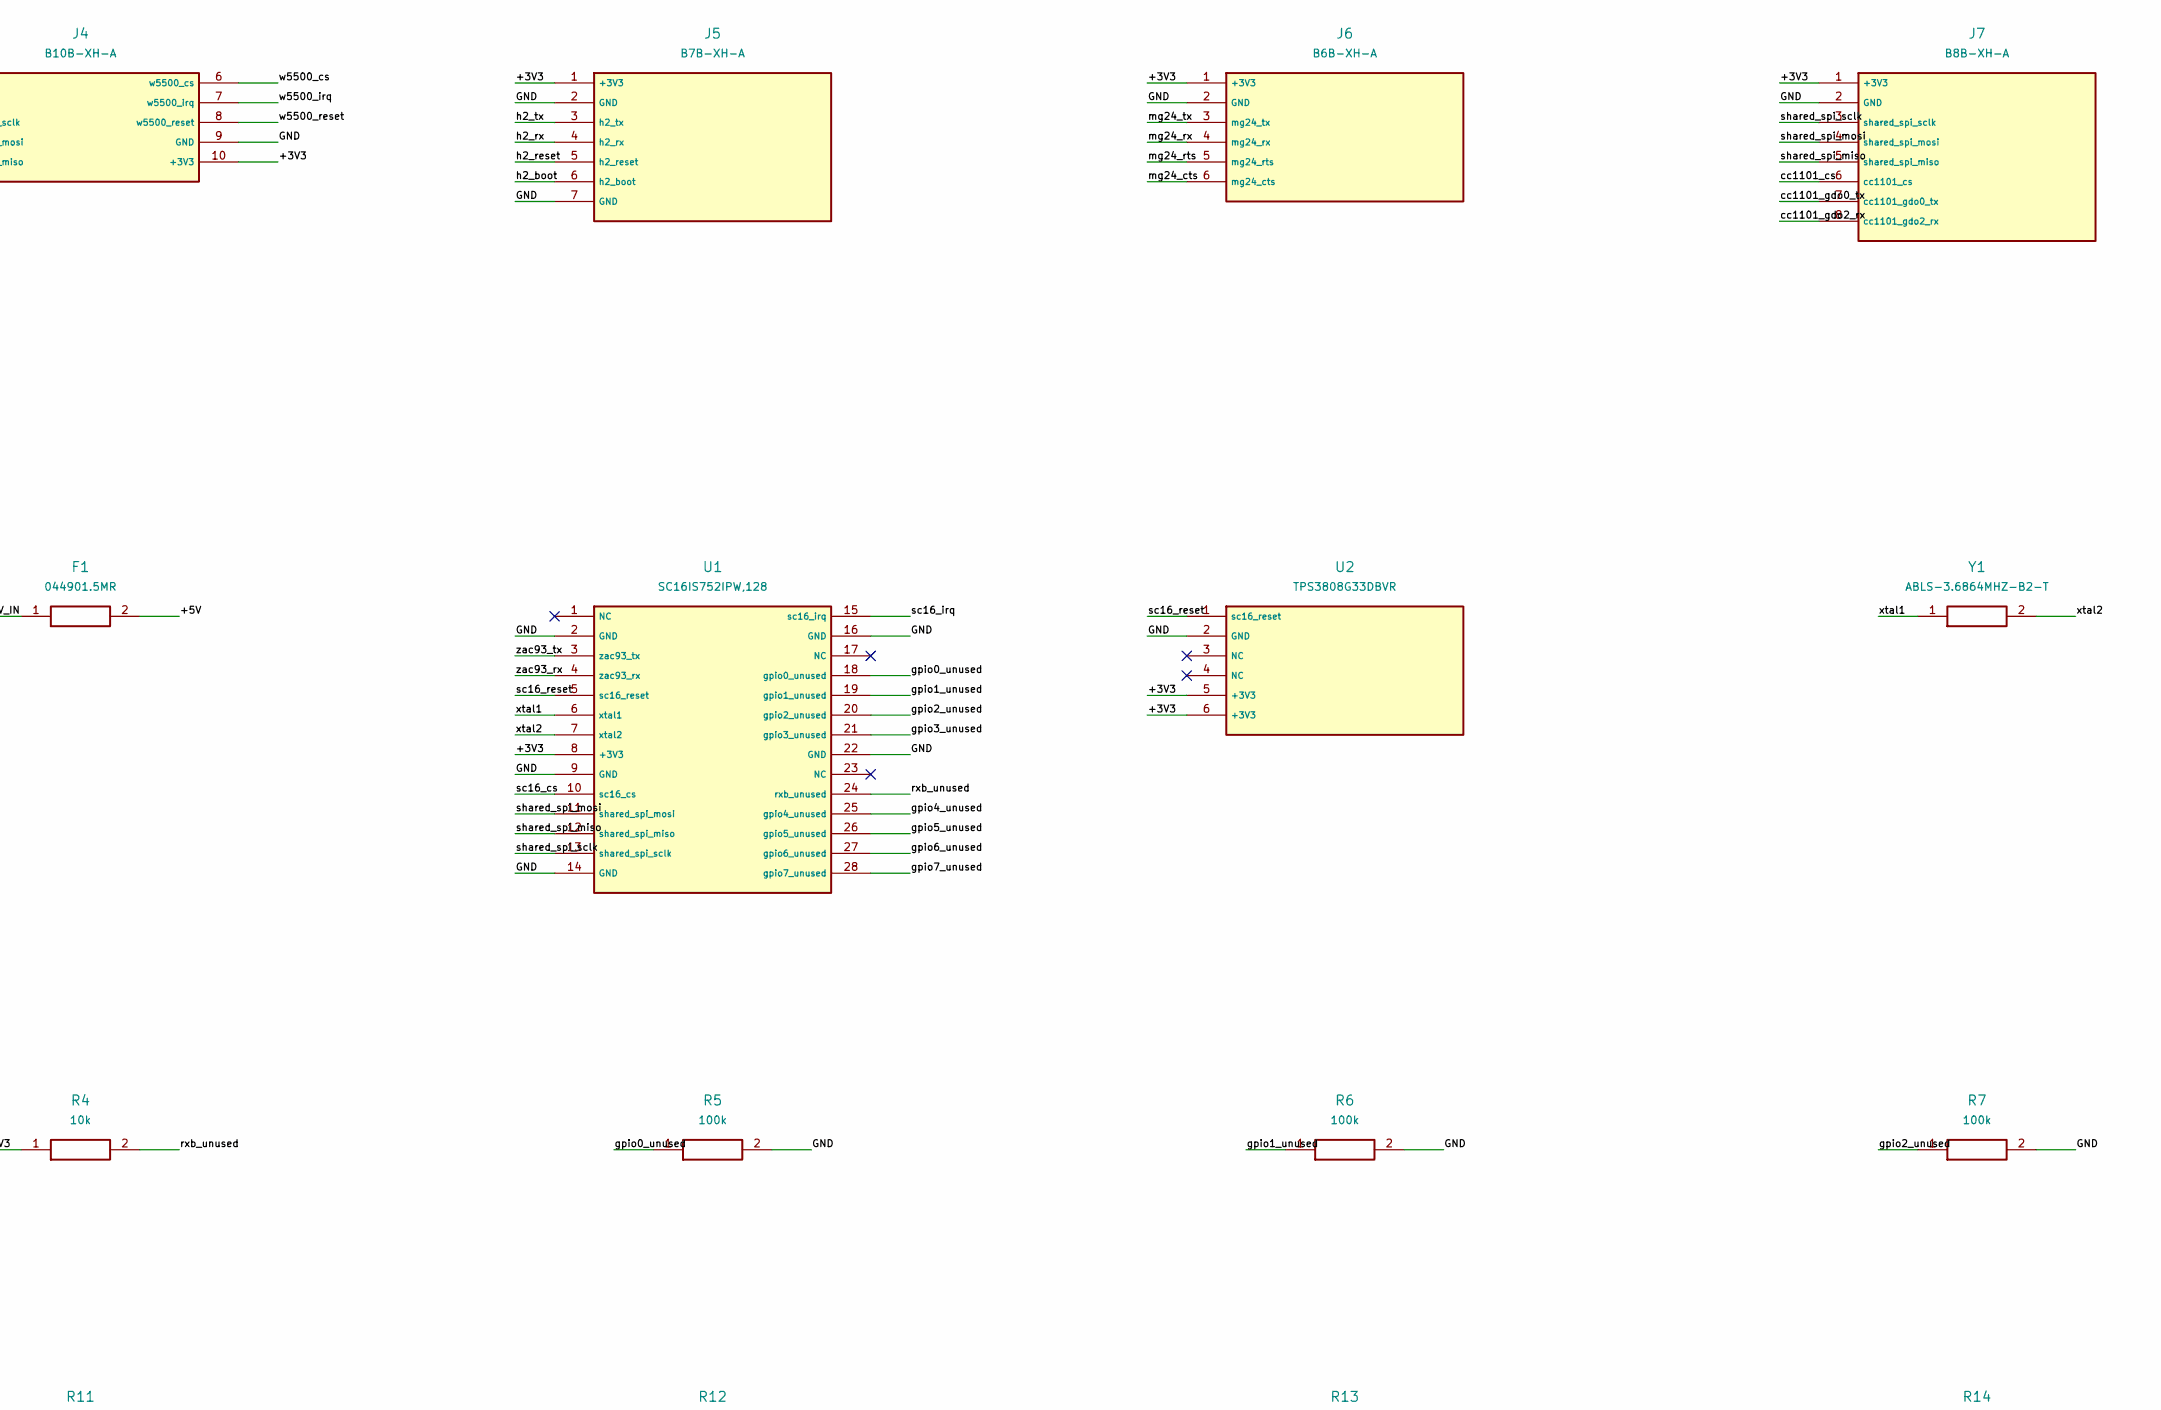
[picture p128: schematic carrier.kicad_sch, LP-C0 low-voltage module carrier - PROTOTYPE, part in row 1, column 2]

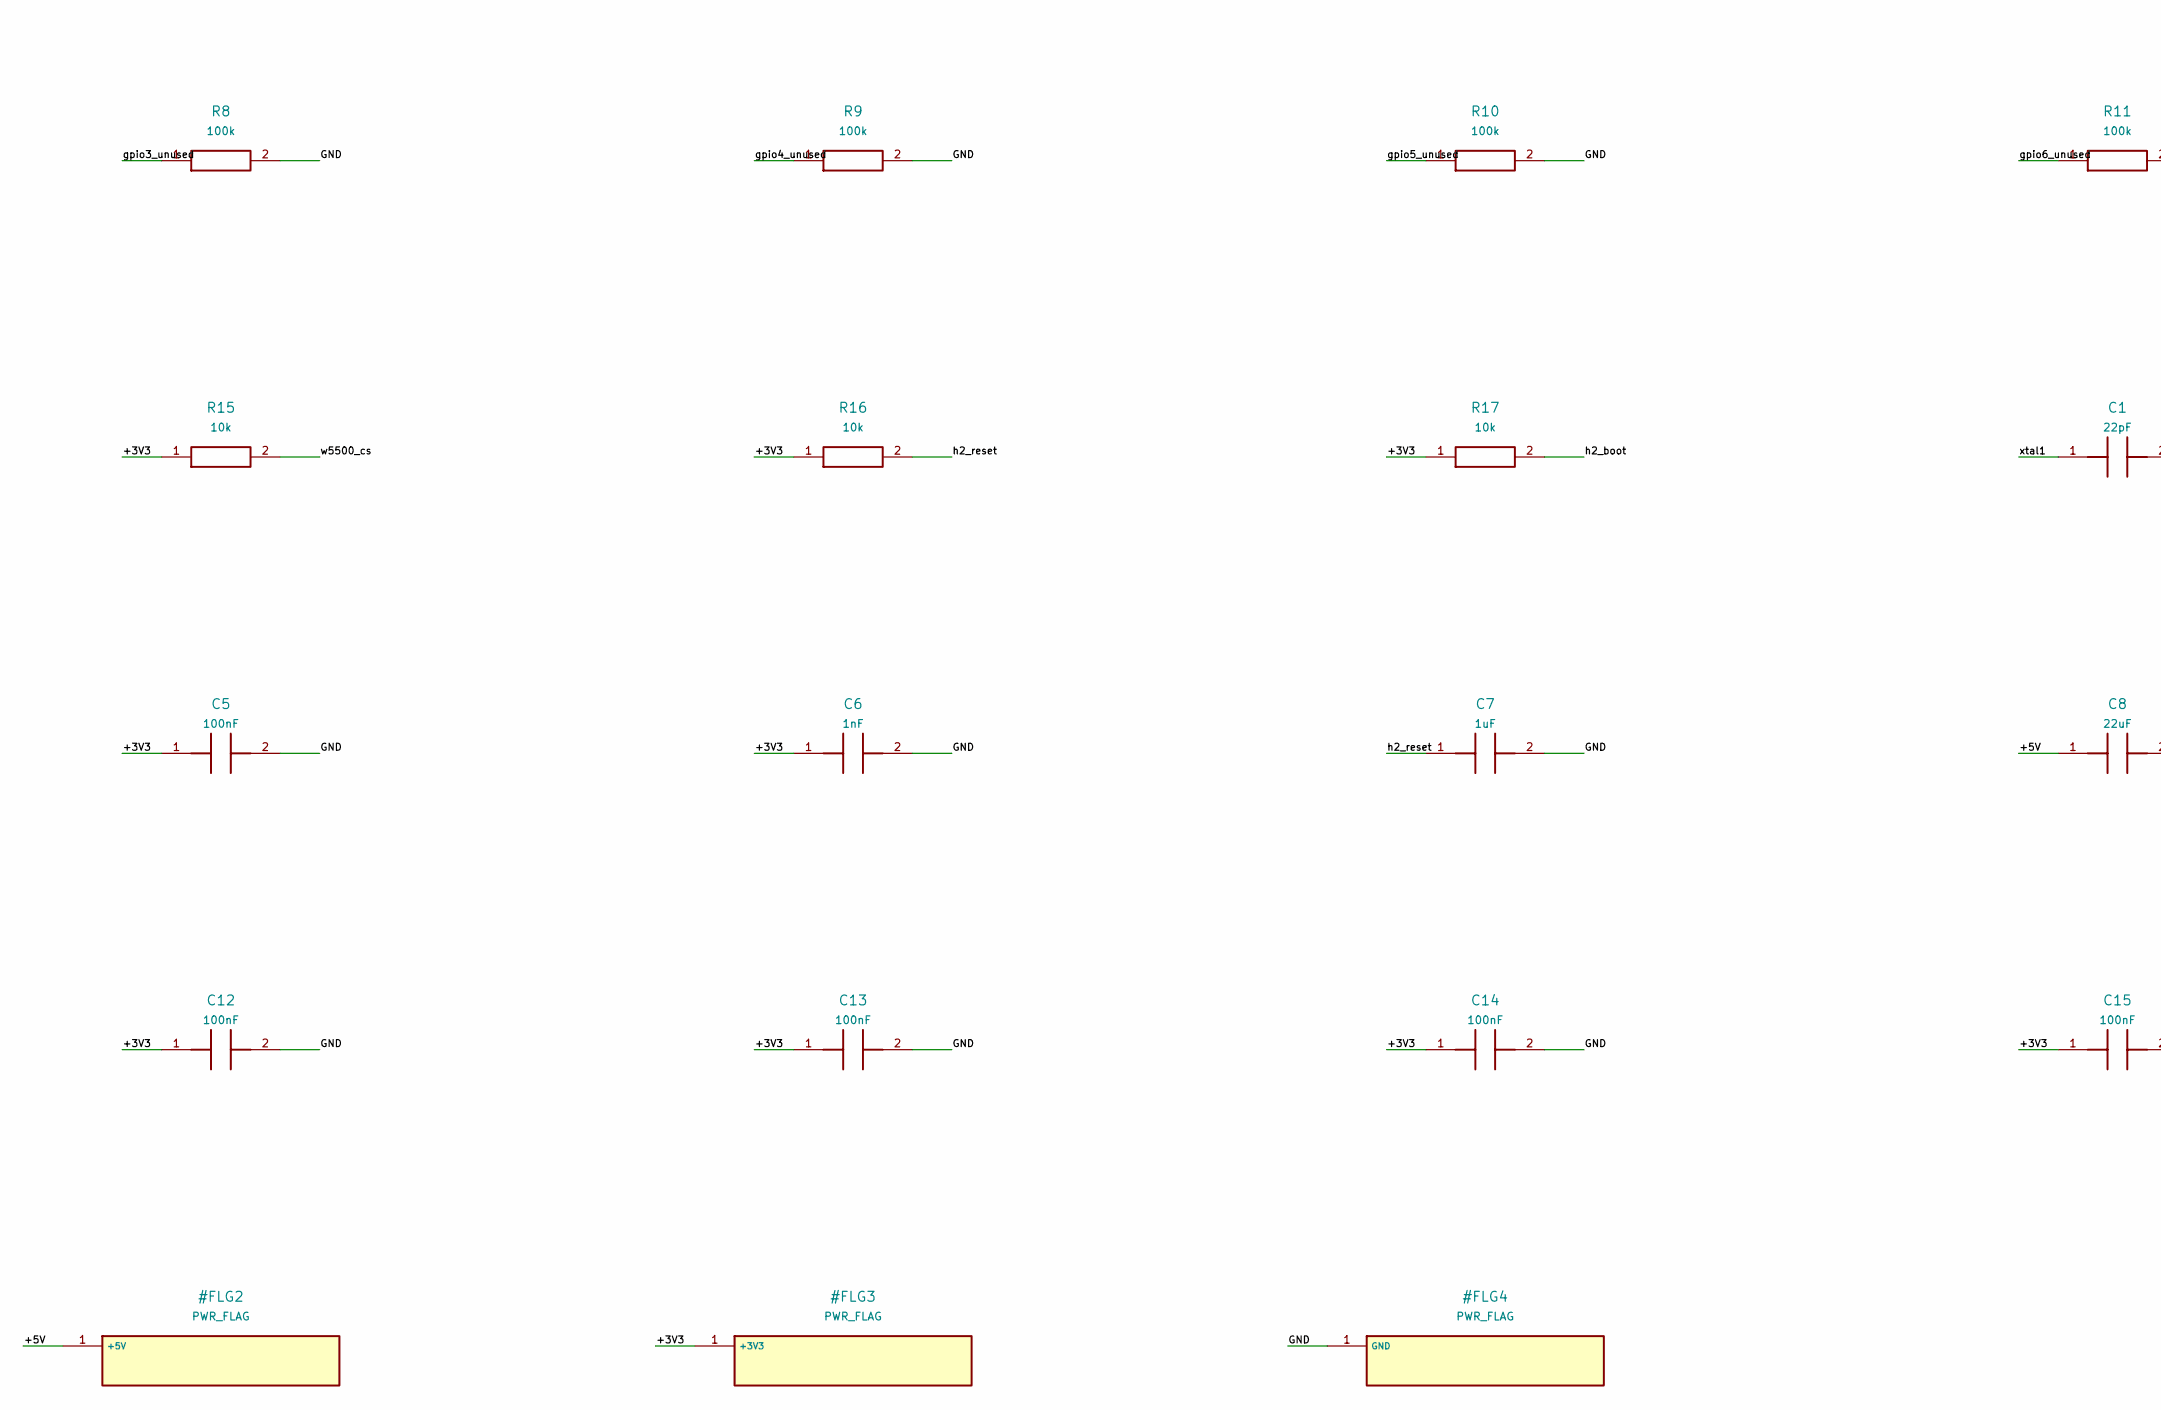
[picture p129: schematic carrier.kicad_sch, LP-C0 low-voltage module carrier - PROTOTYPE, part in row 2, column 1]

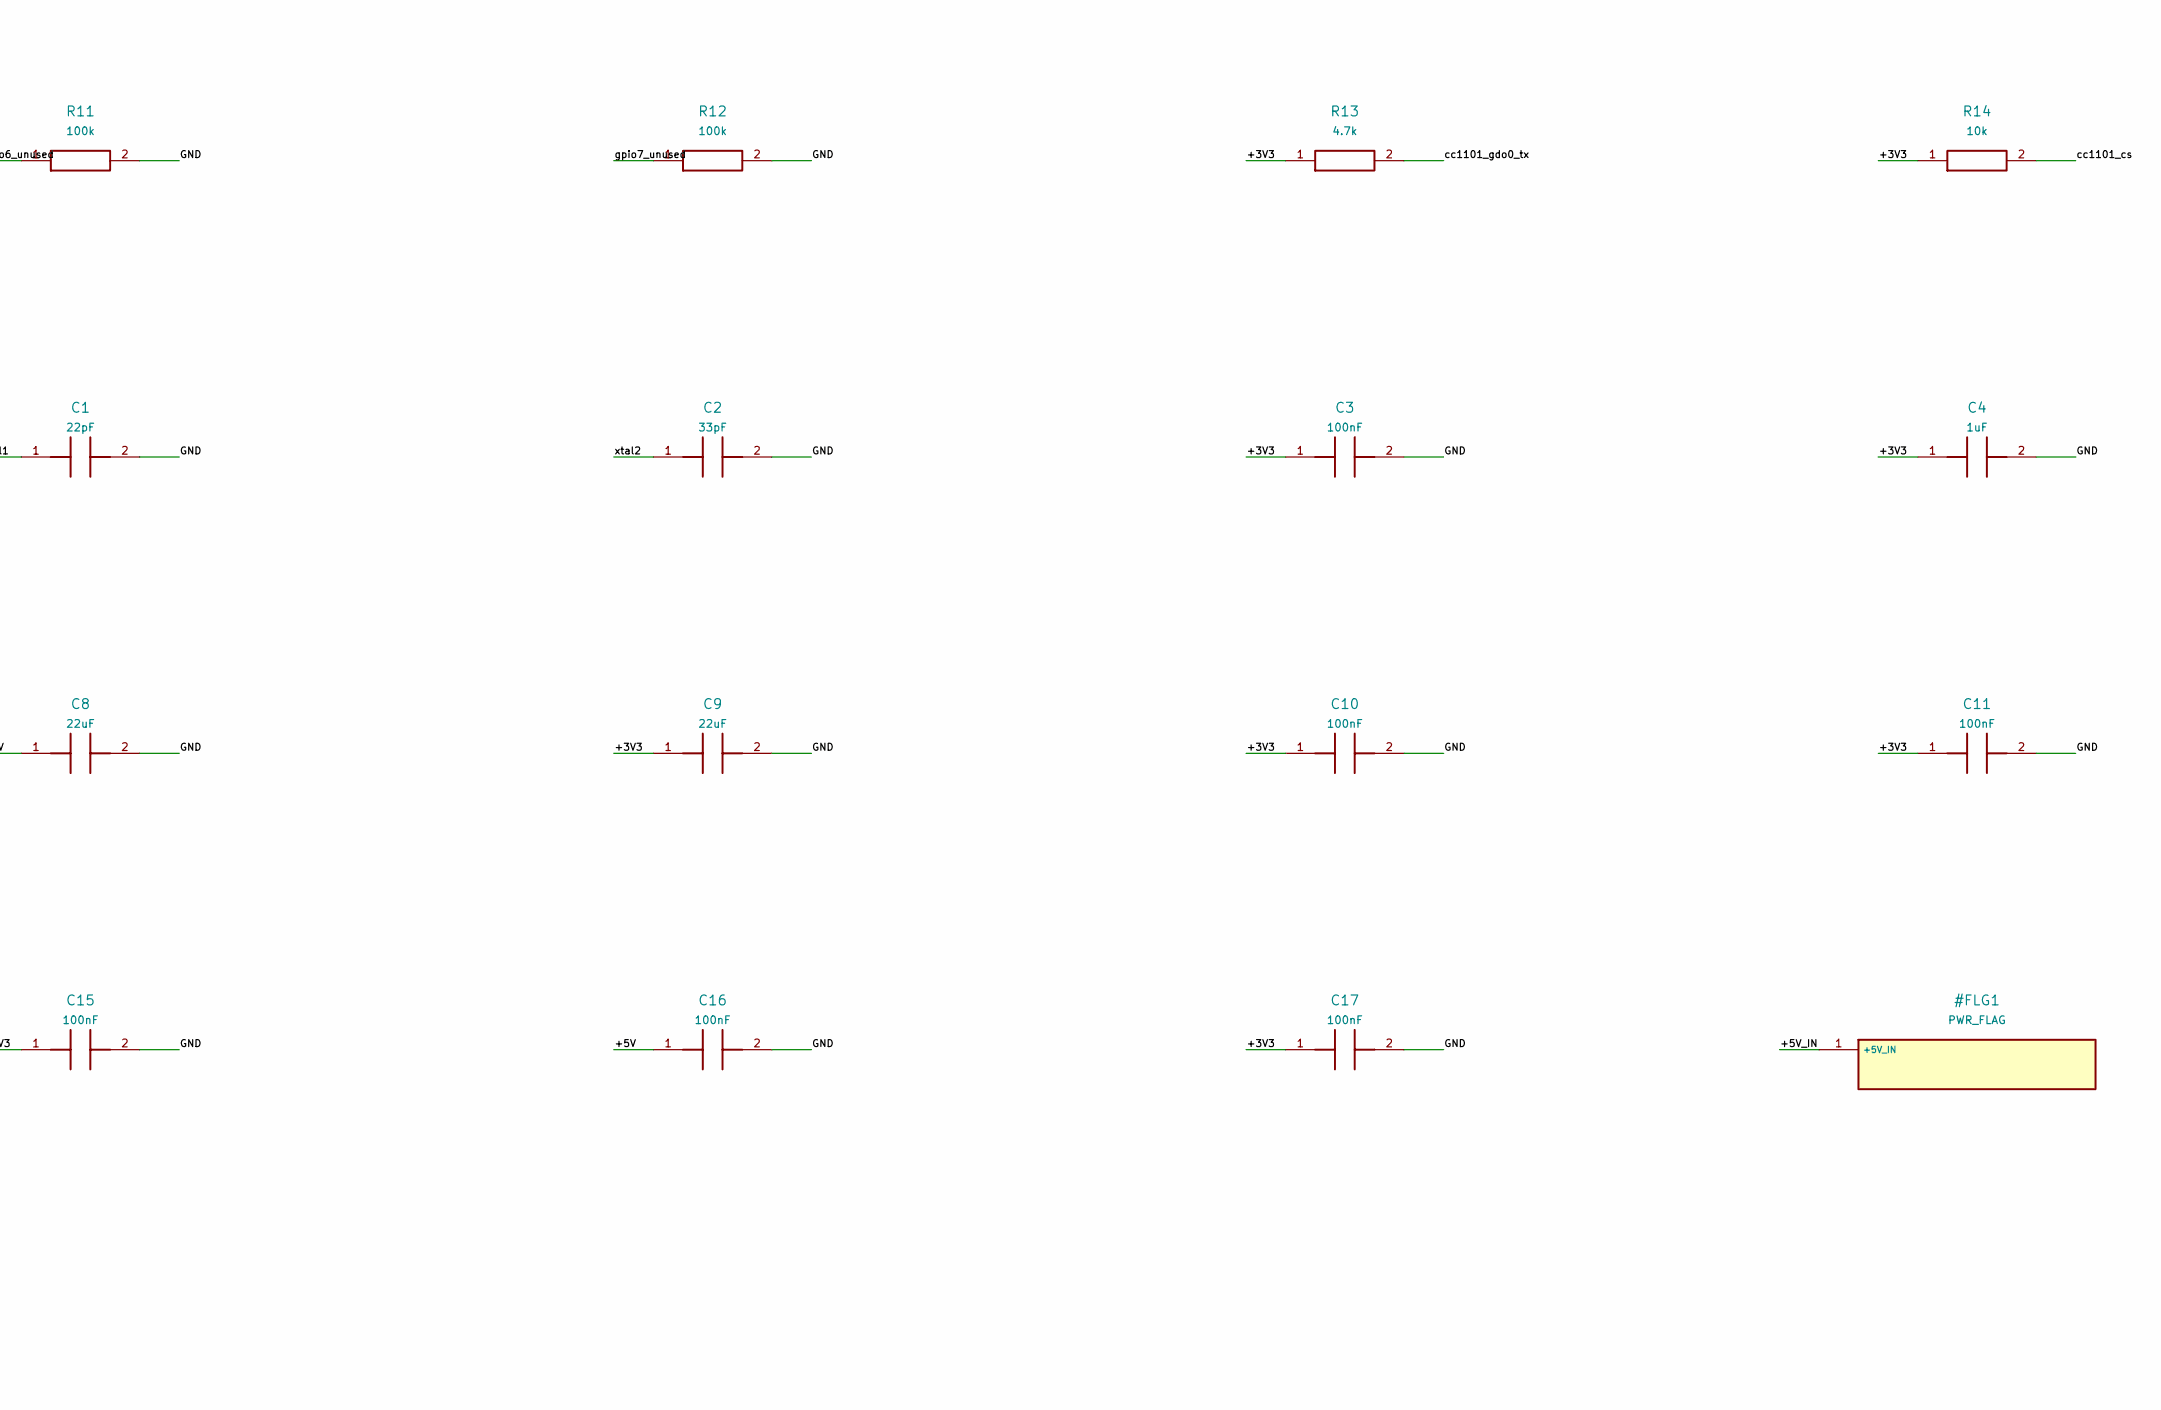
[picture p130: schematic carrier.kicad_sch, LP-C0 low-voltage module carrier - PROTOTYPE, part in row 2, column 2]

Parts:
C1: 22pF; C_0805_2012Metric
C2: 33pF; C_0805_2012Metric
C3, C5, C10, C11, C12, C13, C14, C15, C16, C17: 100nF; C_0805_2012Metric
C4, C7: 1uF; C_0805_2012Metric
C6: 1nF; C_0805_2012Metric
C8, C9: 22uF; C_1206_3216Metric
F1: 044901.5MR; Littelfuse_449
J1: B2B-XH-A; JST_XH_B2B-XH-A_1x02_P2.50mm_Vertical
J2: B3B-XH-A; JST_XH_B3B-XH-A_1x03_P2.50mm_Vertical
J3: 61204021621; Wurth_61204021621
J4: B10B-XH-A; JST_XH_B10B-XH-A_1x10_P2.50mm_Vertical
J5: B7B-XH-A; JST_XH_B7B-XH-A_1x07_P2.50mm_Vertical
J6: B6B-XH-A; JST_XH_B6B-XH-A_1x06_P2.50mm_Vertical
J7: B8B-XH-A; JST_XH_B8B-XH-A_1x08_P2.50mm_Vertical
J8: B5B-XH-A; JST_XH_B5B-XH-A_1x05_P2.50mm_Vertical
J9: B4B-XH-A; JST_XH_B4B-XH-A_1x04_P2.50mm_Vertical
J10: BM04B-SRSS-TB; JST_SH_BM04B-SRSS-TB_1x04-1MP_P1.00mm_Vertical
R1: 1k; R_0805_2012Metric
R2, R3, R4, R14, R15, R16, R17: 10k; R_0805_2012Metric
R5, R6, R7, R8, R9, R10, R11, R12: 100k; R_0805_2012Metric
R13: 4.7k; R_0805_2012Metric
U1: SC16IS752IPW,128; TSSOP-28_4.4x9.7mm_P0.65mm
U2: TPS3808G33DBVR; SOT-23-6
Y1: ABLS-3.6864MHZ-B2-T; Crystal_SMD_HC49-SD

Connections:
/+3V3: C3.1, C4.1, C5.1, C6.1, C9.1, C10.1, C11.1, C12.1, C13.1, C14.1, C15.1, C17.1, J2.3 (+3V3), J3.1 (+3V3), J3.39 (+3V3), J4.1 (+3V3), J4.10 (+3V3), J5.1 (+3V3), J6.1 (+3V3), J7.1 (+3V3), J8.1 (+3V3), J10.2 (+3V3), R1.1, R2.1, R3.1, R4.1, R13.1, R14.1, R15.1, R16.1, R17.1, U1.8 (+3V3), U2.5 (+3V3), U2.6 (+3V3)
/+5V: C8.1, C16.1, F1.2, J2.1 (+5V), J9.1 (+5V)
/+5V_IN: F1.1, J1.1 (+5V_IN)
/GND: C1.2, C2.2, C3.2, C4.2, C5.2, C6.2, C7.2, C8.2, C9.2, C10.2, C11.2, C12.2, C13.2, C14.2, C15.2, C16.2, C17.2, J1.2 (GND), J2.2 (GND), J3.2 (GND), J3.4 (GND), J3.6 (GND), J3.8 (GND), J3.12 (GND), J3.14 (GND), J3.22 (GND), J3.35 (GND), J3.36 (GND), J3.37 (GND), J3.38 (GND), J3.40 (GND), J4.2 (GND), J4.9 (GND), J5.2 (GND), J5.7 (GND), J6.2 (GND), J7.2 (GND), J8.2 (GND), J8.5 (GND), J9.2 (GND), J10.1 (GND), R5.2, R6.2, R7.2, R8.2, R9.2, R10.2, R11.2, R12.2, U1.2 (GND), U1.9 (GND), U1.14 (GND), U1.16 (GND), U1.22 (GND), U2.2 (GND)
/bme680_scl: J3.34 (bme680_scl), J10.4 (bme680_scl)
/bme680_sda: J3.33 (bme680_sda), J10.3 (bme680_sda)
/cc1101_cs: J3.17 (cc1101_cs), J7.6 (cc1101_cs), R14.2
/cc1101_gdo0_tx: J3.18 (cc1101_gdo0_tx), J7.7 (cc1101_gdo0_tx), R13.2
/cc1101_gdo2_rx: J3.19 (cc1101_gdo2_rx), J7.8 (cc1101_gdo2_rx)
/gpio0_unused: R5.1, U1.18 (gpio0_unused)
/gpio1_unused: R6.1, U1.19 (gpio1_unused)
/gpio2_unused: R7.1, U1.20 (gpio2_unused)
/gpio3_unused: R8.1, U1.21 (gpio3_unused)
/gpio4_unused: R9.1, U1.25 (gpio4_unused)
/gpio5_unused: R10.1, U1.26 (gpio5_unused)
/gpio6_unused: R11.1, U1.27 (gpio6_unused)
/gpio7_unused: R12.1, U1.28 (gpio7_unused)
/h2_boot: J3.26 (h2_boot), J5.6 (h2_boot), R17.2
/h2_reset: C7.1, J3.25 (h2_reset), J5.5 (h2_reset), R16.2
/h2_rx: J3.24 (h2_rx), J5.4 (h2_rx)
/h2_tx: J3.23 (h2_tx), J5.3 (h2_tx)
/ld2450_rx: J3.32 (ld2450_rx), J9.3 (ld2450_rx)
/ld2450_tx: J3.31 (ld2450_tx), J9.4 (ld2450_tx)
/mg24_cts: J3.30 (mg24_cts), J6.6 (mg24_cts)
/mg24_rts: J3.29 (mg24_rts), J6.5 (mg24_rts)
/mg24_rx: J3.28 (mg24_rx), J6.4 (mg24_rx)
/mg24_tx: J3.27 (mg24_tx), J6.3 (mg24_tx)
/rxb_unused: R4.2, U1.24 (rxb_unused)
/sc16_cs: J3.20 (sc16_cs), R2.2, U1.10 (sc16_cs)
/sc16_irq: J3.21 (sc16_irq), R1.2, U1.15 (sc16_irq)
/sc16_reset: R3.2, U1.5 (sc16_reset), U2.1 (sc16_reset)
/shared_spi_miso: J3.16 (shared_spi_miso), J7.5 (shared_spi_miso), U1.12 (shared_spi_miso)
/shared_spi_mosi: J3.15 (shared_spi_mosi), J7.4 (shared_spi_mosi), U1.11 (shared_spi_mosi)
/shared_spi_sclk: J3.13 (shared_spi_sclk), J7.3 (shared_spi_sclk), U1.13 (shared_spi_sclk)
/w5500_cs: J3.9 (w5500_cs), J4.6 (w5500_cs), R15.2
/w5500_irq: J3.10 (w5500_irq), J4.7 (w5500_irq)
/w5500_miso: J3.7 (w5500_miso), J4.5 (w5500_miso)
/w5500_mosi: J3.5 (w5500_mosi), J4.4 (w5500_mosi)
/w5500_reset: J3.11 (w5500_reset), J4.8 (w5500_reset)
/w5500_sclk: J3.3 (w5500_sclk), J4.3 (w5500_sclk)
/xtal1: C1.1, U1.6 (xtal1), Y1.1
/xtal2: C2.1, U1.7 (xtal2), Y1.2
/zac93_rx: J8.4 (zac93_rx), U1.4 (zac93_rx)
/zac93_tx: J8.3 (zac93_tx), U1.3 (zac93_tx)

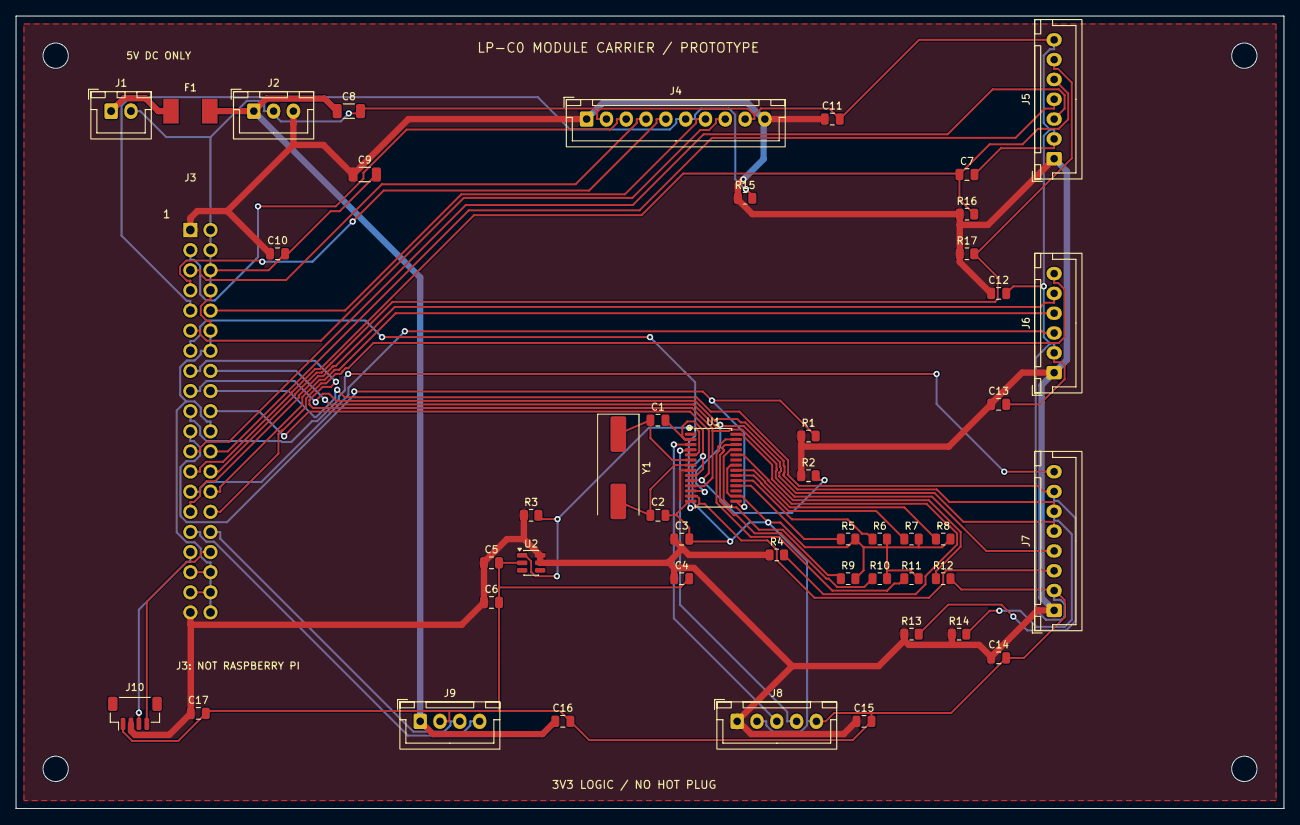
[picture p131: board carrier.kicad_pcb from above]

Board: 2 copper layers, 160.0 x 100.0 mm, 52 parts (0 on the bottom side), 44 nets.

Other parts of the board:
H1, H2, H3, H4: M3 NPTH
