ha-homelab/ha-radio-hub/hardware/low-power/carrier/mg24-adapter/mg24-adapter.kicad_pcb

## KiCad design hardware/low-power/carrier/mg24-adapter/mg24-adapter.kicad_pcb (2026-10-17)

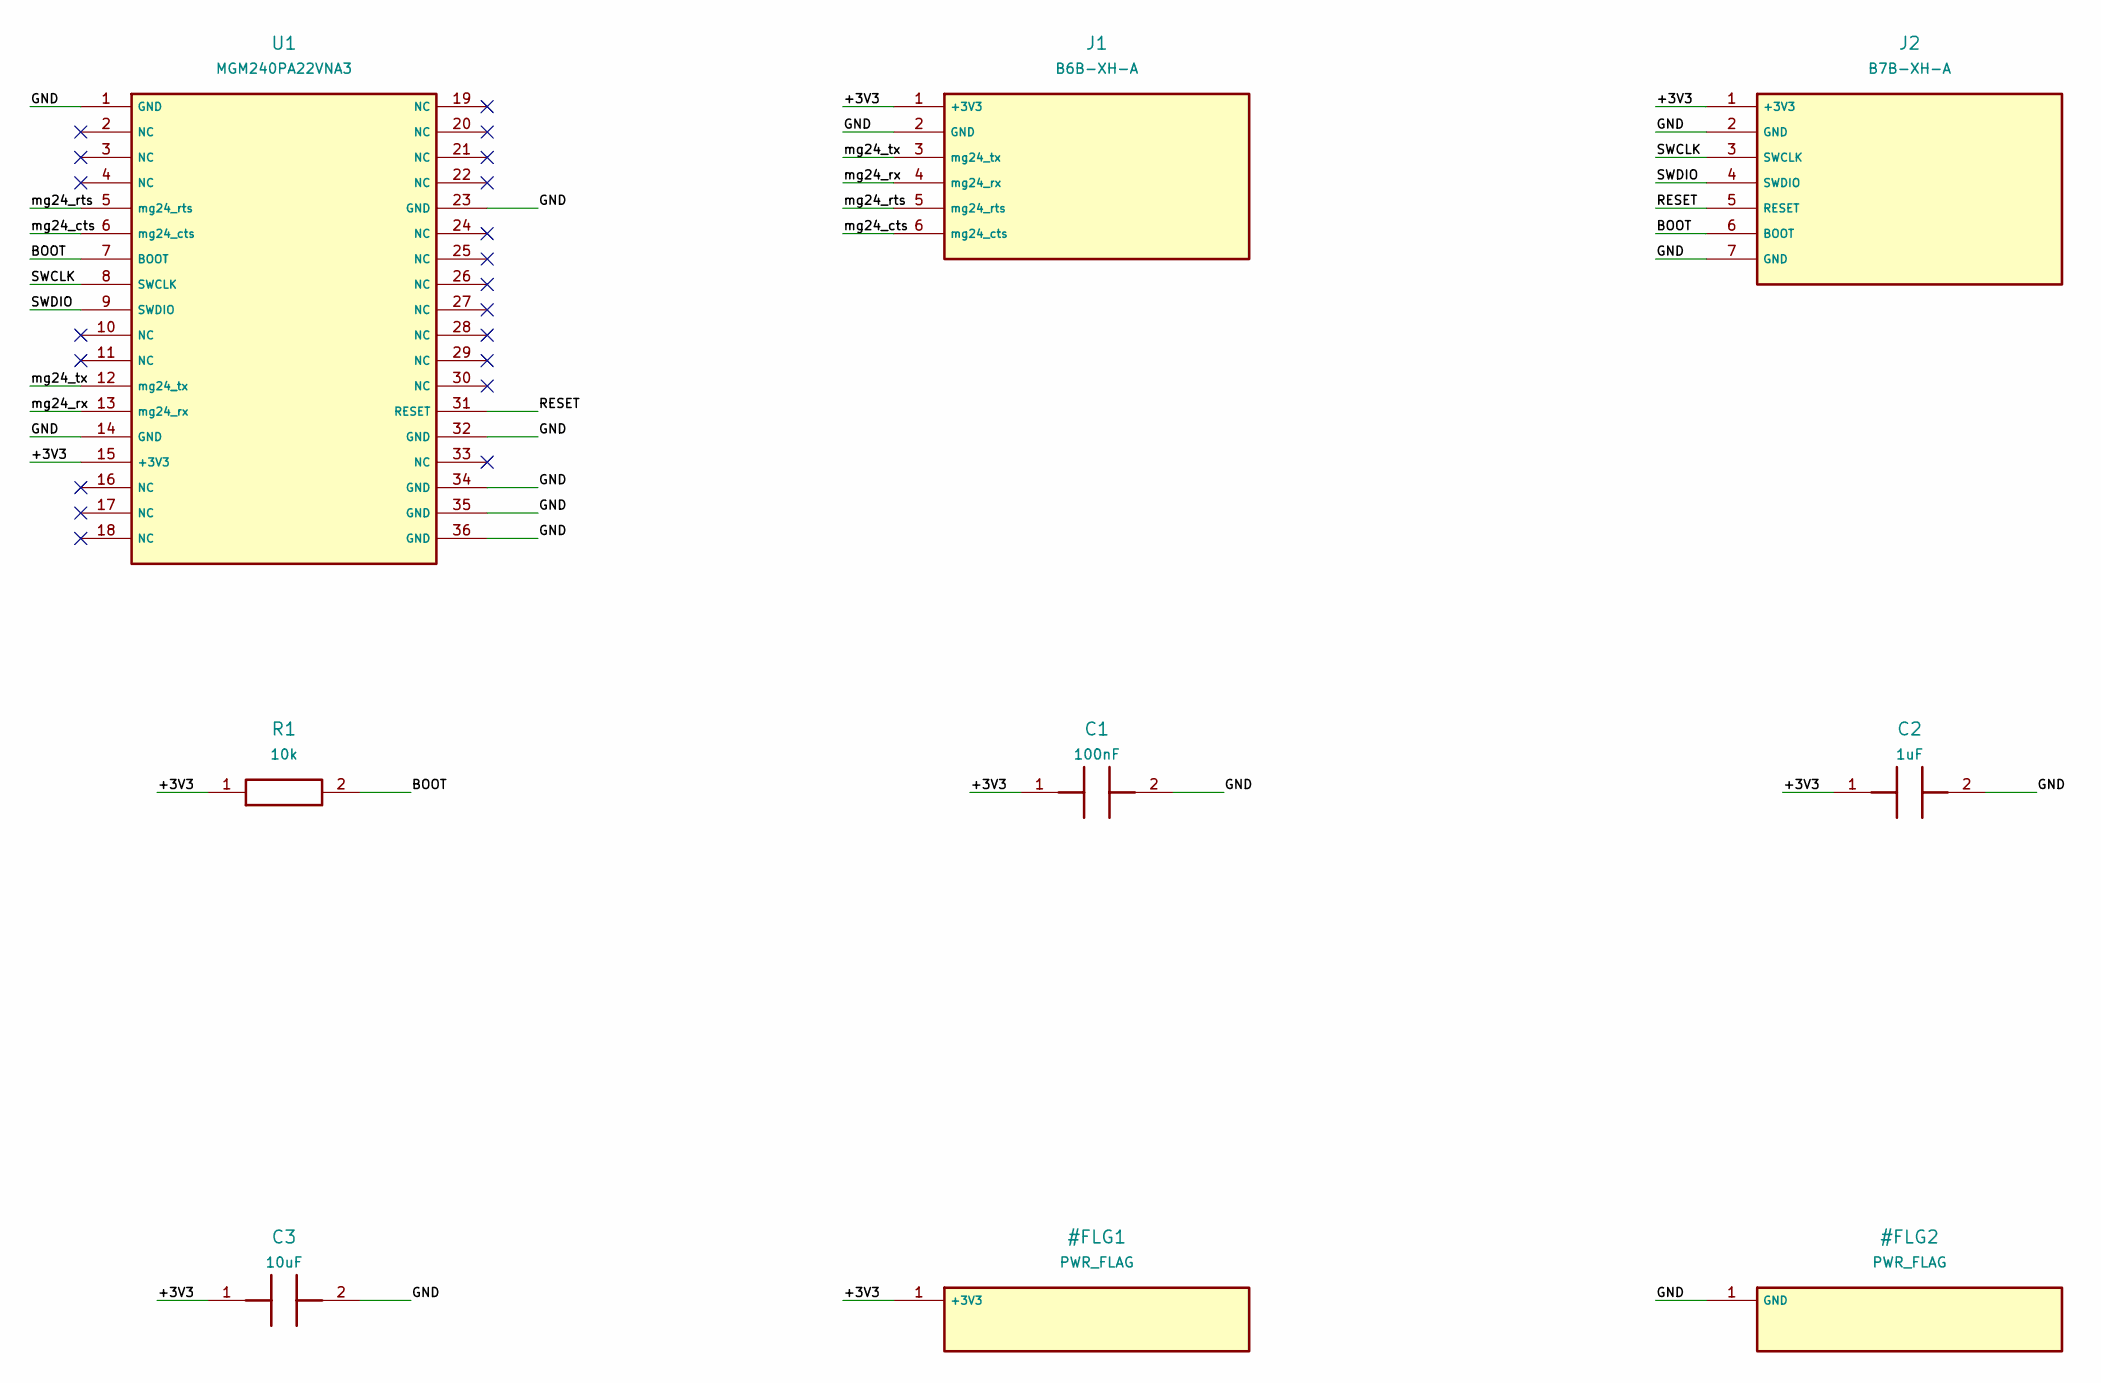
[picture p132: schematic mg24-adapter.kicad_sch, LP-M0 MGM240PA22VNA3 UART daughterboard - PROTOTYPE]

Parts:
C1: 100nF; C_0805_2012Metric
C2: 1uF; C_0805_2012Metric
C3: 10uF; C_1206_3216Metric
J1: B6B-XH-A; JST_XH_B6B-XH-A_1x06_P2.50mm_Vertical
J2: B7B-XH-A; JST_XH_B7B-XH-A_1x07_P2.50mm_Vertical
R1: 10k; R_0805_2012Metric
U1: MGM240PA22VNA3; MGM240P

Connections:
/+3V3: C1.1, C2.1, C3.1, J1.1 (+3V3), J2.1 (+3V3), R1.1, U1.15 (+3V3)
/BOOT: J2.6 (BOOT), R1.2, U1.7 (BOOT)
/GND: C1.2, C2.2, C3.2, J1.2 (GND), J2.2 (GND), J2.7 (GND), U1.1 (GND), U1.14 (GND), U1.23 (GND), U1.32 (GND), U1.34 (GND), U1.35 (GND), U1.36 (GND)
/RESET: J2.5 (RESET), U1.31 (RESET)
/SWCLK: J2.3 (SWCLK), U1.8 (SWCLK)
/SWDIO: J2.4 (SWDIO), U1.9 (SWDIO)
/mg24_cts: J1.6 (mg24_cts), U1.6 (mg24_cts)
/mg24_rts: J1.5 (mg24_rts), U1.5 (mg24_rts)
/mg24_rx: J1.4 (mg24_rx), U1.13 (mg24_rx)
/mg24_tx: J1.3 (mg24_tx), U1.12 (mg24_tx)

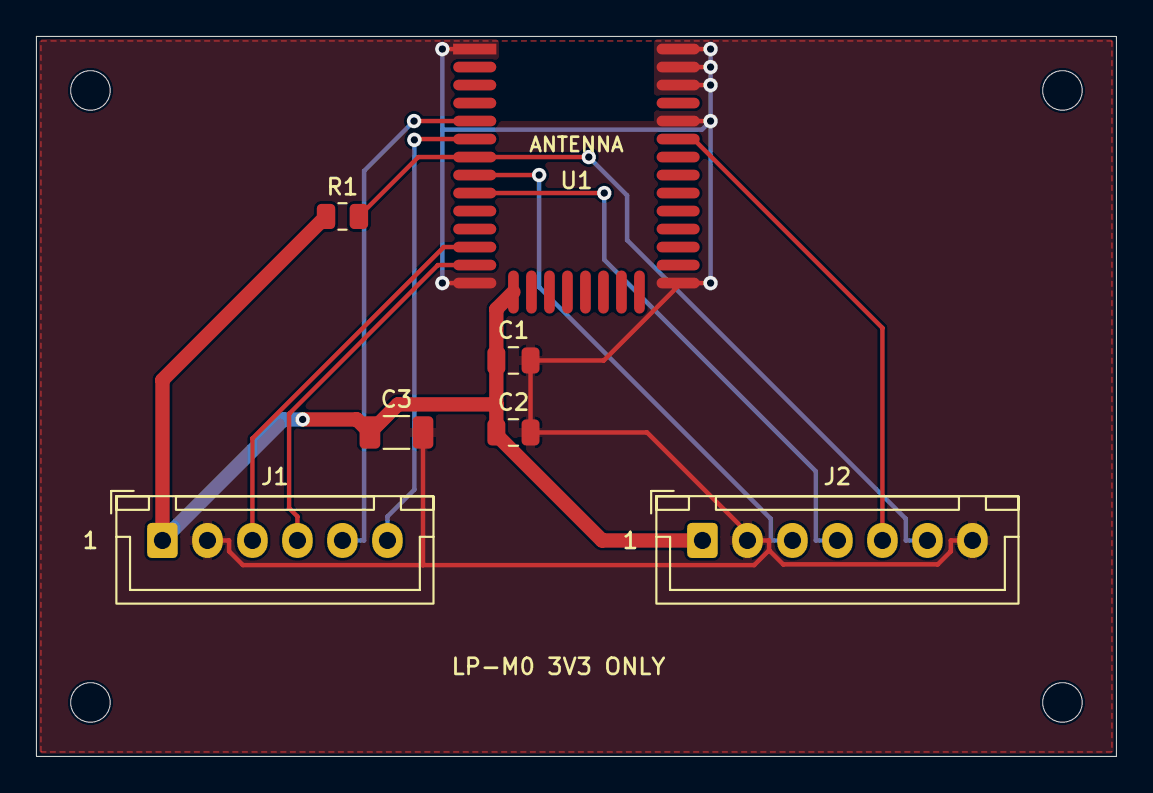
[picture p133: board mg24-adapter.kicad_pcb from above]

Board: 2 copper layers, 60.0 x 40.0 mm, 11 parts (0 on the bottom side), 10 nets.

Other parts of the board:
H1, H2, H3, H4: M2 NPTH
