ha-homelab/ha-radio-hub/hardware/module-carrier/render.py

#!/usr/bin/env python3
"""Rebuild MC1's English guide from the current CAD and review data."""
from pathlib import Path
import argparse, csv, hashlib, html, json, math, runpy

HERE = Path(__file__).resolve().parent
ROOT = HERE.parents[1]

def h(x): return html.escape(str(x), quote=True)
def sha(path): return hashlib.sha256(path.read_bytes()).hexdigest()
def text(x,y,t,size=18,fill='#203748',weight=400):
    return f'<text x="{x}" y="{y}" font-size="{size}" fill="{fill}" font-weight="{weight}">{h(t)}</text>'
def box(x,y,w,hh,title,lines,fill='#eff5f8'):
    return f'<rect x="{x}" y="{y}" width="{w}" height="{hh}" rx="8" fill="{fill}" stroke="#7894a4"/>'+text(x+18,y+32,title,21,weight=700)+''.join(text(x+18,y+65+i*25,t,17) for i,t in enumerate(lines))
def architecture():
    s='<svg xmlns="http://www.w3.org/2000/svg" width="1320" height="875" viewBox="0 0 1320 875" role="img" aria-label="MC1 one carrier architecture"><rect width="1320" height="875" fill="#fff"/><g font-family="Arial,sans-serif">'
    s+=text(36,47,'MC1 · one current module carrier',32,weight=700)+text(36,82,'One Ethernet uplink · local Thread BR · Ember Zigbee · direct-solder module pins',19)
    s+=box(36,122,1248,103,'Finished isolated power',['PoE splitter → fused 5 V → individual controller inputs; finished 3.3 V buck → peripheral rail'],'#f5f1e9')
    for points in ['318,360 425,360','805,344 948,344','805,458 865,458 865,536 948,536','318,552 369,552 369,460 425,460','600,550 600,666','425,515 405,515 405,735 385,735']:
        s+=f'<polyline points="{points}" fill="none" stroke="#2c698d" stroke-width="3"/>'
    s+=box(36,287,282,148,'WIZ850io',['Finished Ethernet module','Shared SPI · own CS','No raw PoE on its headers'])
    s+=box(425,278,380,272,'S3 · local host',['Waveshare ESP32-S3-Nano-M','16 MB flash + 8 MB PSRAM','Local Thread BR + 3 active BLE','Shared SPI, three native UARTs','Initial USB flash → later OTA'],'#e4eff7')
    s+=box(948,277,336,140,'H2 · Thread RCP',['ESP32-H2-DevKitM-1','Dedicated UART; EN + BOOT','Independent 802.15.4 radio'])
    s+=box(948,468,336,140,'XIAO MG24 · Zigbee',['Ember NCP, not ZBOSS','TX/RX + hardware RTS/CTS','Initial preflash → UART GBL'])
    s+=box(36,474,282,155,'CC1101 · existing RF',['433 MHz TX + RX','SPI + two GDO signals','Hardware-timed S3 I/O'])
    s+=box(425,666,400,130,'Finished WK2132 UART bridge',['DFR0627, I2C + checked forwarding','Existing ZAC93 Z-Wave UART'])
    s+=box(36,670,349,126,'LD2450 + BME680',['Radar: native UART, 5 V supply','Environment: I2C, external pod'])
    s+=box(948,666,336,130,'One custom board',['Modules + labeled harnesses','No female module sockets','No separate integrated variant'],'#edf3ed')
    s+=text(36,847,'Logical topology, not wire routing or measured performance. Use the native CAD for actual connector positions.',16)
    return s+'</g></svg>'

def assembly(current=None):
    s='<svg xmlns="http://www.w3.org/2000/svg" width="1320" height="810" viewBox="0 0 1320 810" role="img" aria-label="Two-sided direct solder mounting and clearance principle"><rect width="1320" height="810" fill="white"/><g font-family="Arial,sans-serif">'
    s+=text(32,45,'Two sides, direct male pins, a controlled clearance',29,weight=700)
    s+=text(32,82,'Section principle only; not to scale. Use the CAD assembly order and measure the purchased modules.',18)
    s+='<rect x="50" y="117" width="640" height="24" fill="#e4e7eb"/><path d="M58 116 l16 -12 M90 116 l16 -12 M122 116 l16 -12 M154 116 l16 -12 M186 116 l16 -12" stroke="#9ca7b3" fill="none"/>'
    s+=text(725,137,'Ceiling / enclosure mounting surface',21,weight=700)
    s+=text(725,168,'Split edge supports not shown.',17)
    s+='<rect x="90" y="235" width="195" height="101" rx="3" fill="#b9c5cf" stroke="#5e788c"/><rect x="75" y="336" width="230" height="18" fill="#426d79"/>'
    s+=text(112,281,'RJ45 / WIZ850io',18)
    s+='<rect x="104" y="354" width="28" height="47" fill="#374750"/><rect x="248" y="354" width="28" height="47" fill="#374750"/>'
    for x in (118,262): s+=f'<rect x="{x-3}" y="348" width="6" height="97" fill="#bd964b"/>'
    s+='<rect x="476" y="381" width="84" height="20" fill="#374750"/>'
    for x in (490,514,538): s+=f'<rect x="{x-3}" y="266" width="6" height="182" fill="#bd964b"/>'
    s+=text(450,246,'Male header',17)
    s+='<rect x="50" y="401" width="640" height="27" fill="#43806c"/>'
    s+=text(725,418,'One carrier PCB · two copper layers',22,weight=700)
    s+='<rect x="350" y="482" width="330" height="20" fill="#426d79"/>'
    for x in (376,650):
        s+=f'<rect x="{x-12}" y="428" width="24" height="54" fill="#374750"/><rect x="{x-3}" y="384" width="6" height="111" fill="#bd964b"/>'
        s+=f'<ellipse cx="{x}" cy="398" rx="12" ry="5" fill="#b4c0c9"/>'
    s+='<rect x="465" y="456" width="96" height="26" fill="#657580"/>'
    for x in (118,262,490,514,538):s+=f'<ellipse cx="{x}" cy="430" rx="12" ry="5" fill="#b4c0c9"/>'
    s+=text(350,531,'S3 / H2 / MG24 · room-facing',20,weight=700)
    s+='<path d="M695 433 v44 m-6 -8 l6 8 6 -8 M689 441 l6 -8 6 8" fill="none" stroke="#2c698d" stroke-width="2"/>'
    s+=text(704,461,'g',20,weight=700)
    s+=text(725,202,'Ceiling-facing: Ethernet and harness pins',21,weight=700)
    s+=text(725,242,'Provide room for the jack, mating plugs,',19)+text(725,270,'wire bends and access to the RJ45 latch.',19)
    s+=text(725,477,'g = carrier-to-module PCB gap',20)
    s+=text(725,516,'Subtract underside parts and solder/tail height.',19)
    s+=text(725,550,'The remainder must meet the clearance target.',19)
    s+=text(725,599,'A plastic spacer alone does not prove no contact.',18,fill='#8a4d27')
    if current and 'stack' in current['mechanics']:
        minimum=current['mechanics']['stack']['opposing_metal_clearance_min_mm']
        s+=text(32,622,f'Measured residual gap target: at least {minimum:g} mm at every permitted overlap.',19,weight=700)
    s+=text(32,669,'Solderability is a separate constraint',24,weight=700)
    s+=text(32,706,'Solder the entire back first, including WIZ; inspect and trim. Then fit the front and solder from the back.',19)
    s+=text(32,753,'No female module sockets. Physical module replacement requires desoldering. No postassembly USB cable space.',18)
    return s+'</g></svg>'


def board_outline(board):
    return board.get('outline_mm') or [[0,0],[board['width_mm'],0],[board['width_mm'],board['height_mm']],[0,board['height_mm']]]

def board_area(board):
    points=board_outline(board)
    return abs(sum(a[0]*b[1]-b[0]*a[1] for a,b in zip(points,points[1:]+points[:1])))/2

def layout_comparison(current):
    """Equal-scale, side-aware bodies and pad groups from native CAD ledgers."""
    previous=json.loads((HERE/'layout-single-sided.json').read_text())
    old=previous['board']; new=current['board']
    old_area=board_area(old); new_area=board_area(new)
    reduction=100*(1-new_area/old_area)
    names={'U1':'S3','U2':'H2','U3':'MG24','U4':'Ethernet'}
    colors={'U1':'#c2dded','U2':'#bbded0','U3':'#e9d9b1','U4':'#c6ced9'}
    def side_of(p):
        return 'back' if p.get('side','front') in ('back','B.Cu','bottom') else 'front'
    def bounds_of(p):
        if p.get('body_bounds_global_mm') is not None:
            return p['body_bounds_global_mm']
        if p.get('body_bounds_local_mm') is not None:
            assert side_of(p) == 'front', 'Back-side module needs native global body bounds'
            x1,y1,x2,y2=p['body_bounds_local_mm']; th=math.radians(p['rotation'])
            pts=[(p['xy'][0]+x*math.cos(th)+y*math.sin(th),p['xy'][1]-x*math.sin(th)+y*math.cos(th)) for x,y in [(x1,y1),(x1,y2),(x2,y1),(x2,y2)]]
            xs,ys=zip(*pts); return min(xs),min(ys),max(xs),max(ys)
        pads=p['pad_centers_mm']; m=1.27
        return min(q['x'] for q in pads)-m,min(q['y'] for q in pads)-m,max(q['x'] for q in pads)+m,max(q['y'] for q in pads)+m
    s='<svg xmlns="http://www.w3.org/2000/svg" width="1440" height="670" viewBox="0 0 1440 670" role="img" aria-label="Previous single-sided and current two-sided carrier at equal scale"><rect width="1440" height="670" fill="#fff"/><g font-family="Arial,sans-serif">'
    s+=text(32,43,'Use both sides. Keep one carrier.',31,weight=700)
    s+=text(32,80,f'{old_area/100:g} → {new_area/100:g} cm² of PCB · {reduction:.1f}% less area · two copper layers retained',21)
    scale=4.3; oy=182
    panels=[(previous,48,'Previous · room side','front'),(current,535,'Current · room side','front'),(current,1000,'Current · ceiling side','back')]
    for design,ox,label,side in panels:
        b=design['board']; w=b['width_mm']; height=b['height_mm']
        s+=text(ox,125,label,23,weight=700)
        s+=text(ox,156,f'{w:g} mm horizontal × {height:g} mm vertical',17)
        outline=[(w-x if side=='back' else x,y) for x,y in board_outline(b)]
        polygon=' '.join(f'{ox+x*scale:.2f},{oy+y*scale:.2f}' for x,y in outline)
        s+=f'<polygon points="{polygon}" fill="#edf2f2" stroke="#688493" stroke-width="2"/>'
        for p in design['parts']:
            if side_of(p)!=side: continue
            ref=p['ref']; x1,y1,x2,y2=bounds_of(p)
            if ref.startswith(('D','R')):
                pads=sorted(p['pad_centers_mm'],key=lambda q:q['number'])
                a,z=[(w-q['x'] if side=='back' else q['x'],q['y']) for q in pads]
                ax,ay=ox+a[0]*scale,oy+a[1]*scale; zx,zy=ox+z[0]*scale,oy+z[1]*scale
                s+=f'<line x1="{ax}" y1="{ay}" x2="{zx}" y2="{zy}" stroke="#8c8b78" stroke-width="2"/>'
                f=.18
                s+=f'<line x1="{ax+(zx-ax)*f}" y1="{ay+(zy-ay)*f}" x2="{zx-(zx-ax)*f}" y2="{zy-(zy-ay)*f}" stroke="#bd9c69" stroke-width="{2.5*scale}"/>'
                continue
            if side=='back': x1,x2=w-x2,w-x1
            fitted=p.get('fitted',True)
            color=colors.get(ref,'#34766b' if ref.startswith('J') else '#bd9c69') if fitted else '#fff'
            s+=f'<rect x="{ox+x1*scale:.2f}" y="{oy+y1*scale:.2f}" width="{(x2-x1)*scale:.2f}" height="{(y2-y1)*scale:.2f}" rx="1" fill="{color}" stroke="#597688"/>'
            if ref in names:
                s+=f'<text x="{ox+(x1+x2)*scale/2:.2f}" y="{oy+(y1+y2)*scale/2:.2f}" text-anchor="middle" font-size="13" fill="#193748">{names[ref]}</text>'
        for x,y in design['mechanics'].get('mounting_holes_mm',[]):
            if side=='back': x=w-x
            s+=f'<circle cx="{ox+x*scale}" cy="{oy+y*scale}" r="{1.35*scale}" fill="white" stroke="#526779" stroke-width="1.3"/>'
        # Show the RJ45 aperture only on the side carrying WIZ850io.
        wiz=next(p for p in design['parts'] if p['ref']=='U4')
        if side_of(wiz)==side:
            r=design['mechanics']['rj45']; a,z=r['face_global_mm']; nx,ny=r['outward_normal_global']
            if side=='back': a=[w-a[0],a[1]]; z=[w-z[0],z[1]]; nx=-nx
            cx,cy=(a[0]+z[0])/2,(a[1]+z[1])/2
            s+=f'<line x1="{ox+a[0]*scale}" y1="{oy+a[1]*scale}" x2="{ox+z[0]*scale}" y2="{oy+z[1]*scale}" stroke="#287a63" stroke-width="4"/>'
            sx,sy=ox+(cx+nx*2)*scale,oy+(cy+ny*2)*scale; ex,ey=ox+(cx+nx*10)*scale,oy+(cy+ny*10)*scale
            s+=f'<line x1="{sx}" y1="{sy}" x2="{ex}" y2="{ey}" stroke="#287a63" stroke-width="3"/>'
            s+=f'<polygon points="{ex},{ey} {ex-nx*10-ny*6},{ey-ny*10+nx*6} {ex-nx*10+ny*6},{ey-ny*10-nx*6}" fill="#287a63"/>'
    s+=text(32,599,'Views use the same scale. The ceiling-side view is mirrored, as seen when turning the board over.',19)
    s+=text(32,638,'Area saving is not a price quote. Header tails, assembly access, RF clearance and installed height remain separate checks.',17)
    return s+'</g></svg>'


def routing_comparison(metrics):
    old,new=metrics['baseline'],metrics['current']
    selected=[('/+5V_H2','H2 supply after D2'),('/+5V_ZB','Zigbee supply after D3'),('/+5V_S3','S3 supply after D1'),('/+5V','Shared 5 V network'),('/+3V3','Peripheral 3.3 V network'),('/RF_CS','RF chip-select network'),('/SPI_MOSI','SPI MOSI network'),('/SPI_MISO','SPI MISO network'),('/SPI_SCK','SPI clock network')]
    out='<svg xmlns="http://www.w3.org/2000/svg" width="1280" height="1010" viewBox="0 0 1280 1010" role="img" aria-label="Measured routed copper before and after the mounting and placement revision"><rect width="1280" height="1010" fill="white"/><g font-family="Arial,sans-serif">'
    out+=text(32,43,'Measure the routed result, not the angle alone',30,weight=700)
    out+=text(32,82,f"All explicit tracks: {old['total_track_length_mm']:.1f} → {new['total_track_length_mm']:.1f} mm  |  Vias: {old['total_vias']} → {new['total_vias']}",23)
    out+=text(32,118,'Same pin map and width rules; mounting, component placement and routing revised together.',18)
    out+='<rect x="32" y="141" width="20" height="12" fill="#a6b5c2"/><rect x="245" y="141" width="20" height="12" fill="#257c78"/>'
    out+=text(62,154,'Previous: four holes',16)+text(275,154,'Current; amber = longer net',16)
    scale=4.2
    for i,(net,label) in enumerate(selected):
        y=207+i*76;a=old['per_net'][net]['track_length_mm'];b=new['per_net'][net]['track_length_mm'];color='#ab671f' if b>a else '#257c78'
        out+=text(32,y+16,label,18)
        out+=f'<rect x="310" y="{y}" width="{a*scale}" height="12" rx="2" fill="#a6b5c2"/><rect x="310" y="{y+19}" width="{b*scale}" height="12" rx="2" fill="{color}"/>'
        out+=text(956,y+15,f'{a:.2f} → {b:.2f} mm',18)+text(956,y+38,f'{b-a:+.2f} mm',15,color)
    out+=text(32,918,'Totals include every branch in each named net. They are not single source-to-load distances.',18)
    out+=text(32,948,'Copper pours, module internals, through-hole barrels and external harnesses are excluded.',18)
    out+=text(32,978,'Shorter total routing is not proof of signal integrity or a global optimum. Full per-net data are linked in the guide.',17)
    return out+'</g></svg>'


def recovery_diagram():
    s='<svg xmlns="http://www.w3.org/2000/svg" width="1240" height="480" viewBox="0 0 1240 480" role="img" aria-label="Bounded Thread recovery"><rect width="1240" height="480" fill="#fff"/><g font-family="Arial,sans-serif">'
    s+=text(32,46,'A failed Thread radio must not cause a reboot loop',28,weight=700)
    s+=box(32,100,350,155,'Boot + RCP preflight',['Ethernet ready; probe H2','No response → quarantine','Keep the other services running'])
    s+=box(444,100,350,155,'Thread operational',['Local border router + REST','Normal transient recovery stays','Terminal fault → record failure'])
    s+=box(856,100,350,155,'Persistent quarantine',['At most one controlled restart','Next boot leaves Thread stopped','User retry explicitly re-arms it'])
    for x in (382,794):
        s+=f'<path d="M{x} 175 h58 m-9 -7 l9 7 -9 7" fill="none" stroke="#2c698d" stroke-width="3"/>'
    s+=box(32,300,1174,105,'Other services still share the S3',['A terminal Thread fault briefly interrupts every service during the restart. This is bounded recovery, not hardware isolation.'],'#f6eedf')
    s+=text(32,452,'Commissioning, power-loss recovery and simultaneous-load acceptance still require the assembled hardware.',17)
    return s+'</g></svg>'

def update_diagram():
    s='<svg xmlns="http://www.w3.org/2000/svg" width="1280" height="565" viewBox="0 0 1280 565" role="img" aria-label="Initial programming and network updates for the three controllers"><rect width="1280" height="565" fill="#fff"/><g font-family="Arial,sans-serif">'
    s+=text(32,48,'Program loose modules first. Update through Ethernet afterwards.',28,weight=700)
    s+=box(32,85,1216,100,'Before permanent soldering',['Prepare the specified H2 revision (R7 isolation), install all three matching images, then verify the update paths.'],'#f5f1e9')
    s+=box(32,220,382,205,'S3 host',['Ethernet → ESPHome OTA','Normal application updates','No USB cable space reserved','Failed bootloader or lost network:','physical recovery may be needed.'],'#e4eff7')
    s+=box(449,220,382,205,'H2 Thread radio',['Ethernet → S3 → H2 ROM UART','S3 controls BOOT and RESET','H2 RX23 / TX24; R7 removed','Explicitly armed update session','Thread remains paused during update.'],'#eaf4ed')
    s+=box(866,220,382,205,'MG24 Zigbee radio',['Ethernet → S3 UART bridge','Ember software bootloader entry','GBL application update','Stop ZHA / Zigbee2MQTT first','Bootloader must remain intact.'],'#edf0f8')
    s+=text(32,481,'J8 / J9 remain unpopulated local recovery pads. They add no fitted header or USB cable corridor.',18,weight=700)
    s+=text(32,526,'Network update support does not guarantee recovery from every hardware, bootloader or power-loss failure.',17)
    return s+'</g></svg>'

def harness_diagram(parts):
    """Show carrier pad identities and the real off-board destinations together."""
    by_ref={part['ref']:part for part in parts}
    cards=[
        ('J1','Isolated 5 V input',['Fused splitter +5 V','Splitter ground'],['Only isolated, regulated 5 V enters this header.','WIZ850io does not extract PoE.']),
        ('J2','D24V22F3 regulator',['Buck VIN','Buck GND','Buck VOUT, 3.3 V','Buck GND'],['This is a harness to a separate finished regulator.','Do not join the controllers’ local 3V3 outputs.']),
        ('J3','DFR0627 / WK2132',['Module VCC, 3.3 V','Module GND','Module SDA','Module SCL','Module TX1 → ZAC93 RX','Module RX1 ← ZAC93 TX'],['IA1 = 1, IA0 = 1; register 0x70, FIFO 0x71.','Identify physical module labels before wiring.']),
        ('J4','ZAC93 Z-Wave',['ZAC93 pin 1','ZAC93 pin 6','ZAC93 pin 9','ZAC93 pin 8, RX','ZAC93 pin 10, TX'],['Carrier pin numbers are NOT ZAC93 pin numbers.','UART goes through J3, the external WK2132.']),
        ('J5','CC1101 radio',['Module VCC, 3.3 V','Module GND','SCK','MOSI','MISO','CSn','GDO0','GDO2'],['Shared SPI with WIZ850io; independent CS.','Use signal labels: clone header numbering varies.']),
        ('J6','LD2450 radar',['Radar 5 V','Radar GND','Radar RX ← S3 TX','Radar TX → S3 RX'],['5 V power with 3.3 V data signals.','Do not infer direction from net suffix alone.']),
        ('J7','BME680 external pod',['Sensor GND','Sensor VDD, 3.3 V','Sensor SDA','Sensor SCL'],['Mount away from enclosure heat.','Check module pull-ups before adding any.'])]
    s='<svg xmlns="http://www.w3.org/2000/svg" width="1440" height="1840" viewBox="0 0 1440 1840" role="img" aria-label="MC1 external harness connector map"><rect width="1440" height="1840" fill="#f5f8fa"/><g font-family="Arial,sans-serif">'
    s+=text(36,48,'MC1 · external connections',32,weight=700)
    s+=text(36,85,'Seven rear male headers · exact carrier pads and nets · external modules remain external',20)
    s+=text(36,116,'Logical wiring map, not a connector face view. Find physical pin 1 in the mirrored rear CAD drawing.',17)
    def color(net):
        return '#a43e37' if net.startswith('+5V') else '#987015' if net=='+3V3' else '#50616f' if net=='GND' else '#226c9b'
    for i,(ref,label,dest,notes) in enumerate(cards):
        x=36+(i%2)*700;y=155+(i//2)*385
        s+=f'<rect x="{x}" y="{y}" width="668" height="363" rx="12" fill="white" stroke="#cad6df"/>'
        s+=text(x+20,y+34,ref+' · '+label,23,weight=700)
        s+=text(x+20,y+66,'Carrier pad',14,fill='#677e8e')+text(x+139,y+66,'Net',14,fill='#677e8e')+text(x+335,y+66,'Off-board destination',14,fill='#677e8e')
        pins=by_ref[ref]['pins']
        assert len(pins)==len(dest), f'Destination count mismatch: {ref}'
        for j,((pin,net),target) in enumerate(zip(pins.items(),dest)):
            yy=y+95+j*27
            s+=text(x+20,yy,f'{ref}.{pin}',18,weight=700)+text(x+139,yy,net,18,color(net))+text(x+335,yy,target,17)
        for j,note in enumerate(notes):s+=text(x+20,y+319+j*23,note,16,fill='#486577')
    x=736;y=1310
    s+=f'<rect x="{x}" y="{y}" width="668" height="363" rx="12" fill="#e7f2ec" stroke="#87ad96"/>'
    for j,line in enumerate(['Connections already on the PCB','U1 ↔ U2: Thread UART + EN + BOOT','U1 ↔ U3: Zigbee UART + RTS / CTS','U1 ↔ U4: shared SPI + CS + INT + RESET','D1–D3: separate controller 5 V branches','R1 / R2: RF pull-ups','J8 / J9: unpopulated recovery pads']):
        s+=text(x+20,y+36+j*39,line,22 if j==0 else 18,weight=700 if j==0 else 400)
    s+=text(36,1724,'Assembly: solder all rear components first; inspect and trim; then install front U1–U3.',20,weight=700)
    s+=text(36,1765,'H2 uses RX23 / TX24 with R7 removed on the specified DevKit revision. Preflash loose modules.',18)
    s+=text(36,1804,'Verify continuity, polarity and loaded rails before connecting peripherals. This map is not a hardware test result.',17)
    return s+'</g></svg>'

def produce():
    p=json.loads((HERE/'presentation.json').read_text())
    current=json.loads((HERE/'cad/design.json').read_text())
    design=runpy.run_path(str(HERE/'cad/design.py'))
    parts=design['parts']
    counts={k:sum(1 for x in parts if x['ref'].startswith(k) and x.get('fitted',True)) for k in ['C','R','D','U','J']}
    old_counts=[]
    for relative in ['carrier','carrier/mg24-adapter','integrated']:
        rows_old=list(csv.DictReader((ROOT/'hardware/low-power'/relative/'assembly-bom.csv').open()))
        old_counts.append(sum(int(x['Quantity']) for x in rows_old if x['Reference'].startswith(('C','R'))))
    compare=[('C0 + M0 · historical',sum(old_counts[:2])),('I0 · historical',old_counts[2]),('MC1 · current',counts['C']+counts['R'])]
    chart='<svg xmlns="http://www.w3.org/2000/svg" width="1200" height="420" viewBox="0 0 1200 420" role="img" aria-label="Builder-installed capacitor and resistor counts"><rect width="1200" height="420" fill="white"/><g font-family="Arial,sans-serif">'
    chart+=text(32,45,'Builder-installed capacitors + resistors',28,weight=700)
    chart+=text(32,79,'Component placements from the respective BOMs; alternative builds are not added together.',17)
    for i,(label,count) in enumerate(compare):
        y=112+i*70
        chart+=text(32,y+25,label,18)+f'<rect x="285" y="{y}" width="{count*8}" height="37" rx="3" fill="'+('#287a63' if i==2 else '#8298a7')+'"/>'+text(300+count*8,y+26,str(count),21,weight=700)
    module_joints=sum(len(x['pins']) for x in parts if x['ref'].startswith('U'))
    chart+=text(32,351,f"MC1 also has {counts['D']} through-hole diodes, {counts['J']} fitted connectors and {counts['U']} complete board modules.",18)
    chart+=text(32,383,f"{module_joints} module header pins still need through-hole solder joints. Factory-fitted module parts are excluded above.",17)
    chart+='</g></svg>'
    nets={}
    for part in parts:
        for pin,net in part['pins'].items():
            if net: nets.setdefault(net,[]).append(f"{part['ref']}.{pin}")
    rows=''.join(f'<tr data-net="{h(net.lower())}"><th>{h(net)}</th><td>{h(" · ".join(ends))}</td></tr>' for net,ends in sorted(nets.items()))
    partrows=''.join(f'<tr><th>{h(x["ref"])}</th><td>{h(x["model"])}{" — unpopulated pads" if not x.get("fitted",True) else ""}</td><td>{h(x["notes"])}</td></tr>' for x in parts)
    functions=''.join(f'<tr><th>{h(x["name"])}</th><td>{h(x["implementation"])}</td><td>{h(x["retained"])}</td><td>{h(x["test"])}</td></tr>' for x in p['functions'])
    steps=''.join(f'<li>{h(x)}</li>' for x in p['assembly_steps'])
    gates=''.join(f'<li>{h(x)}</li>' for x in p['unproven'])
    sources=''.join(f'<a href="{h(u)}">{h(n)}</a>' for n,u in p['sources'])
    evidence_path=HERE/'verification-summary.json'
    evidence=json.loads(evidence_path.read_text()) if evidence_path.exists() else {'checks':[],'status':'Validation in progress'}
    checks=''.join(f'<tr><th>{h(x["check"])}</th><td>{h(x["result"])}</td><td>{h(x["scope"])}</td></tr>' for x in evidence['checks'])
    checks=checks or '<tr><td colspan="3">Validation results have not been recorded. No pass is implied.</td></tr>'
    native=''.join(f'<figure><a href="images/{n}"><img src="images/{n}" alt="{h(cap)}"></a><figcaption>{h(cap)} · <a href="images/{n}">Open full size</a></figcaption></figure>' for n,cap in [('mc1-board-top.png','Native KiCad render · front / room-facing copper'),('mc1-board-bottom.png','Native KiCad render · back / ceiling-facing copper')] if (HERE/'images'/n).exists())
    concept=''
    photo_link=''
    concept_path=HERE/'images/mc1-assembled-concept.png'
    provenance_path=HERE/'images/generated-image-provenance.json'
    provenance=json.loads(provenance_path.read_text()) if provenance_path.exists() else {}
    concept_is_current=(provenance.get('accepted_as')=='simplified_concept_only'
        and concept_path.exists() and (HERE/'cad/assembly-top.png').exists()
        and provenance.get('sha256')==sha(concept_path)
        and provenance.get('reference_images',{}).get('../cad/assembly-top.png')==sha(HERE/'cad/assembly-top.png')
        and provenance.get('reference_images',{}).get('../cad/assembly-bottom.png')==sha(HERE/'cad/assembly-bottom.png')
        and provenance.get('board_sha256')==sha(HERE/'cad/mc1.kicad_pcb'))
    if concept_is_current:
        photo_link='<a href="#photos">Concept</a>'
        concept='<h3 id="photos">Simplified assembly concept</h3><figure><img src="images/mc1-assembled-concept.png" alt="Generated concept showing three front controllers and rear Ethernet with male headers"><figcaption>AI-generated block-model illustration, not a manufactured-board photograph. Module details, antenna projections and USB bodies are deliberately omitted; drawn pin counts and dimensions are not construction data. Use the exact front/back CAD above for assembly. <a href="images/generated-image-provenance.json">Prompt and review provenance</a>.</figcaption></figure>'
    boardview=''.join(f'<figure><a href="cad/{name}"><img src="cad/{name}" alt="{caption}"></a><figcaption>{caption}. Physical view from this side; pad numbers follow the native CAD. <a href="cad/{name}">Open full size</a></figcaption></figure>' for name,caption in [('assembly-top.svg','Room-facing side: controllers'),('assembly-bottom.svg','Ceiling-facing side: Ethernet, male pins, diodes and resistors')] if (HERE/'cad'/name).exists())
    b=current['board']
    dimensions=f"{b['width_mm']:g} × {b['height_mm']:g} mm"
    baseline=json.loads((HERE/'layout-baseline.json').read_text())['board']
    area_reduction=100*(1-board_area(b)/board_area(baseline))
    prior=json.loads((HERE/'layout-single-sided.json').read_text())['board']
    previous_reduction=100*(1-board_area(b)/board_area(prior))
    rj45=current['mechanics']['rj45']
    direction=rj45['opening_direction'].split(' / ')[0]
    mouth=max(rj45.get('mouth_beyond_'+side+'_edge_mm',0) for side in ('left','right','top','bottom'))
    edge_access=f'RJ45 faces outward at the {direction} edge; its mouth projects {mouth:g} mm beyond the carrier.'
    compact=f'<p>The carrier fits within <strong>{dimensions}</strong>, with <strong>{previous_reduction:.1f}% less PCB area</strong> than the historical 65 × 75 mm single-sided carrier and {area_reduction:.1f}% less than the original 160 × 100 mm outline. S3, H2 and MG24 face the room. WIZ850io, all seven male harness headers, three diodes and two resistors face the ceiling. This permits selected opposite-side overlap; plated holes, solder tails, underside parts and antenna exclusions still require clearance. USB cable corridors remain absent. Program and verify each controller before soldering. Later updates use the network paths described below.</p><figure><a href="layout-comparison.svg"><img src="layout-comparison.svg" alt="Previous and compact MC1 placement at the same scale"></a><figcaption>Historical versus current placement at the same scale. <a href="layout-comparison.svg">Open comparison</a>. Area uses the actual PCB outline; finished modules, cables and enclosure are separate.</figcaption></figure>'
    compact+='<p>Both dimensions stay within the 100 × 100 mm size ceiling used by advertised low-cost prototype offers. Component placement now uses both sides of the same two-layer PCB. Two-sided manual soldering needs an explicit assembly order; it does not require four copper layers. A smaller outline does not imply a proportional reduction in the delivered fabrication price. <a href="../../docs/module-carrier.md#compact-placement-and-fabrication-cost">Cost rationale and source offers</a>; shipping and final fabrication specifications need their own quote.</p>'
    metrics_path=HERE/'cad/routing-metrics.json'
    metrics=json.loads(metrics_path.read_text()) if metrics_path.exists() else None
    mounting=''
    if metrics:
        mounting='<h3 id="mounting">One retention hole, supported edges</h3><p>The 47.5 × 75 mm PCB retains only H3 between U2 and U3. Split enclosure rails support both long edges; H3 locates and retains the board. Removing the other three holes and moving the controllers inward reduces area by 6.9% from the preceding 51 × 75 mm board. Two copper layers, sixteen fitted electronic items and every pin assignment are retained.</p><figure><a href="../../mechanical/module-carrier/rail-mount/rail-mount.svg"><img src="../../mechanical/module-carrier/rail-mount/rail-mount.svg" alt="Single H3 retention hole and split enclosure edge supports"></a><figcaption>Load the board into an open frame, then close the retaining lips. Separate enclosure fasteners attach it to the ceiling. A jack-body stop and cable restraint must protect the WIZ header joints. The drawing defines a mounting interface; measured height, printed fit, load capacity and RF performance remain unqualified.</figcaption></figure><p><a href="../../mechanical/module-carrier/rail-mount/index.html">Rail study, assembly sequence and printable fit coupons</a>. The groove must have measured clearance; it is not a zero-clearance press fit.</p>'
        mounting+='<h3>Placement and routed length</h3><p>The entire rear is soldered first: WIZ, all seven male harness headers and the five axial parts. Front U1–U3 are fitted afterwards and soldered from the accessible rear. Opposite-side overlap is allowed; every remaining solder land and the measured height clearance must pass. D1 and R1 retain useful diagonal orientations, while S3 and H2 are brought closer together. Pin assignments, polarity and track-width rules are unchanged.</p>'
        mounting+='<figure><a href="routing-comparison.svg"><img src="routing-comparison.svg" alt="Per-net routed copper lengths before and after"></a><figcaption>Actual native track lengths, including every branch of each net. Shorter total routing does not establish that every path improved or that signal integrity is proven.</figcaption></figure><p><a href="cad/routing-metrics.json">All per-net measurements</a> · <a href="independent-review.md">Independent geometry review</a></p>'
    drc_count=json.loads((HERE/'cad/verification.json').read_text())['checks']['drc_violations']
    enclosure_report=json.loads((ROOT/'mechanical/module-carrier/enclosure-prototype/verification.json').read_text())
    enclosure_dimensions=' × '.join(f'{v:g}' for v in enclosure_report['outer_dimensions_mm'])+' mm'
    enclosure=f'''<h2 id="enclosure">Printable carrier enclosure</h2><p>The current package contains a ceiling-side base, a room-side retaining cover, a separate jack-stop trial and a 4 mm ceiling spacing frame. The PCB is held by the legal edge lands and the single H3 hole. Case closure and ceiling screws are separate from the PCB mounting.</p><p><strong>{enclosure_dimensions} trial outer envelope; {enclosure_report["installed_height_including_frame_mm"]:g} mm installed depth.</strong> Install and adjust floor hardware on the bench before mounting the base to the ceiling. The spacing frame accommodates underside screw heads up to 3 mm. The 26 mm rear and 25 mm front cavities are explicit assumptions, not measured module heights. This houses the carrier only; the PoE splitter, regulator, UART bridge, extra radios and sensors remain outside it.</p><figure><a href="../../mechanical/module-carrier/enclosure-prototype/enclosure.svg"><img src="../../mechanical/module-carrier/enclosure-prototype/enclosure.svg" alt="Current carrier enclosure dimensions and section"></a><figcaption>Native PCB positions and explicit provisional case dimensions. Print the rail coupons first; measure the populated stack before selecting final height.</figcaption></figure><figure><a href="../../mechanical/module-carrier/enclosure-prototype/print-parts.png"><img src="../../mechanical/module-carrier/enclosure-prototype/print-parts.png" alt="Actual generated enclosure meshes in print orientation"></a><figcaption>Deterministic mesh rendering of the printable parts. The adjustable jack stop requires a measured metal-cage contact position; its default position is not approved for a powered assembly.</figcaption></figure><p><a href="../../mechanical/module-carrier/enclosure-prototype/index.html">Enclosure guide</a> · <a href="../../mechanical/module-carrier/enclosure-prototype/README.md">Assembly and required measurements</a> · <a href="../../mechanical/module-carrier/enclosure-prototype/base.stl">Base STL</a> · <a href="../../mechanical/module-carrier/enclosure-prototype/cover.stl">Cover STL</a> · <a href="../../mechanical/module-carrier/enclosure-prototype/jack-stop-trial.stl">Trial stop STL</a> · <a href="../../mechanical/module-carrier/enclosure-prototype/ceiling-spacing-frame.stl">Ceiling frame STL</a> · <a href="../../mechanical/module-carrier/enclosure-prototype/assembly.scad">Assembled SCAD preview</a></p>'''
    costs='''<h2 id="cost">Current cost scope</h2><p>The 17 October calculator check displayed <strong>$5.20 for five bare PCBs</strong> before freight and tax. Service errors prevented a confirmed checkout quote. Allocated materials for a populated carrier are approximately <strong>$55–57 per unit</strong>, using retail module references and a small-part allowance. This excludes the external devices, enclosure, assembly work and delivery.</p><p>The historical $496 estimate was for twenty 160 × 100 mm boards at an area-based US tariff. It is not the price of the current carrier. <a href="cost-review/README.md">Full cost review, source prices and calculator evidence</a>.</p>'''
    page='''<!doctype html><html lang="en"><head><meta charset="utf-8"><meta name="viewport" content="width=device-width,initial-scale=1"><title>MC1 — one module carrier</title><style>
:root{--ink:#193748;--muted:#5b7180;--accent:#27698e;--line:#c7d6df;--paper:#fff;--soft:#eef4f7}*{box-sizing:border-box}html{scroll-behavior:smooth}body{margin:0;background:#edf2f5;color:var(--ink);font:16px/1.6 system-ui,sans-serif}main{max-width:1260px;margin:auto;background:var(--paper);padding:36px}nav{display:flex;gap:20px;flex-wrap:wrap;font-size:14px}a{color:var(--accent)}h1{font-size:42px;line-height:1.14;max-width:900px;margin:26px 0 18px}h2{font-size:27px;line-height:1.2;margin:40px 0 18px}h3{font-size:19px}p{max-width:1000px}.lead{font-size:20px}.eyebrow{letter-spacing:.12em;font-size:13px;font-weight:650;color:var(--muted)}.notice{padding:18px 24px;border-left:4px solid var(--accent);background:var(--soft)}.muted,figcaption{color:var(--muted)}.facts{display:flex;gap:36px;flex-wrap:wrap;padding:22px 0;border-bottom:1px solid var(--line)}.facts b{display:block;font-size:25px}.facts span{font-size:14px}.two{display:grid;grid-template-columns:1fr 1fr;gap:28px}figure{margin:24px 0}img{display:block;max-width:100%;height:auto}figcaption{font-size:14px;margin-top:10px}.scroll{overflow:auto}table{border-collapse:collapse;width:100%;font-size:14px}td,th{padding:11px;text-align:left;vertical-align:top;border-bottom:1px solid var(--line)}th{font-weight:650}thead{background:var(--soft)}input,button{font:inherit;padding:10px 14px;border:1px solid var(--line);border-radius:4px;background:white;color:var(--ink)}input{max-width:100%;width:480px}li{margin-bottom:10px}.sources{display:flex;gap:18px;flex-wrap:wrap;font-size:14px}code{font-size:.9em;background:#eef2f4;padding:2px 5px}details{margin-top:22px}summary{cursor:pointer;font-weight:650}@media(max-width:700px){main{padding:20px}h1{font-size:31px}.two{display:block}.facts{gap:22px}td,th{padding:8px}nav{gap:14px}}@media print{body{background:white}main{padding:0}nav,input,button{display:none}figure{break-inside:avoid}h2{break-after:avoid}}
</style></head><body><main>
<nav><a href="#board">Board</a><a href="#pcb">PCB</a>__PHOTO_LINK__<a href="#circuit">Schematic</a><a href="#wiring">Wiring</a><a href="#enclosure">Enclosure</a><a href="#cost">Cost</a><a href="#assembly">Assembly</a><a href="#evidence">Evidence</a><a href="../../docs/README.md">Documentation</a></nav>
<p class="eyebrow">HA RADIO HUB / MC1 / 18 OCTOBER 2026</p><h1>One carrier.<br>Finished modules.<br>Familiar protocols.</h1>
<p class="lead">S3-Nano-M + H2 + Ember MG24. One Ethernet uplink, local Thread, three active BLE slots and the existing Home Assistant interfaces. Solder factory module pins directly into the carrier.</p>
<div class="notice"><strong>Historical MC1 revision. Use the <a href="../external-antenna/index.html">current MC2 external-antenna guide</a> for new builds.</strong> Engineering prototype: no physical assembly, measured power, RF qualification or production approval is implied.</div>
<div class="facts"><div><b>__DIMENSIONS__</b><span>two-layer custom PCB</span></div><div><b>0</b><span>female module sockets</span></div><div><b>3</b><span>dedicated radio/host controllers</span></div><div><b>7</b><span>retained function groups</span></div></div>
<h2 id="board">The selected architecture</h2><figure><img src="architecture.svg" alt="MC1 module architecture"><figcaption>Logical topology. The CAD defines physical placement; this diagram does not claim routing lengths.</figcaption></figure>
<p>The former C0/M0, I0 and D0 paths are historical references. The all-H2 experiment was not selected because its local border-router implementation and Zigbee integration/backup behavior did not meet the compatibility priority.</p>
<h2 id="pcb">The compact PCB</h2>__COMPACT__<p><strong>__EDGE_ACCESS__</strong> The Ethernet module is on the ceiling-facing side. Keep its plug and latch corridor clear. The electrical pin map and matching firmware are unchanged from the 65 × 75 mm revision.</p>__MOUNTING____BOARDVIEW__<div class="two">__NATIVE__</div><p><a href="cad/board-top.svg">Top copper and silk</a> · <a href="cad/board-bottom.svg">Bottom copper and silk</a> · <a href="cad/mc1.kicad_pcb">Native two-layer PCB</a></p>__CONCEPT__
<h2>What changed after the SMLIGHT review</h2><p>The host and two independent radios remain. W5500 and CC1101 share one SPI bus with separate chip selects, freeing three host pins. No extra processor, GPIO expander or internal Ethernet hop is introduced. The smaller Nano retains 16 MB flash and 8 MB PSRAM. <a href="studies/slzb-thread/index.html">Source review</a> · <a href="studies/compact-s3/index.html">Host selection history</a>.</p><figure><img src="thread-recovery.svg" alt="Bounded Thread recovery with persistent quarantine"><figcaption>Recovery policy; source and model tests do not establish hardware fault-injection results. <a href="../../firmware/module-carrier/thread-recovery.md">Firmware controls and acceptance</a>.</figcaption></figure><h2>Function and compatibility contract</h2><p>These are the functions retained in the design. The last column names the hardware acceptance still required; a retained protocol is not a completed bench test.</p><div class="scroll"><table><thead><tr><th>Function</th><th>Implementation</th><th>Retained interface</th><th>Bench acceptance</th></tr></thead><tbody>__FUNCTIONS__</tbody></table></div>
<h2 id="updates">Programming without USB service gaps</h2><p>Initial programming is performed before the modules are soldered. Subsequent S3 updates use ESPHome OTA; H2 updates pass through the S3 to its ROM UART; MG24 application updates use its existing Ember bootloader and serial bridge. See the <a href="../../firmware/module-carrier/README.md">firmware instructions and tested limits</a>.</p><div class="notice"><strong>Required H2 preparation:</strong> on the specified DevKitM-1 v1.3, remove R7 (470 Ω) before assembly to isolate the USB-UART transmitter. The carrier now uses H2 RX23 / TX24. Verify the actual board revision and load the matching RCP image; the former RX4 / TX5 image is incompatible.</div><figure><a href="network-updates.svg"><img src="network-updates.svg" alt="Preassembly programming and later network update paths"></a><figcaption>Three update paths; no permanent USB cable corridor. <a href="network-updates.svg">Open full size</a>.</figcaption></figure>
<h2 id="circuit">Electrical schematic and external harnesses</h2><figure><a href="cad/schematic.svg"><img src="cad/schematic.svg" alt="Current native KiCad electrical schematic"></a><figcaption>Native KiCad schematic. <a href="cad/schematic.svg">Open SVG at full size</a> · <a href="cad/schematic.pdf">PDF</a> · <a href="cad/mc1.kicad_sch">Editable schematic</a>.</figcaption></figure><figure><a href="harness-connections.svg"><img src="harness-connections.svg" alt="Seven rear male harness headers with exact carrier nets and external module destinations"></a><figcaption>Carrier pin identities come from the current CAD source. External connector numbering can differ: use the labeled signal and the exact purchased module. <a href="harness-connections.svg">Open connection map</a>.</figcaption></figure>
<h2 id="wiring">Actual net endpoints</h2><p>Generated from the current MC1 CAD design source. <strong>References identify carrier pads, not arbitrary clone pin numbers.</strong> Module connector labels and physical orientation must match the CAD.</p><label for="net-search">Find a net or endpoint</label><br><input id="net-search" type="search" placeholder="Example: THREAD, U2, ZB_CTS"><p id="net-count" class="muted"></p><div class="scroll"><table><thead><tr><th>Net</th><th>Carrier endpoints</th></tr></thead><tbody id="nets">__NETS__</tbody></table></div>
__ENCLOSURE____COSTS__
<h2 id="assembly">Two-sided direct solder mounting</h2><p>Follow the <a href="studies/two-sided/assembly-review.md">assembly and height review</a>: solder the complete rear first, then fit and solder the front controllers. Stock header height is not assumed to make opposing pins safe: measure the assembled gap and trim only while preserving sound through-hole solder joints.</p><figure><img src="direct-solder.svg" alt="Two-sided module mounting with controlled tail and underside clearance"><figcaption>Male module pins solder directly into the carrier. Check the actual spacer, trimmed solder tails and opposite-side components before assembly; no female module socket is used.</figcaption></figure><ol>__STEPS__</ol>
<div class="notice"><strong>Power and assembly:</strong> separate the controller supply paths from the peripheral 3.3 V rail. Do not parallel regulator outputs. Carrier diode drops require loaded-rail checks. Nano receives the diode-isolated 5 V branch at VIN; VBUS and local 3V3 remain isolated. This is below its documented external VIN range and needs a loaded-rail test. Complete individual USB programming and checks before soldering; the assembled layout reserves no USB insertion space.</div>
<h3>What is removed from manual assembly</h3><figure><img src="assembly-counts.svg" alt="BOM comparison of capacitors and resistors placed by the builder"><figcaption>Counts refer only to separately placed resistors and capacitors, not every component or solder joint in the completed hub.</figcaption></figure><details><summary>Carrier parts and module references</summary><div class="scroll"><table><thead><tr><th>Reference</th><th>Part</th><th>Assembly notes</th></tr></thead><tbody>__PARTS__</tbody></table></div></details>
<h2 id="evidence">What has actually been checked</h2><p>The raw PCB report retains __DRC_COUNT__ intentional rear-pad/front-module courtyard overlaps. A separate exact classifier checks their identities, sides and positions and rejects every other violation. This is not a zero-DRC claim: clearance in height remains a physical measurement requirement.</p><div class="scroll"><table><thead><tr><th>Check</th><th>Result</th><th>Scope / limitation</th></tr></thead><tbody>__CHECKS__</tbody></table></div>
<p><a href="verification-summary.json">Machine-readable verification summary</a> · <a href="../../firmware/module-carrier/README.md">Firmware evidence and build instructions</a> · <a href="cad/">Native CAD and reports</a> · <a href="images/README.md">Image provenance</a></p>
<h3>Still requires the real assembly</h3><ul>__GATES__</ul><p>One current layout reduces the choice and assembly burden. Board-specific firmware configuration and UART-transport hardening remain real work; no claim of zero software changes or guaranteed lower power is made.</p>
<h2>Manufacturer and implementation sources</h2><div class="sources">__SOURCES__</div><p class="muted">The current MC1 documentation is in English. Old hardware images retain their original identity and provenance in the historical archive.</p>
<script>const input=document.getElementById('net-search');const rows=Array.from(document.querySelectorAll('#nets tr'));function filter(){const q=input.value.trim().toLowerCase();let n=0;for(const row of rows){const visible=row.textContent.toLowerCase().includes(q);row.hidden=!visible;if(visible)n++;}document.getElementById('net-count').textContent=n+' of '+rows.length+' nets shown';}input.addEventListener('input',filter);filter();</script>
</main></body></html>'''
    for name,value in dict(DIMENSIONS=dimensions,DRC_COUNT=str(drc_count),MOUNTING=mounting,EDGE_ACCESS=edge_access,COMPACT=compact,BOARDVIEW=boardview,NATIVE=native,CONCEPT=concept,PHOTO_LINK=photo_link,FUNCTIONS=functions,NETS=rows,STEPS=steps,PARTS=partrows,CHECKS=checks,GATES=gates,SOURCES=sources,ENCLOSURE=enclosure,COSTS=costs).items(): page=page.replace('__'+name+'__',value)
    wiring={'revision':'MC1','source':'cad/design.py','source_sha256':sha(HERE/'cad/design.py'),'nets':nets,'parts':parts}
    outputs={'index.html':page,'architecture.svg':architecture(),'direct-solder.svg':assembly(current),'assembly-counts.svg':chart,'layout-comparison.svg':layout_comparison(current),'thread-recovery.svg':recovery_diagram(),'network-updates.svg':update_diagram(),'harness-connections.svg':harness_diagram(parts),'wiring.json':json.dumps(wiring,indent=2)+'\n'}
    if metrics: outputs['routing-comparison.svg']=routing_comparison(metrics)
    return outputs

def main():
    a=argparse.ArgumentParser();a.add_argument('--check',action='store_true');args=a.parse_args()
    out=produce()
    for name,content in out.items():
        path=HERE/name
        if args.check:
            assert path.exists() and path.read_text()==content, f'Stale MC1 output: {name}'
        else: path.write_text(content)
    print('MC1 presentation '+('verified' if args.check else 'generated')+': '+', '.join(out))
if __name__=='__main__': main()
