ha-homelab/ha-radio-hub/hardware/low-power/carrier/design.py

"""LP-C0 low-voltage carrier: single electrical source of truth.
All connector numbering is carrier PCB top view, never an unverified remote board header.
"""
from pathlib import Path
import json
ROOT = Path(__file__).resolve().parent
CONTRACT = json.loads((ROOT.parent/'pinmap.json').read_text())
SOURCES = {
 'jst_xh':'https://www.jst-mfg.com/product/pdf/eng/eXH.pdf',
 'jst_sh':'https://www.jst-mfg.com/product/pdf/eng/eSH.pdf',
 'idc':'https://www.we-online.com/components/products/datasheet/61204021621.pdf',
 'idc_mate':'https://www.we-online.com/components/products/datasheet/61204023021.pdf',
 'sc16':'https://www.nxp.com/docs/en/data-sheet/SC16IS752_SC16IS762.pdf',
 'tps':'https://www.ti.com/lit/ds/symlink/tps3808.pdf',
 'crystal':'https://abracon.com/Resonators/abls.pdf',
 'fuse':'https://www.littelfuse.com/assetdocs/fuses-449-datasheet?assetguid=7aef6e93-9808-456e-9bee-fba54271285f',
 'buck':'https://www.pololu.com/product/2857',
 'stemma':'https://learn.adafruit.com/introducing-adafruit-stemma-qt/technical-specs',
}
parts=[]; connectors=[]
def part(ref,model,footprint,pins,xy,rotation=0,source=None,notes='',types=None):
    p=dict(ref=ref,model=model,footprint=footprint,pins={str(k):v for k,v in pins.items()},xy=xy,rotation=rotation,source=source,notes=notes,types=types or {})
    parts.append(p); return p
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
