ha-homelab/ha-radio-hub/(commit log)

2026-10-17 feat: publish modular PoE radio hub prototype and printable enclosure
    [antenna_blank.scad, antenna_blank.stl, assembly.scad, base.scad, base.stl, bme680_pod_base.scad, bme680_pod_base.stl, bme680_pod_lid.scad]
2026-10-17 fix: validate RF command strings and shorten sensor harness routing
    [assembly.scad, base.scad, base.stl]
2026-10-17 Complete RF Ethernet migration and shared CI (#1)
    The initial Ethernet RF prototype could not replace RF Airbridge because
    it exposed different receive events and lacked the existing MQTT, RM433
    and Dooya contracts. This ports those contracts to a second
    ESP32-S3-ETH-M/CC1101 controller and provides an offline importer for
    private installation configuration.
    The port preserves binary widths, MQTT payloads and topics, native
    transmit actions, RM433 events, and the shared busy/cooldown policy. A
    version-pinned ESP32 receiver patch pauses capture and discards buffered
    frames around asynchronous transmission. GPIO4 uses open drain with a
    required 4.7 kΩ pull-up so the transmitter releases GDO0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
    [bom.csv, wiring.csv]
2026-10-17 Complete build package and preserve installed RF configuration (#3)
    The installed RF Airbridge wrapper uses explicit empty API settings,
    passwordless OTA, a web server and radio overrides that the migration
    importer rejected. The importer now preserves these supported settings
    and all sensor definitions, rewires board-specific pins, and rejects
    ambiguous secret aliases before writing files.
    This also completes the engineering build package: a deterministic
    archive of committed public files, per-file SHA-256 manifest, eight
    printable parts, corrected cable layout, and a reconciled 41-item BOM
    with concrete power adapters and explicit physical checks. Packaging
    excludes private installation d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
    [bom.csv, wiring.csv]
2026-10-17 Add low-power radio hub firmware, wiring atlas and PCB prototypes (#5)
    The original hub spends power on a Linux host, an internal switch and
    duplicated Ethernet controllers. This change adds a separate
    single-Ethernet ESP32-S3 prototype with local OTBR and dedicated Zigbee,
    Thread, Z-Wave and RF radios, then provides the wiring and PCB sources
    needed to build and review it. The objective is minimum lifetime
    electricity, independent of component purchase cost.
    ## Implementation
    - Unified S3 firmware with BLE proxy, CC1101 RF, LD2450, BME680, SC16
    Z-Wave UART, Zigbee TCP and H2-backed OTBR; reproducible H2 RCP and
    exact MGM240PA22VNA3 NCP/bootloader builds.
    - Offline wiring atlas with signal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
    [assembly-bom.csv, assembly.scad, bom.csv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]
2026-10-17 build(deps): bump networkx from 3.5 to 3.7 in /mechanical (#2)
    Update the CAD environment from NetworkX 3.5 to 3.7. The dependency
    remains confined to mechanical generation/mesh validation and supports
    the documented Python 3.12 environment. The branch includes current
    main; the resulting PR changes only the NetworkX pin.
    Validation on Python 3.12.14 / NetworkX 3.7: pip dependency consistency,
    7 baseline CAD tests, 9 low-power CAD tests, and regeneration checks for
    both committed CAD asset sets all pass. No generated geometry changes
    are needed.
    [NetworkX 3.7 metadata and supported Python
    versions](https://pypi.org/project/networkx/3.7/).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
2026-10-17 Add illustrated parts catalog and home-etched carrier option (#6)
    Builders can now identify every BOM item visually and choose a separate
    carrier designed for home toner transfer. The README shows native C0,
    M0, I0 and D0 PCB renders; the parts gallery covers all 341 canonical
    BOM rows in 223 cards, with manufacturer image credits, offline
    illustrations and clearly labelled, unverified AliExpress searches.
    The new D0 carrier keeps the existing firmware pin contract and uses
    bottom copper, through-hole parts and 54 insulated links. It includes
    native KiCad files, exact adapter references, BOMs, connector and wire
    schedules, bottom-only fabrication references and four 1:1 print PDFs.
    The wiri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
    [assembly-bom.csv, diy.kicad_pcb, diy.kicad_sch, drill.csv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]
2026-10-18 Fix Dependabot metadata approval routing (#8)
    Dependabot pull_request jobs receive restricted credentials, so
    same-repository dependency PRs cannot complete the existing approval
    flow. Route their metadata-only approval through pull_request_target on
    the default base; preserve trusted authors, draft guards, opt-in labels,
    and pinned reusable workflows. No PR code is checked out or executed.
    Validation: the actual workflow conditions pass 25
    event/author/fork/label/draft/base cases per consumer, with
    metadata-only checks and git diff --check.
2026-10-18 Compact MC1 carrier with synchronized firmware, wiring and printable enclosure (#7)
    MC1 consolidates seven Home Assistant function groups on one two-layer
    carrier for finished S3-Nano-M, H2 Thread RCP, XIAO MG24 and WIZ850io
    modules. Factory male pins solder directly into plated holes.
    Controllers face the room; Ethernet, seven male harness headers and five
    axial parts face the ceiling. Program loose controllers first; solder
    all thirteen rear parts before the three front modules.
    The final PCB is 47.5 × 75 mm with one H3 retention hole between H2 and
    XIAO. Split enclosure rails support clear lands along both long edges.
    Area falls 6.86% from the preceding four-hole board. Native track len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
    [BOM.csv, assembly.scad, base.scad, base.stl, ceiling-spacing-frame.scad, ceiling-spacing-frame.stl, cover.scad, cover.stl]
2026-10-18 Add MC2 carrier with independent external radio antennas (#9)
    MC1 places BLE and Thread on onboard antennas. This adds MC2-A, a 100 ×
    100 mm carrier with separate external 2.4 GHz feeds for
    ESP32-S3-DevKitC-1U-N8R8, TinyC6-U-01 and XIAO MG24, while preserving
    local Thread BR, Ember Zigbee, three active BLE connections, Z-Wave,
    CC1101, LD2450 and BME680 interfaces.
    - Add routed KiCad source, exact module/header contracts, English
    assembly instructions, antenna/cable BOM and a searchable HTML wiring
    guide. All 17 fitted parts face one side; MC1 remains a separate
    historical regression target.
    - Add the 8 MB S3/C6 firmware profile, explicit onboard/external MG24
    builds and target-checked netw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
    [BOM.csv, assembly.scad, base.scad, base.stl, bulkhead-fit-coupon.scad, bulkhead-fit-coupon.stl, cable-bar.scad, cable-bar.stl]
2026-10-18 Publish MC2 board concepts and exact radio shopping guide (#10)
    The MC2 README showed only engineering drawings and an enclosure
    preview, making the assembled carrier hard to visualize. Add two
    explicitly labeled AI appearance concepts, show the assembled view in
    the visual guide, and preserve native CAD as the construction authority.
    The shopping guide now identifies exact ESP/Silicon Labs order codes,
    the inspected AliExpress S3 and 15 cm SMA/IPEX1 cable variants, branded
    RF parts, and unverified marketplace alternatives. It flags original
    TC6-U-01 supply as unresolved and distinguishes it from TinyC6[D].
    Images include prompts, provenance hashes and limitations; copper,
    wiring and firmwa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
2026-10-19 Migrate MC2-B to the lower-cost classic ESP32 host (#11)
    Replace the MC2-A ESP32-S3-DevKitC-1U-N8R8 host with the
    previous-generation ESP32-DevKitC-VIE / WROVER-IE to reduce host
    purchase cost while retaining Ethernet, local OTBR, Zigbee, three active
    BLE proxy connections, Z-Wave, RF RX/TX, LD2450 and BME680. The indexed
    VIE offer was $9.48 versus the previously inspected $15.20 S3 promotion,
    before delivery/tax; this is not a whole-device cost or power claim.
    The new **MC2-B** carrier has the exact 38-pin host footprint, a checked
    21-signal map and GPIO12/GPIO2 boot pull-downs. Keep the 100×100 mm
    outline and supports, so the five existing enclosure meshes remain
    unchanged. Update the sc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
    [BOM.csv, mc2.kicad_pcb, mc2.kicad_sch]
2026-10-20 House the complete hub with ZAC93 mounts and an exploded assembly guide (#15)
    The previous enclosure held only the MC2-B carrier, leaving the ZAC93
    and other required peripherals without a mounting plan. This adds the
    FH1 complete-hub enclosure and puts a realistic exploded illustration,
    an exact CAD layout and a full wiring guide in the README.
    The 215 × 215 × 78 mm shell has removable trays for ZAC93, DFR0627,
    CC1101, the selected finished PoE splitter, regulator and power
    accessories. LD2450 mounts behind the lid window; BME680 sits in an
    attached ventilated pod. The ZAC93 guide maps its underside socket to J4
    and leaves reset pin 7 unconnected. Fourteen unique printable STL parts
    incl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
    [assembly.scad, base.scad, base.stl, bme680-pod-lid.scad, bme680-pod-lid.stl, bme680-pod.scad, bme680-pod.stl, buck-tray.scad]
2026-10-20 Make the hub easier to build, wire and print (#16)
    Builders previously had to navigate separate Markdown, wiring and
    mechanical pages, infer the far end of each harness, and download
    fourteen STL files individually. This adds a single readable MC2-B/FH1
    build guide with ordered checkpoints, troubleshooting, topic search,
    section links, code copying and print styles. `python3 tools/preview.py`
    opens it with standard-library Python; the local server serves only the
    public inventory and rejects private paths and symlinks.
    The wiring guide now selects/searches J1–J7 and shows both ends of all
    33 wires, direction, physical pad orientation and the ZAC93 remap. A CSV
    provides the same connection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
    [harness.csv]
2026-10-20 Match the MC2-C prototype to available TinyC6 D hardware (#17)
    The original TC6-U-01 is obsolete/restricted at the checked US supplier
    and has not been purchased. MC2-C selects the available TinyC6[D]
    TC6D-01 and ships one matching carrier, firmware and enclosure package
    for a five-board prototype order.
    - Transcribe and verify the new module against pinned manufacturer
    schematic, pinout and STEP files; correct its longer body, unused GPIO10
    pad label, USB shell and relocated U.FL endpoint. Keep all connected
    pads and copper unchanged.
    - Select the external antenna through FXL6408 before Thread starts, fail
    closed on configuration errors, and reject old C6 images in the updater.
    Preserve th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
    [BOM.csv, assembly.scad, exploded.scad, mc2.kicad_pcb, mc2.kicad_sch]
2026-10-20 Use affordable Taoglas pigtails with matched RF1 enclosures (#18)
    The previous three Amphenol pigtails cost $88.41 at the checked
    supplier, and the enclosure coupon did not match the actual wall
    thickness. Select three Taoglas CAB.618.E cables at $13.98 and publish
    the exact major-component offers, availability and explicitly incomplete
    $182.04 component subtotal.
    Update both enclosure variants for round SMA clearance holes, a
    wall-thickness-matched coupon and radius-limited cable routes. The
    full-hub RF1 package reserves a 6 mm engineering length shortfall and 25
    mm service allowance, plus straight clearance for the
    connector/heatshrink. Document the family drawing's length-tolerance
    ambig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
    [assembly.scad, base.scad, base.stl, bulkhead-fit-coupon.scad, bulkhead-fit-coupon.stl, exploded.scad, fit-coupon.scad, fit-coupon.stl]
2026-10-20 Prepare current MC2-C engineering beta package guide (#19)
    The download guide still describes the original Pi build and v0.2.0, so
    readers cannot identify the current MC2-C/FH1 source and CAD package.
    Update it for the `v0.3.0-beta.1` engineering prerelease and link it
    from the main build entry points. Regenerate the checked-in reading
    guide so its overview and search index include the same entry point.
    The guide identifies the exact committed fabrication ZIP, enclosure ZIP,
    harness, firmware sources and design registry. It preserves earlier
    releases as history and explains that packaging existing assets does not
    imply a new CAD export, flashable household firmware, physical
    acceptance or h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
2026-10-20 Replace peripheral converter with RECOM and update PWR1 assembly (#20)
    The MC2-C peripheral converter cost $26.95 despite the radios now having
    their own 5 V-fed regulators. Replace it with RECOM R-78K3.3-1.0 ($3.98)
    plus the specified Panasonic 27 µF input capacitor ($0.40): $22.57 less
    before mounting consumables, shipping and tax.
    Keep the existing MC2-C J2 interface, copper, Gerbers and firmware. The
    active assembly override, checked 400 mA peripheral sizing reserve,
    pin-to-pin harness and two-sided perfboard drawing now agree. The RECOM
    uses fused 5 V before D1–D3; input headroom, capacitor polarity and
    output-backfeed limitations are documented. Native CAD keeps its
    original conver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
    [assembly.scad, base.scad, base.stl, buck-tray.scad, buck-tray.stl, exploded.scad, harness.csv]
2026-10-26 Use factory-header XIAO ESP32C6 and fix I2C/RF conflicts (#21)
    MC2-D replaces the unpurchased TinyC6[D] with the US-distributed,
    factory-header Seeed XIAO ESP32C6 (102010636), retaining the ordered
    ESP32-DevKitC-VIE and the existing hub functions. The new carrier
    includes the XIAO footprint, J10 recovery leads and an underside access
    window; firmware and assembly models match its 4 MB flash and
    external-antenna control.
    An independent connection audit also found an I2C collision: the DFR0627
    setting A1=1/A0=1 decodes 0x70–0x77, including BME680. Both maintained
    MC2 and MC1 firmware profiles now use A1=1/A0=0, UART1 register/FIFO
    0x50/0x51, reserving 0x50–0x57. Configuration validation r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
    [BOM.csv, assembly.scad, exploded.scad, harness.csv, mc2.kicad_pcb, mc2.kicad_sch, power-measurements.csv]
2026-10-26 Update PDF dependencies and workflow pins with verified print provenance (#23)
    Update pypdf to 6.21.2 and ReportLab to 5.1.0, combining #23/#27's
    security update with #26's renderer update and #24's workflow pins.
    Regenerate the DIY print package with the existing pinned KiCad 10.0.6
    image so its dependency provenance remains accurate.
    The bounded native regeneration run
    [40315084798](https://github.com/ha-homelab/ha-radio-hub/actions/runs/40315084798)
    passed. All six generated output files remained byte-identical to main;
    all eight PDF pages were visually reviewed and pixel-identical. Only the
    requirements provenance hash changes. Eight exporter tests and the
    source/scale freshness check p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
2026-10-26 Port guarded RF and OTBR builds to ESPHome 2026.10.0 (#25)
    ESPHome 2026.10 requires counted receiver registration and may call
    transmit completion synchronously on failure. This update ports the
    local receiver generator, keeps the existing receiver lifecycle, and
    prevents failed transmitter completion from reporting a successful send
    or resuming receive.
    The firmware dependency moves to 2026.10.0. The stock decoder harness
    uses C++20 and the installed flash-copy helper. Exact upstream source
    guards are updated after comparison with official commit
    704551a6c93c29a311802f7ee97d67a9e9bce718; ESP-IDF 5.5.5, its source
    hashes, target/DMA restrictions, and RF startup wrapper are retained.
    The cus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
    [hub-s3-eth.yaml, hub.yaml, proof.yaml, rf_radio_handoff.h, test_contract.py]
2026-10-30 docs: explain browser USB installation for private host builds (#29)
    The MC2-D guide currently requires the USB laptop to run the firmware
    toolchain. Document a separate build-computer workflow that produces the
    complete private host factory image, then installs it through ESPHome
    Web from the USB laptop.
    The guide keeps the full prepared component tree, pinned compiler,
    private credentials and existing hardware requirements. It distinguishes
    the classic ESP32 host from the C6 RCP and Silicon Labs MG24, and does
    not present validation images or source archives as installable
    firmware.
    Regenerate the reading guide overview, search index and public-file
    inventory so the HTML guide matches th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
2026-10-30 docs: correct XIAO ESP32C6 GPIO8 recovery wiring (#30)
    The MC2-D recovery instructions incorrectly required an external 10 kΩ
    GPIO8 pull-up and named the wrong header pins. Document the supported
    XIAO ESP32C6’s onboard R13 (5.1 kΩ), confirm that carrier R3 is
    intentionally absent, and retain the EN/BOOT service-wire and
    commissioning checks.
    Regenerate the update guide and its search text.
    Validation: 8 guide tests passed; generated guide matches its sources;
    C6 pin contract and firmware/CAD pin-plan parity passed.
2026-11-02 Update build dependencies and regenerate verified outputs (#35)
    Consolidates workflow updates (#31), trimesh 5.2.0 (#33), and pypdf
    6.21.4 (#34). The PDF dependency fixes seven reported vulnerabilities.
    Regenerated verification metadata binds the existing outputs to the new
    dependency pins.
    All four CAD generation/reproducibility checks passed. Native KiCad
    10.0.6 regeneration (image digest
    18693567392b80da435f9fa952ce3a3e534c66eb5a6033f5b9c80aa3b19dd3ec; job
    125216339285) produced byte-identical print PDFs, copper SVG and drill
    map; the mesh and document outputs also remain byte-identical. Only
    dependency verification hashes changed. The temporary regeneration job
    has been removed; all exi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
2026-11-02 Qualify ESPHome 2026.10.1 across guarded firmware builds (#36)
    Qualifies ESPHome 2026.10.1 across the local RF receiver, RF startup and
    Thread border-router overlays. The previous dependency-only update (#32)
    could not build because the exact-version guards and native decoder
    fixtures still required 2026.10.0.
    The guards, YAML minimums, build receipts and fixtures now agree on
    2026.10.1. ESP-IDF remains pinned to 5.5.5. The upstream remote
    receiver/base, transmitter, CC1101 and OpenThread files are unchanged by
    this patch release; both enforced source hashes match the installed
    wheel. The local C++ lifecycle and GPIO startup wrappers are
    byte-identical. The compatibility review records the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
    [hub-s3-eth.yaml, hub.yaml, proof.yaml, test_contract.py, test_rf_tx_startup.py, test_stock_rc_switch.py, validate.py]
2026-11-02 Remove circular imports from parts catalogue validation (#37)
    The parts catalogue builder and validator imported each other, making
    the validator depend on builder initialization. Move the unchanged BOM
    readers into a small shared module and keep both entry points
    independent.
    Validation: all 15 catalogue tests pass, both standalone commands pass,
    and all 22 generated outputs remain byte-identical. A fresh-process
    regression verifies that validation does not import the builder. No
    firmware, board design, print geometry, or physical qualification
    changes.
2026-11-06 ci: skip heavy validation for documentation-only changes (#40)
    Documentation-only changes currently start expensive validation. Use the
    shared conservative change classifier to select a lighter documentation
    path while retaining the required aggregate and existing security
    checks.
    Code, configuration, workflow, mixed and uncertain changes keep full
    validation. The required gate rejects failed classification, missing
    jobs, and unexpected skips. Existing runner settings, branch rules,
    release implementation, schedules, and action pins are preserved.
    Validation: reviewed exact default-branch source and required contexts;
    scope/aggregate regression cases; actionlint (no new diagnostics);
    white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
2026-11-07 Add optional ESP-NOW sensor transport to MC2-D (#38)
    Add an opt-in ESP-NOW receiver to the complete MC2-D firmware, using the
    existing WROVER-IE antenna and Ethernet uplink. The carrier pin map,
    dedicated Thread/Zigbee radios and three BLE connections are retained.
    Include powered ESP32-C3 examples for BME280, DS18B20 and a reed
    contact, with per-provider keys, replay checks and freshness
    diagnostics.
    Provide English wiring, enrollment, recovery, sensor-use and Home
    Assistant guidance, an SVG topology, rendered guide pages, and required
    CI compilation of the full hub plus all three satellites. The freshness
    tests cover invalid heartbeats, expiry and outages beyond the 32-bit
    clock wrap.
    Va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
2026-11-07 fix: refresh MC2 build and fabrication evidence (#41)
    Prototype validation failed after #38 because the MC2 host compilation
    receipt still referenced the previous validator. Import the successful
    source-bound compilation receipt from [main run
    42320181078](https://github.com/ha-homelab/ha-radio-hub/actions/runs/42320181078/job/128242810252)
    and refresh the fabrication manifest and native package with pinned
    KiCad 10.0.6.
    [Native export
    42324295307](https://github.com/ha-homelab/ha-radio-hub/actions/runs/42324295307)
    passed the existing ERC/DRC checks and all 15 fabrication guards. Local
    package, fabrication, documentation-scope and offline source checks
    passed; all 10 fabrication members pr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
2026-11-07 fix: complete reviewed dependency approval and merge wiring (#43)
    Dependency update PRs from Renovate and californiantiramisu can now
    reach the existing protected merge process after independent approval
    and successful CI. The callers keep current-head review, same-repository
    guards, maintainer opt-in where present, and existing required checks.
    Shared workflows are pinned to the reviewed immutable revision.
    Validation: actionlint passed for every changed workflow. Branch rules
    remain enforced; merge uses the repository-supported method. No product,
    runner, deployment, or security-scan changes.
2026-11-07 fix: verify current default branch before reviewed merges (#44)
    Reviewed dependency merges previously compared the head against GitHub’s
    historical PR base, so a later main update could be missed and abort the
    merge batch. Adopt the qualified immutable workflow from [Toolkit
    #434](https://github.com/victron-venus/venus-os-ci-toolkit/pull/434),
    which checks the actual current default-branch ref and retains the
    original PR-base identity in the repeated observation.
    The existing author, opt-in label, independent current-head approval,
    required CI, withdrawal and concurrency contracts remain enforced.
    Changed-workflow actionlint passed; 1 focused checks passed.
2026-11-07 Update GitHub Actions and reusable workflows (#42)
    This PR contains the following updates:
    | Package | Type | Update | Change |
    |---|---|---|---|
    |
    [github/codeql-action](https://redirect.github.com/github/codeql-action)
    | action | patch | `v4.39.1` → `v4.39.3` |
    |
    [step-security/harden-runner](https://redirect.github.com/step-security/harden-runner)
    | action | patch | `v2.22.3` → `v2.22.4` |
    |
    [victron-venus/venus-os-ci-toolkit](https://redirect.github.com/victron-venus/venus-os-ci-toolkit)
    | workflow | digest | `e71559f` → `77b0157` |
    ---
    ### Release Notes
    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
2026-11-08 Update GitHub Actions and reusable workflows (#46)
    | workflow | digest | `77b0157` → `ecb29d7` |
    ### Configuration
    📅 **Schedule**: (UTC)
    - Branch creation
    - At any time (no schedule defined)
    - Automerge
    - At any time (no schedule defined)
    🚦 **Automerge**: Disabled by config. Please merge this manually once you
    are satisfied.
    ♻ **Rebasing**: Whenever PR is behind base branch, or you tick the
    rebase/retry checkbox.
    👻 **Immortal**: This PR will be recreated if closed unmerg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
2026-11-10 Update application dependencies and qualify firmware compatibility (#45)
    | [aioesphomeapi](https://esphome.io/) | | minor | `==46.3.0` →
    `==46.28.0` |
    | [bellows](https://redirect.github.com/zigpy/bellows) | | minor |
    `==1.1.0` → `==1.2.1` |
    | debian | final | digest | `7c7b2c9` → `734a72b` |
    | [esphome](https://redirect.github.com/esphome/esphome) | | patch |
    `==2026.10.1` → `==2026.10.2` |
    | [esptool](https://redirect.github.com/espressif/esptool)
    ([changelog](https://redirect.github.com/espressif/esptool/blob/master/CHANGELOG.md))
    | | minor | `==5.3.1` → `==5.6.0` |
    [markdown-it-py]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
2026-11-11 Update GitHub Actions and reusable workflows (#49)
    | workflow | digest | `d4b21d1` → `8249b82` |
    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
2026-11-11 Update GitHub Actions and reusable workflows (#50)
    | workflow | digest | `8249b82` → `579fdb4` |
    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
2026-11-12 Add MC2-D S1 assembly silkscreen and public build guide (#52)
    MC2-D now carries a two-sided white assembly legend: module outlines and
    roles, harness pin labels, resistor values, diode polarity, D1 wire-link
    marking, recovery notes and a QR to the public build guide. Electrical
    revision MC2-D and the existing component/enclosure fit remain
    unchanged. README and the generated guide show actual native exports of
    both faces; the order download is explicitly named MC2-D-S1.
    Validation: KiCad 10.0.6 ERC, DRC, unconnected items and schematic
    parity are zero. Clean regeneration matches copper topology and artwork.
    An independent native-object fingerprint preserves everything outside
    F/B silkscreen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
    [mc2.kicad_pcb]
2026-11-14 Update Application dependencies (#51)
    | Package | Update | Change |
    |---|---|---|
    | [aioesphomeapi](https://esphome.io/) | minor | `==46.28.0` →
    `==46.30.0` |
    [markdown-it-py](https://redirect.github.com/executablebooks/markdown-it-py)
    | minor | `==4.2.0` → `==4.3.0` |
    | openthread/border-router | digest | `fd55a81` → `e213113` |
    <details>
    <summary>executablebooks/markdown-it-py (markdown-it-py)</summary>
    ###
    [`v4.3.0`](https://redirect.github.com/executablebooks/markdown-it-py/blob/HEAD/CHANGELOG.md#430---2026-11-10)
    [Compare
    Source](https://redirect.github.com/executablebooks/markdown-it-py/compare/v4.2.0...v4.3.0)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
2026-11-14 Update Application dependencies (major) (#53)
    | [pypdf](https://redirect.github.com/py-pdf/pypdf)
    ([changelog](https://pypdf.readthedocs.io/en/latest/meta/CHANGELOG.html))
    | major | `==6.21.4` → `==7.1.0` |
    | [zxing-cpp](https://redirect.github.com/zxing-cpp/zxing-cpp) | major |
    `==2.3.0` → `==3.1.1` |
    <summary>py-pdf/pypdf (pypdf)</summary>
    [`v7.1.0`](https://redirect.github.com/py-pdf/pypdf/blob/HEAD/CHANGELOG.md#Version-710-2026-11-13)
    Source](https://redirect.github.com/py-pdf/pypdf/compare/7.0.1...7.1.0)
    ##### Deprecations (DEP)
    - Deprecate passing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
2026-11-14 Update Application dependencies (#54)
    👻 **Immortal**: This PR will be recreated if closed unmerged. Get
    [config
    help](https://redirect.github.com/renovatebot/renovate/discussions) if
    that's undesired.
    ---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
